MaiTheSan/PCB-Design/KiCad/our projects/uso!/Infomation.txt

Ốc: M2x8 16 cái
Trụ: M2X16 8 cái
Gasket: Poron 60*4*3mm 20 cái
