MaiTheSan/PCB-Design/KiCad/06-2021 comm/averange65 KBD67/gerbers-C3/note.txt

60% alps, Leopold, Jello: 1oz, HASL, 1.6mm
Krush: 1oz, Bạc, 1.6mm 
Daughterboard: 1oz, Bạc, 1.6mm ghép panelizing 4x4
Voice65: 1oz, Bạc, 1.6mm không mạ xuyên lỗ

tất cả dều là 5 panel, đen chữ trắng
