MaiTheSan/PCB-Design/KiCad/Source/KBD8X-MKII-PCB-master/KBD8X-MKII-PCB-master/KBD8XMK2-BOM.xlsx

Component | Description | Part | References | Value | Footprint | Quantity Per PCB
1 | Capacitor, Ceramic, 0603, ≥15V | C_Small | C6 C7 C8 CRGB1 CRGB2 CRGB3 CRGB4 CRGB5 CRGB6 CRGB7 CRGB8 CRGB9 CRGB10 CRGB11 CRGB12 CRGB13 CRGB14 CRGB15 CRGB16 CRGB17 CRGB18 | 0.1uF | C_0603 | 21
2 | Capacitor, Ceramic, 0603, ≥15V | C_Small | C5 | 10uF | C_0603 | 1
3 | Capacitor, Ceramic, 0603, ≥15V | C_Small | C2 | 1uF | C_0603 | 1
4 | Capacitor, Ceramic, 0603, ≥15V | C_Small | C3 C4 | 22pF | C_0603 | 2
5 | Diode, Generic, SOD-123 | D_Small | D1 D2 D3 D4 D5 D6 D7 D8 D9 D10 D11 D12 D13 D14 D17 D18 D19 D20 D21 D22 D23 D24 D25 D26 D27 D28 D29 D30 D31 D35 D36 D37 D38 D39 D40 D41 D42 D43 D44 D45 D46 D47 D48 D52 D53 D54 D55 D56 D57 D58 D59 D60 D61 D62 D63 D65 D66 D67 D68 D69 D70 D71 D72 D73 D74 D75 D76 D77 D78 D81 D82 D84 D85 D86 D87 D90 D91 D92 D93 D94 D95 D96 D97 D99 D100 D101 D108 D111 D112 D113 | SOD-323 | D_SOD-123 | 90
6 | Polyfuse, 1206, 500mA Hold, 1A Trip, ≥15V | Polyfuse_Small | F1 | 500mA | Fuse_SMD1206_Wave | 1
7 | NPN transistor, DSS60601MZ4-13, SOT-223 | Q_NPN_BCE | Q1 | DSS60601MZ4-13 | SOT-223-3_TabPin2 | 1
8 | Resistor, Generic, 0603 | R_Small | R1 R2 R3 R4 R5 R6 R7 R8 R9 R10 R11 R12 R13 R14 R16 R17 R18 R19 R20 R21 R22 R23 R24 R25 R26 R27 R28 R29 R30 R31 R32 R33 R35 R36 R37 R38 R39 R40 R41 R42 R43 R44 R45 R46 R47 R48 R52 R53 R54 R55 R56 R57 R58 R59 R60 R61 R62 R63 R65 R66 R67 R68 R69 R70 R71 R72 R73 R74 R75 R76 R77 R78 R81 R82 R84 R85 R86 R87 R90 R91 R95 R96 R97 R99 R100 R101 R108 R111 R112 R113 RC4 | 1k | R_0603 | 91
9 | Resistor, Generic, 0603 | R_Small | RC5 | 1.5k | R_0603 | 1
10 | Resistor, Generic, 0603 | R_Small | RC3 | 10k | R_0603 | 1
11 | Resistor, Generic, 0603 | R_Small | RC1 RC2 | 22 | R_0603 | 2
12 | Resistor, Generic, 0603 | R_Small | RC6 RC7 | 5k1 | R_0603 | 2
13 | RGB LED, WS2812B, 5050 | WS2812B | RGB1 RGB2 RGB3 RGB4 RGB5 RGB6 RGB7 RGB8 RGB9 RGB10 RGB11 RGB12 RGB13 RGB14 RGB15 RGB16 RGB17 RGB18 | WS2812B | LED_WS2812B-PLCC4 | 18
14 | Push button, 5.2 x 5.2mm | SW_Push | SW1 | SW_Push | SKQG-1155865 | 1
15 | Switch, SPDT, PCM12 | SW_SPDT | SW2 SW3 | SW_SPDT | SW_SPDT_PCM12 | 2
16 | ATmega32U4-MU | ATmega32U4-MU | U1 | ATmega32U4-MU | QFN-44-1EP_7x7mm_Pitch0.5mm | 1
17 | ESD Protection IC, PRTR5V0U2X,215 | PRTR5V0U2X | U2 | PRTR5V0U2X | SOT143B | 1
18 | USB Type-C Connector, HRO TYPE-C-31-M-12 | HRO-TYPE-C-31-M-12 | USB1 | HRO-TYPE-C-31-M-12 | HRO-TYPE-C-31-M-12-Assembly | 1
19 | Crystal, 3.2 x 2.5mm, 16MHz | Crystal_GND24 | Y1 | 16MHz | Crystal_SMD_3225-4pin_3.2x2.5mm | 1
Component Groups: | 19
Component Count: | 239
Fitted Components: | 239
Number of PCBs: | 1
Total components: | 239
Schematic Version:
Schematic Date:
BoM Date: | 2019-04-04 15:30
Schematic Source:
KiCad Version: | Eeschema (5.0.2)-1
