MaiTheSan/PCB-Design/KiCad/Early 2021/Unified-Daughterboard-master/Production/C1/BOM/Unified-Daughterboard-Partslist.xlsx

Component | Description |  | Part | References | Value | Footprint | Quantity Per PCB
1 | JST SR | https://lcsc.com/product-detail/Others_JST-Sales-America__JST-Sales-America-SM04B-SRSS-TB-LF-SN_C160404.html | Conn_01x04 | J2 | SM04B-SRSS-TB(LF)(SN) | JST-SR-4 | 1
2 | HRO USB-C Connector | https://lcsc.com/product-detail/USB-Type-C_Korean-Hroparts-Elec-TYPE-C-31-M-12_C165948.html | HRO-TYPE-C-31-M-12 | J1 | HRO-TYPE-C-31-M-12 | HRO-TYPE-C-31-M-12-Assembly | 1
3 | Resistor, 0603, Generic | https://lcsc.com/product-detail/Chip-Resistor-Surface-Mount_PANASONIC-ERA3AED512V_C191166.html | R_Small | R1 R2 | 5.1k | R_0603 | 2
