MaiTheSan/PCB-Design/KiCad/Source/KBD8X-MKII-PCB-master/KBD8X-MKII-PCB-master/Production/NewBOM/KBD8XMK2-BOM-2.xlsx

Comment | Description | Designator | Footprint | Pins | Quantity
0.1uF 20% ≥15V X5R/X7R | Capacitor, Ceramic, 0603 | C6 C7 C8 CRGB1 CRGB2 CRGB3 CRGB4 CRGB5 CRGB6 CRGB7 CRGB8 CRGB9 CRGB10 CRGB11 CRGB12 CRGB13 CRGB14 CRGB15 CRGB16 CRGB17 CRGB18 | C_0603 | 2 | 21
10uF 20% ≥15V X5R/X7R | Capacitor, Ceramic, 0603 | C5 | C_0603 | 2 | 1
1uF 20% ≥15V X5R/X7R | Capacitor, Ceramic, 0603 | C2 | C_0603 | 2 | 1
22pF 5% ≥15V C0G | Capacitor, Ceramic, 0603 | C3 C4 | C_0603 | 2 | 2
Generic | Diode, SOD-123 | D1 D2 D3 D4 D5 D6 D7 D8 D9 D10 D11 D12 D13 D14 D17 D18 D19 D20 D21 D22 D23 D24 D25 D26 D27 D28 D29 D30 D31 D35 D36 D37 D38 D39 D40 D41 D42 D43 D44 D45 D46 D47 D48 D52 D53 D54 D55 D56 D57 D58 D59 D60 D61 D62 D63 D65 D66 D67 D68 D69 D70 D71 D72 D73 D74 D75 D76 D77 D78 D81 D82 D84 D85 D86 D87 D90 D91 D92 D93 D94 D95 D96 D97 D99 D100 D101 D108 D111 D112 D113 | D_SOD-123 | 2 | 90
500mA ≥15V 500mA_Hold 1A_Trip | Polyfuse, 1206 | F1 | Fuse_SMD1206_Wave | 2 | 1
DSS60601MZ4-13 | NPN transistor, SOT-223 | Q1 | SOT-223-3_TabPin2 | 4 | 1
1k 1% | Resistor, Generic, 0603 | R1 R2 R3 R4 R5 R6 R7 R8 R9 R10 R11 R12 R13 R14 R16 R17 R18 R19 R20 R21 R22 R23 R24 R25 R26 R27 R28 R29 R30 R31 R32 R33 R35 R36 R37 R38 R39 R40 R41 R42 R43 R44 R45 R46 R47 R48 R52 R53 R54 R55 R56 R57 R58 R59 R60 R61 R62 R63 R65 R66 R67 R68 R69 R70 R71 R72 R73 R74 R75 R76 R77 R78 R81 R82 R84 R85 R86 R87 R90 R91 R95 R96 R97 R99 R100 R101 R108 R111 R112 R113 RC4 | R_0603 | 2 | 91
1.5k 1% | Resistor, Generic, 0603 | RC5 | R_0603 | 2 | 1
10k 1% | Resistor, Generic, 0603 | RC3 | R_0603 | 2 | 1
22 1% | Resistor, Generic, 0603 | RC1 RC2 | R_0603 | 2 | 2
5.1k 1% | Resistor, Generic, 0603 | RC6 RC7 | R_0603 | 2 | 2
WS2812B | RGB LED, 5050 | RGB1 RGB2 RGB3 RGB4 RGB5 RGB6 RGB7 RGB8 RGB9 RGB10 RGB11 RGB12 RGB13 RGB14 RGB15 RGB16 RGB17 RGB18 | LED_WS2812B-PLCC4 | 4 | 18
SMT 5.2 x 5.2 x 1.5mm | Push button | SW1 | SKQG-1155865 | 4 | 1
SPDT PCM12 | Switch, SPDT | SW2 SW3 | SW_SPDT_PCM12 | 7 | 2
ATmega32U4-MU | ATmega32U4-MU | U1 | QFN-44-1EP_7x7mm_Pitch0.5mm | 45 | 1
PRTR5V0U2X | ESD Protection IC | U2 | SOT143B | 4 | 1
HRO-TYPE-C-31-M-12 | USB Type-C Connector | USB1 | HRO-TYPE-C-31-M-12-Assembly | 16 | 1
16MHz | Crystal, 3.2 x 2.5mm (3225-4) | Y1 | Crystal_SMD_3225-4pin_3.2x2.5mm | 4 | 1
