MaiTheSan/PCB-Design/KiCad/Early 2021/Unified-Daughterboard-master/Production/C3/BOM/Unified-Daughterboard_bom_.csv

Designator | Package | Quantity | Designation | LCSC Code
D1 | SOD-123F-B | 1 | SMF9.0CA | C123799
J2 | SM04B-SRSS-TB(LF)(SN) | 1 | JST-SM04B | C160404
R1,R2 | R0603 | 2 | 5.1k | C101083
J1 | HRO-TYPE-C-31-M-12 | 1 | HRO-TYPE-C-31-M-12 | C165948
U1 | uSON-10 | 1 | TPD4E05U06DQAR | C138714
F1 | F1206 | 1 | ASMD1206-150 | C135342
