MaiTheSan/PCB-Design/KiCad/06-2021 comm/FR4 Plate/Voice65/full.dxf

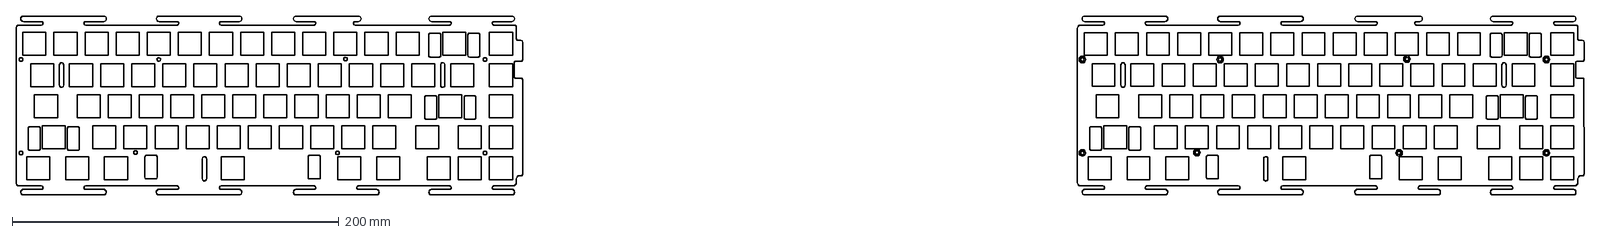
[picture p54: CAD file, 2022-11-19]
KiCad/06-2021 comm/FR4 Plate/Voice65/full.dxf
960.2 x 109.5 mm
