MaiTheSan/PCB-Design/KiCad/Early 2021/teensy.pretty-master/Teensy_4.0_Assembly.STEP

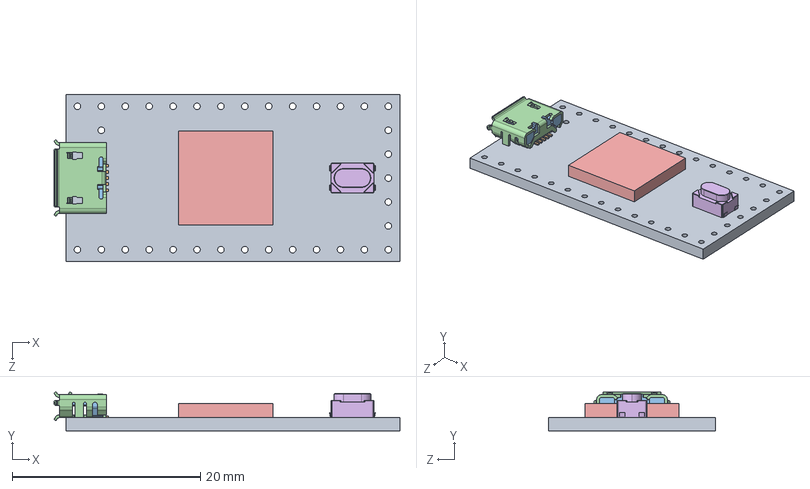
[picture p55: CAD file, 2022-11-19]
KiCad/Early 2021/teensy.pretty-master/Teensy_4.0_Assembly.STEP
36.8 x 4.12 x 17.7 mm
Teensy_4.0_PCB
Micro USB-B Female 5Pin SMD
NXP iMXRT1062
SKRPACE010 v4
