MaiTheSan/PCB-Design/KiCad/06-2021 comm/averange65 KBD67/RGB68v2.dxf

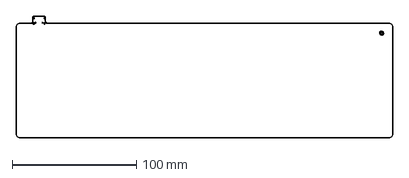
[picture p56: CAD file, 2022-11-19]
KiCad/06-2021 comm/averange65 KBD67/RGB68v2.dxf
303.2 x 97.6 mm
