MaiTheSan/PCB-Design/KiCad/06-2021 comm/averange65/SM04B-SRSS-TB(LF)(SN)--3DModel-STEP-56544.STEP

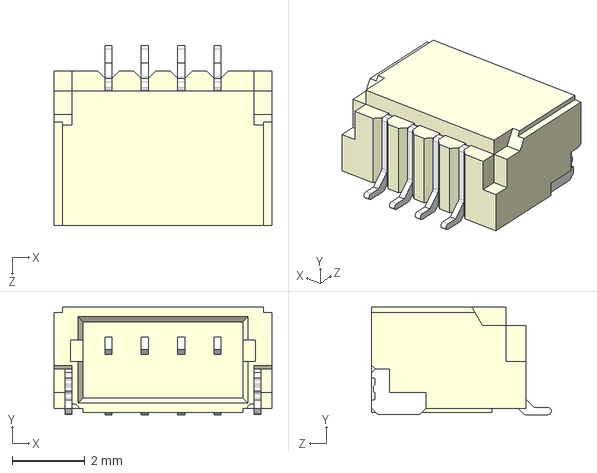
[picture p57: CAD file, 2022-11-19]
KiCad/06-2021 comm/averange65/SM04B-SRSS-TB(LF)(SN)--3DModel-STEP-56544.STEP
6.00 x 2.96 x 4.95 mm
