MaiTheSan/PCB-Design/KiCad/06-2021 comm/averange65/Unified-Daughterboard-master/Unified-Daughterboard-master/Design Resources/C3/Example Implementation Model.step

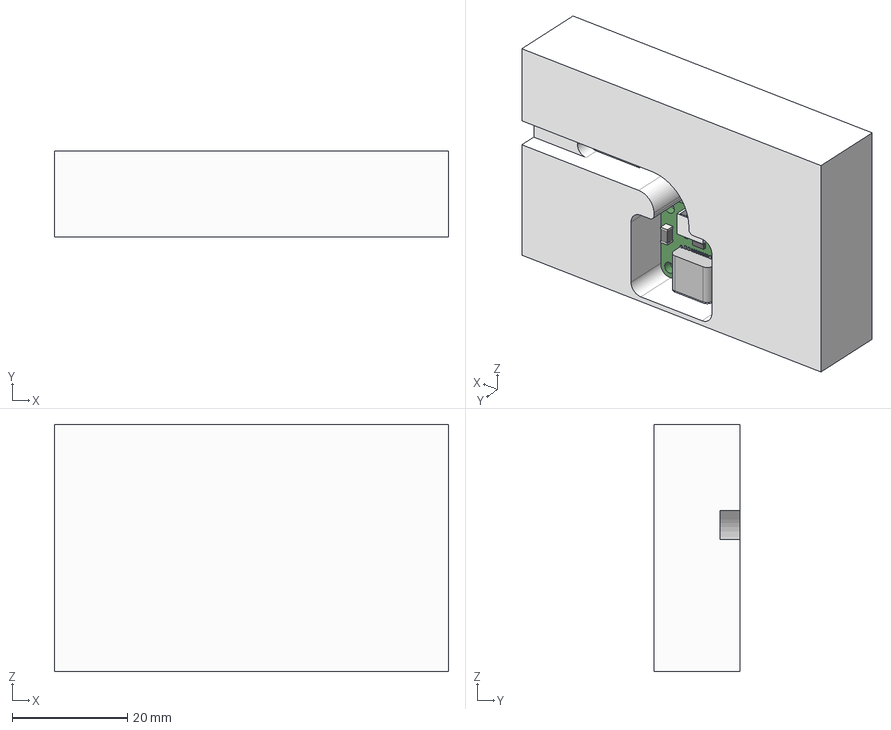
[picture p58: CAD file, 2022-11-19]
KiCad/06-2021 comm/averange65/Unified-Daughterboard-master/Unified-Daughterboard-master/Design Resources/C3/Example Implementation Model.step
68.5 x 15.0 x 43.0 mm
