MaiTheSan/PCB-Design/KiCad/06-2021 comm/FR4 Plate/KBD67 - Lite/kbd67lite-fr4.dxf

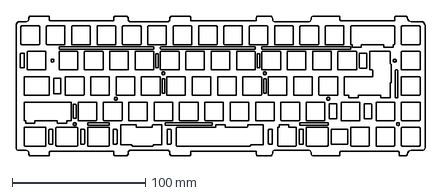
[picture p59: CAD file, 2022-11-19]
KiCad/06-2021 comm/FR4 Plate/KBD67 - Lite/kbd67lite-fr4.dxf
307.2 x 104.9 mm
