MaiTheSan/PCB-Design/KiCad/06-2021 comm/FR4 Plate/outline.dxf

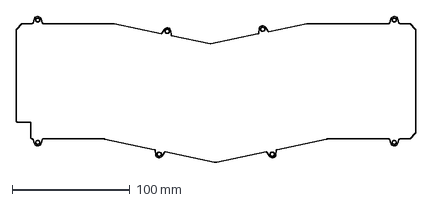
[picture p60: CAD file, 2022-11-19]
KiCad/06-2021 comm/FR4 Plate/outline.dxf
338.8 x 124.0 mm
