MaiTheSan/PCB-Design/KiCad/06-2021 comm/jello/uso!VNC.step

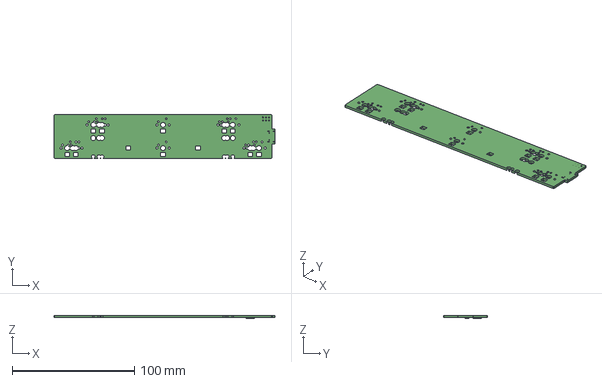
[picture p61: CAD file, 2022-11-19]
KiCad/06-2021 comm/jello/uso!VNC.step
181.0 x 35.7 x 2.42 mm
