MaiTheSan/PCB-Design/KiCad/06-2021 comm/Leopold Replacement/OG BLE/Leopold Replacement-drl_map.dxf

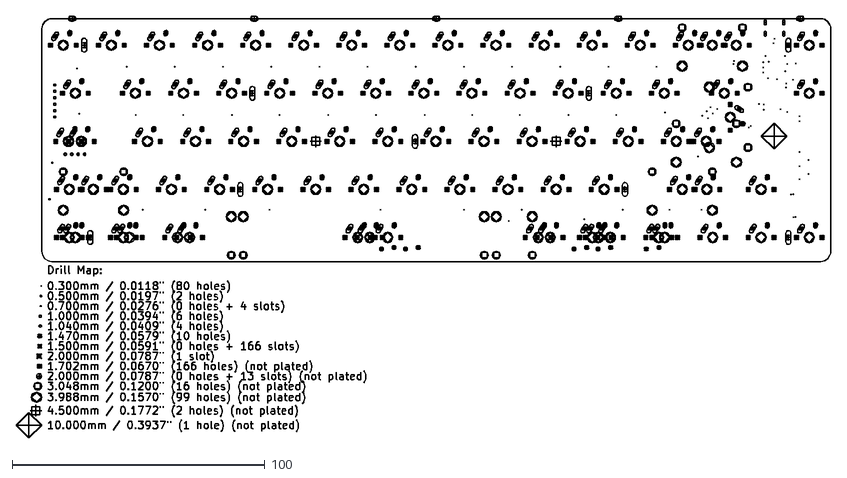
[picture p62: CAD file, 2022-11-19]
KiCad/06-2021 comm/Leopold Replacement/OG BLE/Leopold Replacement-drl_map.dxf
322.1 x 166.8
