MaiTheSan/PCB-Design/KiCad/06-2021 comm/Leopold Replacement/TypeC/resource/nt660-drl_map.dxf

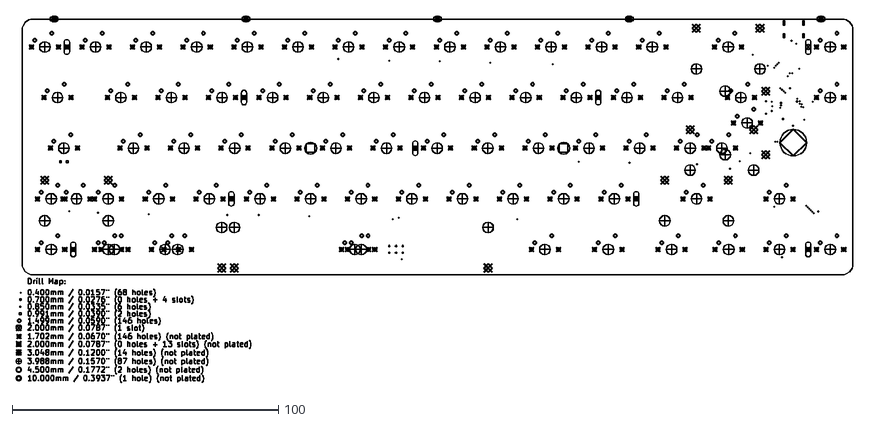
[picture p63: CAD file, 2022-11-19]
KiCad/06-2021 comm/Leopold Replacement/TypeC/resource/nt660-drl_map.dxf
314.3 x 137.6
