MaiTheSan/PCB-Design/KiCad/06-2021 comm/theo60 plate/Ansi/theo60ansi.dxf

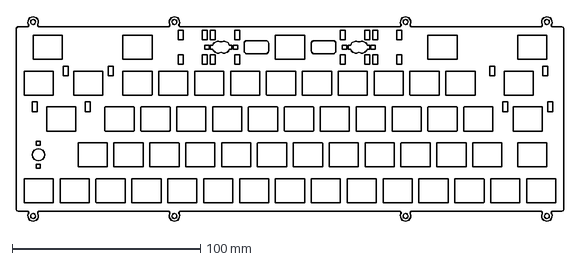
[picture p64: CAD file, 2022-11-19]
KiCad/06-2021 comm/theo60 plate/Ansi/theo60ansi.dxf
290.7 x 108.9 mm
