MaiTheSan/PCB-Design/KiCad/06-2021 comm/theo60 plate/ISO/outline.dxf

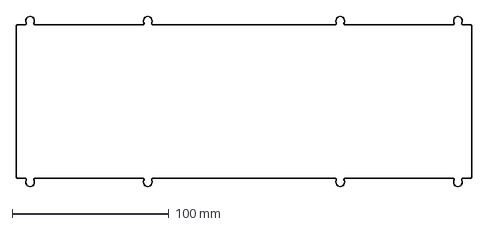
[picture p65: CAD file, 2022-11-19]
KiCad/06-2021 comm/theo60 plate/ISO/outline.dxf
290.7 x 108.9 mm
