MaiTheSan/PCB-Design/KiCad/06-2021 comm/theo60 plate/theo60-alps-5140.dxf

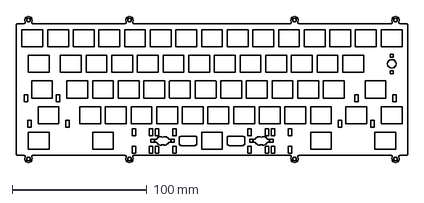
[picture p66: CAD file, 2022-11-19]
KiCad/06-2021 comm/theo60 plate/theo60-alps-5140.dxf
290.7 x 108.9 mm
