MaiTheSan/PCB-Design/KiCad/07-2021/Evergarden/Evergarden.dxf

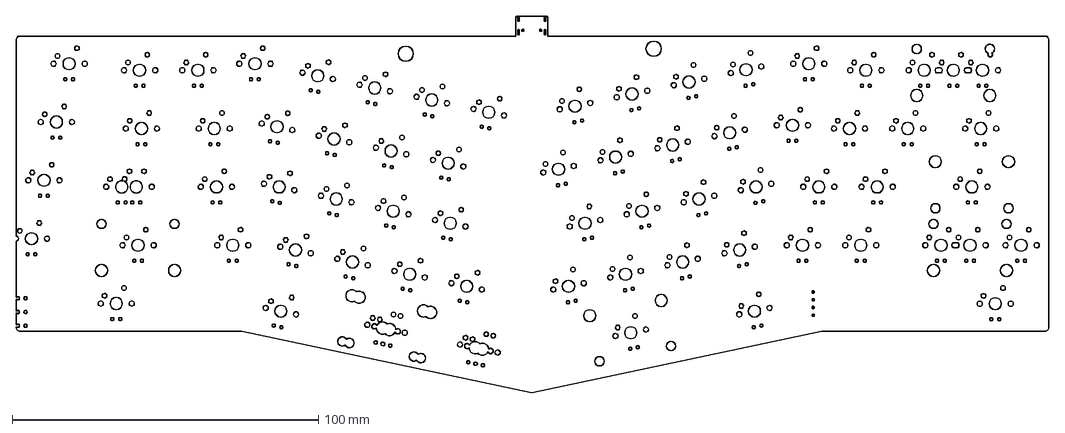
[picture p67: CAD file, 2022-11-19]
KiCad/07-2021/Evergarden/Evergarden.dxf
337.2 x 122.9 mm
