MaiTheSan/PCB-Design/KiCad/07-2021/Parallel/layout.dxf

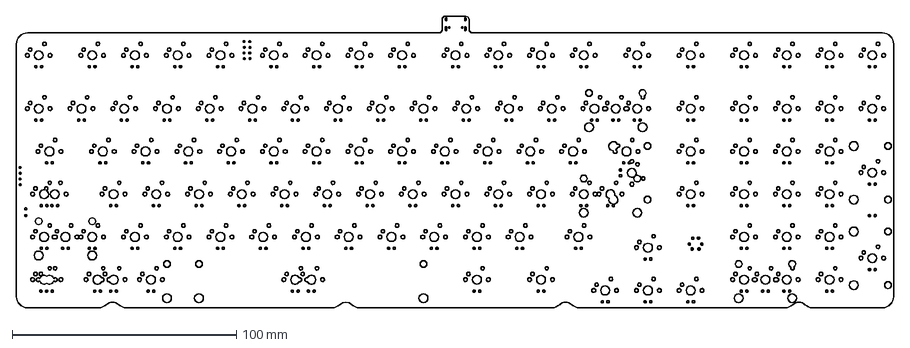
[picture p68: CAD file, 2022-11-19]
KiCad/07-2021/Parallel/layout.dxf
391.0 x 129.9 mm
