MaiTheSan/PCB-Design/KiCad/07-2021/Satri2.0/Plate/6kv2 (7k+).dxf

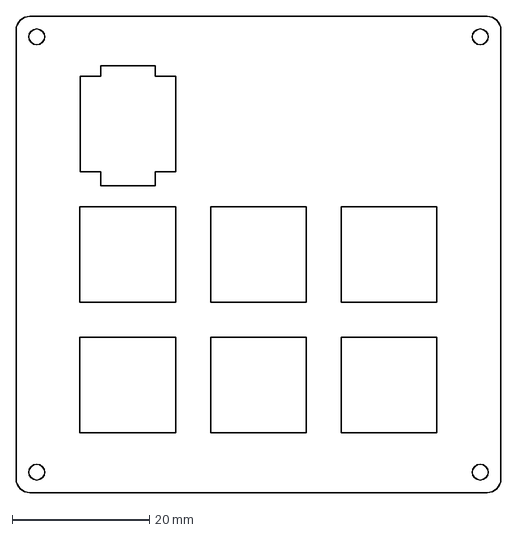
[picture p69: CAD file, 2022-11-19]
KiCad/07-2021/Satri2.0/Plate/6kv2 (7k+).dxf
70.7 x 69.5 mm
