MaiTheSan/PCB-Design/KiCad/07-2021/Satri2.0/Satxri6key.step

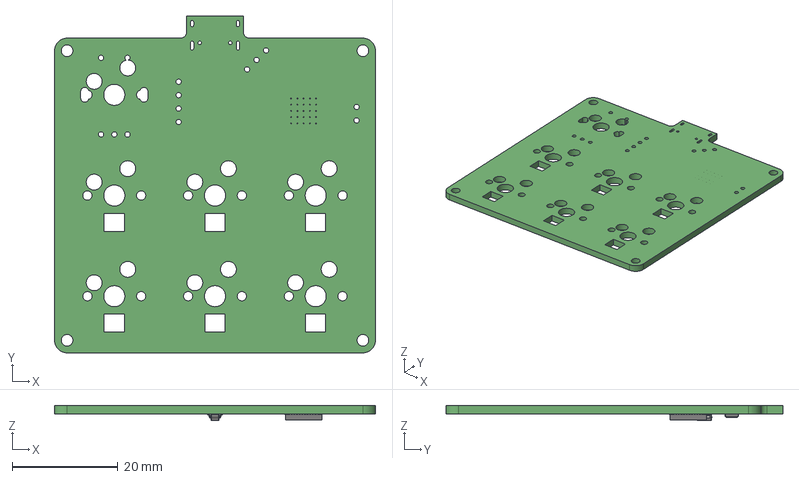
[picture p70: CAD file, 2022-11-19]
KiCad/07-2021/Satri2.0/Satxri6key.step
60.7 x 63.7 x 2.85 mm
