MaiTheSan/PCB-Design/KiCad/07-2021/Stabtester/Stabtester/New folder/Stabtester-Edge_Cuts.dxf

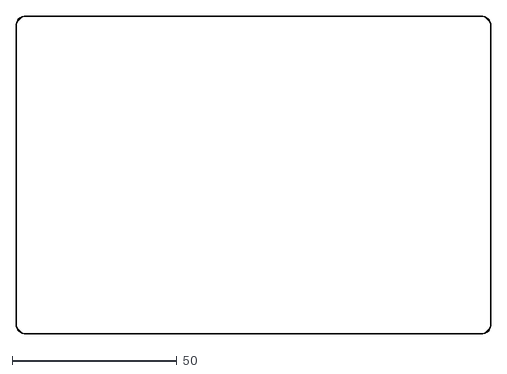
[picture p71: CAD file, 2022-11-19]
KiCad/07-2021/Stabtester/Stabtester/New folder/Stabtester-Edge_Cuts.dxf
144.2 x 96.5
