MaiTheSan/PCB-Design/KiCad/08-2021/averange60/pcb-outline.dxf

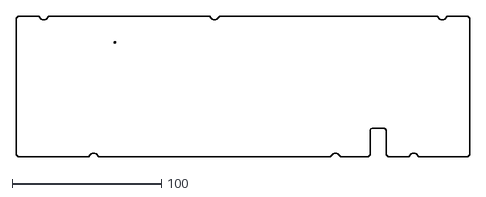
[picture p72: CAD file, 2022-11-19]
KiCad/08-2021/averange60/pcb-outline.dxf
303.8 x 94.2
