MaiTheSan/PCB-Design/KiCad/08-2021/hmmm/pcb/pcb-outline.dxf

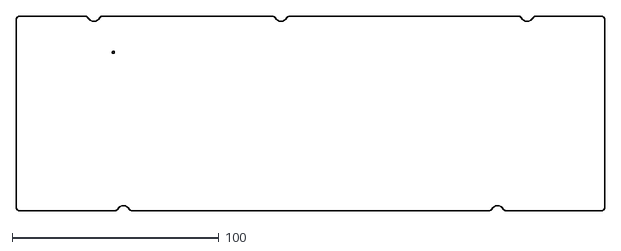
[picture p73: CAD file, 2022-11-19]
KiCad/08-2021/hmmm/pcb/pcb-outline.dxf
284.7 x 94.2
