MaiTheSan/PCB-Design/KiCad/08-2021/Krush hotswap/averange60/Polaris-PCB-Dimens.dxf

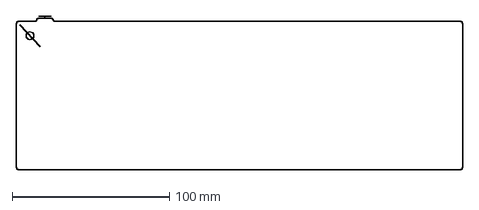
[picture p74: CAD file, 2022-11-19]
KiCad/08-2021/Krush hotswap/averange60/Polaris-PCB-Dimens.dxf
283.9 x 98.0 mm
