MaiTheSan/PCB-Design/KiCad/08-2021/Krush hotswap/averange60x/Unified-Daughterboard-master/Unified-Daughterboard-master/Design Resources/C3/Unified-Daughterboard.step

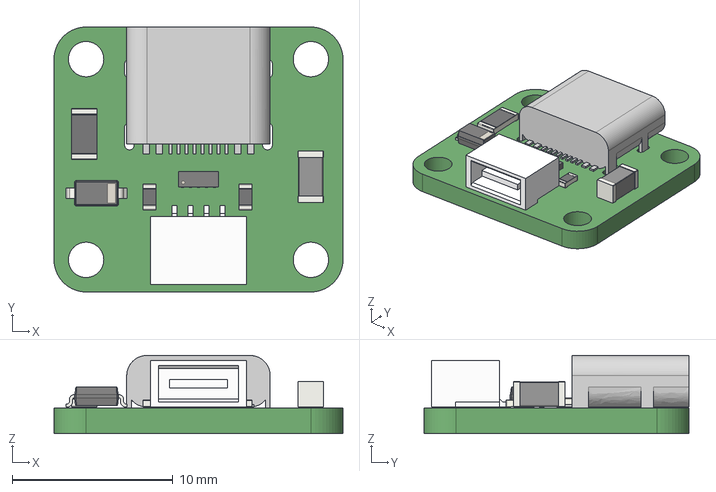
[picture p75: CAD file, 2022-11-19]
KiCad/08-2021/Krush hotswap/averange60x/Unified-Daughterboard-master/Unified-Daughterboard-master/Design Resources/C3/Unified-Daughterboard.step
18.0 x 16.5 x 4.86 mm
