MaiTheSan/PCB-Design/KiCad/08-2021/nonem/OutlineNoway.dxf

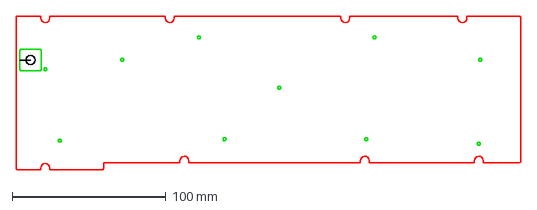
[picture p76: CAD file, 2022-11-19]
KiCad/08-2021/nonem/OutlineNoway.dxf
328.6 x 100.0 mm
