MaiTheSan/PCB-Design/KiCad/1-2022/DNMK/pcb outline.dxf

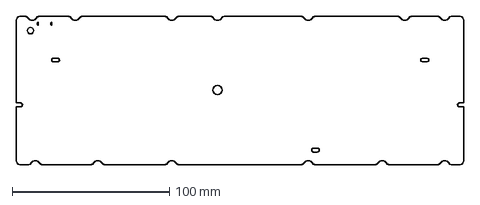
[picture p77: CAD file, 2022-11-19]
KiCad/1-2022/DNMK/pcb outline.dxf
284.7 x 94.2 mm
