MaiTheSan/PCB-Design/KiCad/12-2021/Amber80/solder/solder noncommission/dboard/RGB-Daughterboard.step

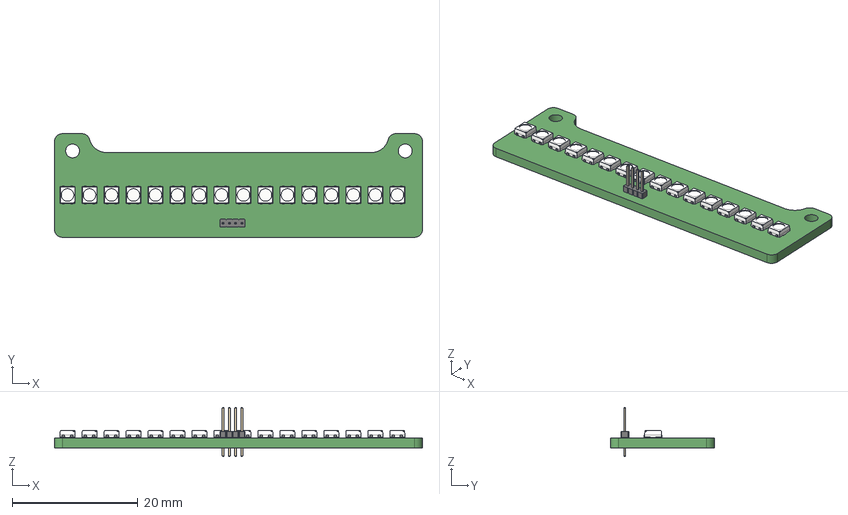
[picture p78: CAD file, 2022-11-19]
KiCad/12-2021/Amber80/solder/solder noncommission/dboard/RGB-Daughterboard.step
58.6 x 16.5 x 7.80 mm
