MaiTheSan/PCB-Design/KiCad/12-2021/Amber80/solder/solder noncommission/outline2.dxf

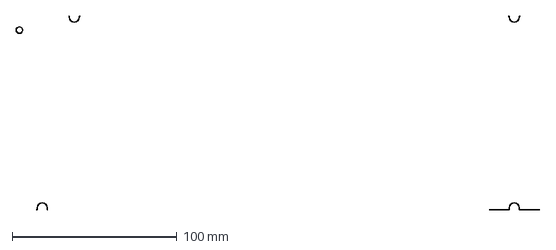
[picture p79: CAD file, 2022-11-19]
KiCad/12-2021/Amber80/solder/solder noncommission/outline2.dxf
317.6 x 117.5 mm
