MaiTheSan/PCB-Design/KiCad/3-2022/75F/75F/75F/a.dxf

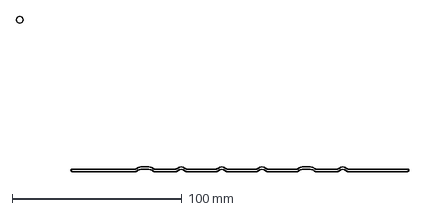
[picture p80: CAD file, 2022-11-19]
KiCad/3-2022/75F/75F/75F/a.dxf
231.3 x 91.5 mm
