MaiTheSan/PCB-Design/KiCad/4-2022/Alice/alice.dxf

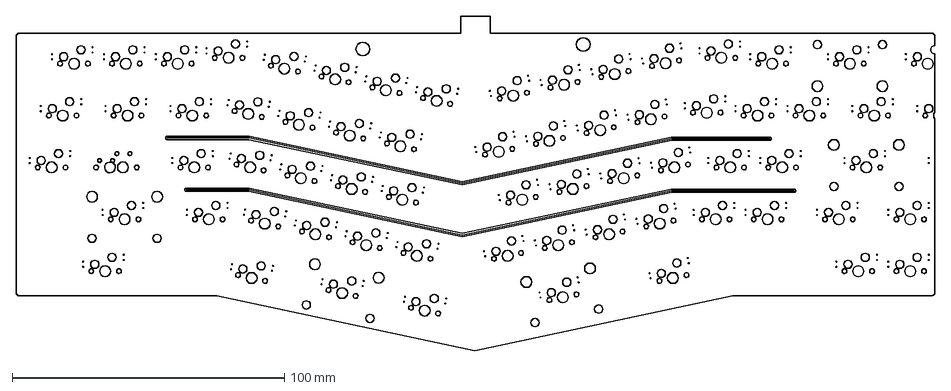
[picture p81: CAD file, 2022-11-19]
KiCad/4-2022/Alice/alice.dxf
337.2 x 122.6 mm
