MaiTheSan/PCB-Design/KiCad/4-2022/Nuxros Alice commission/SawnsProjectAlice.dxf

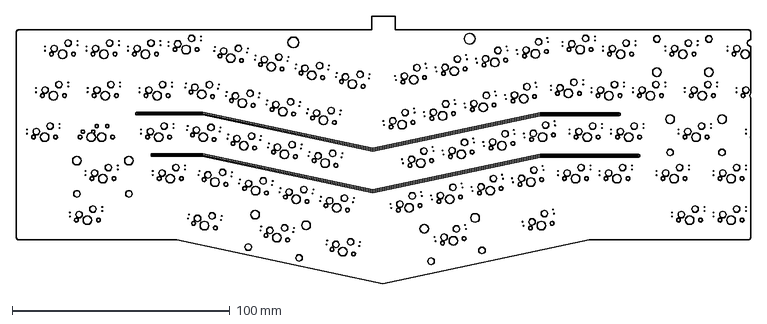
[picture p82: CAD file, 2022-11-19]
KiCad/4-2022/Nuxros Alice commission/SawnsProjectAlice.dxf
337.2 x 122.6 mm
