MaiTheSan/PCB-Design/KiCad/4-2022/Viendi 2 Prototype layout/Viendi 2/Viendi2/Viendi2/EDGE CUT.dxf

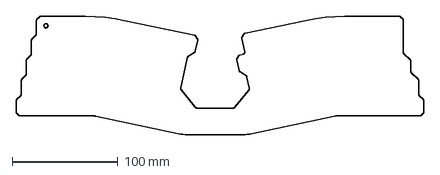
[picture p83: CAD file, 2022-11-19]
KiCad/4-2022/Viendi 2 Prototype layout/Viendi 2/Viendi2/Viendi2/EDGE CUT.dxf
385.8 x 111.9 mm
