MaiTheSan/PCB-Design/KiCad/4-2022/Viendi 2 Prototype layout/Viendi 2/Viendi2/Viendi2_daughterboard/EDGE CUT.dxf

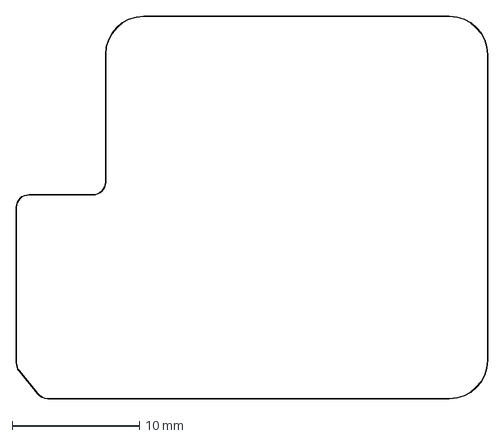
[picture p84: CAD file, 2022-11-19]
KiCad/4-2022/Viendi 2 Prototype layout/Viendi 2/Viendi2/Viendi2_daughterboard/EDGE CUT.dxf
37.0 x 30.0 mm
