MaiTheSan/PCB-Design/KiCad/Early 2021/Alice/Lubrigante-master/Lubrigante-master/case_layouts/man_of_layouts/man_of_layouts_half_plate_3mm.dxf

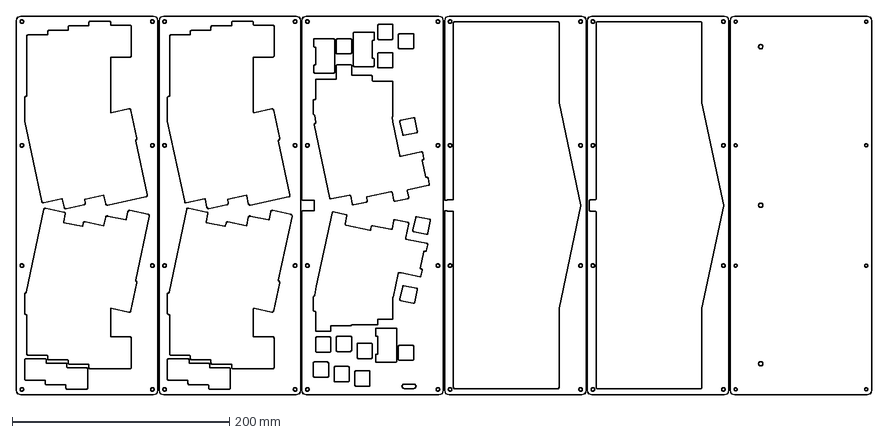
[picture p85: CAD file, 2022-11-19]
KiCad/Early 2021/Alice/Lubrigante-master/Lubrigante-master/case_layouts/man_of_layouts/man_of_layouts_half_plate_3mm.dxf
787.8 x 348.8 mm
