MaiTheSan/PCB-Design/KiCad/Early 2021/Alice/Opensource/bmek-master/bmek-master/cases/top_mount/Blocker/Blocker_EngravedLogo.step

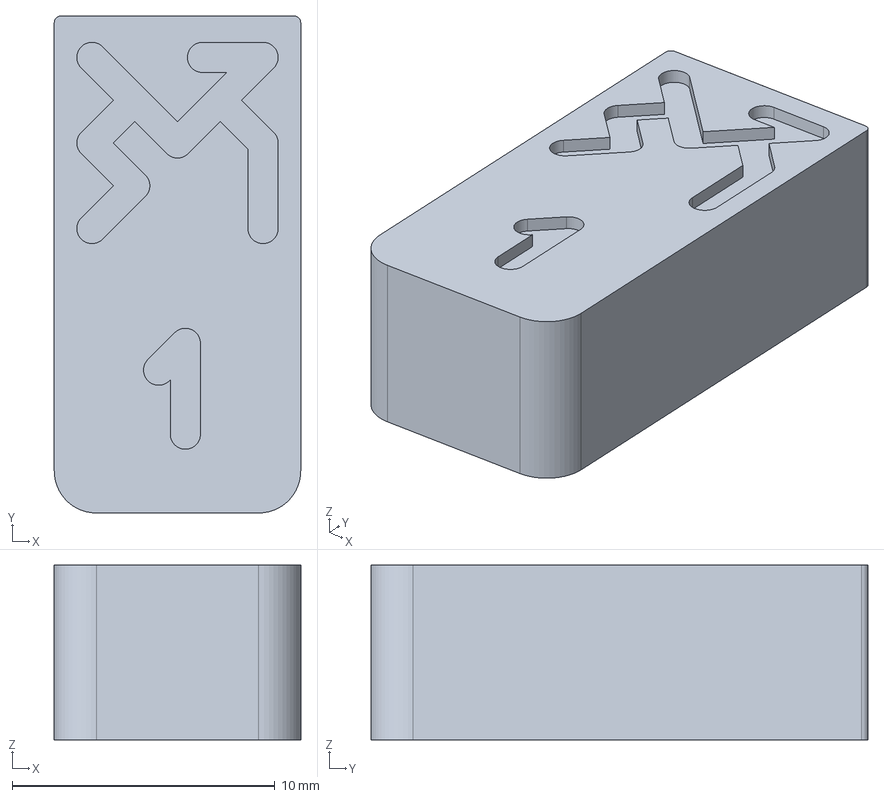
[picture p86: CAD file, 2022-11-19]
KiCad/Early 2021/Alice/Opensource/bmek-master/bmek-master/cases/top_mount/Blocker/Blocker_EngravedLogo.step
9.38 x 18.9 x 6.65 mm
