MaiTheSan/PCB-Design/KiCad/Early 2021/Alice/Opensource/bmek-master/bmek-master/cases/top_mount/BottomCase/BottomCase.step

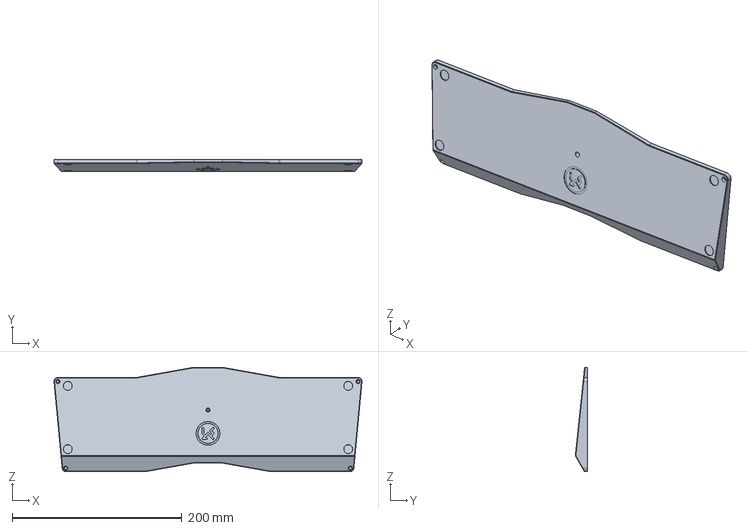
[picture p87: CAD file, 2022-11-19]
KiCad/Early 2021/Alice/Opensource/bmek-master/bmek-master/cases/top_mount/BottomCase/BottomCase.step
362.7 x 14.5 x 122.9 mm
