MaiTheSan/PCB-Design/KiCad/Early 2021/Alice/Opensource/bmek-master/bmek-master/cases/top_mount/BottomWeight/BottomWeight.step

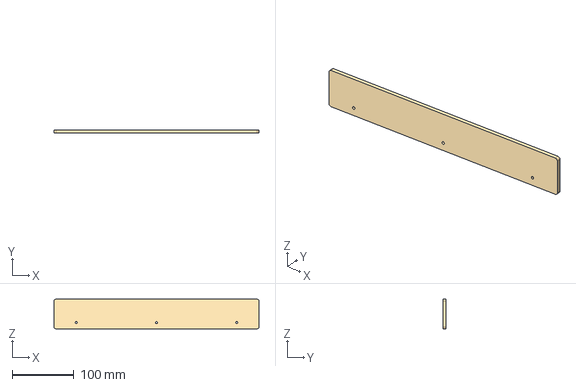
[picture p88: CAD file, 2022-11-19]
KiCad/Early 2021/Alice/Opensource/bmek-master/bmek-master/cases/top_mount/BottomWeight/BottomWeight.step
332.0 x 5.00 x 48.0 mm
