MaiTheSan/PCB-Design/KiCad/Early 2021/Alice/Opensource/bmek-master/bmek-master/cases/top_mount/SwitchPlate/SwitchPlate_ThreeQuarterFlex.step

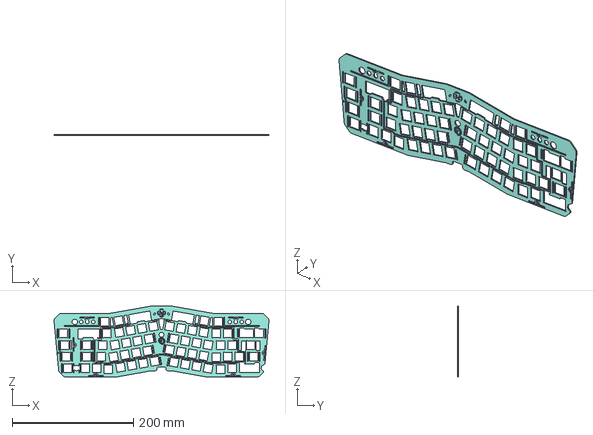
[picture p89: CAD file, 2022-11-19]
KiCad/Early 2021/Alice/Opensource/bmek-master/bmek-master/cases/top_mount/SwitchPlate/SwitchPlate_ThreeQuarterFlex.step
354.8 x 1.50 x 117.1 mm
