MaiTheSan/PCB-Design/KiCad/Early 2021/Alice/Opensource/bmek-master/bmek-master/cases/top_mount/TopCase/TopCase.step

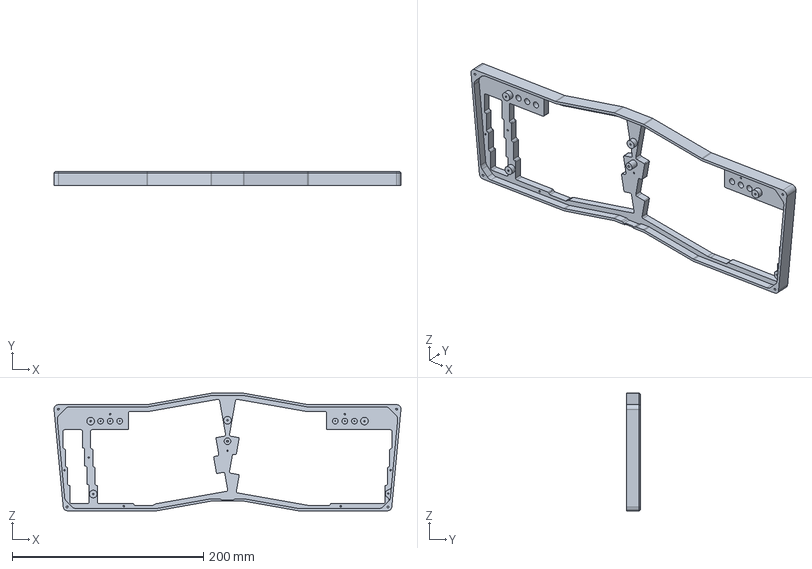
[picture p90: CAD file, 2022-11-19]
KiCad/Early 2021/Alice/Opensource/bmek-master/bmek-master/cases/top_mount/TopCase/TopCase.step
362.7 x 14.9 x 122.9 mm
