MaiTheSan/PCB-Design/KiCad/Early 2021/Alice/Opensource/bmek-master/bmek-master/cases/top_mount/WristRest/WristRest.step

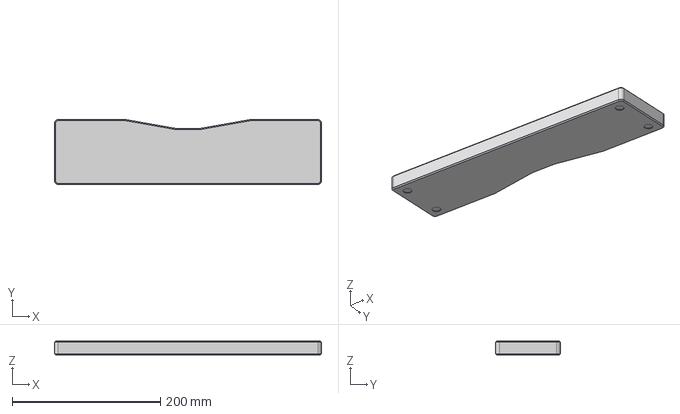
[picture p91: CAD file, 2022-11-19]
KiCad/Early 2021/Alice/Opensource/bmek-master/bmek-master/cases/top_mount/WristRest/WristRest.step
360.0 x 87.5 x 19.0 mm
