MaiTheSan/PCB-Design/KiCad/Early 2021/EV65 final/EV layout.dxf

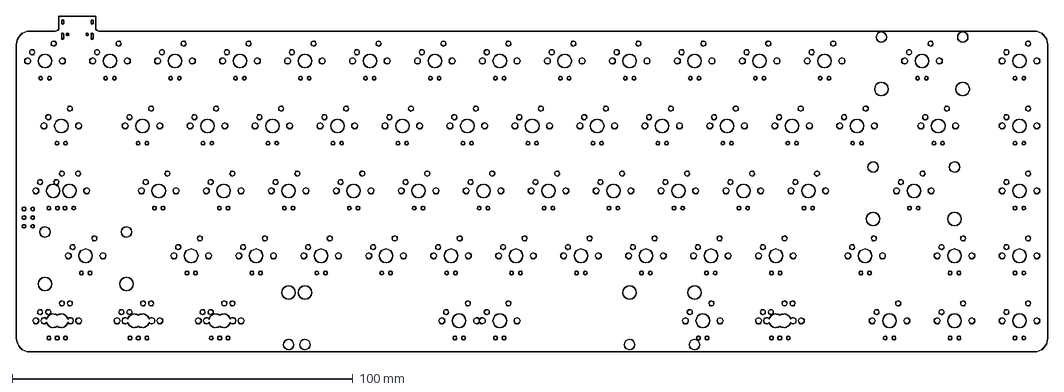
[picture p92: CAD file, 2022-11-19]
KiCad/Early 2021/EV65 final/EV layout.dxf
302.4 x 98.4 mm
