MaiTheSan/PCB-Design/KiCad/Early 2021/EV65 from Voyager/EV65 prototype/Voyager65-Keyplus-master/Voyager65-Keyplus-master/DXF/Voyager65-Edge.Cuts.dxf

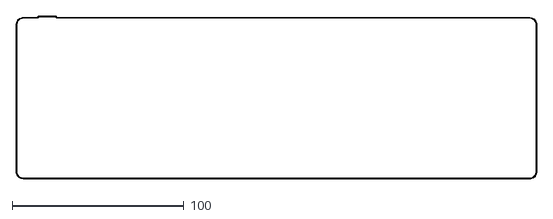
[picture p93: CAD file, 2022-11-19]
KiCad/Early 2021/EV65 from Voyager/EV65 prototype/Voyager65-Keyplus-master/Voyager65-Keyplus-master/DXF/Voyager65-Edge.Cuts.dxf
303.4 x 94.6
