MaiTheSan/PCB-Design/KiCad/Early 2021/EV65 from Voyager/EV65 prototype/Voyager65-Keyplus-master/Voyager65-Keyplus-master/Plate/Source/Tada68-Alps.dxf

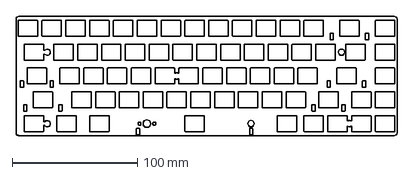
[picture p94: CAD file, 2022-11-19]
KiCad/Early 2021/EV65 from Voyager/EV65 prototype/Voyager65-Keyplus-master/Voyager65-Keyplus-master/Plate/Source/Tada68-Alps.dxf
304.8 x 95.3 mm
