MaiTheSan/PCB-Design/KiCad/Early 2021/EV65 from vyg60/ev65/Voyager60.step

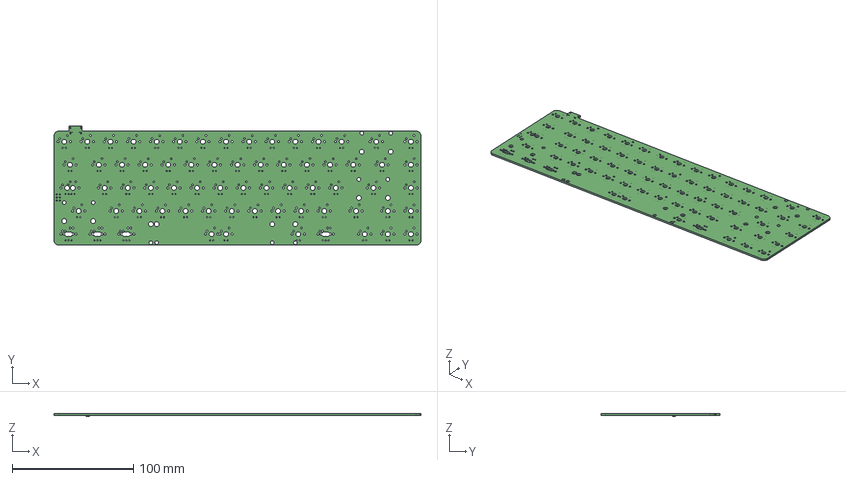
[picture p95: CAD file, 2022-11-19]
KiCad/Early 2021/EV65 from vyg60/ev65/Voyager60.step
302.4 x 98.4 x 2.29 mm
