MaiTheSan/PCB-Design/KiCad/Early 2021/EV65 from vyg60/Voyager60-master - Copy - Copy/EV65 PCB.step

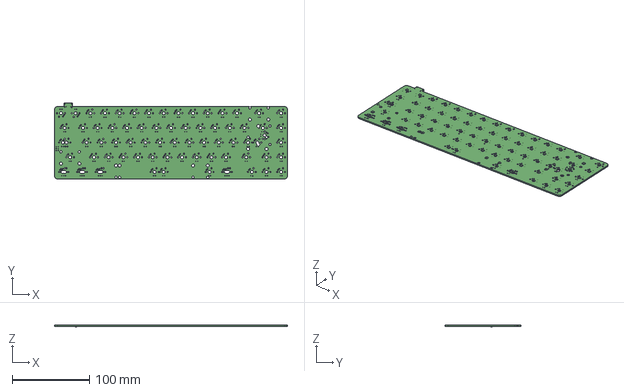
[picture p96: CAD file, 2022-11-19]
KiCad/Early 2021/EV65 from vyg60/Voyager60-master - Copy - Copy/EV65 PCB.step
302.4 x 98.5 x 2.29 mm
