MaiTheSan/PCB-Design/KiCad/Early 2021/LAYOUT/Q68.dxf

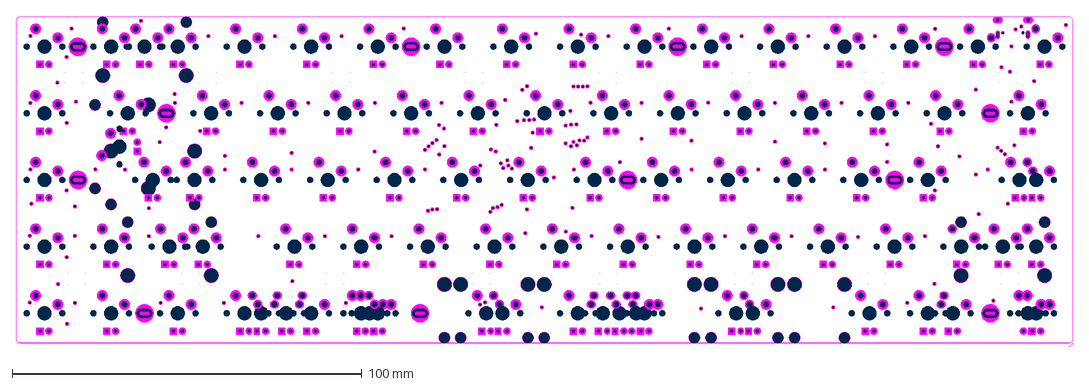
[picture p97: CAD file, 2022-11-19]
KiCad/Early 2021/LAYOUT/Q68.dxf
301.8 x 94.3 mm
