MaiTheSan/PCB-Design/KiCad/Early 2021/phôi design pcb/1800 layout/LogoOriginalSawnsProjects.dxf

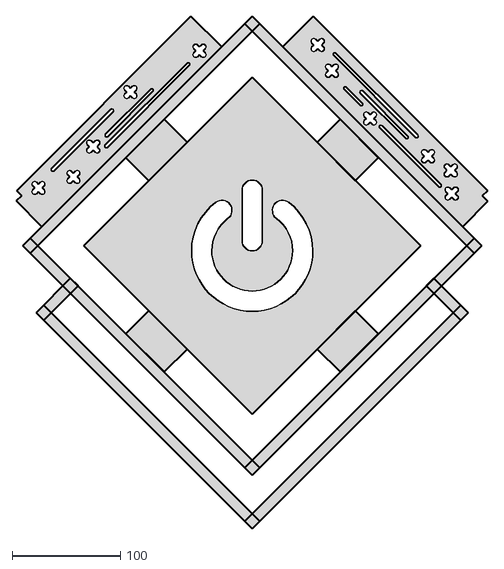
[picture p98: CAD file, 2022-11-19]
KiCad/Early 2021/phôi design pcb/1800 layout/LogoOriginalSawnsProjects.dxf
435.9 x 473.8
