MaiTheSan/PCB-Design/KiCad/Early 2021/phôi design pcb/1800 source - Copy/1800 source/dimension/1800 layoutv2.dxf

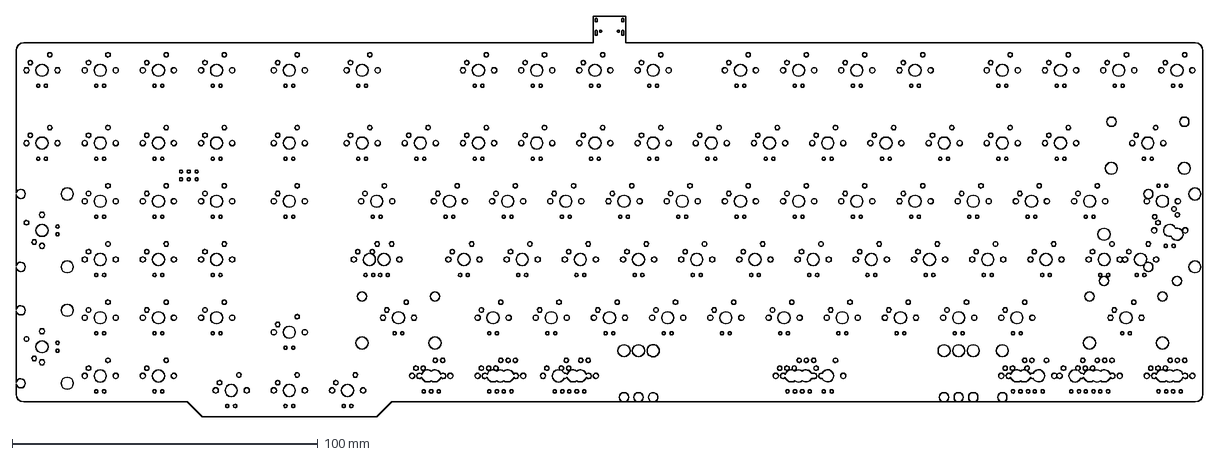
[picture p99: CAD file, 2022-11-19]
KiCad/Early 2021/phôi design pcb/1800 source - Copy/1800 source/dimension/1800 layoutv2.dxf
388.5 x 131.0 mm
