MaiTheSan/PCB-Design/KiCad/Early 2021/phôi design pcb/1800 source - Copy/1800 source/Unlined PCB.step

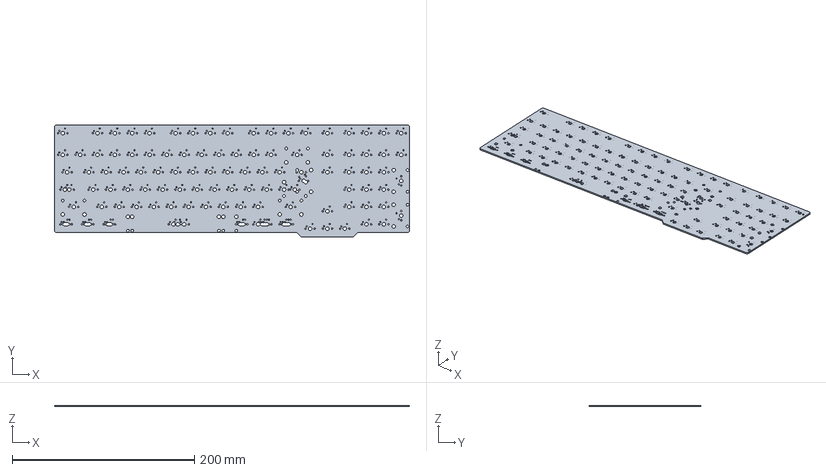
[picture p100: CAD file, 2022-11-19]
KiCad/Early 2021/phôi design pcb/1800 source - Copy/1800 source/Unlined PCB.step
389.7 x 123.0 x 1.60 mm
