MaiTheSan/PCB-Design/KiCad/Early 2021/phôi design pcb/AT-L 1800 AT90/AT - L 1800 AT90/layout.dxf

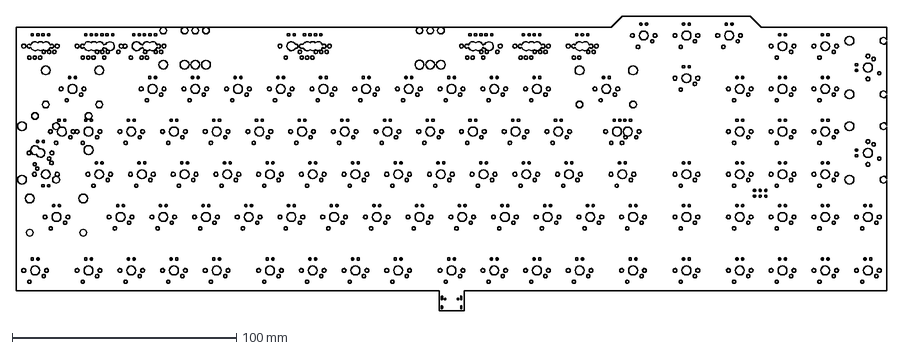
[picture p101: CAD file, 2022-11-19]
KiCad/Early 2021/phôi design pcb/AT-L 1800 AT90/AT - L 1800 AT90/layout.dxf
388.5 x 131.3 mm
