MaiTheSan/PCB-Design/KiCad/Early 2021/SawnsPad/SawnsPad.step

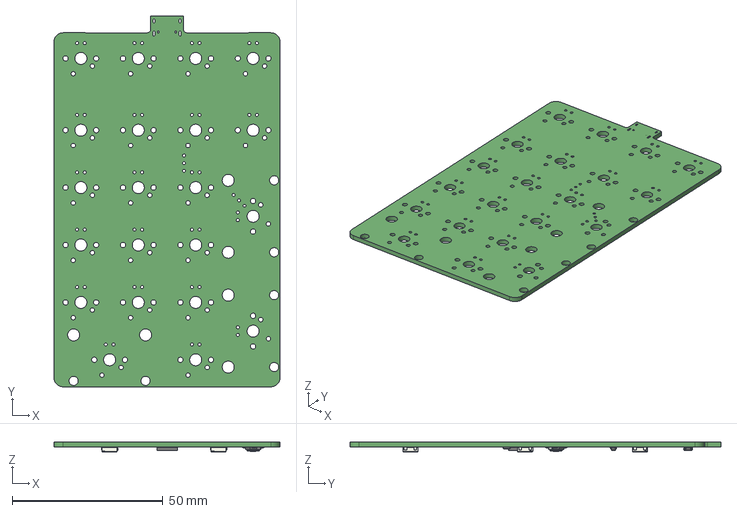
[picture p102: CAD file, 2022-11-19]
KiCad/Early 2021/SawnsPad/SawnsPad.step
75.0 x 123.0 x 3.25 mm
