MaiTheSan/PCB-Design/KiCad/Early 2021/USB - C.SLDPRT

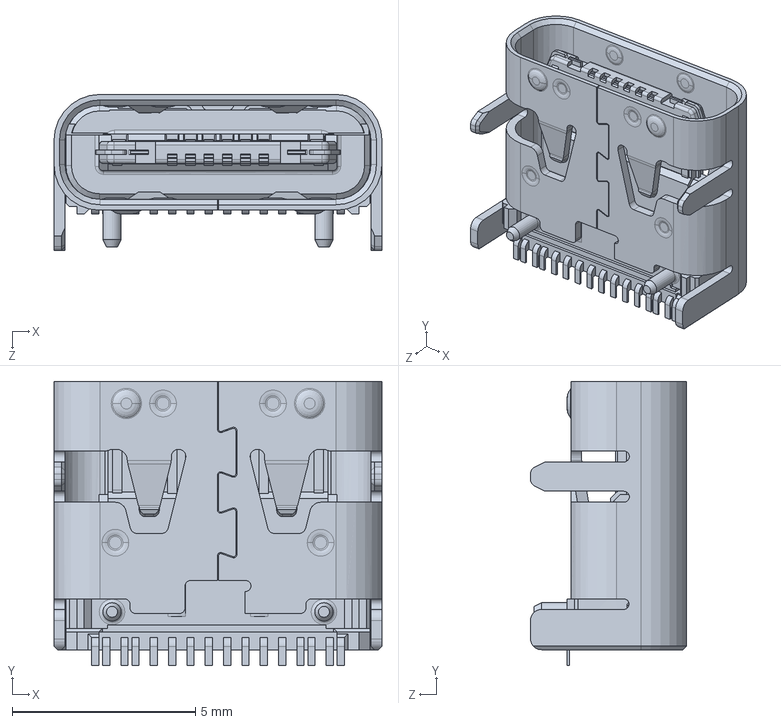
[picture p103: CAD file, 2022-11-19]
KiCad/Early 2021/USB - C.SLDPRT
8.95 x 7.75 x 4.26 mm
