MaiTheSan/PCB-Design/KiCad/Final/steamvan-master/steamvan-master/plates/standard_plate.dxf

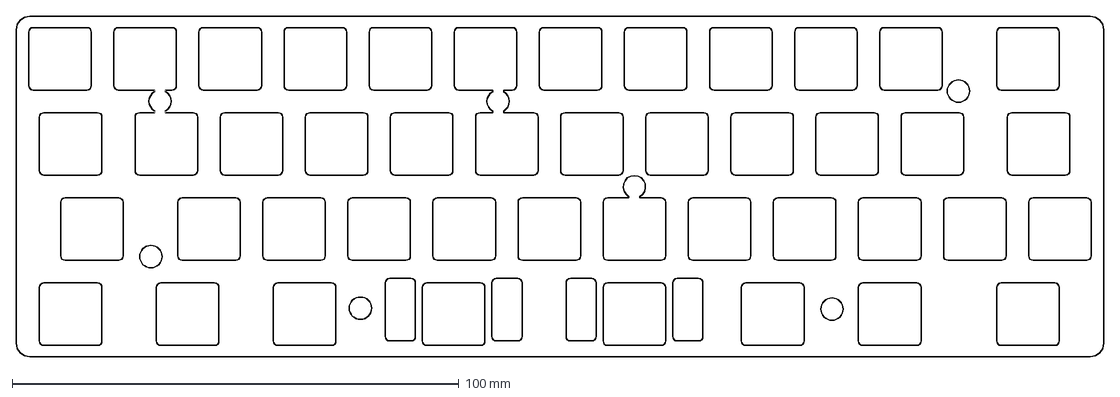
[picture p104: CAD file, 2022-11-19]
KiCad/Final/steamvan-master/steamvan-master/plates/standard_plate.dxf
243.4 x 76.2 mm
