MaiTheSan/PCB-Design/KiCad/Myprojects/Eclipse/Atmega32U4/60 - Copy/a.dxf

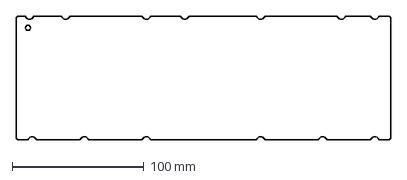
[picture p105: CAD file, 2022-11-19]
KiCad/Myprojects/Eclipse/Atmega32U4/60 - Copy/a.dxf
284.7 x 94.2 mm
