MaiTheSan/PCB-Design/KiCad/Myprojects/Eclipse/Atmega32U4/CatE/Eclipse Voyager/Eclipse Voyager.step

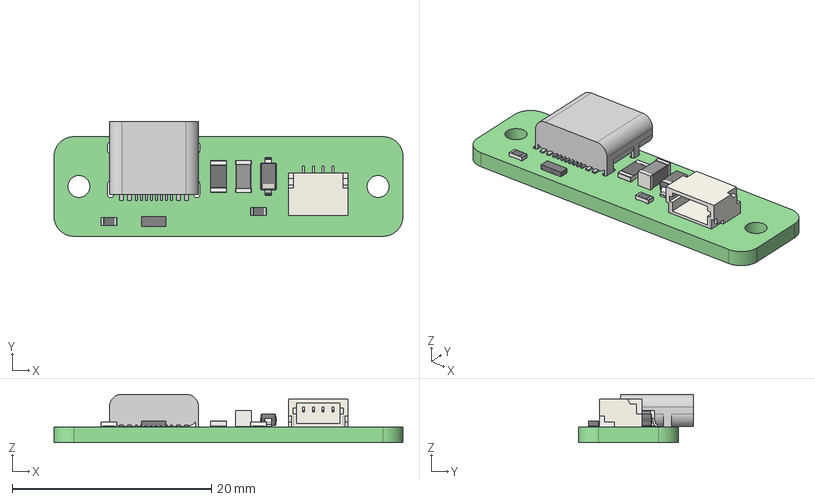
[picture p106: CAD file, 2022-11-19]
KiCad/Myprojects/Eclipse/Atmega32U4/CatE/Eclipse Voyager/Eclipse Voyager.step
35.0 x 11.5 x 4.86 mm
