MaiTheSan/PCB-Design/KiCad/Myprojects/Eclipse/Atmega32U4/CatE/Plate/Eclipse Plate.dxf

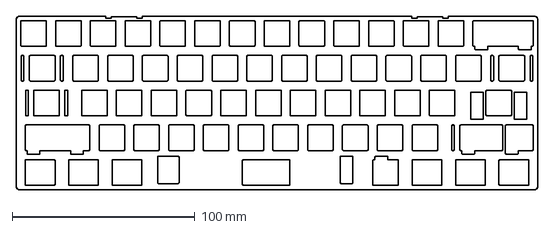
[picture p107: CAD file, 2022-11-19]
KiCad/Myprojects/Eclipse/Atmega32U4/CatE/Plate/Eclipse Plate.dxf
285.8 x 95.3 mm
