MaiTheSan/PCB-Design/KiCad/Myprojects/Eclipse/Atmega32U4/EV65/EV65 outline.dxf

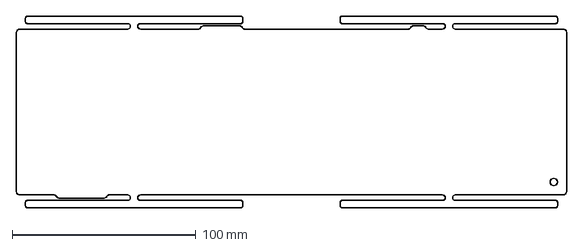
[picture p108: CAD file, 2022-11-19]
KiCad/Myprojects/Eclipse/Atmega32U4/EV65/EV65 outline.dxf
299.8 x 104.3 mm
