MaiTheSan/PCB-Design/KiCad/Myprojects/Eclipse/Atmega32U4/PCB/EdgeCUT.dxf

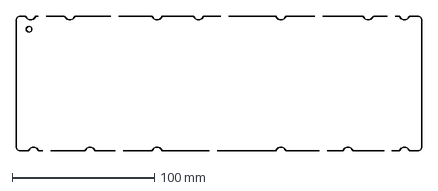
[picture p109: CAD file, 2022-11-19]
KiCad/Myprojects/Eclipse/Atmega32U4/PCB/EdgeCUT.dxf
284.7 x 94.2 mm
