MaiTheSan/PCB-Design/KiCad/Myprojects/lmao/outline.dxf

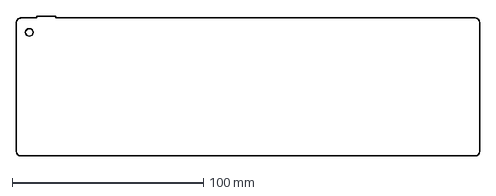
[picture p110: CAD file, 2022-11-19]
KiCad/Myprojects/lmao/outline.dxf
242.2 x 73.1 mm
