MaiTheSan/PCB-Design/KiCad/Myprojects/Onsen48/Case/Flexcase.dxf

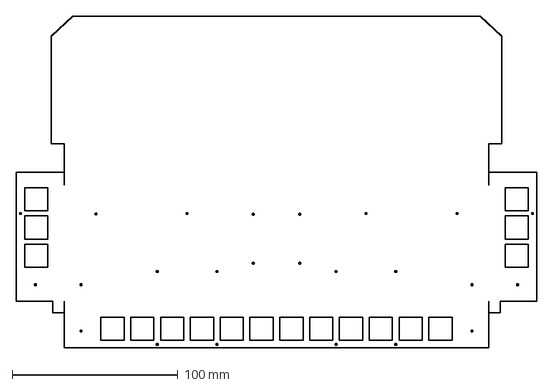
[picture p111: CAD file, 2022-11-19]
KiCad/Myprojects/Onsen48/Case/Flexcase.dxf
314.0 x 200.0 mm
