MaiTheSan/PCB-Design/KiCad/Myprojects/Onsen48/Onsen48.step

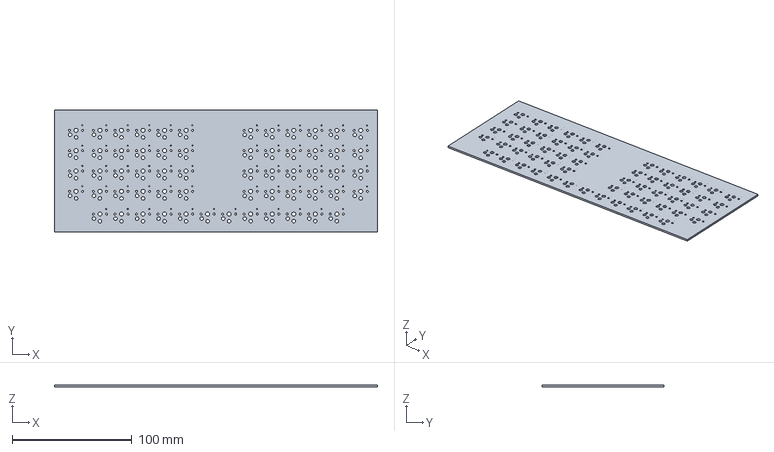
[picture p112: CAD file, 2022-11-19]
KiCad/Myprojects/Onsen48/Onsen48.step
270.0 x 102.0 x 1.60 mm
