MaiTheSan/PCB-Design/KiCad/Myprojects/StabilizerShims/a.dxf

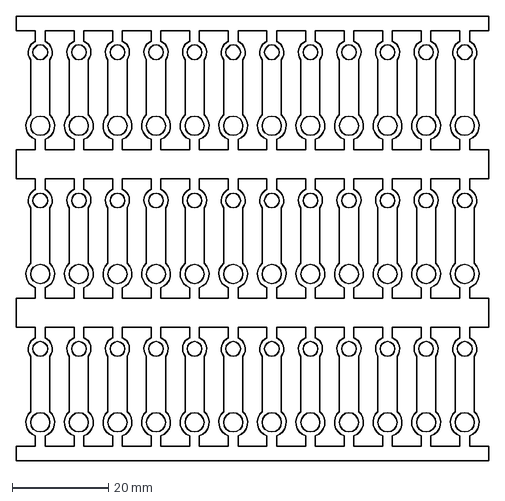
[picture p113: CAD file, 2022-11-19]
KiCad/Myprojects/StabilizerShims/a.dxf
98.0 x 92.2 mm
