MaiTheSan/PCB-Design/KiCad/Myprojects/Sudo/sudo pacman -S Yay/outline.dxf

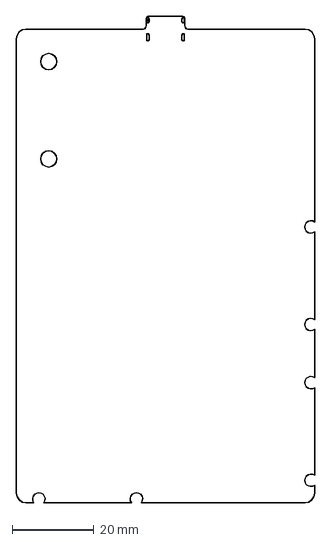
[picture p114: CAD file, 2022-11-19]
KiCad/Myprojects/Sudo/sudo pacman -S Yay/outline.dxf
73.0 x 119.1 mm
