MaiTheSan/PCB-Design/KiCad/our projects/60 - STM - 072 - 11 - DG - 000 - S (MyS)/outline/RGB daughter/RGB Board.step

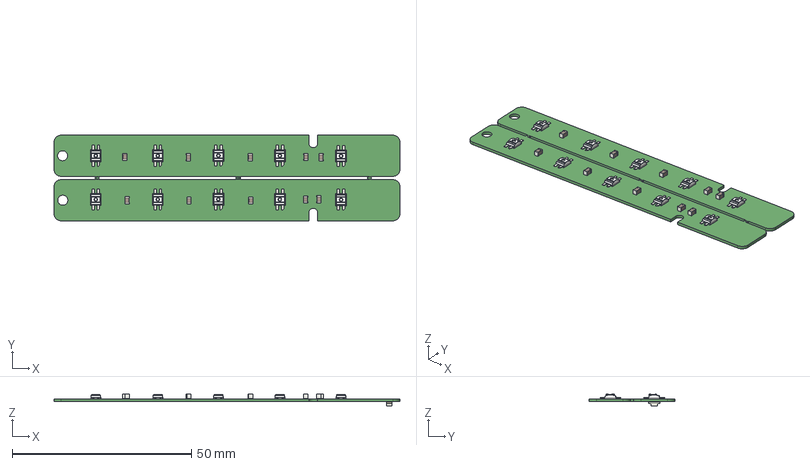
[picture p115: CAD file, 2022-11-19]
KiCad/our projects/60 - STM - 072 - 11 - DG - 000 - S (MyS)/outline/RGB daughter/RGB Board.step
96.5 x 23.9 x 3.25 mm
