MaiTheSan/PCB-Design/KiCad/our projects/uso!/Case/2mm/Plate.dxf

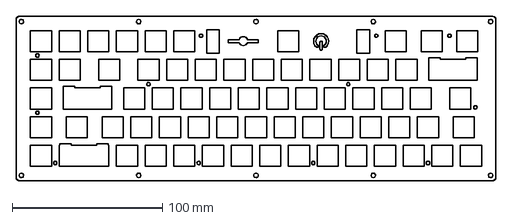
[picture p116: CAD file, 2022-11-19]
KiCad/our projects/uso!/Case/2mm/Plate.dxf
318.8 x 109.2 mm
