MaiTheSan/PCB-Design/KiCad/our projects/uso!/Case/3mm/Feet layer 3.dxf

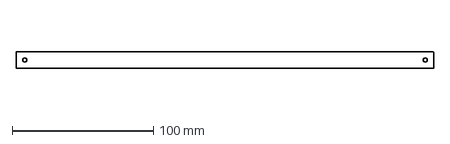
[picture p117: CAD file, 2022-11-19]
KiCad/our projects/uso!/Case/3mm/Feet layer 3.dxf
295.2 x 12.0 mm
