MaiTheSan/PCB-Design/KiCad/our projects/uso!/Case/5mm/Top.dxf

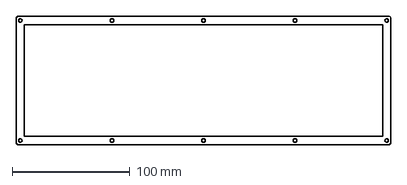
[picture p118: CAD file, 2022-11-19]
KiCad/our projects/uso!/Case/5mm/Top.dxf
318.8 x 109.2 mm
