MaiTheSan/PCB-Design/KiCad/our projects/uso!/FR4 Plate/plate.dxf

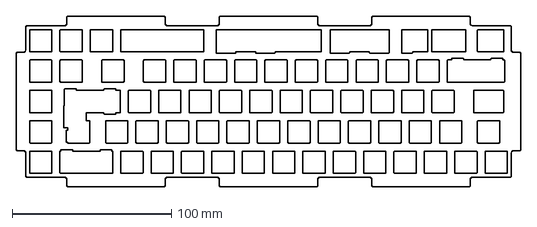
[picture p119: CAD file, 2022-11-19]
KiCad/our projects/uso!/FR4 Plate/plate.dxf
316.8 x 107.3 mm
