MaiTheSan/PCB-Design/KiCad/Plate/60FR4.dxf

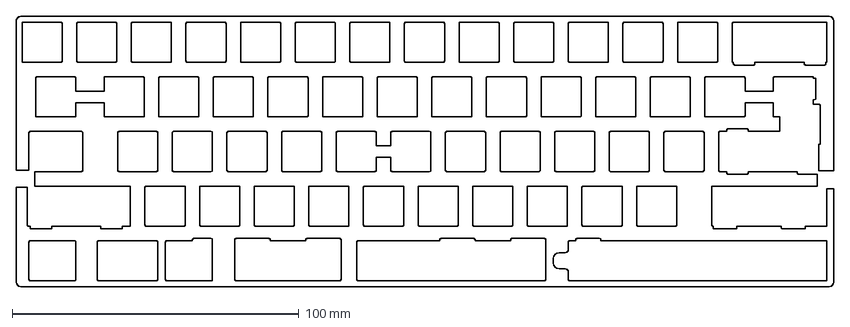
[picture p120: CAD file, 2022-11-19]
KiCad/Plate/60FR4.dxf
285.0 x 94.2 mm
