MaiTheSan/PCB-Design/KiCad/Plate/Alice plate/outline.dxf

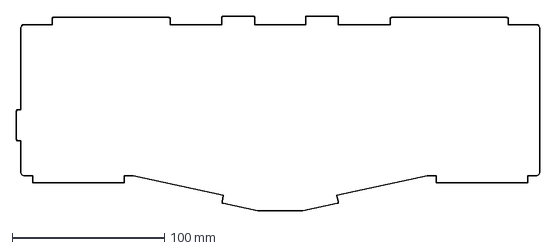
[picture p121: CAD file, 2022-11-19]
KiCad/Plate/Alice plate/outline.dxf
343.4 x 127.7 mm
