MaiTheSan/PCB-Design/KiCad/Plate/krush60/krush60-plate.dxf

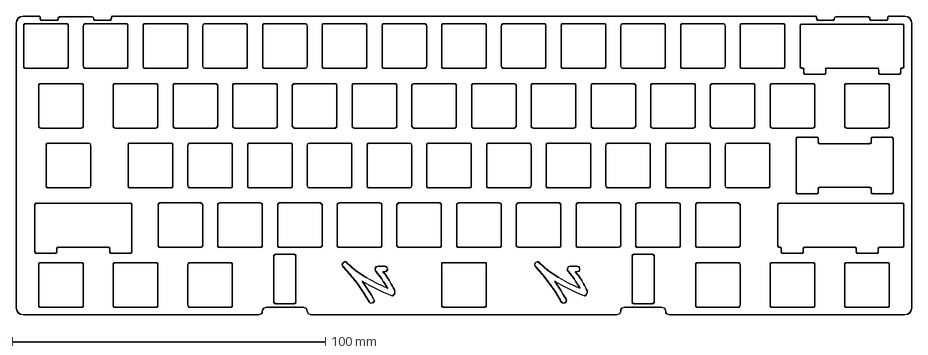
[picture p122: CAD file, 2022-11-19]
KiCad/Plate/krush60/krush60-plate.dxf
285.8 x 95.3 mm
