MaiTheSan/PCB-Design/KiCad/Plate/RE65/a.dxf

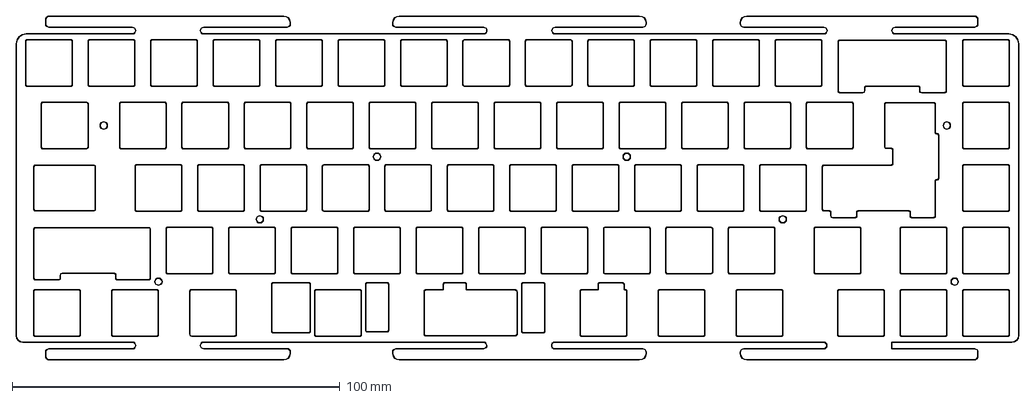
[picture p123: CAD file, 2022-11-19]
KiCad/Plate/RE65/a.dxf
305.7 x 104.9 mm
