MaiTheSan/PCB-Design/KiCad/Source/bakeneko-60-develop/bakeneko-60-develop/case-pla/bakeneko-60-pla-split-left.stl

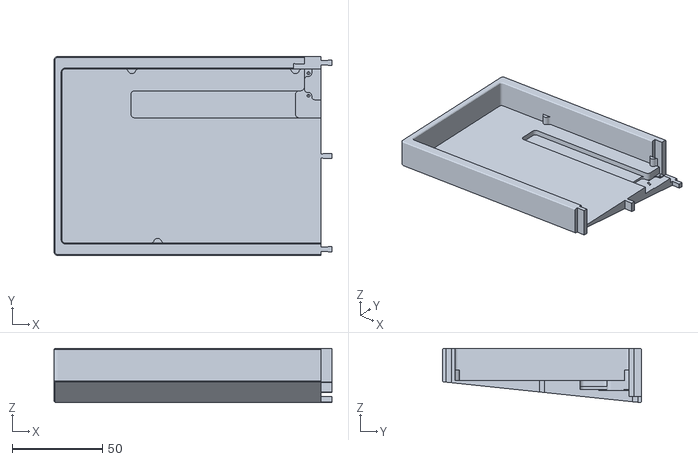
[picture p124: CAD file, 2022-11-19]
KiCad/Source/bakeneko-60-develop/bakeneko-60-develop/case-pla/bakeneko-60-pla-split-left.stl
153.9 x 110.2 x 30.0
