MaiTheSan/PCB-Design/KiCad/Source/bakeneko-60-develop/bakeneko-60-develop/case/bakeneko-60-case.step

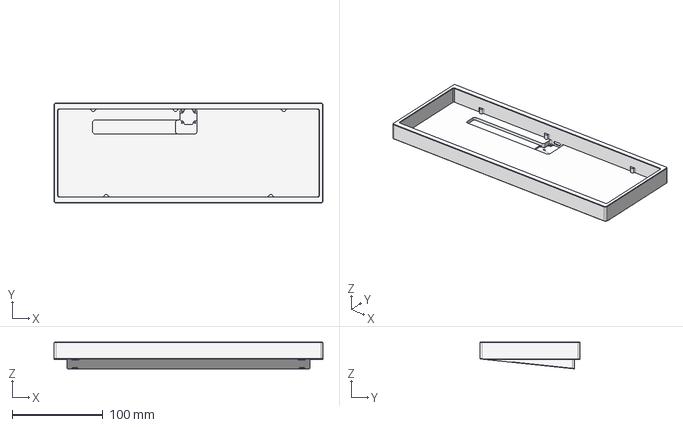
[picture p125: CAD file, 2022-11-19]
KiCad/Source/bakeneko-60-develop/bakeneko-60-develop/case/bakeneko-60-case.step
295.7 x 110.2 x 29.4 mm
