MaiTheSan/PCB-Design/KiCad/Source/bakeneko-60-develop/bakeneko-60-develop/plate/bakeneko-60-plate.dxf

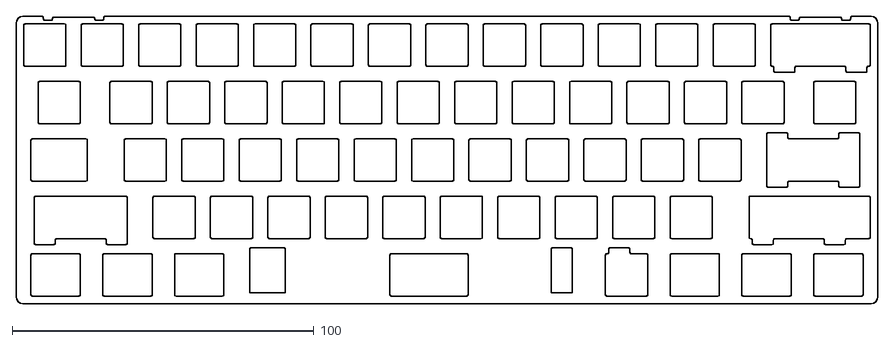
[picture p126: CAD file, 2022-11-19]
KiCad/Source/bakeneko-60-develop/bakeneko-60-develop/plate/bakeneko-60-plate.dxf
285.8 x 95.3
