MaiTheSan/PCB-Design/KiCad/Source/discipline-master/acrylic-case/discipline-foot-2.dxf

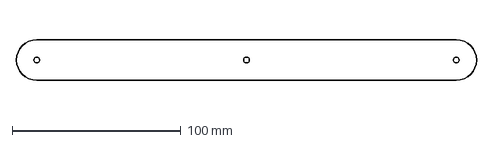
[picture p127: CAD file, 2022-11-19]
KiCad/Source/discipline-master/acrylic-case/discipline-foot-2.dxf
272.5 x 24.0 mm
