MaiTheSan/PCB-Design/KiCad/Source/discipline-master/kit-acrylic/acrylic-guard.dxf

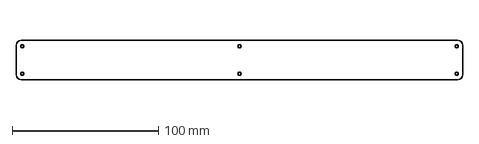
[picture p128: CAD file, 2022-11-19]
KiCad/Source/discipline-master/kit-acrylic/acrylic-guard.dxf
304.9 x 26.8 mm
