MaiTheSan/PCB-Design/KiCad/Source/discipline-master/plate/discipline-plate-test.dxf

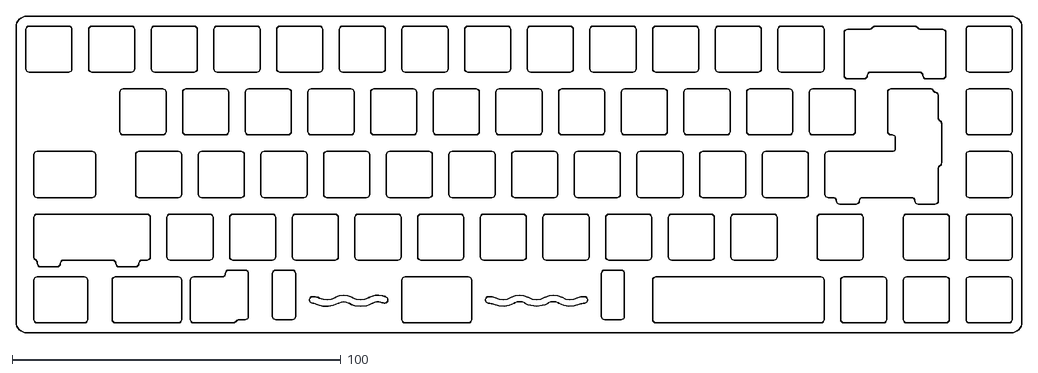
[picture p129: CAD file, 2022-11-19]
KiCad/Source/discipline-master/plate/discipline-plate-test.dxf
305.8 x 96.2
