MaiTheSan/PCB-Design/KiCad/Source/E80-1800-master/E80-1800-master/cardreader-inserts/oled-blocker.stl

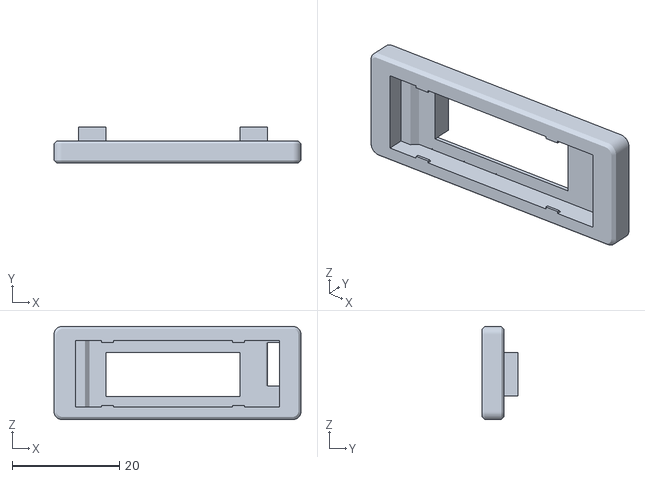
[picture p130: CAD file, 2022-11-19]
KiCad/Source/E80-1800-master/E80-1800-master/cardreader-inserts/oled-blocker.stl
46.0 x 6.72 x 17.3
