MaiTheSan/PCB-Design/Salane Reboot/[A]ddiction/[A]ddiction Alice/Hotswap/STM32/outline.dxf

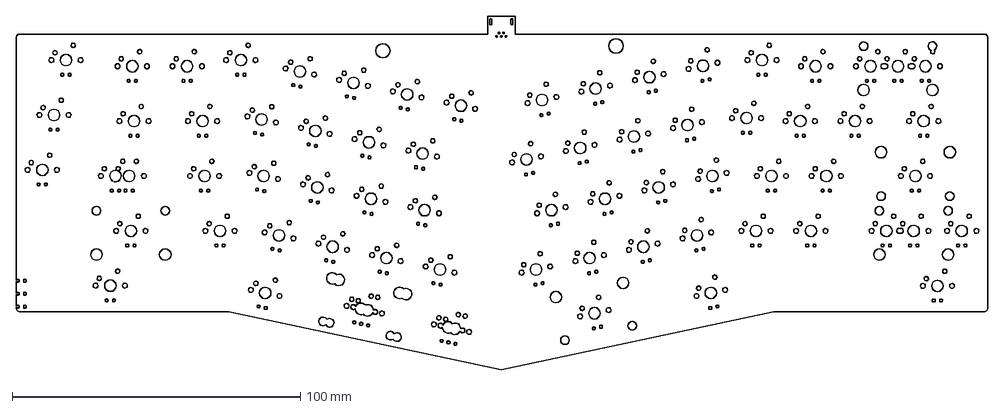
[picture p131: CAD file, 2022-11-19]
Salane Reboot/[A]ddiction/[A]ddiction Alice/Hotswap/STM32/outline.dxf
337.2 x 122.6 mm
