MaiTheSan/PCB-Design/Salane Reboot/Armageddon/a.dxf

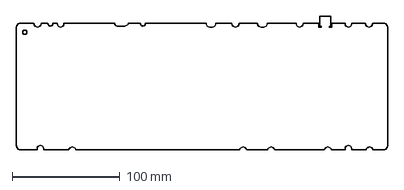
[picture p132: CAD file, 2022-11-25]
Salane Reboot/Armageddon/a.dxf
344.0 x 124.0 mm
