MaiTheSan/PCB-Design/Salane Reboot/Fly Daughterboard/Fly Daughterboard/JST outline.dxf

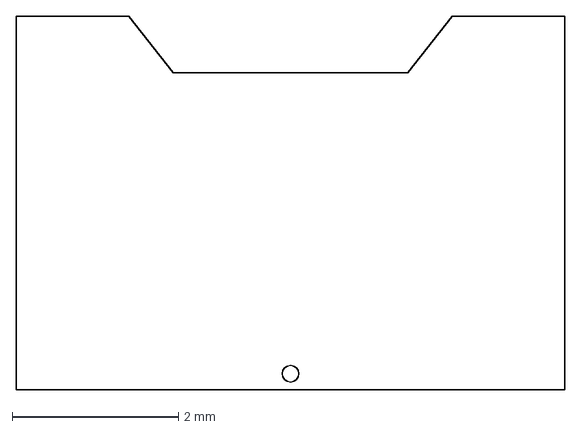
[picture p133: CAD file, 2022-11-19]
Salane Reboot/Fly Daughterboard/Fly Daughterboard/JST outline.dxf
6.60 x 4.50 mm
