MaiTheSan/PCB-Design/Salane Reboot/Fly Daughterboard/Outline2.dxf

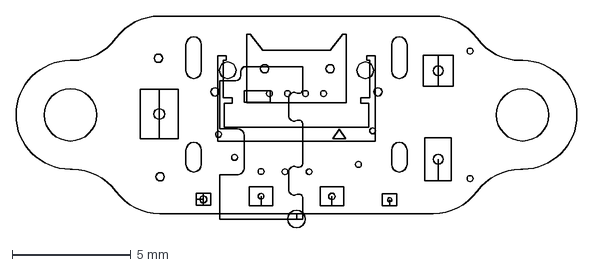
[picture p134: CAD file, 2022-11-19]
Salane Reboot/Fly Daughterboard/Outline2.dxf
23.6 x 8.90 mm
