MaiTheSan/PCB-Design/Salane Reboot/Odyssey/ATmega32U4/TypeC WS2812B/North Stab Spacebar/a.dxf

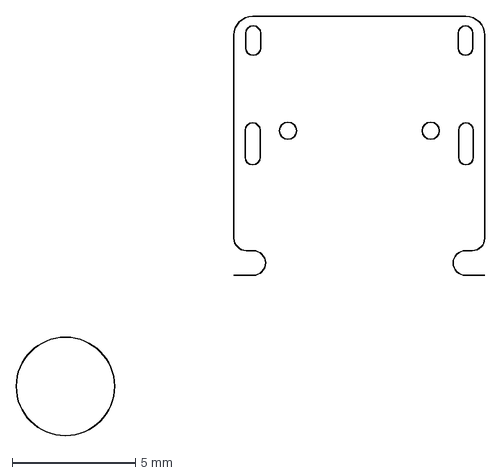
[picture p135: CAD file, 2022-11-19]
Salane Reboot/Odyssey/ATmega32U4/TypeC WS2812B/North Stab Spacebar/a.dxf
19.0 x 17.0 mm
