MaiTheSan/PCB-Design/Salane Reboot/Odyssey/PCB-master/PCB-master/1800-Compact/PCB.step

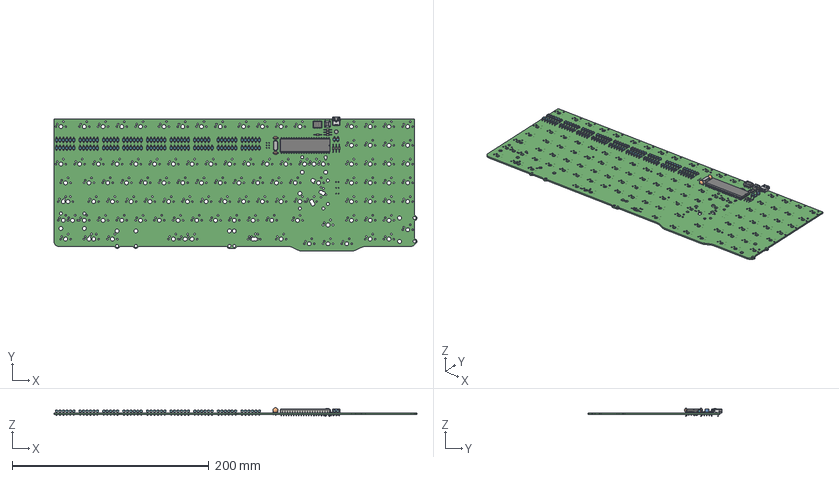
[picture p136: CAD file, 2022-11-19]
Salane Reboot/Odyssey/PCB-master/PCB-master/1800-Compact/PCB.step
368.9 x 136.5 x 8.69 mm
