MaiTheSan/PCB-Design/Salane Reboot/Odyssey/PCB-master/PCB-master/60-PCB/Common60/PCB-Common60.step

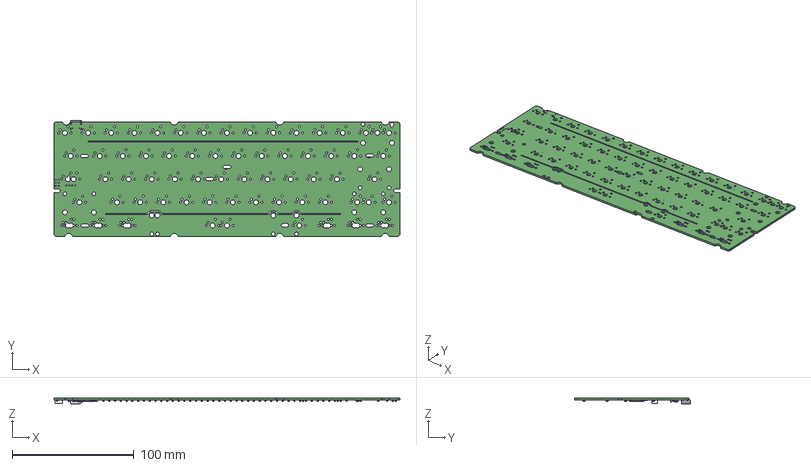
[picture p137: CAD file, 2022-11-19]
Salane Reboot/Odyssey/PCB-master/PCB-master/60-PCB/Common60/PCB-Common60.step
284.7 x 95.3 x 4.86 mm
