MaiTheSan/PCB-Design/Salane Reboot/Odyssey/PCB-master/PCB-master/Adelais/Adelais_rev3.step

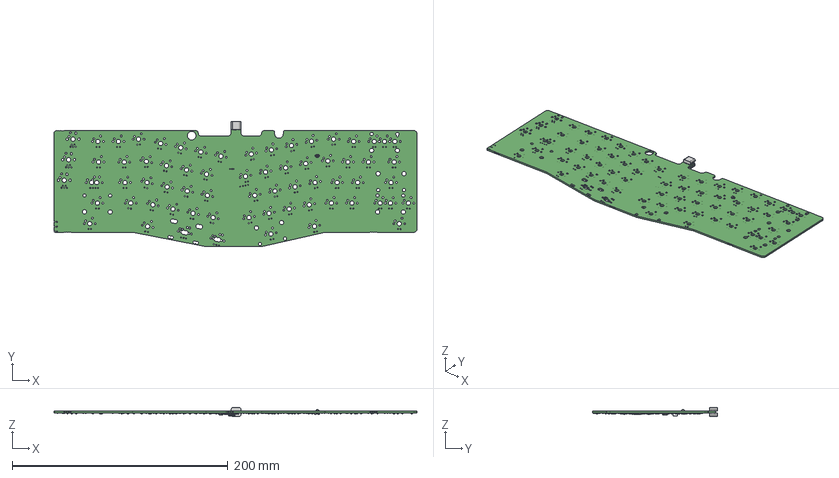
[picture p138: CAD file, 2022-11-19]
Salane Reboot/Odyssey/PCB-master/PCB-master/Adelais/Adelais_rev3.step
336.7 x 116.1 x 8.12 mm
