MaiTheSan/PCB-Design/Salane Reboot/Odyssey/PCB-master/PCB-master/Daughter_Board/DB-rev4- top-connector.step

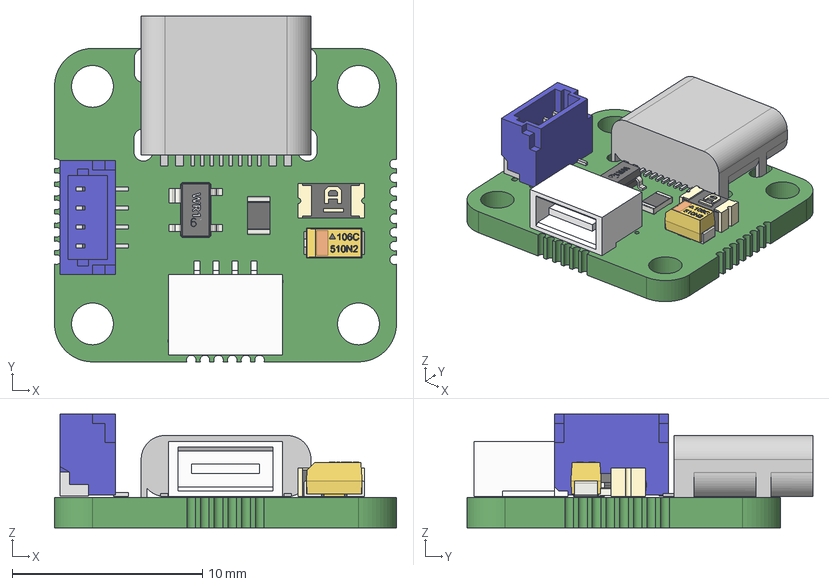
[picture p139: CAD file, 2022-11-19]
Salane Reboot/Odyssey/PCB-master/PCB-master/Daughter_Board/DB-rev4- top-connector.step
18.0 x 18.2 x 5.98 mm
