MaiTheSan/PCB-Design/Salane Reboot/Odyssey/PCB-master/PCB-master/Delphine/delphine-rev.1.step

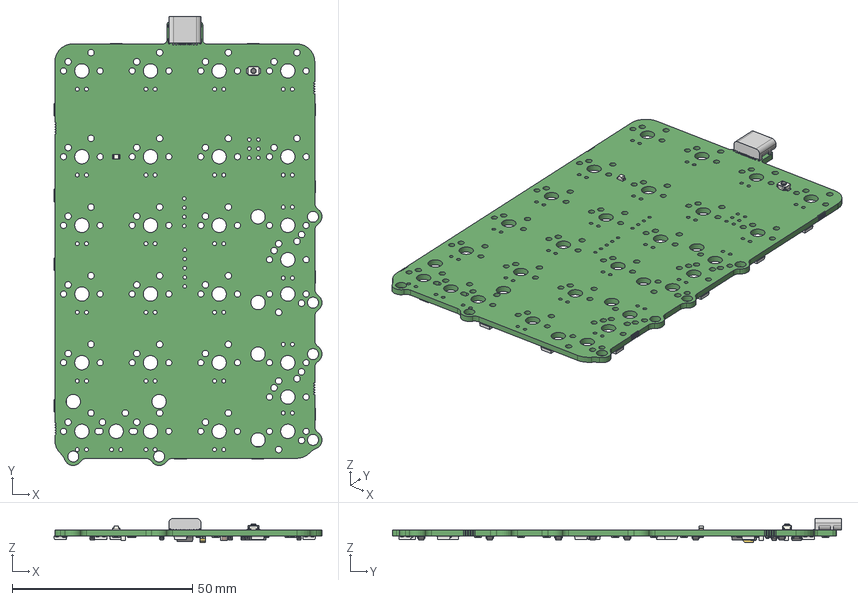
[picture p140: CAD file, 2022-11-19]
Salane Reboot/Odyssey/PCB-master/PCB-master/Delphine/delphine-rev.1.step
74.4 x 124.6 x 6.71 mm
