MaiTheSan/PCB-Design/Salane Reboot/Odyssey/PCB-master/PCB-master/Hannah910/Hannah910_rev3_typeC.step

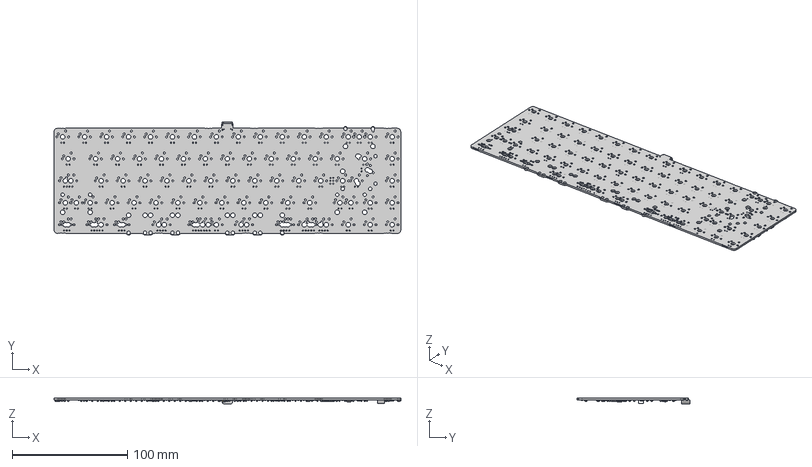
[picture p141: CAD file, 2022-11-19]
Salane Reboot/Odyssey/PCB-master/PCB-master/Hannah910/Hannah910_rev3_typeC.step
300.9 x 98.2 x 4.86 mm
