MaiTheSan/PCB-Design/Salane Reboot/Odyssey/PCB-master/PCB-master/Mechlovin9/Kyuu-Plate.step

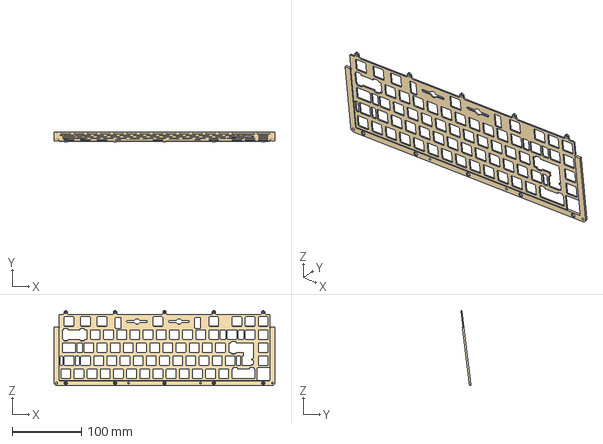
[picture p142: CAD file, 2022-11-19]
Salane Reboot/Odyssey/PCB-master/PCB-master/Mechlovin9/Kyuu-Plate.step
319.8 x 14.8 x 108.7 mm
