MaiTheSan/PCB-Design/Salane Reboot/Salane usO/outline 2.dxf

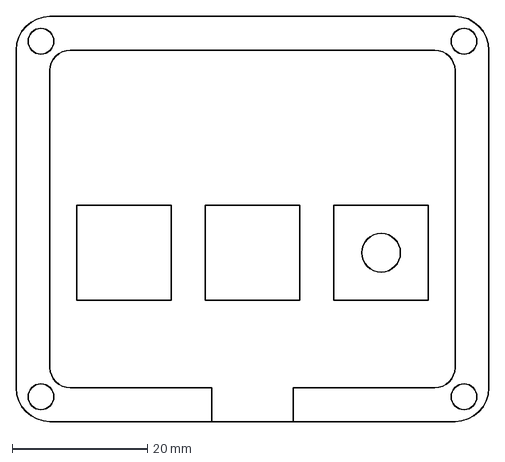
[picture p143: CAD file, 2022-12-31]
Salane Reboot/Salane usO/outline 2.dxf
70.0 x 60.0 mm
