MaiTheSan/PCB-Design/3D Components/SM04B-SRSS-TB.step

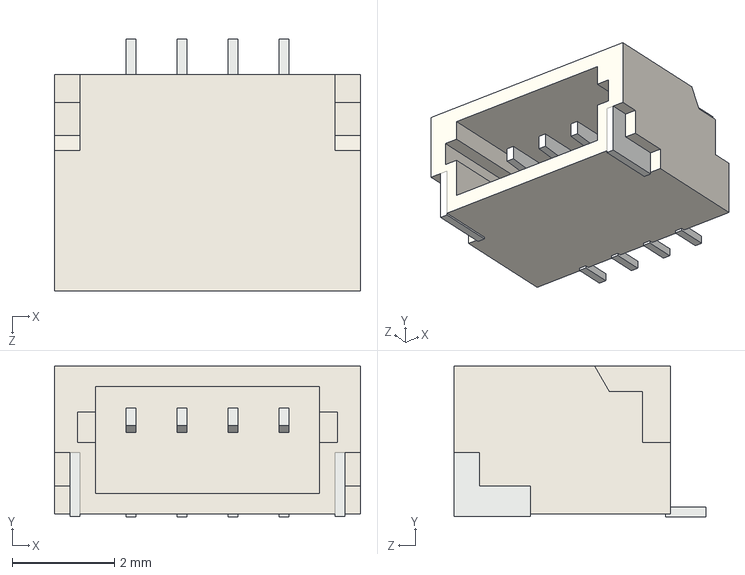
[picture p144: CAD file, 2022-11-19]
3D Components/SM04B-SRSS-TB.step
6.00 x 2.96 x 4.95 mm
