MaiTheSan/PCB-Design/KiCad/06-2021 comm/Leopold Replacement/TypeC/resource/nt660-Edge_Cuts.dxf

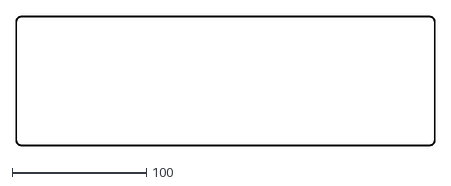
[picture p146: CAD file, 2022-11-19]
KiCad/06-2021 comm/Leopold Replacement/TypeC/resource/nt660-Edge_Cuts.dxf
312.2 x 96.3
