MaiTheSan/PCB-Design/KiCad/06-2021 comm/theo60 plate/Ansi/outline.dxf

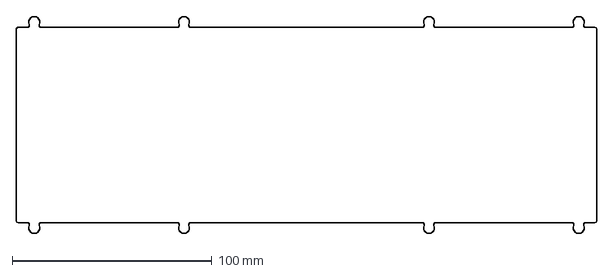
[picture p147: CAD file, 2022-11-19]
KiCad/06-2021 comm/theo60 plate/Ansi/outline.dxf
290.7 x 108.9 mm
