MaiTheSan/PCB-Design/KiCad/06-2021 comm/theo60 plate/ISO/theo60ISO.dxf

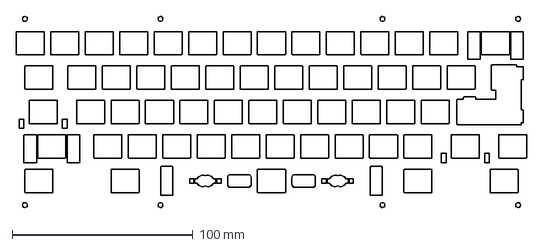
[picture p148: CAD file, 2022-11-19]
KiCad/06-2021 comm/theo60 plate/ISO/theo60ISO.dxf
282.2 x 105.7 mm
