MaiTheSan/PCB-Design/(list of files, cad)

Other CAD files:
KiCad/4-2022/Viendi 2 Prototype layout/Viendi 2/Viendi2/Viendi2_daughterboard2/border-mach-usb.dwg
KiCad/Early 2021/Alice/alice_case_acrylic.DWG
KiCad/Early 2021/Alice/Lubrigante-master/Lubrigante-master/misc/tgr/alice_case_acrylic.DWG
KiCad/Source/Voyager65-Keyplus/Voyager65-Keyplus-master/DXF/Voyager65-F.Fab.dxf
Salane Reboot/Odyssey/PCB-master/PCB-master/TKL PCB - Infinity Series/Rouge87/OTD-PC-Plate-23062021.dwg
3D Components/3313J-1-202E.stp
3D Components/4PinHeader.step
3D Components/5032_XTAL.step
3D Components/6028SMDRGB.iges
3D Components/9774010243.stp
3D Components/9774030243R.step
3D Components/ACM2012-2P.STEP
3D Components/ALPS_EC11E.stp
3D Components/BM04B-ASRS-TF.STEP
3D Components/BM04B-SRSS.step
3D Components/CD4148WP.step
3D Components/E6C1209RGB.iges
3D Components/FUSE_1812.STEP
3D Components/MDBT40.step
3D Components/OSC5032.STEP
3D Components/QFN28-P0.4mm.step
3D Components/RKJXT1F42001.STEP
3D Components/SK6805-2.4x2.7.step
3D Components/SM05B-SRSS-TB.STEP
3D Components/SM11B-SRSS-TB.STEP
3D Components/SM11B-SRSS_TB.step
3D Components/SM13B-SRSS-TB.STEP
3D Components/SM14B-SRSS-TB.STEP
3D Components/SM20B-SRSS-TB.STEP
3D Components/SMD3535 RGB.stp
3D Components/TE-1744426-4.stp
3D Components/TE-2132415-4.stp
3D Components/TYPE-C-31-M-12.step
3D Components/TYPE-C-31-M-14.step
3D Components/Tactile_SMD_PushBtn_5x5mm.STEP
3D Components/UX60SC-MB-5S8.stp
3D Components/WS2812-Mini.step
3D Components/WS2812.stp
3D Components/XM7D-0512.STEP
3D Components/angle4PinHeader.step
3D Components/angle6PinHeader.stp
3D Components/kailh_socket_mx.stp
3D Components/keystone-PN3030TR.STEP
3D Components/male6PinHeader.stp
3D Components/mx_switch.step
3D Components/wurth_632723300011.stp
KiCad/08-2021/hmmm/pcb/plain60-flex-edition-drl_map.dxf
KiCad/08-2021/nonem/finaloutlinepcbnoway (1).dxf
KiCad/08-2021/nonem/nonem.step
KiCad/1-2022/Krush60HS/outlinewink.dxf
KiCad/12-2021/Amber80/solder/solder noncommission/outline.dxf
KiCad/12-2021/Amber80/solder/solder noncommission/outline3.dxf
KiCad/4-2022/Nuxros Alice commission/flexcut.dxf
KiCad/4-2022/Viendi 2 Prototype layout/Viendi 2/Viendi2/Viendi2/outline and switch.dxf
KiCad/4-2022/Viendi 2 Prototype layout/Viendi 2/Viendi2/Viendi2/outline and switch2.dxf
KiCad/4-2022/Viendi 2 Prototype layout/Viendi 2/Viendi2/Viendi2_daughterboard/Viendi2_daughterboard.step
KiCad/4-2022/Viendi 2 Prototype layout/Viendi 2/Viendi2/Viendi2_daughterboard/a.dxf
KiCad/4-2022/Viendi 2 Prototype layout/Viendi 2/Viendi2/Viendi2_daughterboard2/Viendi2_daughterboard_USB.step
KiCad/4-2022/Viendi 2 Prototype layout/Viendi 2/Viendi2/Viendi2_daughterboard2/a.dxf
KiCad/Early 2021/Alice/Opensource/bmek-master/bmek-master/cases/old_integrated_plate_case/CaseBottom.stl
KiCad/Early 2021/Alice/Opensource/bmek-master/bmek-master/cases/top_mount/Blocker/Blocker.step
KiCad/Early 2021/Alice/Opensource/bmek-master/bmek-master/cases/top_mount/Blocker/Blocker.stl
KiCad/Early 2021/Alice/Opensource/bmek-master/bmek-master/cases/top_mount/BottomCase/BottomCase.stl
KiCad/Early 2021/Alice/Opensource/bmek-master/bmek-master/cases/top_mount/SwitchPlate/SwitchPlate.dxf
KiCad/Early 2021/Alice/Opensource/bmek-master/bmek-master/cases/top_mount/SwitchPlate/SwitchPlate.step
KiCad/Early 2021/Alice/Opensource/bmek-master/bmek-master/cases/top_mount/SwitchPlate/SwitchPlate_ThreeQuarterFlex.dxf
KiCad/Early 2021/Alice/Opensource/bmek-master/bmek-master/cases/top_mount/TopCase/TopCase.stl
KiCad/Early 2021/Alice/Opensource/bmek-master/bmek-master/cases/top_mount/WristRest/WristRest.stl
KiCad/Early 2021/Alice/alice_PCB_layout.DWG
KiCad/Early 2021/Alice/alice_case_acrylic with Brass plate.DWG
KiCad/Early 2021/Alice/alice_plate_rev_C.DWG
KiCad/Early 2021/Backup KBD67.f3d
KiCad/Early 2021/EV65 from Voyager/EV65 prototype/Voyager65-Keyplus-master/Voyager65-Keyplus-master/DXF/Voyager65-B.Mask.dxf
KiCad/Early 2021/EV65 from Voyager/EV65 prototype/Voyager65-Keyplus-master/Voyager65-Keyplus-master/DXF/Voyager65-B.Paste.dxf
KiCad/Early 2021/EV65 from Voyager/EV65 prototype/Voyager65-Keyplus-master/Voyager65-Keyplus-master/DXF/Voyager65-B.SilkS.dxf
KiCad/Early 2021/EV65 from Voyager/EV65 prototype/Voyager65-Keyplus-master/Voyager65-Keyplus-master/DXF/Voyager65-F.Fab.dxf
KiCad/Early 2021/EV65 from Voyager/EV65 prototype/Voyager65-Keyplus-master/Voyager65-Keyplus-master/DXF/Voyager65-F.Mask.dxf
KiCad/Early 2021/EV65 from Voyager/EV65 prototype/Voyager65-Keyplus-master/Voyager65-Keyplus-master/DXF/Voyager65-F.Paste.dxf
KiCad/Early 2021/EV65 from Voyager/EV65 prototype/Voyager65-Keyplus-master/Voyager65-Keyplus-master/DXF/Voyager65-F.SilkS.dxf
KiCad/Early 2021/EV65 from Voyager/EV65 prototype/Voyager65-Keyplus-master/Voyager65-Keyplus-master/Plate/Source/Tada68-MX.dxf
KiCad/Early 2021/EV65 from vyg60/Voyager60-master - Copy - Copy/EV65.step
KiCad/Early 2021/EV65 from vyg60/Voyager60-master to EV65/EV65.step
KiCad/Early 2021/EV65 from vyg60/Voyager60-master/EV65.step
KiCad/Early 2021/Fix 90 Degree.step
KiCad/Early 2021/KBD67 MKII 5 Degree.f3d
KiCad/Early 2021/KBD67 MKII Yoake 5 Degree.f3d
KiCad/Early 2021/KBD67 MKII Yoake 7 Degree.f3d
KiCad/Early 2021/LAYOUT/1800.dxf
KiCad/Early 2021/LAYOUT/EV65 Dimension.step
KiCad/Early 2021/LAYOUT/HHKB.dxf
KiCad/Early 2021/LAYOUT/PCB Layout.dxf
KiCad/Early 2021/LAYOUT/Q75V4.dxf
KiCad/Early 2021/LAYOUT/RGB60.dxf
KiCad/Early 2021/LAYOUT/RGB60ansi.dxf
KiCad/Early 2021/LAYOUT/RGB60hhkb.dxf
KiCad/Early 2021/LAYOUT/RGB68v2.dwg
KiCad/Early 2021/LAYOUT/dz60.dxf
KiCad/Early 2021/LAYOUT/keyboard (1).dxf
KiCad/Early 2021/LAYOUT/layout.dxf
KiCad/Early 2021/Prototype case.step
KiCad/Early 2021/Prototype.step
KiCad/Early 2021/Render.f3d
KiCad/Early 2021/Voyager-EV65.step
KiCad/Early 2021/Weight Tofu65% .step
KiCad/Myprojects/Eclipse/Atmega32U4/Eclipse60 MoonGate/MoongateWKL.dxf
KiCad/Myprojects/Eclipse/Atmega32U4/PCB/Hiney H60 outline edge cut.dxf
KiCad/Myprojects/Eclipse/Atmega32U4/PCB/Hiney H60 outline.dxf
KiCad/Myprojects/Onsen48/Naked48_Top_Plate.step
KiCad/Myprojects/Onsen48/PCB outline 2.dxf
KiCad/Myprojects/Onsen48/PCB outline.dxf
KiCad/Myprojects/StabilizerShims/b.dxf
KiCad/Myprojects/StabilizerShims/c.dxf
KiCad/Plate/60.dxf
KiCad/Plate/Alice plate/FR4.dxf
KiCad/Plate/Plate.step
KiCad/Plate/Plate60tray.step
KiCad/Plate/RE65/b.dxf
KiCad/Plate/kbd67plate.dxf
KiCad/Plate/krush60/a.dxf
KiCad/Plate/plate-kb3567.dxf
KiCad/Source/E80-1800-master/E80-1800-master/cardreader-inserts/closed-blocker.stl
KiCad/Source/Voyager65-Keyplus/Voyager65-Keyplus-master/DXF/Voyager65-B.Mask.dxf
KiCad/Source/Voyager65-Keyplus/Voyager65-Keyplus-master/DXF/Voyager65-B.Paste.dxf
KiCad/Source/Voyager65-Keyplus/Voyager65-Keyplus-master/DXF/Voyager65-B.SilkS.dxf
KiCad/Source/Voyager65-Keyplus/Voyager65-Keyplus-master/DXF/Voyager65-F.Mask.dxf
KiCad/Source/Voyager65-Keyplus/Voyager65-Keyplus-master/DXF/Voyager65-F.Paste.dxf
KiCad/Source/Voyager65-Keyplus/Voyager65-Keyplus-master/DXF/Voyager65-F.SilkS.dxf
KiCad/Source/Voyager65-Keyplus/Voyager65-Keyplus-master/Plate/Source/Tada68-MX.dxf
KiCad/Source/bakeneko-60-develop/bakeneko-60-develop/case-pla/bakeneko-60-pla-split-right.stl
KiCad/Source/bakeneko-60-develop/bakeneko-60-develop/case-pla/bakeneko-60-pla-split-usb.stl
KiCad/Source/bakeneko-60-develop/bakeneko-60-develop/case-pla/bakeneko-60-pla.step
KiCad/Source/discipline-master/acrylic-case/discipline-bottom.dxf
KiCad/Source/discipline-master/acrylic-case/discipline-closed-layer.dxf
KiCad/Source/discipline-master/acrylic-case/discipline-foot-1.dxf
KiCad/Source/discipline-master/acrylic-case/discipline-foot-3.dxf
KiCad/Source/discipline-master/acrylic-case/discipline-open-layer.dxf
KiCad/Source/discipline-master/acrylic-case/discipline-plate.dxf
KiCad/Source/discipline-master/acrylic-case/discipline-top1.dxf
KiCad/Source/discipline-master/acrylic-case/discipline-top2.dxf
KiCad/Source/discipline-master/kit-acrylic/discipline-kitfoot-1.dxf
KiCad/Source/discipline-master/kit-acrylic/discipline-kitfoot-2.dxf
KiCad/Source/discipline-master/kit-acrylic/discipline-kitfoot-3.dxf
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
