MaiTheSan/PCB-Design/KiCad/Early 2021/phôi design pcb/AT-L 1800 AT90/AT - L 1800 AT90/SCH/1800 layout.pdf

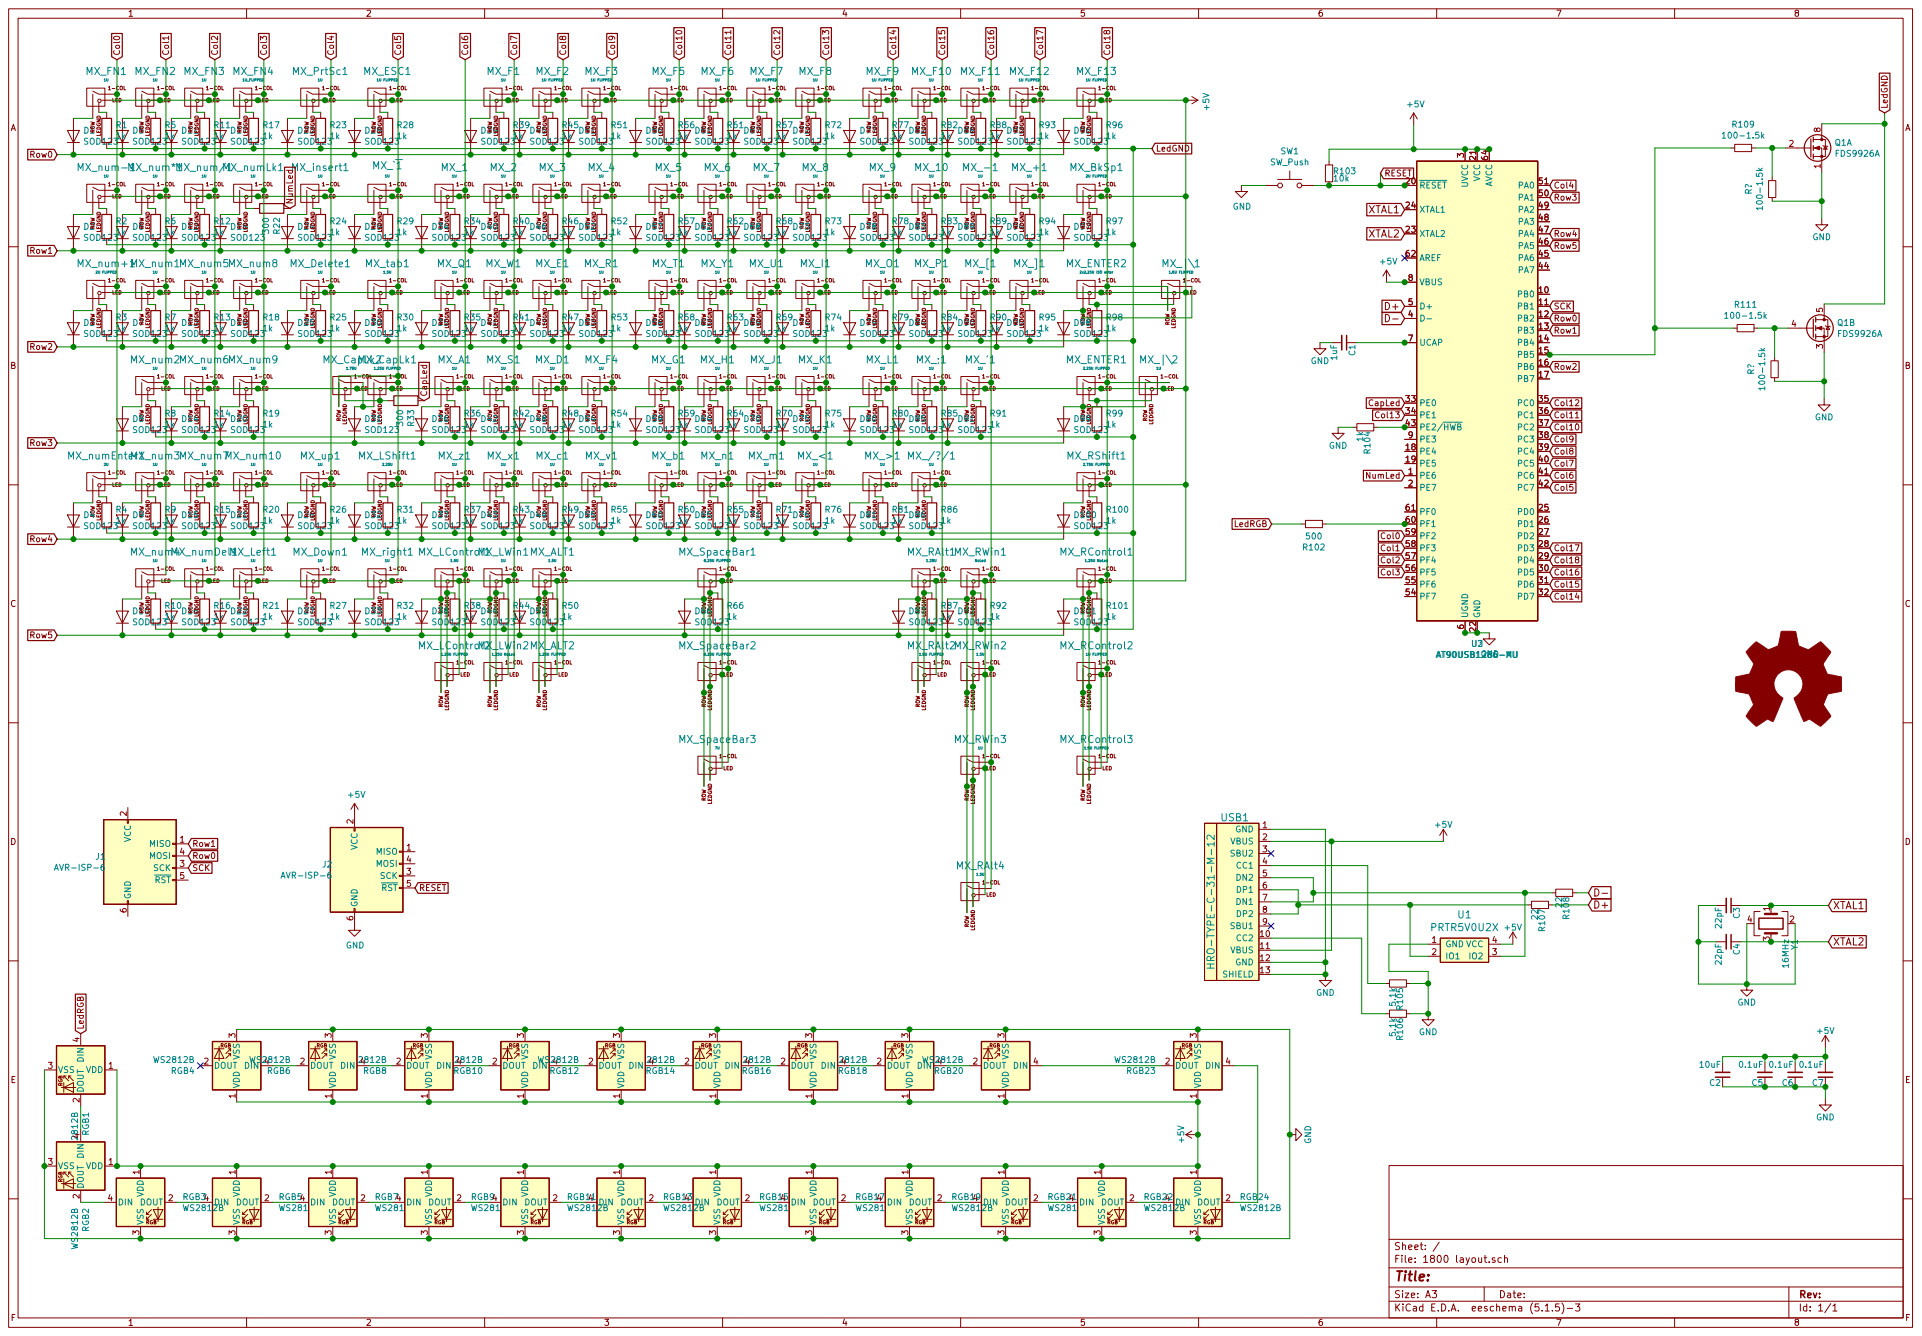
[picture p160: page 1]

6 PF1 60 PF0 61 AREF 62 AVCC 64 UCAP 7 VBUS 8 PE3 9 U3 AT90USB1286-MU GND 1

6 PF1 60 PF0 61 AREF 62 AVCC 64 UCAP 7 VBUS 8 PE3 9 U2 AT90USB1286-AU

2 SCK 3 MOSI 4 RST 5 GND

3 DIN 4 RGB11 WS2812B GND 1 CC2 10 VBUS 11 GND 12 SHIELD 13 VBUS 2 SBU2 3 CC1 4 DN2 5 DP1 6 DN1 7 DP2 8 SBU1 9 USB1 HRO-TYPE-C-31-M-12

3 DIN 4 RGB6 WS2812B GND RGB VDD 1 DOUT

3 DIN 4 RGB15 WS2812B GND RGB VDD 1 DOUT

File: 1800 layout.sch Sheet: /
