MaiTheSan/PCB-Design/KiCad/Early 2021/phôi design pcb/AT-L 1800 STM/AT - L 1800 STM32 RGB/SCH/1800 layout.pdf

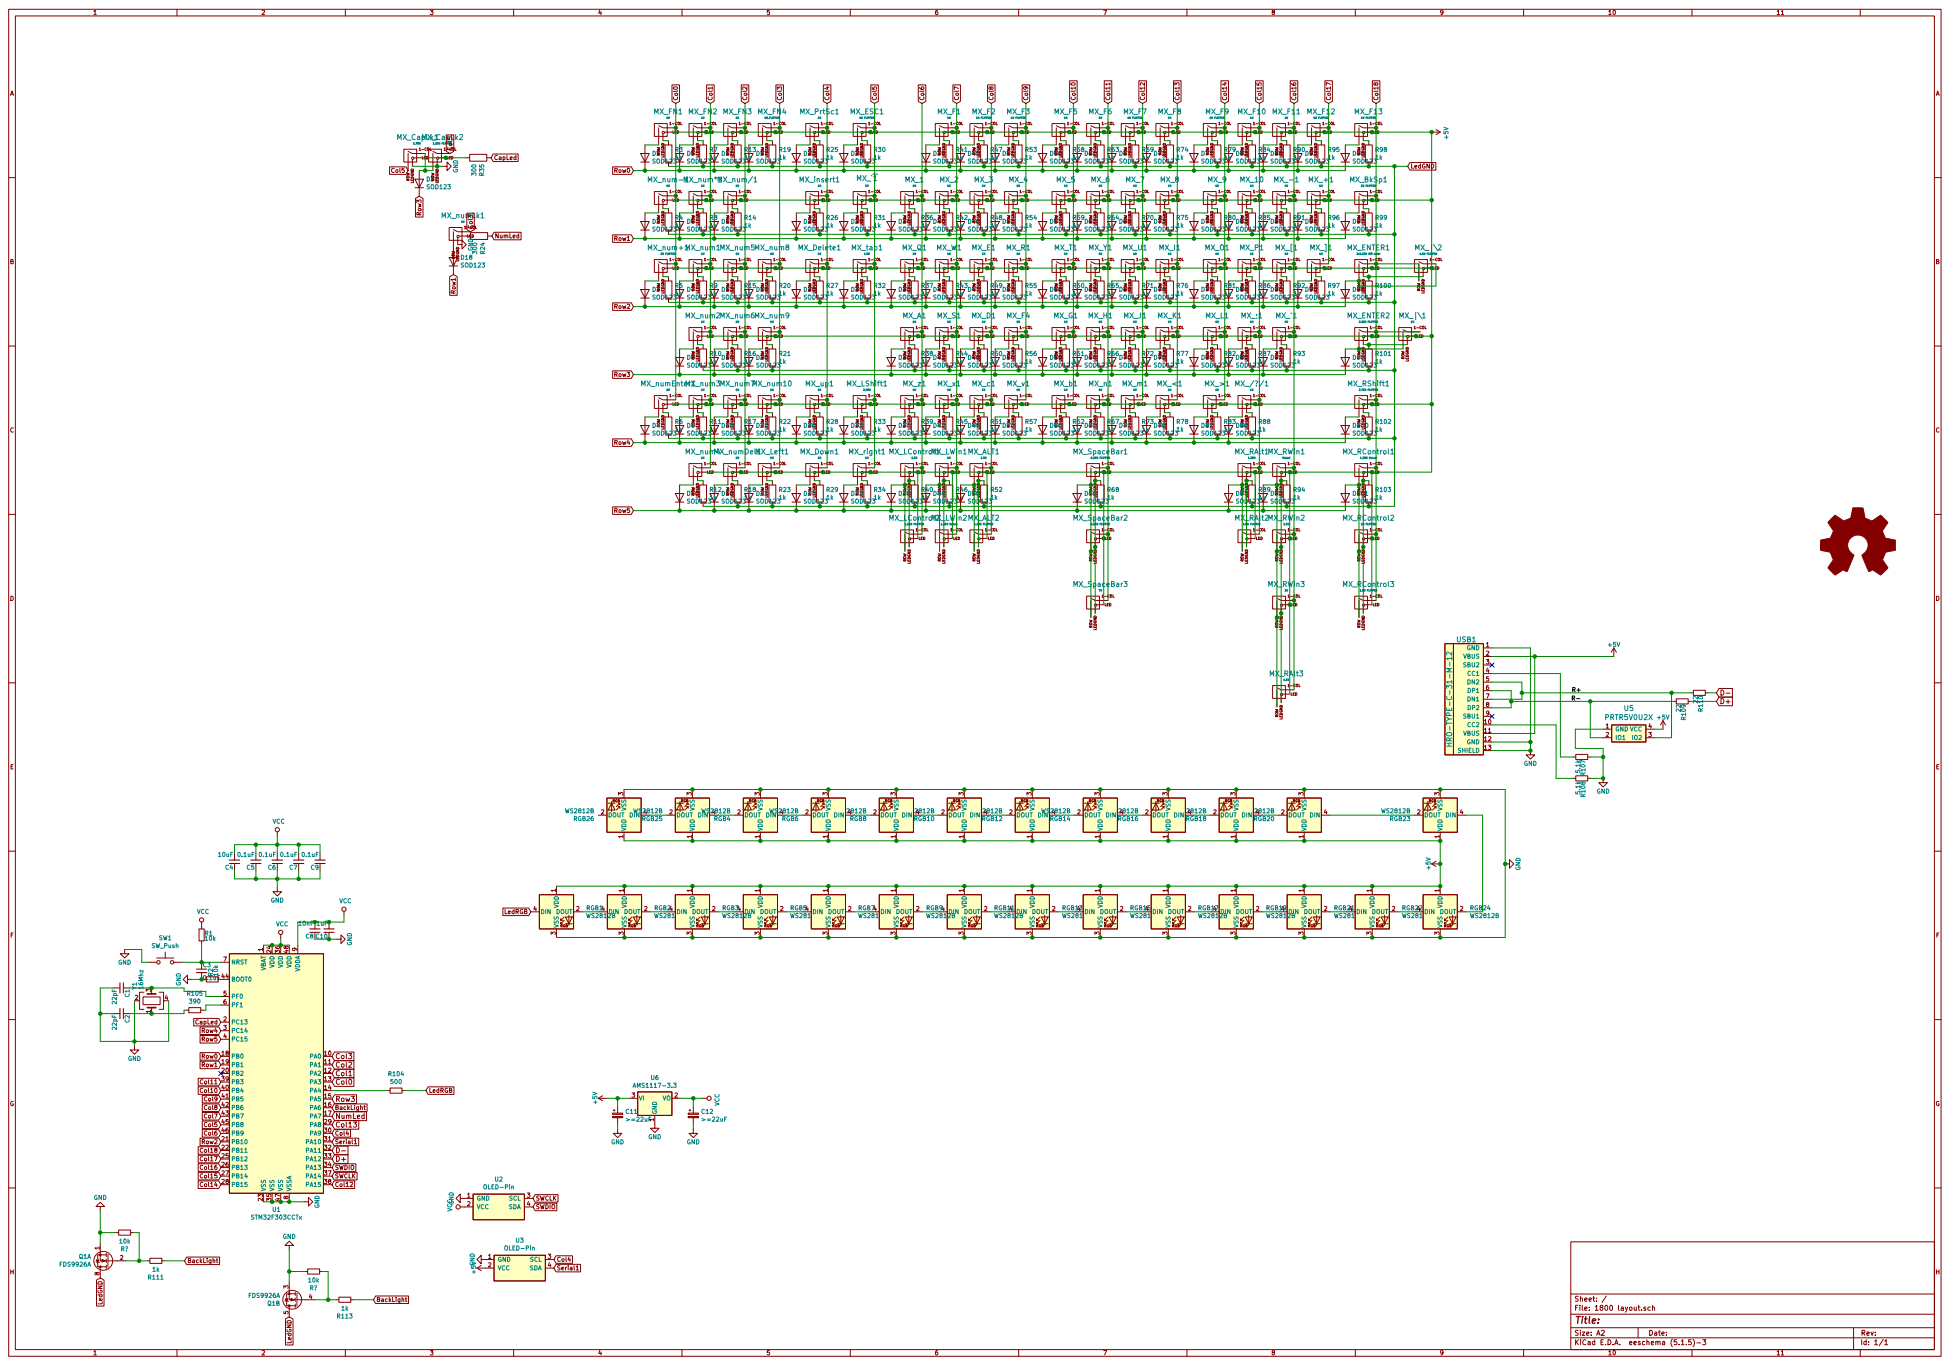
[picture p161: page 1]

3 DIN 4 RGB6 WS2812B GND GND 1 VCC 2 SCL 3 SDA 4 U3 OLED-Pin GND GND

1 VDD 24 VDD 36 VDD 48 VDDA

9 VSS 23 VSS 35 VSS 47 VSSA

1 VO 2 VI 3 U6 AMS1117-3.3 VCC GND GND

File: 1800 layout.sch Sheet: /
