MaiTheSan/PCB-Design/Salane Reboot/[A]ddiction/[A]ddiction Alice/Hotswap/STM32/[A]ddiction Alice-Dwgs_User.pdf

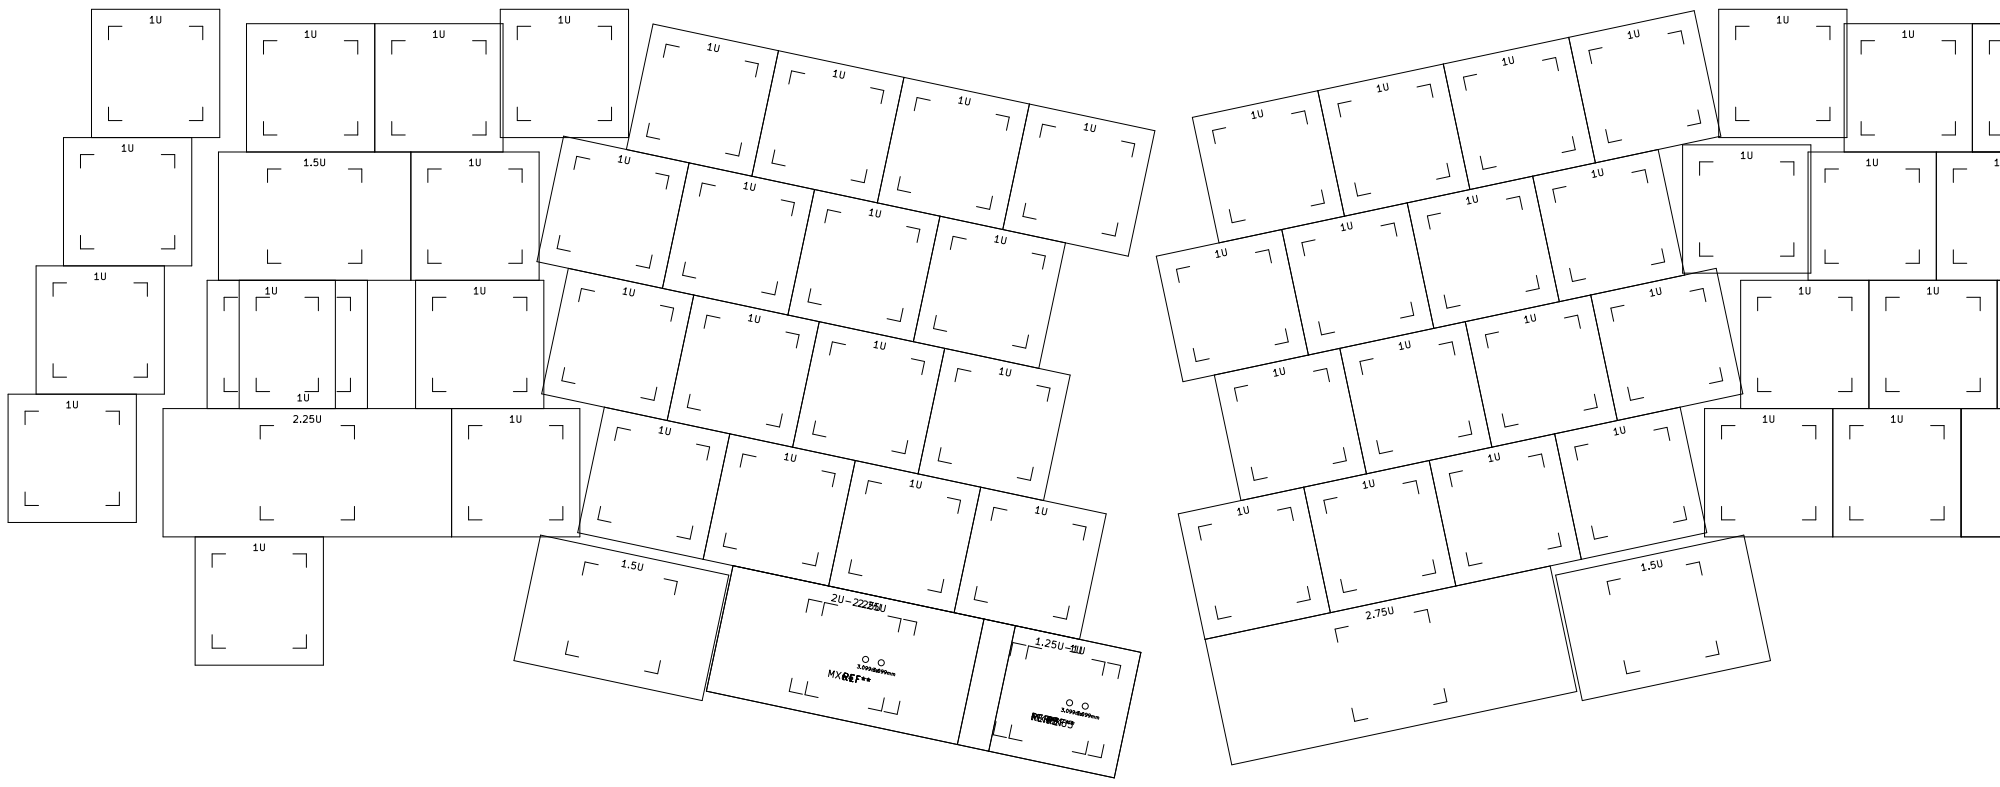
[picture p162: page 1]
