MaiTheSan/PCB-Design/Salane Reboot/[A]ddiction/[A]ddiction Alice/Hotswap/STM32/[A]ddiction Alice-Eco1_User.pdf

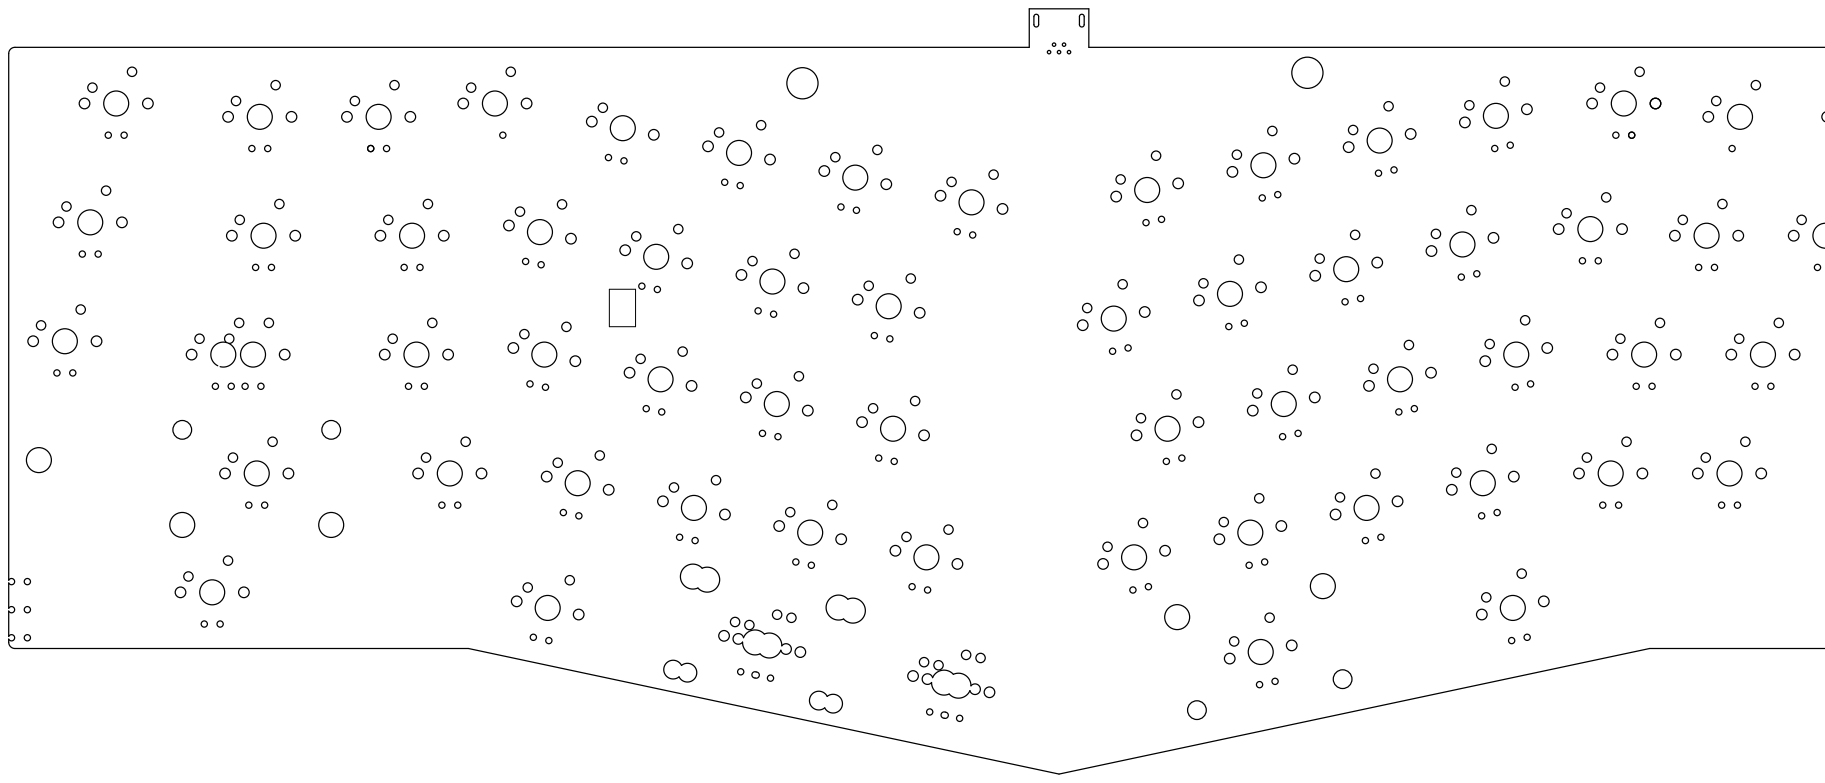
[picture p163: page 1]
