MaiTheSan/PCB-Design/(list of files, drawings)

Other design files:
Altium/Projects/PCB Keyboard/Adelais.PcbDoc
Altium/Projects/PCB Keyboard/Adelais.SchDoc
Altium/Projects/PCB Keyboard/Keyboard compoment.PcbLib
Altium/Projects/PCB Keyboard/Keyboard compoment.SchLib
Altium/Projects/PCB Keyboard/PCB Keyboard.PrjPcb
KiCad/Early 2021/Learning Altium/PCB1.PcbDoc
KiCad/Early 2021/Learning Altium/PCB_Project1.PrjPCB
KiCad/Early 2021/Learning Altium/Sheet1.SchDoc
KiCad/Early 2021/TKL - Fullsize/TKL - Fullsize Project/TKL - Fullsize Project.dsn
