MaiTheSan/PCB-Design/Salane Reboot/Paranoid/Odysssey/Odyssey/Solder/Odyssey.kicad_pcb

## KiCad design Salane Reboot/Paranoid/Odysssey/Odyssey/Solder/Odyssey.kicad_pcb (2022-11-19)

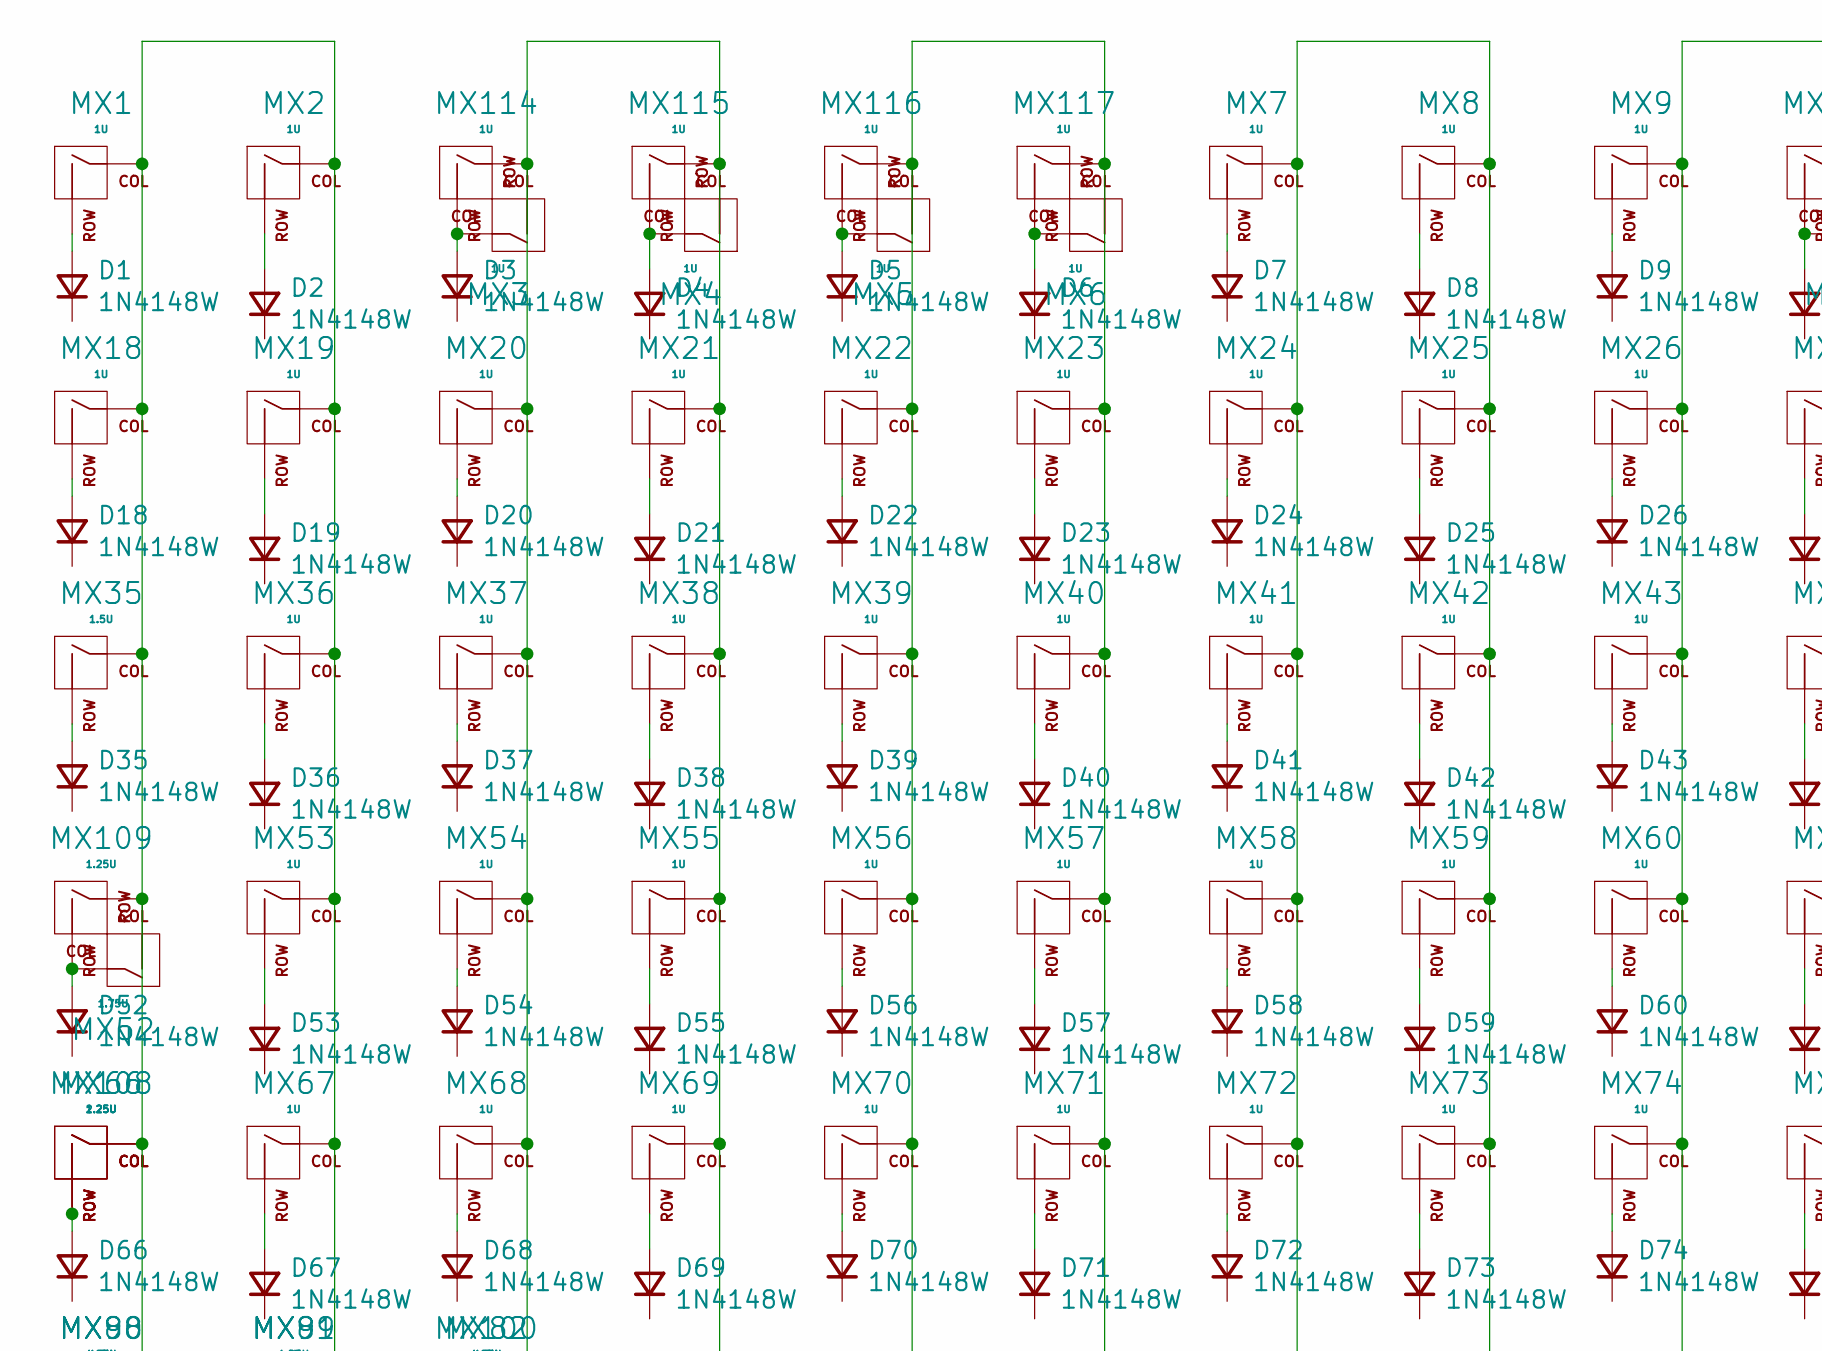
[picture p164: schematic Odyssey.sch, part in row 1, column 1]

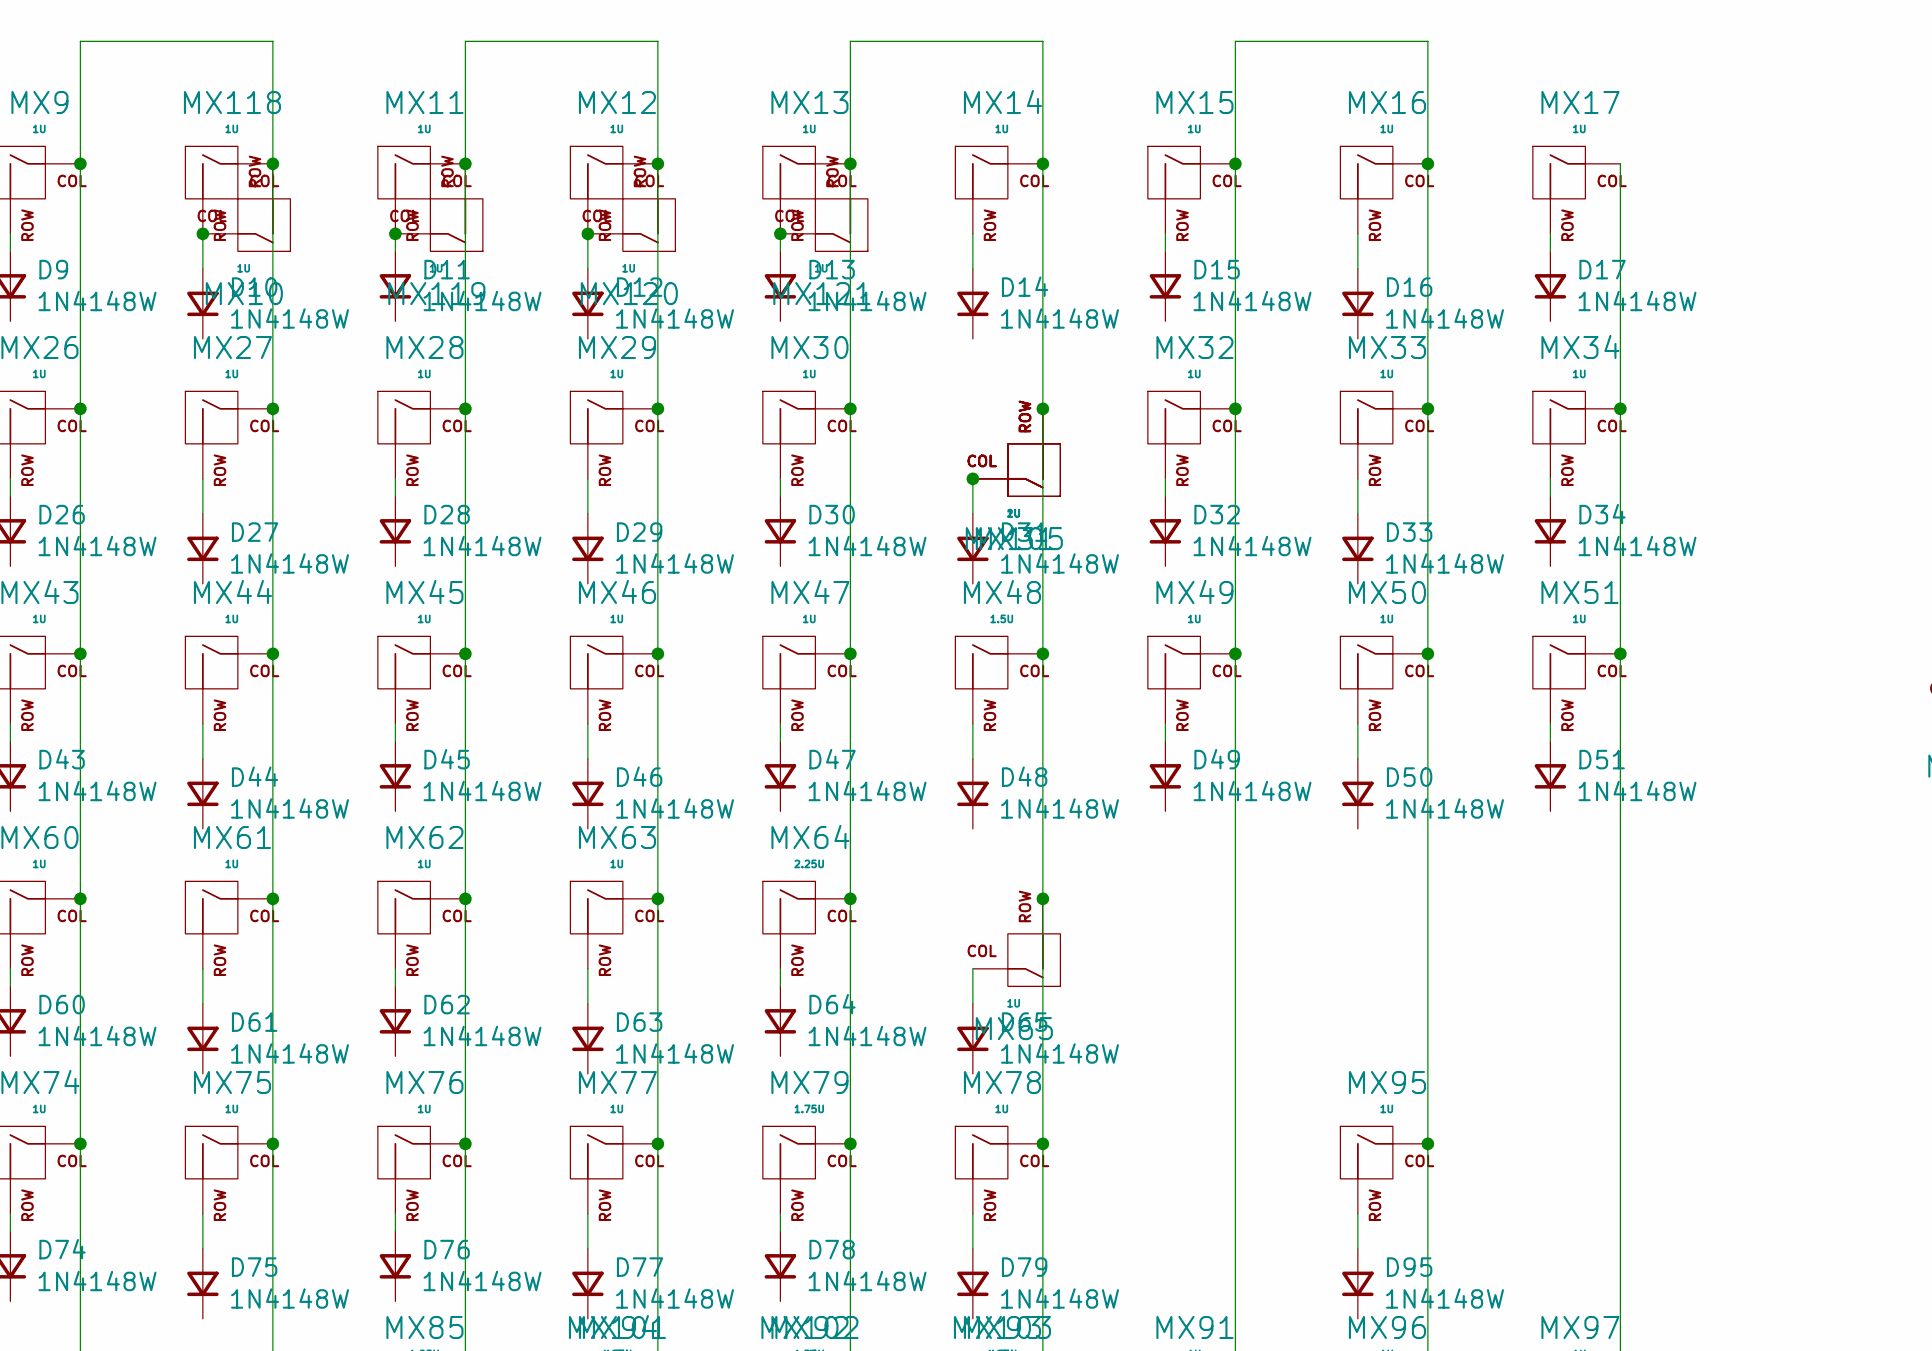
[picture p165: schematic Odyssey.sch, part in row 1, column 2]

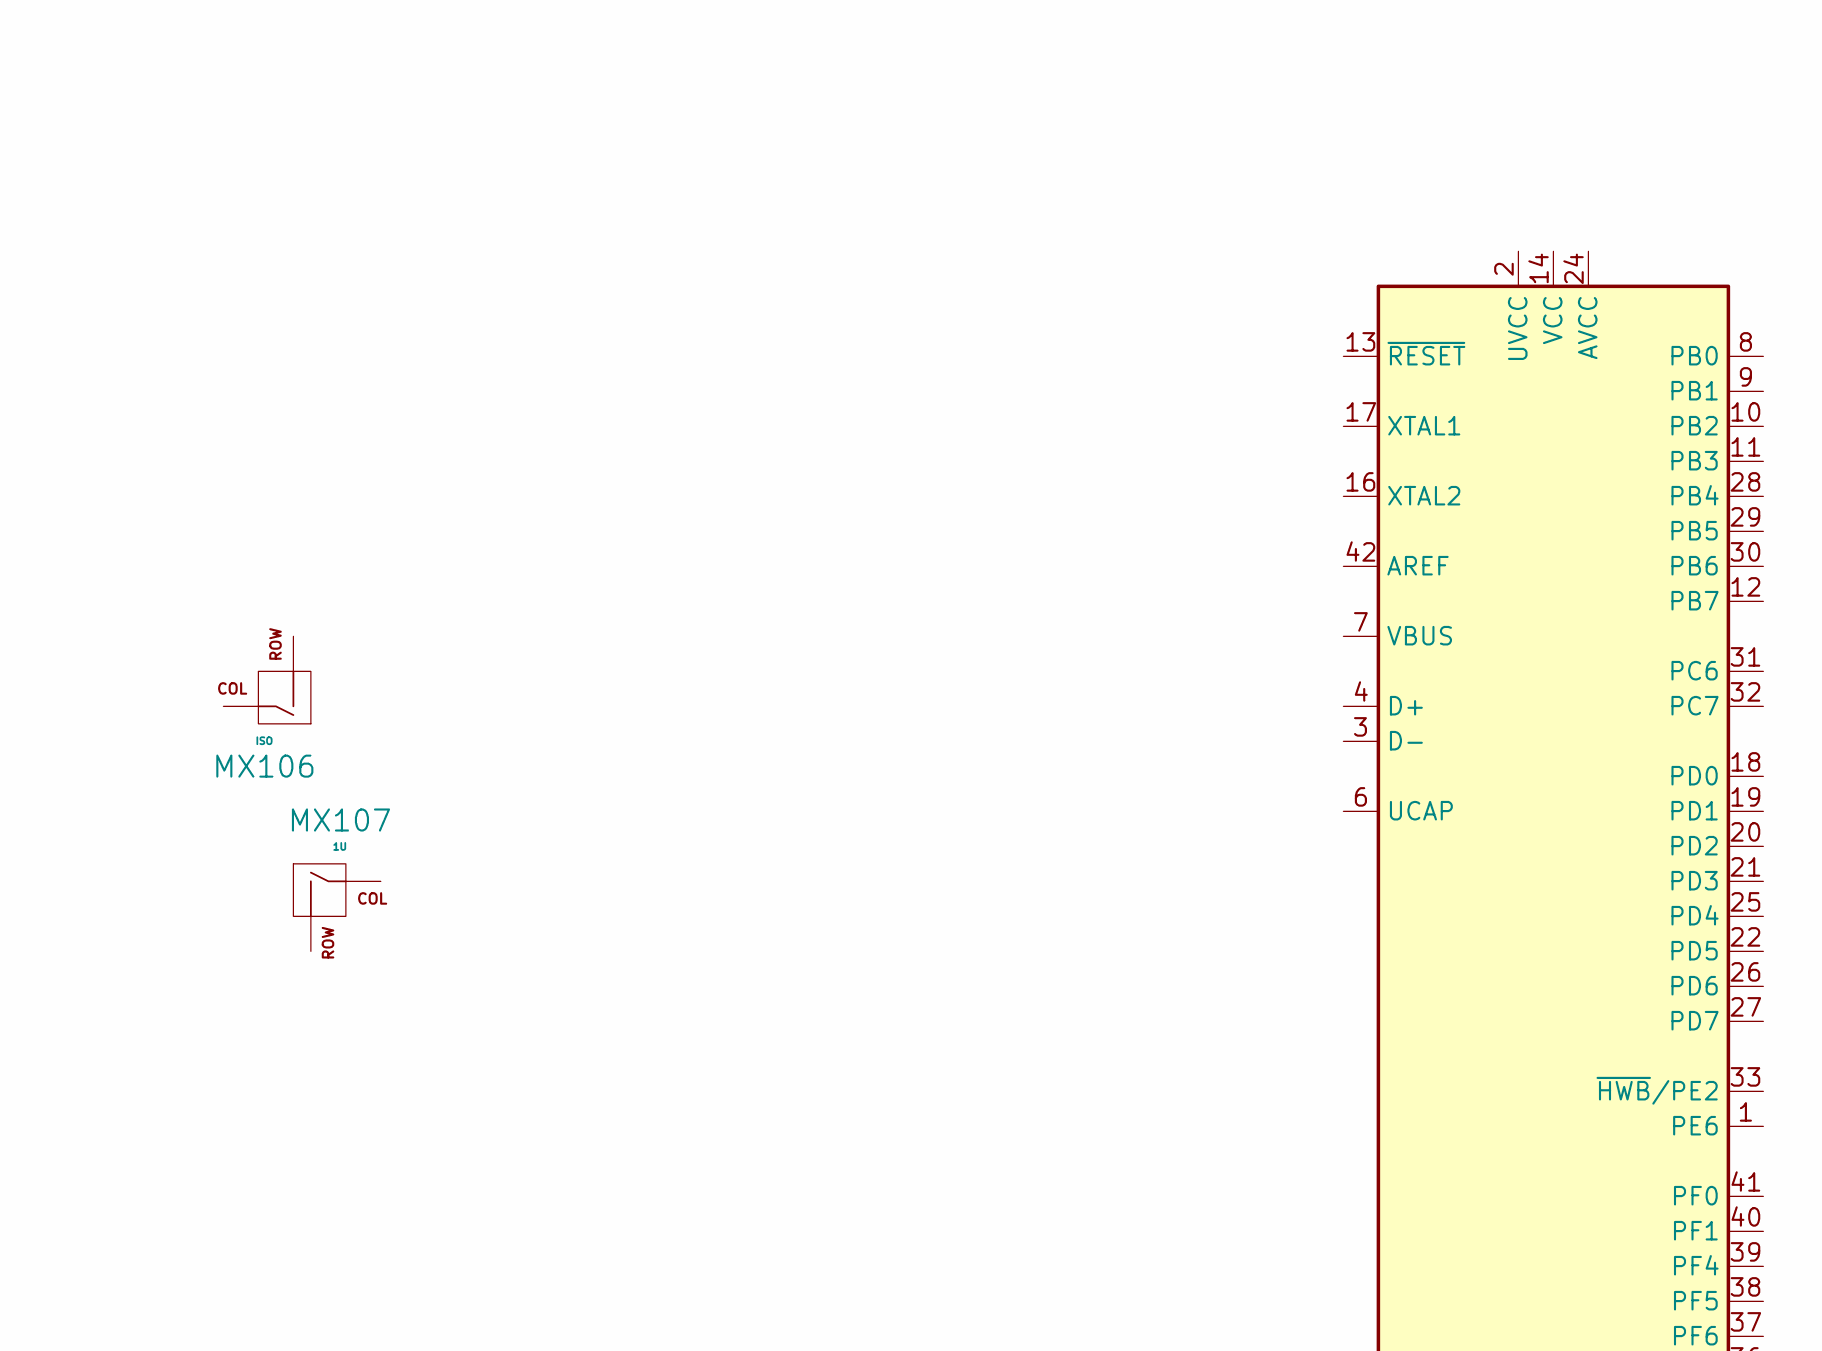
[picture p166: schematic Odyssey.sch, part in row 1, column 3]

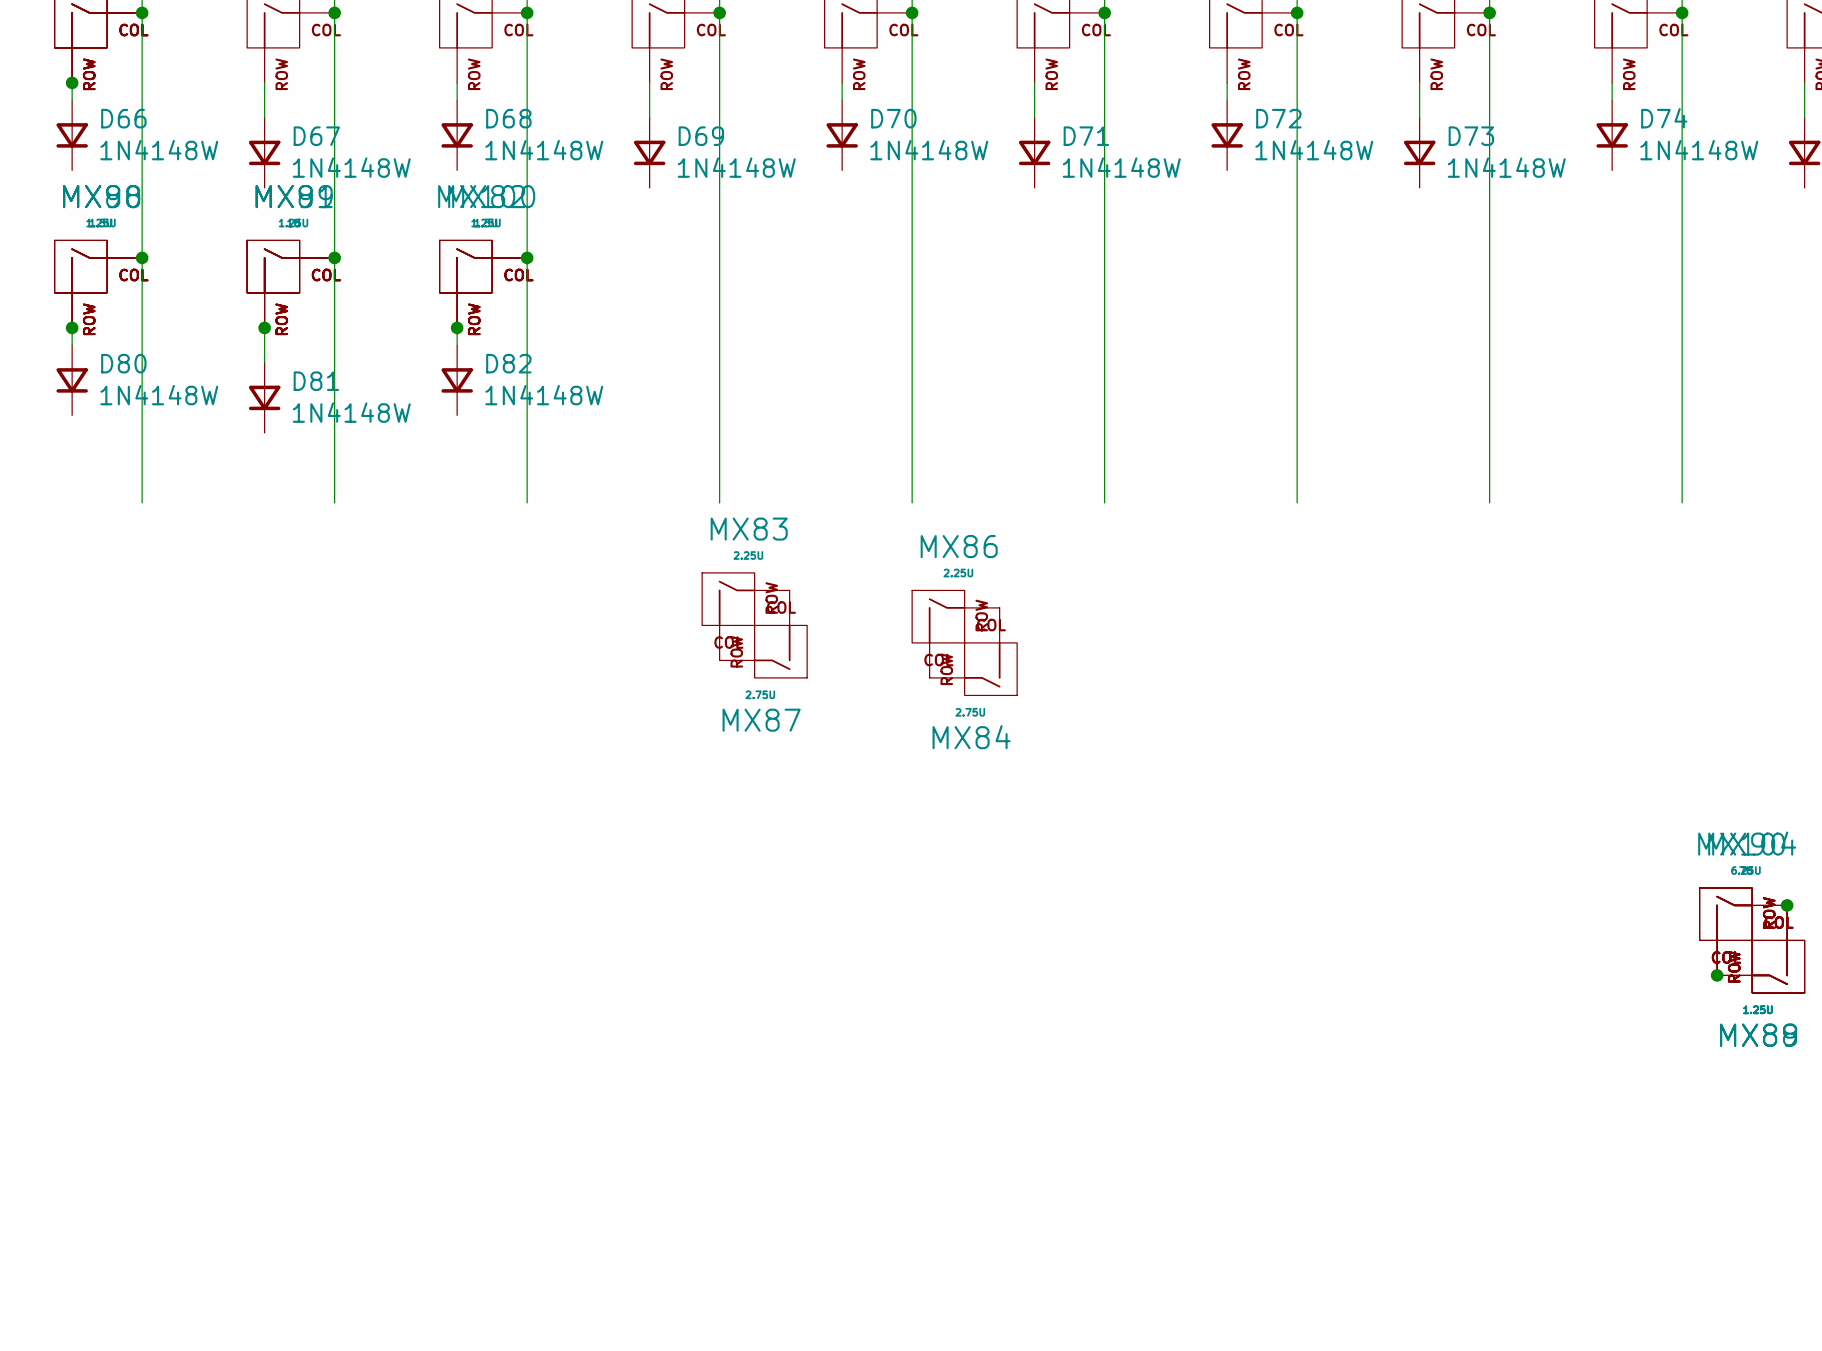
[picture p167: schematic Odyssey.sch, part in row 2, column 1]

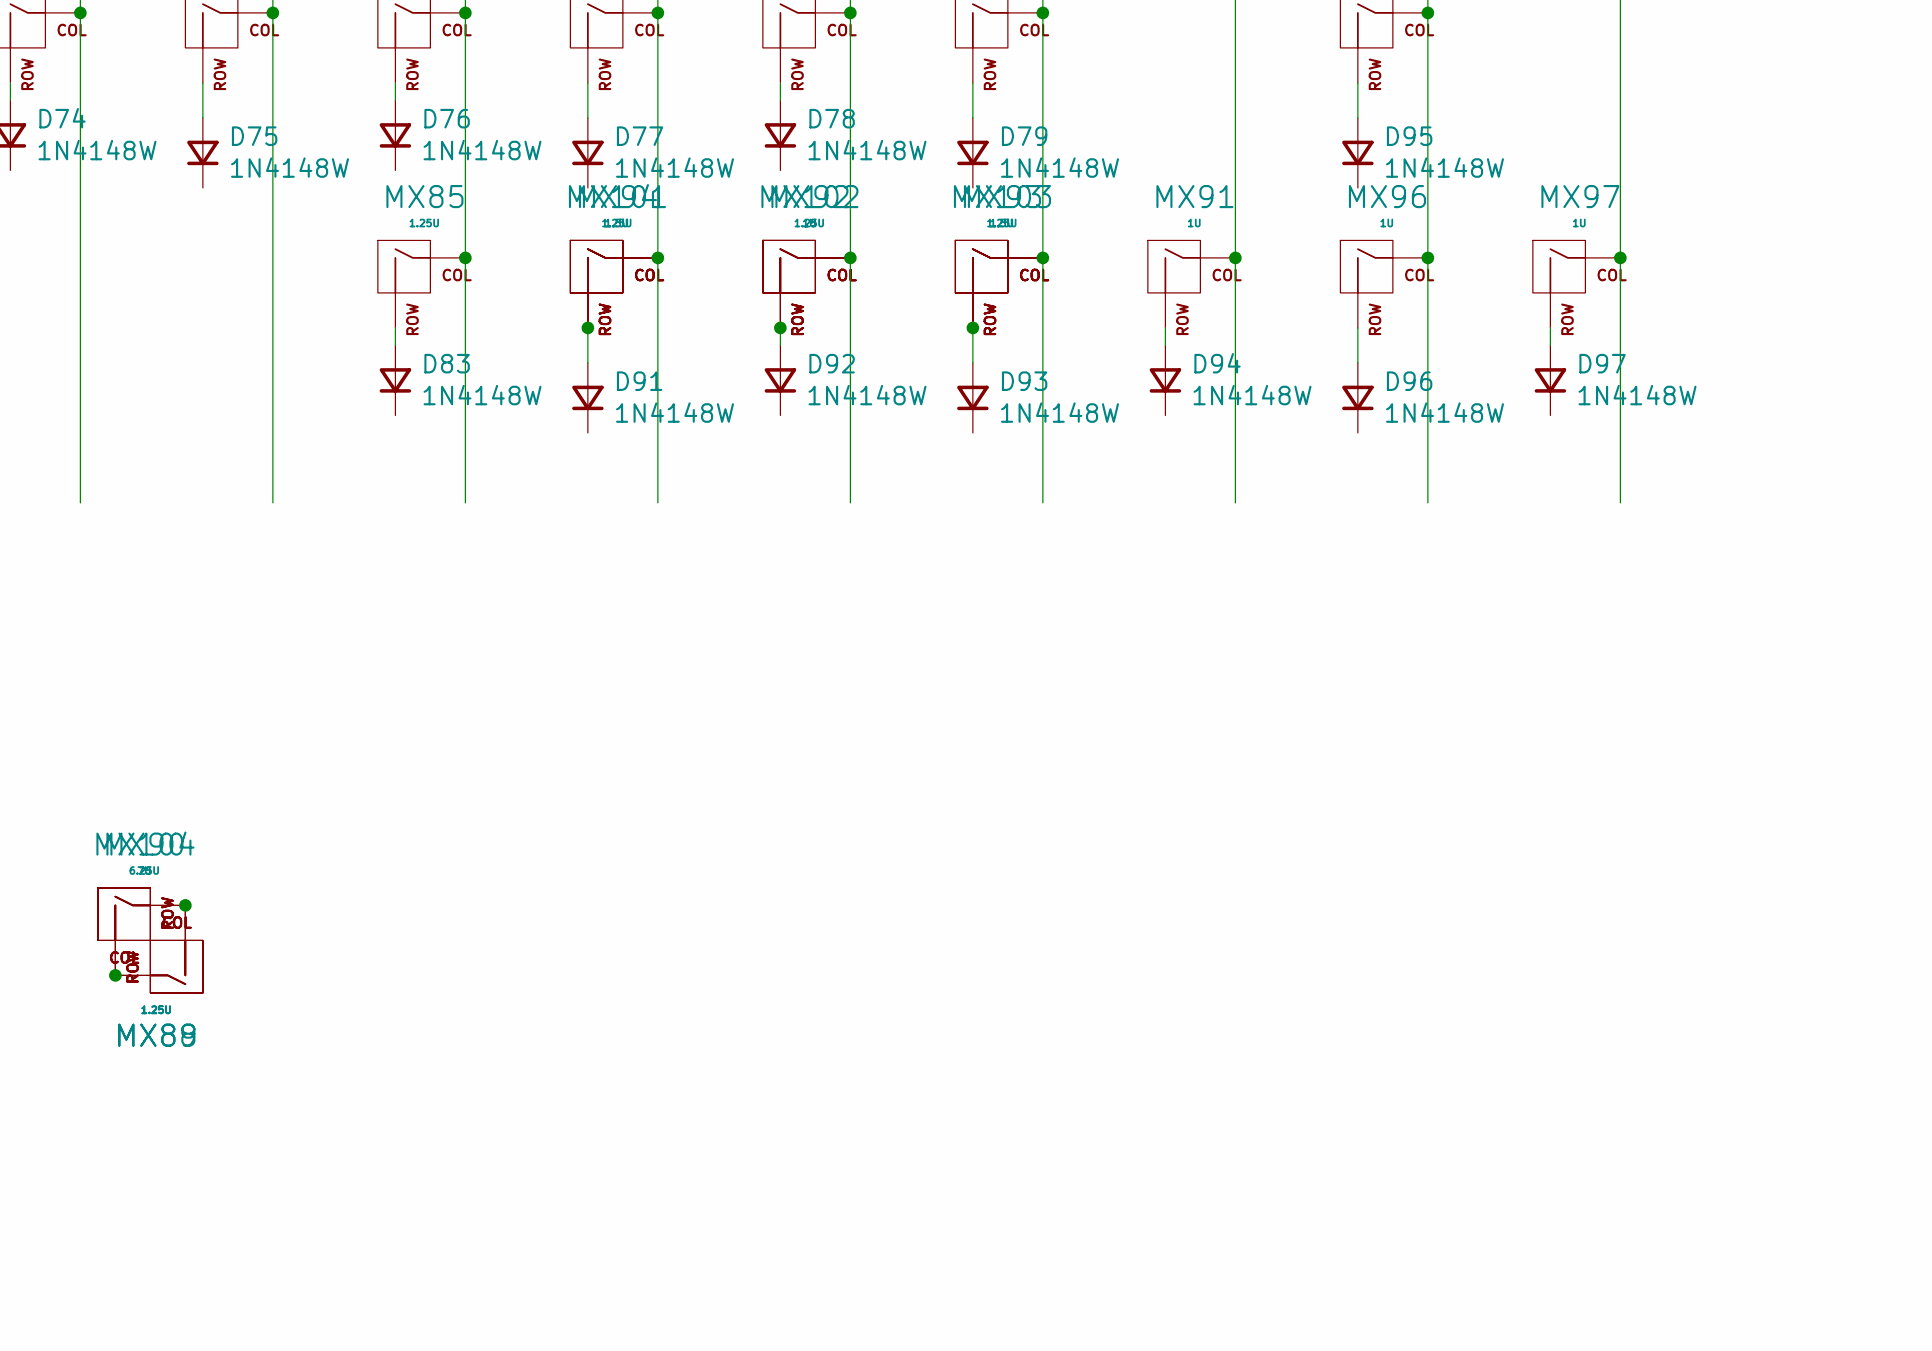
[picture p168: schematic Odyssey.sch, part in row 2, column 2]

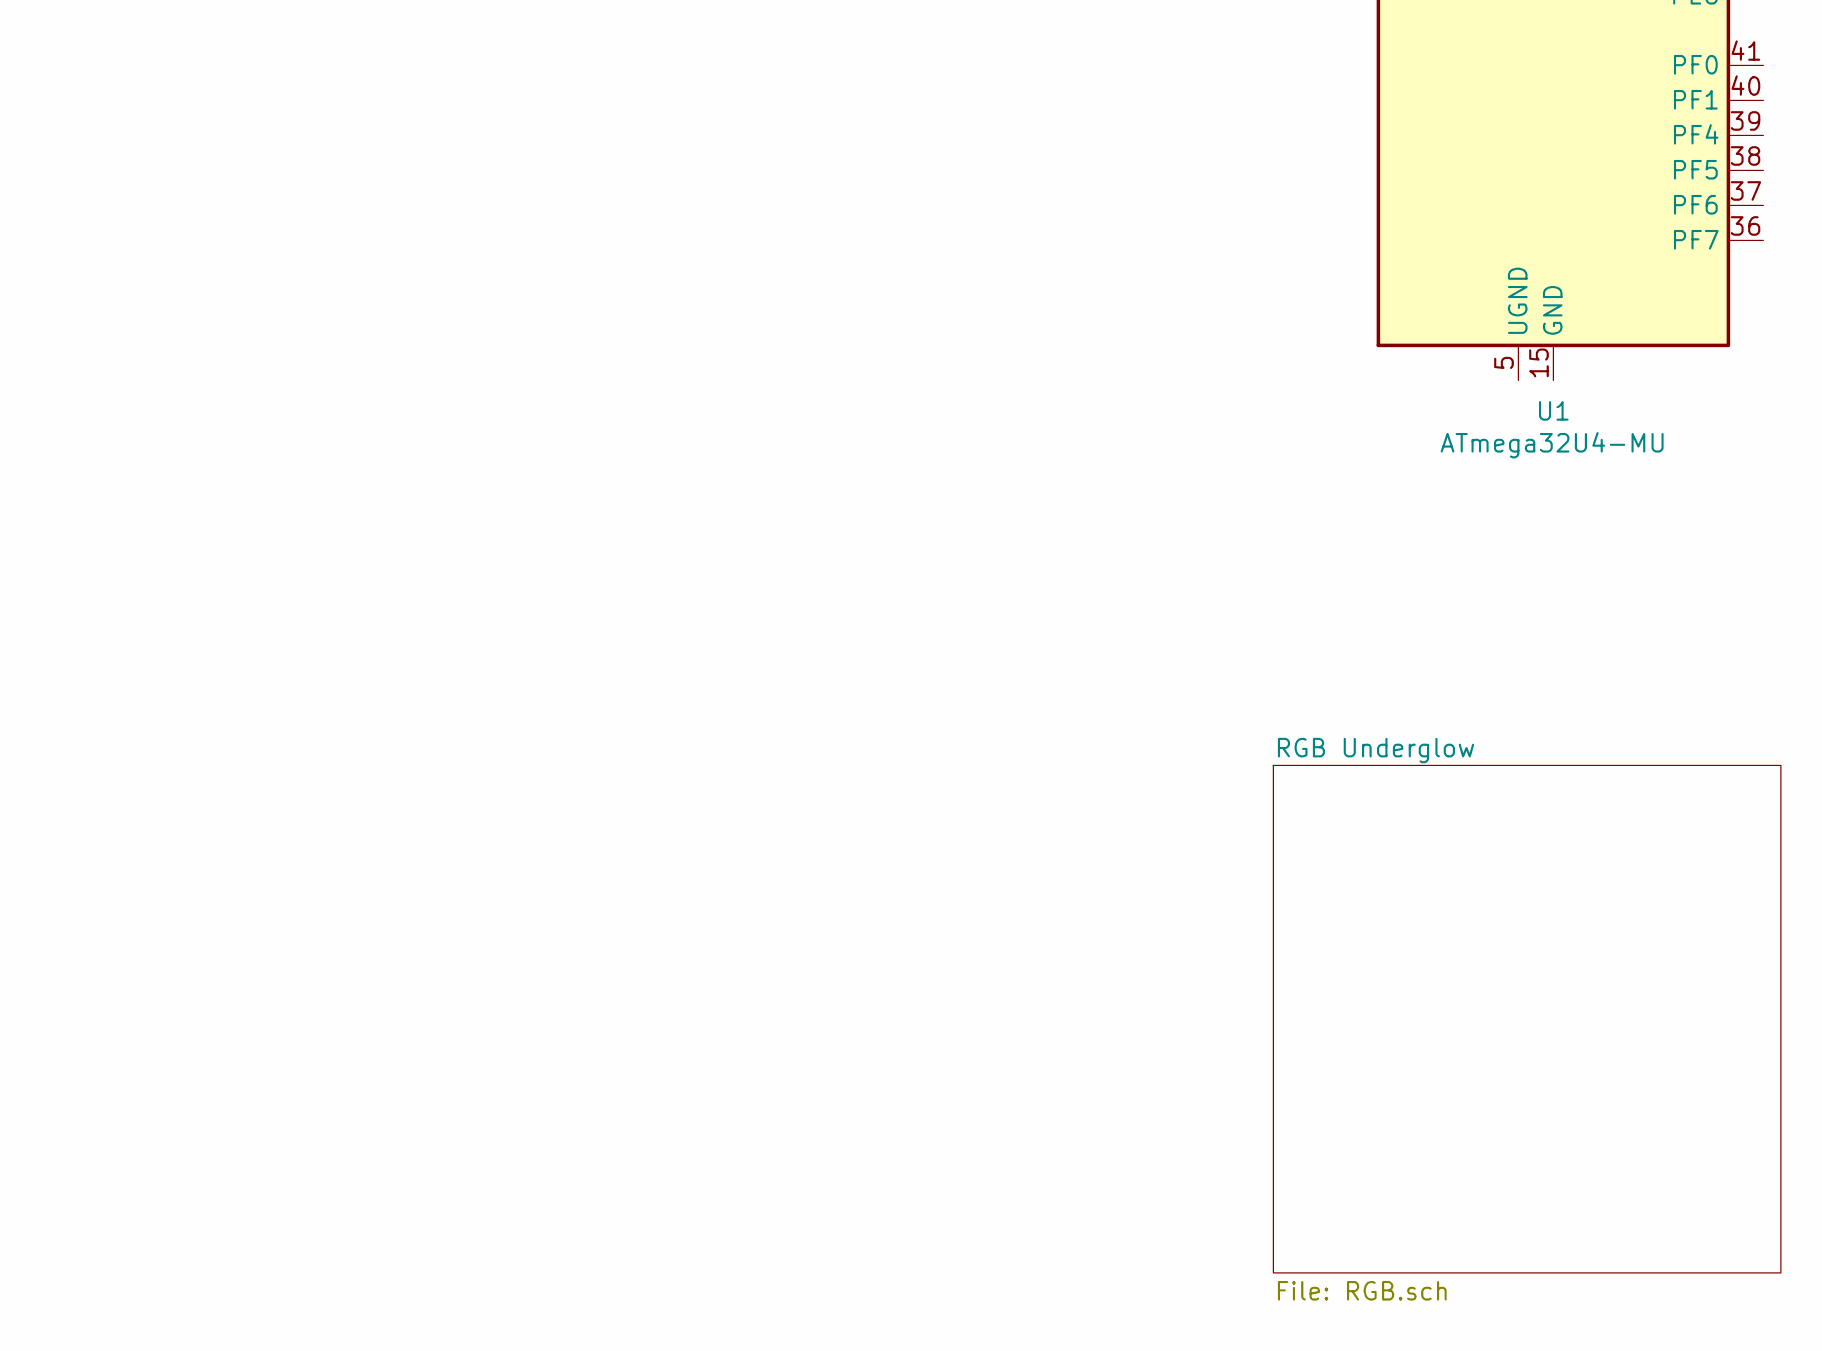
[picture p169: schematic Odyssey.sch, part in row 2, column 3]

Parts:
D1, D2, D3, D4, D5, D6, D7, D8, D9, D10, D11, D12, D13, D14, D15, D16, D17, D18, D19, D20, D21, D22, D23, D24, D25, D26, D27, D28, D29, D30, D31, D32, D33, D34, D35, D36, D37, D38, D39, D40, D41, D42, D43, D44, D45, D46, D47, D48, D49, D50, D51, D52, D53, D54, D55, D56, D57, D58, D59, D60, D61, D62, D63, D64, D65, D66, D67, D68, D69, D70, D71, D72, D73, D74, D75, D76, D77, D78, D79, D80, D81, D82, D83, D91, D92, D93, D94, D95, D96, D97: 1N4148W; DIODE_1206_SawnsProjects
MX1, MX2, MX3, MX4, MX5, MX6, MX7, MX8, MX9, MX10, MX11, MX12, MX13, MX14, MX15, MX16, MX17, MX18, MX19, MX20, MX21, MX22, MX23, MX24, MX25, MX26, MX27, MX28, MX29, MX30, MX31, MX32, MX33, MX34, MX36, MX37, MX38, MX39, MX40, MX41, MX42, MX43, MX44, MX45, MX46, MX47, MX49, MX50, MX51, MX53, MX54, MX55, MX56, MX57, MX58, MX59, MX60, MX61, MX62, MX63, MX65, MX67, MX68, MX69, MX70, MX71, MX72, MX73, MX74, MX75, MX76, MX77, MX78, MX91, MX95, MX96, MX97, MX99, MX102, MX107, MX114, MX115, MX116, MX117, MX118, MX119, MX120, MX121: 1U; MXOnly-1U-NoLED
MX35, MX48, MX98, MX100, MX101, MX103: 1.5U; MXOnly-1.5U-NoLED
MX52, MX79: 1.75U; MXOnly-1.75U-NoLED
MX64, MX83, MX86, MX108: 2.25U; MXOnly-2.25U-NoLED
MX66, MX80, MX81, MX82, MX85, MX88, MX89, MX92, MX93, MX94, MX109: 1.25U; MXOnly-1.25U-NoLED
MX84, MX87: 2.75U; MXOnly-2.75U-NoLED
MX90: 6.25U; MXOnly-6.25U-NoLED
MX104: 7U; MXOnly-7U-NoLED
MX105: 2U; MXOnly-2U-NoLED
MX106: ISO; MXOnly-ISO-ROTATED-ReversedStabilizers-NoLED
U1: ATmega32U4-MU; QFN-44-1EP_7x7mm_P0.5mm_EP5.2x5.2mm

Connections:
unnamed: D1.2 (A), MX1.2 (ROW)
unnamed: D2.2 (A), MX2.2 (ROW)
unnamed: D3.2 (A), MX3.1 (COL), MX114.2 (ROW)
unnamed: D4.2 (A), MX4.1 (COL), MX115.2 (ROW)
unnamed: D5.2 (A), MX5.1 (COL), MX116.2 (ROW)
unnamed: D6.2 (A), MX6.1 (COL), MX117.2 (ROW)
unnamed: D7.2 (A), MX7.2 (ROW)
unnamed: D8.2 (A), MX8.2 (ROW)
unnamed: D9.2 (A), MX9.2 (ROW)
unnamed: D10.2 (A), MX10.1 (COL), MX118.2 (ROW)
unnamed: D11.2 (A), MX11.2 (ROW), MX119.1 (COL)
unnamed: D12.2 (A), MX12.2 (ROW), MX120.1 (COL)
unnamed: D13.2 (A), MX13.2 (ROW), MX121.1 (COL)
unnamed: D14.2 (A), MX14.2 (ROW)
unnamed: D15.2 (A), MX15.2 (ROW)
unnamed: D16.2 (A), MX16.2 (ROW)
unnamed: D17.2 (A), MX17.2 (ROW)
unnamed: D18.2 (A), MX18.2 (ROW)
unnamed: D19.2 (A), MX19.2 (ROW)
unnamed: D20.2 (A), MX20.2 (ROW)
unnamed: D21.2 (A), MX21.2 (ROW)
unnamed: D22.2 (A), MX22.2 (ROW)
unnamed: D23.2 (A), MX23.2 (ROW)
unnamed: D24.2 (A), MX24.2 (ROW)
unnamed: D25.2 (A), MX25.2 (ROW)
unnamed: D26.2 (A), MX26.2 (ROW)
unnamed: D27.2 (A), MX27.2 (ROW)
unnamed: D28.2 (A), MX28.2 (ROW)
unnamed: D29.2 (A), MX29.2 (ROW)
unnamed: D30.2 (A), MX30.2 (ROW)
unnamed: D31.2 (A), MX31.1 (COL), MX105.1 (COL)
unnamed: D32.2 (A), MX32.2 (ROW)
unnamed: D33.2 (A), MX33.2 (ROW)
unnamed: D34.2 (A), MX34.2 (ROW)
unnamed: D35.2 (A), MX35.2 (ROW)
unnamed: D36.2 (A), MX36.2 (ROW)
unnamed: D37.2 (A), MX37.2 (ROW)
unnamed: D38.2 (A), MX38.2 (ROW)
unnamed: D39.2 (A), MX39.2 (ROW)
unnamed: D40.2 (A), MX40.2 (ROW)
unnamed: D41.2 (A), MX41.2 (ROW)
unnamed: D42.2 (A), MX42.2 (ROW)
unnamed: D43.2 (A), MX43.2 (ROW)
unnamed: D44.2 (A), MX44.2 (ROW)
unnamed: D45.2 (A), MX45.2 (ROW)
unnamed: D46.2 (A), MX46.2 (ROW)
unnamed: D47.2 (A), MX47.2 (ROW)
unnamed: D48.2 (A), MX48.2 (ROW)
unnamed: D49.2 (A), MX49.2 (ROW)
unnamed: D50.2 (A), MX50.2 (ROW)
unnamed: D51.2 (A), MX51.2 (ROW)
unnamed: D52.2 (A), MX52.1 (COL), MX109.2 (ROW)
unnamed: D53.2 (A), MX53.2 (ROW)
unnamed: D54.2 (A), MX54.2 (ROW)
unnamed: D55.2 (A), MX55.2 (ROW)
unnamed: D56.2 (A), MX56.2 (ROW)
unnamed: D57.2 (A), MX57.2 (ROW)
unnamed: D58.2 (A), MX58.2 (ROW)
unnamed: D59.2 (A), MX59.2 (ROW)
unnamed: D60.2 (A), MX60.2 (ROW)
unnamed: D61.2 (A), MX61.2 (ROW)
unnamed: D62.2 (A), MX62.2 (ROW)
unnamed: D63.2 (A), MX63.2 (ROW)
unnamed: D64.2 (A), MX64.2 (ROW)
unnamed: D65.2 (A), MX65.1 (COL)
unnamed: D66.2 (A), MX66.2 (ROW), MX108.2 (ROW)
unnamed: D67.2 (A), MX67.2 (ROW)
unnamed: D68.2 (A), MX68.2 (ROW)
unnamed: D69.2 (A), MX69.2 (ROW)
unnamed: D70.2 (A), MX70.2 (ROW)
unnamed: D71.2 (A), MX71.2 (ROW)
unnamed: D72.2 (A), MX72.2 (ROW)
unnamed: D73.2 (A), MX73.2 (ROW)
unnamed: D74.2 (A), MX74.2 (ROW)
unnamed: D75.2 (A), MX75.2 (ROW)
unnamed: D76.2 (A), MX76.2 (ROW)
unnamed: D77.2 (A), MX77.2 (ROW)
unnamed: D78.2 (A), MX79.2 (ROW)
unnamed: D79.2 (A), MX78.2 (ROW)
unnamed: D80.2 (A), MX80.2 (ROW), MX98.2 (ROW)
unnamed: D81.2 (A), MX81.2 (ROW), MX99.2 (ROW)
unnamed: D82.2 (A), MX82.2 (ROW), MX100.2 (ROW)
unnamed: D83.2 (A), MX85.2 (ROW)
unnamed: D91.2 (A), MX94.2 (ROW), MX101.2 (ROW)
unnamed: D92.2 (A), MX92.2 (ROW), MX102.2 (ROW)
unnamed: D93.2 (A), MX93.2 (ROW), MX103.2 (ROW)
unnamed: D94.2 (A), MX91.2 (ROW)
unnamed: D95.2 (A), MX95.2 (ROW)
unnamed: D96.2 (A), MX96.2 (ROW)
unnamed: D97.2 (A), MX97.2 (ROW)
unnamed: MX1.1 (COL), MX2.1 (COL), MX18.1 (COL), MX19.1 (COL), MX35.1 (COL), MX36.1 (COL), MX52.2 (ROW), MX53.1 (COL), MX66.1 (COL), MX67.1 (COL), MX80.1 (COL), MX81.1 (COL), MX98.1 (COL), MX99.1 (COL), MX108.1 (COL), MX109.1 (COL)
unnamed: MX9.1 (COL), MX10.2 (ROW), MX26.1 (COL), MX27.1 (COL), MX43.1 (COL), MX44.1 (COL), MX60.1 (COL), MX61.1 (COL), MX74.1 (COL), MX75.1 (COL), MX118.1 (COL)
unnamed: MX15.1 (COL), MX16.1 (COL), MX32.1 (COL), MX33.1 (COL), MX49.1 (COL), MX50.1 (COL), MX91.1 (COL), MX95.1 (COL), MX96.1 (COL)
unnamed: MX17.1 (COL), MX34.1 (COL), MX51.1 (COL), MX97.1 (COL)
unnamed: MX7.1 (COL), MX8.1 (COL), MX24.1 (COL), MX25.1 (COL), MX41.1 (COL), MX42.1 (COL), MX58.1 (COL), MX59.1 (COL), MX72.1 (COL), MX73.1 (COL)
unnamed: MX83.1 (COL), MX87.2 (ROW)
unnamed: MX83.2 (ROW), MX87.1 (COL)
unnamed: MX84.1 (COL), MX86.2 (ROW)
unnamed: MX84.2 (ROW), MX86.1 (COL)
unnamed: MX3.2 (ROW), MX4.2 (ROW), MX20.1 (COL), MX21.1 (COL), MX37.1 (COL), MX38.1 (COL), MX54.1 (COL), MX55.1 (COL), MX68.1 (COL), MX69.1 (COL), MX82.1 (COL), MX100.1 (COL), MX114.1 (COL), MX115.1 (COL)
unnamed: MX11.1 (COL), MX12.1 (COL), MX28.1 (COL), MX29.1 (COL), MX45.1 (COL), MX46.1 (COL), MX62.1 (COL), MX63.1 (COL), MX76.1 (COL), MX77.1 (COL), MX85.1 (COL), MX94.1 (COL), MX101.1 (COL), MX119.2 (ROW), MX120.2 (ROW)
unnamed: MX13.1 (COL), MX14.1 (COL), MX30.1 (COL), MX31.2 (ROW), MX47.1 (COL), MX48.1 (COL), MX64.1 (COL), MX65.2 (ROW), MX78.1 (COL), MX79.1 (COL), MX92.1 (COL), MX93.1 (COL), MX102.1 (COL), MX103.1 (COL), MX105.2 (ROW), MX121.2 (ROW)
unnamed: MX88.2 (ROW), MX89.2 (ROW), MX90.1 (COL), MX104.1 (COL)
unnamed: MX88.1 (COL), MX89.1 (COL), MX90.2 (ROW), MX104.2 (ROW)
unnamed: MX5.2 (ROW), MX6.2 (ROW), MX22.1 (COL), MX23.1 (COL), MX39.1 (COL), MX40.1 (COL), MX56.1 (COL), MX57.1 (COL), MX70.1 (COL), MX71.1 (COL), MX116.1 (COL), MX117.1 (COL)
unnamed: U1.14 (VCC), U1.34 (VCC)
unnamed: U1.15 (GND), U1.23 (GND), U1.35 (GND), U1.43 (GND), U1.45 (GND)
unnamed: U1.24 (AVCC), U1.44 (AVCC)

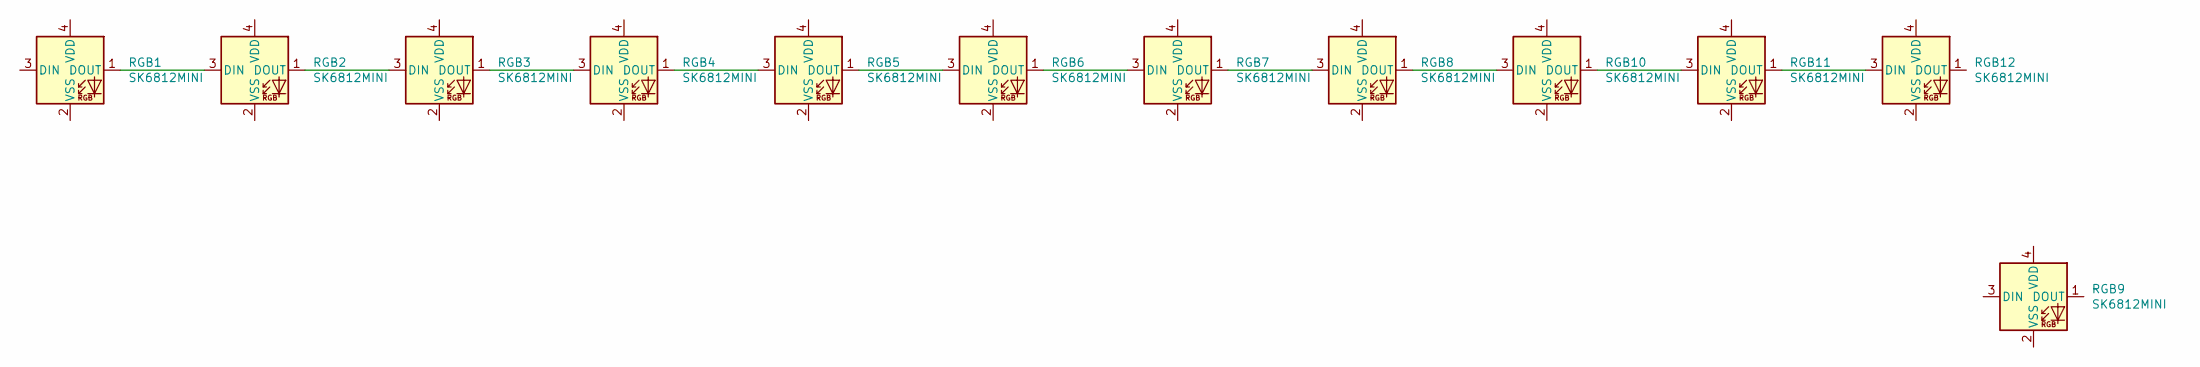
[picture p170: schematic RGB.sch]

Parts:
RGB1, RGB2, RGB3, RGB4, RGB5, RGB6, RGB7, RGB8, RGB9, RGB10, RGB11, RGB12: SK6812MINI; LED_SK6812MINI_PLCC4_3.5x3.5mm_P1.75mm

Connections:
unnamed: RGB1.1 (DOUT), RGB2.3 (DIN)
unnamed: RGB2.1 (DOUT), RGB3.3 (DIN)
unnamed: RGB3.1 (DOUT), RGB4.3 (DIN)
unnamed: RGB4.1 (DOUT), RGB5.3 (DIN)
unnamed: RGB5.1 (DOUT), RGB6.3 (DIN)
unnamed: RGB6.1 (DOUT), RGB7.3 (DIN)
unnamed: RGB7.1 (DOUT), RGB8.3 (DIN)
unnamed: RGB10.1 (DOUT), RGB11.3 (DIN)
unnamed: RGB8.1 (DOUT), RGB10.3 (DIN)
unnamed: RGB11.1 (DOUT), RGB12.3 (DIN)

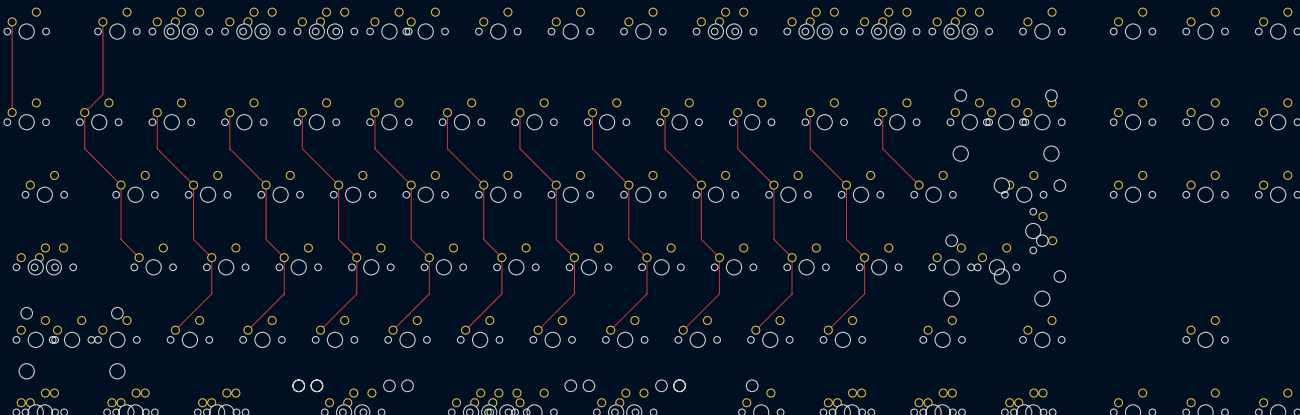
[picture p171: board Odyssey.kicad_pcb from above]

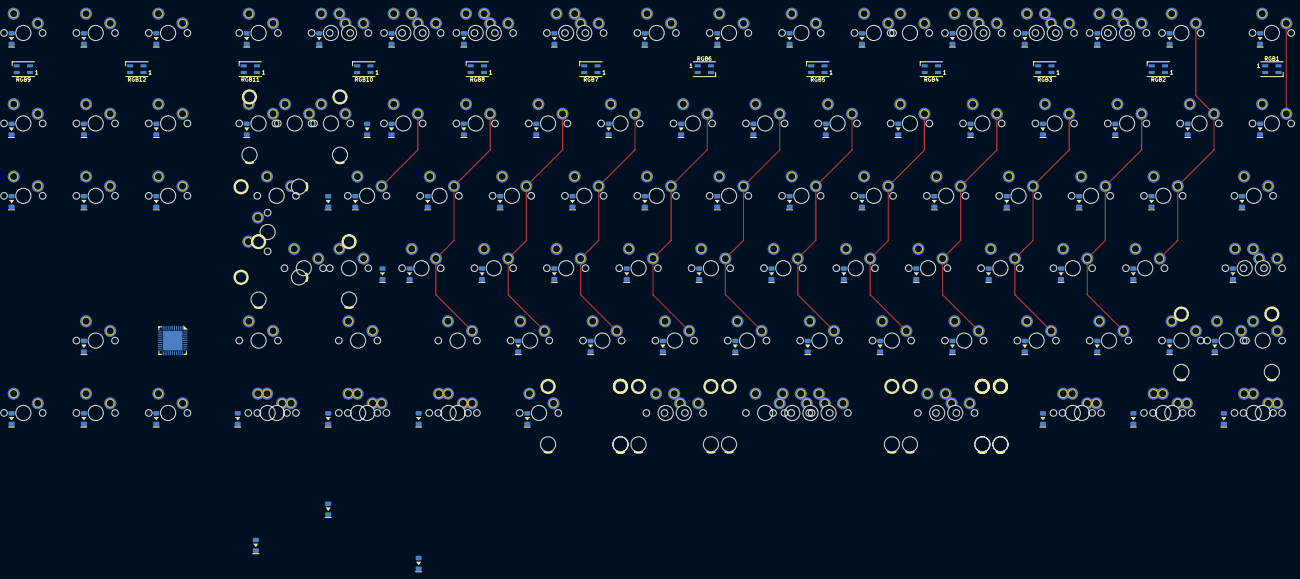
[picture p172: board Odyssey.kicad_pcb from below]

Board: 2 copper layers, 220 parts (103 on the bottom side), 118 nets.
