MaiTheSan/PCB-Design/Salane Reboot/Salane usO/Salane usO/Salane usO.kicad_pcb

## KiCad design Salane Reboot/Salane usO/Salane usO/Salane usO.kicad_pcb (2022-12-31)

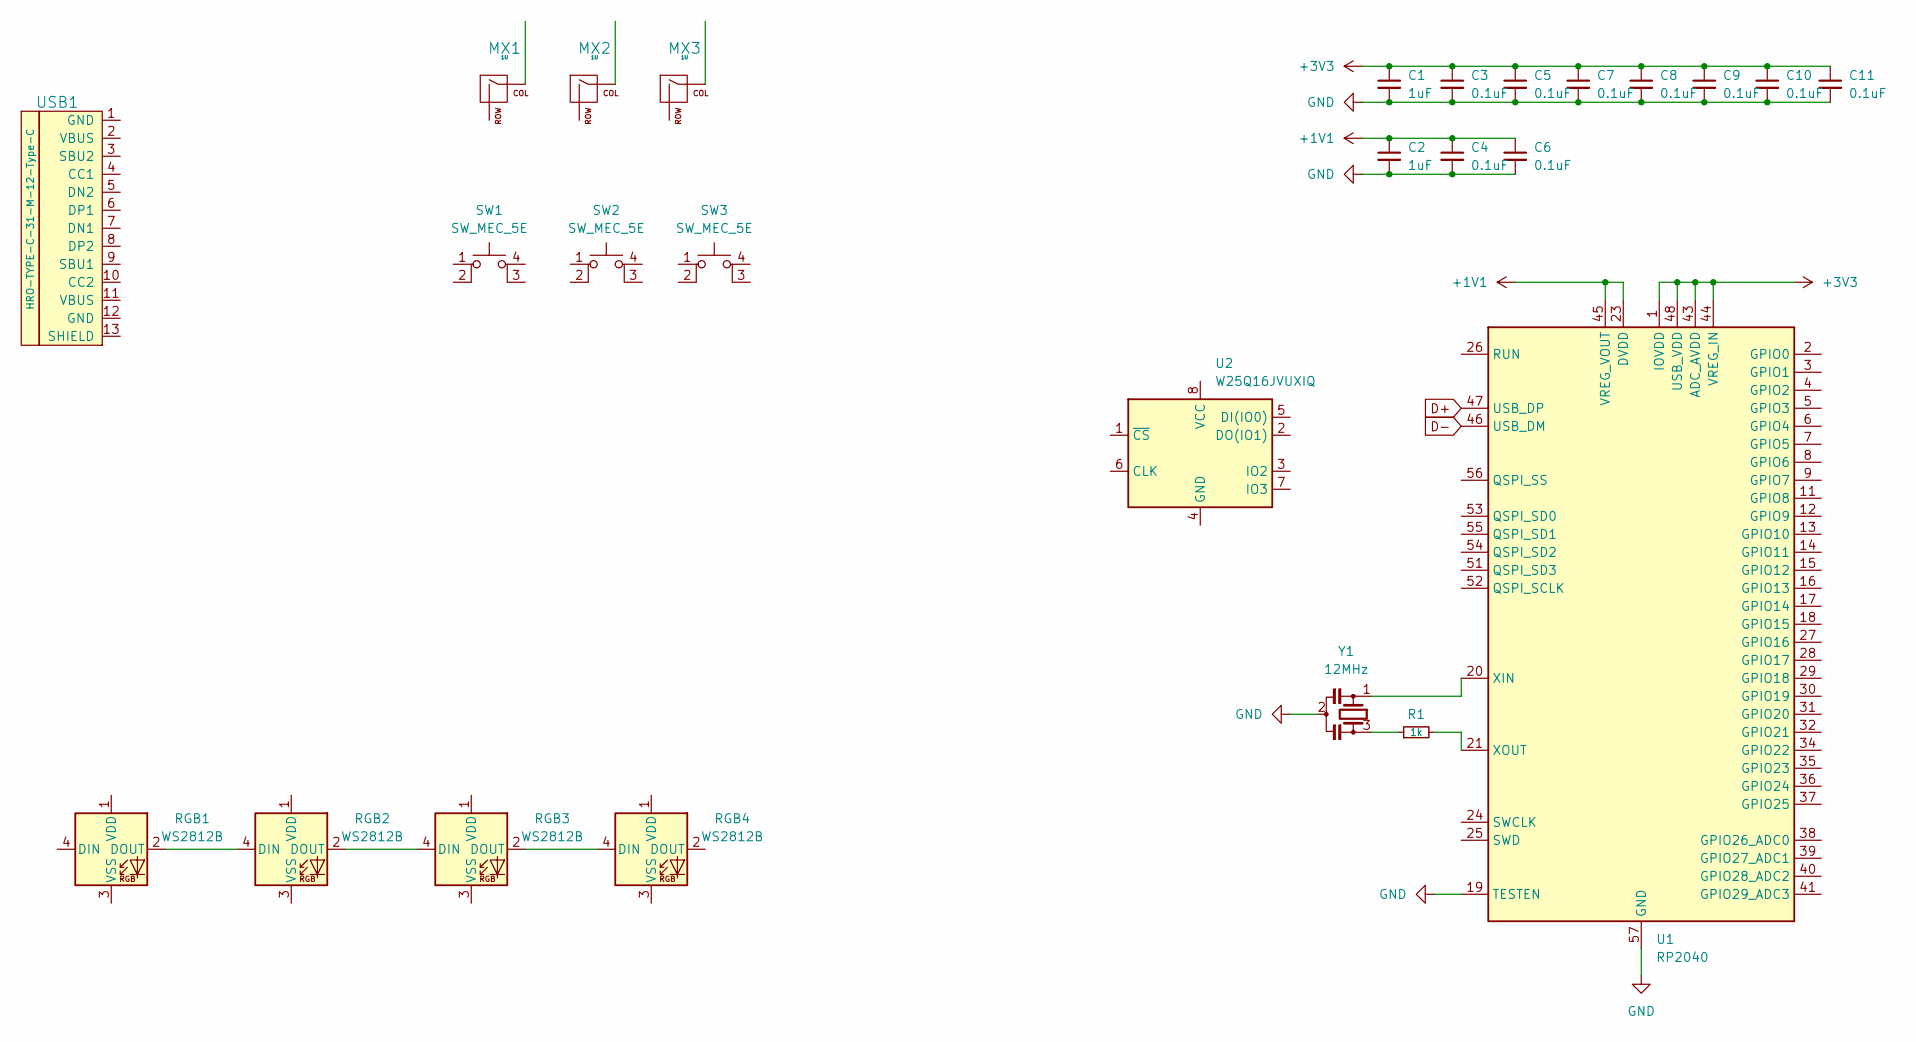
[picture p173: schematic Salane usO.kicad_sch]

Parts:
C1, C2: 1uF; C_0402
C3, C4, C5, C6, C7, C8, C9, C10, C11: 0.1uF; C_0402
MX1, MX2, MX3: 1U; MXOnly-1U-Hotswap-Sawns
R1: 1k; R_0402
RGB1, RGB2, RGB3, RGB4: WS2812B; LED_WS2812B_PLCC4_5.0x5.0mm_P3.2mm
SW1, SW2, SW3: SW_MEC_5E; PushButton_6x6mm_TH
U1: RP2040; QFN-56-1EP_7x7mm_P0.4mm_EP3.2x3.2mm
U2: W25Q16JVUXIQ; SON-8-1EP_3x2mm_P0.5mm_EP1.4x1.6mm
USB1: HRO-TYPE-C-31-M-12-Type-C; HRO-TYPE-C-31-M-12-Assembly
Y1: 12MHz; Resonator_SMD_Murata_CSTxExxV-3Pin_3.0x1.1mm

Connections:
+1V1: C2.1, C4.1, C6.1, U1.23 (DVDD), U1.45 (VREG_VOUT), U1.50 (DVDD)
+3V3: C1.1, C3.1, C5.1, C7.1, C8.1, C9.1, C10.1, C11.1, U1.1 (IOVDD), U1.10 (IOVDD), U1.22 (IOVDD), U1.33 (IOVDD), U1.42 (IOVDD), U1.43 (ADC_AVDD), U1.44 (VREG_IN), U1.48 (USB_VDD), U1.49 (IOVDD)
D+: U1.47 (USB_DP)
D-: U1.46 (USB_DM)
GND: C1.2, C2.2, C3.2, C4.2, C5.2, C6.2, C7.2, C8.2, C9.2, C10.2, C11.2, U1.19 (TESTEN), U1.57 (GND), Y1.2
unnamed: R1.1, Y1.3
unnamed: RGB1.2 (DOUT), RGB2.4 (DIN)
unnamed: RGB2.2 (DOUT), RGB3.4 (DIN)
unnamed: RGB3.2 (DOUT), RGB4.4 (DIN)
unnamed: U1.20 (XIN), Y1.1
unnamed: R1.2, U1.21 (XOUT)

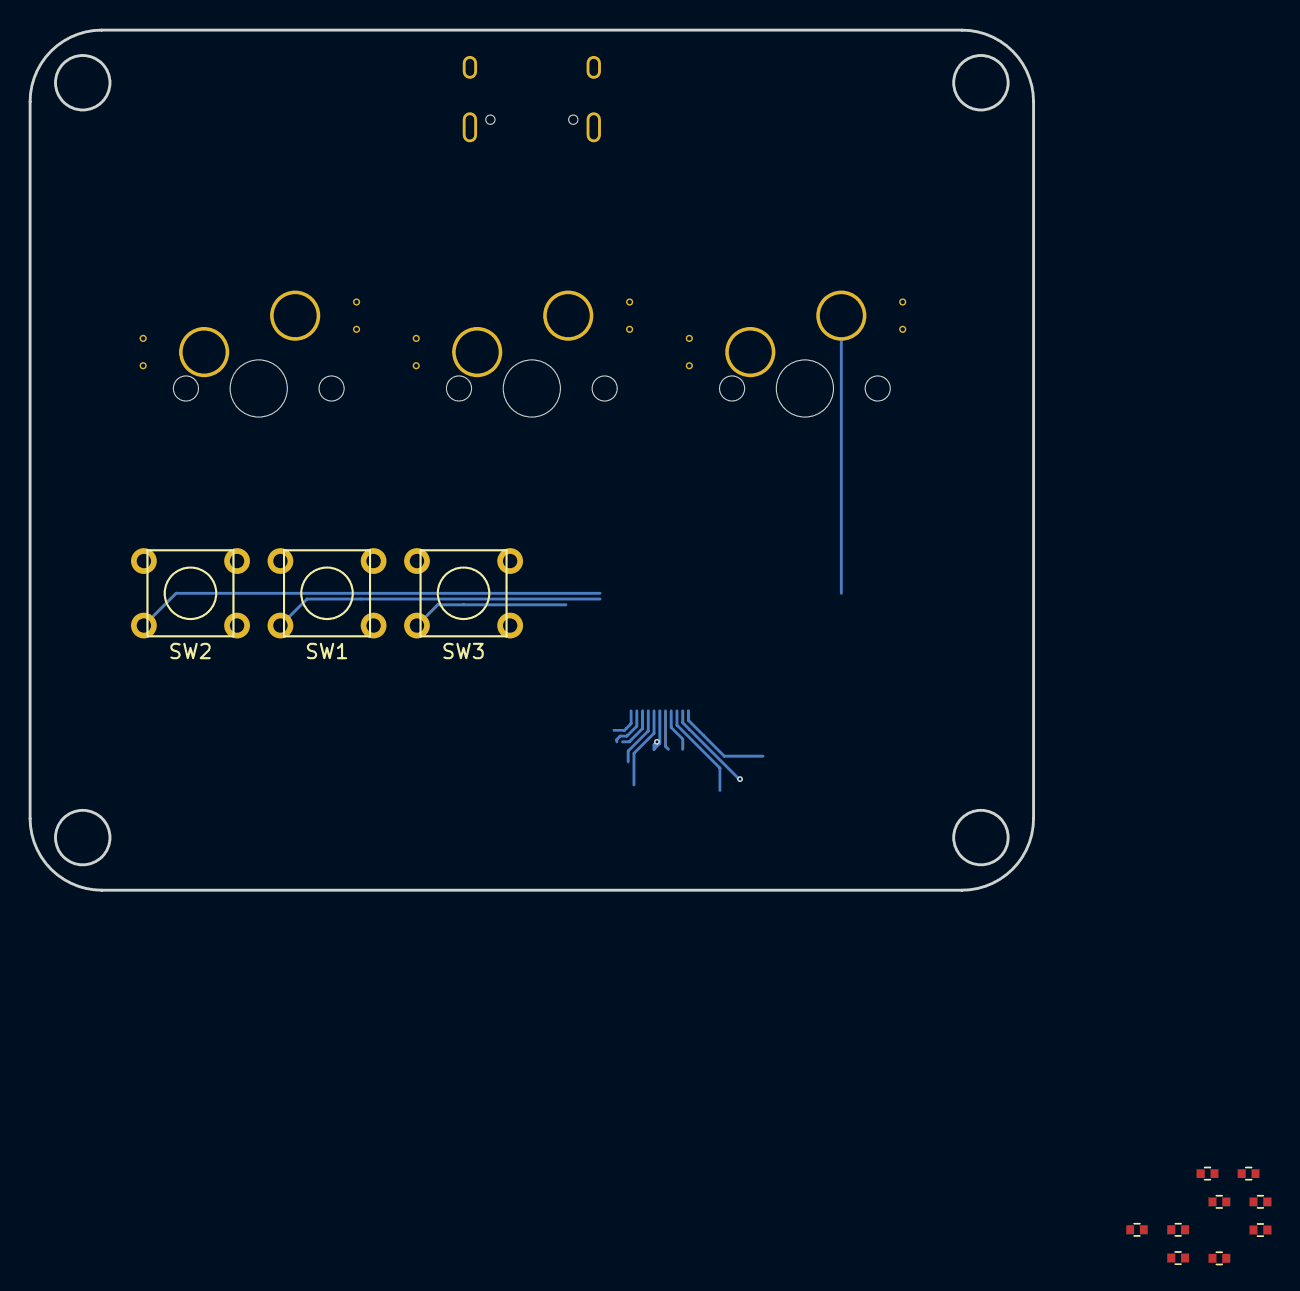
[picture p174: board Salane usO.kicad_pcb from above]

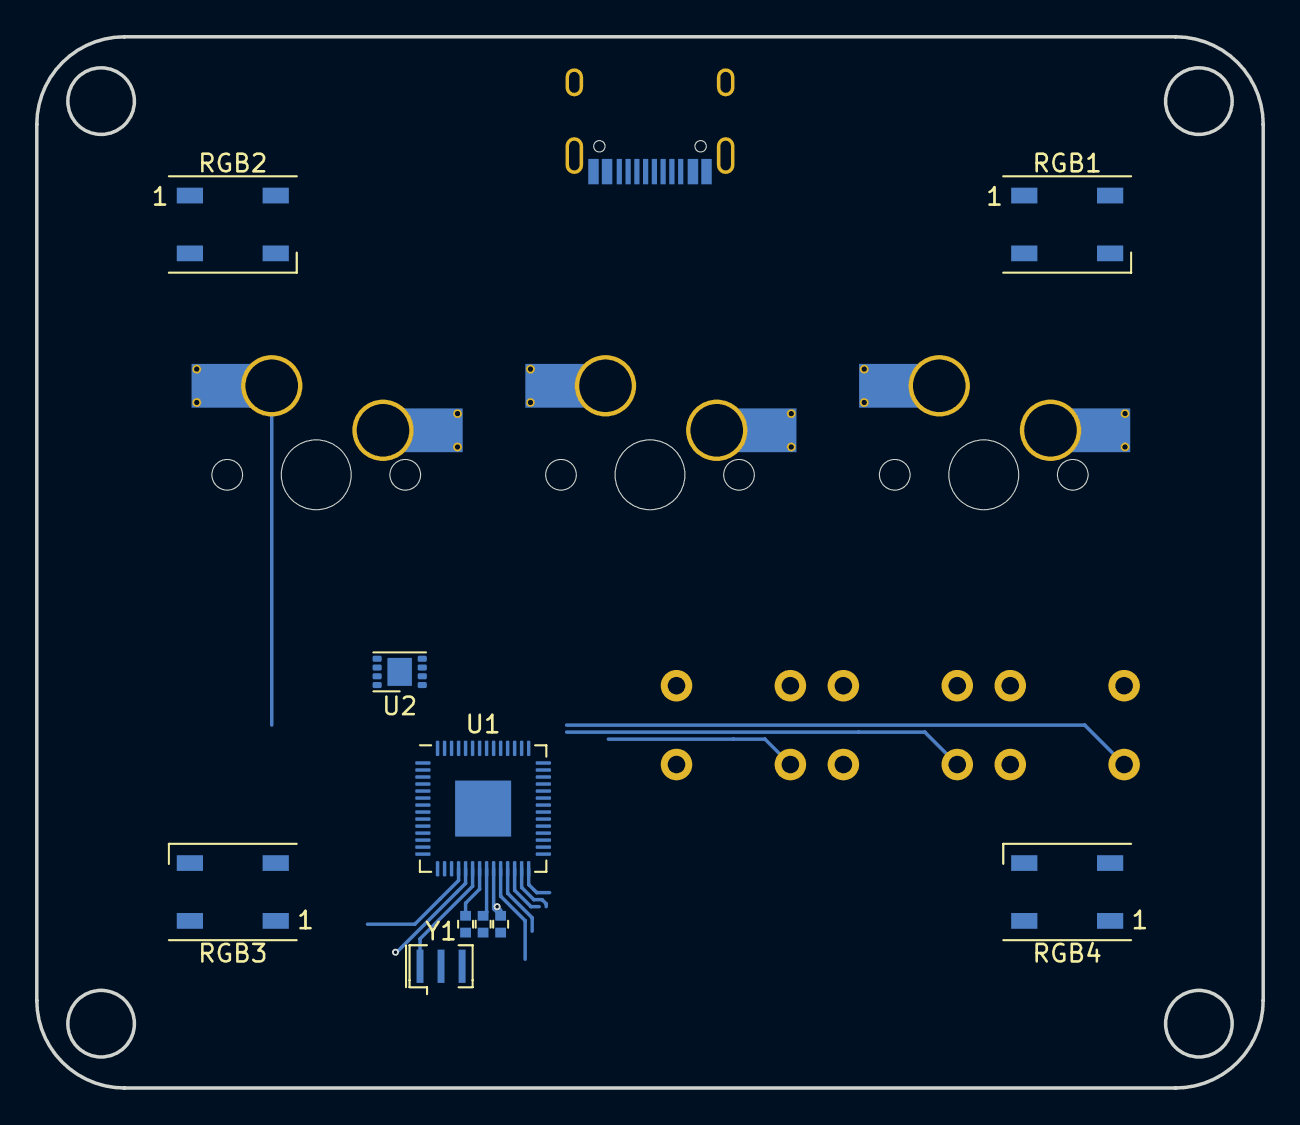
[picture p175: board Salane usO.kicad_pcb from below]

Board: 2 copper layers, 70.0 x 60.0 mm, 26 parts (11 on the bottom side), 9 nets.
