MaiTheSan/PCB-Design/Salane Reboot/ReChuniGay/ReChuniGay.kicad_pcb

## KiCad design Salane Reboot/ReChuniGay/ReChuniGay.kicad_pcb (2022-12-31)

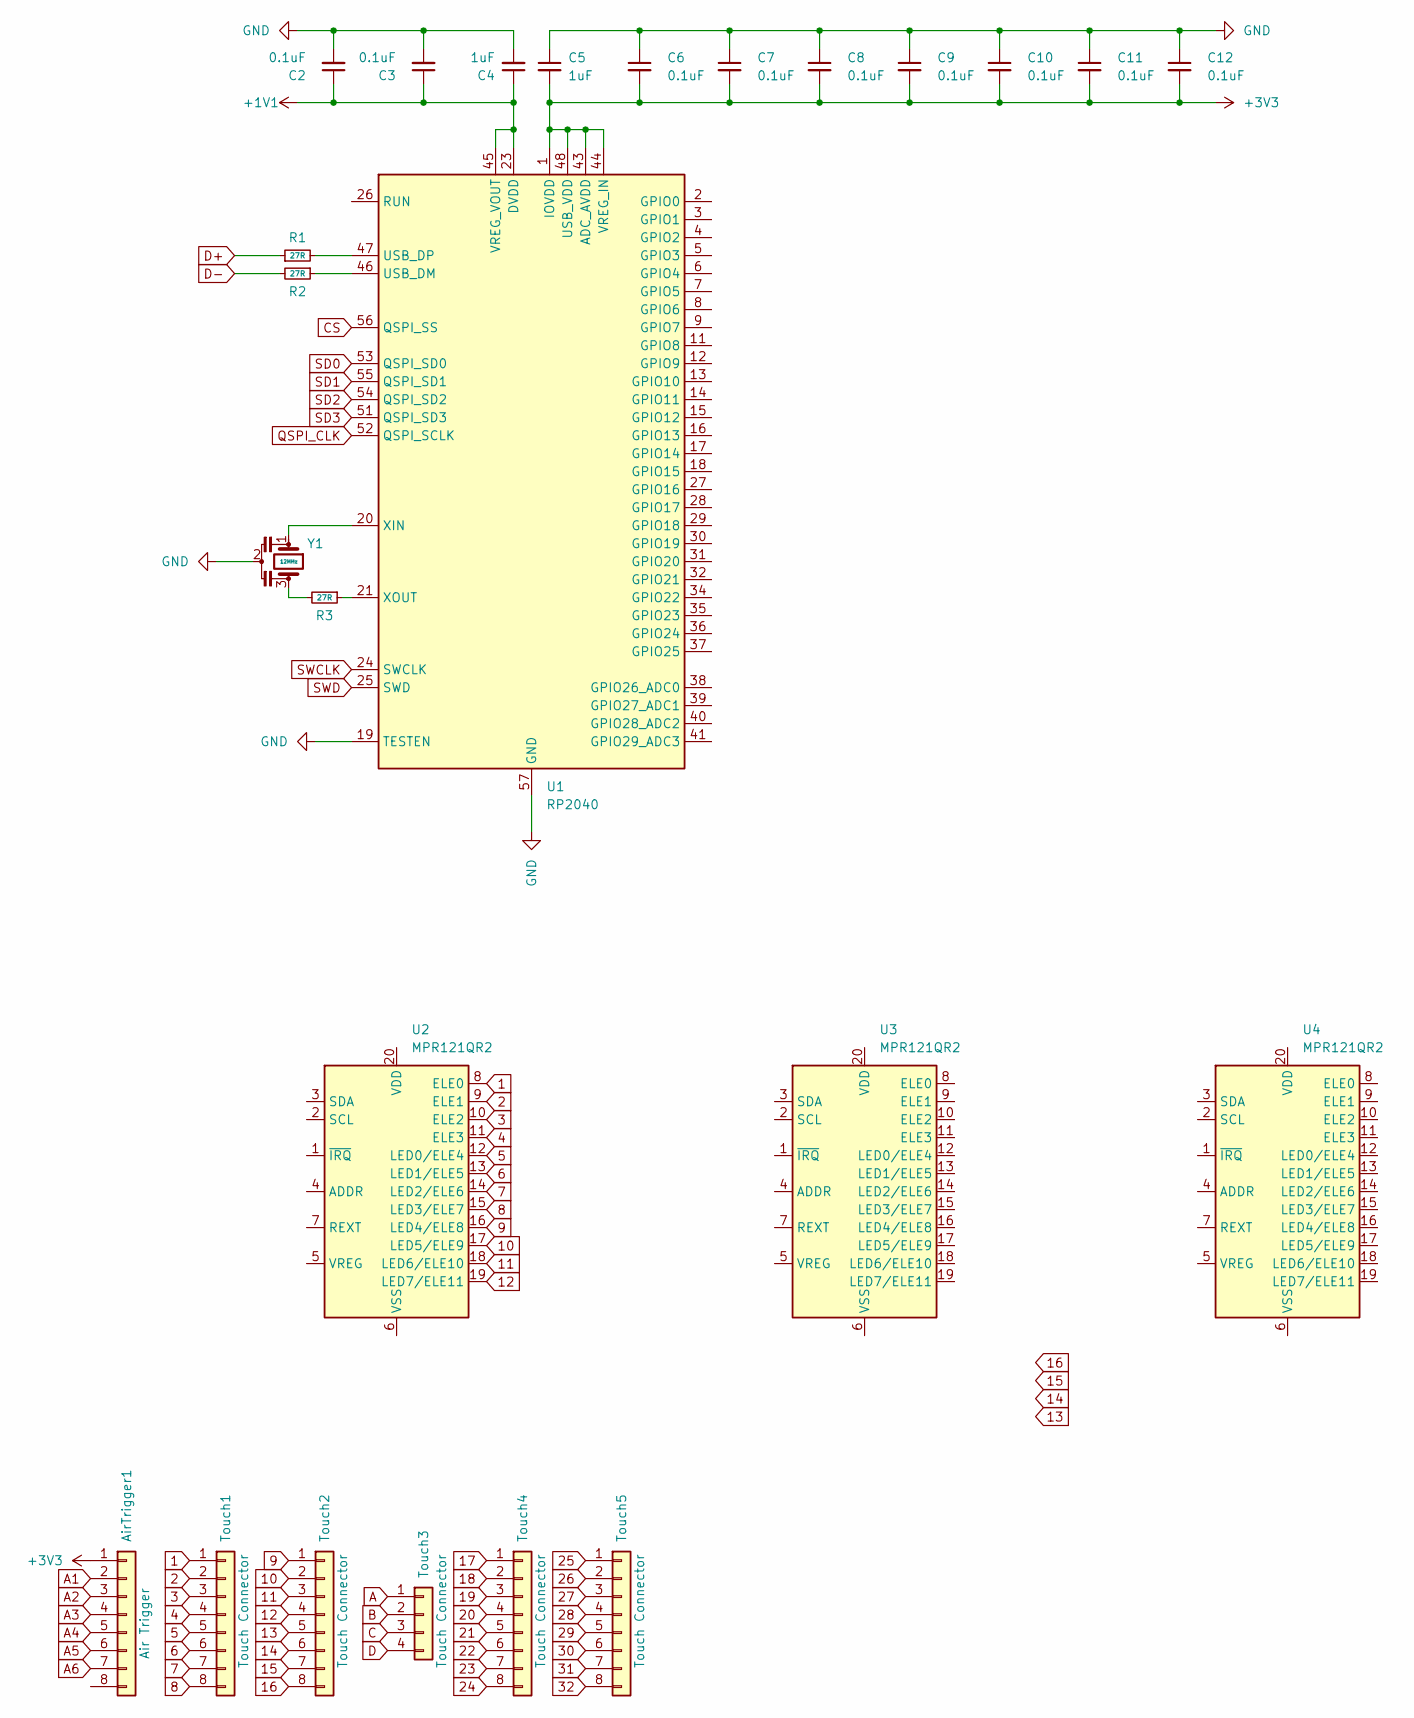
[picture p176: schematic ReChuniGay.kicad_sch]

Parts:
AirTrigger1: Air Trigger; JST_XH_S8B-XH-A-1_1x08_P2.50mm_Horizontal
C2, C3, C6, C7, C8, C9, C10, C11, C12: 0.1uF; C_0402
C4, C5: 1uF; C_0402
R1, R2, R3: 27R; R_0402
Touch1, Touch2, Touch4, Touch5: Touch Connector; JST_XH_S8B-XH-A-1_1x08_P2.50mm_Horizontal
Touch3: Touch Connector; JST_XH_S5B-XH-A-1_1x05_P2.50mm_Horizontal
U1: RP2040; RP2040-QFN-56
U2, U3, U4: MPR121QR2; UQFN-20_3x3mm_P0.4mm
Y1: 12MHz

Connections:
1: Touch1.1, U2.8 (ELE0)
2: Touch1.2, U2.9 (ELE1)
3: Touch1.3, U2.10 (ELE2)
4: Touch1.4, U2.11 (ELE3)
5: Touch1.5, U2.12 (LED0/ELE4)
6: Touch1.6, U2.13 (LED1/ELE5)
7: Touch1.7, U2.14 (LED2/ELE6)
8: Touch1.8, U2.15 (LED3/ELE7)
9: Touch2.1, U2.16 (LED4/ELE8)
10: Touch2.2, U2.17 (LED5/ELE9)
11: Touch2.3, U2.18 (LED6/ELE10)
12: Touch2.4, U2.19 (LED7/ELE11)
13: Touch2.5
14: Touch2.6
15: Touch2.7
16: Touch2.8
17: Touch4.1
18: Touch4.2
19: Touch4.3
20: Touch4.4
21: Touch4.5
22: Touch4.6
23: Touch4.7
24: Touch4.8
25: Touch5.1
26: Touch5.2
27: Touch5.3
28: Touch5.4
29: Touch5.5
30: Touch5.6
31: Touch5.7
32: Touch5.8
+1V1: C2.1, C3.1, C4.1, U1.23 (DVDD), U1.45 (VREG_VOUT), U1.50 (DVDD)
+3V3: AirTrigger1.1, C5.2, C6.2, C7.2, C8.2, C9.2, C10.2, C11.2, C12.2, U1.1 (IOVDD), U1.10 (IOVDD), U1.22 (IOVDD), U1.33 (IOVDD), U1.42 (IOVDD), U1.43 (ADC_AVDD), U1.44 (VREG_IN), U1.48 (USB_VDD), U1.49 (IOVDD); also elsewhere on the board
A: Touch3.1
A1: AirTrigger1.2; also elsewhere on the board
A2: AirTrigger1.3; also elsewhere on the board
A3: AirTrigger1.4; also elsewhere on the board
A4: AirTrigger1.5; also elsewhere on the board
A5: AirTrigger1.6; also elsewhere on the board
A6: AirTrigger1.7; also elsewhere on the board
B: Touch3.2
C: Touch3.3
CS: U1.56 (QSPI_SS)
D: Touch3.4
D+: R1.1
D-: R2.2
GND: C2.2, C3.2, C4.2, C5.1, C6.1, C7.1, C8.1, C9.1, C10.1, C11.1, C12.1, U1.19 (TESTEN), U1.57 (GND), Y1.2
unnamed: R1.2, U1.47 (USB_DP)
unnamed: R2.1, U1.46 (USB_DM)
unnamed: R3.1, U1.21 (XOUT)
unnamed: R3.2, Y1.3
unnamed: U1.20 (XIN), Y1.1
QSPI_CLK: U1.52 (QSPI_SCLK)
SD0: U1.53 (QSPI_SD0)
SD1: U1.55 (QSPI_SD1)
SD2: U1.54 (QSPI_SD2)
SD3: U1.51 (QSPI_SD3)
SWCLK: U1.24 (SWCLK)
SWD: U1.25 (SWD)

Board: 2 copper layers, 25 parts (0 on the bottom side), 24 nets, no tracks yet.

Other parts of the board:
AirTrigger1#2: Air Trigger; JST_XH_S8B-XH-A-1_1x08_P2.50mm_Horizontal

Their connections:
+3V3: AirTrigger1#2.1; also elsewhere on the board
A1: AirTrigger1#2.2; also elsewhere on the board
A2: AirTrigger1#2.3; also elsewhere on the board
A3: AirTrigger1#2.4; also elsewhere on the board
A4: AirTrigger1#2.5; also elsewhere on the board
A5: AirTrigger1#2.6; also elsewhere on the board
A6: AirTrigger1#2.7; also elsewhere on the board
