MaiTheSan/PCB-Design/Salane Reboot/Armageddon/Solder.kicad_pcb

## KiCad design Salane Reboot/Armageddon/Solder.kicad_pcb (2022-12-31)

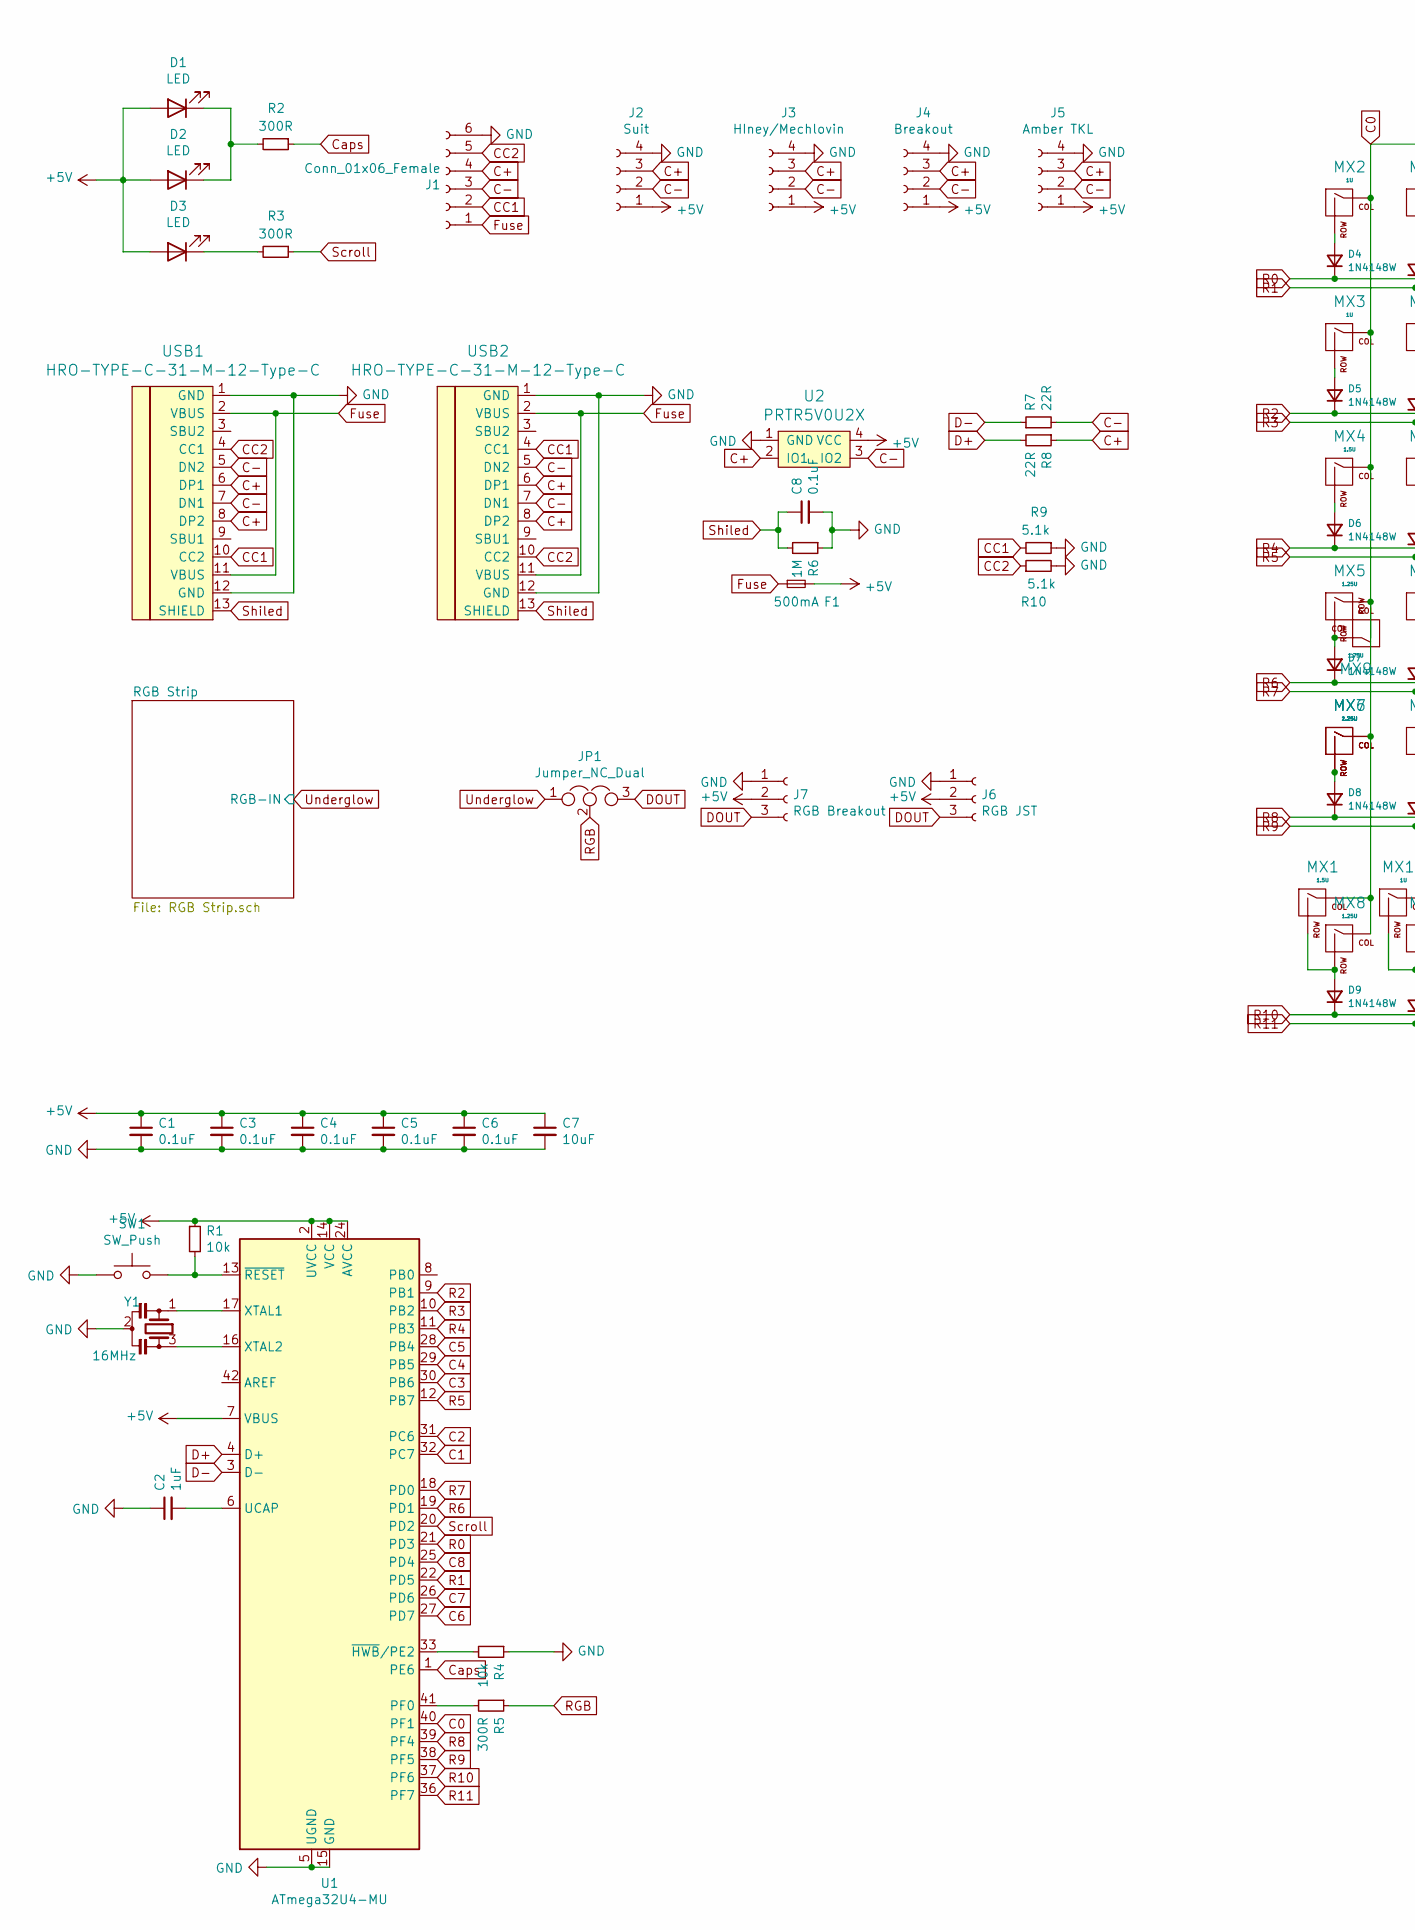
[picture p177: schematic Solder.sch, part in row 1, column 1]

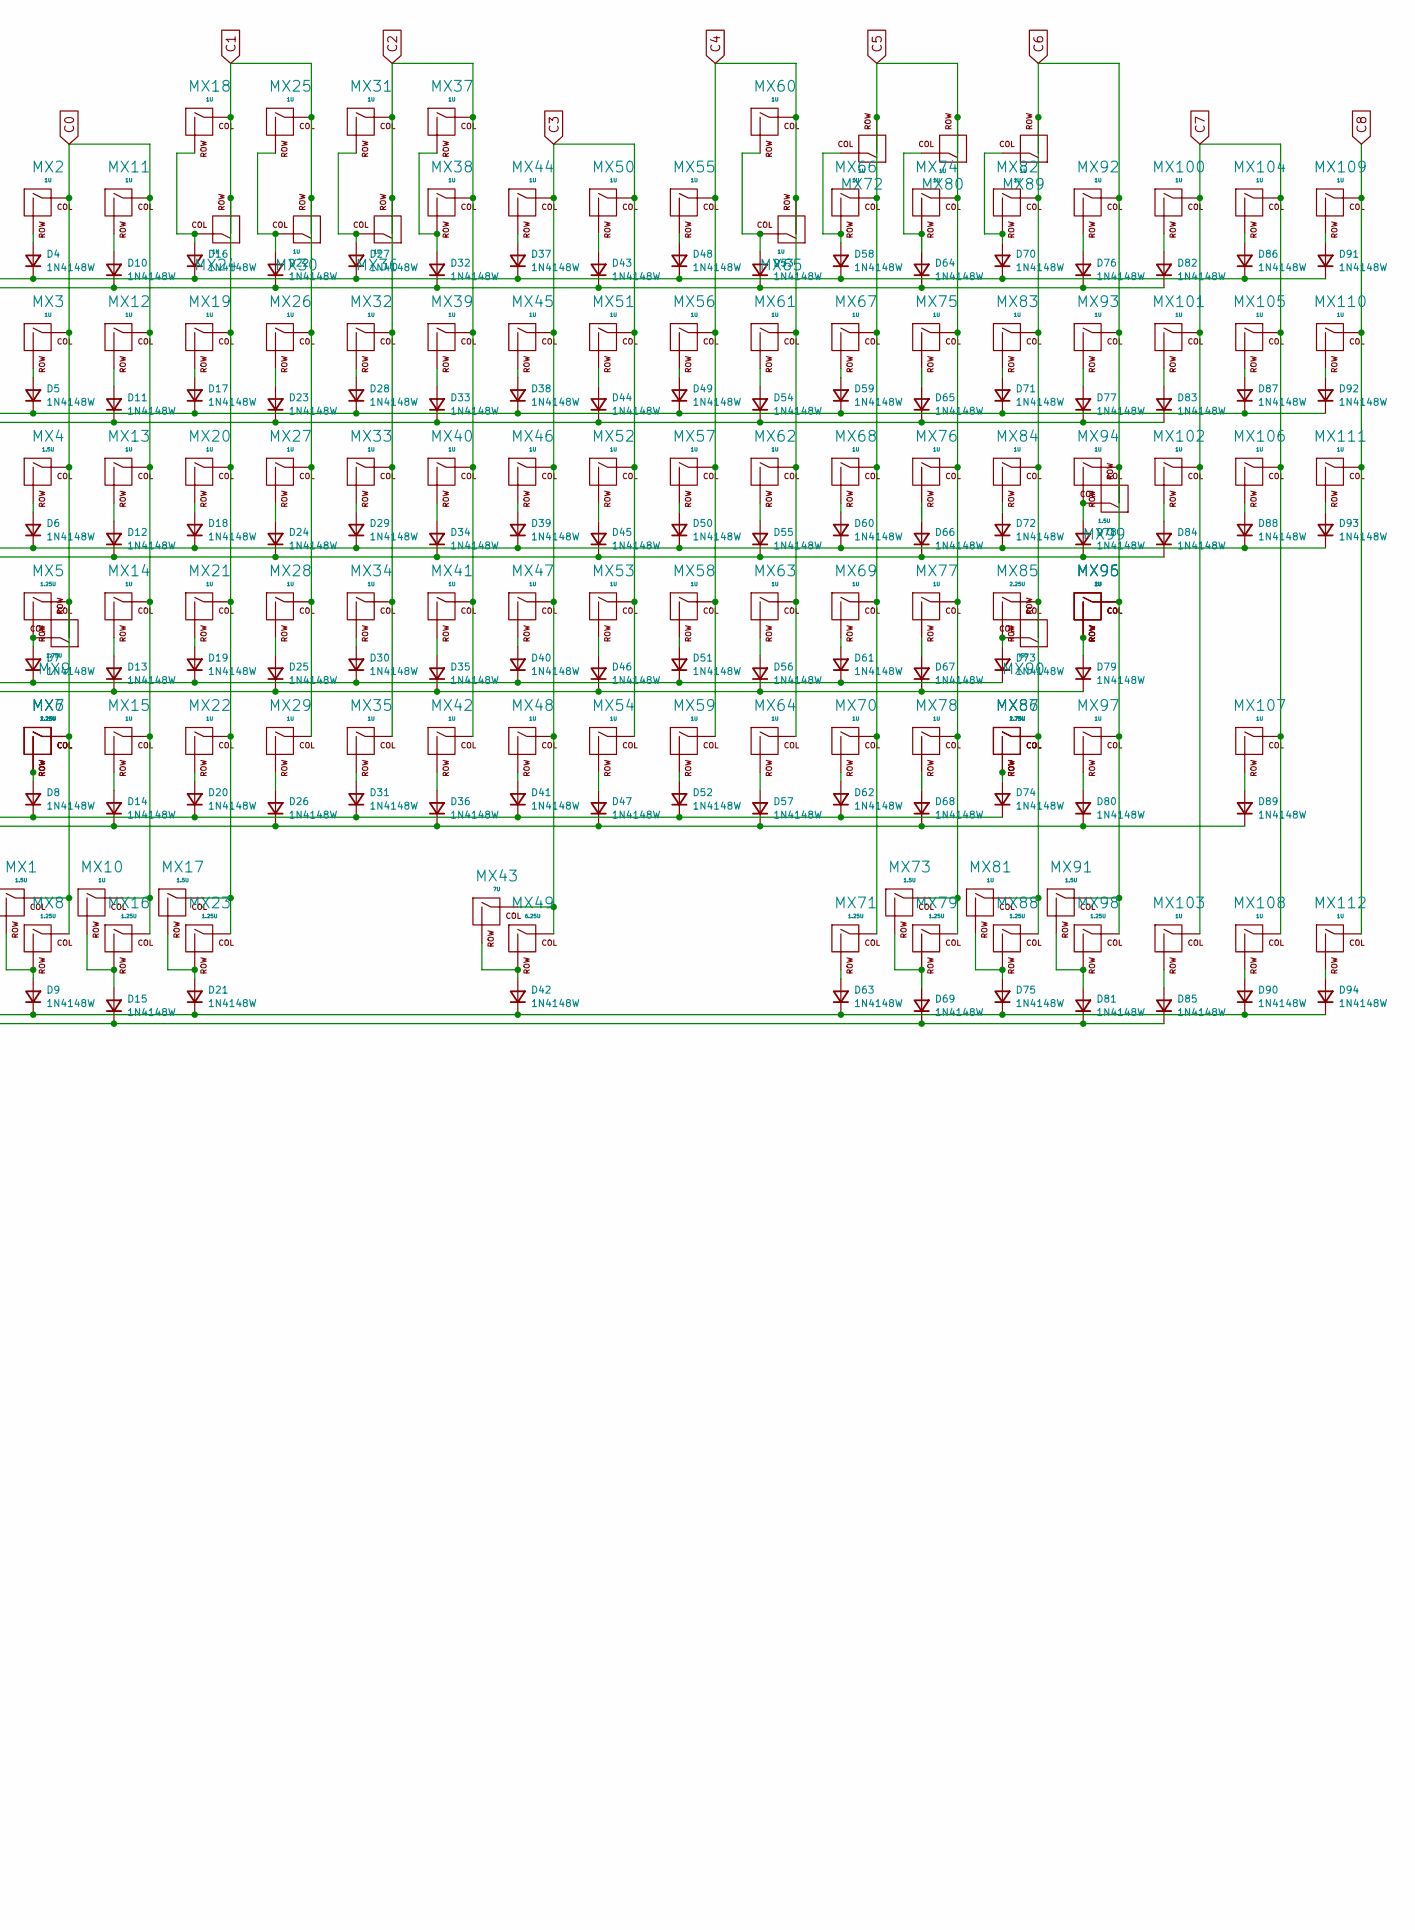
[picture p178: schematic Solder.sch, part in row 1, column 2]

Parts:
C1, C3, C4, C5, C6, C8: 0.1uF; C_0402
C2: 1uF; C_0402
C7: 10uF; C_0402
D1: LED; MXOnly-LEDONLY-FLIPPED
D2, D3: LED; MXOnly-LEDONLY
D4, D5, D6, D7, D8, D9, D10, D11, D12, D13, D14, D15, D16, D17, D18, D19, D20, D21, D22, D23, D24, D25, D26, D27, D28, D29, D30, D31, D32, D33, D34, D35, D36, D37, D38, D39, D40, D41, D42, D43, D44, D45, D46, D47, D48, D49, D50, D51, D52, D53, D54, D55, D56, D57, D58, D59, D60, D61, D62, D63, D64, D65, D66, D67, D68, D69, D70, D71, D72, D73, D74, D75, D76, D77, D78, D79, D80, D81, D82, D83, D84, D85, D86, D87, D88, D89, D90, D91, D92, D93, D94: 1N4148W; DIODE_1206_SawnsProjects
F1: 500mA; Fuse_SMD1206_Reflow
J1: Conn_01x06_Female; BreakoutUSB
J2: Suit; JST-SR-4
J3: HIney/Mechlovin; JST-SR-4
J4: Breakout; PinHeader_1x04_P1.27mm_Vertical
J5: Amber TKL; JST-SR-4
J6: RGB JST; JST-SR-3
J7: RGB Breakout; RGB-Header
JP1: Jumper_NC_Dual; SolderJumper-3_P1.3mm_Open_Pad1.0x1.5mm
MX1, MX4, MX17, MX73, MX91, MX99: 1.5U; MXOnly-1.5U-NoLED
MX2, MX3, MX10, MX11, MX12, MX13, MX14, MX15, MX18, MX19, MX20, MX21, MX22, MX24, MX25, MX26, MX27, MX28, MX29, MX30, MX31, MX32, MX33, MX34, MX35, MX36, MX37, MX38, MX39, MX40, MX41, MX42, MX44, MX45, MX46, MX47, MX48, MX50, MX51, MX52, MX53, MX54, MX55, MX56, MX57, MX58, MX59, MX60, MX61, MX62, MX63, MX64, MX65, MX66, MX67, MX68, MX69, MX70, MX72, MX74, MX75, MX76, MX77, MX78, MX80, MX81, MX82, MX83, MX84, MX89, MX92, MX93, MX94, MX95, MX97, MX100, MX101, MX102, MX103, MX104, MX105, MX106, MX107, MX108, MX109, MX110, MX111, MX112: 1U; MXOnly-1U-NoLED
MX5, MX6, MX8, MX16, MX23, MX71, MX79, MX88, MX98: 1.25U; MXOnly-1.25U-NoLED
MX7: 2.25U; MXOnly-2.25U-NoLED
MX9, MX86: 1.75U; MXOnly-1.75U-NoLED
MX43: 7U; MXOnly-7U-ReversedStabilizers-NoLED
MX49: 6.25U; MXOnly-6.25U-ReversedStabilizers-NoLED
MX85: 2.25U; MXOnly-2.25U-ReversedStabilizers-NoLED
MX87: 2.75U; MXOnly-2.75U-NoLED
MX90: ISO; MXOnly-ISO-ROTATED-ReversedStabilizers-NoLED
MX96: 2U; MXOnly-2U-NoLED
R1, R4: 10k; R_0402
R2, R3, R5: 300R; R_0402
R6: 1M; R_0402
R7, R8: 22R; R_0402
R9, R10: 5.1k; R_0402
SW1: SW_Push; SKQG-1155865-2pin
U1: ATmega32U4-MU; QFN-44-1EP_7x7mm_P0.5mm_EP5.2x5.2mm
U2: PRTR5V0U2X; SOT143B
USB1, USB2: HRO-TYPE-C-31-M-12-Type-C; HRO-TYPE-C-31-M-12-Assembly
Y1: 16MHz; Resonator_SMD_muRata_CSTxExxV-3Pin_3.0x1.1mm

Connections:
+5V: C1.1, C3.1, C4.1, C5.1, C6.1, C7.1, D1.2 (A), D2.2 (A), D3.2 (A), F1.2, J2.1, J3.1, J4.1, J5.1, J6.2, J7.2, R1.1, U1.2 (UVCC), U1.7 (VBUS), U1.14 (VCC), U1.24 (AVCC), U1.34 (VCC), U1.44 (AVCC), U2.4 (VCC); also elsewhere on the board
C0: MX1.1 (COL), MX2.1 (COL), MX3.1 (COL), MX4.1 (COL), MX5.1 (COL), MX6.1 (COL), MX7.1 (COL), MX8.1 (COL), MX9.2 (ROW), MX10.1 (COL), MX11.1 (COL), MX12.1 (COL), MX13.1 (COL), MX14.1 (COL), MX15.1 (COL), MX16.1 (COL), U1.40 (PF1)
C1: MX17.1 (COL), MX18.1 (COL), MX19.1 (COL), MX20.1 (COL), MX21.1 (COL), MX22.1 (COL), MX23.1 (COL), MX24.2 (ROW), MX25.1 (COL), MX26.1 (COL), MX27.1 (COL), MX28.1 (COL), MX29.1 (COL), MX30.2 (ROW), U1.32 (PC7)
C2: MX31.1 (COL), MX32.1 (COL), MX33.1 (COL), MX34.1 (COL), MX35.1 (COL), MX36.2 (ROW), MX37.1 (COL), MX38.1 (COL), MX39.1 (COL), MX40.1 (COL), MX41.1 (COL), MX42.1 (COL), U1.31 (PC6)
C3: MX43.1 (COL), MX44.1 (COL), MX45.1 (COL), MX46.1 (COL), MX47.1 (COL), MX48.1 (COL), MX49.1 (COL), MX50.1 (COL), MX51.1 (COL), MX52.1 (COL), MX53.1 (COL), MX54.1 (COL), U1.30 (PB6)
C4: MX55.1 (COL), MX56.1 (COL), MX57.1 (COL), MX58.1 (COL), MX59.1 (COL), MX60.1 (COL), MX61.1 (COL), MX62.1 (COL), MX63.1 (COL), MX64.1 (COL), MX65.2 (ROW), U1.29 (PB5)
C5: MX66.1 (COL), MX67.1 (COL), MX68.1 (COL), MX69.1 (COL), MX70.1 (COL), MX71.1 (COL), MX72.2 (ROW), MX73.1 (COL), MX74.1 (COL), MX75.1 (COL), MX76.1 (COL), MX77.1 (COL), MX78.1 (COL), MX79.1 (COL), MX80.2 (ROW), U1.28 (PB4)
C6: MX81.1 (COL), MX82.1 (COL), MX83.1 (COL), MX84.1 (COL), MX85.1 (COL), MX86.1 (COL), MX87.1 (COL), MX88.1 (COL), MX89.2 (ROW), MX90.2 (ROW), MX91.1 (COL), MX92.1 (COL), MX93.1 (COL), MX94.1 (COL), MX95.1 (COL), MX96.1 (COL), MX97.1 (COL), MX98.1 (COL), MX99.2 (ROW), U1.27 (PD7)
C7: MX100.1 (COL), MX101.1 (COL), MX102.1 (COL), MX103.1 (COL), MX104.1 (COL), MX105.1 (COL), MX106.1 (COL), MX107.1 (COL), MX108.1 (COL), U1.26 (PD6)
C8: MX109.1 (COL), MX110.1 (COL), MX111.1 (COL), MX112.1 (COL), U1.25 (PD4)
C+: J1.4, J2.3, J3.3, J4.3, J5.3, R8.1, U2.2 (IO1), USB1.6 (DP1), USB1.8 (DP2), USB2.6 (DP1), USB2.8 (DP2)
C-: J1.3, J2.2, J3.2, J4.2, J5.2, R7.2, U2.3 (IO2), USB1.5 (DN2), USB1.7 (DN1), USB2.5 (DN2), USB2.7 (DN1)
CC1: J1.2, R9.2, USB1.10 (CC2), USB2.4 (CC1)
CC2: J1.5, R10.1, USB1.4 (CC1), USB2.10 (CC2)
Caps: R2.1, U1.1 (PE6)
D+: R8.2, U1.4 (D+)
D-: R7.1, U1.3 (D-)
DOUT: J6.3, J7.3, JP1.3
Fuse: F1.1, J1.1, USB1.2 (VBUS), USB1.11 (VBUS), USB2.2 (VBUS), USB2.11 (VBUS)
GND: C1.2, C2.1, C3.2, C4.2, C5.2, C6.2, C7.2, C8.2, J1.6, J2.4, J3.4, J4.4, J5.4, J6.1, J7.1, R4.1, R6.1, R9.1, R10.2, SW1.1, U1.5 (UGND), U1.15 (GND), U1.23 (GND), U1.35 (GND), U1.43 (GND), U1.45 (GND), U2.1 (GND), USB1.1 (GND), USB1.12 (GND), USB2.1 (GND), USB2.12 (GND), Y1.2; also elsewhere on the board
unnamed: C2.2, U1.6 (UCAP)
unnamed: D1.1 (K), D2.1 (K), R2.2
unnamed: D3.1 (K), R3.2
unnamed: D4.2 (A), MX2.2 (ROW)
unnamed: D5.2 (A), MX3.2 (ROW)
unnamed: D6.2 (A), MX4.2 (ROW)
unnamed: D7.2 (A), MX5.2 (ROW), MX9.1 (COL)
unnamed: D8.2 (A), MX6.2 (ROW), MX7.2 (ROW)
unnamed: D9.2 (A), MX1.2 (ROW), MX8.2 (ROW)
unnamed: D10.2 (A), MX11.2 (ROW)
unnamed: D11.2 (A), MX12.2 (ROW)
unnamed: D12.2 (A), MX13.2 (ROW)
unnamed: D13.2 (A), MX14.2 (ROW)
unnamed: D14.2 (A), MX15.2 (ROW)
unnamed: D15.2 (A), MX10.2 (ROW), MX16.2 (ROW)
unnamed: D16.2 (A), MX18.2 (ROW), MX24.1 (COL)
unnamed: D17.2 (A), MX19.2 (ROW)
unnamed: D18.2 (A), MX20.2 (ROW)
unnamed: D19.2 (A), MX21.2 (ROW)
unnamed: D20.2 (A), MX22.2 (ROW)
unnamed: D21.2 (A), MX17.2 (ROW), MX23.2 (ROW)
unnamed: D22.2 (A), MX25.2 (ROW), MX30.1 (COL)
unnamed: D23.2 (A), MX26.2 (ROW)
unnamed: D24.2 (A), MX27.2 (ROW)
unnamed: D25.2 (A), MX28.2 (ROW)
unnamed: D26.2 (A), MX29.2 (ROW)
unnamed: D27.2 (A), MX31.2 (ROW), MX36.1 (COL)
unnamed: D28.2 (A), MX32.2 (ROW)
unnamed: D29.2 (A), MX33.2 (ROW)
unnamed: D30.2 (A), MX34.2 (ROW)
unnamed: D31.2 (A), MX35.2 (ROW)
unnamed: D32.2 (A), MX37.2 (ROW), MX38.2 (ROW)
unnamed: D33.2 (A), MX39.2 (ROW)
unnamed: D34.2 (A), MX40.2 (ROW)
unnamed: D35.2 (A), MX41.2 (ROW)
unnamed: D36.2 (A), MX42.2 (ROW)
unnamed: D37.2 (A), MX44.2 (ROW)
unnamed: D38.2 (A), MX45.2 (ROW)
unnamed: D39.2 (A), MX46.2 (ROW)
unnamed: D40.2 (A), MX47.2 (ROW)
unnamed: D41.2 (A), MX48.2 (ROW)
unnamed: D42.2 (A), MX43.2 (ROW), MX49.2 (ROW)
unnamed: D43.2 (A), MX50.2 (ROW)
unnamed: D44.2 (A), MX51.2 (ROW)
unnamed: D45.2 (A), MX52.2 (ROW)
unnamed: D46.2 (A), MX53.2 (ROW)
unnamed: D47.2 (A), MX54.2 (ROW)
unnamed: D48.2 (A), MX55.2 (ROW)
unnamed: D49.2 (A), MX56.2 (ROW)
unnamed: D50.2 (A), MX57.2 (ROW)
unnamed: D51.2 (A), MX58.2 (ROW)
unnamed: D52.2 (A), MX59.2 (ROW)
unnamed: D53.2 (A), MX60.2 (ROW), MX65.1 (COL)
unnamed: D54.2 (A), MX61.2 (ROW)
unnamed: D55.2 (A), MX62.2 (ROW)
unnamed: D56.2 (A), MX63.2 (ROW)
unnamed: D57.2 (A), MX64.2 (ROW)
unnamed: D58.2 (A), MX66.2 (ROW), MX72.1 (COL)
unnamed: D59.2 (A), MX67.2 (ROW)
unnamed: D60.2 (A), MX68.2 (ROW)
unnamed: D61.2 (A), MX69.2 (ROW)
unnamed: D62.2 (A), MX70.2 (ROW)
unnamed: D63.2 (A), MX71.2 (ROW)
unnamed: D64.2 (A), MX74.2 (ROW), MX80.1 (COL)
unnamed: D65.2 (A), MX75.2 (ROW)
unnamed: D66.2 (A), MX76.2 (ROW)
unnamed: D67.2 (A), MX77.2 (ROW)
unnamed: D68.2 (A), MX78.2 (ROW)
unnamed: D69.2 (A), MX73.2 (ROW), MX79.2 (ROW)
unnamed: D70.2 (A), MX82.2 (ROW), MX89.1 (COL)
unnamed: D71.2 (A), MX83.2 (ROW)
unnamed: D72.2 (A), MX84.2 (ROW)
unnamed: D73.2 (A), MX85.2 (ROW), MX90.1 (COL)
unnamed: D74.2 (A), MX86.2 (ROW), MX87.2 (ROW)
unnamed: D75.2 (A), MX81.2 (ROW), MX88.2 (ROW)
unnamed: D76.2 (A), MX92.2 (ROW)
unnamed: D77.2 (A), MX93.2 (ROW)
unnamed: D78.2 (A), MX94.2 (ROW), MX99.1 (COL)
unnamed: D79.2 (A), MX95.2 (ROW), MX96.2 (ROW)
unnamed: D80.2 (A), MX97.2 (ROW)
unnamed: D81.2 (A), MX91.2 (ROW), MX98.2 (ROW)
unnamed: D82.2 (A), MX100.2 (ROW)
unnamed: D83.2 (A), MX101.2 (ROW)
unnamed: D84.2 (A), MX102.2 (ROW)
unnamed: D85.2 (A), MX103.2 (ROW)
unnamed: D86.2 (A), MX104.2 (ROW)
unnamed: D87.2 (A), MX105.2 (ROW)
unnamed: D88.2 (A), MX106.2 (ROW)
unnamed: D89.2 (A), MX107.2 (ROW)
unnamed: D90.2 (A), MX108.2 (ROW)
unnamed: D91.2 (A), MX109.2 (ROW)
unnamed: D92.2 (A), MX110.2 (ROW)
unnamed: D93.2 (A), MX111.2 (ROW)
unnamed: D94.2 (A), MX112.2 (ROW)
unnamed: R1.2, SW1.2, U1.13 (~RESET)
unnamed: R4.2, U1.33 (~HWB~/PE2)
unnamed: R5.2, U1.41 (PF0)
unnamed: U1.16 (XTAL2), Y1.3
unnamed: U1.17 (XTAL1), Y1.1
R0: D4.1 (K), D16.1 (K), D27.1 (K), D37.1 (K), D48.1 (K), D58.1 (K), D70.1 (K), D86.1 (K), D91.1 (K), U1.21 (PD3)
R1: D10.1 (K), D22.1 (K), D32.1 (K), D43.1 (K), D53.1 (K), D64.1 (K), D76.1 (K), D82.1 (K), U1.22 (PD5)
R2: D5.1 (K), D17.1 (K), D28.1 (K), D38.1 (K), D49.1 (K), D59.1 (K), D71.1 (K), D87.1 (K), D92.1 (K), U1.9 (PB1)
R3: D11.1 (K), D23.1 (K), D33.1 (K), D44.1 (K), D54.1 (K), D65.1 (K), D77.1 (K), D83.1 (K), U1.10 (PB2)
R4: D6.1 (K), D18.1 (K), D29.1 (K), D39.1 (K), D50.1 (K), D60.1 (K), D72.1 (K), D88.1 (K), D93.1 (K), U1.11 (PB3)
R5: D12.1 (K), D24.1 (K), D34.1 (K), D45.1 (K), D55.1 (K), D66.1 (K), D78.1 (K), D84.1 (K), U1.12 (PB7)
R6: D7.1 (K), D19.1 (K), D30.1 (K), D40.1 (K), D51.1 (K), D61.1 (K), D73.1 (K), U1.19 (PD1)
R7: D13.1 (K), D25.1 (K), D35.1 (K), D46.1 (K), D56.1 (K), D67.1 (K), D79.1 (K), U1.18 (PD0)
R8: D8.1 (K), D20.1 (K), D31.1 (K), D41.1 (K), D52.1 (K), D62.1 (K), D74.1 (K), U1.39 (PF4)
R9: D14.1 (K), D26.1 (K), D36.1 (K), D47.1 (K), D57.1 (K), D68.1 (K), D80.1 (K), D89.1 (K), U1.38 (PF5)
R10: D9.1 (K), D21.1 (K), D42.1 (K), D63.1 (K), D75.1 (K), D90.1 (K), D94.1 (K), U1.37 (PF6)
R11: D15.1 (K), D69.1 (K), D81.1 (K), D85.1 (K), U1.36 (PF7)
RGB: JP1.2, R5.1
Scroll: R3.1, U1.20 (PD2)
Shiled: C8.1, R6.2, USB1.13 (SHIELD), USB2.13 (SHIELD)
Underglow: JP1.1; also elsewhere on the board
