MaiTheSan/PCB-Design/Salane Reboot/Armageddon/Solder.kicad_pcb

## KiCad design Salane Reboot/Armageddon/Solder.kicad_pcb (continued)

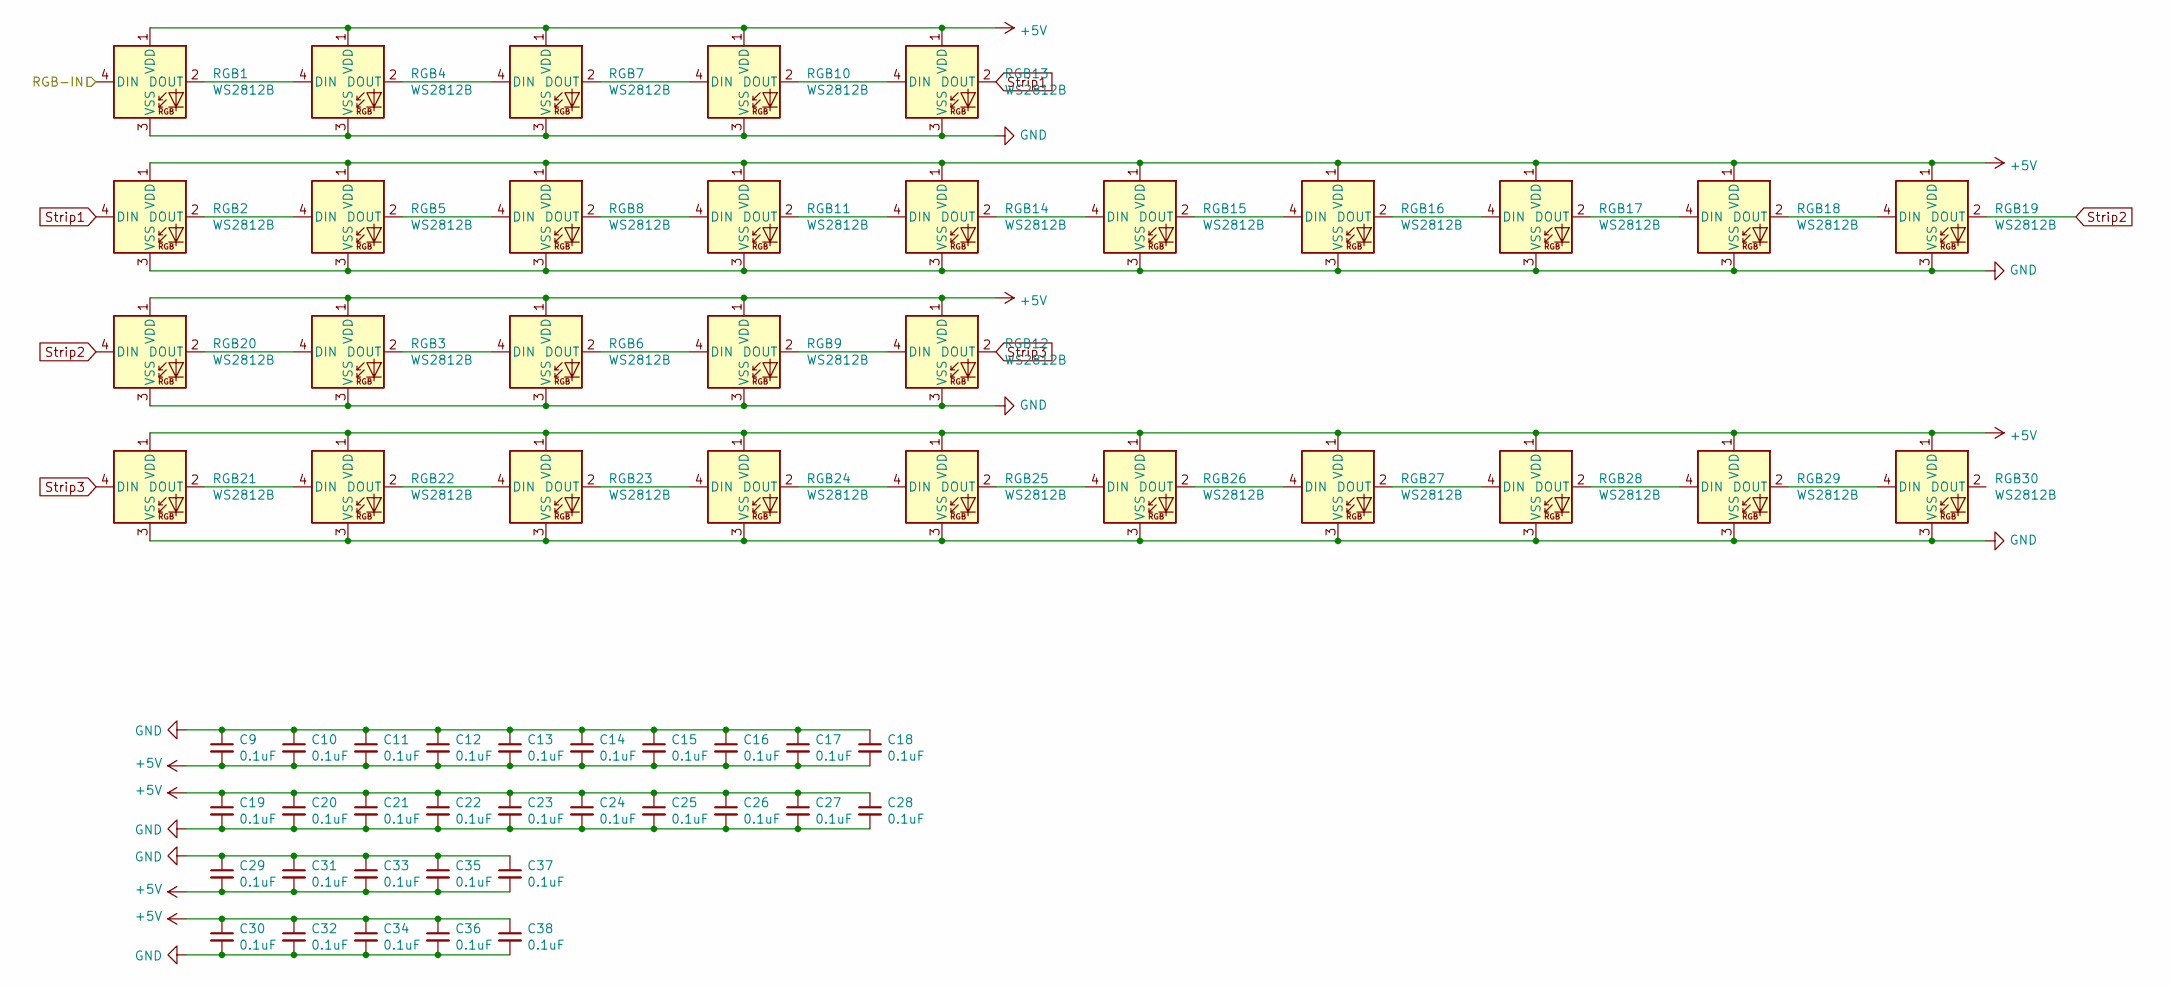
[picture p179: schematic RGB Strip.sch]

Parts:
C9, C10, C11, C12, C13, C14, C15, C16, C17, C18, C19, C20, C21, C22, C23, C24, C25, C26, C27, C28, C29, C30, C31, C32, C33, C34, C35, C36, C37, C38: 0.1uF; C_0603
RGB1, RGB2, RGB3, RGB4, RGB5, RGB6, RGB7, RGB8, RGB9, RGB10, RGB11, RGB12, RGB13, RGB14, RGB15, RGB16, RGB17, RGB18, RGB19, RGB20, RGB21, RGB22, RGB23, RGB24, RGB25, RGB26, RGB27, RGB28, RGB29, RGB30: WS2812B; LED_SK6812MINI_PLCC4_3.5x3.5mm_P1.75mm

Connections:
+5V: C9.2, C10.2, C11.2, C12.2, C13.2, C14.2, C15.2, C16.2, C17.2, C18.2, C19.1, C20.1, C21.1, C22.1, C23.1, C24.1, C25.1, C26.1, C27.1, C28.1, C29.2, C30.1, C31.2, C32.1, C33.2, C34.1, C35.2, C36.1, C37.2, C38.1, RGB1.1 (VDD), RGB2.1 (VDD), RGB3.1 (VDD), RGB4.1 (VDD), RGB5.1 (VDD), RGB6.1 (VDD), RGB7.1 (VDD), RGB8.1 (VDD), RGB9.1 (VDD), RGB10.1 (VDD), RGB11.1 (VDD), RGB12.1 (VDD), RGB13.1 (VDD), RGB14.1 (VDD), RGB15.1 (VDD), RGB16.1 (VDD), RGB17.1 (VDD), RGB18.1 (VDD), RGB19.1 (VDD), RGB20.1 (VDD), RGB21.1 (VDD), RGB22.1 (VDD), RGB23.1 (VDD), RGB24.1 (VDD), RGB25.1 (VDD), RGB26.1 (VDD), RGB27.1 (VDD), RGB28.1 (VDD), RGB29.1 (VDD), RGB30.1 (VDD); also elsewhere on the board
GND: C9.1, C10.1, C11.1, C12.1, C13.1, C14.1, C15.1, C16.1, C17.1, C18.1, C19.2, C20.2, C21.2, C22.2, C23.2, C24.2, C25.2, C26.2, C27.2, C28.2, C29.1, C30.2, C31.1, C32.2, C33.1, C34.2, C35.1, C36.2, C37.1, C38.2, RGB1.3 (VSS), RGB2.3 (VSS), RGB3.3 (VSS), RGB4.3 (VSS), RGB5.3 (VSS), RGB6.3 (VSS), RGB7.3 (VSS), RGB8.3 (VSS), RGB9.3 (VSS), RGB10.3 (VSS), RGB11.3 (VSS), RGB12.3 (VSS), RGB13.3 (VSS), RGB14.3 (VSS), RGB15.3 (VSS), RGB16.3 (VSS), RGB17.3 (VSS), RGB18.3 (VSS), RGB19.3 (VSS), RGB20.3 (VSS), RGB21.3 (VSS), RGB22.3 (VSS), RGB23.3 (VSS), RGB24.3 (VSS), RGB25.3 (VSS), RGB26.3 (VSS), RGB27.3 (VSS), RGB28.3 (VSS), RGB29.3 (VSS), RGB30.3 (VSS); also elsewhere on the board
unnamed: RGB1.2 (DOUT), RGB4.4 (DIN)
unnamed: RGB2.2 (DOUT), RGB5.4 (DIN)
unnamed: RGB3.2 (DOUT), RGB6.4 (DIN)
unnamed: RGB4.2 (DOUT), RGB7.4 (DIN)
unnamed: RGB5.2 (DOUT), RGB8.4 (DIN)
unnamed: RGB6.2 (DOUT), RGB9.4 (DIN)
unnamed: RGB10.2 (DOUT), RGB13.4 (DIN)
unnamed: RGB7.2 (DOUT), RGB10.4 (DIN)
unnamed: RGB11.2 (DOUT), RGB14.4 (DIN)
unnamed: RGB8.2 (DOUT), RGB11.4 (DIN)
unnamed: RGB9.2 (DOUT), RGB12.4 (DIN)
unnamed: RGB14.2 (DOUT), RGB15.4 (DIN)
unnamed: RGB15.2 (DOUT), RGB16.4 (DIN)
unnamed: RGB16.2 (DOUT), RGB17.4 (DIN)
unnamed: RGB17.2 (DOUT), RGB18.4 (DIN)
unnamed: RGB18.2 (DOUT), RGB19.4 (DIN)
unnamed: RGB3.4 (DIN), RGB20.2 (DOUT)
unnamed: RGB21.2 (DOUT), RGB22.4 (DIN)
unnamed: RGB22.2 (DOUT), RGB23.4 (DIN)
unnamed: RGB23.2 (DOUT), RGB24.4 (DIN)
unnamed: RGB24.2 (DOUT), RGB25.4 (DIN)
unnamed: RGB25.2 (DOUT), RGB26.4 (DIN)
unnamed: RGB26.2 (DOUT), RGB27.4 (DIN)
unnamed: RGB27.2 (DOUT), RGB28.4 (DIN)
unnamed: RGB28.2 (DOUT), RGB29.4 (DIN)
unnamed: RGB29.2 (DOUT), RGB30.4 (DIN)
Strip1: RGB2.4 (DIN), RGB13.2 (DOUT)
Strip2: RGB19.2 (DOUT), RGB20.4 (DIN)
Strip3: RGB12.2 (DOUT), RGB21.4 (DIN)
Underglow: RGB1.4 (DIN); also elsewhere on the board

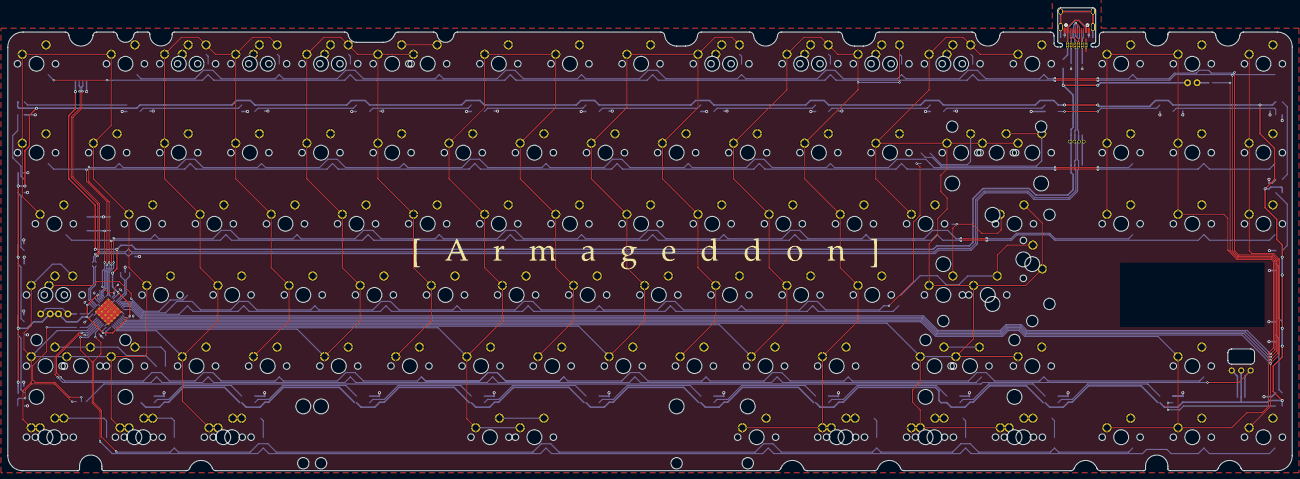
[picture p180: board Solder.kicad_pcb from above]

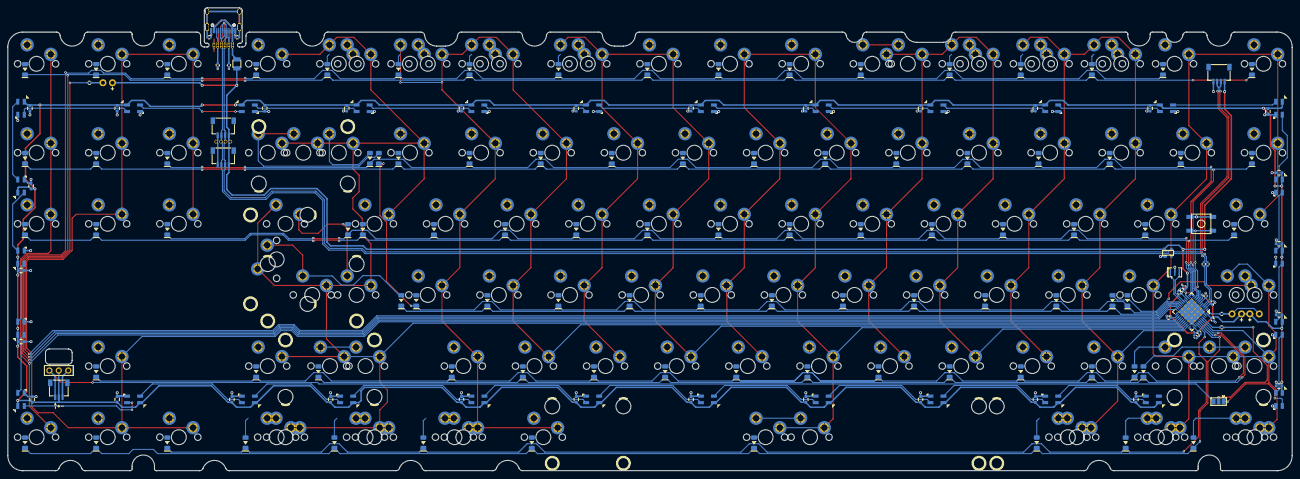
[picture p181: board Solder.kicad_pcb from below]

Board: 2 copper layers, 344.0 x 124.0 mm, 299 parts (181 on the bottom side), 164 nets.
