MaiTheSan/PCB-Design/KiCad/Myprojects/lmao/Konpeko40/Konpeko60.kicad_pcb

## KiCad design KiCad/Myprojects/lmao/Konpeko40/Konpeko60.kicad_pcb (2022-11-19)

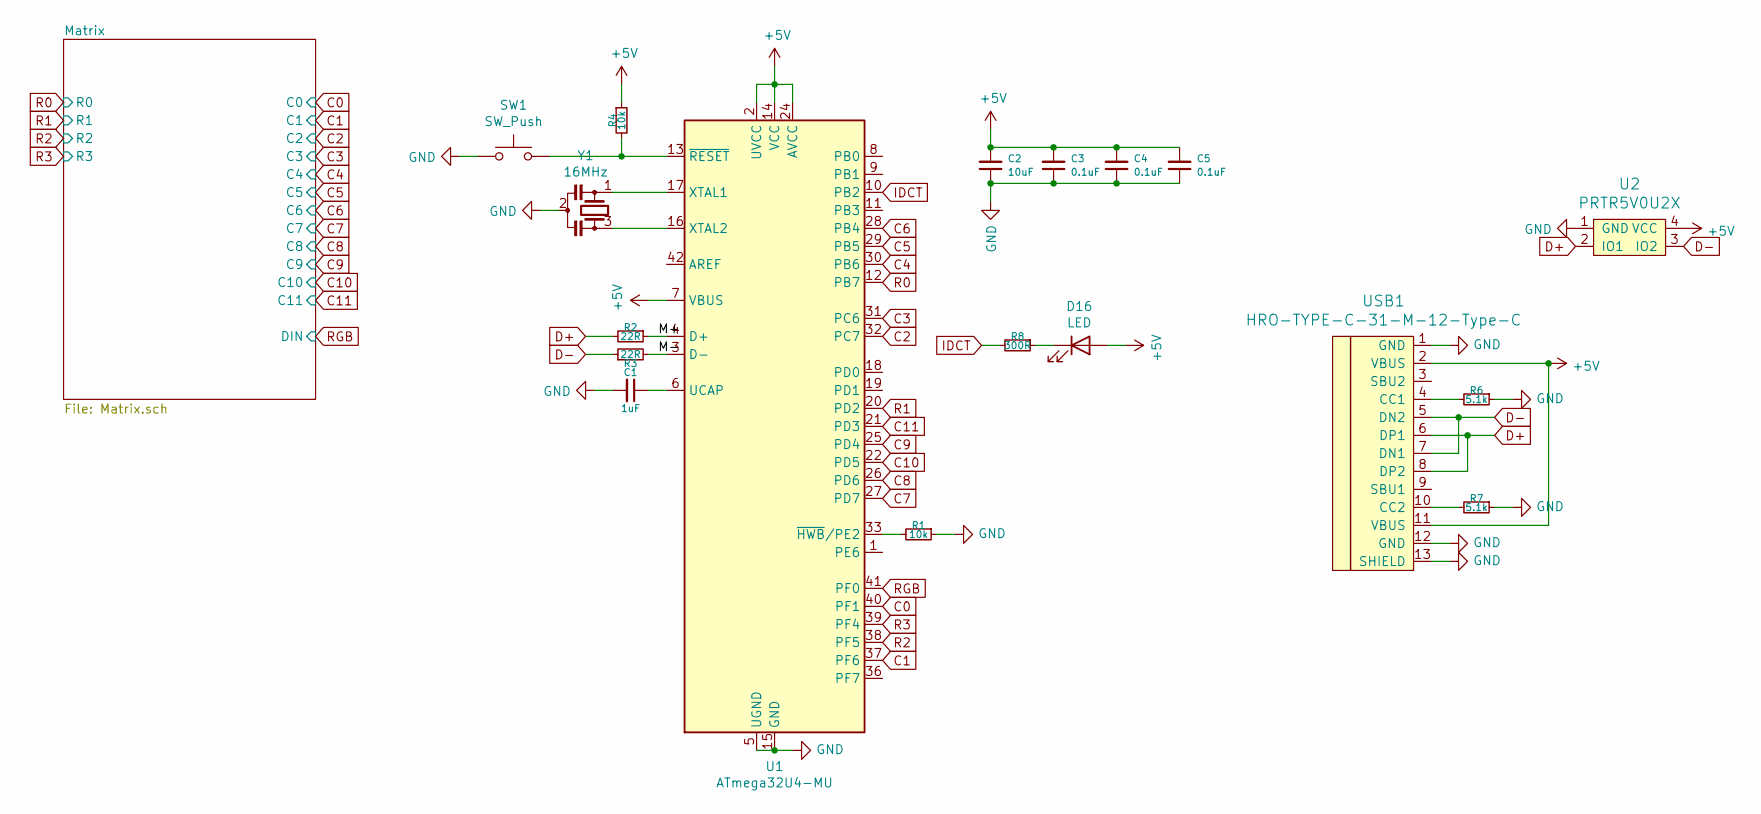
[picture p185: schematic Konpeko60.sch]

Parts:
C1: 1uF; C_0603
C2: 10uF; C_0603
C3, C4, C5: 0.1uF; C_0603
D16: LED; MXOnly-LEDONLY-FLIPPED
R1, R4: 10k; R_0603
R2, R3: 22R; R_0603
R6, R7: 5.1k; R_0603
R8: 300R; R_0603
SW1: SW_Push; SKQG-1155865-fix
U1: ATmega32U4-MU; QFN-44-1EP_7x7mm_P0.5mm_EP5.15x5.15mm_ThermalVias
U2: PRTR5V0U2X; SOT143B
USB1: HRO-TYPE-C-31-M-12-Type-C; HRO-TYPE-C-31-M-12-Assembly
Y1: 16MHz; Resonator_SMD_muRata_CSTxExxV-3Pin_3.0x1.1mm

Connections:
+5V: C2.2, C3.2, C4.2, C5.2, D16.2 (A), R4.1, U1.2 (UVCC), U1.7 (VBUS), U1.14 (VCC), U1.24 (AVCC), U1.34 (VCC), U1.44 (AVCC), U2.4 (VCC), USB1.2 (VBUS), USB1.11 (VBUS); also elsewhere on the board
/M+: R2.1, U1.4 (D+)
/M-: R3.2, U1.3 (D-)
C0: U1.40 (PF1); also elsewhere on the board
C1: U1.37 (PF6); also elsewhere on the board
C2: U1.32 (PC7); also elsewhere on the board
C3: U1.31 (PC6); also elsewhere on the board
C4: U1.30 (PB6); also elsewhere on the board
C5: U1.29 (PB5); also elsewhere on the board
C6: U1.28 (PB4); also elsewhere on the board
C7: U1.27 (PD7); also elsewhere on the board
C8: U1.26 (PD6); also elsewhere on the board
C9: U1.25 (PD4); also elsewhere on the board
C10: U1.22 (PD5); also elsewhere on the board
C11: U1.21 (PD3); also elsewhere on the board
D+: R2.2, U2.2 (IO1), USB1.6 (DP1), USB1.8 (DP2)
D-: R3.1, U2.3 (IO2), USB1.5 (DN2), USB1.7 (DN1)
GND: C1.2, C2.1, C3.1, C4.1, C5.1, R1.1, R6.1, R7.1, SW1.1, U1.5 (UGND), U1.15 (GND), U1.23 (GND), U1.35 (GND), U1.43 (GND), U1.45 (GND), U2.1 (GND), USB1.1 (GND), USB1.12 (GND), USB1.13 (SHIELD), Y1.2; also elsewhere on the board
IDCT: R8.2, U1.10 (PB2)
unnamed: C1.1, U1.6 (UCAP)
unnamed: D16.1 (K), R8.1
unnamed: R1.2, U1.33 (~HWB~/PE2)
unnamed: R4.2, SW1.2, U1.13 (~RESET)
unnamed: R6.2, USB1.4 (CC1)
unnamed: R7.2, USB1.10 (CC2)
unnamed: U1.16 (XTAL2), Y1.3
unnamed: U1.17 (XTAL1), Y1.1
R0: U1.12 (PB7); also elsewhere on the board
R1: U1.20 (PD2); also elsewhere on the board
R2: U1.38 (PF5); also elsewhere on the board
R3: U1.39 (PF4); also elsewhere on the board
RGB: U1.41 (PF0); also elsewhere on the board

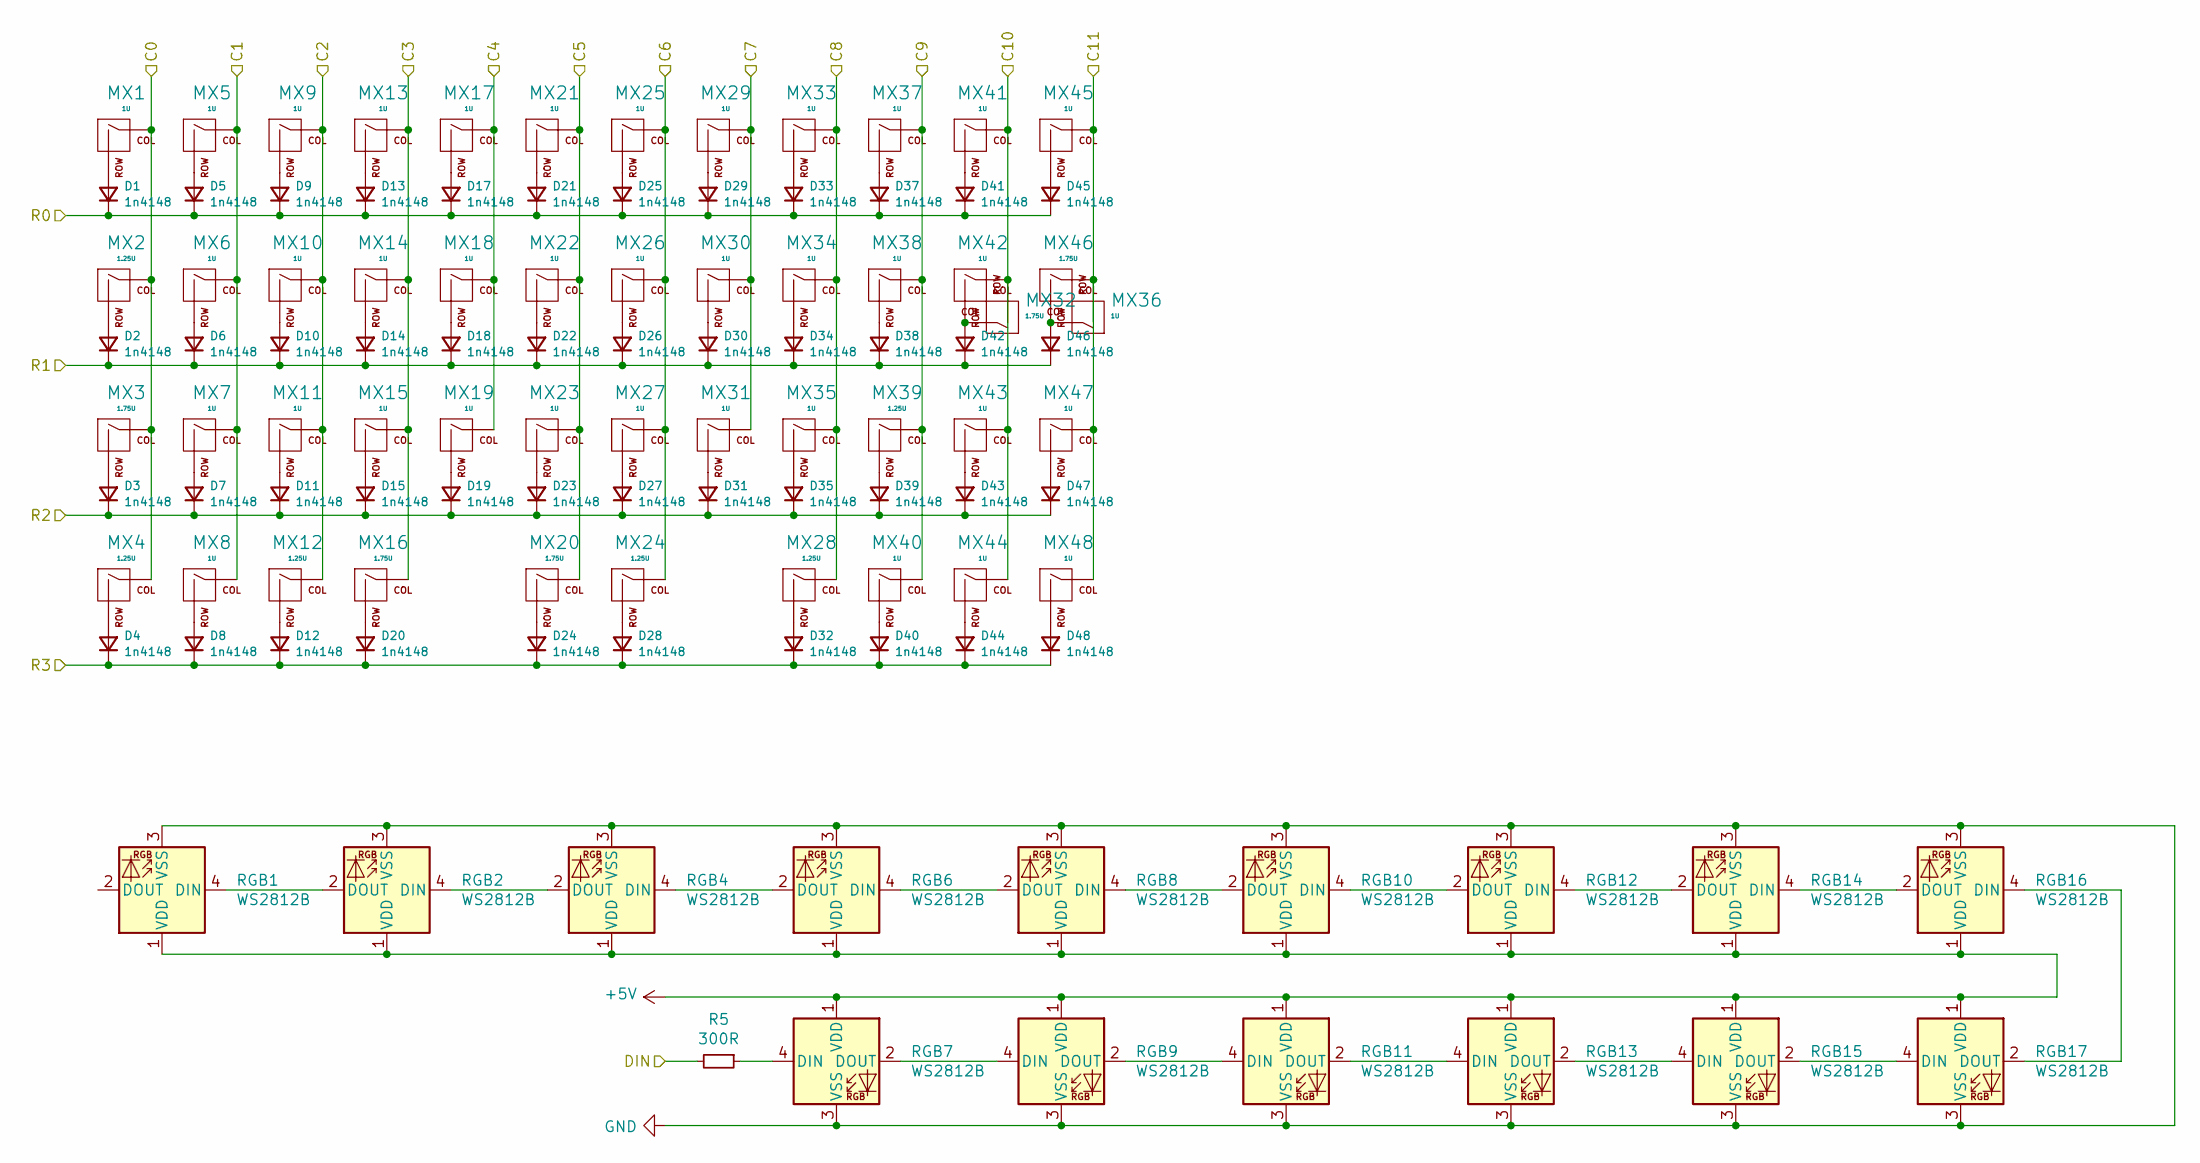
[picture p186: schematic Matrix.sch]

Parts:
D1, D2, D3, D4, D5, D6, D7, D8, D9, D10, D11, D12, D13, D14, D15, D17, D18, D19, D20, D21, D22, D23, D24, D25, D26, D27, D28, D29, D30, D31, D32, D33, D34, D35, D37, D38, D39, D40, D41, D42, D43, D44, D45, D46, D47, D48: 1n4148; DIODE_1206_SawnsProjects
MX1, MX5, MX6, MX7, MX8, MX9, MX10, MX11, MX13, MX14, MX15, MX17, MX18, MX19, MX21, MX22, MX23, MX25, MX26, MX27, MX29, MX30, MX31, MX33, MX34, MX35, MX36, MX37, MX38, MX40, MX41, MX42, MX43, MX44, MX45, MX47, MX48: 1U; MXOnly-1U-NoLED
MX2, MX4, MX12, MX24, MX28, MX39: 1.25U; MXOnly-1.25U-NoLED
MX3, MX16, MX20, MX32, MX46: 1.75U; MXOnly-1.75U-NoLED
R5: 300R; R_0805
RGB1, RGB2, RGB4, RGB6, RGB7, RGB8, RGB9, RGB10, RGB11, RGB12, RGB13, RGB14, RGB15, RGB16, RGB17: WS2812B; LED_WS2812B_PLCC4_5.0x5.0mm_P3.2mm

Connections:
+5V: RGB1.1 (VDD), RGB2.1 (VDD), RGB4.1 (VDD), RGB6.1 (VDD), RGB7.1 (VDD), RGB8.1 (VDD), RGB9.1 (VDD), RGB10.1 (VDD), RGB11.1 (VDD), RGB12.1 (VDD), RGB13.1 (VDD), RGB14.1 (VDD), RGB15.1 (VDD), RGB16.1 (VDD), RGB17.1 (VDD); also elsewhere on the board
C0: MX1.1 (COL), MX2.1 (COL), MX3.1 (COL), MX4.1 (COL); also elsewhere on the board
C1: MX5.1 (COL), MX6.1 (COL), MX7.1 (COL), MX8.1 (COL); also elsewhere on the board
C2: MX9.1 (COL), MX10.1 (COL), MX11.1 (COL), MX12.1 (COL); also elsewhere on the board
C3: MX13.1 (COL), MX14.1 (COL), MX15.1 (COL), MX16.1 (COL); also elsewhere on the board
C4: MX17.1 (COL), MX18.1 (COL), MX19.1 (COL); also elsewhere on the board
C5: MX20.1 (COL), MX21.1 (COL), MX22.1 (COL), MX23.1 (COL); also elsewhere on the board
C6: MX24.1 (COL), MX25.1 (COL), MX26.1 (COL), MX27.1 (COL); also elsewhere on the board
C7: MX29.1 (COL), MX30.1 (COL), MX31.1 (COL); also elsewhere on the board
C8: MX28.1 (COL), MX33.1 (COL), MX34.1 (COL), MX35.1 (COL); also elsewhere on the board
C9: MX37.1 (COL), MX38.1 (COL), MX39.1 (COL), MX40.1 (COL); also elsewhere on the board
C10: MX32.2 (ROW), MX41.1 (COL), MX42.1 (COL), MX43.1 (COL), MX44.1 (COL); also elsewhere on the board
C11: MX36.2 (ROW), MX45.1 (COL), MX46.1 (COL), MX47.1 (COL), MX48.1 (COL); also elsewhere on the board
GND: RGB1.3 (VSS), RGB2.3 (VSS), RGB4.3 (VSS), RGB6.3 (VSS), RGB7.3 (VSS), RGB8.3 (VSS), RGB9.3 (VSS), RGB10.3 (VSS), RGB11.3 (VSS), RGB12.3 (VSS), RGB13.3 (VSS), RGB14.3 (VSS), RGB15.3 (VSS), RGB16.3 (VSS), RGB17.3 (VSS); also elsewhere on the board
unnamed: D1.2 (A), MX1.2 (ROW)
unnamed: D2.2 (A), MX2.2 (ROW)
unnamed: D3.2 (A), MX3.2 (ROW)
unnamed: D4.2 (A), MX4.2 (ROW)
unnamed: D5.2 (A), MX5.2 (ROW)
unnamed: D6.2 (A), MX6.2 (ROW)
unnamed: D7.2 (A), MX7.2 (ROW)
unnamed: D8.2 (A), MX8.2 (ROW)
unnamed: D9.2 (A), MX9.2 (ROW)
unnamed: D10.2 (A), MX10.2 (ROW)
unnamed: D11.2 (A), MX11.2 (ROW)
unnamed: D12.2 (A), MX12.2 (ROW)
unnamed: D13.2 (A), MX13.2 (ROW)
unnamed: D14.2 (A), MX14.2 (ROW)
unnamed: D15.2 (A), MX15.2 (ROW)
unnamed: D17.2 (A), MX17.2 (ROW)
unnamed: D18.2 (A), MX18.2 (ROW)
unnamed: D19.2 (A), MX19.2 (ROW)
unnamed: D20.2 (A), MX16.2 (ROW)
unnamed: D21.2 (A), MX21.2 (ROW)
unnamed: D22.2 (A), MX22.2 (ROW)
unnamed: D23.2 (A), MX23.2 (ROW)
unnamed: D24.2 (A), MX20.2 (ROW)
unnamed: D25.2 (A), MX25.2 (ROW)
unnamed: D26.2 (A), MX26.2 (ROW)
unnamed: D27.2 (A), MX27.2 (ROW)
unnamed: D28.2 (A), MX24.2 (ROW)
unnamed: D29.2 (A), MX29.2 (ROW)
unnamed: D30.2 (A), MX30.2 (ROW)
unnamed: D31.2 (A), MX31.2 (ROW)
unnamed: D32.2 (A), MX28.2 (ROW)
unnamed: D33.2 (A), MX33.2 (ROW)
unnamed: D34.2 (A), MX34.2 (ROW)
unnamed: D35.2 (A), MX35.2 (ROW)
unnamed: D37.2 (A), MX37.2 (ROW)
unnamed: D38.2 (A), MX38.2 (ROW)
unnamed: D39.2 (A), MX39.2 (ROW)
unnamed: D40.2 (A), MX40.2 (ROW)
unnamed: D41.2 (A), MX41.2 (ROW)
unnamed: D42.2 (A), MX32.1 (COL), MX42.2 (ROW)
unnamed: D43.2 (A), MX43.2 (ROW)
unnamed: D44.2 (A), MX44.2 (ROW)
unnamed: D45.2 (A), MX45.2 (ROW)
unnamed: D46.2 (A), MX36.1 (COL), MX46.2 (ROW)
unnamed: D47.2 (A), MX47.2 (ROW)
unnamed: D48.2 (A), MX48.2 (ROW)
unnamed: R5.1, RGB7.4 (DIN)
unnamed: RGB1.4 (DIN), RGB2.2 (DOUT)
unnamed: RGB2.4 (DIN), RGB4.2 (DOUT)
unnamed: RGB4.4 (DIN), RGB6.2 (DOUT)
unnamed: RGB6.4 (DIN), RGB8.2 (DOUT)
unnamed: RGB7.2 (DOUT), RGB9.4 (DIN)
unnamed: RGB8.4 (DIN), RGB10.2 (DOUT)
unnamed: RGB10.4 (DIN), RGB12.2 (DOUT)
unnamed: RGB11.2 (DOUT), RGB13.4 (DIN)
unnamed: RGB9.2 (DOUT), RGB11.4 (DIN)
unnamed: RGB12.4 (DIN), RGB14.2 (DOUT)
unnamed: RGB13.2 (DOUT), RGB15.4 (DIN)
unnamed: RGB14.4 (DIN), RGB16.2 (DOUT)
unnamed: RGB15.2 (DOUT), RGB17.4 (DIN)
unnamed: RGB16.4 (DIN), RGB17.2 (DOUT)
R0: D1.1 (K), D5.1 (K), D9.1 (K), D13.1 (K), D17.1 (K), D21.1 (K), D25.1 (K), D29.1 (K), D33.1 (K), D37.1 (K), D41.1 (K), D45.1 (K); also elsewhere on the board
R1: D2.1 (K), D6.1 (K), D10.1 (K), D14.1 (K), D18.1 (K), D22.1 (K), D26.1 (K), D30.1 (K), D34.1 (K), D38.1 (K), D42.1 (K), D46.1 (K); also elsewhere on the board
R2: D3.1 (K), D7.1 (K), D11.1 (K), D15.1 (K), D19.1 (K), D23.1 (K), D27.1 (K), D31.1 (K), D35.1 (K), D39.1 (K), D43.1 (K), D47.1 (K); also elsewhere on the board
R3: D4.1 (K), D8.1 (K), D12.1 (K), D20.1 (K), D24.1 (K), D28.1 (K), D32.1 (K), D40.1 (K), D44.1 (K), D48.1 (K); also elsewhere on the board
RGB: R5.2; also elsewhere on the board

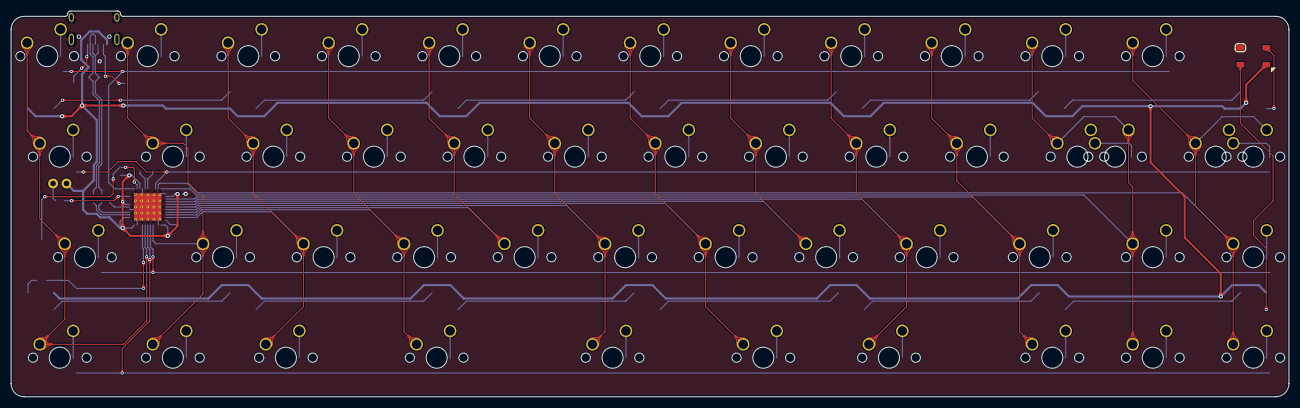
[picture p187: board Konpeko60.kicad_pcb from above]

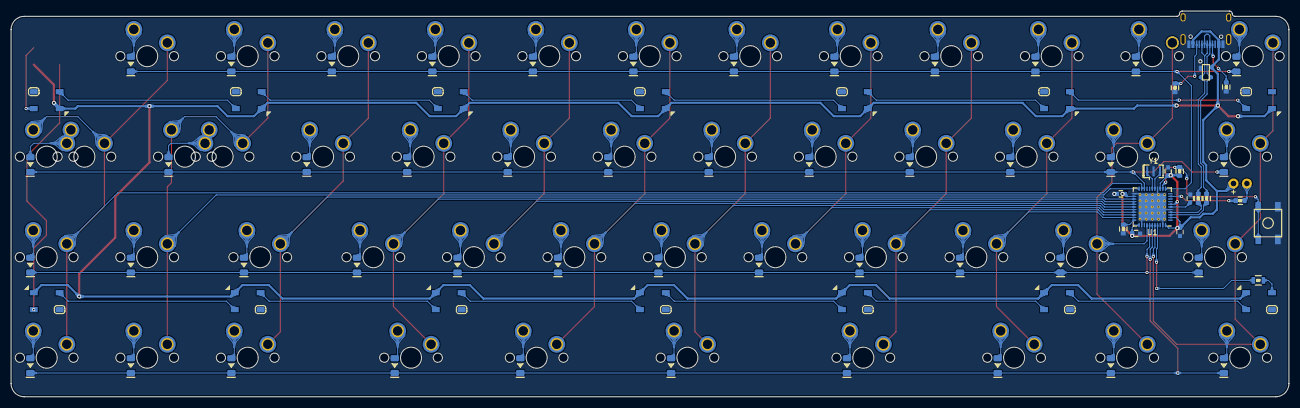
[picture p188: board Konpeko60.kicad_pcb from below]

Board: 2 copper layers, 242.2 x 73.1 mm, 128 parts (78 on the bottom side), 93 nets.
