MaiTheSan/PCB-Design/KiCad/1-2022/NK65/NK65.kicad_pcb

## KiCad design KiCad/1-2022/NK65/NK65.kicad_pcb (2022-11-19)

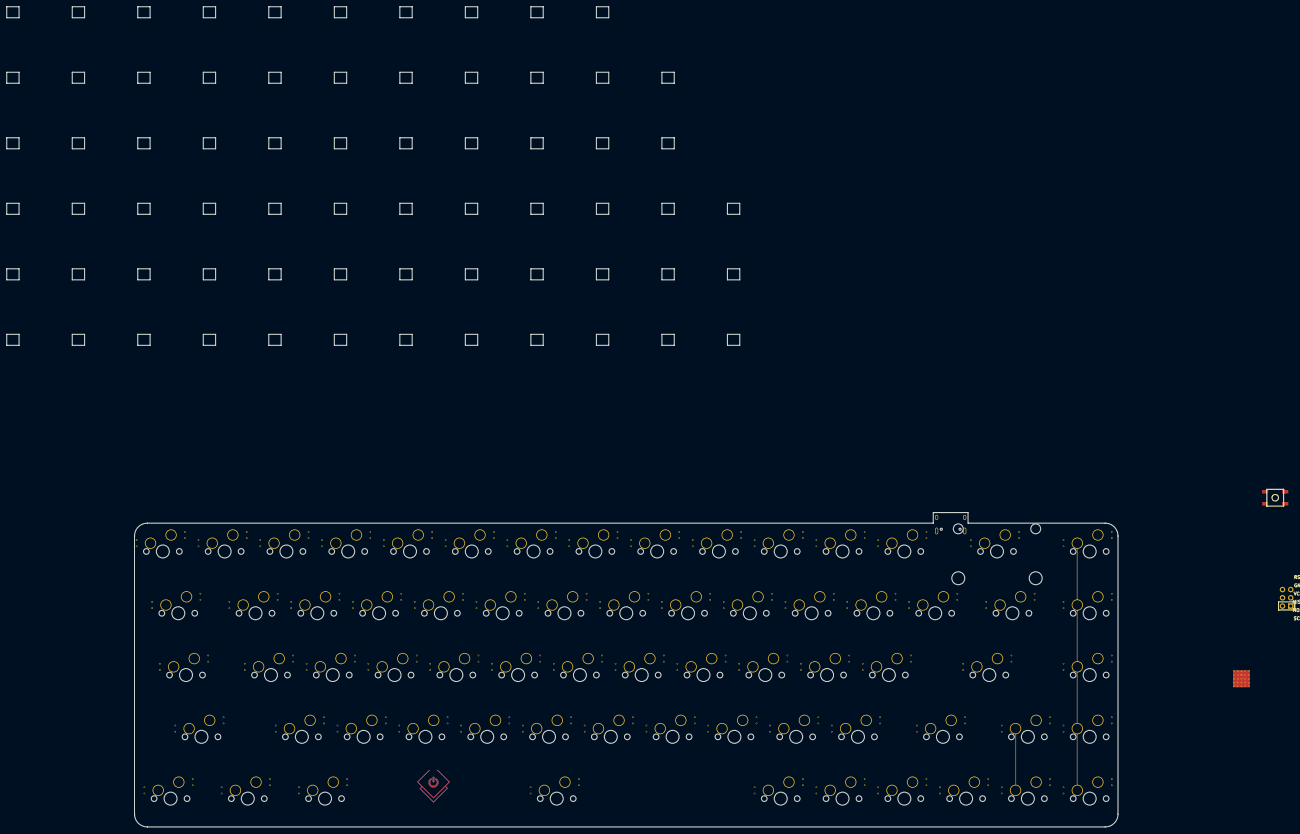
[picture p189: board NK65.kicad_pcb from above]

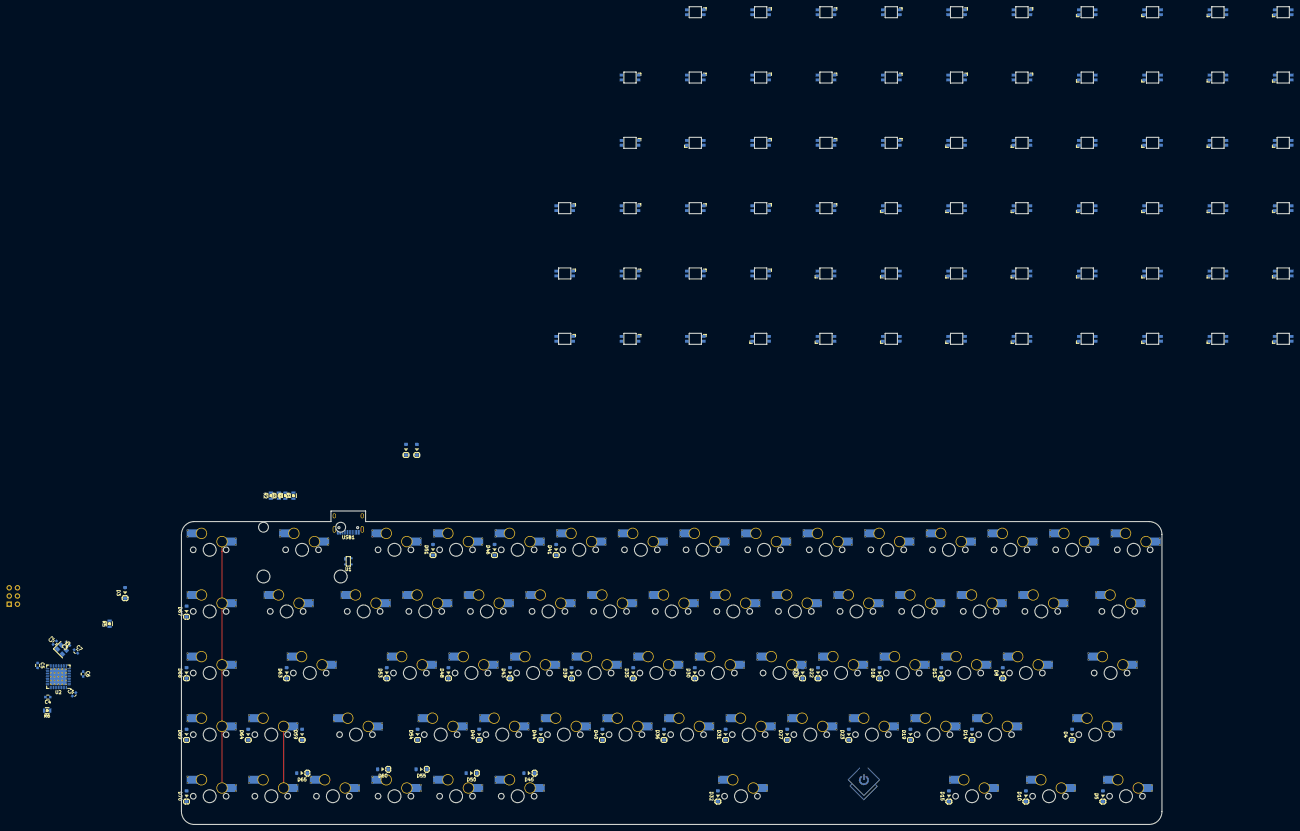
[picture p190: board NK65.kicad_pcb from below]

Board: 2 copper layers, 342.6 x 252.9 mm, 200 parts (129 on the bottom side), 146 nets.

Parts:
C1: 10uF; C_0603
C2, C3: 22pF; C_0603
C4, C5, C7: 0.1uF; C_0603
C6: 1uF; C_0603
D3, D4, D5, D8, D10, D13, D14, D15, D18, D19, D22, D23, D26, D27, D30, D31, D32, D33, D35, D36, D37, D39, D40, D41, D43, D44, D45, D46, D48, D49, D50, D51, D53, D54, D55, D59, D60, D63, D64, D65, D67, D68, D69, D70: D; D_SOD-123
LOGO1: Logo_Open_Hardware_Large; sanpjxlogo-PCB-type
MX3, MX4, MX8, MX9, MX10, MX13, MX14, MX15, MX16, MX18, MX19, MX20, MX21, MX22, MX23, MX24, MX25, MX26, MX27, MX28, MX29, MX30, MX31, MX32, MX33, MX35, MX36, MX37, MX38, MX39, MX40, MX41, MX42, MX43, MX44, MX45, MX46, MX47, MX50, MX51, MX52, MX53, MX54, MX56, MX57, MX58, MX59, MX60, MX62, MX63, MX65, MX67, MX70, MX71, MX72, MX73, MX75, MX76, MX77, MX78, MX79: MX-NoLED; MXOnly-1U-Hotswap-Sawns
MX5: MX-.75; MXOnly-1U-Hotswap-Sawns
MX6: MX-2.25; MXOnly-1U-Hotswap-Sawns
MX7, MX12, MX17: MX-1.25; MXOnly-1U-Hotswap-Sawns
MX34: MX-6.25; MXOnly-1U-Hotswap-Sawns
MX80: MX-NoLED; MXOnly-2U-Hotswap-Sawns
R1, R2: 5.1k; R_0805
R3, R4: 22; R_0805
R5: 10k; R_0805
R6: 1k; R_0805
SK6812MiniE1, SK6812MiniE2, SK6812MiniE3, SK6812MiniE4, SK6812MiniE5, SK6812MiniE6, SK6812MiniE7, SK6812MiniE8, SK6812MiniE9, SK6812MiniE10, SK6812MiniE11, SK6812MiniE12, SK6812MiniE13, SK6812MiniE15, SK6812MiniE17, SK6812MiniE18, SK6812MiniE19, SK6812MiniE20, SK6812MiniE21, SK6812MiniE22, SK6812MiniE23, SK6812MiniE24, SK6812MiniE25, SK6812MiniE26, SK6812MiniE27, SK6812MiniE28, SK6812MiniE29, SK6812MiniE30, SK6812MiniE31, SK6812MiniE32, SK6812MiniE33, SK6812MiniE34, SK6812MiniE35, SK6812MiniE36, SK6812MiniE37, SK6812MiniE39, SK6812MiniE41, SK6812MiniE42, SK6812MiniE43: WS2812B; RGB-6028_FLIPPED
SK6812MiniE_F1, SK6812MiniE_F2, SK6812MiniE_F3, SK6812MiniE_F4, SK6812MiniE_F5, SK6812MiniE_F6, SK6812MiniE_F7, SK6812MiniE_F8, SK6812MiniE_F9, SK6812MiniE_F10, SK6812MiniE_F11, SK6812MiniE_F12, SK6812MiniE_F13, SK6812MiniE_F14, SK6812MiniE_F15, SK6812MiniE_F16, SK6812MiniE_F19, SK6812MiniE_F20, SK6812MiniE_F21, SK6812MiniE_F22, SK6812MiniE_F23, SK6812MiniE_F24, SK6812MiniE_F25, SK6812MiniE_F26, SK6812MiniE_F27, SK6812MiniE_F28, SK6812MiniE_F29, SK6812MiniE_F31, SK6812MiniE_F32: WS2812B; RGB-6028
SW1: SW_Push; SKQG-1155865
U1: PRTR5V0U2X; SOT143B
U2: ATmega32U4-MU; QFN-44-1EP_7x7mm_P0.5mm_EP5.2x5.2mm_ThermalVias
U3: STF202-22T1G; Reset_Pretty
USB1: HRO-TYPE-C-31-M-12; HRO-TYPE-C-31-M-12-Assembly
Y1: 16Mhz; Crystal_SMD_3225-4Pin_3.2x2.5mm

Connections:
+5V: C1.2, C4.2, C5.2, C7.2, R5.1, SK6812MiniE1.1, SK6812MiniE2.1, SK6812MiniE3.1, SK6812MiniE4.1, SK6812MiniE5.1, SK6812MiniE6.1, SK6812MiniE7.1, SK6812MiniE8.1, SK6812MiniE9.1, SK6812MiniE10.1, SK6812MiniE11.1, SK6812MiniE12.1, SK6812MiniE13.1, SK6812MiniE15.1, SK6812MiniE17.1, SK6812MiniE18.1, SK6812MiniE19.1, SK6812MiniE20.1, SK6812MiniE21.1, SK6812MiniE22.1, SK6812MiniE23.1, SK6812MiniE24.1, SK6812MiniE25.1, SK6812MiniE26.1, SK6812MiniE27.1, SK6812MiniE28.1, SK6812MiniE29.1, SK6812MiniE30.1, SK6812MiniE31.1, SK6812MiniE32.1, SK6812MiniE33.1, SK6812MiniE34.1, SK6812MiniE35.1, SK6812MiniE36.1, SK6812MiniE37.1, SK6812MiniE39.1, SK6812MiniE41.1, SK6812MiniE42.1, SK6812MiniE43.1, SK6812MiniE_F1.1, SK6812MiniE_F2.1, SK6812MiniE_F3.1, SK6812MiniE_F4.1, SK6812MiniE_F5.1, SK6812MiniE_F6.1, SK6812MiniE_F7.1, SK6812MiniE_F8.1, SK6812MiniE_F9.1, SK6812MiniE_F10.1, SK6812MiniE_F11.1, SK6812MiniE_F12.1, SK6812MiniE_F13.1, SK6812MiniE_F14.1, SK6812MiniE_F15.1, SK6812MiniE_F16.1, SK6812MiniE_F19.1, SK6812MiniE_F20.1, SK6812MiniE_F21.1, SK6812MiniE_F22.1, SK6812MiniE_F23.1, SK6812MiniE_F24.1, SK6812MiniE_F25.1, SK6812MiniE_F26.1, SK6812MiniE_F27.1, SK6812MiniE_F28.1, SK6812MiniE_F29.1, SK6812MiniE_F31.1, SK6812MiniE_F32.1, U1.4, U2.2, U2.7, U2.14, U2.24, U2.34, U2.44, U3.2, USB1.2, USB1.11
COL0: MX3.1, MX4.1, MX5.1, MX6.1, MX7.1, U2.10, U3.4
COL1: MX8.1, MX9.1, MX10.1, MX12.1, U2.29
COL2: MX13.1, MX14.1, MX15.1, MX16.1, MX17.1, U2.39
COL3: MX18.1, MX19.1, MX20.1, MX21.1, U2.32
COL4: MX22.1, MX23.1, MX24.1, MX25.1, U2.28
COL5: MX26.1, MX27.1, MX28.1, MX29.1, U2.31
COL6: MX30.1, MX31.1, MX32.1, MX33.1, MX34.1, U2.27
COL7: MX35.1, MX36.1, MX37.1, MX38.1, U2.26
COL8: MX39.1, MX40.1, MX41.1, MX42.1, U2.25
COL9: MX43.1, MX44.1, MX45.1, MX46.1, MX47.1, U2.22
COL10: MX50.1, MX51.1, MX52.1, MX53.1, MX54.1, U2.21
COL11: MX56.1, MX57.1, MX58.1, MX59.1, MX60.1, U2.20
COL12: MX62.1, MX63.1, MX65.1, MX67.1, U2.30
COL13: MX70.1, MX71.1, MX72.1, MX73.1, MX80.1, U2.19
COL14: MX75.1, MX76.1, MX77.1, MX78.1, MX79.1, U2.18
D+: R3.1, U2.4
D-: R4.1, U2.3
GND: C1.1, C2.2, C3.2, C4.1, C5.1, C6.2, C7.1, R1.1, R2.1, R6.1, SK6812MiniE1.3, SK6812MiniE2.3, SK6812MiniE3.3, SK6812MiniE4.3, SK6812MiniE5.3, SK6812MiniE6.3, SK6812MiniE7.3, SK6812MiniE8.3, SK6812MiniE9.3, SK6812MiniE10.3, SK6812MiniE11.3, SK6812MiniE12.3, SK6812MiniE13.3, SK6812MiniE15.3, SK6812MiniE17.3, SK6812MiniE18.3, SK6812MiniE19.3, SK6812MiniE20.3, SK6812MiniE21.3, SK6812MiniE22.3, SK6812MiniE23.3, SK6812MiniE24.3, SK6812MiniE25.3, SK6812MiniE26.3, SK6812MiniE27.3, SK6812MiniE28.3, SK6812MiniE29.3, SK6812MiniE30.3, SK6812MiniE31.3, SK6812MiniE32.3, SK6812MiniE33.3, SK6812MiniE34.3, SK6812MiniE35.3, SK6812MiniE36.3, SK6812MiniE37.3, SK6812MiniE39.3, SK6812MiniE41.3, SK6812MiniE42.3, SK6812MiniE43.3, SK6812MiniE_F1.3, SK6812MiniE_F2.3, SK6812MiniE_F3.3, SK6812MiniE_F4.3, SK6812MiniE_F5.3, SK6812MiniE_F6.3, SK6812MiniE_F7.3, SK6812MiniE_F8.3, SK6812MiniE_F9.3, SK6812MiniE_F10.3, SK6812MiniE_F11.3, SK6812MiniE_F12.3, SK6812MiniE_F13.3, SK6812MiniE_F14.3, SK6812MiniE_F15.3, SK6812MiniE_F16.3, SK6812MiniE_F19.3, SK6812MiniE_F20.3, SK6812MiniE_F21.3, SK6812MiniE_F22.3, SK6812MiniE_F23.3, SK6812MiniE_F24.3, SK6812MiniE_F25.3, SK6812MiniE_F26.3, SK6812MiniE_F27.3, SK6812MiniE_F28.3, SK6812MiniE_F29.3, SK6812MiniE_F31.3, SK6812MiniE_F32.3, SW1.1, U1.1, U2.5, U2.15, U2.23, U2.35, U2.43, U2.45, U3.6, USB1.1, USB1.12, USB1.13, Y1.2, Y1.4
MISO: U2.11, U3.1
unnamed: C2.1, U2.17, Y1.1
unnamed: C3.1, U2.16, Y1.3
unnamed: C6.1, U2.6
unnamed: D3.2, MX5.2
unnamed: D4.2, MX6.2
unnamed: D5.2, MX7.2
unnamed: D8.2, MX10.2
unnamed: D10.2, MX12.2
unnamed: D13.2, MX15.2
unnamed: D14.2, MX16.2
unnamed: D15.2, MX17.2
unnamed: D18.2, MX20.2
unnamed: D19.2, MX21.2
unnamed: D22.2, MX24.2
unnamed: D23.2, MX25.2
unnamed: D26.2, MX28.2
unnamed: D27.2, MX29.2
unnamed: D30.2, MX32.2
unnamed: D31.2, MX33.2
unnamed: D32.2, MX34.2
unnamed: D33.2, MX35.2
unnamed: D35.2, MX37.2
unnamed: D36.2, MX38.2
unnamed: D37.2, MX39.2
unnamed: D39.2, MX41.2
unnamed: D40.2, MX42.2
unnamed: D41.2, MX43.2
unnamed: D43.2, MX45.2
unnamed: D44.2, MX46.2
unnamed: D45.2, MX47.2
unnamed: D46.2, MX50.2
unnamed: D48.2, MX52.2
unnamed: D49.2, MX53.2
unnamed: D50.2, MX54.2
unnamed: D51.2, MX56.2
unnamed: D53.2, MX58.2
unnamed: D54.2, MX59.2
unnamed: D55.2, MX60.2
unnamed: D59.2, MX65.2
unnamed: D60.2, MX67.2
unnamed: D63.2, MX71.2
unnamed: D64.2, MX72.2
unnamed: D65.2, MX73.2
unnamed: D67.2, MX76.2
unnamed: D68.2, MX77.2
unnamed: D69.2, MX78.2
unnamed: D70.2, MX79.2
unnamed: R1.2, USB1.4
unnamed: R2.2, USB1.10
unnamed: R3.2, U1.2, USB1.6, USB1.8
unnamed: R4.2, U1.3, USB1.5, USB1.7
unnamed: R6.2, U2.33
unnamed: SK6812MiniE1.2, SK6812MiniE2.4
unnamed: SK6812MiniE2.2, SK6812MiniE3.4
unnamed: SK6812MiniE3.2, SK6812MiniE4.4
unnamed: SK6812MiniE4.2, SK6812MiniE5.4
unnamed: SK6812MiniE5.2, SK6812MiniE6.4
unnamed: SK6812MiniE6.2, SK6812MiniE7.4
unnamed: SK6812MiniE7.2, SK6812MiniE8.4
unnamed: SK6812MiniE8.2, SK6812MiniE9.4
unnamed: SK6812MiniE10.2, SK6812MiniE11.4
unnamed: SK6812MiniE9.2, SK6812MiniE10.4
unnamed: SK6812MiniE11.2, SK6812MiniE12.4
unnamed: SK6812MiniE12.2, SK6812MiniE13.4
unnamed: SK6812MiniE13.2, SK6812MiniE15.4
unnamed: SK6812MiniE15.2, SK6812MiniE17.4
unnamed: SK6812MiniE17.2, SK6812MiniE_F15.4
unnamed: SK6812MiniE18.2, SK6812MiniE19.4
unnamed: SK6812MiniE18.4, SK6812MiniE_F1.2
unnamed: SK6812MiniE19.2, SK6812MiniE20.4
unnamed: SK6812MiniE20.2, SK6812MiniE21.4
unnamed: SK6812MiniE21.2, SK6812MiniE22.4
unnamed: SK6812MiniE22.2, SK6812MiniE23.4
unnamed: SK6812MiniE23.2, SK6812MiniE24.4
unnamed: SK6812MiniE24.2, SK6812MiniE25.4
unnamed: SK6812MiniE25.2, SK6812MiniE26.4
unnamed: SK6812MiniE26.2, SK6812MiniE27.4
unnamed: SK6812MiniE27.2, SK6812MiniE28.4
unnamed: SK6812MiniE28.2, SK6812MiniE29.4
unnamed: SK6812MiniE29.2, SK6812MiniE30.4
unnamed: SK6812MiniE30.2, SK6812MiniE31.4
unnamed: SK6812MiniE31.2, SK6812MiniE_F32.4
unnamed: SK6812MiniE32.2, SK6812MiniE33.4
unnamed: SK6812MiniE32.4, SK6812MiniE_F16.2
unnamed: SK6812MiniE33.2, SK6812MiniE34.4
unnamed: SK6812MiniE34.2, SK6812MiniE35.4
unnamed: SK6812MiniE35.2, SK6812MiniE36.4
unnamed: SK6812MiniE36.2, SK6812MiniE37.4
unnamed: SK6812MiniE37.2, SK6812MiniE39.4
unnamed: SK6812MiniE39.2, SK6812MiniE41.4
unnamed: SK6812MiniE41.2, SK6812MiniE42.4
unnamed: SK6812MiniE42.2, SK6812MiniE43.4
unnamed: SK6812MiniE_F1.4, SK6812MiniE_F2.2
unnamed: SK6812MiniE_F2.4, SK6812MiniE_F3.2
unnamed: SK6812MiniE_F3.4, SK6812MiniE_F4.2
unnamed: SK6812MiniE_F4.4, SK6812MiniE_F5.2
unnamed: SK6812MiniE_F5.4, SK6812MiniE_F6.2
unnamed: SK6812MiniE_F6.4, SK6812MiniE_F7.2
unnamed: SK6812MiniE_F7.4, SK6812MiniE_F8.2
unnamed: SK6812MiniE_F8.4, SK6812MiniE_F9.2
unnamed: SK6812MiniE_F9.4, SK6812MiniE_F10.2
unnamed: SK6812MiniE_F10.4, SK6812MiniE_F11.2
unnamed: SK6812MiniE_F11.4, SK6812MiniE_F12.2
unnamed: SK6812MiniE_F12.4, SK6812MiniE_F13.2
unnamed: SK6812MiniE_F13.4, SK6812MiniE_F14.2
unnamed: SK6812MiniE_F14.4, SK6812MiniE_F15.2
unnamed: SK6812MiniE_F16.4, SK6812MiniE_F19.2
unnamed: SK6812MiniE_F19.4, SK6812MiniE_F20.2
unnamed: SK6812MiniE_F20.4, SK6812MiniE_F21.2
unnamed: SK6812MiniE_F21.4, SK6812MiniE_F22.2
unnamed: SK6812MiniE_F22.4, SK6812MiniE_F23.2
unnamed: SK6812MiniE_F23.4, SK6812MiniE_F24.2
unnamed: SK6812MiniE_F24.4, SK6812MiniE_F25.2
unnamed: SK6812MiniE_F25.4, SK6812MiniE_F26.2
unnamed: SK6812MiniE_F26.4, SK6812MiniE_F27.2
unnamed: SK6812MiniE_F27.4, SK6812MiniE_F28.2
unnamed: SK6812MiniE_F28.4, SK6812MiniE_F29.2
unnamed: SK6812MiniE_F29.4, SK6812MiniE_F31.2
unnamed: SK6812MiniE_F31.4, SK6812MiniE_F32.2
RGBLED: SK6812MiniE1.4, U2.12
ROW0: D33.1, D37.1, D41.1, D46.1, D51.1, U2.38
ROW1: D67.1, U2.37
ROW2: D3.1, D8.1, D13.1, D18.1, D22.1, D26.1, D30.1, D35.1, D39.1, D43.1, D48.1, D53.1, D63.1, D68.1, U2.41
ROW3: D4.1, D14.1, D19.1, D23.1, D27.1, D31.1, D36.1, D40.1, D44.1, D49.1, D54.1, D59.1, D64.1, D69.1, U2.40
ROW4: D5.1, D10.1, D15.1, D32.1, D45.1, D50.1, D55.1, D60.1, D65.1, D70.1, U2.9, U3.3
RST: R5.2, SW1.2, U2.13, U3.5
