MaiTheSan/PCB-Design/KiCad/06-2021 comm/YoakePadv2/numbowl.kicad_pcb

## KiCad design KiCad/06-2021 comm/YoakePadv2/numbowl.kicad_pcb (2022-11-19)

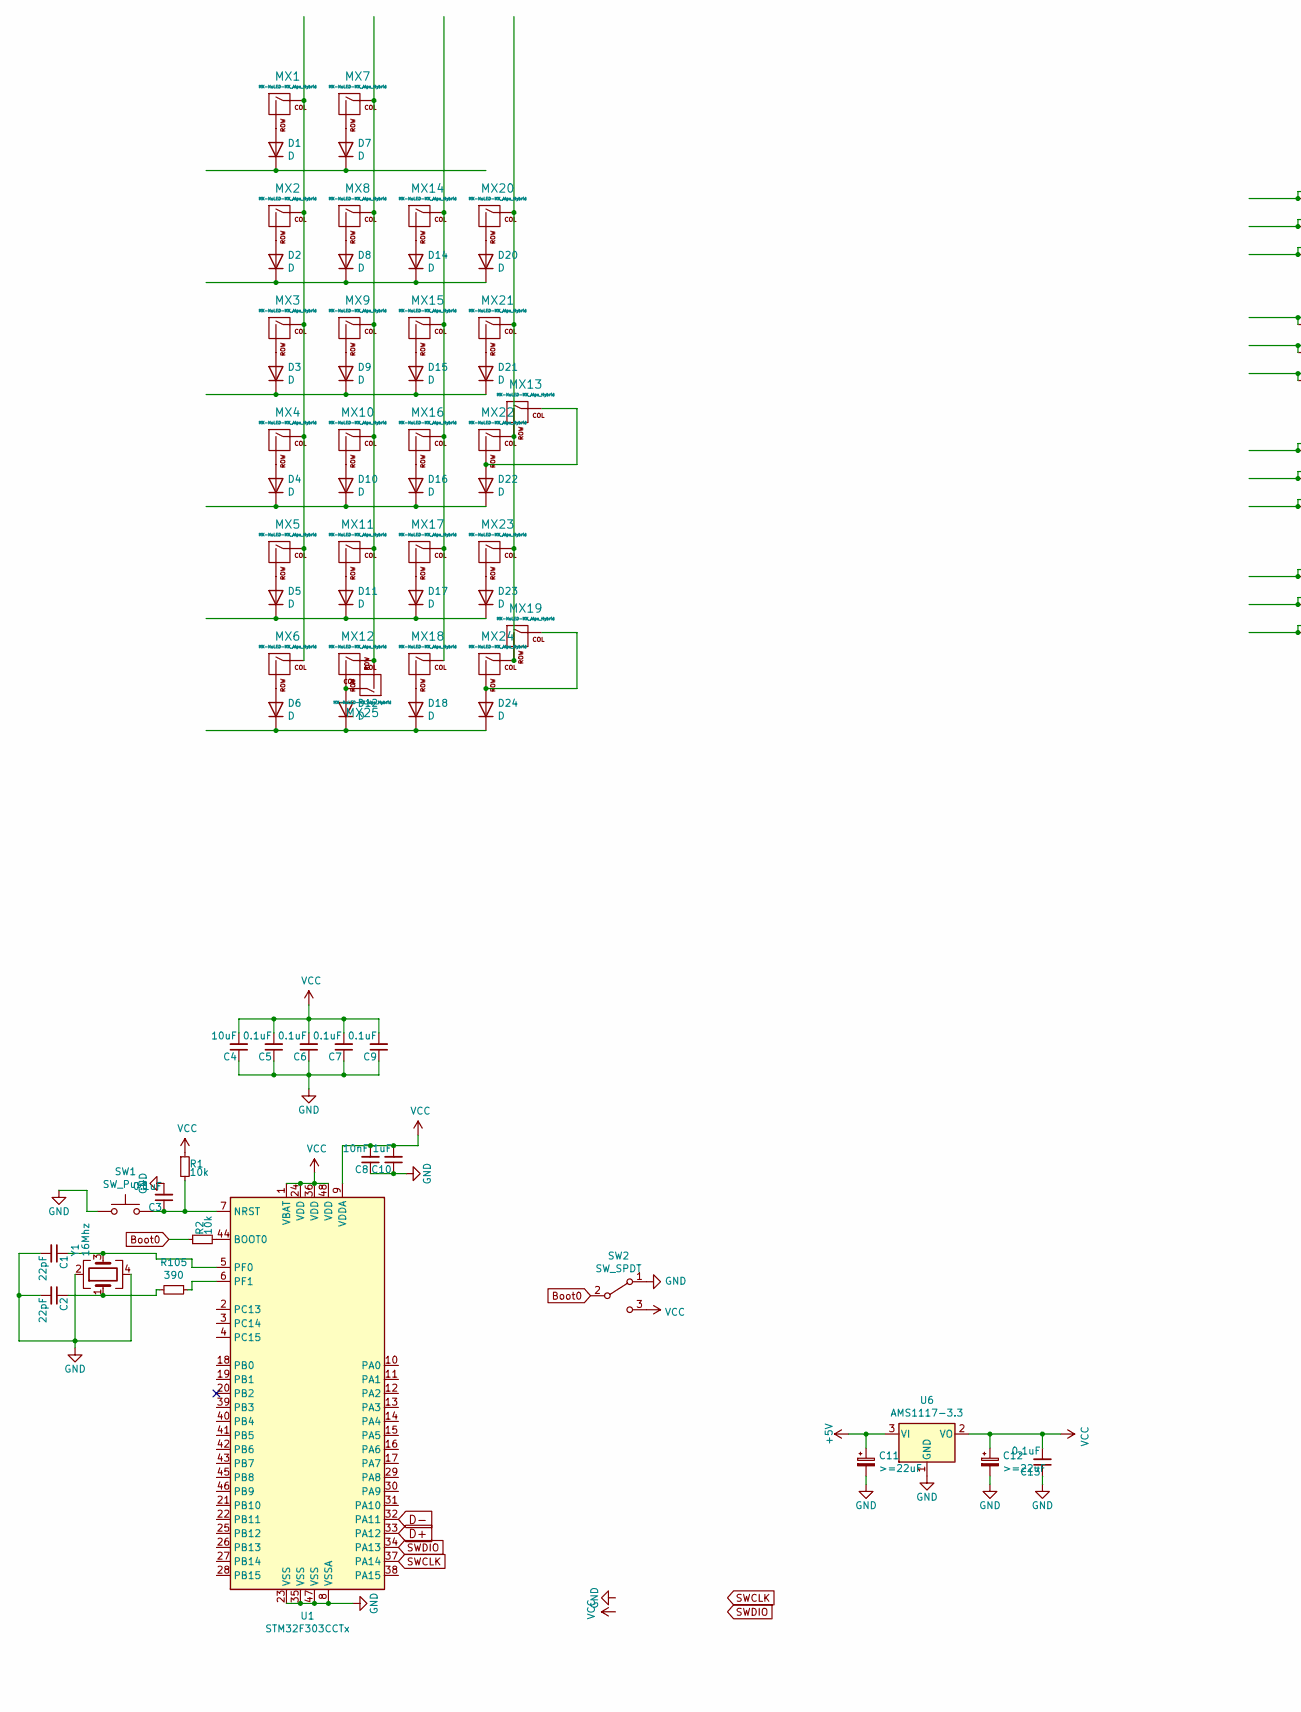
[picture p191: schematic numbowl.sch, part in row 1, column 1]

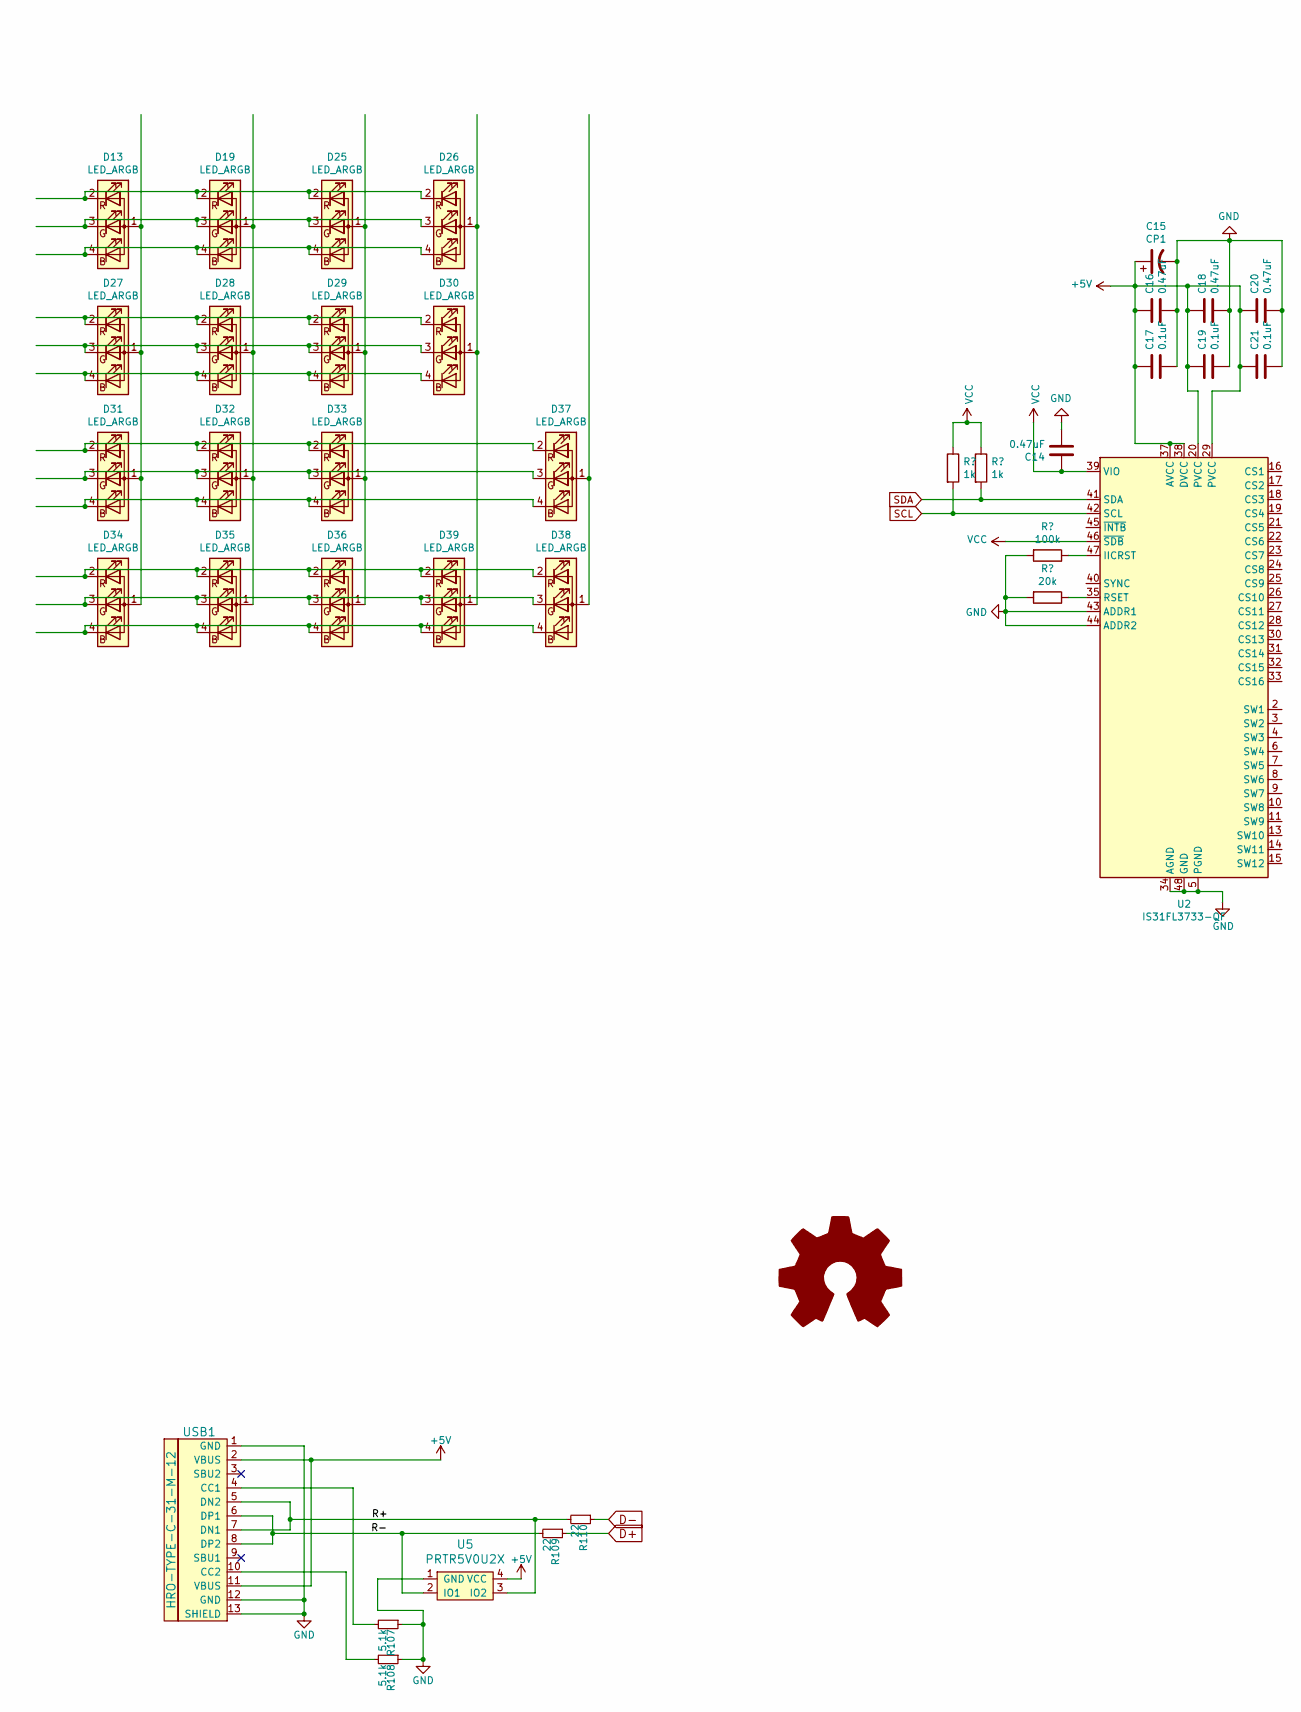
[picture p192: schematic numbowl.sch, part in row 1, column 2]

Parts:
C1, C2: 22pF; C_0603
C3, C5, C6, C7, C9, C13: 0.1uF; C_0603
C4: 10uF; C_0603
C8: 10nF; C_0603
C10: 1uF; C_0603
C11, C12: >=22uF; CP_EIA-3216-12_Kemet-S
C14, C16, C18, C20: 0.47uF
C15: CP1
C17, C19, C21: 0.1uF
D1, D2, D3, D4, D5, D6, D7, D8, D9, D10, D11, D12, D14, D15, D16, D17, D18, D20, D21, D22, D23, D24: D; D_SOD-123
D13, D19, D25, D26, D27, D28, D29, D30, D31, D32, D33, D34, D35, D36, D37, D38, D39: LED_ARGB; RGB-D-6028
LOGO1: Logo_Open_Hardware_Large; sanpjxlogo
MX1, MX2, MX3, MX4, MX5, MX6, MX7, MX8, MX9, MX10, MX11, MX12, MX14, MX15, MX16, MX17, MX18, MX20, MX21, MX22, MX23, MX24: MX-NoLED-MX_Alps_Hybrid; MXOnly-1U-NoLED
MX13, MX19: MX-NoLED-MX_Alps_Hybrid; MXOnly-2U-NoLED
MX25: MX-NoLED-MX_Alps_Hybrid; MXOnly-2U-ReversedStabilizers-NoLED
R1, R2: 10k; R_0805
R105: 390; R_0805
R107, R108: 5.1k; R_0805
R109, R110: 22; R_0805
SW1: SW_Push; SKQG-1155865
SW2: SW_SPDT; SW_SPDT_PCM12
U1: STM32F303CCTx; LQFP-48_7x7mm_P0.5mm
U2: IS31FL3733-QF; QFN-48-1EP_6x6mm_P0.4mm_EP4.2x4.2mm
U5: PRTR5V0U2X; SOT143B
U6: AMS1117-3.3; SOT-223-3_TabPin2
USB1: HRO-TYPE-C-31-M-12; HRO-TYPE-C-31-M-12-Assembly
Y1: 16Mhz; Crystal_SMD_3225-4Pin_3.2x2.5mm

Connections:
+5V: C11.1, C15.1, C16.1, C17.1, C18.1, C19.1, C20.1, C21.1, U2.20 (PVCC), U2.29 (PVCC), U2.37 (AVCC), U2.38 (DVCC), U5.4 (VCC), U6.3 (VI), USB1.2 (VBUS), USB1.11 (VBUS)
/R+: R110.2, U5.3 (IO2), USB1.5 (DN2), USB1.7 (DN1)
/R-: R109.2, U5.2 (IO1), USB1.6 (DP1), USB1.8 (DP2)
Boot0: R2.1, SW2.2 (B)
D+: R109.1, U1.33 (PA12)
D-: R110.1, U1.32 (PA11)
unnamed: C1.1, U1.5 (PF0), Y1.3
unnamed: C2.1, R105.2, Y1.1
unnamed: C3.1, R1.2, SW1.2, U1.7 (NRST)
unnamed: D1.1 (K), D7.1 (K)
unnamed: D1.2 (A), MX1.2 (ROW)
unnamed: D2.2 (A), MX2.2 (ROW)
unnamed: D3.2 (A), MX3.2 (ROW)
unnamed: D4.2 (A), MX4.2 (ROW)
unnamed: D5.2 (A), MX5.2 (ROW)
unnamed: D6.2 (A), MX6.2 (ROW)
unnamed: D7.2 (A), MX7.2 (ROW)
unnamed: D8.2 (A), MX8.2 (ROW)
unnamed: D9.2 (A), MX9.2 (ROW)
unnamed: D4.1 (K), D10.1 (K), D16.1 (K), D22.1 (K)
unnamed: D10.2 (A), MX10.2 (ROW)
unnamed: D5.1 (K), D11.1 (K), D17.1 (K), D23.1 (K)
unnamed: D11.2 (A), MX11.2 (ROW)
unnamed: D6.1 (K), D12.1 (K), D18.1 (K), D24.1 (K)
unnamed: D12.2 (A), MX12.2 (ROW), MX25.1 (COL)
unnamed: D13.1 (A), D27.1 (A), D31.1 (A), D34.1 (A)
unnamed: D13.2 (RK), D19.2 (RK), D25.2 (RK), D26.2 (RK)
unnamed: D13.3 (GK), D19.3 (GK), D25.3 (GK), D26.3 (GK)
unnamed: D13.4 (BK), D19.4 (BK), D25.4 (BK), D26.4 (BK)
unnamed: D2.1 (K), D8.1 (K), D14.1 (K), D20.1 (K)
unnamed: D14.2 (A), MX14.2 (ROW)
unnamed: D3.1 (K), D9.1 (K), D15.1 (K), D21.1 (K)
unnamed: D15.2 (A), MX15.2 (ROW)
unnamed: D16.2 (A), MX16.2 (ROW)
unnamed: D17.2 (A), MX17.2 (ROW)
unnamed: D18.2 (A), MX18.2 (ROW)
unnamed: D19.1 (A), D28.1 (A), D32.1 (A), D35.1 (A)
unnamed: D20.2 (A), MX20.2 (ROW)
unnamed: D21.2 (A), MX21.2 (ROW)
unnamed: D22.2 (A), MX13.1 (COL), MX22.2 (ROW)
unnamed: D23.2 (A), MX23.2 (ROW)
unnamed: D24.2 (A), MX19.1 (COL), MX24.2 (ROW)
unnamed: D25.1 (A), D29.1 (A), D33.1 (A), D36.1 (A)
unnamed: D26.1 (A), D30.1 (A), D39.1 (A)
unnamed: D27.2 (RK), D28.2 (RK), D29.2 (RK), D30.2 (RK)
unnamed: D27.3 (GK), D28.3 (GK), D29.3 (GK), D30.3 (GK)
unnamed: D27.4 (BK), D28.4 (BK), D29.4 (BK), D30.4 (BK)
unnamed: D31.2 (RK), D32.2 (RK), D33.2 (RK), D37.2 (RK)
unnamed: D31.3 (GK), D32.3 (GK), D33.3 (GK), D37.3 (GK)
unnamed: D31.4 (BK), D32.4 (BK), D33.4 (BK), D37.4 (BK)
unnamed: D34.2 (RK), D35.2 (RK), D36.2 (RK), D38.2 (RK), D39.2 (RK)
unnamed: D34.3 (GK), D35.3 (GK), D36.3 (GK), D38.3 (GK), D39.3 (GK)
unnamed: D34.4 (BK), D35.4 (BK), D36.4 (BK), D38.4 (BK), D39.4 (BK)
unnamed: D37.1 (A), D38.1 (A)
unnamed: MX1.1 (COL), MX2.1 (COL), MX3.1 (COL), MX4.1 (COL), MX5.1 (COL), MX6.1 (COL)
unnamed: MX7.1 (COL), MX8.1 (COL), MX9.1 (COL), MX10.1 (COL), MX11.1 (COL), MX12.1 (COL), MX25.2 (ROW)
unnamed: MX13.2 (ROW), MX19.2 (ROW), MX20.1 (COL), MX21.1 (COL), MX22.1 (COL), MX23.1 (COL), MX24.1 (COL)
unnamed: MX14.1 (COL), MX15.1 (COL), MX16.1 (COL), MX17.1 (COL), MX18.1 (COL)
unnamed: R2.2, U1.44 (BOOT0)
unnamed: R105.1, U1.6 (PF1)
unnamed: R107.2, USB1.4 (CC1)
unnamed: R108.2, USB1.10 (CC2)
SWCLK: U1.37 (PA14)
SWDIO: U1.34 (PA13)

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
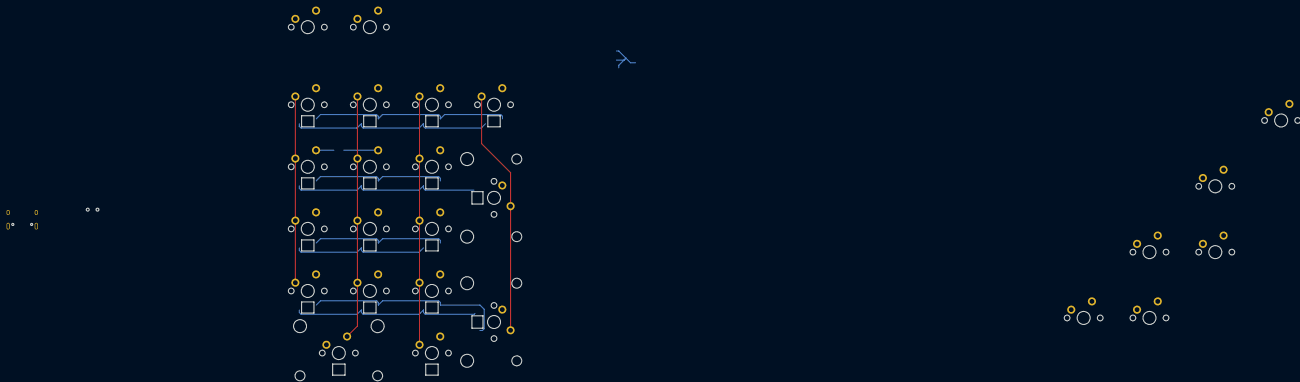
[picture p193: board numbowl.kicad_pcb from above]

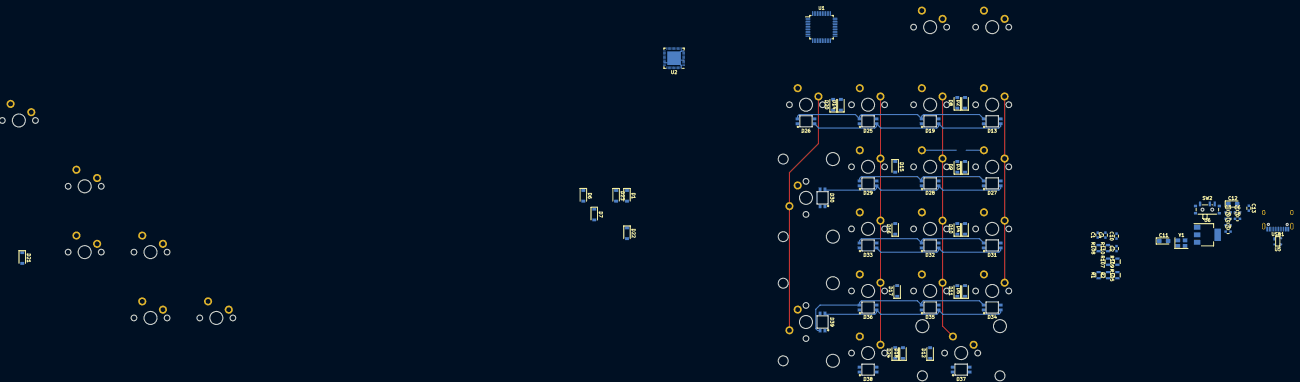
[picture p194: board numbowl.kicad_pcb from below]

Board: 2 copper layers, 91 parts (66 on the bottom side), 64 nets.
