MaiTheSan/PCB-Design/KiCad/1-2022/DNMK/averange65.kicad_pcb

## KiCad design KiCad/1-2022/DNMK/averange65.kicad_pcb (2022-11-19)

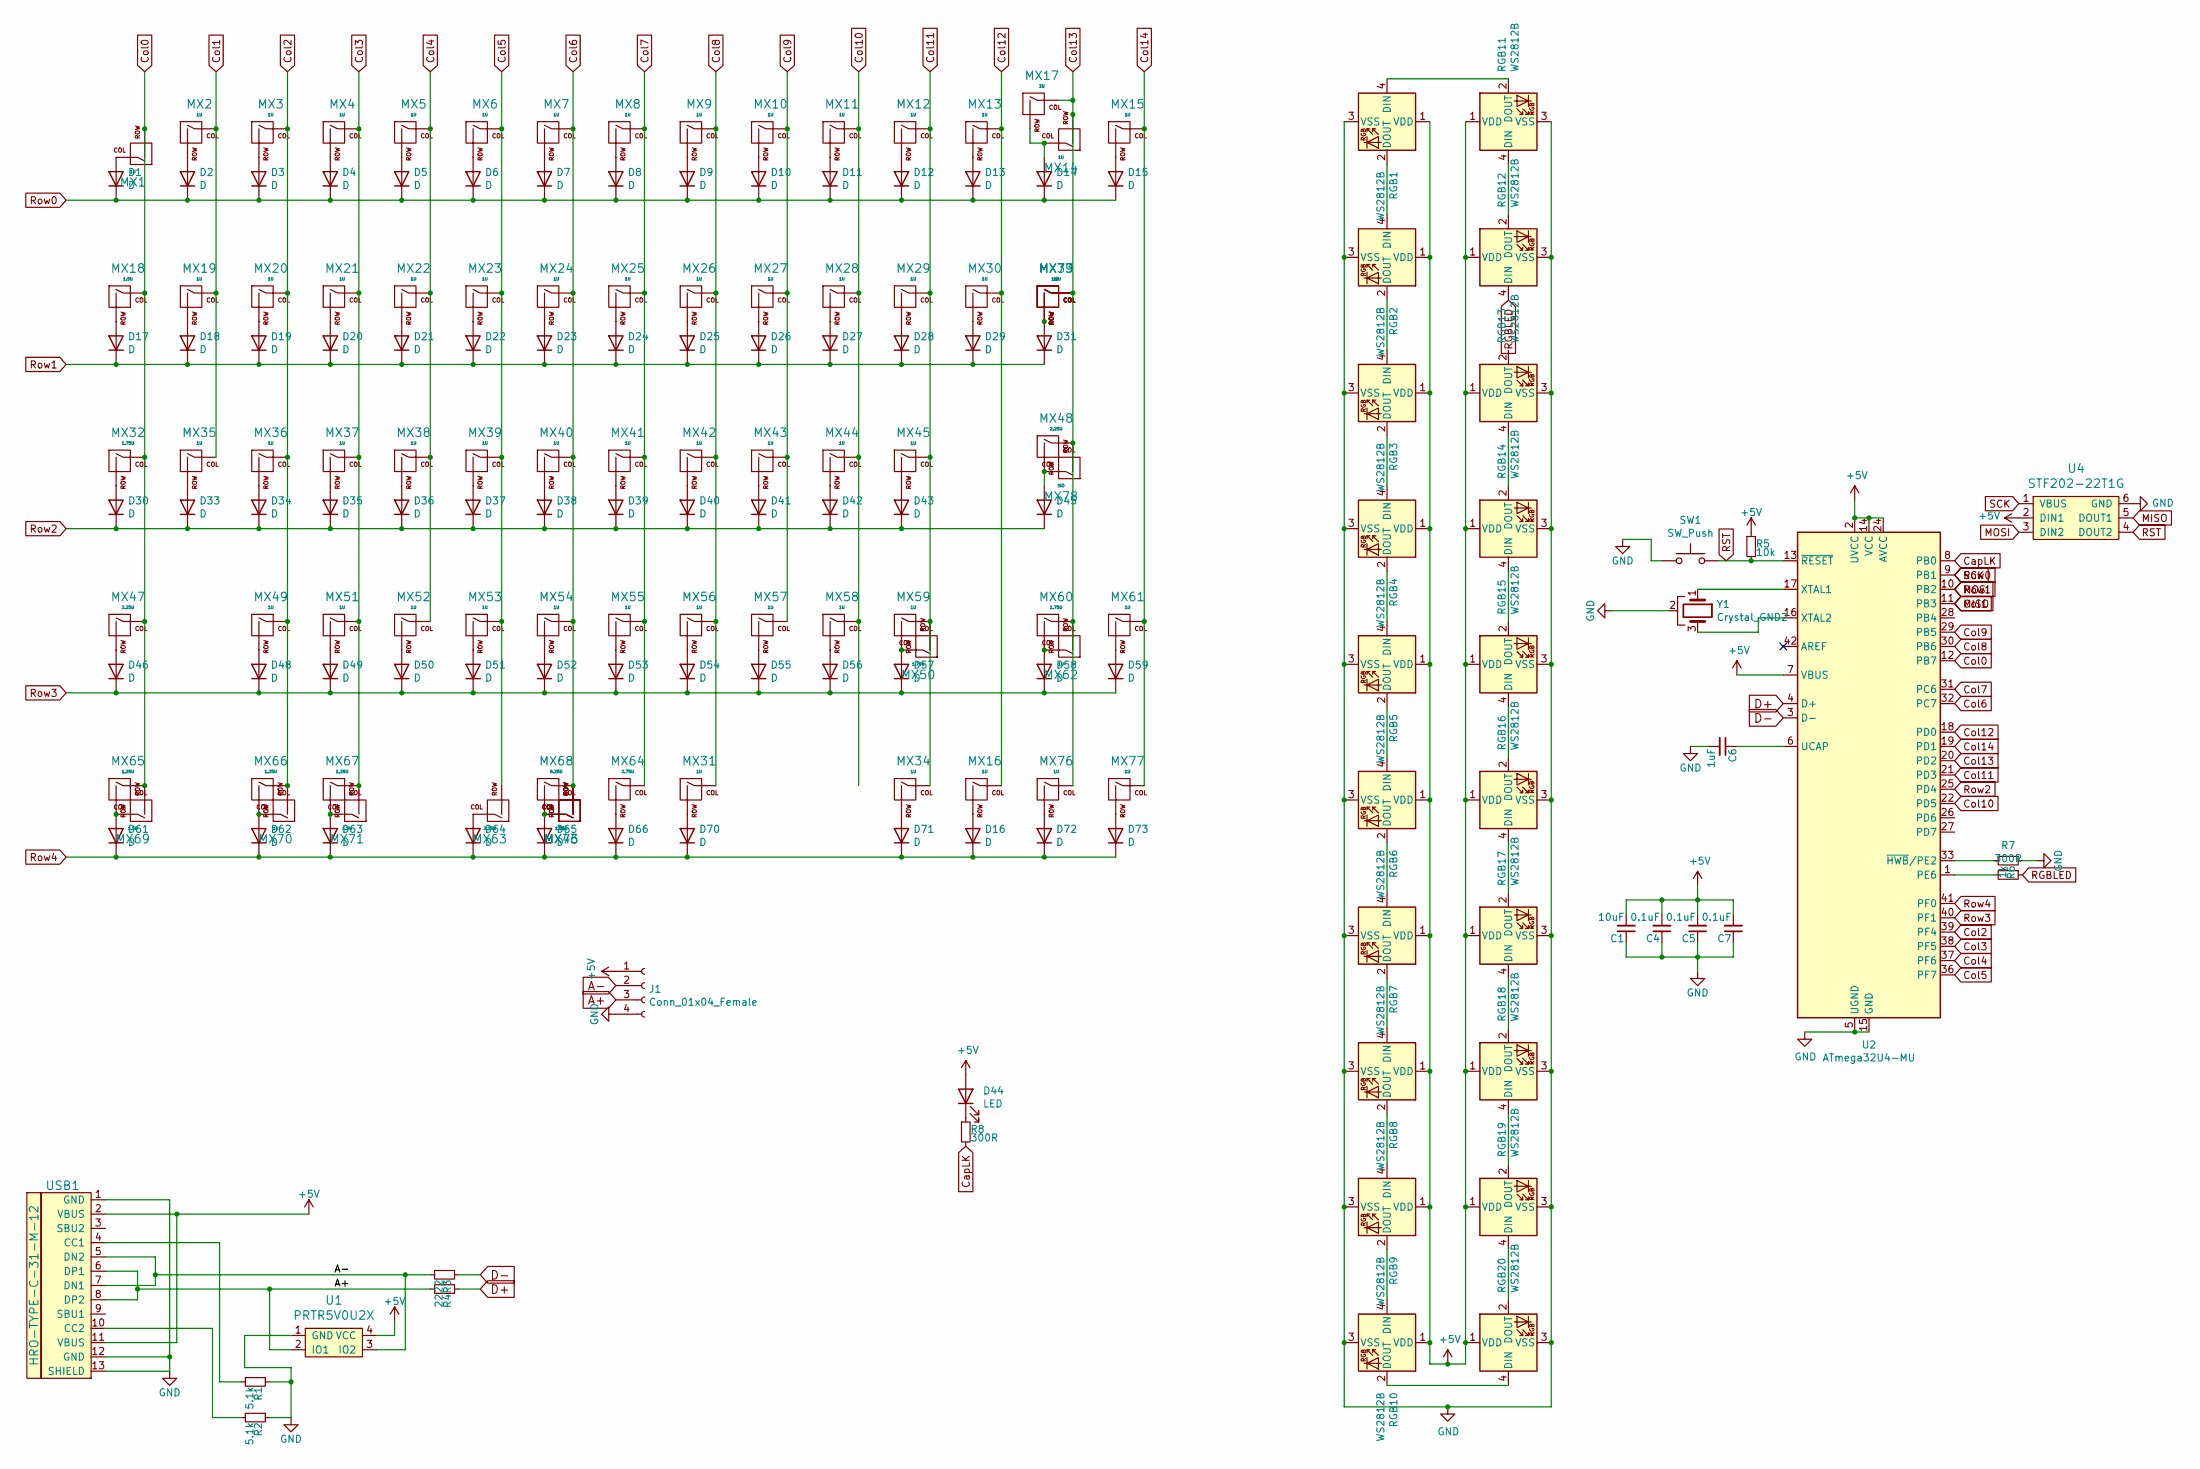
[picture p195: schematic averange65.sch]

Parts:
C1: 10uF; C_0603
C4, C5, C7: 0.1uF; C_0603
C6: 1uF; C_0603
D1, D2, D3, D4, D5, D6, D7, D8, D9, D10, D11, D12, D13, D14, D15, D16, D17, D18, D19, D20, D21, D22, D23, D24, D25, D26, D27, D28, D29, D30, D31, D33, D34, D35, D36, D37, D38, D39, D40, D41, D42, D43, D45, D46, D48, D49, D50, D51, D52, D53, D54, D55, D56, D57, D58, D59, D61, D62, D63, D64, D65, D66, D70, D71, D72, D73: D; DIODE_1206_SawnsProjects
D44: LED; LED-6028
J1: Conn_01x04_Female; JST-SR-4
MX1, MX2, MX3, MX4, MX5, MX6, MX7, MX8, MX9, MX10, MX11, MX12, MX13, MX14, MX15, MX16, MX19, MX20, MX21, MX22, MX23, MX24, MX25, MX26, MX27, MX28, MX29, MX30, MX31, MX34, MX35, MX36, MX37, MX38, MX39, MX40, MX41, MX42, MX43, MX44, MX45, MX49, MX51, MX52, MX53, MX54, MX55, MX56, MX57, MX58, MX59, MX61, MX62, MX70, MX76, MX77, MX79: 1U; MXOnly-1U-Hotswap
MX17: 2U; MXOnly-2U-Hotswap
MX18, MX33, MX69, MX71: 1.5U; MXOnly-1.5U-Hotswap
MX32, MX50, MX60: 1.75U; MXOnly-1.75U-Hotswap
MX46: 7U; MXOnly-7U-Hotswap-ReversedStabilizers
MX47: 2.25U; MXOnly-2.25U-Hotswap
MX48: 2.25U; MXOnly-2.25U-Hotswap-ReversedStabilizers-L
MX63: 2.25U; MXOnly-2.25U-Hotswap-ReversedStabilizers
MX64: 2.75U; MXOnly-2.75U-Hotswap-ReversedStabilizers
MX65, MX66, MX67, MX73: 1.25U; MXOnly-1.25U-Hotswap
MX68: 6.25U; MXOnly-6.25U-Hotswap
MX78: ISO; MXOnly-ISO-ROTATED-Hotswap-R
R1, R2: 5.1k; R_0805
R3, R4: 22; R_0603
R5: 10k; R_0805
R6: 1k; R_0805
R7, R8: 300R; R_0805
RGB1, RGB2, RGB3, RGB4, RGB5, RGB6, RGB7, RGB8, RGB9, RGB10, RGB11, RGB12, RGB13, RGB14, RGB15, RGB16, RGB17, RGB18, RGB19, RGB20: WS2812B; LED_WS2812B_PLCC4_5.0x5.0mm_P3.2mm
SW1: SW_Push; SKQG-1155865
U1: PRTR5V0U2X; SOT143B
U2: ATmega32U4-MU; QFN-44-1EP_7x7mm_P0.5mm_EP5.15x5.15mm
U4: STF202-22T1G; Tag-Connect_TC2030-IDC-NL_2x03_P1.27mm_Vertical
USB1: HRO-TYPE-C-31-M-12; HRO-TYPE-C-31-M-12-Assembly
Y1: Crystal_GND2; Resonator_SMD_muRata_CSTxExxV-3Pin_3.0x1.1mm

Connections:
+5V: C1.2, C4.2, C5.2, C7.2, D44.2 (A), J1.1, R5.1, RGB1.1 (VDD), RGB2.1 (VDD), RGB3.1 (VDD), RGB4.1 (VDD), RGB5.1 (VDD), RGB6.1 (VDD), RGB7.1 (VDD), RGB8.1 (VDD), RGB9.1 (VDD), RGB10.1 (VDD), RGB11.1 (VDD), RGB12.1 (VDD), RGB13.1 (VDD), RGB14.1 (VDD), RGB15.1 (VDD), RGB16.1 (VDD), RGB17.1 (VDD), RGB18.1 (VDD), RGB19.1 (VDD), RGB20.1 (VDD), U1.4 (VCC), U2.2 (UVCC), U2.7 (VBUS), U2.14 (VCC), U2.24 (AVCC), U2.34 (VCC), U2.44 (AVCC), U4.2 (DIN1), USB1.2 (VBUS), USB1.11 (VBUS)
A+: J1.3, R4.2, U1.2 (IO1), USB1.6 (DP1), USB1.8 (DP2)
A-: J1.2, R3.2, U1.3 (IO2), USB1.5 (DN2), USB1.7 (DN1)
CapLK: R8.2, U2.8 (PB0)
Col0: MX1.2 (ROW), MX18.1 (COL), MX32.1 (COL), MX47.1 (COL), MX65.1 (COL), MX69.2 (ROW), U2.12 (PB7)
Col1: MX2.1 (COL), MX19.1 (COL), MX35.1 (COL), U2.11 (PB3), U4.5 (DOUT1)
Col2: MX3.1 (COL), MX20.1 (COL), MX36.1 (COL), MX49.1 (COL), MX66.1 (COL), MX70.2 (ROW), U2.39 (PF4)
Col3: MX4.1 (COL), MX21.1 (COL), MX37.1 (COL), MX51.1 (COL), MX67.1 (COL), MX71.2 (ROW), U2.38 (PF5)
Col4: MX5.1 (COL), MX22.1 (COL), MX38.1 (COL), MX52.1 (COL), U2.37 (PF6)
Col5: MX6.1 (COL), MX23.1 (COL), MX39.1 (COL), MX53.1 (COL), MX63.2 (ROW), U2.36 (PF7)
Col6: MX7.1 (COL), MX24.1 (COL), MX40.1 (COL), MX46.2 (ROW), MX54.1 (COL), MX68.1 (COL), MX73.2 (ROW), U2.32 (PC7)
Col7: MX8.1 (COL), MX25.1 (COL), MX41.1 (COL), MX55.1 (COL), MX64.1 (COL), U2.31 (PC6)
Col8: MX9.1 (COL), MX26.1 (COL), MX31.1 (COL), MX42.1 (COL), MX56.1 (COL), U2.30 (PB6)
Col9: MX10.1 (COL), MX27.1 (COL), MX43.1 (COL), MX57.1 (COL), U2.29 (PB5)
Col10: MX11.1 (COL), MX28.1 (COL), MX44.1 (COL), MX58.1 (COL), U2.22 (PD5)
Col11: MX12.1 (COL), MX29.1 (COL), MX34.1 (COL), MX45.1 (COL), MX50.2 (ROW), MX59.1 (COL), U2.21 (PD3)
Col12: MX13.1 (COL), MX16.1 (COL), MX30.1 (COL), U2.18 (PD0)
Col13: MX14.2 (ROW), MX17.1 (COL), MX33.1 (COL), MX48.1 (COL), MX60.1 (COL), MX62.2 (ROW), MX76.1 (COL), MX78.2 (ROW), MX79.1 (COL), U2.20 (PD2)
Col14: MX15.1 (COL), MX61.1 (COL), MX77.1 (COL), U2.19 (PD1)
D+: R4.1, U2.4 (D+)
D-: R3.1, U2.3 (D-)
GND: C1.1, C4.1, C5.1, C6.2, C7.1, J1.4, R1.1, R2.1, R6.1, RGB1.3 (VSS), RGB2.3 (VSS), RGB3.3 (VSS), RGB4.3 (VSS), RGB5.3 (VSS), RGB6.3 (VSS), RGB7.3 (VSS), RGB8.3 (VSS), RGB9.3 (VSS), RGB10.3 (VSS), RGB11.3 (VSS), RGB12.3 (VSS), RGB13.3 (VSS), RGB14.3 (VSS), RGB15.3 (VSS), RGB16.3 (VSS), RGB17.3 (VSS), RGB18.3 (VSS), RGB19.3 (VSS), RGB20.3 (VSS), SW1.1, U1.1 (GND), U2.5 (UGND), U2.15 (GND), U2.23 (GND), U2.35 (GND), U2.43 (GND), U2.45 (GND), U4.6 (GND), USB1.1 (GND), USB1.12 (GND), USB1.13 (SHIELD), Y1.2
MOSI: D17.1 (K), D18.1 (K), D19.1 (K), D20.1 (K), D21.1 (K), D22.1 (K), D23.1 (K), D24.1 (K), D25.1 (K), D26.1 (K), D27.1 (K), D28.1 (K), D29.1 (K), D31.1 (K), U2.10 (PB2), U4.3 (DIN2)
unnamed: C6.1, U2.6 (UCAP)
unnamed: D1.2 (A), MX1.1 (COL)
unnamed: D2.2 (A), MX2.2 (ROW)
unnamed: D3.2 (A), MX3.2 (ROW)
unnamed: D4.2 (A), MX4.2 (ROW)
unnamed: D5.2 (A), MX5.2 (ROW)
unnamed: D6.2 (A), MX6.2 (ROW)
unnamed: D7.2 (A), MX7.2 (ROW)
unnamed: D8.2 (A), MX8.2 (ROW)
unnamed: D9.2 (A), MX9.2 (ROW)
unnamed: D10.2 (A), MX10.2 (ROW)
unnamed: D11.2 (A), MX11.2 (ROW)
unnamed: D12.2 (A), MX12.2 (ROW)
unnamed: D13.2 (A), MX13.2 (ROW)
unnamed: D14.2 (A), MX14.1 (COL), MX17.2 (ROW)
unnamed: D15.2 (A), MX15.2 (ROW)
unnamed: D16.2 (A), MX16.2 (ROW)
unnamed: D17.2 (A), MX18.2 (ROW)
unnamed: D18.2 (A), MX19.2 (ROW)
unnamed: D19.2 (A), MX20.2 (ROW)
unnamed: D20.2 (A), MX21.2 (ROW)
unnamed: D21.2 (A), MX22.2 (ROW)
unnamed: D22.2 (A), MX23.2 (ROW)
unnamed: D23.2 (A), MX24.2 (ROW)
unnamed: D24.2 (A), MX25.2 (ROW)
unnamed: D25.2 (A), MX26.2 (ROW)
unnamed: D26.2 (A), MX27.2 (ROW)
unnamed: D27.2 (A), MX28.2 (ROW)
unnamed: D28.2 (A), MX29.2 (ROW)
unnamed: D29.2 (A), MX30.2 (ROW)
unnamed: D30.2 (A), MX32.2 (ROW)
unnamed: D31.2 (A), MX33.2 (ROW), MX79.2 (ROW)
unnamed: D33.2 (A), MX35.2 (ROW)
unnamed: D34.2 (A), MX36.2 (ROW)
unnamed: D35.2 (A), MX37.2 (ROW)
unnamed: D36.2 (A), MX38.2 (ROW)
unnamed: D37.2 (A), MX39.2 (ROW)
unnamed: D38.2 (A), MX40.2 (ROW)
unnamed: D39.2 (A), MX41.2 (ROW)
unnamed: D40.2 (A), MX42.2 (ROW)
unnamed: D41.2 (A), MX43.2 (ROW)
unnamed: D42.2 (A), MX44.2 (ROW)
unnamed: D43.2 (A), MX45.2 (ROW)
unnamed: D44.1 (K), R8.1
unnamed: D45.2 (A), MX48.2 (ROW), MX78.1 (COL)
unnamed: D46.2 (A), MX47.2 (ROW)
unnamed: D48.2 (A), MX49.2 (ROW)
unnamed: D49.2 (A), MX51.2 (ROW)
unnamed: D50.2 (A), MX52.2 (ROW)
unnamed: D51.2 (A), MX53.2 (ROW)
unnamed: D52.2 (A), MX54.2 (ROW)
unnamed: D53.2 (A), MX55.2 (ROW)
unnamed: D54.2 (A), MX56.2 (ROW)
unnamed: D55.2 (A), MX57.2 (ROW)
unnamed: D56.2 (A), MX58.2 (ROW)
unnamed: D57.2 (A), MX50.1 (COL), MX59.2 (ROW)
unnamed: D58.2 (A), MX60.2 (ROW), MX62.1 (COL)
unnamed: D59.2 (A), MX61.2 (ROW)
unnamed: D61.2 (A), MX65.2 (ROW), MX69.1 (COL)
unnamed: D62.2 (A), MX66.2 (ROW), MX70.1 (COL)
unnamed: D63.2 (A), MX67.2 (ROW), MX71.1 (COL)
unnamed: D64.2 (A), MX63.1 (COL)
unnamed: D65.2 (A), MX46.1 (COL), MX68.2 (ROW), MX73.1 (COL)
unnamed: D66.2 (A), MX64.2 (ROW)
unnamed: D70.2 (A), MX31.2 (ROW)
unnamed: D71.2 (A), MX34.2 (ROW)
unnamed: D72.2 (A), MX76.2 (ROW)
unnamed: D73.2 (A), MX77.2 (ROW)
unnamed: R1.2, USB1.4 (CC1)
unnamed: R2.2, USB1.10 (CC2)
unnamed: R6.2, U2.33 (~HWB~/PE2)
unnamed: R7.2, U2.1 (PE6)
unnamed: RGB1.2 (DOUT), RGB2.4 (DIN)
unnamed: RGB1.4 (DIN), RGB11.2 (DOUT)
unnamed: RGB2.2 (DOUT), RGB3.4 (DIN)
unnamed: RGB3.2 (DOUT), RGB4.4 (DIN)
unnamed: RGB4.2 (DOUT), RGB5.4 (DIN)
unnamed: RGB5.2 (DOUT), RGB6.4 (DIN)
unnamed: RGB6.2 (DOUT), RGB7.4 (DIN)
unnamed: RGB7.2 (DOUT), RGB8.4 (DIN)
unnamed: RGB8.2 (DOUT), RGB9.4 (DIN)
unnamed: RGB10.2 (DOUT), RGB20.4 (DIN)
unnamed: RGB9.2 (DOUT), RGB10.4 (DIN)
unnamed: RGB11.4 (DIN), RGB12.2 (DOUT)
unnamed: RGB13.4 (DIN), RGB14.2 (DOUT)
unnamed: RGB14.4 (DIN), RGB15.2 (DOUT)
unnamed: RGB15.4 (DIN), RGB16.2 (DOUT)
unnamed: RGB16.4 (DIN), RGB17.2 (DOUT)
unnamed: RGB17.4 (DIN), RGB18.2 (DOUT)
unnamed: RGB18.4 (DIN), RGB19.2 (DOUT)
unnamed: RGB19.4 (DIN), RGB20.2 (DOUT)
unnamed: U2.16 (XTAL2), Y1.3
unnamed: U2.17 (XTAL1), Y1.1
RGBLED: R7.1, RGB12.4 (DIN)
RST: R5.2, SW1.2, U2.13 (~RESET), U4.4 (DOUT2)
Row0: D1.1 (K), D2.1 (K), D3.1 (K), D4.1 (K), D5.1 (K), D6.1 (K), D7.1 (K), D8.1 (K), D9.1 (K), D10.1 (K), D11.1 (K), D12.1 (K), D13.1 (K), D14.1 (K), D15.1 (K), U2.9 (PB1), U4.1 (VBUS)
Row2: D30.1 (K), D33.1 (K), D34.1 (K), D35.1 (K), D36.1 (K), D37.1 (K), D38.1 (K), D39.1 (K), D40.1 (K), D41.1 (K), D42.1 (K), D43.1 (K), D45.1 (K), U2.25 (PD4)
Row3: D46.1 (K), D48.1 (K), D49.1 (K), D50.1 (K), D51.1 (K), D52.1 (K), D53.1 (K), D54.1 (K), D55.1 (K), D56.1 (K), D57.1 (K), D58.1 (K), D59.1 (K), U2.40 (PF1)
Row4: D16.1 (K), D61.1 (K), D62.1 (K), D63.1 (K), D64.1 (K), D65.1 (K), D66.1 (K), D70.1 (K), D71.1 (K), D72.1 (K), D73.1 (K), U2.41 (PF0)

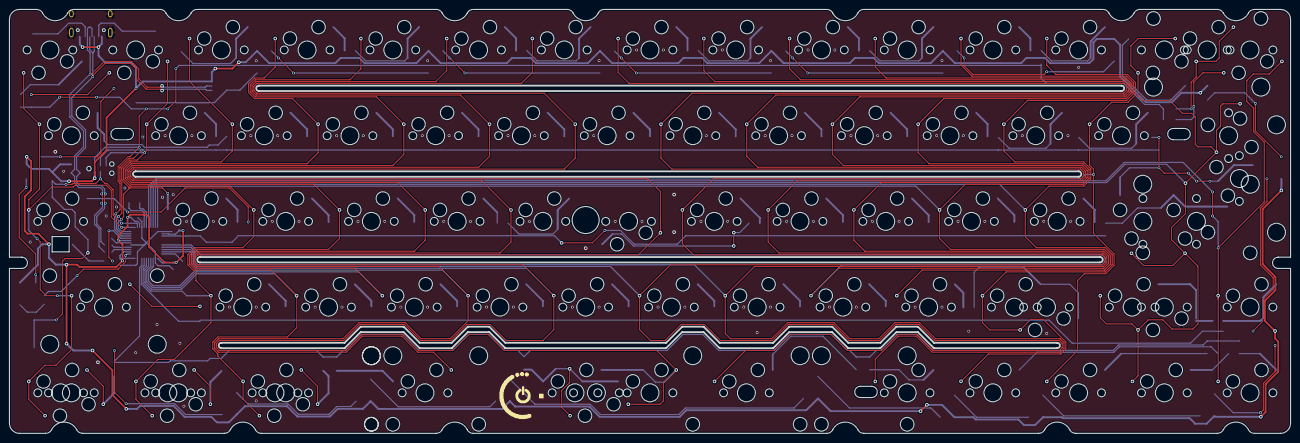
[picture p196: board averange65.kicad_pcb from above]

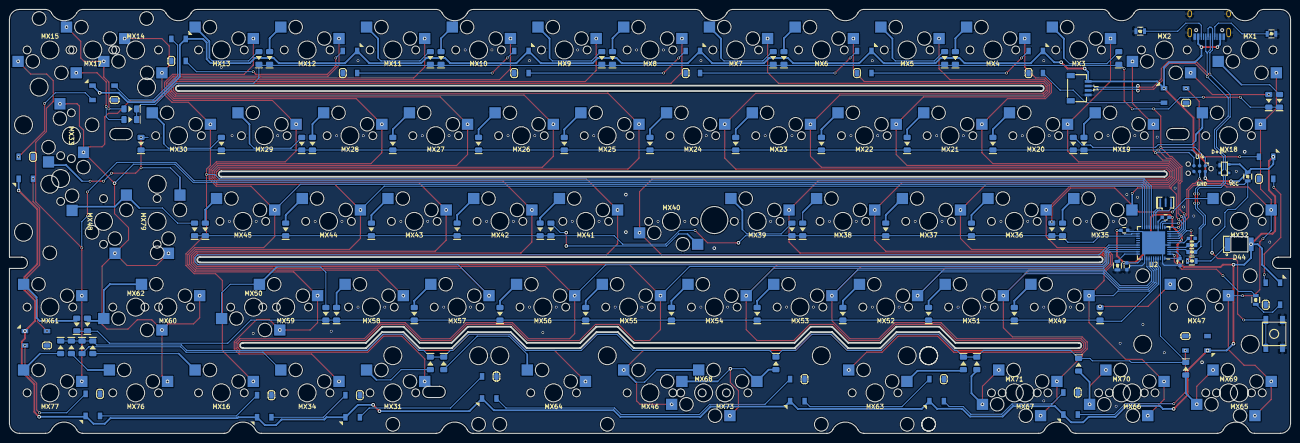
[picture p197: board averange65.kicad_pcb from below]

Board: 2 copper layers, 284.7 x 94.2 mm, 183 parts (107 on the bottom side), 122 nets.
