MaiTheSan/PCB-Design/KiCad/06-2021 comm/averange65/Unified-Daughterboard-master/Unified-Daughterboard-master/KiCad/C3/Unified-Daughterboard.kicad_pcb

## KiCad design KiCad/06-2021 comm/averange65/Unified-Daughterboard-master/Unified-Daughterboard-master/KiCad/C3/Unified-Daughterboard.kicad_pcb (2022-11-19)

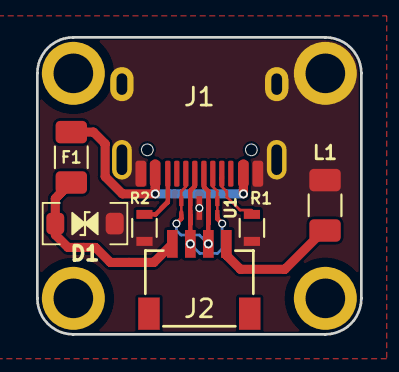
[picture p198: board Unified-Daughterboard.kicad_pcb from above]

Board: 2 copper layers, 18.0 x 16.5 mm, 12 parts (0 on the bottom side), 8 nets.

Parts:
D1: SMF9.0CA; D_SOD-123_Bidirectional
F1: ASMD1206-150; Fuse_1206_3216Metric
J1: TYPE-C-31-M12_13; TYPE-C-31-M-12
J2: SM04B-SRSS-TB(LF)(SN); JST-SR-4
L1: 60R@100MHz; L_1206_3216Metric
MH1, MH2, MH3, MH4: Mount-M2; Generic-Mounthole
R1, R2: 5.1k; R_0603
U1: TPD4E05U06DQAR; USON-10_2.5x1.0mm_P0.5mm

Connections:
DA+: J1.A6, J1.B6, J2.3, U1.1, U1.4, U1.7, U1.10
DA-: J1.A7, J1.B7, J2.2, U1.2, U1.5, U1.6, U1.9
GND: J2.4, L1.1
GNDPWR: D1.1, J1.A1, J1.B1, J1.S, L1.2, MH2.1, R1.2, R2.2, U1.3, U1.8
unnamed: J1.A5, R1.1
unnamed: J1.B5, R2.1
VBUS: F1.1, J1.A4, J1.B4
VCC: D1.2, F1.2, J2.1
