MaiTheSan/PCB-Design/KiCad/Early 2021/phôi design pcb/AT-L 1800 (MOSFET led) - Copy/1800 source/1800 layout.kicad_pcb

## KiCad design KiCad/Early 2021/phôi design pcb/AT-L 1800 (MOSFET led) - Copy/1800 source/1800 layout.kicad_pcb (2022-11-19)

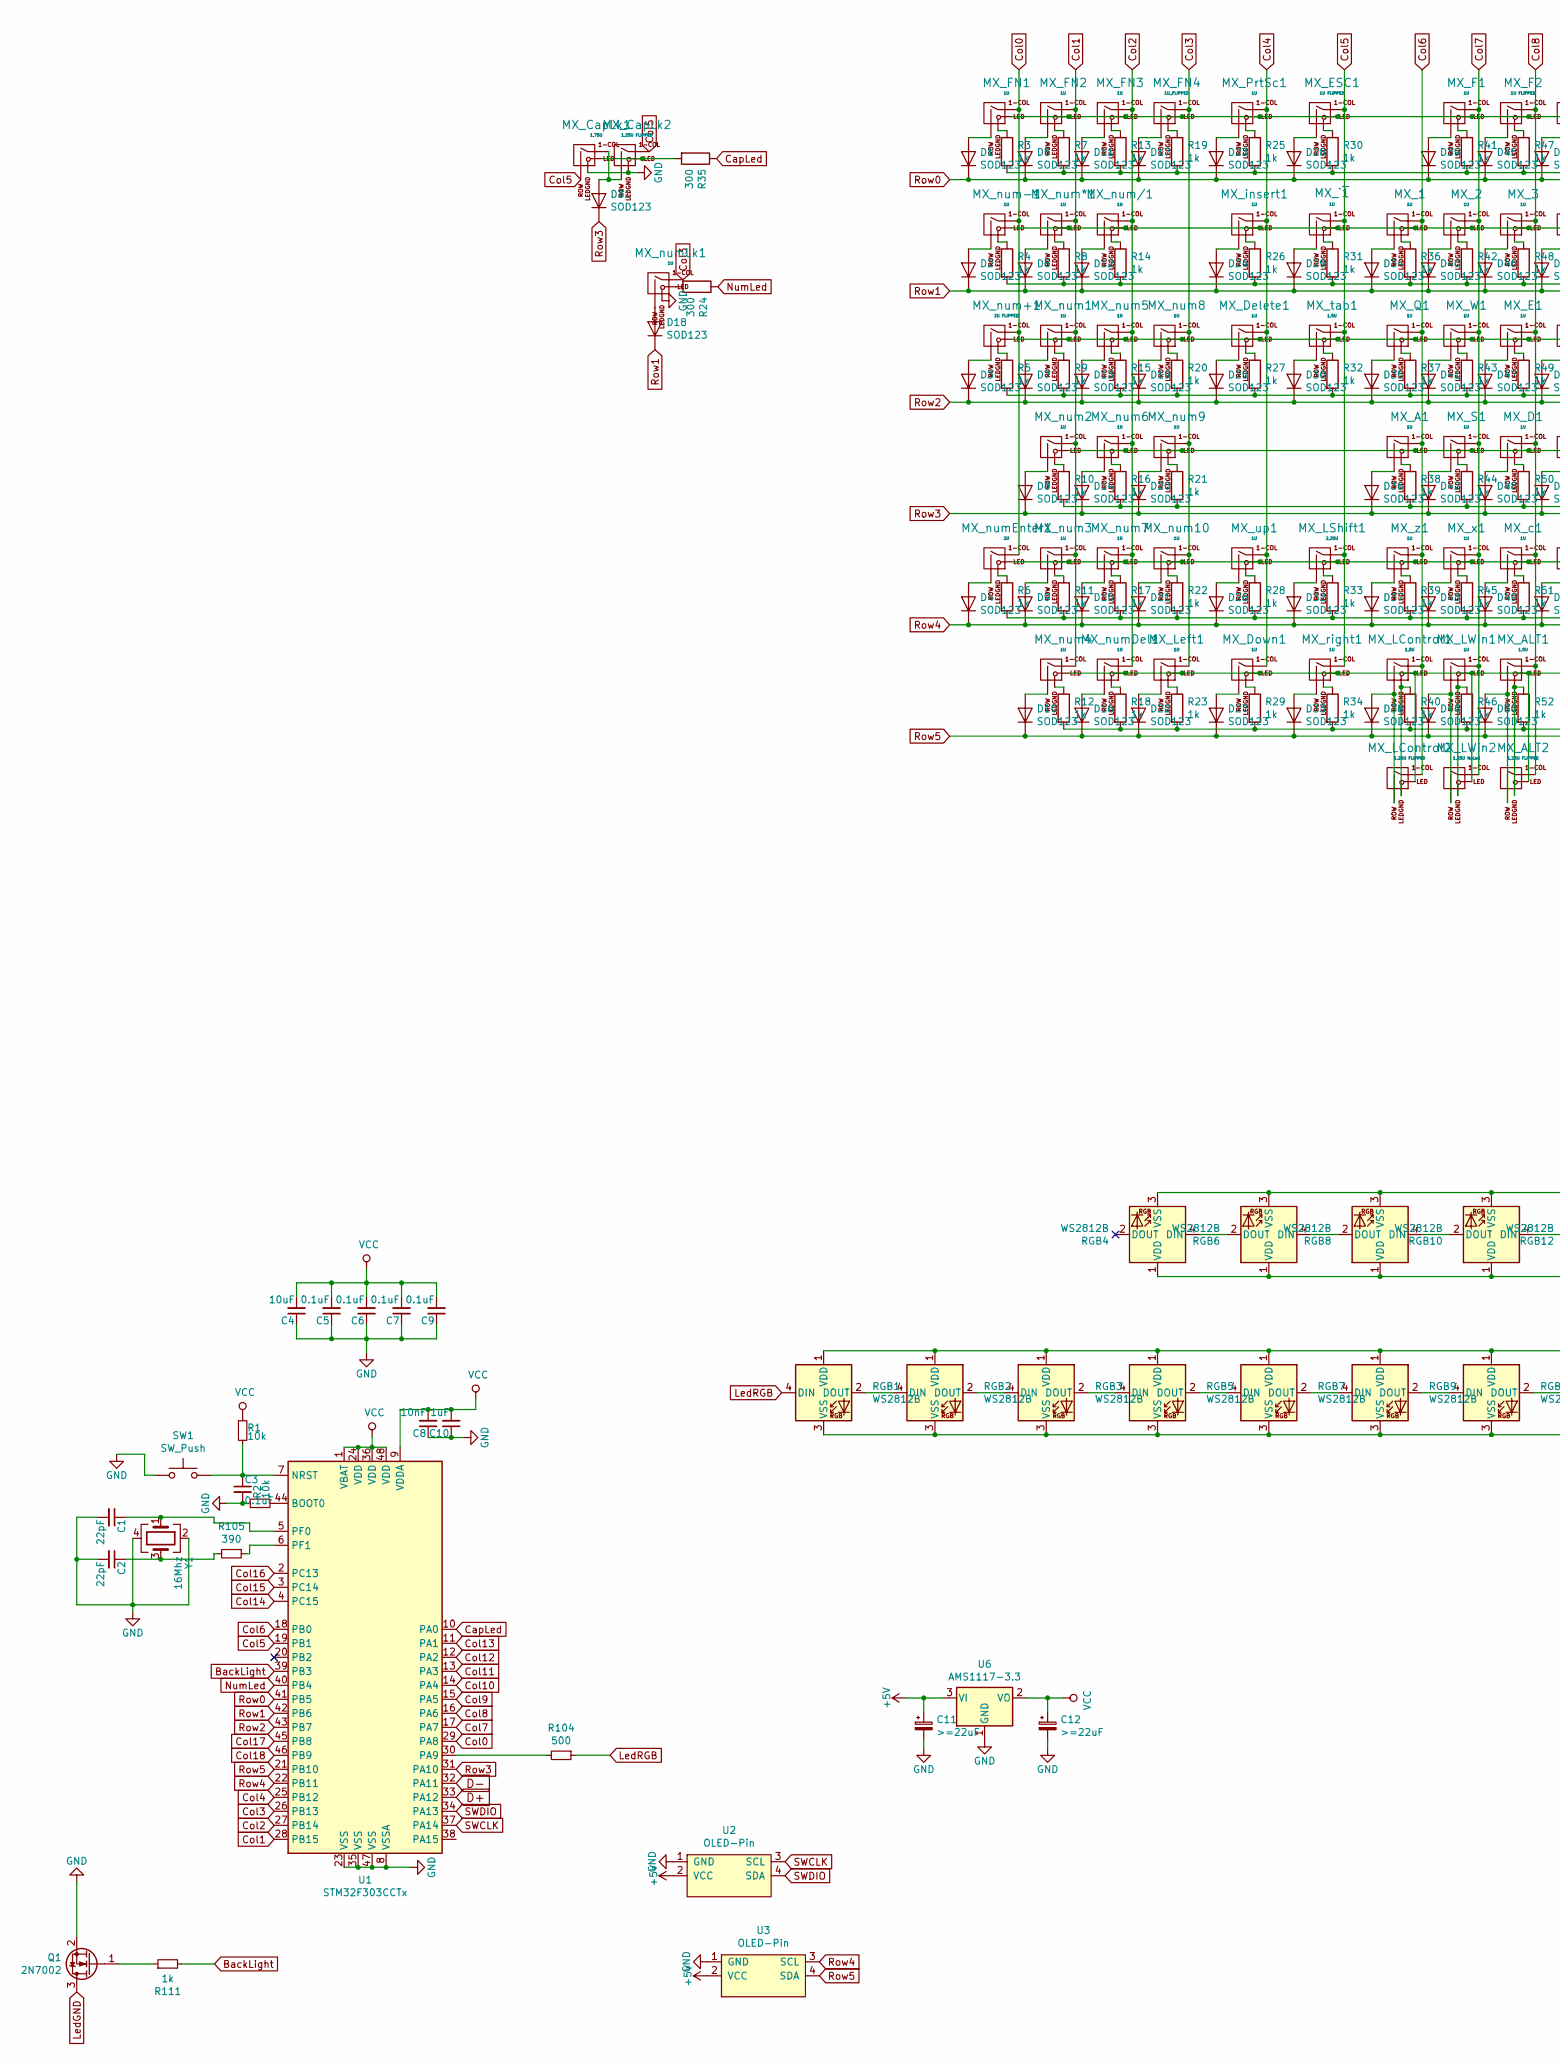
[picture p199: schematic 1800 layout.sch, part in row 1, column 1]

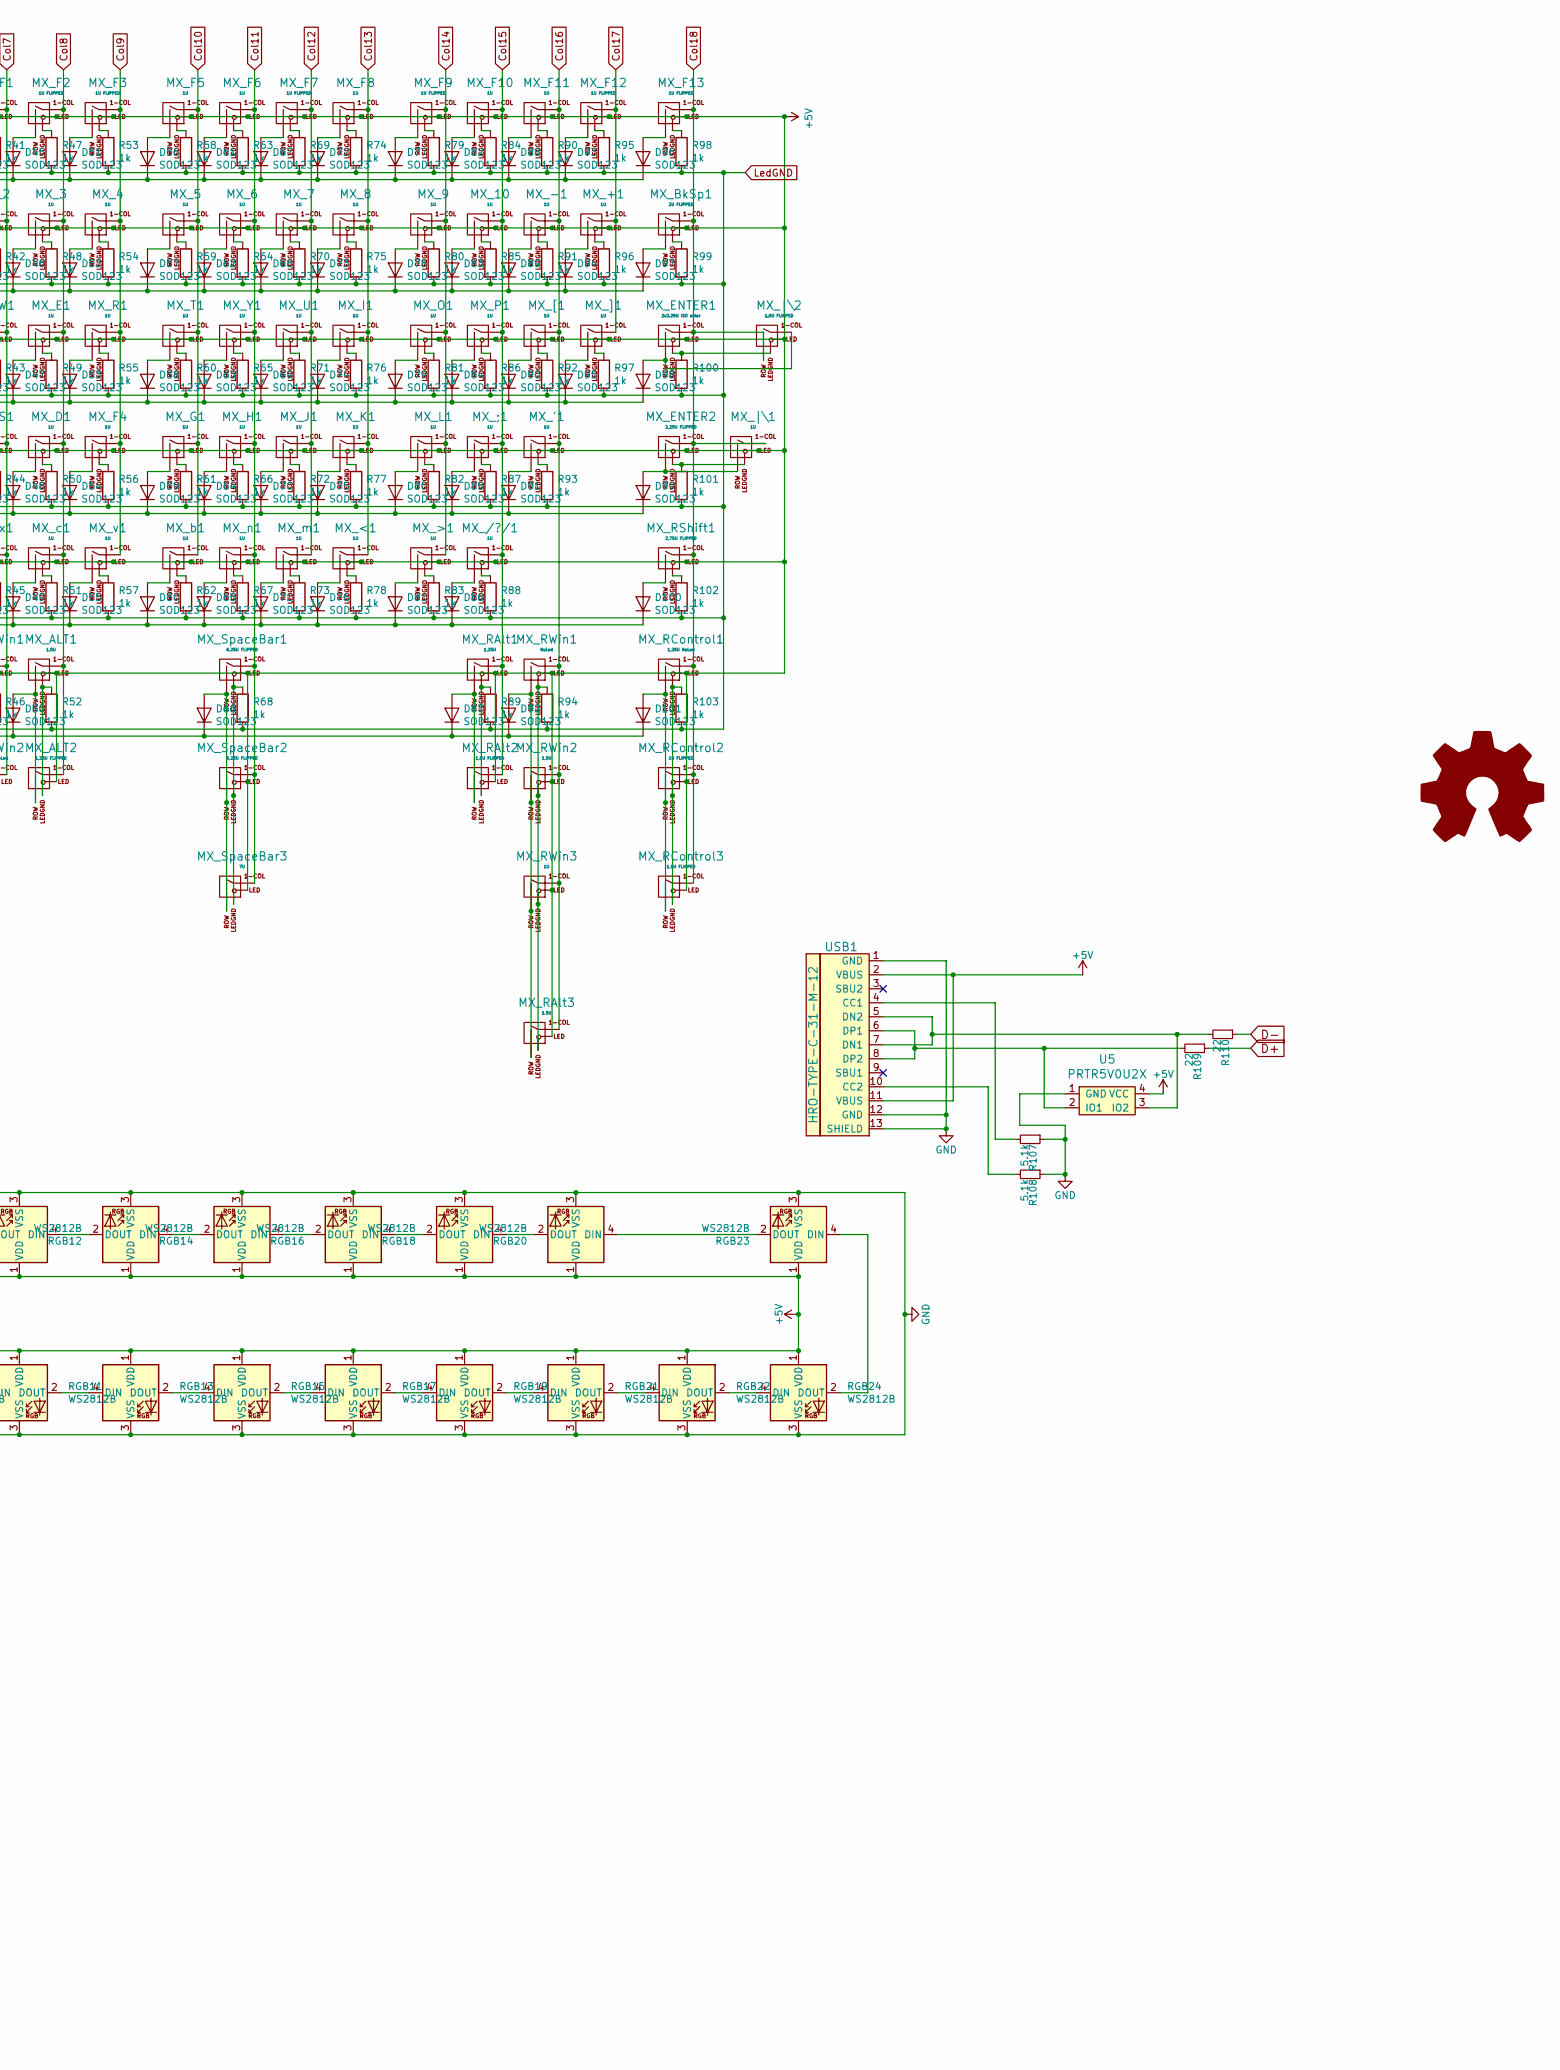
[picture p200: schematic 1800 layout.sch, part in row 1, column 2]

Parts:
C1, C2: 22pF; C_0603
C3, C5, C6, C7, C9: 0.1uF; C_0402_1005Metric
C4: 10uF; C_0603
C8: 10nF; C_0402_1005Metric
C10: 1uF; C_0603
C11, C12: >=22uF; CP_EIA-3216-12_Kemet-S
D1, D2, D3, D4, D5, D6, D7, D8, D9, D10, D11, D12, D13, D14, D15, D16, D17, D18, D19, D20, D21, D22, D23, D24, D25, D26, D27, D28, D29, D30, D31, D32, D33, D34, D35, D36, D37, D38, D39, D40, D41, D42, D43, D44, D45, D46, D47, D48, D49, D50, D51, D52, D53, D54, D55, D56, D57, D58, D59, D60, D61, D62, D63, D64, D65, D66, D67, D68, D69, D70, D71, D72, D73, D74, D75, D76, D77, D78, D79, D80, D81, D82, D83, D84, D85, D86, D87, D88, D89, D90, D91, D92, D93, D94, D95, D96, D97, D98, D99, D101: SOD123; D_SOD-123
D100: SOD123; D_SOD-123-Pretty
LOGO1: Logo_Open_Hardware_Large; sanpjxlogo
MX_1, MX_2, MX_3, MX_4, MX_5, MX_6, MX_7, MX_8, MX_9, MX_10: 1U; MXOnly-1U
MX_'1: 1U; MXOnly-1U
MX_+1: 1U; MXOnly-1U
MX_-1: 1U; MXOnly-1U
MX_/?/1: 1U; MXOnly-1U
MX_;1: 1U; MXOnly-1U
MX_<1: 1U; MXOnly-1U
MX_>1: 1U; MXOnly-1U
MX_A1: 1U; MXOnly-1U
MX_ALT1: 1,5U; MXOnly-1.5U
MX_ALT2: 1,25U FLIPPED; MXOnly-1.25U-FLIPPED
MX_BkSp1: 2U FLIPPED; MXOnly-2U-FLIPPED
MX_CapLk1: 1,75U; MXOnly-1.75U-FLIPPED
MX_CapLk2: 1,25U FLIPPED; MXOnly-1.25U
MX_D1: 1U; MXOnly-1U
MX_Delete1: 1U; MXOnly-1U
MX_Down1: 1U; MXOnly-1U-FLIPPED
MX_E1: 1U; MXOnly-1U
MX_ENTER1: 2x2.25U ISO enter; MXOnly-ISO
MX_ENTER2: 2,25U FLIPPED; MXOnly-2.25U-FLIPPED-ReversedStabilizers
MX_ESC1: 1U FLIPPED; MXOnly-1U-FLIPPED
MX_F1, MX_F4, MX_F6, MX_F8, MX_F10, MX_F11: 1U; MXOnly-1U
MX_F2, MX_F3, MX_F7, MX_F9, MX_F12, MX_F13: 1U FLIPPED; MXOnly-1U-FLIPPED
MX_F5: 1U; MXOnly-1U-FLIPPED
MX_FN1, MX_FN2, MX_FN3: 1U; MXOnly-1U
MX_FN4: 1U_FLIPPED; MXOnly-1U-FLIPPED
MX_G1: 1U; MXOnly-1U
MX_H1: 1U; MXOnly-1U
MX_I1: 1U; MXOnly-1U
MX_J1: 1U; MXOnly-1U
MX_K1: 1U; MXOnly-1U
MX_L1: 1U; MXOnly-1U
MX_LControl1: 1,5U; MXOnly-1.5U
MX_LControl2: 1,25U FLIPPED; MXOnly-1.25U-FLIPPED
MX_LShift1: 2,25U; MXOnly-2.25U
MX_LWin1: 1U; MXOnly-1U
MX_LWin2: 1,25U NoLed; MXOnly-1.25U-FLIPPED
MX_Left1: 1U; MXOnly-1U
MX_O1: 1U; MXOnly-1U
MX_P1: 1U; MXOnly-1U
MX_PrtSc1: 1U; MXOnly-1U
MX_Q1: 1U; MXOnly-1U
MX_R1: 1U; MXOnly-1U
MX_RAlt1: 1,25U; MXOnly-1.25U
MX_RAlt2: 1,5U FLIPPED; MXOnly-1.5U-FLIPPED
MX_RAlt3: 1,5U; MXOnly-1.5U
MX_RControl1: 1,25U NoLed; MXOnly-1.25U
MX_RControl2: 1U FLIPPED; MXOnly-1U-FLIPPED
MX_RControl3: 1,5U FLIPPED; MXOnly-1.5U-FLIPPED
MX_RShift1: 2,75U FLIPPED; MXOnly-2.75U-FLIPPED
MX_RWin1: NoLed; MXOnly-1.25U-FLIPPED
MX_RWin2: 1,5U; MXOnly-1.5U
MX_RWin3: 1U; MXOnly-1U
MX_S1: 1U; MXOnly-1U
MX_SpaceBar1, MX_SpaceBar2: 6,25U FLIPPED; MXOnly-6.25U-FLIPPED-ReversedStabilizers
MX_SpaceBar3: 7U; MXOnly-7U-ReversedStabilizers
MX_T1: 1U; MXOnly-1U
MX_U1: 1U; MXOnly-1U
MX_W1: 1U; MXOnly-1U
MX_Y1: 1U; MXOnly-1U
MX_[1: 1U; MXOnly-1U
MX_]1: 1U; MXOnly-1U
MX_`~1: 1U; MXOnly-1U
MX_b1: 1U; MXOnly-1U
MX_c1: 1U; MXOnly-1U
MX_insert1: 1U; MXOnly-1U
MX_m1: 1U; MXOnly-1U
MX_n1: 1U; MXOnly-1U
MX_num1, MX_num2, MX_num3, MX_num4, MX_num5, MX_num6, MX_num7, MX_num9, MX_num10: 1U; MXOnly-1U
MX_num8: 1U; MXOnly-1U-FLIPPED
MX_num*1: 1U; MXOnly-1U
MX_num+1: 2U FLIPPED; MXOnly-2U
MX_num-1: 1U; MXOnly-1U
MX_num/1: 1U; MXOnly-1U
MX_numDel1: 1U; MXOnly-1U
MX_numEnter1: 2U; MXOnly-2U
MX_numLk1: 1U; MXOnly-1U-FLIPPED
MX_right1: 1U; MXOnly-1U
MX_tab1: 1,5U; MXOnly-1.5U
MX_up1: 1U; MXOnly-1U
MX_v1: 1U; MXOnly-1U
MX_x1: 1U; MXOnly-1U
MX_z1: 1U; MXOnly-1U
MX_|\1: 1U; MXOnly-1U
MX_|\2: 1.5U FLIPPED; MXOnly-1.5U-FLIPPED
Q1: 2N7002; SOT-23
R1, R2: 10k; C_0603
R3, R4, R5, R6, R7, R8, R9, R10, R11, R12, R13, R14, R15, R16, R17, R18, R19, R20, R21, R22, R23, R25, R26, R27, R28, R29, R30, R31, R32, R33, R34, R36, R37, R38, R39, R40, R41, R42, R43, R44, R45, R46, R47, R48, R49, R50, R51, R52, R53, R54, R55, R56, R57, R58, R59, R60, R61, R62, R63, R64, R65, R66, R67, R68, R69, R70, R71, R72, R73, R74, R75, R76, R77, R78, R79, R80, R81, R82, R83, R84, R85, R86, R87, R88, R89, R90, R91, R92, R93, R94, R95, R96, R97, R98, R99, R100, R101, R102, R103, R111: 1k; R_0805
R24, R35: 300; R_0805
R104: 500; R_0805
R105: 390; C_0603
R107, R108: 5.1k; C_0603
R109, R110: 22; C_0603
RGB1, RGB2, RGB3, RGB4, RGB5, RGB6, RGB7, RGB8, RGB9, RGB10, RGB11, RGB12, RGB13, RGB14, RGB15, RGB16, RGB17, RGB18, RGB19, RGB20, RGB21, RGB22, RGB23, RGB24: WS2812B; LED_WS2812B_PLCC4_5.0x5.0mm_P3.2mm
SW1: SW_Push; SKQG-1155865
U1: STM32F303CCTx; LQFP-48_7x7mm_P0.5mm
U2, U3: OLED-Pin; 0.91_SSD1306_OLED
U5: PRTR5V0U2X; SOT143B
U6: AMS1117-3.3; SOT-223-3_TabPin2
USB1: HRO-TYPE-C-31-M-12; HRO-TYPE-C-31-M-12-Assembly
Y1: 16Mhz; Crystal_SMD_3225-4Pin_3.2x2.5mm

Connections:
+5V: C11.1, MX_1.3 (LED), MX_2.3 (LED), MX_3.3 (LED), MX_4.3 (LED), MX_5.3 (LED), MX_6.3 (LED), MX_7.3 (LED), MX_8.3 (LED), MX_9.3 (LED), MX_10.3 (LED), MX_'1.3 (LED), MX_+1.3 (LED), MX_-1.3 (LED), MX_/?/1.3 (LED), MX_;1.3 (LED), MX_<1.3 (LED), MX_>1.3 (LED), MX_A1.3 (LED), MX_ALT1.3 (LED), MX_ALT2.3 (LED), MX_BkSp1.3 (LED), MX_D1.3 (LED), MX_Delete1.3 (LED), MX_Down1.3 (LED), MX_E1.3 (LED), MX_ENTER1.3 (LED), MX_ENTER2.3 (LED), MX_ESC1.3 (LED), MX_F1.3 (LED), MX_F2.3 (LED), MX_F3.3 (LED), MX_F4.3 (LED), MX_F5.3 (LED), MX_F6.3 (LED), MX_F7.3 (LED), MX_F8.3 (LED), MX_F9.3 (LED), MX_F10.3 (LED), MX_F11.3 (LED), MX_F12.3 (LED), MX_F13.3 (LED), MX_FN1.3 (LED), MX_FN2.3 (LED), MX_FN3.3 (LED), MX_FN4.3 (LED), MX_G1.3 (LED), MX_H1.3 (LED), MX_I1.3 (LED), MX_J1.3 (LED), MX_K1.3 (LED), MX_L1.3 (LED), MX_LControl1.3 (LED), MX_LControl2.3 (LED), MX_LShift1.3 (LED), MX_LWin1.3 (LED), MX_LWin2.3 (LED), MX_Left1.3 (LED), MX_O1.3 (LED), MX_P1.3 (LED), MX_PrtSc1.3 (LED), MX_Q1.3 (LED), MX_R1.3 (LED), MX_RAlt1.3 (LED), MX_RAlt2.3 (LED), MX_RAlt3.3 (LED), MX_RControl1.3 (LED), MX_RControl2.3 (LED), MX_RControl3.3 (LED), MX_RShift1.3 (LED), MX_RWin1.3 (LED), MX_RWin2.3 (LED), MX_RWin3.3 (LED), MX_S1.3 (LED), MX_SpaceBar1.3 (LED), MX_SpaceBar2.3 (LED), MX_SpaceBar3.3 (LED), MX_T1.3 (LED), MX_U1.3 (LED), MX_W1.3 (LED), MX_Y1.3 (LED), MX_[1.3 (LED), MX_]1.3 (LED), MX_`~1.3 (LED), MX_b1.3 (LED), MX_c1.3 (LED), MX_insert1.3 (LED), MX_m1.3 (LED), MX_n1.3 (LED), MX_num1.3 (LED), MX_num2.3 (LED), MX_num3.3 (LED), MX_num4.3 (LED), MX_num5.3 (LED), MX_num6.3 (LED), MX_num7.3 (LED), MX_num8.3 (LED), MX_num9.3 (LED), MX_num10.3 (LED), MX_num*1.3 (LED), MX_num+1.3 (LED), MX_num-1.3 (LED), MX_num/1.3 (LED), MX_numDel1.3 (LED), MX_numEnter1.3 (LED), MX_right1.3 (LED), MX_tab1.3 (LED), MX_up1.3 (LED), MX_v1.3 (LED), MX_x1.3 (LED), MX_z1.3 (LED), MX_|\1.3 (LED), MX_|\2.3 (LED), RGB1.1 (VDD), RGB2.1 (VDD), RGB3.1 (VDD), RGB4.1 (VDD), RGB5.1 (VDD), RGB6.1 (VDD), RGB7.1 (VDD), RGB8.1 (VDD), RGB9.1 (VDD), RGB10.1 (VDD), RGB11.1 (VDD), RGB12.1 (VDD), RGB13.1 (VDD), RGB14.1 (VDD), RGB15.1 (VDD), RGB16.1 (VDD), RGB17.1 (VDD), RGB18.1 (VDD), RGB19.1 (VDD), RGB20.1 (VDD), RGB21.1 (VDD), RGB22.1 (VDD), RGB23.1 (VDD), RGB24.1 (VDD), U2.2 (VCC), U3.2 (VCC), U5.4 (VCC), U6.3 (VI), USB1.2 (VBUS), USB1.11 (VBUS)
BackLight: R111.2, U1.39 (PB3)
CapLed: R35.1, U1.10 (PA0)
Col0: MX_FN1.1 (COL), MX_num+1.1 (COL), MX_num-1.1 (COL), MX_numEnter1.1 (COL), U1.29 (PA8)
Col1: MX_FN2.1 (COL), MX_num1.1 (COL), MX_num2.1 (COL), MX_num3.1 (COL), MX_num4.1 (COL), MX_num*1.1 (COL), U1.28 (PB15)
Col2: MX_FN3.1 (COL), MX_num5.1 (COL), MX_num6.1 (COL), MX_num7.1 (COL), MX_num/1.1 (COL), MX_numDel1.1 (COL), U1.27 (PB14)
Col3: MX_FN4.1 (COL), MX_Left1.1 (COL), MX_num8.1 (COL), MX_num9.1 (COL), MX_num10.1 (COL), MX_numLk1.1 (COL), U1.26 (PB13)
Col4: MX_Delete1.1 (COL), MX_Down1.1 (COL), MX_PrtSc1.1 (COL), MX_insert1.1 (COL), MX_up1.1 (COL), U1.25 (PB12)
Col5: MX_CapLk1.2 (ROW), MX_CapLk2.1 (COL), MX_ESC1.1 (COL), MX_LShift1.1 (COL), MX_`~1.1 (COL), MX_right1.1 (COL), MX_tab1.1 (COL), U1.19 (PB1)
Col6: MX_1.1 (COL), MX_A1.1 (COL), MX_LControl1.1 (COL), MX_LControl2.1 (COL), MX_Q1.1 (COL), MX_z1.1 (COL), U1.18 (PB0)
Col7: MX_2.1 (COL), MX_F1.1 (COL), MX_LWin1.1 (COL), MX_LWin2.1 (COL), MX_S1.1 (COL), MX_W1.1 (COL), MX_x1.1 (COL), U1.17 (PA7)
Col8: MX_3.1 (COL), MX_ALT1.1 (COL), MX_ALT2.1 (COL), MX_D1.1 (COL), MX_E1.1 (COL), MX_F2.1 (COL), MX_c1.1 (COL), U1.16 (PA6)
Col9: MX_4.1 (COL), MX_F3.1 (COL), MX_F4.1 (COL), MX_R1.1 (COL), MX_v1.1 (COL), U1.15 (PA5)
Col10: MX_5.1 (COL), MX_F5.1 (COL), MX_G1.1 (COL), MX_T1.1 (COL), MX_b1.1 (COL), U1.14 (PA4)
Col11: MX_6.1 (COL), MX_F6.1 (COL), MX_H1.1 (COL), MX_SpaceBar1.1 (COL), MX_SpaceBar2.1 (COL), MX_SpaceBar3.1 (COL), MX_Y1.1 (COL), MX_n1.1 (COL), U1.13 (PA3)
Col12: MX_7.1 (COL), MX_F7.1 (COL), MX_J1.1 (COL), MX_U1.1 (COL), MX_m1.1 (COL), U1.12 (PA2)
Col13: MX_8.1 (COL), MX_<1.1 (COL), MX_F8.1 (COL), MX_I1.1 (COL), MX_K1.1 (COL), U1.11 (PA1)
Col14: MX_9.1 (COL), MX_>1.1 (COL), MX_F9.1 (COL), MX_L1.1 (COL), MX_O1.1 (COL), U1.4 (PC15)
Col15: MX_10.1 (COL), MX_/?/1.1 (COL), MX_;1.1 (COL), MX_F10.1 (COL), MX_P1.1 (COL), MX_RAlt1.1 (COL), MX_RAlt2.1 (COL), U1.3 (PC14)
Col16: MX_'1.1 (COL), MX_-1.1 (COL), MX_F11.1 (COL), MX_RAlt3.1 (COL), MX_RWin1.1 (COL), MX_RWin2.1 (COL), MX_RWin3.1 (COL), MX_[1.1 (COL), U1.2 (PC13)
Col17: MX_+1.1 (COL), MX_F12.1 (COL), MX_]1.1 (COL), U1.45 (PB8)
Col18: MX_BkSp1.1 (COL), MX_ENTER1.1 (COL), MX_ENTER2.1 (COL), MX_F13.1 (COL), MX_RControl1.1 (COL), MX_RControl2.1 (COL), MX_RControl3.1 (COL), MX_RShift1.1 (COL), MX_|\1.1 (COL), MX_|\2.2 (ROW), U1.46 (PB9)
D+: R109.1, U1.33 (PA12)
D-: R110.1, U1.32 (PA11)
GND: C1.2, C2.2, C3.2, C4.1, C5.1, C6.1, C7.1, C8.1, C9.1, C10.1, C11.2, C12.2, MX_CapLk1.4 (LEDGND), MX_CapLk2.4 (LEDGND), MX_numLk1.4 (LEDGND), Q1.2 (S), R2.1, R107.1, R108.1, RGB1.3 (VSS), RGB2.3 (VSS), RGB3.3 (VSS), RGB4.3 (VSS), RGB5.3 (VSS), RGB6.3 (VSS), RGB7.3 (VSS), RGB8.3 (VSS), RGB9.3 (VSS), RGB10.3 (VSS), RGB11.3 (VSS), RGB12.3 (VSS), RGB13.3 (VSS), RGB14.3 (VSS), RGB15.3 (VSS), RGB16.3 (VSS), RGB17.3 (VSS), RGB18.3 (VSS), RGB19.3 (VSS), RGB20.3 (VSS), RGB21.3 (VSS), RGB22.3 (VSS), RGB23.3 (VSS), RGB24.3 (VSS), SW1.1, U1.8 (VSSA), U1.23 (VSS), U1.35 (VSS), U1.47 (VSS), U2.1 (GND), U3.1 (GND), U5.1 (GND), U6.1 (GND), USB1.1 (GND), USB1.12 (GND), USB1.13 (SHIELD), Y1.2, Y1.4
LedGND: Q1.3 (D), R3.2, R4.2, R5.2, R6.2, R7.2, R8.2, R9.2, R10.2, R11.2, R12.2, R13.2, R14.2, R15.2, R16.2, R17.2, R18.2, R19.2, R20.2, R21.2, R22.2, R23.2, R25.2, R26.2, R27.2, R28.2, R29.2, R30.2, R31.2, R32.2, R33.2, R34.2, R36.2, R37.2, R38.2, R39.2, R40.2, R41.2, R42.2, R43.2, R44.2, R45.2, R46.2, R47.2, R48.2, R49.2, R50.2, R51.2, R52.2, R53.2, R54.2, R55.2, R56.2, R57.2, R58.2, R59.2, R60.2, R61.2, R62.2, R63.2, R64.2, R65.2, R66.2, R67.2, R68.2, R69.2, R70.2, R71.2, R72.2, R73.2, R74.2, R75.2, R76.2, R77.2, R78.2, R79.2, R80.2, R81.2, R82.2, R83.2, R84.2, R85.2, R86.2, R87.2, R88.2, R89.2, R90.2, R91.2, R92.2, R93.2, R94.2, R95.2, R96.2, R97.2, R98.2, R99.2, R100.2, R101.2, R102.2, R103.2
LedRGB: R104.1, RGB1.4 (DIN)
unnamed: C1.1, U1.5 (PF0), Y1.1
unnamed: C2.1, R105.2, Y1.3
unnamed: C3.1, R1.2, SW1.2, U1.7 (NRST)
unnamed: D1.2 (A), MX_FN1.2 (ROW)
unnamed: D2.2 (A), MX_num-1.2 (ROW)
unnamed: D3.2 (A), MX_num+1.2 (ROW)
unnamed: D4.2 (A), MX_numEnter1.2 (ROW)
unnamed: D5.2 (A), MX_FN2.2 (ROW)
unnamed: D6.2 (A), MX_num*1.2 (ROW)
unnamed: D7.2 (A), MX_num1.2 (ROW)
unnamed: D8.2 (A), MX_num2.2 (ROW)
unnamed: D9.2 (A), MX_num3.2 (ROW)
unnamed: D10.2 (A), MX_num4.2 (ROW)
unnamed: D11.2 (A), MX_FN3.2 (ROW)
unnamed: D12.2 (A), MX_num/1.2 (ROW)
unnamed: D13.2 (A), MX_num5.2 (ROW)
unnamed: D14.2 (A), MX_num6.2 (ROW)
unnamed: D15.2 (A), MX_num7.2 (ROW)
unnamed: D16.2 (A), MX_numDel1.2 (ROW)
unnamed: D17.2 (A), MX_FN4.2 (ROW)
unnamed: D18.2 (A), MX_numLk1.2 (ROW)
unnamed: D19.2 (A), MX_num8.2 (ROW)
unnamed: D20.2 (A), MX_num9.2 (ROW)
unnamed: D21.2 (A), MX_num10.2 (ROW)
unnamed: D22.2 (A), MX_Left1.2 (ROW)
unnamed: D23.2 (A), MX_PrtSc1.2 (ROW)
unnamed: D24.2 (A), MX_insert1.2 (ROW)
unnamed: D25.2 (A), MX_Delete1.2 (ROW)
unnamed: D26.2 (A), MX_up1.2 (ROW)
unnamed: D27.2 (A), MX_Down1.2 (ROW)
unnamed: D28.2 (A), MX_ESC1.2 (ROW)
unnamed: D29.2 (A), MX_`~1.2 (ROW)
unnamed: D30.2 (A), MX_tab1.2 (ROW)
unnamed: D31.2 (A), MX_CapLk1.1 (COL), MX_CapLk2.2 (ROW)
unnamed: D32.2 (A), MX_LShift1.2 (ROW)
unnamed: D33.2 (A), MX_right1.2 (ROW)
unnamed: D34.2 (A), MX_1.2 (ROW)
unnamed: D35.2 (A), MX_Q1.2 (ROW)
unnamed: D36.2 (A), MX_A1.2 (ROW)
unnamed: D37.2 (A), MX_z1.2 (ROW)
unnamed: D38.2 (A), MX_LControl1.2 (ROW), MX_LControl2.2 (ROW)
unnamed: D39.2 (A), MX_F1.2 (ROW)
unnamed: D40.2 (A), MX_2.2 (ROW)
unnamed: D41.2 (A), MX_W1.2 (ROW)
unnamed: D42.2 (A), MX_S1.2 (ROW)
unnamed: D43.2 (A), MX_x1.2 (ROW)
unnamed: D44.2 (A), MX_LWin1.2 (ROW), MX_LWin2.2 (ROW)
unnamed: D45.2 (A), MX_F2.2 (ROW)
unnamed: D46.2 (A), MX_3.2 (ROW)
unnamed: D47.2 (A), MX_E1.2 (ROW)
unnamed: D48.2 (A), MX_D1.2 (ROW)
unnamed: D49.2 (A), MX_c1.2 (ROW)
unnamed: D50.2 (A), MX_ALT1.2 (ROW), MX_ALT2.2 (ROW)
unnamed: D51.2 (A), MX_F3.2 (ROW)
unnamed: D52.2 (A), MX_4.2 (ROW)
unnamed: D53.2 (A), MX_R1.2 (ROW)
unnamed: D54.2 (A), MX_F4.2 (ROW)
unnamed: D55.2 (A), MX_v1.2 (ROW)
unnamed: D56.2 (A), MX_F5.2 (ROW)
unnamed: D57.2 (A), MX_5.2 (ROW)
unnamed: D58.2 (A), MX_T1.2 (ROW)
unnamed: D59.2 (A), MX_G1.2 (ROW)
unnamed: D60.2 (A), MX_b1.2 (ROW)
unnamed: D61.2 (A), MX_F6.2 (ROW)
unnamed: D62.2 (A), MX_6.2 (ROW)
unnamed: D63.2 (A), MX_Y1.2 (ROW)
unnamed: D64.2 (A), MX_H1.2 (ROW)
unnamed: D65.2 (A), MX_n1.2 (ROW)
unnamed: D66.2 (A), MX_SpaceBar1.2 (ROW), MX_SpaceBar2.2 (ROW), MX_SpaceBar3.2 (ROW)
unnamed: D67.2 (A), MX_F7.2 (ROW)
unnamed: D68.2 (A), MX_7.2 (ROW)
unnamed: D69.2 (A), MX_U1.2 (ROW)
unnamed: D70.2 (A), MX_J1.2 (ROW)
unnamed: D71.2 (A), MX_m1.2 (ROW)
unnamed: D72.2 (A), MX_F8.2 (ROW)
unnamed: D73.2 (A), MX_8.2 (ROW)
unnamed: D74.2 (A), MX_I1.2 (ROW)
unnamed: D75.2 (A), MX_K1.2 (ROW)
unnamed: D76.2 (A), MX_<1.2 (ROW)
unnamed: D77.2 (A), MX_F9.2 (ROW)
unnamed: D78.2 (A), MX_9.2 (ROW)
unnamed: D79.2 (A), MX_O1.2 (ROW)
unnamed: D80.2 (A), MX_L1.2 (ROW)
unnamed: D81.2 (A), MX_>1.2 (ROW)
unnamed: D82.2 (A), MX_F10.2 (ROW)
unnamed: D83.2 (A), MX_10.2 (ROW)
unnamed: D84.2 (A), MX_P1.2 (ROW)
unnamed: D85.2 (A), MX_;1.2 (ROW)
unnamed: D86.2 (A), MX_/?/1.2 (ROW)
unnamed: D87.2 (A), MX_RAlt1.2 (ROW), MX_RAlt2.2 (ROW)
unnamed: D88.2 (A), MX_F11.2 (ROW)
unnamed: D89.2 (A), MX_-1.2 (ROW)
unnamed: D90.2 (A), MX_[1.2 (ROW)
unnamed: D91.2 (A), MX_'1.2 (ROW)
unnamed: D92.2 (A), MX_RAlt3.2 (ROW), MX_RWin1.2 (ROW), MX_RWin2.2 (ROW), MX_RWin3.2 (ROW)
unnamed: D93.2 (A), MX_F12.2 (ROW)
unnamed: D94.2 (A), MX_+1.2 (ROW)
unnamed: D95.2 (A), MX_]1.2 (ROW)
unnamed: D96.2 (A), MX_F13.2 (ROW)
unnamed: D97.2 (A), MX_BkSp1.2 (ROW)
unnamed: D98.2 (A), MX_ENTER1.2 (ROW), MX_|\2.1 (COL)
unnamed: D99.2 (A), MX_ENTER2.2 (ROW), MX_|\1.2 (ROW)
unnamed: D100.2 (A), MX_RShift1.2 (ROW)
unnamed: D101.2 (A), MX_RControl1.2 (ROW), MX_RControl2.2 (ROW), MX_RControl3.2 (ROW)
unnamed: MX_1.4 (LEDGND), R36.1
unnamed: MX_2.4 (LEDGND), R42.1
unnamed: MX_3.4 (LEDGND), R48.1
unnamed: MX_4.4 (LEDGND), R54.1
unnamed: MX_5.4 (LEDGND), R59.1
unnamed: MX_6.4 (LEDGND), R64.1
unnamed: MX_7.4 (LEDGND), R70.1
unnamed: MX_8.4 (LEDGND), R75.1
unnamed: MX_9.4 (LEDGND), R80.1
unnamed: MX_10.4 (LEDGND), R85.1
unnamed: MX_'1.4 (LEDGND), R93.1
unnamed: MX_+1.4 (LEDGND), R96.1
unnamed: MX_-1.4 (LEDGND), R91.1
unnamed: MX_/?/1.4 (LEDGND), R88.1
unnamed: MX_;1.4 (LEDGND), R87.1
unnamed: MX_<1.4 (LEDGND), R78.1
unnamed: MX_>1.4 (LEDGND), R83.1
unnamed: MX_A1.4 (LEDGND), R38.1
unnamed: MX_ALT1.4 (LEDGND), MX_ALT2.4 (LEDGND), R52.1
unnamed: MX_BkSp1.4 (LEDGND), R99.1
unnamed: MX_CapLk1.3 (LED), MX_CapLk2.3 (LED), R35.2
unnamed: MX_D1.4 (LEDGND), R50.1
unnamed: MX_Delete1.4 (LEDGND), R27.1
unnamed: MX_Down1.4 (LEDGND), R29.1
unnamed: MX_E1.4 (LEDGND), R49.1
unnamed: MX_ENTER1.4 (LEDGND), MX_|\2.4 (LEDGND), R100.1
unnamed: MX_ENTER2.4 (LEDGND), MX_|\1.4 (LEDGND), R101.1
unnamed: MX_ESC1.4 (LEDGND), R30.1
unnamed: MX_F1.4 (LEDGND), R41.1
unnamed: MX_F2.4 (LEDGND), R47.1
unnamed: MX_F3.4 (LEDGND), R53.1
unnamed: MX_F4.4 (LEDGND), R56.1
unnamed: MX_F5.4 (LEDGND), R58.1
unnamed: MX_F6.4 (LEDGND), R63.1
unnamed: MX_F7.4 (LEDGND), R69.1
unnamed: MX_F8.4 (LEDGND), R74.1
unnamed: MX_F9.4 (LEDGND), R79.1
unnamed: MX_F10.4 (LEDGND), R84.1
unnamed: MX_F11.4 (LEDGND), R90.1
unnamed: MX_F12.4 (LEDGND), R95.1
unnamed: MX_F13.4 (LEDGND), R98.1
unnamed: MX_FN1.4 (LEDGND), R3.1
unnamed: MX_FN2.4 (LEDGND), R7.1
unnamed: MX_FN3.4 (LEDGND), R13.1
unnamed: MX_FN4.4 (LEDGND), R19.1
unnamed: MX_G1.4 (LEDGND), R61.1
unnamed: MX_H1.4 (LEDGND), R66.1
unnamed: MX_I1.4 (LEDGND), R76.1
unnamed: MX_J1.4 (LEDGND), R72.1
unnamed: MX_K1.4 (LEDGND), R77.1
unnamed: MX_L1.4 (LEDGND), R82.1
unnamed: MX_LControl1.4 (LEDGND), MX_LControl2.4 (LEDGND), R40.1
unnamed: MX_LShift1.4 (LEDGND), R33.1
unnamed: MX_LWin1.4 (LEDGND), MX_LWin2.4 (LEDGND), R46.1
unnamed: MX_Left1.4 (LEDGND), R23.1
unnamed: MX_O1.4 (LEDGND), R81.1
unnamed: MX_P1.4 (LEDGND), R86.1
unnamed: MX_PrtSc1.4 (LEDGND), R25.1
unnamed: MX_Q1.4 (LEDGND), R37.1
unnamed: MX_R1.4 (LEDGND), R55.1
unnamed: MX_RAlt1.4 (LEDGND), MX_RAlt2.4 (LEDGND), R89.1
unnamed: MX_RAlt3.4 (LEDGND), MX_RWin1.4 (LEDGND), MX_RWin2.4 (LEDGND), MX_RWin3.4 (LEDGND), R94.1
unnamed: MX_RControl1.4 (LEDGND), MX_RControl2.4 (LEDGND), MX_RControl3.4 (LEDGND), R103.1
unnamed: MX_RShift1.4 (LEDGND), R102.1
unnamed: MX_S1.4 (LEDGND), R44.1
unnamed: MX_SpaceBar1.4 (LEDGND), MX_SpaceBar2.4 (LEDGND), MX_SpaceBar3.4 (LEDGND), R68.1
unnamed: MX_T1.4 (LEDGND), R60.1
unnamed: MX_U1.4 (LEDGND), R71.1
unnamed: MX_W1.4 (LEDGND), R43.1
unnamed: MX_Y1.4 (LEDGND), R65.1
unnamed: MX_[1.4 (LEDGND), R92.1
unnamed: MX_]1.4 (LEDGND), R97.1
unnamed: MX_`~1.4 (LEDGND), R31.1
unnamed: MX_b1.4 (LEDGND), R62.1
unnamed: MX_c1.4 (LEDGND), R51.1
unnamed: MX_insert1.4 (LEDGND), R26.1
unnamed: MX_m1.4 (LEDGND), R73.1
unnamed: MX_n1.4 (LEDGND), R67.1
unnamed: MX_num1.4 (LEDGND), R9.1
unnamed: MX_num2.4 (LEDGND), R10.1
unnamed: MX_num3.4 (LEDGND), R11.1
unnamed: MX_num4.4 (LEDGND), R12.1
unnamed: MX_num5.4 (LEDGND), R15.1
unnamed: MX_num6.4 (LEDGND), R16.1
unnamed: MX_num7.4 (LEDGND), R17.1
unnamed: MX_num8.4 (LEDGND), R20.1
unnamed: MX_num9.4 (LEDGND), R21.1
unnamed: MX_num10.4 (LEDGND), R22.1
unnamed: MX_num*1.4 (LEDGND), R8.1
unnamed: MX_num+1.4 (LEDGND), R5.1
unnamed: MX_num-1.4 (LEDGND), R4.1
unnamed: MX_num/1.4 (LEDGND), R14.1
unnamed: MX_numDel1.4 (LEDGND), R18.1
unnamed: MX_numEnter1.4 (LEDGND), R6.1
unnamed: MX_numLk1.3 (LED), R24.2
unnamed: MX_right1.4 (LEDGND), R34.1
unnamed: MX_tab1.4 (LEDGND), R32.1
unnamed: MX_up1.4 (LEDGND), R28.1
unnamed: MX_v1.4 (LEDGND), R57.1
unnamed: MX_x1.4 (LEDGND), R45.1
unnamed: MX_z1.4 (LEDGND), R39.1
unnamed: Q1.1 (G), R111.1
unnamed: R2.2, U1.44 (BOOT0)
unnamed: R104.2, U1.30 (PA9)
unnamed: R105.1, U1.6 (PF1)
unnamed: R107.2, USB1.4 (CC1)
unnamed: R108.2, USB1.10 (CC2)
unnamed: R109.2, U5.2 (IO1), USB1.6 (DP1), USB1.8 (DP2)
unnamed: R110.2, U5.3 (IO2), USB1.5 (DN2), USB1.7 (DN1)
unnamed: RGB1.2 (DOUT), RGB2.4 (DIN)
unnamed: RGB2.2 (DOUT), RGB3.4 (DIN)
unnamed: RGB3.2 (DOUT), RGB5.4 (DIN)
unnamed: RGB4.4 (DIN), RGB6.2 (DOUT)
unnamed: RGB5.2 (DOUT), RGB7.4 (DIN)
unnamed: RGB6.4 (DIN), RGB8.2 (DOUT)
unnamed: RGB7.2 (DOUT), RGB9.4 (DIN)
unnamed: RGB8.4 (DIN), RGB10.2 (DOUT)
unnamed: RGB10.4 (DIN), RGB12.2 (DOUT)
unnamed: RGB11.2 (DOUT), RGB13.4 (DIN)
unnamed: RGB9.2 (DOUT), RGB11.4 (DIN)
unnamed: RGB12.4 (DIN), RGB14.2 (DOUT)
unnamed: RGB13.2 (DOUT), RGB15.4 (DIN)
unnamed: RGB14.4 (DIN), RGB16.2 (DOUT)
unnamed: RGB15.2 (DOUT), RGB17.4 (DIN)
unnamed: RGB16.4 (DIN), RGB18.2 (DOUT)
unnamed: RGB17.2 (DOUT), RGB19.4 (DIN)
unnamed: RGB18.4 (DIN), RGB20.2 (DOUT)
unnamed: RGB19.2 (DOUT), RGB21.4 (DIN)
unnamed: RGB20.4 (DIN), RGB23.2 (DOUT)
unnamed: RGB21.2 (DOUT), RGB22.4 (DIN)
unnamed: RGB22.2 (DOUT), RGB24.4 (DIN)
unnamed: RGB23.4 (DIN), RGB24.2 (DOUT)
NumLed: R24.1, U1.40 (PB4)
Row0: D1.1 (K), D5.1 (K), D11.1 (K), D17.1 (K), D23.1 (K), D28.1 (K), D39.1 (K), D45.1 (K), D51.1 (K), D56.1 (K), D61.1 (K), D67.1 (K), D72.1 (K), D77.1 (K), D82.1 (K), D88.1 (K), D93.1 (K), D96.1 (K), U1.41 (PB5)
Row1: D2.1 (K), D6.1 (K), D12.1 (K), D18.1 (K), D24.1 (K), D29.1 (K), D34.1 (K), D40.1 (K), D46.1 (K), D52.1 (K), D57.1 (K), D62.1 (K), D68.1 (K), D73.1 (K), D78.1 (K), D83.1 (K), D89.1 (K), D94.1 (K), D97.1 (K), U1.42 (PB6)
Row2: D3.1 (K), D7.1 (K), D13.1 (K), D19.1 (K), D25.1 (K), D30.1 (K), D35.1 (K), D41.1 (K), D47.1 (K), D53.1 (K), D58.1 (K), D63.1 (K), D69.1 (K), D74.1 (K), D79.1 (K), D84.1 (K), D90.1 (K), D95.1 (K), D98.1 (K), U1.43 (PB7)
Row3: D8.1 (K), D14.1 (K), D20.1 (K), D31.1 (K), D36.1 (K), D42.1 (K), D48.1 (K), D54.1 (K), D59.1 (K), D64.1 (K), D70.1 (K), D75.1 (K), D80.1 (K), D85.1 (K), D91.1 (K), D99.1 (K), U1.31 (PA10)
Row4: D4.1 (K), D9.1 (K), D15.1 (K), D21.1 (K), D26.1 (K), D32.1 (K), D37.1 (K), D43.1 (K), D49.1 (K), D55.1 (K), D60.1 (K), D65.1 (K), D71.1 (K), D76.1 (K), D81.1 (K), D86.1 (K), D100.1 (K), U1.22 (PB11), U3.3 (SCL)
Row5: D10.1 (K), D16.1 (K), D22.1 (K), D27.1 (K), D33.1 (K), D38.1 (K), D44.1 (K), D50.1 (K), D66.1 (K), D87.1 (K), D92.1 (K), D101.1 (K), U1.21 (PB10), U3.4 (SDA)
SWCLK: U1.37 (PA14), U2.3 (SCL)
SWDIO: U1.34 (PA13), U2.4 (SDA)
VCC: C4.2, C5.2, C6.2, C7.2, C8.2, C9.2, C10.2, C12.1, R1.1, U1.1 (VBAT), U1.9 (VDDA), U1.24 (VDD), U1.36 (VDD), U1.48 (VDD), U6.2 (VO)

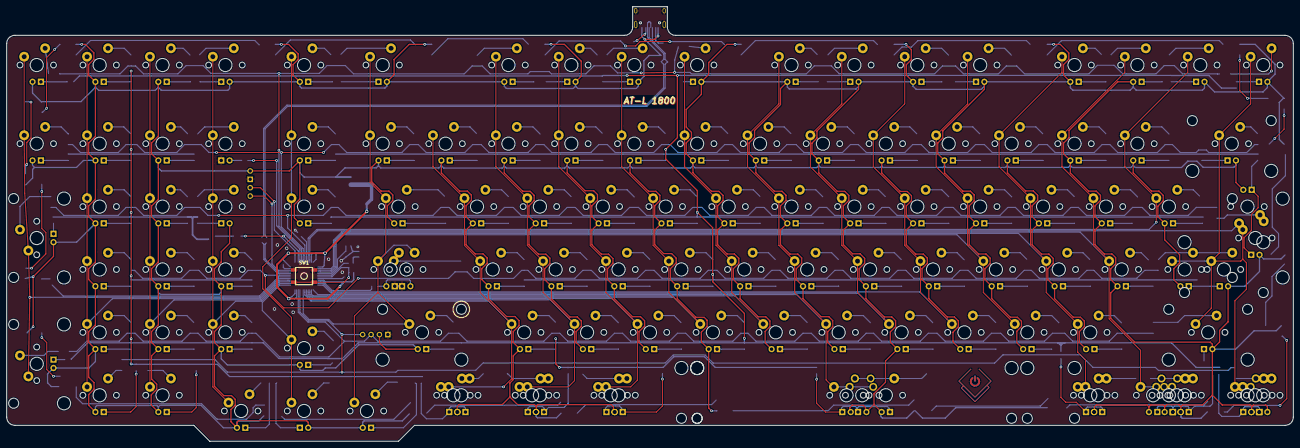
[picture p201: board 1800 layout.kicad_pcb from above]

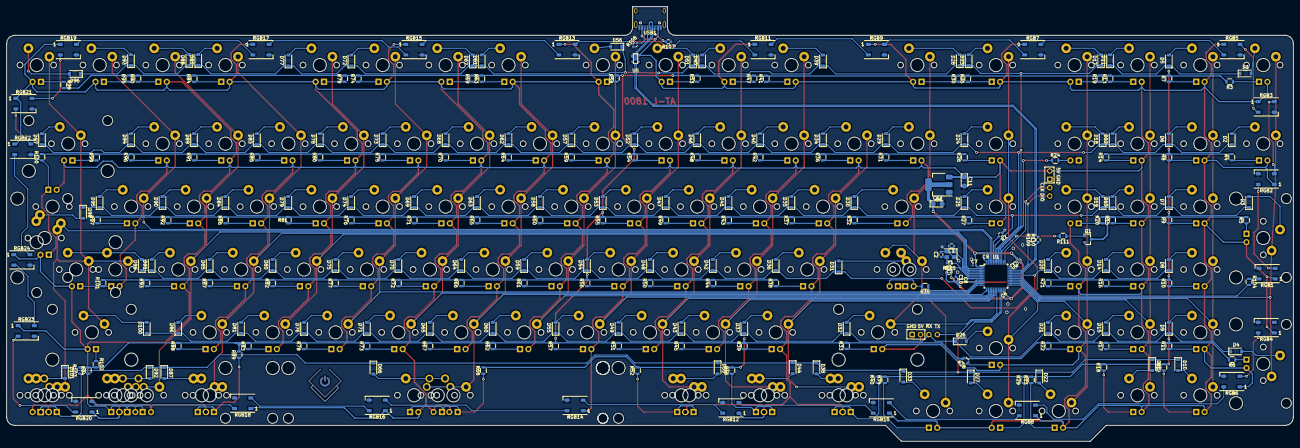
[picture p202: board 1800 layout.kicad_pcb from below]

Board: 2 copper layers, 389.7 x 131.6 mm, 372 parts (253 on the bottom side), 273 nets.
