MaiTheSan/PCB-Design/Commisuck/3xbar/3xbar.sch

## KiCad design Commisuck/3xbar/3xbar.sch (2022-11-19)

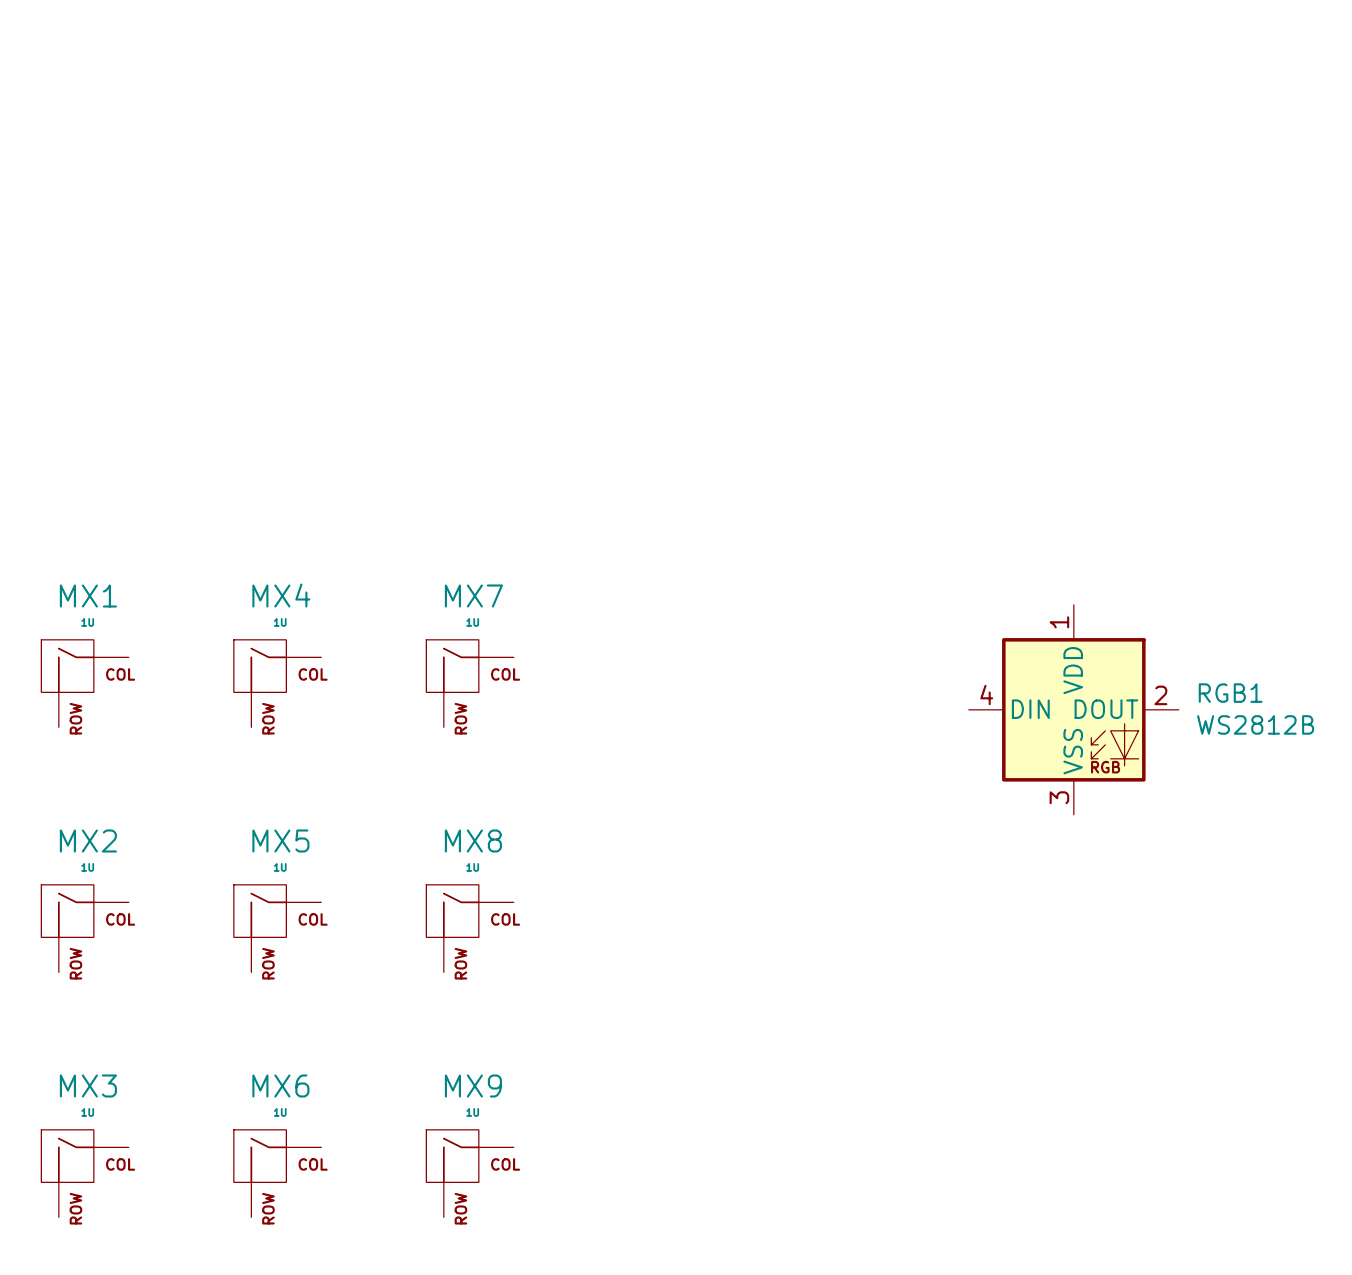
[picture p203: schematic 3xbar.sch, part in row 1, column 1]

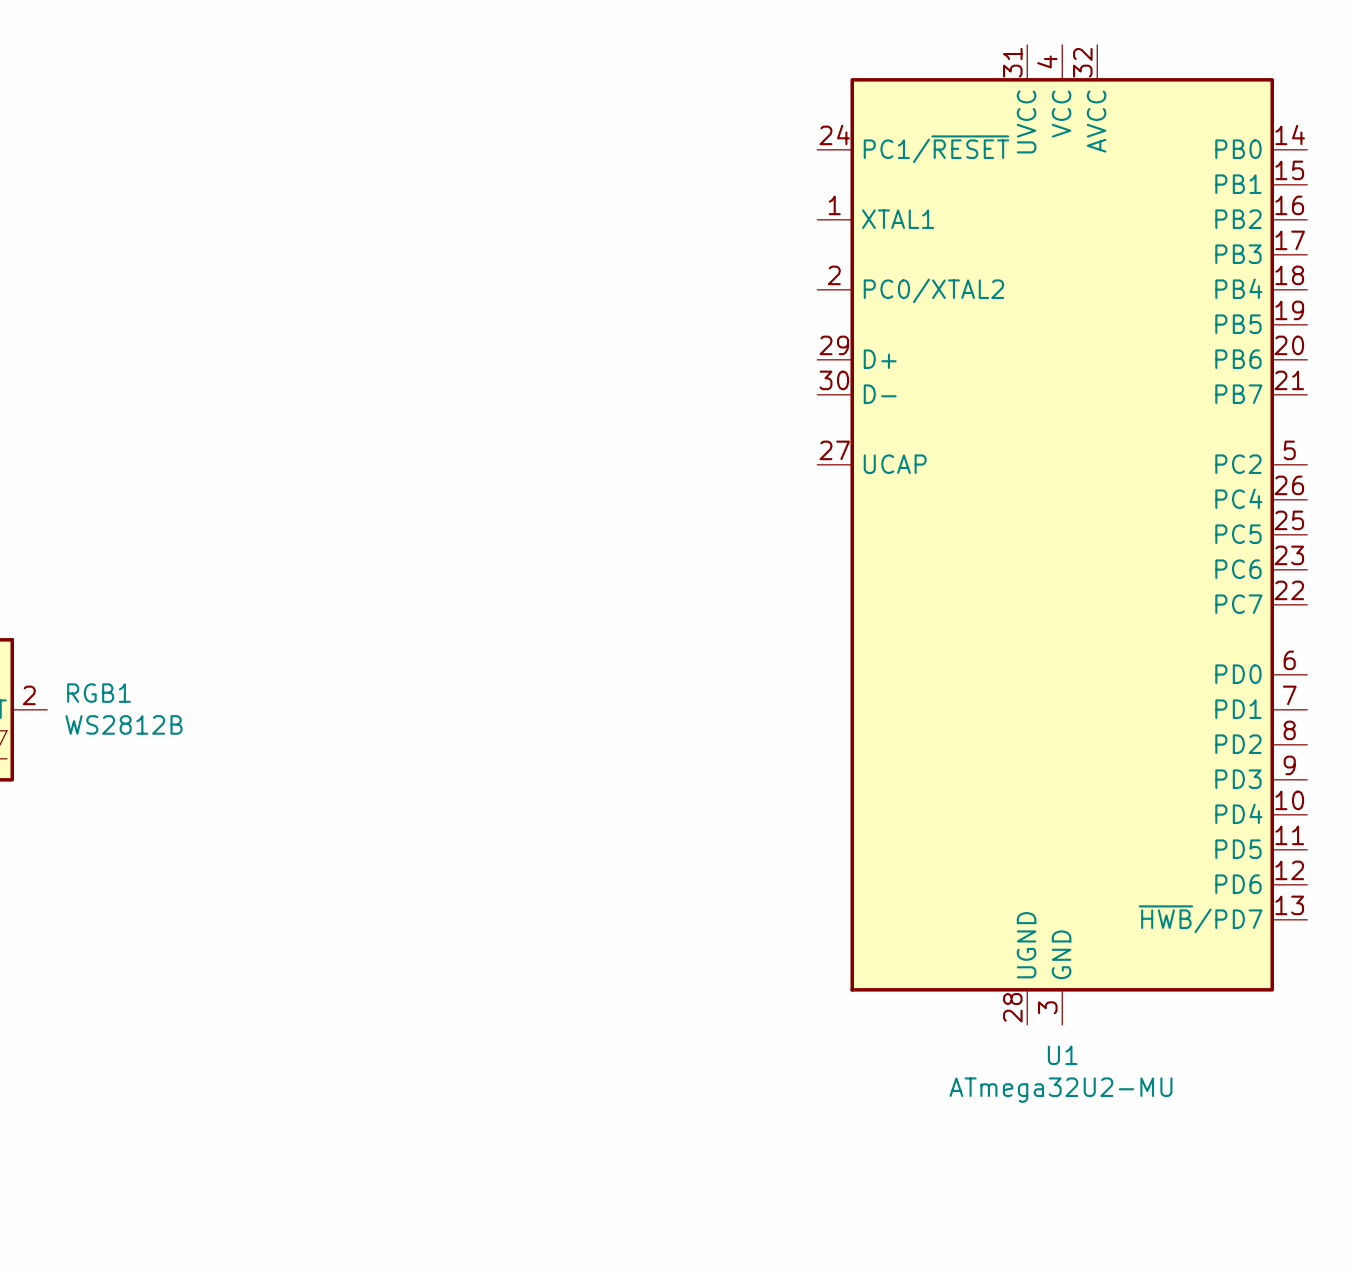
[picture p204: schematic 3xbar.sch, part in row 1, column 2]

Parts:
MX1, MX2, MX3, MX4, MX5, MX6, MX7, MX8, MX9: 1U; MXOnly-1U-Hotswap-Sawns
RGB1: WS2812B; LED_WS2812B_PLCC4_5.0x5.0mm_P3.2mm
U1: ATmega32U2-MU; QFN-32-1EP_5x5mm_P0.5mm_EP3.1x3.1mm

Connections:
unnamed: U1.3 (GND), U1.33 (GND)
