MaiTheSan/PCB-Design/KiCad/4-2022/Alice/RGB.kicad_sch

## KiCad design KiCad/4-2022/Alice/RGB.kicad_sch (2022-11-19)

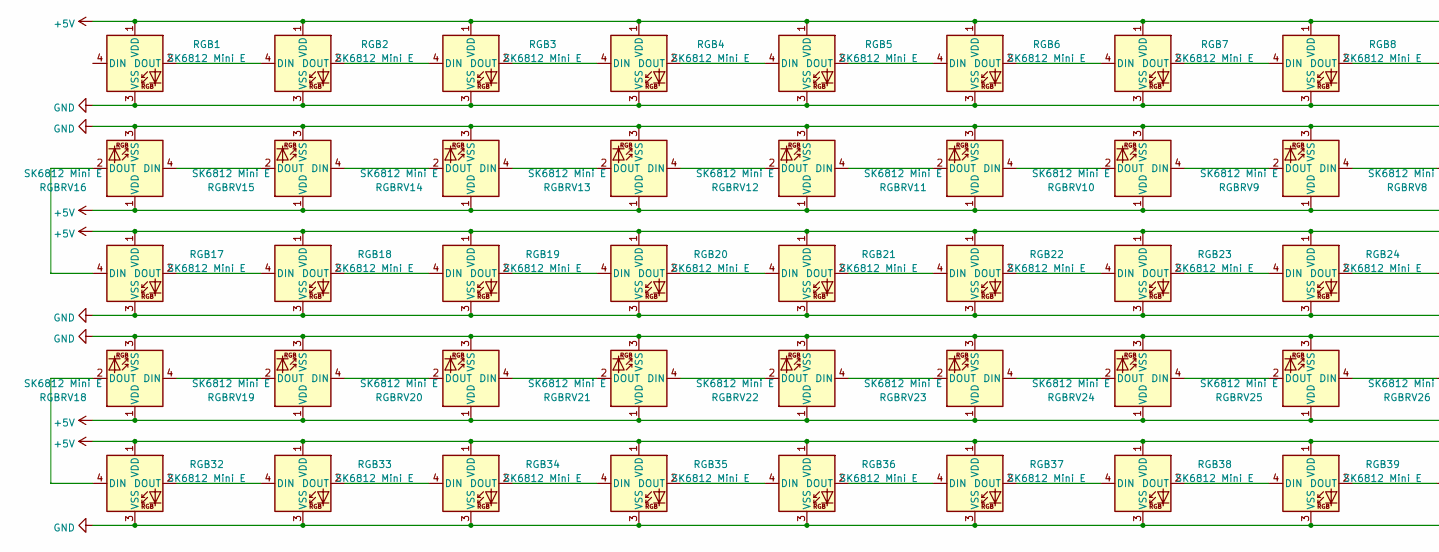
[picture p205: schematic RGB.kicad_sch, part in row 1, column 1]

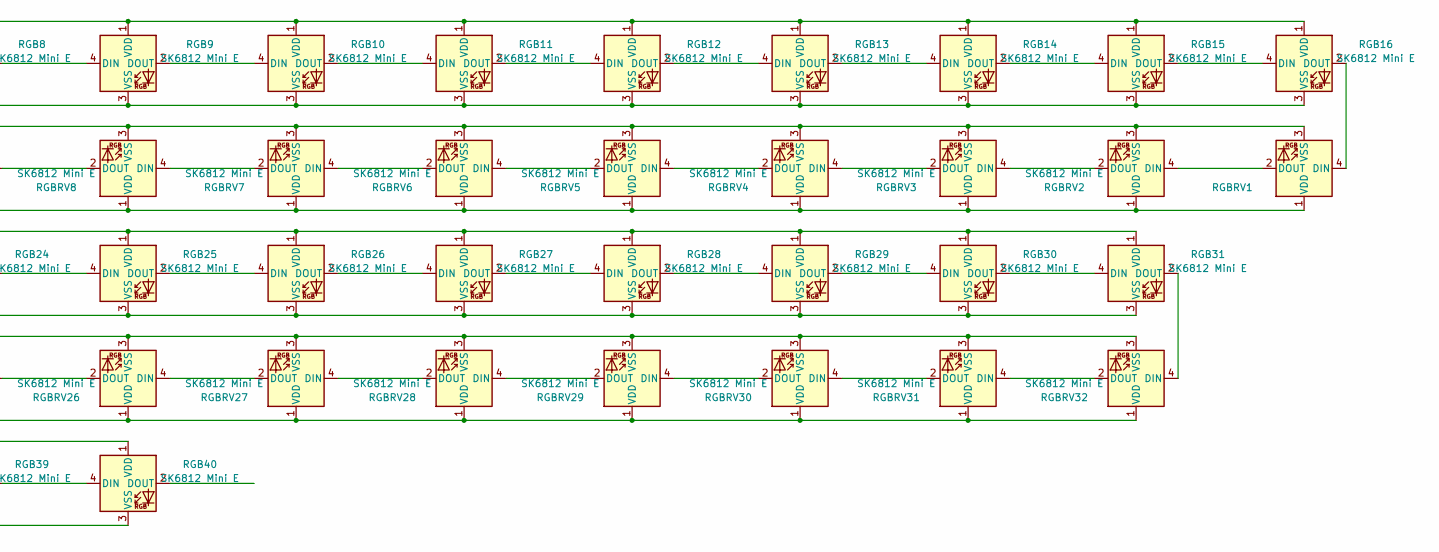
[picture p206: schematic RGB.kicad_sch, part in row 1, column 2]

Parts:
RGB1, RGB2, RGB3, RGB4, RGB5, RGB6, RGB7, RGB8, RGB9, RGB10, RGB11, RGB12, RGB13, RGB14, RGB15, RGB16, RGB17, RGB18, RGB19, RGB20, RGB21, RGB22, RGB23, RGB24, RGB25, RGB26, RGB27, RGB28, RGB29, RGB30, RGB31, RGB32, RGB33, RGB34, RGB35, RGB36, RGB37, RGB38, RGB39, RGB40: SK6812 Mini E; MX_SK6812MINI-E_REV
RGBRV1: (no value)
RGBRV2, RGBRV3, RGBRV4, RGBRV5, RGBRV6, RGBRV7, RGBRV8, RGBRV9, RGBRV10, RGBRV11, RGBRV12, RGBRV13, RGBRV14, RGBRV15, RGBRV16, RGBRV18, RGBRV19, RGBRV20, RGBRV21, RGBRV22, RGBRV23, RGBRV24, RGBRV25, RGBRV26, RGBRV27, RGBRV28, RGBRV29, RGBRV30, RGBRV31, RGBRV32: SK6812 Mini E; MX_SK6812MINI-E

Connections:
+5V: RGB1.1 (VDD), RGB2.1 (VDD), RGB3.1 (VDD), RGB4.1 (VDD), RGB5.1 (VDD), RGB6.1 (VDD), RGB7.1 (VDD), RGB8.1 (VDD), RGB9.1 (VDD), RGB10.1 (VDD), RGB11.1 (VDD), RGB12.1 (VDD), RGB13.1 (VDD), RGB14.1 (VDD), RGB15.1 (VDD), RGB16.1 (VDD), RGB17.1 (VDD), RGB18.1 (VDD), RGB19.1 (VDD), RGB20.1 (VDD), RGB21.1 (VDD), RGB22.1 (VDD), RGB23.1 (VDD), RGB24.1 (VDD), RGB25.1 (VDD), RGB26.1 (VDD), RGB27.1 (VDD), RGB28.1 (VDD), RGB29.1 (VDD), RGB30.1 (VDD), RGB31.1 (VDD), RGB32.1 (VDD), RGB33.1 (VDD), RGB34.1 (VDD), RGB35.1 (VDD), RGB36.1 (VDD), RGB37.1 (VDD), RGB38.1 (VDD), RGB39.1 (VDD), RGB40.1 (VDD)
GND: RGB1.3 (VSS), RGB2.3 (VSS), RGB3.3 (VSS), RGB4.3 (VSS), RGB5.3 (VSS), RGB6.3 (VSS), RGB7.3 (VSS), RGB8.3 (VSS), RGB9.3 (VSS), RGB10.3 (VSS), RGB11.3 (VSS), RGB12.3 (VSS), RGB13.3 (VSS), RGB14.3 (VSS), RGB15.3 (VSS), RGB16.3 (VSS), RGB17.3 (VSS), RGB18.3 (VSS), RGB19.3 (VSS), RGB20.3 (VSS), RGB21.3 (VSS), RGB22.3 (VSS), RGB23.3 (VSS), RGB24.3 (VSS), RGB25.3 (VSS), RGB26.3 (VSS), RGB27.3 (VSS), RGB28.3 (VSS), RGB29.3 (VSS), RGB30.3 (VSS), RGB31.3 (VSS), RGB32.3 (VSS), RGB33.3 (VSS), RGB34.3 (VSS), RGB35.3 (VSS), RGB36.3 (VSS), RGB37.3 (VSS), RGB38.3 (VSS), RGB39.3 (VSS), RGB40.3 (VSS)
unnamed: RGB1.2 (DOUT), RGB2.4 (DIN)
unnamed: RGB2.2 (DOUT), RGB3.4 (DIN)
unnamed: RGB3.2 (DOUT), RGB4.4 (DIN)
unnamed: RGB4.2 (DOUT), RGB5.4 (DIN)
unnamed: RGB5.2 (DOUT), RGB6.4 (DIN)
unnamed: RGB6.2 (DOUT), RGB7.4 (DIN)
unnamed: RGB7.2 (DOUT), RGB8.4 (DIN)
unnamed: RGB8.2 (DOUT), RGB9.4 (DIN)
unnamed: RGB10.2 (DOUT), RGB11.4 (DIN)
unnamed: RGB9.2 (DOUT), RGB10.4 (DIN)
unnamed: RGB11.2 (DOUT), RGB12.4 (DIN)
unnamed: RGB12.2 (DOUT), RGB13.4 (DIN)
unnamed: RGB13.2 (DOUT), RGB14.4 (DIN)
unnamed: RGB14.2 (DOUT), RGB15.4 (DIN)
unnamed: RGB15.2 (DOUT), RGB16.4 (DIN)
unnamed: RGB16.2 (DOUT), RGBRV1.4 (DIN)
unnamed: RGB17.2 (DOUT), RGB18.4 (DIN)
unnamed: RGB17.4 (DIN), RGBRV16.2 (DOUT)
unnamed: RGB18.2 (DOUT), RGB19.4 (DIN)
unnamed: RGB19.2 (DOUT), RGB20.4 (DIN)
unnamed: RGB20.2 (DOUT), RGB21.4 (DIN)
unnamed: RGB21.2 (DOUT), RGB22.4 (DIN)
unnamed: RGB22.2 (DOUT), RGB23.4 (DIN)
unnamed: RGB23.2 (DOUT), RGB24.4 (DIN)
unnamed: RGB24.2 (DOUT), RGB25.4 (DIN)
unnamed: RGB25.2 (DOUT), RGB26.4 (DIN)
unnamed: RGB26.2 (DOUT), RGB27.4 (DIN)
unnamed: RGB27.2 (DOUT), RGB28.4 (DIN)
unnamed: RGB28.2 (DOUT), RGB29.4 (DIN)
unnamed: RGB29.2 (DOUT), RGB30.4 (DIN)
unnamed: RGB30.2 (DOUT), RGB31.4 (DIN)
unnamed: RGB31.2 (DOUT), RGBRV32.4 (DIN)
unnamed: RGB32.2 (DOUT), RGB33.4 (DIN)
unnamed: RGB32.4 (DIN), RGBRV18.2 (DOUT)
unnamed: RGB33.2 (DOUT), RGB34.4 (DIN)
unnamed: RGB34.2 (DOUT), RGB35.4 (DIN)
unnamed: RGB35.2 (DOUT), RGB36.4 (DIN)
unnamed: RGB36.2 (DOUT), RGB37.4 (DIN)
unnamed: RGB37.2 (DOUT), RGB38.4 (DIN)
unnamed: RGB38.2 (DOUT), RGB39.4 (DIN)
unnamed: RGB39.2 (DOUT), RGB40.4 (DIN)
unnamed: RGBRV1.1 (VDD), RGBRV2.1 (VDD), RGBRV3.1 (VDD), RGBRV4.1 (VDD), RGBRV5.1 (VDD), RGBRV6.1 (VDD), RGBRV7.1 (VDD), RGBRV8.1 (VDD), RGBRV9.1 (VDD), RGBRV10.1 (VDD), RGBRV11.1 (VDD), RGBRV12.1 (VDD), RGBRV13.1 (VDD), RGBRV14.1 (VDD), RGBRV15.1 (VDD), RGBRV16.1 (VDD)
unnamed: RGBRV1.2 (DOUT), RGBRV2.4 (DIN)
unnamed: RGBRV1.3 (VSS), RGBRV2.3 (VSS), RGBRV3.3 (VSS), RGBRV4.3 (VSS), RGBRV5.3 (VSS), RGBRV6.3 (VSS), RGBRV7.3 (VSS), RGBRV8.3 (VSS), RGBRV9.3 (VSS), RGBRV10.3 (VSS), RGBRV11.3 (VSS), RGBRV12.3 (VSS), RGBRV13.3 (VSS), RGBRV14.3 (VSS), RGBRV15.3 (VSS), RGBRV16.3 (VSS)
unnamed: RGBRV2.2 (DOUT), RGBRV3.4 (DIN)
unnamed: RGBRV3.2 (DOUT), RGBRV4.4 (DIN)
unnamed: RGBRV4.2 (DOUT), RGBRV5.4 (DIN)
unnamed: RGBRV5.2 (DOUT), RGBRV6.4 (DIN)
unnamed: RGBRV6.2 (DOUT), RGBRV7.4 (DIN)
unnamed: RGBRV7.2 (DOUT), RGBRV8.4 (DIN)
unnamed: RGBRV8.2 (DOUT), RGBRV9.4 (DIN)
unnamed: RGBRV10.2 (DOUT), RGBRV11.4 (DIN)
unnamed: RGBRV9.2 (DOUT), RGBRV10.4 (DIN)
unnamed: RGBRV11.2 (DOUT), RGBRV12.4 (DIN)
unnamed: RGBRV12.2 (DOUT), RGBRV13.4 (DIN)
unnamed: RGBRV13.2 (DOUT), RGBRV14.4 (DIN)
unnamed: RGBRV14.2 (DOUT), RGBRV15.4 (DIN)
unnamed: RGBRV15.2 (DOUT), RGBRV16.4 (DIN)
unnamed: RGBRV18.1 (VDD), RGBRV19.1 (VDD), RGBRV20.1 (VDD), RGBRV21.1 (VDD), RGBRV22.1 (VDD), RGBRV23.1 (VDD), RGBRV24.1 (VDD), RGBRV25.1 (VDD), RGBRV26.1 (VDD), RGBRV27.1 (VDD), RGBRV28.1 (VDD), RGBRV29.1 (VDD), RGBRV30.1 (VDD), RGBRV31.1 (VDD), RGBRV32.1 (VDD)
unnamed: RGBRV18.3 (VSS), RGBRV19.3 (VSS), RGBRV20.3 (VSS), RGBRV21.3 (VSS), RGBRV22.3 (VSS), RGBRV23.3 (VSS), RGBRV24.3 (VSS), RGBRV25.3 (VSS), RGBRV26.3 (VSS), RGBRV27.3 (VSS), RGBRV28.3 (VSS), RGBRV29.3 (VSS), RGBRV30.3 (VSS), RGBRV31.3 (VSS), RGBRV32.3 (VSS)
unnamed: RGBRV18.4 (DIN), RGBRV19.2 (DOUT)
unnamed: RGBRV19.4 (DIN), RGBRV20.2 (DOUT)
unnamed: RGBRV20.4 (DIN), RGBRV21.2 (DOUT)
unnamed: RGBRV21.4 (DIN), RGBRV22.2 (DOUT)
unnamed: RGBRV22.4 (DIN), RGBRV23.2 (DOUT)
unnamed: RGBRV23.4 (DIN), RGBRV24.2 (DOUT)
unnamed: RGBRV24.4 (DIN), RGBRV25.2 (DOUT)
unnamed: RGBRV25.4 (DIN), RGBRV26.2 (DOUT)
unnamed: RGBRV26.4 (DIN), RGBRV27.2 (DOUT)
unnamed: RGBRV27.4 (DIN), RGBRV28.2 (DOUT)
unnamed: RGBRV28.4 (DIN), RGBRV29.2 (DOUT)
unnamed: RGBRV29.4 (DIN), RGBRV30.2 (DOUT)
unnamed: RGBRV30.4 (DIN), RGBRV31.2 (DOUT)
unnamed: RGBRV31.4 (DIN), RGBRV32.2 (DOUT)
