MaiTheSan/PCB-Design/KiCad/4-2022/Alice/SawnsProjectAlice.kicad_sch

## KiCad design KiCad/4-2022/Alice/SawnsProjectAlice.kicad_sch (2022-11-19)

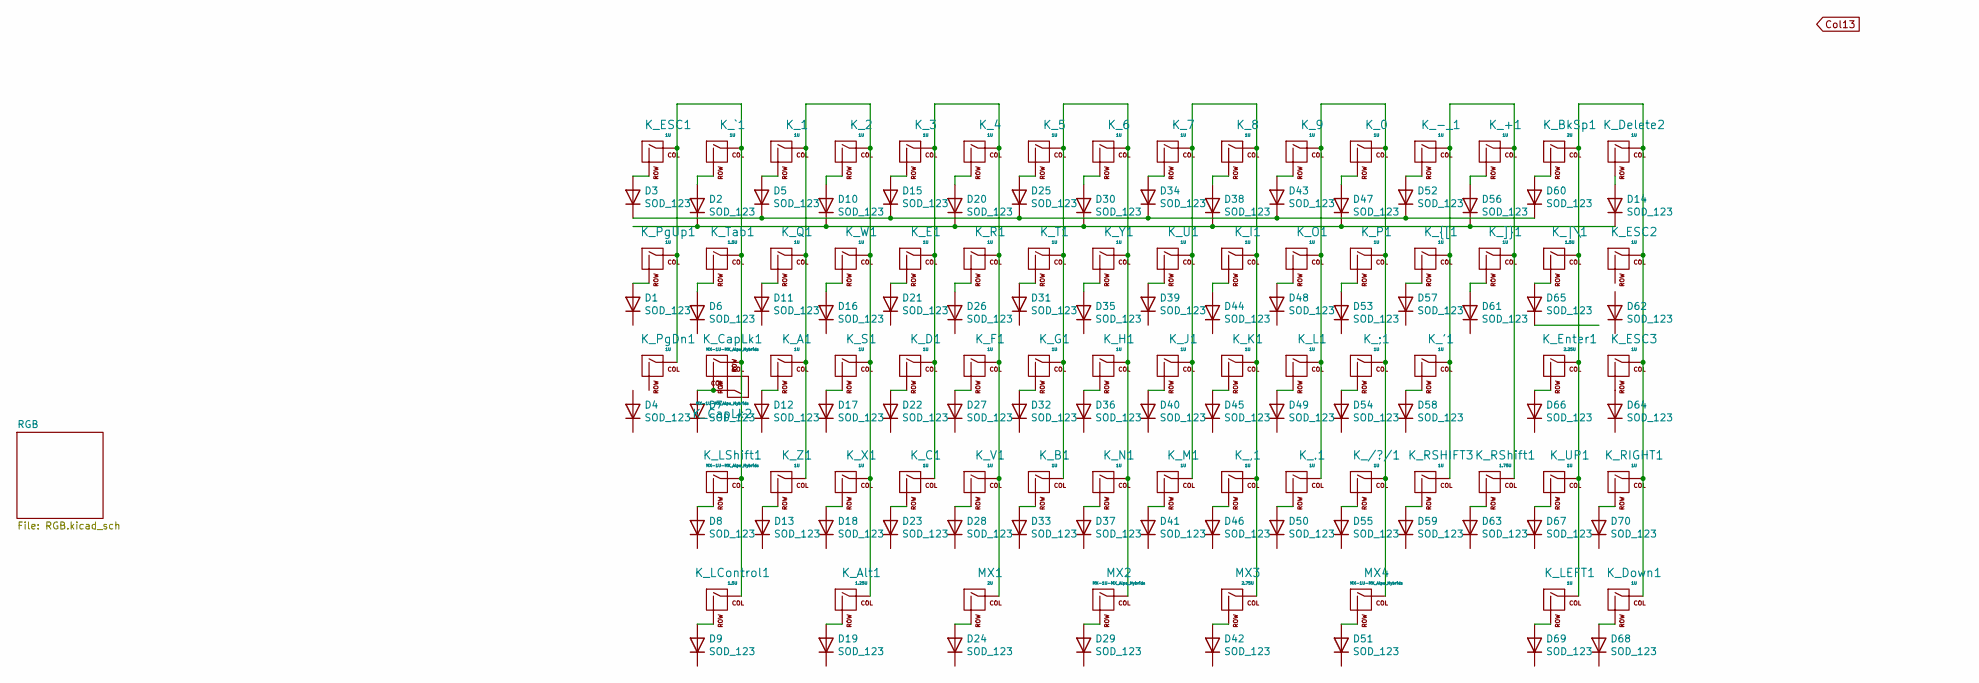
[picture p207: schematic SawnsProjectAlice.kicad_sch, part in row 1, column 1]

Parts:
D1, D2, D3, D4, D5, D6, D7, D8, D9, D10, D11, D12, D13, D14, D15, D16, D17, D18, D19, D20, D21, D22, D23, D24, D25, D26, D27, D28, D29, D30, D31, D32, D33, D34, D35, D36, D37, D38, D39, D40, D41, D42, D43, D44, D45, D46, D47, D48, D49, D50, D51, D52, D53, D54, D55, D56, D57, D58, D59, D60, D61, D62, D63, D64, D65, D66, D67, D68, D69, D70: SOD_123
K_0, K_1, K_2, K_3, K_4, K_5, K_6, K_7, K_8, K_9, K_.1: 1U; MXOnly-1U-Hotswap-Sawns
K_'1: 1U; MXOnly-1U-Hotswap-Sawns
K_+1: 1U; MXOnly-1U-Hotswap-Sawns
K_,1: 1U; MXOnly-1U-Hotswap-Sawns
K_-_1: 1U; MXOnly-1U-Hotswap-Sawns
K_/?/1: 1U; MXOnly-1U-Hotswap-Sawns
K_;1: 1U; MXOnly-1U-Hotswap-Sawns
K_A1: 1U; MXOnly-1U-Hotswap-Sawns
K_Alt1: 1.25U; MXOnly-1.25U-Hotswap-Sawns
K_B1: 1U; MXOnly-1U-Hotswap-Sawns
K_BkSp1: 2U; MXOnly-2U-Hotswap-Sawns
K_C1: 1U; MXOnly-1U-Hotswap-Sawns
K_CapLk1: MX-1U-MX_Alps_Hybrids; MXOnly-1.75U-Hotswap-Sawns
K_CapLk2: MX-1U-MX_Alps_Hybrids
K_D1: 1U; MXOnly-1U-Hotswap-Sawns
K_Delete2: 1U; MXOnly-1U-Hotswap-Sawns
K_Down1: 1U; MXOnly-1U-Hotswap-Sawns
K_E1: 1U; MXOnly-1U-Hotswap-Sawns
K_ESC1, K_ESC2, K_ESC3: 1U; MXOnly-1U-Hotswap-Sawns
K_Enter1: 2.25U; MXOnly-2.25U-Hotswap-ReversedStabilizers-Sawns
K_F1: 1U; MXOnly-1U-Hotswap-Sawns
K_G1: 1U; MXOnly-1U-Hotswap-Sawns
K_H1: 1U; MXOnly-1U-Hotswap-Sawns
K_I1: 1U; MXOnly-1U-Hotswap-Sawns
K_J1: 1U; MXOnly-1U-Hotswap-Sawns
K_K1: 1U; MXOnly-1U-Hotswap-Sawns
K_L1: 1U; MXOnly-1U-Hotswap-Sawns
K_LControl1: 1.5U; MXOnly-1.5U-Hotswap-Sawns
K_LEFT1: 1U; MXOnly-1U-Hotswap-Sawns
K_LShift1: MX-1U-MX_Alps_Hybrids; MXOnly-2.25U-Hotswap-ReversedStabilizers-Sawns
K_M1: 1U; MXOnly-1U-Hotswap-Sawns
K_N1: 1U; MXOnly-1U-Hotswap-Sawns
K_O1: 1U; MXOnly-1U-Hotswap-Sawns
K_P1: 1U; MXOnly-1U-Hotswap-Sawns
K_PgDn1: 1U; MXOnly-1U-Hotswap-Sawns
K_PgUp1: 1U; MXOnly-1U-Hotswap-Sawns
K_Q1: 1U; MXOnly-1U-Hotswap-Sawns
K_R1: 1U; MXOnly-1U-Hotswap-Sawns
K_RIGHT1: 1U; MXOnly-1U-Hotswap-Sawns
K_RSHIFT3: 1U; MXOnly-1U-Hotswap-Sawns
K_RShift1: 1.75U; MXOnly-1.75U-Hotswap-Sawns
K_S1: 1U; MXOnly-1U-Hotswap-Sawns
K_T1: 1U; MXOnly-1U-Hotswap-Sawns
K_Tab1: 1.5U; MXOnly-1.5U-Hotswap-Sawns
K_U1: 1U; MXOnly-1U-Hotswap-Sawns
K_UP1: 1U; MXOnly-1U-Hotswap-Sawns
K_V1: 1U; MXOnly-1U-Hotswap-Sawns
K_W1: 1U; MXOnly-1U-Hotswap-Sawns
K_X1: 1U; MXOnly-1U-Hotswap-Sawns
K_Y1: 1U; MXOnly-1U-Hotswap-Sawns
K_Z1: 1U; MXOnly-1U-Hotswap-Sawns
K_]}1: 1U; MXOnly-1U-Hotswap-Sawns
K_`1: 1U; MXOnly-1U-Hotswap-Sawns
K_{[1: 1U; MXOnly-1U-Hotswap-Sawns
K_|\1: 1.5U; MXOnly-1.5U-Hotswap-Sawns
MX1: 2U; MXOnly-2U-Hotswap-ReversedStabilizers-Sawns
MX2, MX4: MX-1U-MX_Alps_Hybrids; MXOnly-1U-Hotswap-Sawns
MX3: 2.75U; MXOnly-2.75U-Hotswap-ReversedStabilizers-Sawns

Connections:
unnamed: D1.2 (A), K_PgUp1.2 (ROW)
unnamed: D2.2 (A), K_`1.2 (ROW)
unnamed: D3.2 (A), K_ESC1.2 (ROW)
unnamed: D5.2 (A), K_1.2 (ROW)
unnamed: D6.2 (A), K_Tab1.2 (ROW)
unnamed: D7.2 (A), K_CapLk1.2 (ROW), K_CapLk2.1 (COL)
unnamed: D8.2 (A), K_LShift1.2 (ROW)
unnamed: D9.2 (A), K_LControl1.2 (ROW)
unnamed: D2.1 (K), D10.1 (K), D14.1 (K), D20.1 (K), D30.1 (K), D38.1 (K), D47.1 (K), D56.1 (K)
unnamed: D10.2 (A), K_2.2 (ROW)
unnamed: D11.2 (A), K_Q1.2 (ROW)
unnamed: D12.2 (A), K_A1.2 (ROW)
unnamed: D13.2 (A), K_Z1.2 (ROW)
unnamed: D14.2 (A), K_Delete2.2 (ROW)
unnamed: D3.1 (K), D5.1 (K), D15.1 (K), D25.1 (K), D34.1 (K), D43.1 (K), D52.1 (K), D60.1 (K)
unnamed: D15.2 (A), K_3.2 (ROW)
unnamed: D16.2 (A), K_W1.2 (ROW)
unnamed: D17.2 (A), K_S1.2 (ROW)
unnamed: D18.2 (A), K_X1.2 (ROW)
unnamed: D19.2 (A), K_Alt1.2 (ROW)
unnamed: D20.2 (A), K_4.2 (ROW)
unnamed: D21.2 (A), K_E1.2 (ROW)
unnamed: D22.2 (A), K_D1.2 (ROW)
unnamed: D23.2 (A), K_C1.2 (ROW)
unnamed: D24.2 (A), MX1.2 (ROW)
unnamed: D25.2 (A), K_5.2 (ROW)
unnamed: D26.2 (A), K_R1.2 (ROW)
unnamed: D27.2 (A), K_F1.2 (ROW)
unnamed: D28.2 (A), K_V1.2 (ROW)
unnamed: D29.2 (A), MX2.2 (ROW)
unnamed: D30.2 (A), K_6.2 (ROW)
unnamed: D31.2 (A), K_T1.2 (ROW)
unnamed: D32.2 (A), K_G1.2 (ROW)
unnamed: D33.2 (A), K_B1.2 (ROW)
unnamed: D34.2 (A), K_7.2 (ROW)
unnamed: D35.2 (A), K_Y1.2 (ROW)
unnamed: D36.2 (A), K_H1.2 (ROW)
unnamed: D37.2 (A), K_N1.2 (ROW)
unnamed: D38.2 (A), K_8.2 (ROW)
unnamed: D39.2 (A), K_U1.2 (ROW)
unnamed: D40.2 (A), K_J1.2 (ROW)
unnamed: D41.2 (A), K_M1.2 (ROW)
unnamed: D42.2 (A), MX3.2 (ROW)
unnamed: D43.2 (A), K_9.2 (ROW)
unnamed: D44.2 (A), K_I1.2 (ROW)
unnamed: D45.2 (A), K_K1.2 (ROW)
unnamed: D46.2 (A), K_,1.2 (ROW)
unnamed: D47.2 (A), K_0.2 (ROW)
unnamed: D48.2 (A), K_O1.2 (ROW)
unnamed: D49.2 (A), K_L1.2 (ROW)
unnamed: D50.2 (A), K_.1.2 (ROW)
unnamed: D51.2 (A), MX4.2 (ROW)
unnamed: D52.2 (A), K_-_1.2 (ROW)
unnamed: D53.2 (A), K_P1.2 (ROW)
unnamed: D54.2 (A), K_;1.2 (ROW)
unnamed: D55.2 (A), K_/?/1.2 (ROW)
unnamed: D56.2 (A), K_+1.2 (ROW)
unnamed: D57.2 (A), K_{[1.2 (ROW)
unnamed: D58.2 (A), K_'1.2 (ROW)
unnamed: D59.2 (A), K_RSHIFT3.2 (ROW)
unnamed: D60.2 (A), K_BkSp1.2 (ROW)
unnamed: D61.2 (A), K_]}1.2 (ROW)
unnamed: D63.2 (A), K_RShift1.2 (ROW)
unnamed: D64.2 (A), K_ESC3.2 (ROW)
unnamed: D65.2 (A), K_|\1.2 (ROW)
unnamed: D66.2 (A), K_Enter1.2 (ROW)
unnamed: D67.2 (A), K_UP1.2 (ROW)
unnamed: D68.2 (A), K_Down1.2 (ROW)
unnamed: D69.2 (A), K_LEFT1.2 (ROW)
unnamed: D70.2 (A), K_RIGHT1.2 (ROW)
unnamed: K_1.1 (COL), K_2.1 (COL), K_A1.1 (COL), K_Alt1.1 (COL), K_Q1.1 (COL), K_S1.1 (COL), K_W1.1 (COL), K_X1.1 (COL), K_Z1.1 (COL)
unnamed: K_3.1 (COL), K_4.1 (COL), K_C1.1 (COL), K_D1.1 (COL), K_E1.1 (COL), K_F1.1 (COL), K_R1.1 (COL), K_V1.1 (COL), MX1.1 (COL)
unnamed: K_5.1 (COL), K_6.1 (COL), K_B1.1 (COL), K_G1.1 (COL), K_H1.1 (COL), K_N1.1 (COL), K_T1.1 (COL), K_Y1.1 (COL), MX2.1 (COL)
unnamed: K_'1.1 (COL), K_+1.1 (COL), K_-_1.1 (COL), K_RSHIFT3.1 (COL), K_RShift1.1 (COL), K_]}1.1 (COL), K_{[1.1 (COL)
unnamed: K_7.1 (COL), K_8.1 (COL), K_,1.1 (COL), K_I1.1 (COL), K_J1.1 (COL), K_K1.1 (COL), K_M1.1 (COL), K_U1.1 (COL), MX3.1 (COL)
unnamed: K_0.1 (COL), K_9.1 (COL), K_.1.1 (COL), K_/?/1.1 (COL), K_;1.1 (COL), K_L1.1 (COL), K_O1.1 (COL), K_P1.1 (COL), MX4.1 (COL)
unnamed: K_BkSp1.1 (COL), K_Delete2.1 (COL), K_Down1.1 (COL), K_ESC2.1 (COL), K_ESC3.1 (COL), K_Enter1.1 (COL), K_LEFT1.1 (COL), K_RIGHT1.1 (COL), K_UP1.1 (COL), K_|\1.1 (COL)
unnamed: K_CapLk1.1 (COL), K_CapLk2.2 (ROW), K_ESC1.1 (COL), K_LControl1.1 (COL), K_LShift1.1 (COL), K_PgDn1.1 (COL), K_PgUp1.1 (COL), K_Tab1.1 (COL), K_`1.1 (COL)
