MaiTheSan/PCB-Design/KiCad/06-2022/Sisdr/sisdr.sch

## KiCad design KiCad/06-2022/Sisdr/sisdr.sch (2022-11-19)

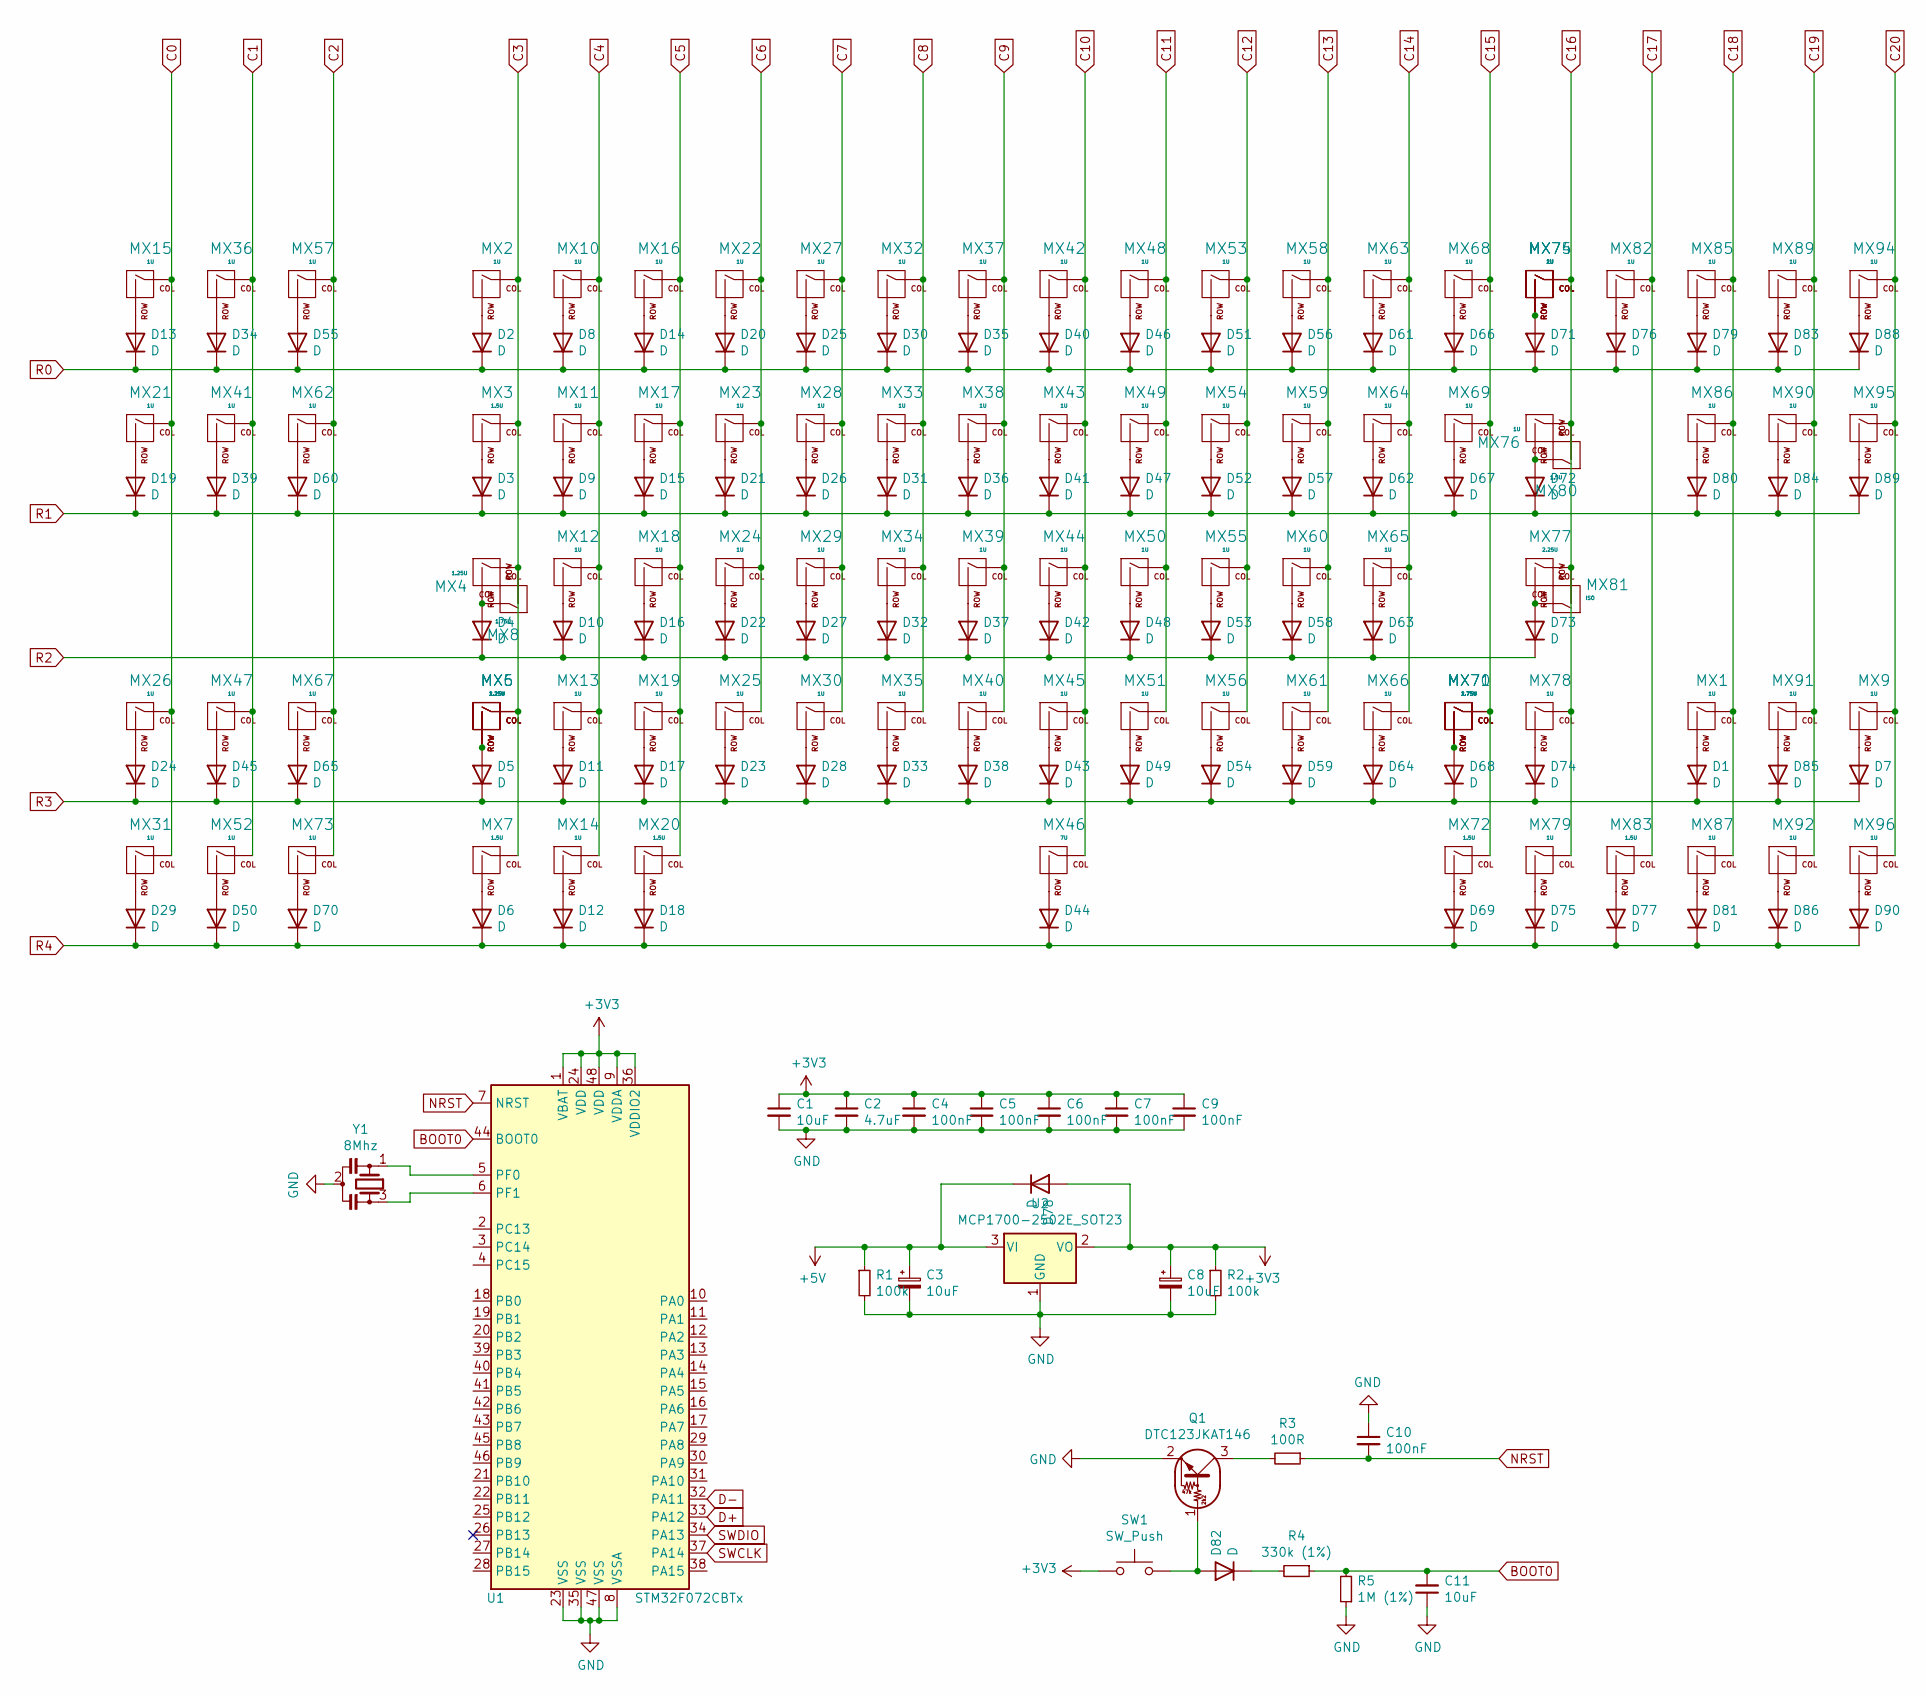
[picture p208: schematic sisdr.sch]

Parts:
C1, C3, C8, C11: 10uF; C_0603
C2: 4.7uF; C_0603
C4, C5, C6, C7, C9, C10: 100nF; C_0603
D1, D2, D3, D4, D5, D6, D7, D8, D9, D10, D11, D12, D13, D14, D15, D16, D17, D18, D19, D20, D21, D22, D23, D24, D25, D26, D27, D28, D29, D30, D31, D32, D33, D34, D35, D36, D37, D38, D39, D40, D41, D42, D43, D44, D45, D46, D47, D48, D49, D50, D51, D52, D53, D54, D55, D56, D57, D58, D59, D60, D61, D62, D63, D64, D65, D66, D67, D68, D69, D70, D71, D72, D73, D74, D75, D76, D77, D78, D79, D80, D81, D82, D83, D84, D85, D86, D88, D89, D90: D; DIODE_1206_SawnsProjects
MX1, MX2, MX9, MX10, MX11, MX12, MX13, MX14, MX15, MX16, MX17, MX18, MX19, MX21, MX22, MX23, MX24, MX25, MX26, MX27, MX28, MX29, MX30, MX31, MX32, MX33, MX34, MX35, MX36, MX37, MX38, MX39, MX40, MX41, MX42, MX43, MX44, MX45, MX47, MX48, MX49, MX50, MX51, MX52, MX53, MX54, MX55, MX56, MX57, MX58, MX59, MX60, MX61, MX62, MX63, MX64, MX65, MX66, MX67, MX68, MX69, MX73, MX74, MX76, MX78, MX79, MX82, MX85, MX86, MX87, MX89, MX90, MX91, MX92, MX94, MX95, MX96: 1U; MXOnly-1U-NoLED
MX3, MX7, MX20, MX72, MX80, MX83: 1.5U; MXOnly-1.5U-NoLED
MX4, MX5: 1.25U; MXOnly-1.25U-NoLED
MX6: 2.25U; MXOnly-2.25U-NoLED
MX8, MX70: 1.75U; MXOnly-1.75U-NoLED
MX46: 7U; MXOnly-7U-ReversedStabilizers-NoLED
MX71: 2.75U; MXOnly-2.75U-NoLED
MX75: 2U; MXOnly-2U-NoLED
MX77: 2.25U; MXOnly-2.25U-ReversedStabilizers-NoLED
MX81: ISO; MXOnly-ISO-ROTATED-ReversedStabilizers-NoLED
Q1: DTC123JKAT146
R1, R2: 100k; R_0805
R3: 100R; R_0805
R4: 330k (1%); R_0805
R5: 1M (1%); R_0805
SW1: SW_Push; SKQG-1155865-fix
U1: STM32F072CBTx; LQFP-48_7x7mm_P0.5mm
U2: MCP1700-2502E_SOT23; SOT-23
Y1: 8Mhz; Resonator_SMD_muRata_CSTxExxV-3Pin_3.0x1.1mm

Connections:
+3V3: C1.1, C2.1, C4.1, C5.1, C6.1, C7.1, C8.1, C9.1, D78.2 (A), R2.1, SW1.1, U1.1 (VBAT), U1.9 (VDDA), U1.24 (VDD), U1.36 (VDDIO2), U1.48 (VDD), U2.2 (VO)
+5V: C3.1, D78.1 (K), R1.1, U2.3 (VI)
BOOT0: C11.2, R4.1, R5.2, U1.44 (BOOT0)
C0: MX15.1 (COL), MX21.1 (COL), MX26.1 (COL), MX31.1 (COL)
C1: MX36.1 (COL), MX41.1 (COL), MX47.1 (COL), MX52.1 (COL)
C2: MX57.1 (COL), MX62.1 (COL), MX67.1 (COL), MX73.1 (COL)
C3: MX2.1 (COL), MX3.1 (COL), MX4.1 (COL), MX5.1 (COL), MX6.1 (COL), MX7.1 (COL), MX8.2 (ROW)
C4: MX10.1 (COL), MX11.1 (COL), MX12.1 (COL), MX13.1 (COL), MX14.1 (COL)
C5: MX16.1 (COL), MX17.1 (COL), MX18.1 (COL), MX19.1 (COL), MX20.1 (COL)
C6: MX22.1 (COL), MX23.1 (COL), MX24.1 (COL), MX25.1 (COL)
C7: MX27.1 (COL), MX28.1 (COL), MX29.1 (COL), MX30.1 (COL)
C8: MX32.1 (COL), MX33.1 (COL), MX34.1 (COL), MX35.1 (COL)
C9: MX37.1 (COL), MX38.1 (COL), MX39.1 (COL), MX40.1 (COL)
C10: MX42.1 (COL), MX43.1 (COL), MX44.1 (COL), MX45.1 (COL), MX46.1 (COL)
C11: MX48.1 (COL), MX49.1 (COL), MX50.1 (COL), MX51.1 (COL)
C12: MX53.1 (COL), MX54.1 (COL), MX55.1 (COL), MX56.1 (COL)
C13: MX58.1 (COL), MX59.1 (COL), MX60.1 (COL), MX61.1 (COL)
C14: MX63.1 (COL), MX64.1 (COL), MX65.1 (COL), MX66.1 (COL)
C15: MX68.1 (COL), MX69.1 (COL), MX70.1 (COL), MX71.1 (COL), MX72.1 (COL)
C16: MX74.1 (COL), MX75.1 (COL), MX76.1 (COL), MX77.1 (COL), MX78.1 (COL), MX79.1 (COL), MX80.2 (ROW), MX81.2 (ROW)
C17: MX82.1 (COL), MX83.1 (COL)
C18: MX1.1 (COL), MX85.1 (COL), MX86.1 (COL), MX87.1 (COL)
C19: MX89.1 (COL), MX90.1 (COL), MX91.1 (COL), MX92.1 (COL)
C20: MX9.1 (COL), MX94.1 (COL), MX95.1 (COL), MX96.1 (COL)
D+: U1.33 (PA12)
D-: U1.32 (PA11)
GND: C1.2, C2.2, C3.2, C4.2, C5.2, C6.2, C7.2, C8.2, C9.2, C10.1, C11.1, Q1.2 (E), R1.2, R2.2, R5.1, U1.8 (VSSA), U1.23 (VSS), U1.35 (VSS), U1.47 (VSS), U2.1 (GND), Y1.2
NRST: C10.2, R3.1, U1.7 (NRST)
unnamed: D1.2 (A), MX1.2 (ROW)
unnamed: D2.2 (A), MX2.2 (ROW)
unnamed: D3.2 (A), MX3.2 (ROW)
unnamed: D4.2 (A), MX4.2 (ROW), MX8.1 (COL)
unnamed: D5.2 (A), MX5.2 (ROW), MX6.2 (ROW)
unnamed: D6.2 (A), MX7.2 (ROW)
unnamed: D7.2 (A), MX9.2 (ROW)
unnamed: D8.2 (A), MX10.2 (ROW)
unnamed: D9.2 (A), MX11.2 (ROW)
unnamed: D10.2 (A), MX12.2 (ROW)
unnamed: D11.2 (A), MX13.2 (ROW)
unnamed: D12.2 (A), MX14.2 (ROW)
unnamed: D13.2 (A), MX15.2 (ROW)
unnamed: D14.2 (A), MX16.2 (ROW)
unnamed: D15.2 (A), MX17.2 (ROW)
unnamed: D16.2 (A), MX18.2 (ROW)
unnamed: D17.2 (A), MX19.2 (ROW)
unnamed: D18.2 (A), MX20.2 (ROW)
unnamed: D19.2 (A), MX21.2 (ROW)
unnamed: D20.2 (A), MX22.2 (ROW)
unnamed: D21.2 (A), MX23.2 (ROW)
unnamed: D22.2 (A), MX24.2 (ROW)
unnamed: D23.2 (A), MX25.2 (ROW)
unnamed: D24.2 (A), MX26.2 (ROW)
unnamed: D25.2 (A), MX27.2 (ROW)
unnamed: D26.2 (A), MX28.2 (ROW)
unnamed: D27.2 (A), MX29.2 (ROW)
unnamed: D28.2 (A), MX30.2 (ROW)
unnamed: D29.2 (A), MX31.2 (ROW)
unnamed: D30.2 (A), MX32.2 (ROW)
unnamed: D31.2 (A), MX33.2 (ROW)
unnamed: D32.2 (A), MX34.2 (ROW)
unnamed: D33.2 (A), MX35.2 (ROW)
unnamed: D34.2 (A), MX36.2 (ROW)
unnamed: D35.2 (A), MX37.2 (ROW)
unnamed: D36.2 (A), MX38.2 (ROW)
unnamed: D37.2 (A), MX39.2 (ROW)
unnamed: D38.2 (A), MX40.2 (ROW)
unnamed: D39.2 (A), MX41.2 (ROW)
unnamed: D40.2 (A), MX42.2 (ROW)
unnamed: D41.2 (A), MX43.2 (ROW)
unnamed: D42.2 (A), MX44.2 (ROW)
unnamed: D43.2 (A), MX45.2 (ROW)
unnamed: D44.2 (A), MX46.2 (ROW)
unnamed: D45.2 (A), MX47.2 (ROW)
unnamed: D46.2 (A), MX48.2 (ROW)
unnamed: D47.2 (A), MX49.2 (ROW)
unnamed: D48.2 (A), MX50.2 (ROW)
unnamed: D49.2 (A), MX51.2 (ROW)
unnamed: D50.2 (A), MX52.2 (ROW)
unnamed: D51.2 (A), MX53.2 (ROW)
unnamed: D52.2 (A), MX54.2 (ROW)
unnamed: D53.2 (A), MX55.2 (ROW)
unnamed: D54.2 (A), MX56.2 (ROW)
unnamed: D55.2 (A), MX57.2 (ROW)
unnamed: D56.2 (A), MX58.2 (ROW)
unnamed: D57.2 (A), MX59.2 (ROW)
unnamed: D58.2 (A), MX60.2 (ROW)
unnamed: D59.2 (A), MX61.2 (ROW)
unnamed: D60.2 (A), MX62.2 (ROW)
unnamed: D61.2 (A), MX63.2 (ROW)
unnamed: D62.2 (A), MX64.2 (ROW)
unnamed: D63.2 (A), MX65.2 (ROW)
unnamed: D64.2 (A), MX66.2 (ROW)
unnamed: D65.2 (A), MX67.2 (ROW)
unnamed: D66.2 (A), MX68.2 (ROW)
unnamed: D67.2 (A), MX69.2 (ROW)
unnamed: D68.2 (A), MX70.2 (ROW), MX71.2 (ROW)
unnamed: D69.2 (A), MX72.2 (ROW)
unnamed: D70.2 (A), MX73.2 (ROW)
unnamed: D71.2 (A), MX74.2 (ROW), MX75.2 (ROW)
unnamed: D72.2 (A), MX76.2 (ROW), MX80.1 (COL)
unnamed: D73.2 (A), MX77.2 (ROW), MX81.1 (COL)
unnamed: D74.2 (A), MX78.2 (ROW)
unnamed: D75.2 (A), MX79.2 (ROW)
unnamed: D76.2 (A), MX82.2 (ROW)
unnamed: D77.2 (A), MX83.2 (ROW)
unnamed: D79.2 (A), MX85.2 (ROW)
unnamed: D80.2 (A), MX86.2 (ROW)
unnamed: D81.2 (A), MX87.2 (ROW)
unnamed: D82.1 (K), R4.2
unnamed: D82.2 (A), Q1.1 (B), SW1.2
unnamed: D83.2 (A), MX89.2 (ROW)
unnamed: D84.2 (A), MX90.2 (ROW)
unnamed: D85.2 (A), MX91.2 (ROW)
unnamed: D86.2 (A), MX92.2 (ROW)
unnamed: D88.2 (A), MX94.2 (ROW)
unnamed: D89.2 (A), MX95.2 (ROW)
unnamed: D90.2 (A), MX96.2 (ROW)
unnamed: Q1.3 (C), R3.2
unnamed: U1.5 (PF0), Y1.1
unnamed: U1.6 (PF1), Y1.3
R0: D2.1 (K), D8.1 (K), D13.1 (K), D14.1 (K), D20.1 (K), D25.1 (K), D30.1 (K), D34.1 (K), D35.1 (K), D40.1 (K), D46.1 (K), D51.1 (K), D55.1 (K), D56.1 (K), D61.1 (K), D66.1 (K), D71.1 (K), D76.1 (K), D79.1 (K), D83.1 (K), D88.1 (K)
R1: D3.1 (K), D9.1 (K), D15.1 (K), D19.1 (K), D21.1 (K), D26.1 (K), D31.1 (K), D36.1 (K), D39.1 (K), D41.1 (K), D47.1 (K), D52.1 (K), D57.1 (K), D60.1 (K), D62.1 (K), D67.1 (K), D72.1 (K), D80.1 (K), D84.1 (K), D89.1 (K)
R2: D4.1 (K), D10.1 (K), D16.1 (K), D22.1 (K), D27.1 (K), D32.1 (K), D37.1 (K), D42.1 (K), D48.1 (K), D53.1 (K), D58.1 (K), D63.1 (K), D73.1 (K)
R3: D1.1 (K), D5.1 (K), D7.1 (K), D11.1 (K), D17.1 (K), D23.1 (K), D24.1 (K), D28.1 (K), D33.1 (K), D38.1 (K), D43.1 (K), D45.1 (K), D49.1 (K), D54.1 (K), D59.1 (K), D64.1 (K), D65.1 (K), D68.1 (K), D74.1 (K), D85.1 (K)
R4: D6.1 (K), D12.1 (K), D18.1 (K), D29.1 (K), D44.1 (K), D50.1 (K), D69.1 (K), D70.1 (K), D75.1 (K), D77.1 (K), D81.1 (K), D86.1 (K), D90.1 (K)
SWCLK: U1.37 (PA14)
SWDIO: U1.34 (PA13)
