MaiTheSan/PCB-Design/KiCad/07-2021/Evergarden/1800 layout.sch

## KiCad design KiCad/07-2021/Evergarden/1800 layout.sch (2022-11-19)

Schematic: 1800 layout.sch

Parts:
C1, C2: 22pF; C_0603
C3, C5, C6, C7, C9: 0.1uF; C_0402_1005Metric
C4: 10uF; C_0603
C8: 10nF; C_0402_1005Metric
C10: 1uF; C_0603
C11, C12: >=22uF; CP_EIA-3216-12_Kemet-S
D1, D2, D3, D4, D5, D6, D7, D8, D9, D10, D11, D12, D13, D14, D15, D16, D17, D18, D19, D20, D21, D22, D23, D24, D25, D26, D27, D28, D29, D30, D31, D32, D33, D34, D35, D36, D37, D38, D39, D40, D41, D42, D43, D44, D45, D46, D47, D48, D49, D50, D51, D52, D53, D54, D55, D56, D57, D58, D59, D60, D61, D62, D63, D64, D65, D66, D67, D68, D69, D70, D71, D72, D73, D74, D75, D76, D77, D78, D79, D80, D81, D82, D83, D84, D85, D86, D87, D88, D89, D90, D91, D92, D93, D94, D95, D96, D97, D98, D99, D100, D101: SOD123; D_SOD-323_HandSoldering
D102, D104, D105: LED; MXOnly-LEDONLY
D103: LED; MXOnly-LEDONLY-FLIPPED
D106, D107, D108: LED; MXOnly-LEDONLY-MID
LOGO1: Logo_Open_Hardware_Large; sanpjxlogo
MX_1, MX_2, MX_3, MX_4, MX_5, MX_6, MX_7, MX_8, MX_9, MX_10: 1U; MXOnly-1U
MX_'1: 1U; MXOnly-1U
MX_+1: 1U; MXOnly-1U
MX_-1: 1U; MXOnly-1U
MX_/?/1: 1U; MXOnly-1U
MX_;1: 1U; MXOnly-1U
MX_<1: 1U; MXOnly-1U
MX_>1: 1U; MXOnly-1U
MX_A1: 1U; MXOnly-1U
MX_ALT1: 1,5U; MXOnly-1.5U
MX_ALT2: 1,25U FLIPPED; MXOnly-1.25U-FLIPPED
MX_BkSp1: 2U FLIPPED; MXOnly-2U
MX_CapLk1: 1,75U; MXOnly-1.75U
MX_CapLk2: 1,25U FLIPPED; MXOnly-1.25U-FLIPPED
MX_D1: 1U; MXOnly-1U
MX_Delete1: 1U; MXOnly-1U
MX_Down1: 1U; MXOnly-1U
MX_E1: 1U; MXOnly-1U
MX_ENTER1: 2x2.25U ISO enter; MXOnly-ISO-ROTATED-ReversedStabilizers-NoLED
MX_ENTER2: 2,25U FLIPPED; MXOnly-2.25U-ReversedStabilizers-NoLED
MX_ESC1: 1U FLIPPED; MXOnly-1U
MX_F1, MX_F4, MX_F5, MX_F6, MX_F8, MX_F10, MX_F11: 1U; MXOnly-1U
MX_F2, MX_F7, MX_F9, MX_F12, MX_F13: 1U FLIPPED; MXOnly-1U
MX_F3: 1U FLIPPED; MXOnly-1U-FLIPPED
MX_FN1, MX_FN2, MX_FN3: 1U; MXOnly-1U
MX_FN4: 1U_FLIPPED; MXOnly-1U
MX_G1: 1U; MXOnly-1U
MX_H1: 1U; MXOnly-1U
MX_I1: 1U; MXOnly-1U
MX_J1: 1U; MXOnly-1U
MX_K1: 1U; MXOnly-1U
MX_L1: 1U; MXOnly-1U
MX_LControl1: 1,5U; MXOnly-1.5U
MX_LControl2: 1,25U FLIPPED; MXOnly-1.25U-FLIPPED
MX_LShift1: 2,25U; MXOnly-2.25U
MX_LWin1: 1U; MXOnly-1U
MX_LWin2: 1,25U NoLed; MXOnly-1.25U-FLIPPED
MX_Left1: 1U; MXOnly-1U
MX_O1: 1U; MXOnly-1U
MX_P1: 1U; MXOnly-1U
MX_PrtSc1: 1U; MXOnly-1U
MX_Q1: 1U; MXOnly-1U
MX_R1: 1U; MXOnly-1U
MX_RAlt1: 1,25U; MXOnly-1.25U
MX_RAlt2: 1,5U FLIPPED; MXOnly-1.5U-FLIPPED
MX_RAlt3: 1,5U; MXOnly-1.5U
MX_RControl1: 1,25U NoLed; MXOnly-1.25U
MX_RControl2: 1U FLIPPED; MXOnly-1U-FLIPPED
MX_RControl3: 1,5U FLIPPED; MXOnly-1.5U-FLIPPED
MX_RShift1: 2,75U FLIPPED; MXOnly-2.75U
MX_RWin1: NoLed; MXOnly-1.25U-FLIPPED
MX_RWin2: 1,5U; MXOnly-1.5U
MX_RWin3: 1U; MXOnly-1U
MX_S1: 1U; MXOnly-1U
MX_SpaceBar1, MX_SpaceBar2: 6,25U FLIPPED; MXOnly-6.25U-FLIPPED-ReversedStabilizers
MX_SpaceBar3: 7U; MXOnly-7U-ReversedStabilizers
MX_T1: 1U; MXOnly-1U
MX_U1: 1U; MXOnly-1U
MX_W1: 1U; MXOnly-1U
MX_Y1: 1U; MXOnly-1U
MX_[1: 1U; MXOnly-1U
MX_]1: 1U; MXOnly-1U
MX_`~1: 1U; MXOnly-1U
MX_b1: 1U; MXOnly-1U
MX_c1: 1U; MXOnly-1U
MX_insert1: 1U; MXOnly-1U
MX_m1: 1U; MXOnly-1U
MX_n1: 1U; MXOnly-1U
MX_num1, MX_num2, MX_num3, MX_num4, MX_num5, MX_num6, MX_num7, MX_num8, MX_num9, MX_num10: 1U; MXOnly-1U
MX_num*1: 1U; MXOnly-1U
MX_num+1: 2U FLIPPED; MXOnly-2U
MX_num-1: 1U; MXOnly-1U
MX_num/1: 1U; MXOnly-1U
MX_numDel1: 1U; MXOnly-1U
MX_numEnter1: 2U; MXOnly-2U-FLIPPED
MX_numLk1: 1U; MXOnly-1U
MX_right1: 1U; MXOnly-1U
MX_tab1: 1,5U; MXOnly-1.5U
MX_up1: 1U; MXOnly-1U
MX_v1: 1U; MXOnly-1U
MX_x1: 1U; MXOnly-1U
MX_z1: 1U; MXOnly-1U
MX_|\1: 1U; MXOnly-1U-NoLED
MX_|\2: 1.5U FLIPPED; MXOnly-1.5U-NoLED
Q1: FDS9926A; SOIC-8_3.9x4.9mm_P1.27mm
R1, R2: 10k; C_0603
R3, R4, R5, R6, R7, R8, R9, R10, R11, R12, R13, R14, R15, R16, R17, R18, R19, R20, R21, R22, R23, R25, R26, R27, R28, R29, R30, R31, R32, R33, R34, R36, R37, R38, R39, R40, R41, R42, R43, R44, R45, R46, R47, R48, R49, R50, R51, R52, R53, R54, R55, R56, R57, R58, R59, R60, R61, R62, R63, R64, R65, R66, R67, R68, R69, R70, R71, R72, R73, R74, R75, R76, R77, R78, R79, R80, R81, R82, R83, R84, R85, R86, R87, R88, R89, R90, R91, R92, R93, R94, R95, R96, R97, R98, R99, R100, R101, R102, R103, R111, R112, R113, R114: 1k; R_0805
R24, R35, R106: 300; R_0805
R104: 500; R_0805
R105: 390; C_0603
R107, R108: 5.1k; C_0603
R109, R110: 22; C_0603
RGB1, RGB2, RGB3, RGB4, RGB5, RGB6, RGB7, RGB8, RGB9, RGB10, RGB11, RGB12, RGB13, RGB14, RGB15, RGB16, RGB17, RGB18, RGB19, RGB20, RGB21, RGB22, RGB23, RGB24, RGB25, RGB26: WS2812B; LED_WS2812B_PLCC4_5.0x5.0mm_P3.2mm
SW1: SW_Push; SKQG-1155865
U1: STM32F303CCTx; LQFP-48_7x7mm_P0.5mm
U2, U3: OLED-Pin; 0.91_SSD1306_OLED
U5: PRTR5V0U2X; SOT143B
U6: AMS1117-3.3; SOT-223-3_TabPin2
USB1: HRO-TYPE-C-31-M-12; HRO-TYPE-C-31-M-12-Assembly
Y1: 16Mhz; Crystal_SMD_3225-4Pin_3.2x2.5mm
