MaiTheSan/PCB-Design/KiCad/07-2021/Evergarden/Evergarden.sch

## KiCad design KiCad/07-2021/Evergarden/Evergarden.sch (2022-11-19)

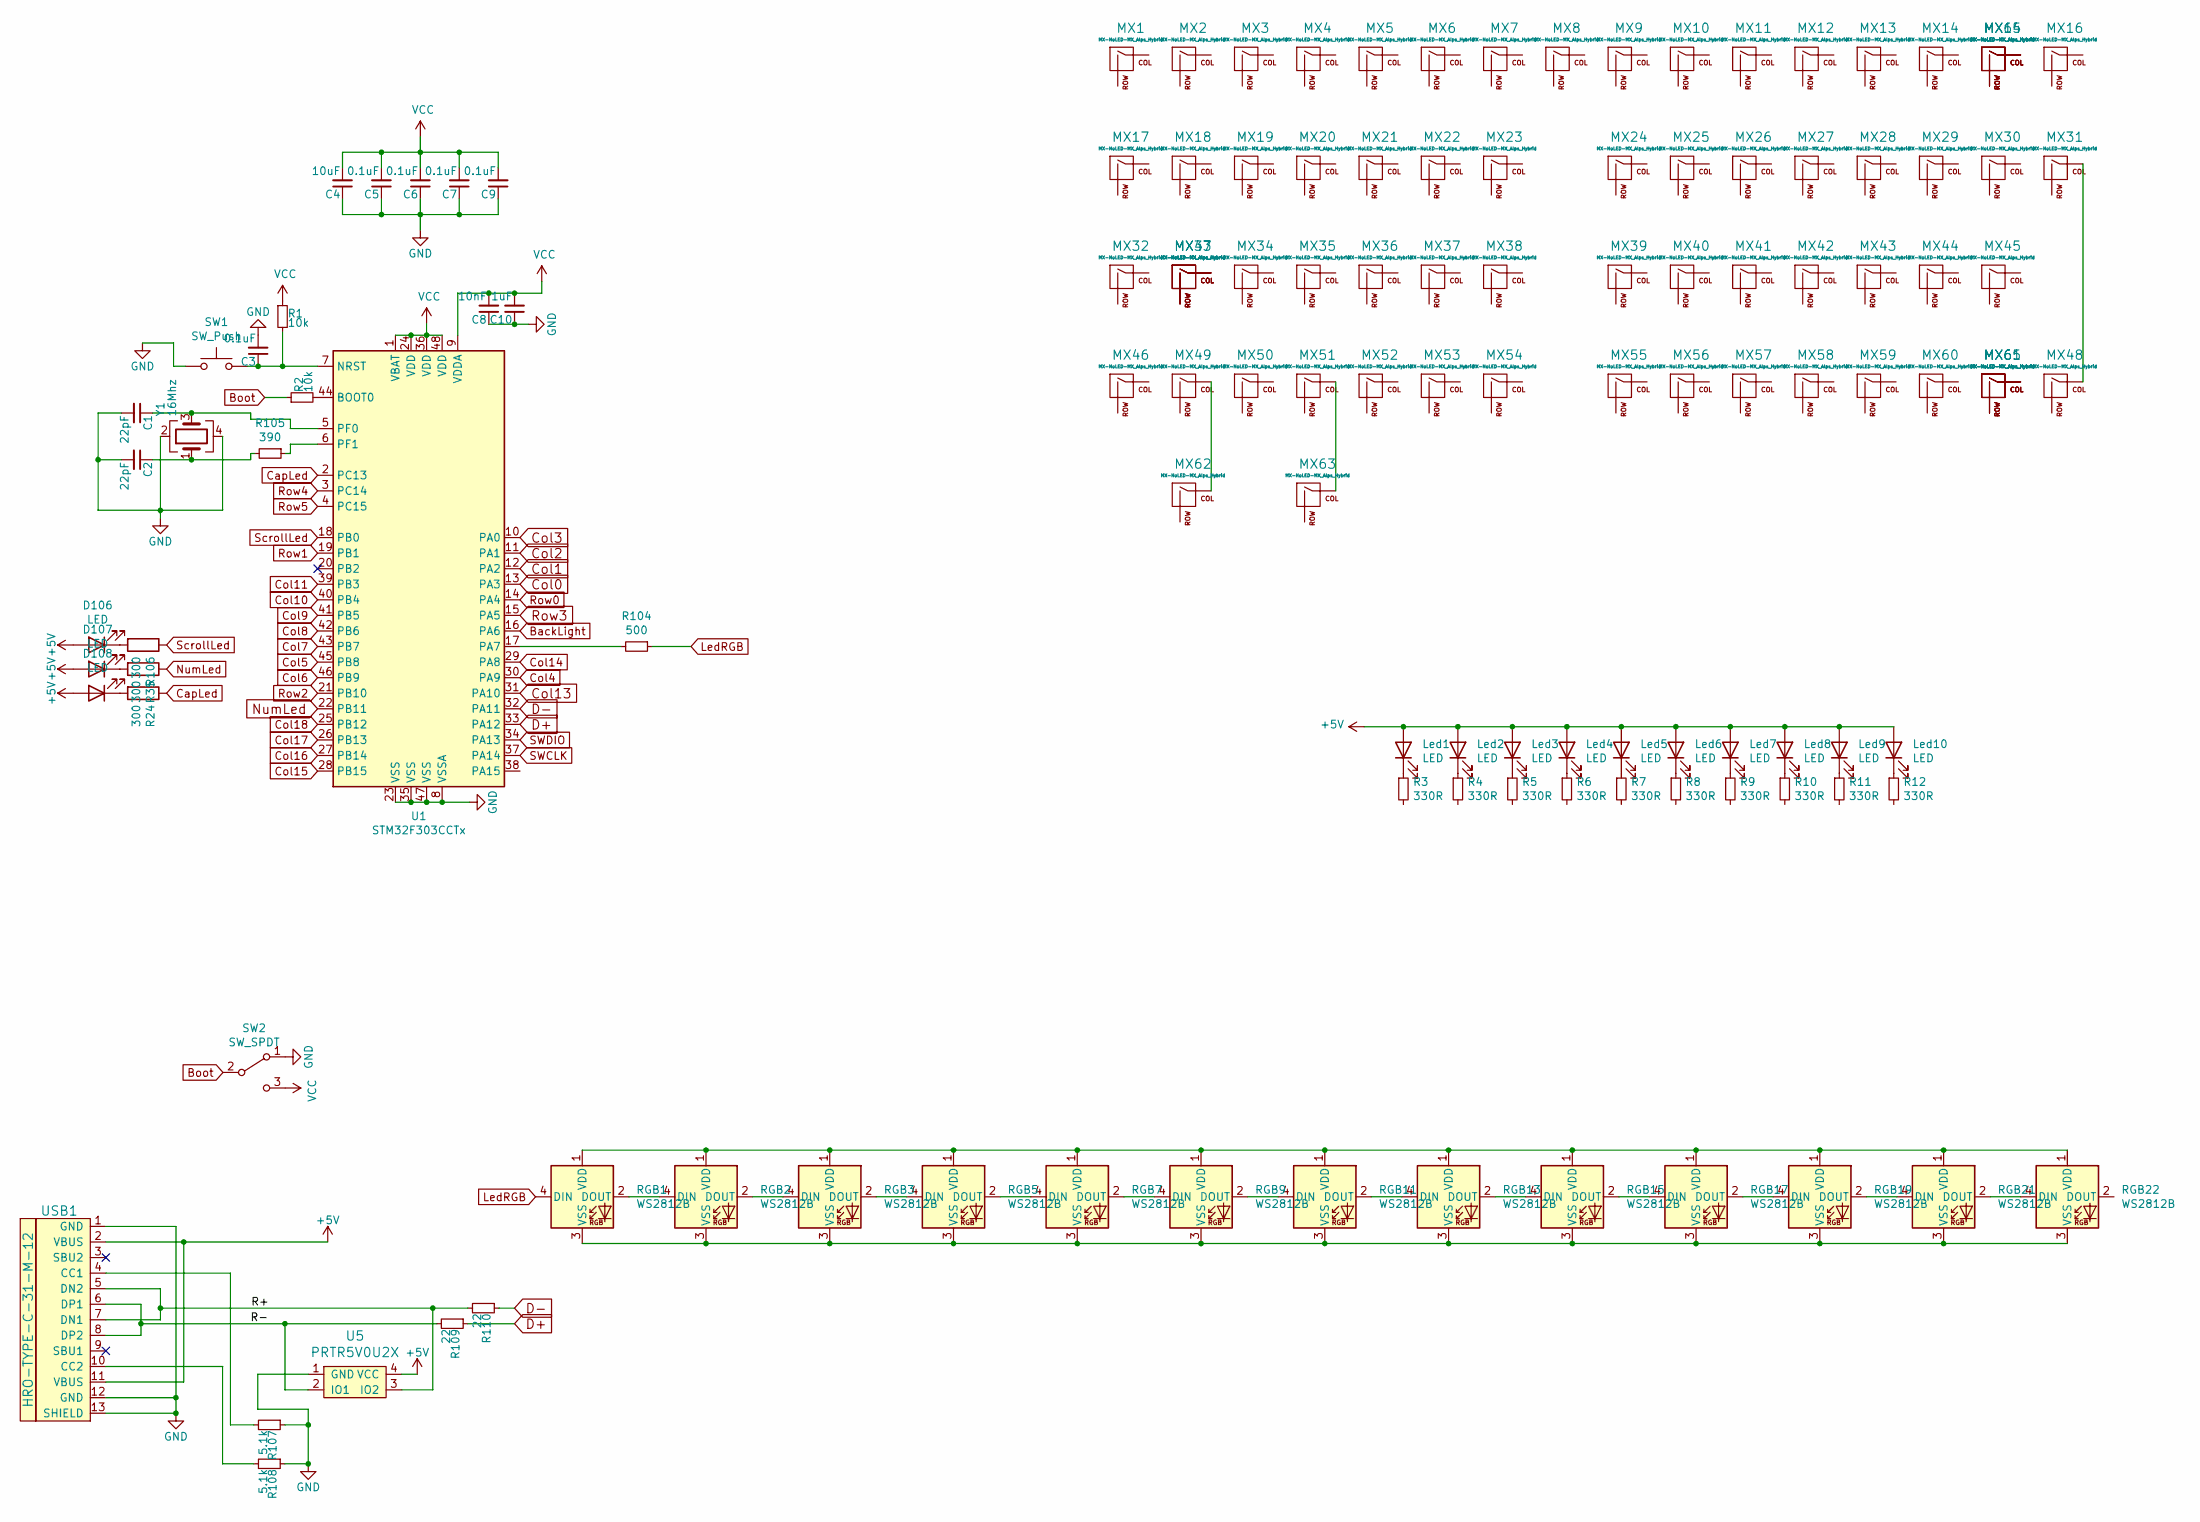
[picture p209: schematic Evergarden.sch]

Parts:
C1, C2: 22pF; C_0603
C3, C5, C6, C7, C9: 0.1uF; C_0603
C4: 10uF; C_0603
C8: 10nF; C_0603
C10: 1uF; C_0603
D106, D107, D108: LED; MXOnly-LEDONLY-MID
Led1, Led2, Led3, Led4, Led5, Led6, Led7, Led8, Led9, Led10: LED; MXOnly-LEDONLY
MX1, MX2, MX3, MX4, MX5, MX6, MX7, MX8, MX9, MX10, MX11, MX12, MX13, MX14, MX15, MX16, MX17, MX19, MX20, MX21, MX22, MX23, MX24, MX25, MX26, MX27, MX28, MX29, MX30, MX32, MX34, MX35, MX36, MX37, MX38, MX39, MX40, MX41, MX42, MX43, MX44, MX46, MX48, MX50, MX51, MX52, MX53, MX54, MX55, MX56, MX57, MX58, MX59, MX60, MX62, MX63: MX-NoLED-MX_Alps_Hybrid; MXOnly-1U-NoLED
MX18, MX31: MX-NoLED-MX_Alps_Hybrid; MXOnly-1.5U-NoLED
MX33, MX65: MX-NoLED-MX_Alps_Hybrid; MXOnly-1.75U-NoLED
MX45: MX-NoLED-MX_Alps_Hybrid; MXOnly-2.25U-ReversedStabilizers-NoLED
MX47: MX-NoLED-MX_Alps_Hybrid; MXOnly-1.25U-NoLED
MX49, MX61: MX-NoLED-MX_Alps_Hybrid; MXOnly-2.25U-NoLED
MX64: MX-NoLED-MX_Alps_Hybrid; MXOnly-2U-NoLED
R1, R2: 10k; R_0805
R3, R4, R5, R6, R7, R8, R9, R10, R11, R12: 330R; C_0603
R24, R35, R106: 300; R_0805
R104: 500; R_0805
R105: 390; R_0805
R107, R108: 5.1k; R_0805
R109, R110: 22; R_0805
RGB1, RGB2, RGB3, RGB5, RGB7, RGB9, RGB11, RGB13, RGB15, RGB17, RGB19, RGB21, RGB22: WS2812B; LED_WS2812B_PLCC4_5.0x5.0mm_P3.2mm
SW1: SW_Push; SKQG-1155865
SW2: SW_SPDT; SW_SPDT_PCM12
U1: STM32F303CCTx; LQFP-48_7x7mm_P0.5mm
U5: PRTR5V0U2X; SOT143B
USB1: HRO-TYPE-C-31-M-12; HRO-TYPE-C-31-M-12-Assembly
Y1: 16Mhz; Crystal_SMD_3225-4Pin_3.2x2.5mm

Connections:
+5V: D106.2 (A), D107.2 (A), D108.2 (A), Led1.2 (A), Led2.2 (A), Led3.2 (A), Led4.2 (A), Led5.2 (A), Led6.2 (A), Led7.2 (A), Led8.2 (A), Led9.2 (A), Led10.2 (A), U5.4 (VCC), USB1.2 (VBUS), USB1.11 (VBUS)
BackLight: U1.16 (PA6)
Boot: R2.1, SW2.2 (B)
CapLed: R24.1, U1.2 (PC13)
Col0: U1.13 (PA3)
Col1: U1.12 (PA2)
Col2: U1.11 (PA1)
Col3: U1.10 (PA0)
Col4: U1.30 (PA9)
Col5: U1.45 (PB8)
Col6: U1.46 (PB9)
Col7: U1.43 (PB7)
Col8: U1.42 (PB6)
Col9: U1.41 (PB5)
Col10: U1.40 (PB4)
Col11: U1.39 (PB3)
Col13: U1.31 (PA10)
Col14: U1.29 (PA8)
Col15: U1.28 (PB15)
Col16: U1.27 (PB14)
Col17: U1.26 (PB13)
Col18: U1.25 (PB12)
D+: R109.1, U1.33 (PA12)
D-: R110.1, U1.32 (PA11)
GND: C1.2, C2.2, C3.2, C4.1, C5.1, C6.1, C7.1, C8.1, C9.1, C10.1, R107.1, R108.1, SW1.1, SW2.1 (A), U1.8 (VSSA), U1.23 (VSS), U1.35 (VSS), U1.47 (VSS), U5.1 (GND), USB1.1 (GND), USB1.12 (GND), USB1.13 (SHIELD), Y1.2, Y1.4
LedRGB: R104.1, RGB1.4 (DIN)
unnamed: C1.1, U1.5 (PF0), Y1.3
unnamed: C2.1, R105.2, Y1.1
unnamed: C3.1, R1.2, SW1.2, U1.7 (NRST)
unnamed: D106.1 (K), R106.2
unnamed: D107.1 (K), R35.2
unnamed: D108.1 (K), R24.2
unnamed: Led1.1 (K), R3.1
unnamed: Led2.1 (K), R4.1
unnamed: Led3.1 (K), R5.1
unnamed: Led4.1 (K), R6.1
unnamed: Led5.1 (K), R7.1
unnamed: Led6.1 (K), R8.1
unnamed: Led7.1 (K), R9.1
unnamed: Led8.1 (K), R10.1
unnamed: Led9.1 (K), R11.1
unnamed: Led10.1 (K), R12.1
unnamed: MX15.1 (COL), MX64.1 (COL)
unnamed: MX15.2 (ROW), MX64.2 (ROW)
unnamed: MX31.1 (COL), MX48.1 (COL)
unnamed: MX33.1 (COL), MX47.1 (COL)
unnamed: MX33.2 (ROW), MX47.2 (ROW)
unnamed: MX49.1 (COL), MX62.1 (COL)
unnamed: MX51.1 (COL), MX63.1 (COL)
unnamed: MX61.1 (COL), MX65.1 (COL)
unnamed: MX61.2 (ROW), MX65.2 (ROW)
unnamed: R2.2, U1.44 (BOOT0)
unnamed: R104.2, U1.17 (PA7)
unnamed: R105.1, U1.6 (PF1)
unnamed: R107.2, USB1.4 (CC1)
unnamed: R108.2, USB1.10 (CC2)
unnamed: RGB1.1 (VDD), RGB2.1 (VDD), RGB3.1 (VDD), RGB5.1 (VDD), RGB7.1 (VDD), RGB9.1 (VDD), RGB11.1 (VDD), RGB13.1 (VDD), RGB15.1 (VDD), RGB17.1 (VDD), RGB19.1 (VDD), RGB21.1 (VDD), RGB22.1 (VDD)
unnamed: RGB1.2 (DOUT), RGB2.4 (DIN)
unnamed: RGB1.3 (VSS), RGB2.3 (VSS), RGB3.3 (VSS), RGB5.3 (VSS), RGB7.3 (VSS), RGB9.3 (VSS), RGB11.3 (VSS), RGB13.3 (VSS), RGB15.3 (VSS), RGB17.3 (VSS), RGB19.3 (VSS), RGB21.3 (VSS), RGB22.3 (VSS)
unnamed: RGB2.2 (DOUT), RGB3.4 (DIN)
unnamed: RGB3.2 (DOUT), RGB5.4 (DIN)
unnamed: RGB5.2 (DOUT), RGB7.4 (DIN)
unnamed: RGB7.2 (DOUT), RGB9.4 (DIN)
unnamed: RGB11.2 (DOUT), RGB13.4 (DIN)
unnamed: RGB9.2 (DOUT), RGB11.4 (DIN)
unnamed: RGB13.2 (DOUT), RGB15.4 (DIN)
unnamed: RGB15.2 (DOUT), RGB17.4 (DIN)
unnamed: RGB17.2 (DOUT), RGB19.4 (DIN)
unnamed: RGB19.2 (DOUT), RGB21.4 (DIN)
unnamed: RGB21.2 (DOUT), RGB22.4 (DIN)
NumLed: R35.1, U1.22 (PB11)
R+: R110.2, U5.3 (IO2), USB1.5 (DN2), USB1.7 (DN1)
R-: R109.2, U5.2 (IO1), USB1.6 (DP1), USB1.8 (DP2)
Row0: U1.14 (PA4)
Row1: U1.19 (PB1)
Row2: U1.21 (PB10)
Row3: U1.15 (PA5)
Row4: U1.3 (PC14)
Row5: U1.4 (PC15)
SWCLK: U1.37 (PA14)
SWDIO: U1.34 (PA13)
ScrollLed: R106.1, U1.18 (PB0)
VCC: C4.2, C5.2, C6.2, C7.2, C8.2, C9.2, C10.2, R1.1, SW2.3 (C), U1.1 (VBAT), U1.9 (VDDA), U1.24 (VDD), U1.36 (VDD), U1.48 (VDD)
