MaiTheSan/PCB-Design/KiCad/07-2021/Parallel/MCU.sch

## KiCad design KiCad/07-2021/Parallel/MCU.sch (2022-11-19)

Schematic: MCU.sch

Parts:
C1, C2: 22pF; C_0603
C3, C5, C6, C7, C9: 0.1uF; C_0402_1005Metric
C4: 10uF; C_0603
C8: 10nF; C_0402_1005Metric
C10: 1uF; C_0603
R1, R2: 10k; C_0603
R105: 390; C_0603
SW1: SW_Push; SKQG-1155865
SW2: SW_SPDT; SW_SPDT_PCM12
U1: STM32F303CCTx; LQFP-48_7x7mm_P0.5mm
Y1: 16Mhz; Crystal_SMD_3225-4Pin_3.2x2.5mm
