MaiTheSan/PCB-Design/KiCad/07-2021/Parallel/Parallel.sch

## KiCad design KiCad/07-2021/Parallel/Parallel.sch (2022-11-19)

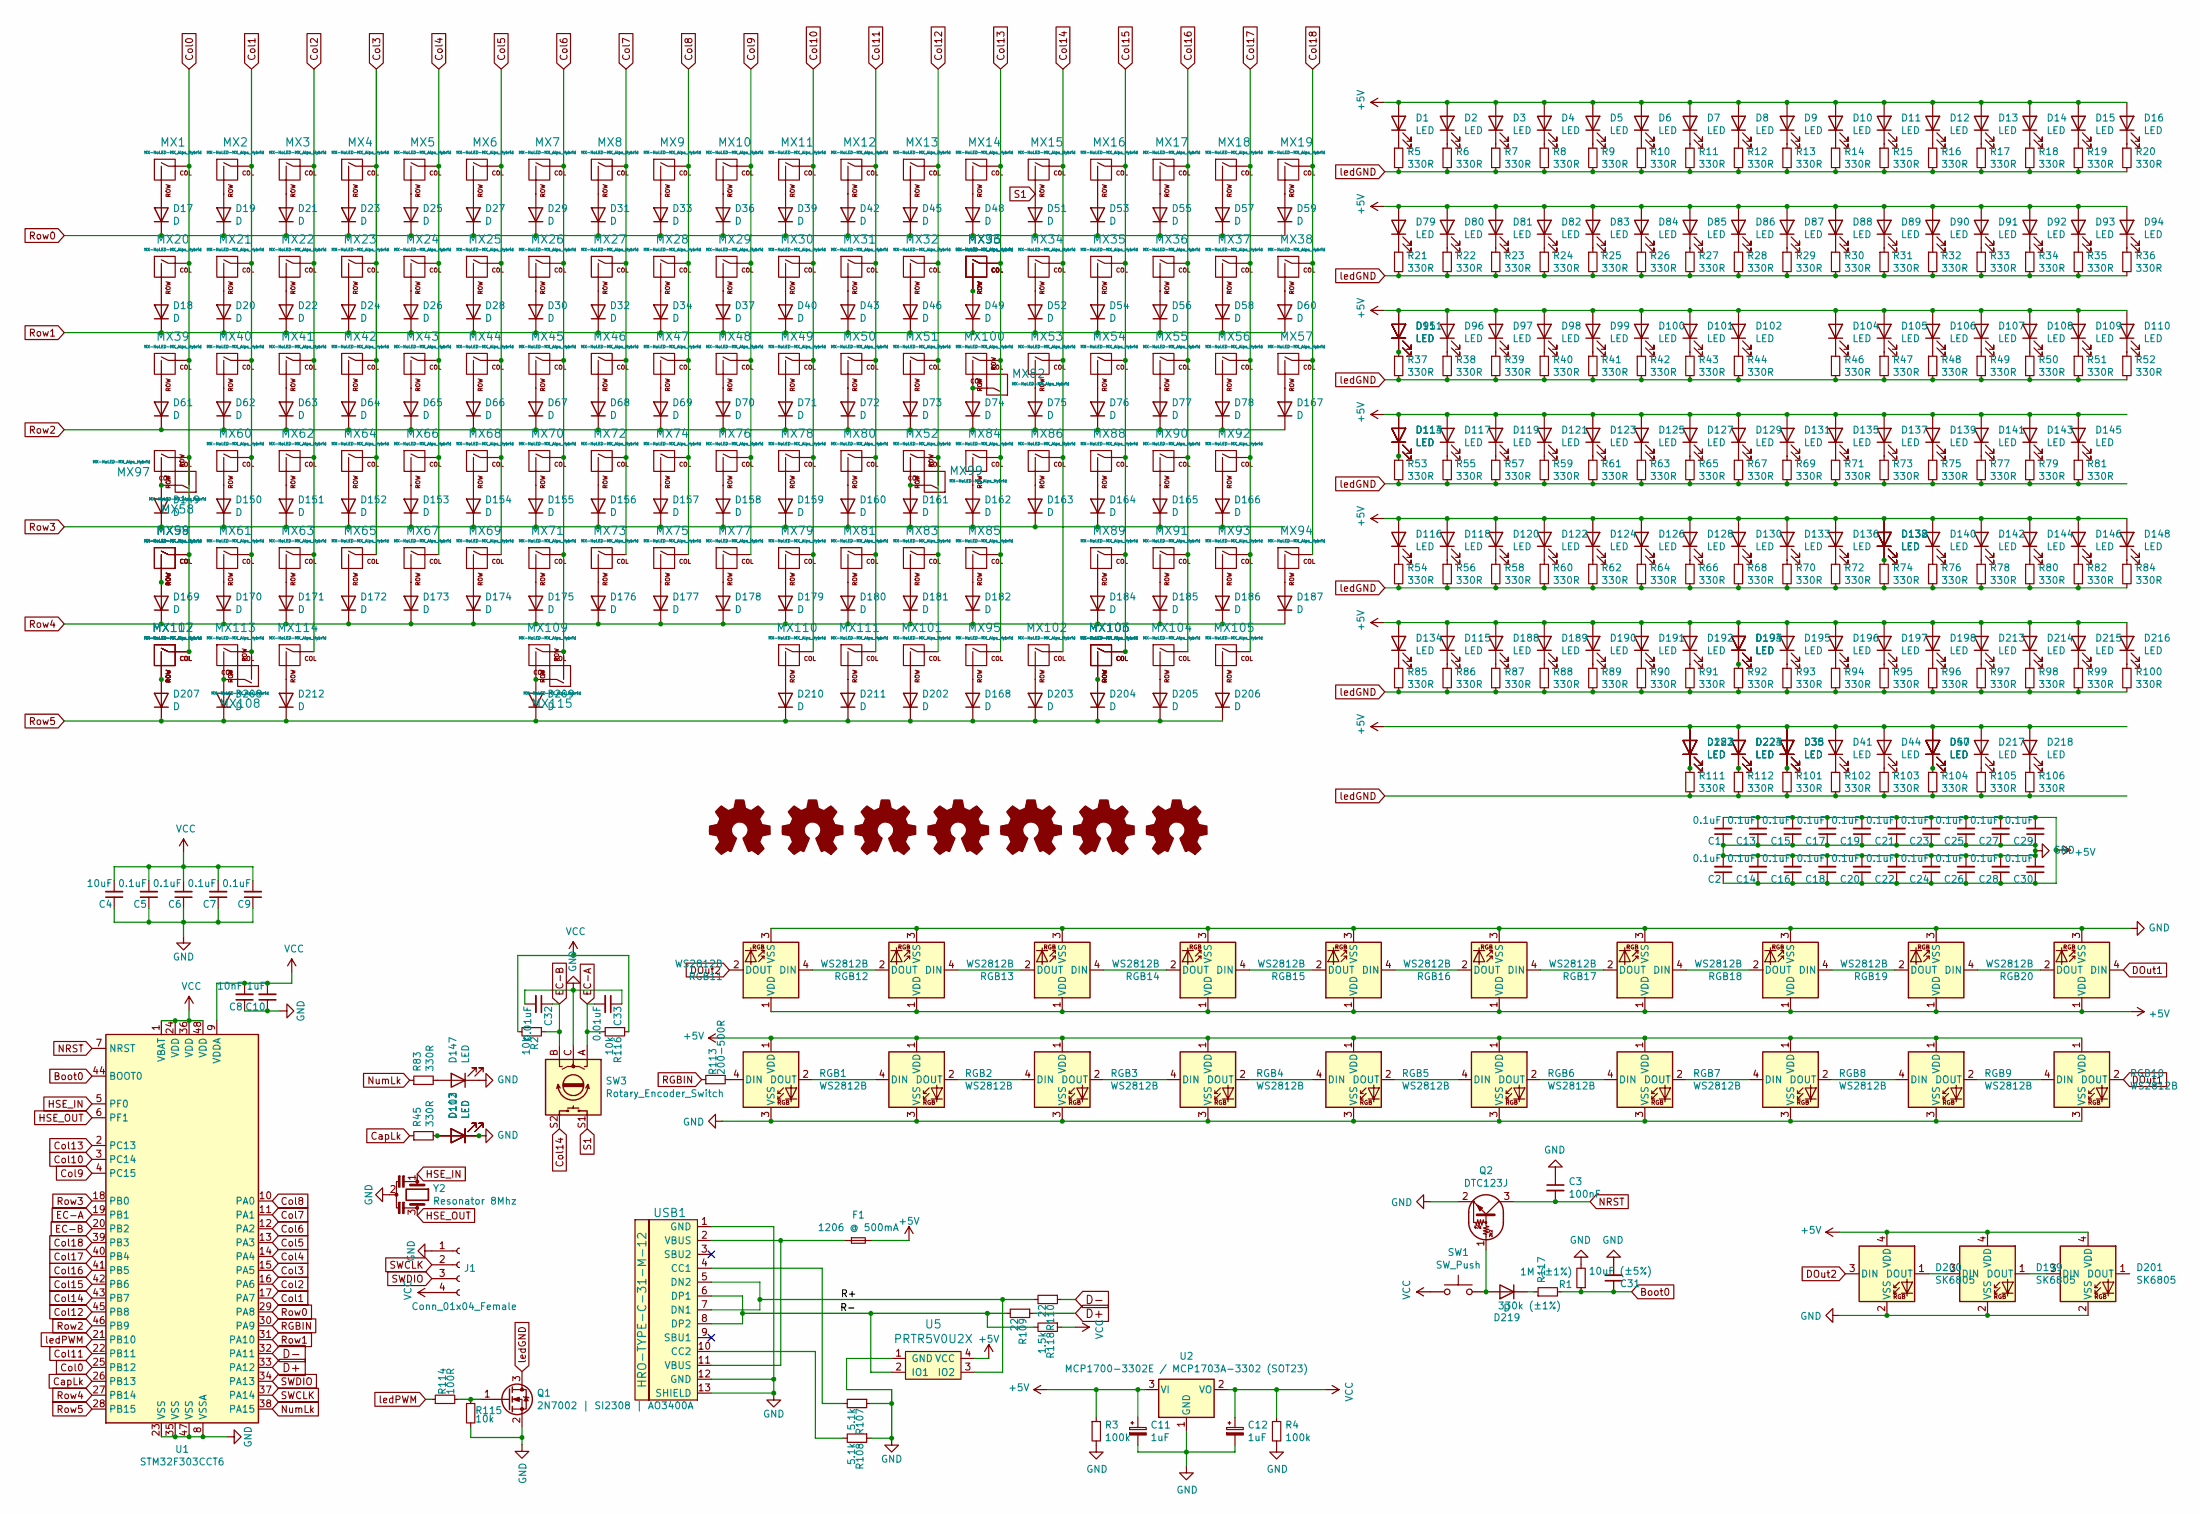
[picture p210: schematic Parallel.sch]

Parts:
C1, C2, C13, C14, C15, C16, C17, C18, C19, C20, C21, C22, C23, C24, C25, C26, C27, C28, C29, C30: 0.1uF; C_0603_1608Metric
C3: 100nF; C_0402_1005Metric
C4: 10uF; C_0402_1005Metric
C5, C6, C7, C9: 0.1uF; C_0402_1005Metric
C8: 10nF; C_0402_1005Metric
C10: 1uF; C_0402_1005Metric
C11, C12: 1uF; CP_EIA-3216-10_Kemet-I
C31: 10uF (±5%); C_0402_1005Metric
C32, C33: 0.01uF; C_0402_1005Metric
D1, D2, D3, D4, D5, D6, D7, D8, D9, D10, D11, D12, D13, D14, D15, D16, D35, D41, D44, D47, D79, D80, D81, D82, D83, D84, D85, D86, D87, D89, D90, D91, D92, D93, D94, D95, D96, D97, D98, D99, D100, D101, D102, D103, D104, D105, D106, D107, D108, D109, D110, D113, D114, D115, D119, D120, D121, D122, D123, D124, D125, D126, D127, D128, D129, D131, D133, D135, D136, D137, D138, D139, D140, D141, D142, D143, D144, D146, D147, D148, D188, D189, D190, D191, D192, D193, D195, D196, D197, D213, D215, D216, D217, D222, D223: LED; MXOnly-LEDONLY
D17, D18, D19, D20, D21, D22, D23, D24, D25, D26, D27, D28, D29, D30, D31, D32, D33, D34, D36, D37, D39, D40, D42, D43, D45, D46, D48, D49, D51, D52, D53, D54, D55, D56, D57, D58, D59, D60, D61, D62, D63, D64, D65, D66, D67, D68, D69, D70, D71, D72, D73, D74, D75, D76, D77, D78, D149, D150, D151, D152, D153, D154, D155, D156, D157, D158, D159, D160, D161, D162, D163, D164, D165, D166, D167, D168, D169, D170, D171, D172, D173, D174, D175, D176, D177, D178, D179, D180, D181, D182, D184, D185, D186, D187, D202, D203, D204, D205, D206, D207, D208, D209, D210, D211, D212, D219: D; D_SOD-123
D38, D50, D88, D111, D112, D116, D117, D118, D130, D132, D134, D145, D183, D194, D198, D214, D218, D224: LED; MXOnly-LEDONLY-FLIPPED
D199, D200, D201: SK6805; LED_SK6805_PLCC4_2.4x2.7mm_P1.3mm
F1: 1206 @ 500mA; Fuse_SMD1206_Reflow
J1: Conn_01x04_Female; PinHeader_1x04_P2.54mm_Vertical
MX1, MX2, MX3, MX4, MX5, MX6, MX7, MX8, MX9, MX10, MX11, MX12, MX13, MX14, MX15, MX16, MX17, MX18, MX19, MX20, MX21, MX22, MX23, MX24, MX25, MX26, MX27, MX28, MX29, MX30, MX31, MX32, MX33, MX34, MX35, MX36, MX37, MX38, MX40, MX41, MX42, MX43, MX44, MX45, MX46, MX47, MX48, MX49, MX50, MX51, MX52, MX53, MX54, MX55, MX56, MX60, MX61, MX62, MX63, MX64, MX65, MX66, MX67, MX68, MX69, MX70, MX71, MX72, MX73, MX74, MX75, MX76, MX77, MX78, MX79, MX80, MX81, MX84, MX85, MX86, MX88, MX89, MX90, MX91, MX92, MX93, MX95, MX101, MX102, MX103, MX104, MX105: MX-NoLED-MX_Alps_Hybrid; MXOnly-1U-NoLED
MX39, MX99, MX107, MX108, MX110, MX111: MX-NoLED-MX_Alps_Hybrid; MXOnly-1.5U-NoLED
MX57, MX94, MX96: MX-NoLED-MX_Alps_Hybrid; MXOnly-2U-NoLED
MX58, MX83: MX-NoLED-MX_Alps_Hybrid; MXOnly-1.75U-NoLED
MX59, MX100: MX-NoLED-MX_Alps_Hybrid; MXOnly-2.25U-NoLED
MX82: MX-NoLED-MX_Alps_Hybrid; MXOnly-ISO-ROTATED-ReversedStabilizers-NoLED
MX97, MX98, MX112, MX113, MX114: MX-NoLED-MX_Alps_Hybrid; MXOnly-1.25U-NoLED
MX106: MX-NoLED-MX_Alps_Hybrid; MXOnly-2U-ReversedStabilizers-NoLED
MX109: MX-NoLED-MX_Alps_Hybrid; MXOnly-7U-ReversedStabilizers-NoLED
MX115: MX-NoLED-MX_Alps_Hybrid; MXOnly-6.25U-ReversedStabilizers-NoLED
Q1: 2N7002 | SI2308 | AO3400A; SOT-23
Q2: DTC123J; SOT-23
R1: 1M (±1%); R_0805
R2, R115, R116: 10k; R_0805
R3, R4: 100k; R_0805
R5, R6, R7, R8, R9, R10, R11, R12, R13, R14, R15, R16, R17, R18, R19, R20, R21, R22, R23, R24, R25, R26, R27, R28, R29, R30, R31, R32, R33, R34, R35, R36, R37, R38, R39, R40, R41, R42, R43, R44, R45, R46, R47, R48, R49, R50, R51, R52, R53, R54, R55, R56, R57, R58, R59, R60, R61, R62, R63, R64, R65, R66, R67, R68, R69, R70, R71, R72, R73, R74, R75, R76, R77, R78, R79, R80, R81, R82, R83, R84, R85, R86, R87, R88, R89, R90, R91, R92, R93, R94, R95, R96, R97, R98, R99, R100, R101, R102, R103, R104, R105, R106, R111, R112: 330R; C_0603
R107, R108: 5.1k; R_0805
R109, R110: 22; R_0805
R113: 200-500R; R_0805
R114: 100R; R_0805
R117: 330k (±1%); R_0805
R118: 1.5k; R_0805
RGB1, RGB2, RGB3, RGB4, RGB5, RGB6, RGB7, RGB8, RGB9, RGB10, RGB11, RGB12, RGB13, RGB14, RGB15, RGB16, RGB17, RGB18, RGB19, RGB20: WS2812B; LED_WS2812B_PLCC4_5.0x5.0mm_P3.2mm
SW1: SW_Push; SKQG-1155865
SW3: Rotary_Encoder_Switch; RotaryEncoder_Alps_EC11E-Switch_Vertical_H20mm_Center
U1: STM32F303CCT6; LQFP-48_7x7mm_P0.5mm
U2: MCP1700-3302E / MCP1703A-3302 (SOT23); SOT-23
U5: PRTR5V0U2X; SOT143B
USB1: HRO-TYPE-C-31-M-12; HRO-TYPE-C-31-M-12-Assembly
Y2: Resonator 8Mhz; Resonator_SMD_muRata_CSTxExxV-3Pin_3.0x1.1mm; Mouser part 81-CSTCE8M00G52-R0

Connections:
+5V: C1.2, C2.1, C11.1, C13.2, C14.1, C15.2, C16.1, C17.2, C18.1, C19.2, C20.1, C21.2, C22.1, C23.2, C24.1, C25.2, C26.1, C27.2, C28.1, C29.2, C30.1, D1.2 (A), D2.2 (A), D3.2 (A), D4.2 (A), D5.2 (A), D6.2 (A), D7.2 (A), D8.2 (A), D9.2 (A), D10.2 (A), D11.2 (A), D12.2 (A), D13.2 (A), D14.2 (A), D15.2 (A), D16.2 (A), D35.2 (A), D38.2 (A), D41.2 (A), D44.2 (A), D47.2 (A), D50.2 (A), D79.2 (A), D80.2 (A), D81.2 (A), D82.2 (A), D83.2 (A), D84.2 (A), D85.2 (A), D86.2 (A), D87.2 (A), D88.2 (A), D89.2 (A), D90.2 (A), D91.2 (A), D92.2 (A), D93.2 (A), D94.2 (A), D95.2 (A), D96.2 (A), D97.2 (A), D98.2 (A), D99.2 (A), D100.2 (A), D101.2 (A), D102.2 (A), D104.2 (A), D105.2 (A), D106.2 (A), D107.2 (A), D108.2 (A), D109.2 (A), D110.2 (A), D111.2 (A), D113.2 (A), D114.2 (A), D115.2 (A), D116.2 (A), D117.2 (A), D118.2 (A), D119.2 (A), D120.2 (A), D121.2 (A), D122.2 (A), D123.2 (A), D124.2 (A), D125.2 (A), D126.2 (A), D127.2 (A), D128.2 (A), D129.2 (A), D130.2 (A), D131.2 (A), D132.2 (A), D133.2 (A), D134.2 (A), D135.2 (A), D136.2 (A), D137.2 (A), D138.2 (A), D139.2 (A), D140.2 (A), D141.2 (A), D142.2 (A), D143.2 (A), D144.2 (A), D145.2 (A), D146.2 (A), D148.2 (A), D183.2 (A), D188.2 (A), D189.2 (A), D190.2 (A), D191.2 (A), D192.2 (A), D193.2 (A), D194.2 (A), D195.2 (A), D196.2 (A), D197.2 (A), D198.2 (A), D199.4 (VDD), D200.4 (VDD), D201.4 (VDD), D213.2 (A), D214.2 (A), D215.2 (A), D216.2 (A), D217.2 (A), D218.2 (A), D222.2 (A), D223.2 (A), D224.2 (A), F1.2, R3.1, RGB1.1 (VDD), RGB2.1 (VDD), RGB3.1 (VDD), RGB4.1 (VDD), RGB5.1 (VDD), RGB6.1 (VDD), RGB7.1 (VDD), RGB8.1 (VDD), RGB9.1 (VDD), RGB10.1 (VDD), RGB11.1 (VDD), RGB12.1 (VDD), RGB13.1 (VDD), RGB14.1 (VDD), RGB15.1 (VDD), RGB16.1 (VDD), RGB17.1 (VDD), RGB18.1 (VDD), RGB19.1 (VDD), RGB20.1 (VDD), U2.3 (VI), U5.4 (VCC)
Boot0: C31.1, R1.1, R117.2, U1.44 (BOOT0)
CapLk: R45.1, U1.26 (PB13)
Col0: MX1.1 (COL), MX20.1 (COL), MX39.1 (COL), MX58.2 (ROW), MX59.1 (COL), MX97.1 (COL), MX98.1 (COL), MX107.1 (COL), MX112.1 (COL), U1.25 (PB12)
Col1: MX2.1 (COL), MX21.1 (COL), MX40.1 (COL), MX60.1 (COL), MX61.1 (COL), MX108.2 (ROW), MX113.1 (COL), U1.17 (PA7)
Col2: MX3.1 (COL), MX22.1 (COL), MX41.1 (COL), MX62.1 (COL), MX63.1 (COL), MX114.1 (COL), U1.16 (PA6)
Col3: MX4.1 (COL), MX23.1 (COL), MX42.1 (COL), MX64.1 (COL), MX65.1 (COL), U1.15 (PA5)
Col4: MX5.1 (COL), MX24.1 (COL), MX43.1 (COL), MX66.1 (COL), MX67.1 (COL), U1.14 (PA4)
Col5: MX6.1 (COL), MX25.1 (COL), MX44.1 (COL), MX68.1 (COL), MX69.1 (COL), U1.13 (PA3)
Col6: MX7.1 (COL), MX26.1 (COL), MX45.1 (COL), MX70.1 (COL), MX71.1 (COL), MX109.1 (COL), MX115.2 (ROW), U1.12 (PA2)
Col7: MX8.1 (COL), MX27.1 (COL), MX46.1 (COL), MX72.1 (COL), MX73.1 (COL), U1.11 (PA1)
Col8: MX9.1 (COL), MX28.1 (COL), MX47.1 (COL), MX74.1 (COL), MX75.1 (COL), U1.10 (PA0)
Col9: MX10.1 (COL), MX29.1 (COL), MX48.1 (COL), MX76.1 (COL), MX77.1 (COL), U1.4 (PC15)
Col10: MX11.1 (COL), MX30.1 (COL), MX49.1 (COL), MX78.1 (COL), MX79.1 (COL), MX110.1 (COL), U1.3 (PC14)
Col11: MX12.1 (COL), MX31.1 (COL), MX50.1 (COL), MX80.1 (COL), MX81.1 (COL), MX111.1 (COL), U1.22 (PB11)
Col12: MX13.1 (COL), MX32.1 (COL), MX51.1 (COL), MX52.1 (COL), MX83.1 (COL), MX99.2 (ROW), MX101.1 (COL), U1.45 (PB8)
Col13: MX14.1 (COL), MX33.1 (COL), MX82.2 (ROW), MX84.1 (COL), MX85.1 (COL), MX95.1 (COL), MX96.1 (COL), MX100.1 (COL), U1.2 (PC13)
Col14: MX15.1 (COL), MX34.1 (COL), MX53.1 (COL), MX86.1 (COL), MX102.1 (COL), SW3.S2, U1.43 (PB7)
Col15: MX16.1 (COL), MX35.1 (COL), MX54.1 (COL), MX88.1 (COL), MX89.1 (COL), MX103.1 (COL), MX106.1 (COL), U1.42 (PB6)
Col16: MX17.1 (COL), MX36.1 (COL), MX55.1 (COL), MX90.1 (COL), MX91.1 (COL), MX104.1 (COL), U1.41 (PB5)
Col17: MX18.1 (COL), MX37.1 (COL), MX56.1 (COL), MX92.1 (COL), MX93.1 (COL), MX105.1 (COL), U1.40 (PB4)
Col18: MX19.1 (COL), MX38.1 (COL), MX57.1 (COL), MX94.1 (COL), U1.39 (PB3)
D+: R109.1, U1.33 (PA12)
D-: R110.1, U1.32 (PA11)
DOut1: RGB10.2 (DOUT), RGB20.4 (DIN)
DOut2: D200.3 (DIN), RGB11.2 (DOUT)
EC-A: C33.2, R116.2, SW3.A, U1.19 (PB1)
EC-B: C32.1, R2.1, SW3.B, U1.20 (PB2)
GND: C1.1, C2.2, C3.1, C4.1, C5.1, C6.1, C7.1, C8.1, C9.1, C10.1, C11.2, C12.2, C13.1, C14.2, C15.1, C16.2, C17.1, C18.2, C19.1, C20.2, C21.1, C22.2, C23.1, C24.2, C25.1, C26.2, C27.1, C28.2, C29.1, C30.2, C31.2, C32.2, C33.1, D103.1 (K), D112.1 (K), D147.1 (K), D199.2 (VSS), D200.2 (VSS), D201.2 (VSS), J1.1, Q1.2 (S), Q2.2 (E), R1.2, R3.2, R4.2, R107.1, R108.1, R115.2, RGB1.3 (VSS), RGB2.3 (VSS), RGB3.3 (VSS), RGB4.3 (VSS), RGB5.3 (VSS), RGB6.3 (VSS), RGB7.3 (VSS), RGB8.3 (VSS), RGB9.3 (VSS), RGB10.3 (VSS), RGB11.3 (VSS), RGB12.3 (VSS), RGB13.3 (VSS), RGB14.3 (VSS), RGB15.3 (VSS), RGB16.3 (VSS), RGB17.3 (VSS), RGB18.3 (VSS), RGB19.3 (VSS), RGB20.3 (VSS), SW3.C, U1.8 (VSSA), U1.23 (VSS), U1.35 (VSS), U1.47 (VSS), U2.1 (GND), U5.1 (GND), USB1.1 (GND), USB1.12 (GND), USB1.13 (SHIELD), Y2.2
HSE_IN: U1.5 (PF0), Y2.1
HSE_OUT: U1.6 (PF1), Y2.3
NRST: C3.2, Q2.3 (C), U1.7 (NRST)
unnamed: D1.1 (K), R5.1
unnamed: D2.1 (K), R6.1
unnamed: D3.1 (K), R7.1
unnamed: D4.1 (K), R8.1
unnamed: D5.1 (K), R9.1
unnamed: D6.1 (K), R10.1
unnamed: D7.1 (K), R11.1
unnamed: D8.1 (K), R12.1
unnamed: D9.1 (K), R13.1
unnamed: D10.1 (K), R14.1
unnamed: D11.1 (K), R15.1
unnamed: D12.1 (K), R16.1
unnamed: D13.1 (K), R17.1
unnamed: D14.1 (K), R18.1
unnamed: D15.1 (K), R19.1
unnamed: D16.1 (K), R20.1
unnamed: D17.2 (A), MX1.2 (ROW)
unnamed: D18.2 (A), MX20.2 (ROW)
unnamed: D19.2 (A), MX2.2 (ROW)
unnamed: D20.2 (A), MX21.2 (ROW)
unnamed: D21.2 (A), MX3.2 (ROW)
unnamed: D22.2 (A), MX22.2 (ROW)
unnamed: D23.2 (A), MX4.2 (ROW)
unnamed: D24.2 (A), MX23.2 (ROW)
unnamed: D25.2 (A), MX5.2 (ROW)
unnamed: D26.2 (A), MX24.2 (ROW)
unnamed: D27.2 (A), MX6.2 (ROW)
unnamed: D28.2 (A), MX25.2 (ROW)
unnamed: D29.2 (A), MX7.2 (ROW)
unnamed: D30.2 (A), MX26.2 (ROW)
unnamed: D31.2 (A), MX8.2 (ROW)
unnamed: D32.2 (A), MX27.2 (ROW)
unnamed: D33.2 (A), MX9.2 (ROW)
unnamed: D34.2 (A), MX28.2 (ROW)
unnamed: D35.1 (K), D38.1 (K), R101.1
unnamed: D36.2 (A), MX10.2 (ROW)
unnamed: D37.2 (A), MX29.2 (ROW)
unnamed: D39.2 (A), MX11.2 (ROW)
unnamed: D40.2 (A), MX30.2 (ROW)
unnamed: D41.1 (K), R102.1
unnamed: D42.2 (A), MX12.2 (ROW)
unnamed: D43.2 (A), MX31.2 (ROW)
unnamed: D44.1 (K), R103.1
unnamed: D45.2 (A), MX13.2 (ROW)
unnamed: D46.2 (A), MX32.2 (ROW)
unnamed: D47.1 (K), D50.1 (K), R104.1
unnamed: D48.2 (A), MX14.2 (ROW)
unnamed: D49.2 (A), MX33.2 (ROW), MX96.2 (ROW)
unnamed: D52.2 (A), MX34.2 (ROW)
unnamed: D53.2 (A), MX16.2 (ROW)
unnamed: D54.2 (A), MX35.2 (ROW)
unnamed: D55.2 (A), MX17.2 (ROW)
unnamed: D56.2 (A), MX36.2 (ROW)
unnamed: D57.2 (A), MX18.2 (ROW)
unnamed: D58.2 (A), MX37.2 (ROW)
unnamed: D59.2 (A), MX19.2 (ROW)
unnamed: D60.2 (A), MX38.2 (ROW)
unnamed: D61.2 (A), MX39.2 (ROW)
unnamed: D62.2 (A), MX40.2 (ROW)
unnamed: D63.2 (A), MX41.2 (ROW)
unnamed: D64.2 (A), MX42.2 (ROW)
unnamed: D65.2 (A), MX43.2 (ROW)
unnamed: D66.2 (A), MX44.2 (ROW)
unnamed: D67.2 (A), MX45.2 (ROW)
unnamed: D68.2 (A), MX46.2 (ROW)
unnamed: D69.2 (A), MX47.2 (ROW)
unnamed: D70.2 (A), MX48.2 (ROW)
unnamed: D71.2 (A), MX49.2 (ROW)
unnamed: D72.2 (A), MX50.2 (ROW)
unnamed: D73.2 (A), MX51.2 (ROW)
unnamed: D74.2 (A), MX82.1 (COL), MX100.2 (ROW)
unnamed: D75.2 (A), MX53.2 (ROW)
unnamed: D76.2 (A), MX54.2 (ROW)
unnamed: D77.2 (A), MX55.2 (ROW)
unnamed: D78.2 (A), MX56.2 (ROW)
unnamed: D79.1 (K), R21.1
unnamed: D80.1 (K), R22.1
unnamed: D81.1 (K), R23.1
unnamed: D82.1 (K), R24.1
unnamed: D83.1 (K), R25.1
unnamed: D84.1 (K), R26.1
unnamed: D85.1 (K), R27.1
unnamed: D86.1 (K), R28.1
unnamed: D87.1 (K), R29.1
unnamed: D88.1 (K), R30.1
unnamed: D89.1 (K), R31.1
unnamed: D90.1 (K), R32.1
unnamed: D91.1 (K), R33.1
unnamed: D92.1 (K), R34.1
unnamed: D93.1 (K), R35.1
unnamed: D94.1 (K), R36.1
unnamed: D96.1 (K), R38.1
unnamed: D97.1 (K), R39.1
unnamed: D98.1 (K), R40.1
unnamed: D99.1 (K), R41.1
unnamed: D100.1 (K), R42.1
unnamed: D101.1 (K), R43.1
unnamed: D102.1 (K), R44.1
unnamed: D103.2 (A), D112.2 (A), R45.2
unnamed: D104.1 (K), R46.1
unnamed: D105.1 (K), R47.1
unnamed: D106.1 (K), R48.1
unnamed: D107.1 (K), R49.1
unnamed: D108.1 (K), R50.1
unnamed: D109.1 (K), R51.1
unnamed: D110.1 (K), R52.1
unnamed: D95.1 (K), D111.1 (K), R37.1
unnamed: D113.1 (K), D114.1 (K), R53.1
unnamed: D115.1 (K), R86.1
unnamed: D116.1 (K), R54.1
unnamed: D117.1 (K), R55.1
unnamed: D118.1 (K), R56.1
unnamed: D119.1 (K), R57.1
unnamed: D120.1 (K), R58.1
unnamed: D121.1 (K), R59.1
unnamed: D122.1 (K), R60.1
unnamed: D123.1 (K), R61.1
unnamed: D124.1 (K), R62.1
unnamed: D125.1 (K), R63.1
unnamed: D126.1 (K), R64.1
unnamed: D127.1 (K), R65.1
unnamed: D128.1 (K), R66.1
unnamed: D129.1 (K), R67.1
unnamed: D130.1 (K), R68.1
unnamed: D131.1 (K), R69.1
unnamed: D132.1 (K), D138.1 (K), R74.1
unnamed: D133.1 (K), R70.1
unnamed: D134.1 (K), R85.1
unnamed: D135.1 (K), R71.1
unnamed: D136.1 (K), R72.1
unnamed: D137.1 (K), R73.1
unnamed: D139.1 (K), R75.1
unnamed: D140.1 (K), R76.1
unnamed: D141.1 (K), R77.1
unnamed: D142.1 (K), R78.1
unnamed: D143.1 (K), R79.1
unnamed: D144.1 (K), R80.1
unnamed: D145.1 (K), R81.1
unnamed: D146.1 (K), R82.1
unnamed: D147.2 (A), R83.2
unnamed: D148.1 (K), R84.1
unnamed: D149.2 (A), MX58.1 (COL), MX97.2 (ROW)
unnamed: D150.2 (A), MX60.2 (ROW)
unnamed: D151.2 (A), MX62.2 (ROW)
unnamed: D152.2 (A), MX64.2 (ROW)
unnamed: D153.2 (A), MX66.2 (ROW)
unnamed: D154.2 (A), MX68.2 (ROW)
unnamed: D155.2 (A), MX70.2 (ROW)
unnamed: D156.2 (A), MX72.2 (ROW)
unnamed: D157.2 (A), MX74.2 (ROW)
unnamed: D158.2 (A), MX76.2 (ROW)
unnamed: D159.2 (A), MX78.2 (ROW)
unnamed: D160.2 (A), MX80.2 (ROW)
unnamed: D161.2 (A), MX52.2 (ROW), MX99.1 (COL)
unnamed: D162.2 (A), MX84.2 (ROW)
unnamed: D163.2 (A), MX86.2 (ROW)
unnamed: D164.2 (A), MX88.2 (ROW)
unnamed: D165.2 (A), MX90.2 (ROW)
unnamed: D166.2 (A), MX92.2 (ROW)
unnamed: D167.2 (A), MX57.2 (ROW)
unnamed: D168.2 (A), MX95.2 (ROW)
unnamed: D169.2 (A), MX59.2 (ROW), MX98.2 (ROW)
unnamed: D170.2 (A), MX61.2 (ROW)
unnamed: D171.2 (A), MX63.2 (ROW)
unnamed: D172.2 (A), MX65.2 (ROW)
unnamed: D173.2 (A), MX67.2 (ROW)
unnamed: D174.2 (A), MX69.2 (ROW)
unnamed: D175.2 (A), MX71.2 (ROW)
unnamed: D176.2 (A), MX73.2 (ROW)
unnamed: D177.2 (A), MX75.2 (ROW)
unnamed: D178.2 (A), MX77.2 (ROW)
unnamed: D179.2 (A), MX79.2 (ROW)
unnamed: D180.2 (A), MX81.2 (ROW)
unnamed: D181.2 (A), MX83.2 (ROW)
unnamed: D182.2 (A), MX85.2 (ROW)
unnamed: D183.1 (K), D222.1 (K), R111.1
unnamed: D184.2 (A), MX89.2 (ROW)
unnamed: D185.2 (A), MX91.2 (ROW)
unnamed: D186.2 (A), MX93.2 (ROW)
unnamed: D187.2 (A), MX94.2 (ROW)
unnamed: D188.1 (K), R87.1
unnamed: D189.1 (K), R88.1
unnamed: D190.1 (K), R89.1
unnamed: D191.1 (K), R90.1
unnamed: D192.1 (K), R91.1
unnamed: D193.1 (K), D194.1 (K), R92.1
unnamed: D195.1 (K), R93.1
unnamed: D196.1 (K), R94.1
unnamed: D197.1 (K), R95.1
unnamed: D198.1 (K), R96.1
unnamed: D199.1 (DOUT), D201.3 (DIN)
unnamed: D199.3 (DIN), D200.1 (DOUT)
unnamed: D202.2 (A), MX101.2 (ROW)
unnamed: D203.2 (A), MX102.2 (ROW)
unnamed: D204.2 (A), MX103.2 (ROW), MX106.2 (ROW)
unnamed: D205.2 (A), MX104.2 (ROW)
unnamed: D206.2 (A), MX105.2 (ROW)
unnamed: D207.2 (A), MX107.2 (ROW), MX112.2 (ROW)
unnamed: D208.2 (A), MX108.1 (COL), MX113.2 (ROW)
unnamed: D209.2 (A), MX109.2 (ROW), MX115.1 (COL)
unnamed: D210.2 (A), MX110.2 (ROW)
unnamed: D211.2 (A), MX111.2 (ROW)
unnamed: D212.2 (A), MX114.2 (ROW)
unnamed: D213.1 (K), R97.1
unnamed: D214.1 (K), R98.1
unnamed: D215.1 (K), R99.1
unnamed: D216.1 (K), R100.1
unnamed: D217.1 (K), R105.1
unnamed: D218.1 (K), R106.1
unnamed: D219.1 (K), R117.1
unnamed: D219.2 (A), Q2.1 (B), SW1.2
unnamed: D223.1 (K), D224.1 (K), R112.1
unnamed: F1.1, USB1.2 (VBUS), USB1.11 (VBUS)
unnamed: Q1.1 (G), R114.2, R115.1
unnamed: R107.2, USB1.4 (CC1)
unnamed: R108.2, USB1.10 (CC2)
unnamed: R113.2, RGB1.4 (DIN)
unnamed: RGB1.2 (DOUT), RGB2.4 (DIN)
unnamed: RGB2.2 (DOUT), RGB3.4 (DIN)
unnamed: RGB3.2 (DOUT), RGB4.4 (DIN)
unnamed: RGB4.2 (DOUT), RGB5.4 (DIN)
unnamed: RGB5.2 (DOUT), RGB6.4 (DIN)
unnamed: RGB6.2 (DOUT), RGB7.4 (DIN)
unnamed: RGB7.2 (DOUT), RGB8.4 (DIN)
unnamed: RGB8.2 (DOUT), RGB9.4 (DIN)
unnamed: RGB9.2 (DOUT), RGB10.4 (DIN)
unnamed: RGB11.4 (DIN), RGB12.2 (DOUT)
unnamed: RGB12.4 (DIN), RGB13.2 (DOUT)
unnamed: RGB13.4 (DIN), RGB14.2 (DOUT)
unnamed: RGB14.4 (DIN), RGB15.2 (DOUT)
unnamed: RGB15.4 (DIN), RGB16.2 (DOUT)
unnamed: RGB16.4 (DIN), RGB17.2 (DOUT)
unnamed: RGB17.4 (DIN), RGB18.2 (DOUT)
unnamed: RGB18.4 (DIN), RGB19.2 (DOUT)
unnamed: RGB19.4 (DIN), RGB20.2 (DOUT)
NumLk: R83.1, U1.38 (PA15)
R+: R110.2, U5.3 (IO2), USB1.5 (DN2), USB1.7 (DN1)
R-: R109.2, R118.2, U5.2 (IO1), USB1.6 (DP1), USB1.8 (DP2)
RGBIN: R113.1, U1.30 (PA9)
Row0: D17.1 (K), D19.1 (K), D21.1 (K), D23.1 (K), D25.1 (K), D27.1 (K), D29.1 (K), D31.1 (K), D33.1 (K), D36.1 (K), D39.1 (K), D42.1 (K), D45.1 (K), D48.1 (K), D51.1 (K), D53.1 (K), D55.1 (K), D57.1 (K), D59.1 (K), U1.29 (PA8)
Row1: D18.1 (K), D20.1 (K), D22.1 (K), D24.1 (K), D26.1 (K), D28.1 (K), D30.1 (K), D32.1 (K), D34.1 (K), D37.1 (K), D40.1 (K), D43.1 (K), D46.1 (K), D49.1 (K), D52.1 (K), D54.1 (K), D56.1 (K), D58.1 (K), D60.1 (K), U1.31 (PA10)
Row2: D61.1 (K), D62.1 (K), D63.1 (K), D64.1 (K), D65.1 (K), D66.1 (K), D67.1 (K), D68.1 (K), D69.1 (K), D70.1 (K), D71.1 (K), D72.1 (K), D73.1 (K), D74.1 (K), D75.1 (K), D76.1 (K), D77.1 (K), D78.1 (K), D167.1 (K), U1.46 (PB9)
Row3: D149.1 (K), D150.1 (K), D151.1 (K), D152.1 (K), D153.1 (K), D154.1 (K), D155.1 (K), D156.1 (K), D157.1 (K), D158.1 (K), D159.1 (K), D160.1 (K), D161.1 (K), D162.1 (K), D163.1 (K), D164.1 (K), D165.1 (K), D166.1 (K), U1.18 (PB0)
Row4: D169.1 (K), D170.1 (K), D171.1 (K), D172.1 (K), D173.1 (K), D174.1 (K), D175.1 (K), D176.1 (K), D177.1 (K), D178.1 (K), D179.1 (K), D180.1 (K), D181.1 (K), D182.1 (K), D184.1 (K), D185.1 (K), D186.1 (K), D187.1 (K), U1.27 (PB14)
Row5: D168.1 (K), D202.1 (K), D203.1 (K), D204.1 (K), D205.1 (K), D206.1 (K), D207.1 (K), D208.1 (K), D209.1 (K), D210.1 (K), D211.1 (K), D212.1 (K), U1.28 (PB15)
S1: D51.2 (A), MX15.2 (ROW), SW3.S1
SWCLK: J1.2, U1.37 (PA14)
SWDIO: J1.3, U1.34 (PA13)
VCC: C4.2, C5.2, C6.2, C7.2, C8.2, C9.2, C10.2, C12.1, J1.4, R2.2, R4.1, R116.1, R118.1, SW1.1, U1.1 (VBAT), U1.9 (VDDA), U1.24 (VDD), U1.36 (VDD), U1.48 (VDD), U2.2 (VO)
ledGND: Q1.3 (D), R5.2, R6.2, R7.2, R8.2, R9.2, R10.2, R11.2, R12.2, R13.2, R14.2, R15.2, R16.2, R17.2, R18.2, R19.2, R20.2, R21.2, R22.2, R23.2, R24.2, R25.2, R26.2, R27.2, R28.2, R29.2, R30.2, R31.2, R32.2, R33.2, R34.2, R35.2, R36.2, R37.2, R38.2, R39.2, R40.2, R41.2, R42.2, R43.2, R44.2, R46.2, R47.2, R48.2, R49.2, R50.2, R51.2, R52.2, R53.2, R54.2, R55.2, R56.2, R57.2, R58.2, R59.2, R60.2, R61.2, R62.2, R63.2, R64.2, R65.2, R66.2, R67.2, R68.2, R69.2, R70.2, R71.2, R72.2, R73.2, R74.2, R75.2, R76.2, R77.2, R78.2, R79.2, R80.2, R81.2, R82.2, R84.2, R85.2, R86.2, R87.2, R88.2, R89.2, R90.2, R91.2, R92.2, R93.2, R94.2, R95.2, R96.2, R97.2, R98.2, R99.2, R100.2, R101.2, R102.2, R103.2, R104.2, R105.2, R106.2, R111.2, R112.2
ledPWM: R114.1, U1.21 (PB10)
