MaiTheSan/PCB-Design/KiCad/07-2021/Parallel/USB.sch

## KiCad design KiCad/07-2021/Parallel/USB.sch (2022-11-19)

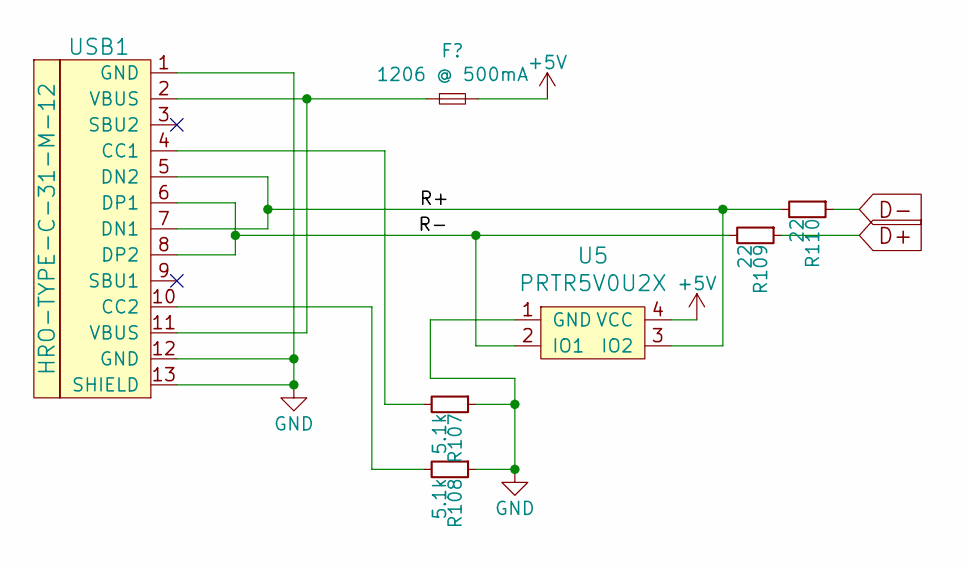
[picture p211: schematic USB.sch]

Parts:
R107, R108: 5.1k; C_0603
R109, R110: 22; C_0603
U5: PRTR5V0U2X; SOT143B
USB1: HRO-TYPE-C-31-M-12; HRO-TYPE-C-31-M-12-Assembly

Connections:
+5V: U5.4 (VCC)
D+: R109.1
D-: R110.1
GND: R107.1, R108.1, U5.1 (GND), USB1.1 (GND), USB1.12 (GND), USB1.13 (SHIELD)
unnamed: R107.2, USB1.4 (CC1)
unnamed: R108.2, USB1.10 (CC2)
unnamed: USB1.2 (VBUS), USB1.11 (VBUS)
R+: R110.2, U5.3 (IO2), USB1.5 (DN2), USB1.7 (DN1)
R-: R109.2, U5.2 (IO1), USB1.6 (DP1), USB1.8 (DP2)
