MaiTheSan/PCB-Design/KiCad/07-2021/Satri2.0/RGB.sch

## KiCad design KiCad/07-2021/Satri2.0/RGB.sch (2022-11-19)

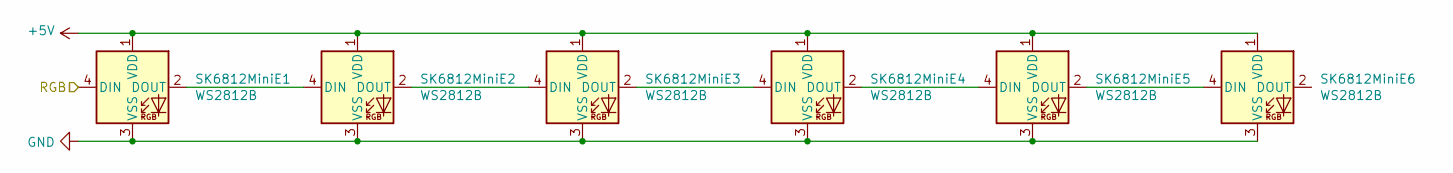
[picture p212: schematic RGB.sch]

Parts:
SK6812MiniE1, SK6812MiniE2, SK6812MiniE3: WS2812B; RGB-6028_FLIPPED
SK6812MiniE4, SK6812MiniE5, SK6812MiniE6: WS2812B; RGB-6028

Connections:
+5V: SK6812MiniE1.1 (VDD), SK6812MiniE2.1 (VDD), SK6812MiniE3.1 (VDD), SK6812MiniE4.1 (VDD), SK6812MiniE5.1 (VDD), SK6812MiniE6.1 (VDD)
GND: SK6812MiniE1.3 (VSS), SK6812MiniE2.3 (VSS), SK6812MiniE3.3 (VSS), SK6812MiniE4.3 (VSS), SK6812MiniE5.3 (VSS), SK6812MiniE6.3 (VSS)
unnamed: SK6812MiniE1.2 (DOUT), SK6812MiniE2.4 (DIN)
unnamed: SK6812MiniE2.2 (DOUT), SK6812MiniE3.4 (DIN)
unnamed: SK6812MiniE3.2 (DOUT), SK6812MiniE4.4 (DIN)
unnamed: SK6812MiniE4.2 (DOUT), SK6812MiniE5.4 (DIN)
unnamed: SK6812MiniE5.2 (DOUT), SK6812MiniE6.4 (DIN)
RGB: SK6812MiniE1.4 (DIN)
