MaiTheSan/PCB-Design/KiCad/07-2021/Satri2.0/Satxri6key.sch

## KiCad design KiCad/07-2021/Satri2.0/Satxri6key.sch (2022-11-19)

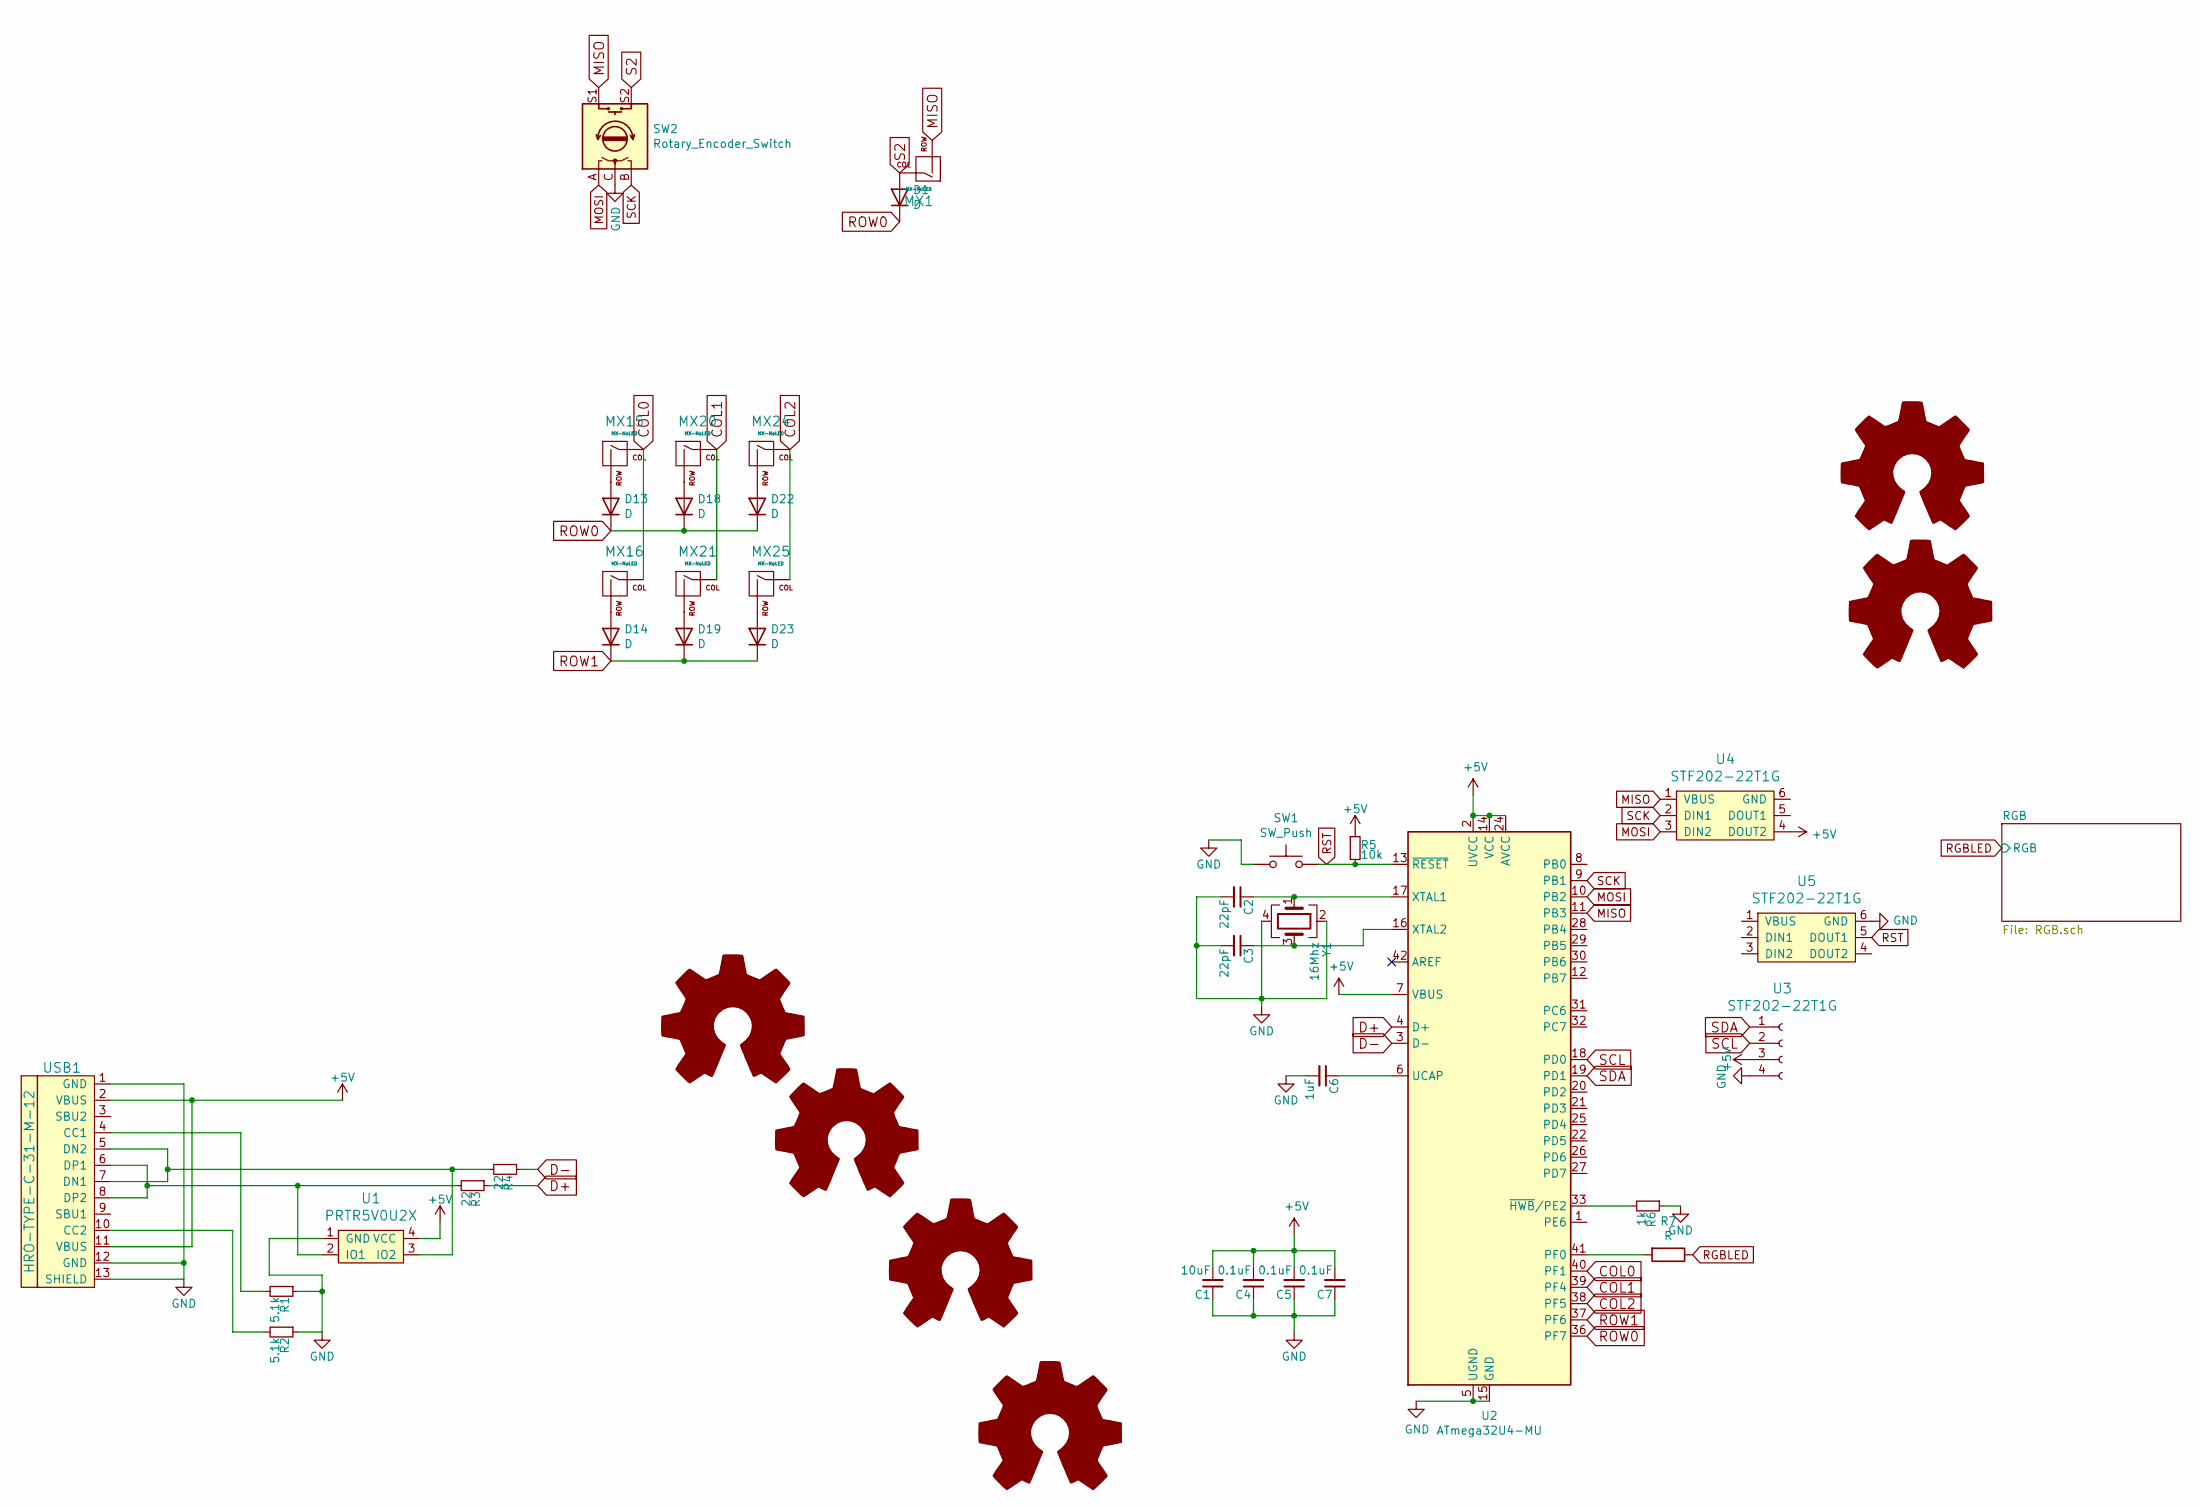
[picture p213: schematic Satxri6key.sch]

Parts:
C1: 10uF; C_0603
C2, C3: 22pF; C_0603
C4, C5, C7: 0.1uF; C_0603
C6: 1uF; C_0603
D1, D13, D14, D18, D19, D22, D23: D; D_SOD-123
LOGO1: Logo_Open_Hardware_Large; sanpjxlogo-PCB-type
LOGO2, LOGO3, LOGO4, LOGO5: Logo_Open_Hardware_Large; MountingHole_2.2mm_M2_DIN965_Pad
LOGO6: Logo_Open_Hardware_Large; satxrilogo
MX1, MX15, MX16, MX20, MX21, MX24, MX25: MX-NoLED; MXOnly-1U-Hotswap
R1, R2: 5.1k; R_0805
R3, R4: 22; R_0805
R5: 10k; R_0805
R6: 1k; R_0805
R7: R; R_0805
SW1: SW_Push; SKQG-1155865
SW2: Rotary_Encoder_Switch; RotaryEncoder_Alps_EC11E-Switch_Vertical_H20mm_Center
U1: PRTR5V0U2X; SOT143B
U2: ATmega32U4-MU; QFN-44-1EP_7x7mm_P0.5mm_EP5.2x5.2mm_ThermalVias
U3: STF202-22T1G; SSD091
U4, U5: STF202-22T1G; Reset_Pretty
USB1: HRO-TYPE-C-31-M-12; HRO-TYPE-C-31-M-12-Assembly
Y1: 16Mhz; Crystal_SMD_3225-4Pin_3.2x2.5mm

Connections:
+5V: C1.2, C4.2, C5.2, C7.2, R5.1, U1.4 (VCC), U2.2 (UVCC), U2.7 (VBUS), U2.14 (VCC), U2.24 (AVCC), U2.34 (VCC), U2.44 (AVCC), U3.3, U4.4 (DOUT2), USB1.2 (VBUS), USB1.11 (VBUS)
COL0: MX15.1 (COL), MX16.1 (COL), U2.40 (PF1)
COL1: MX20.1 (COL), MX21.1 (COL), U2.39 (PF4)
COL2: MX24.1 (COL), MX25.1 (COL), U2.38 (PF5)
D+: R3.1, U2.4 (D+)
D-: R4.1, U2.3 (D-)
GND: C1.1, C2.2, C3.2, C4.1, C5.1, C6.2, C7.1, R1.1, R2.1, R6.1, SW1.1, SW2.C, U1.1 (GND), U2.5 (UGND), U2.15 (GND), U2.23 (GND), U2.35 (GND), U2.43 (GND), U2.45 (GND), U3.4, U5.6 (GND), USB1.1 (GND), USB1.12 (GND), USB1.13 (SHIELD), Y1.2, Y1.4
MISO: MX1.2 (ROW), SW2.S1, U2.11 (PB3), U4.1 (VBUS)
MOSI: SW2.A, U2.10 (PB2), U4.3 (DIN2)
unnamed: C2.1, U2.17 (XTAL1), Y1.1
unnamed: C3.1, U2.16 (XTAL2), Y1.3
unnamed: C6.1, U2.6 (UCAP)
unnamed: D13.2 (A), MX15.2 (ROW)
unnamed: D14.2 (A), MX16.2 (ROW)
unnamed: D18.2 (A), MX20.2 (ROW)
unnamed: D19.2 (A), MX21.2 (ROW)
unnamed: D22.2 (A), MX24.2 (ROW)
unnamed: D23.2 (A), MX25.2 (ROW)
unnamed: R1.2, USB1.4 (CC1)
unnamed: R2.2, USB1.10 (CC2)
unnamed: R3.2, U1.2 (IO1), USB1.6 (DP1), USB1.8 (DP2)
unnamed: R4.2, U1.3 (IO2), USB1.5 (DN2), USB1.7 (DN1)
unnamed: R6.2, U2.33 (~HWB~/PE2)
unnamed: R7.2, U2.41 (PF0)
RGBLED: R7.1
ROW0: D1.1 (K), D13.1 (K), D18.1 (K), D22.1 (K), U2.36 (PF7)
ROW1: D14.1 (K), D19.1 (K), D23.1 (K), U2.37 (PF6)
RST: R5.2, SW1.2, U2.13 (~RESET), U5.5 (DOUT1)
S2: D1.2 (A), MX1.1 (COL), SW2.S2
SCK: SW2.B, U2.9 (PB1), U4.2 (DIN1)
SCL: U2.18 (PD0), U3.2
SDA: U2.19 (PD1), U3.1
