MaiTheSan/PCB-Design/KiCad/07-2021/TX75v2 PCB replacement/TX75v2 PCB replacement.sch

## KiCad design KiCad/07-2021/TX75v2 PCB replacement/TX75v2 PCB replacement.sch (2022-11-19)

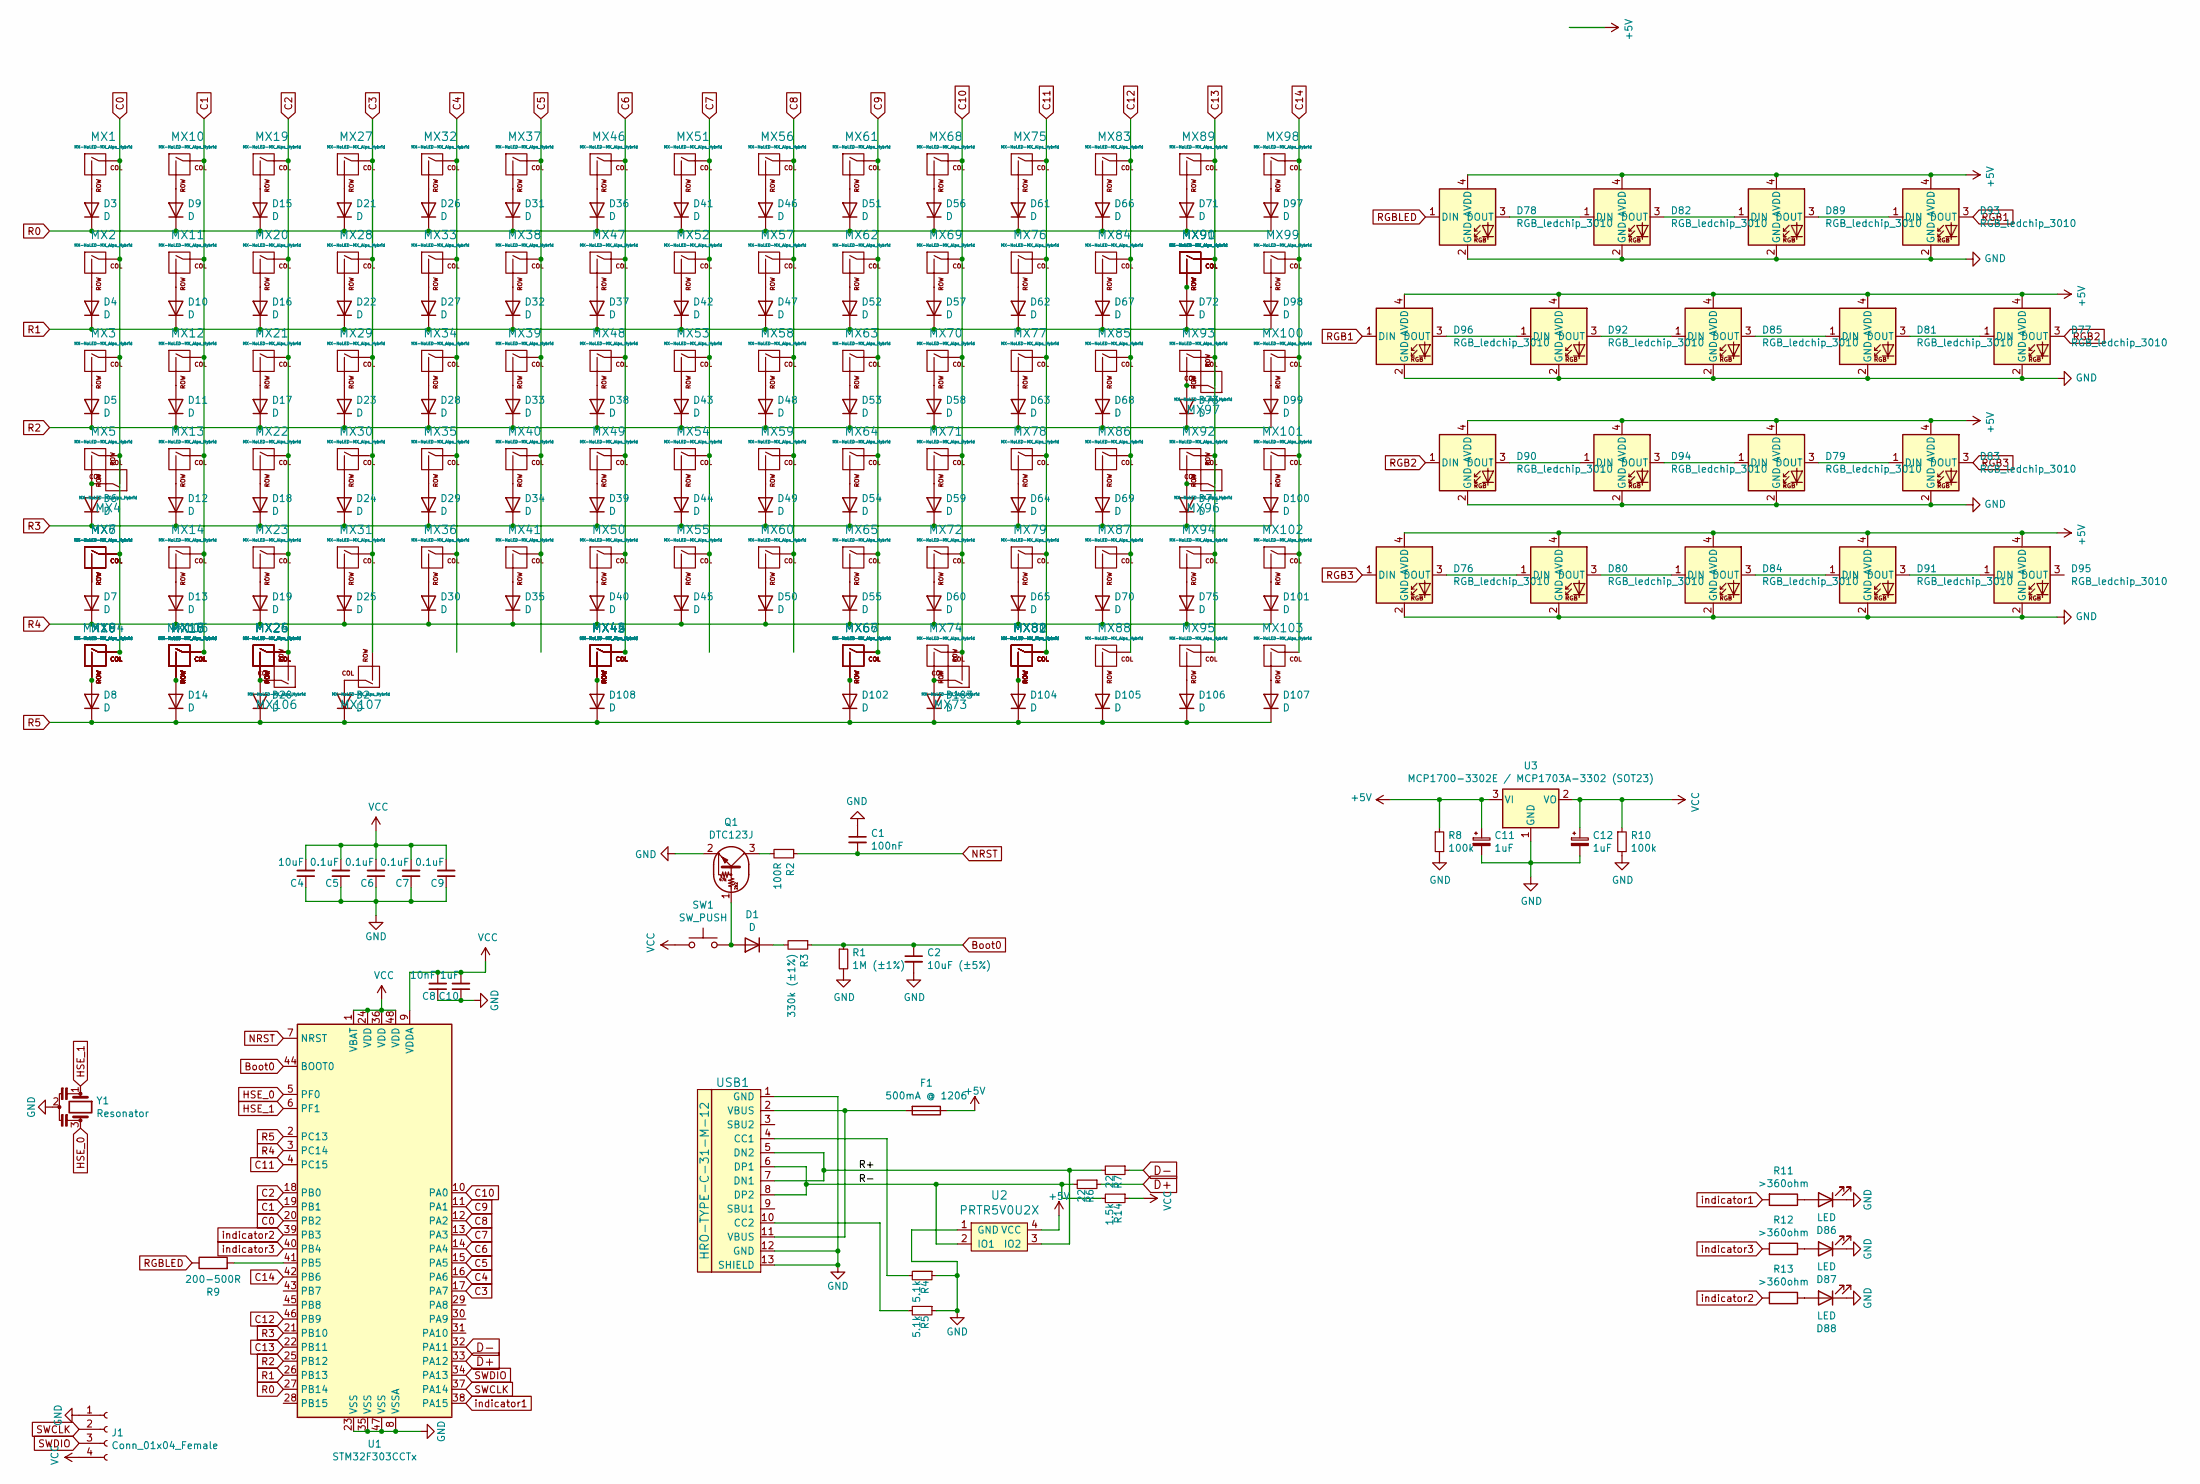
[picture p214: schematic TX75v2 PCB replacement.sch]

Parts:
C1: 100nF; C_0402_1005Metric
C2: 10uF (±5%); C_0402_1005Metric
C4: 10uF; C_0402_1005Metric
C5, C6, C7, C9: 0.1uF; C_0402_1005Metric
C8: 10nF; C_0402_1005Metric
C10: 1uF; C_0402_1005Metric
C11, C12: 1uF; CP_EIA-3216-10_Kemet-I
D1, D3, D4, D5, D6, D7, D8, D9, D10, D11, D12, D13, D14, D15, D16, D17, D18, D19, D20, D21, D22, D23, D24, D25, D26, D27, D28, D29, D30, D31, D32, D33, D34, D35, D36, D37, D38, D39, D40, D41, D42, D43, D44, D45, D46, D47, D48, D49, D50, D51, D52, D53, D54, D55, D56, D57, D58, D59, D60, D61, D62, D63, D64, D65, D66, D67, D68, D69, D70, D71, D72, D73, D74, D75, D97, D98, D99, D100, D101, D102, D103, D104, D105, D106, D107, D108: D; D_SOD-123
D2: D; D_SOD-123-Pretty
D76, D77, D78, D79, D80, D81, D82, D83, D84, D85, D89, D90, D91, D92, D93, D94, D95, D96: RGB_ledchip_3010; SK6805 SIDE-G 4020 LED-using6812footprint
D86, D87, D88: LED; LED_D3.0mm-Pretty-sanpjx
F1: 500mA @ 1206; Fuse_1206_3216Metric
J1: Conn_01x04_Female; PinHeader_1x04_P2.54mm_Vertical
MX1, MX2, MX10, MX11, MX12, MX13, MX14, MX16, MX17, MX19, MX20, MX21, MX22, MX23, MX27, MX28, MX29, MX30, MX31, MX32, MX33, MX34, MX35, MX36, MX37, MX38, MX39, MX40, MX41, MX46, MX47, MX48, MX49, MX50, MX51, MX52, MX53, MX54, MX55, MX56, MX57, MX58, MX59, MX60, MX61, MX62, MX63, MX64, MX65, MX66, MX68, MX69, MX70, MX71, MX72, MX74, MX75, MX76, MX77, MX78, MX79, MX82, MX83, MX84, MX85, MX86, MX88, MX89, MX91, MX92, MX94, MX95, MX98, MX99, MX100, MX101, MX102, MX103, MX104, MX105, MX106, MX107: MX-NoLED-MX_Alps_Hybrid; MXOnly-1U-NoLED
MX3, MX9, MX18, MX26, MX67, MX81, MX96: MX-NoLED-MX_Alps_Hybrid; MXOnly-1.5U-NoLED
MX4, MX87: MX-NoLED-MX_Alps_Hybrid; MXOnly-1.75U-NoLED
MX5, MX7, MX8, MX15, MX24, MX25, MX73, MX80: MX-NoLED-MX_Alps_Hybrid; MXOnly-1.25U-NoLED
MX6: MX-NoLED-MX_Alps_Hybrid; MXOnly-2.25U-NoLED
MX42: MX-NoLED-MX_Alps_Hybrid; MXOnly-6.25U-ReversedStabilizers-NoLED
MX43, MX44, MX45: MX-NoLED-MX_Alps_Hybrid; MXOnly-7U-ReversedStabilizers-NoLED
MX90: MX-NoLED-MX_Alps_Hybrid; MXOnly-2U-NoLED
MX93: MX-NoLED-MX_Alps_Hybrid; MXOnly-2.25U-ReversedStabilizers-NoLED
MX97: MX-NoLED-MX_Alps_Hybrid; MXOnly-ISO-ROTATED-ReversedStabilizers-NoLED
Q1: DTC123J; SOT-23
R1: 1M (±1%); R_0805
R2: 100R; R_0805
R3: 330k (±1%); R_0805
R4, R5: 5.1k; R_0805
R6, R7: 22; R_0805
R8, R10: 100k; R_0805
R9: 200-500R; R_0805
R11, R12, R13: >360ohm; R_0805
R14: 1.5k; R_0805
SW1: SW_PUSH; SKQG-1155865
U1: STM32F303CCTx; LQFP-48_7x7mm_P0.5mm
U2: PRTR5V0U2X; SOT143B
U3: MCP1700-3302E / MCP1703A-3302 (SOT23); SOT-23
USB1: HRO-TYPE-C-31-M-12; HRO-TYPE-C-31-M-12-Assembly
Y1: Resonator; Resonator_SMD_muRata_CSTxExxV-3Pin_3.0x1.1mm

Connections:
+5V: C11.1, D76.4 (AVDD), D77.4 (AVDD), D78.4 (AVDD), D79.4 (AVDD), D80.4 (AVDD), D81.4 (AVDD), D82.4 (AVDD), D83.4 (AVDD), D84.4 (AVDD), D85.4 (AVDD), D89.4 (AVDD), D90.4 (AVDD), D91.4 (AVDD), D92.4 (AVDD), D93.4 (AVDD), D94.4 (AVDD), D95.4 (AVDD), D96.4 (AVDD), F1.1, R8.1, U2.4 (VCC), U3.3 (VI)
Boot0: C2.1, R1.1, R3.1, U1.44 (BOOT0)
C0: MX1.1 (COL), MX2.1 (COL), MX3.1 (COL), MX4.2 (ROW), MX5.1 (COL), MX6.1 (COL), MX7.1 (COL), MX8.1 (COL), MX9.1 (COL), MX104.1 (COL), U1.20 (PB2)
C1: MX10.1 (COL), MX11.1 (COL), MX12.1 (COL), MX13.1 (COL), MX14.1 (COL), MX15.1 (COL), MX16.1 (COL), MX17.1 (COL), MX18.1 (COL), MX105.1 (COL), U1.19 (PB1)
C2: MX19.1 (COL), MX20.1 (COL), MX21.1 (COL), MX22.1 (COL), MX23.1 (COL), MX24.1 (COL), MX25.1 (COL), MX26.1 (COL), MX106.2 (ROW), U1.18 (PB0)
C3: MX27.1 (COL), MX28.1 (COL), MX29.1 (COL), MX30.1 (COL), MX31.1 (COL), MX107.2 (ROW), U1.17 (PA7)
C4: MX32.1 (COL), MX33.1 (COL), MX34.1 (COL), MX35.1 (COL), MX36.1 (COL), U1.16 (PA6)
C5: MX37.1 (COL), MX38.1 (COL), MX39.1 (COL), MX40.1 (COL), MX41.1 (COL), U1.15 (PA5)
C6: MX42.1 (COL), MX43.1 (COL), MX44.1 (COL), MX45.1 (COL), MX46.1 (COL), MX47.1 (COL), MX48.1 (COL), MX49.1 (COL), MX50.1 (COL), U1.14 (PA4)
C7: MX51.1 (COL), MX52.1 (COL), MX53.1 (COL), MX54.1 (COL), MX55.1 (COL), U1.13 (PA3)
C8: MX56.1 (COL), MX57.1 (COL), MX58.1 (COL), MX59.1 (COL), MX60.1 (COL), U1.12 (PA2)
C9: MX61.1 (COL), MX62.1 (COL), MX63.1 (COL), MX64.1 (COL), MX65.1 (COL), MX66.1 (COL), MX67.1 (COL), U1.11 (PA1)
C10: MX68.1 (COL), MX69.1 (COL), MX70.1 (COL), MX71.1 (COL), MX72.1 (COL), MX73.2 (ROW), MX74.1 (COL), U1.10 (PA0)
C11: MX75.1 (COL), MX76.1 (COL), MX77.1 (COL), MX78.1 (COL), MX79.1 (COL), MX80.1 (COL), MX81.1 (COL), MX82.1 (COL), U1.4 (PC15)
C12: MX83.1 (COL), MX84.1 (COL), MX85.1 (COL), MX86.1 (COL), MX87.1 (COL), MX88.1 (COL), U1.46 (PB9)
C13: MX89.1 (COL), MX90.1 (COL), MX91.1 (COL), MX92.1 (COL), MX93.1 (COL), MX94.1 (COL), MX95.1 (COL), MX96.2 (ROW), MX97.2 (ROW), U1.22 (PB11)
C14: MX98.1 (COL), MX99.1 (COL), MX100.1 (COL), MX101.1 (COL), MX102.1 (COL), MX103.1 (COL), U1.42 (PB6)
D+: R6.1, U1.33 (PA12)
D-: R7.1, U1.32 (PA11)
GND: C1.1, C2.2, C4.1, C5.1, C6.1, C7.1, C8.1, C9.1, C10.1, C11.2, C12.2, D76.2 (GND), D77.2 (GND), D78.2 (GND), D79.2 (GND), D80.2 (GND), D81.2 (GND), D82.2 (GND), D83.2 (GND), D84.2 (GND), D85.2 (GND), D86.1 (K), D87.1 (K), D88.1 (K), D89.2 (GND), D90.2 (GND), D91.2 (GND), D92.2 (GND), D93.2 (GND), D94.2 (GND), D95.2 (GND), D96.2 (GND), J1.1, Q1.2 (E), R1.2, R4.1, R5.1, R8.2, R10.2, U1.8 (VSSA), U1.23 (VSS), U1.35 (VSS), U1.47 (VSS), U2.1 (GND), U3.1 (GND), USB1.1 (GND), USB1.12 (GND), USB1.13 (SHIELD), Y1.2
HSE_0: U1.5 (PF0), Y1.3
HSE_1: U1.6 (PF1), Y1.1
NRST: C1.2, R2.1, U1.7 (NRST)
unnamed: D1.1 (K), R3.2
unnamed: D1.2 (A), Q1.1 (B), SW1.2
unnamed: D2.2 (A), MX107.1 (COL)
unnamed: D3.2 (A), MX1.2 (ROW)
unnamed: D4.2 (A), MX2.2 (ROW)
unnamed: D5.2 (A), MX3.2 (ROW)
unnamed: D6.2 (A), MX4.1 (COL), MX5.2 (ROW)
unnamed: D7.2 (A), MX6.2 (ROW), MX7.2 (ROW)
unnamed: D8.2 (A), MX8.2 (ROW), MX9.2 (ROW), MX104.2 (ROW)
unnamed: D9.2 (A), MX10.2 (ROW)
unnamed: D10.2 (A), MX11.2 (ROW)
unnamed: D11.2 (A), MX12.2 (ROW)
unnamed: D12.2 (A), MX13.2 (ROW)
unnamed: D13.2 (A), MX14.2 (ROW)
unnamed: D14.2 (A), MX15.2 (ROW), MX16.2 (ROW), MX17.2 (ROW), MX18.2 (ROW), MX105.2 (ROW)
unnamed: D15.2 (A), MX19.2 (ROW)
unnamed: D16.2 (A), MX20.2 (ROW)
unnamed: D17.2 (A), MX21.2 (ROW)
unnamed: D18.2 (A), MX22.2 (ROW)
unnamed: D19.2 (A), MX23.2 (ROW)
unnamed: D20.2 (A), MX24.2 (ROW), MX25.2 (ROW), MX26.2 (ROW), MX106.1 (COL)
unnamed: D21.2 (A), MX27.2 (ROW)
unnamed: D22.2 (A), MX28.2 (ROW)
unnamed: D23.2 (A), MX29.2 (ROW)
unnamed: D24.2 (A), MX30.2 (ROW)
unnamed: D25.2 (A), MX31.2 (ROW)
unnamed: D26.2 (A), MX32.2 (ROW)
unnamed: D27.2 (A), MX33.2 (ROW)
unnamed: D28.2 (A), MX34.2 (ROW)
unnamed: D29.2 (A), MX35.2 (ROW)
unnamed: D30.2 (A), MX36.2 (ROW)
unnamed: D31.2 (A), MX37.2 (ROW)
unnamed: D32.2 (A), MX38.2 (ROW)
unnamed: D33.2 (A), MX39.2 (ROW)
unnamed: D34.2 (A), MX40.2 (ROW)
unnamed: D35.2 (A), MX41.2 (ROW)
unnamed: D36.2 (A), MX46.2 (ROW)
unnamed: D37.2 (A), MX47.2 (ROW)
unnamed: D38.2 (A), MX48.2 (ROW)
unnamed: D39.2 (A), MX49.2 (ROW)
unnamed: D40.2 (A), MX50.2 (ROW)
unnamed: D41.2 (A), MX51.2 (ROW)
unnamed: D42.2 (A), MX52.2 (ROW)
unnamed: D43.2 (A), MX53.2 (ROW)
unnamed: D44.2 (A), MX54.2 (ROW)
unnamed: D45.2 (A), MX55.2 (ROW)
unnamed: D46.2 (A), MX56.2 (ROW)
unnamed: D47.2 (A), MX57.2 (ROW)
unnamed: D48.2 (A), MX58.2 (ROW)
unnamed: D49.2 (A), MX59.2 (ROW)
unnamed: D50.2 (A), MX60.2 (ROW)
unnamed: D51.2 (A), MX61.2 (ROW)
unnamed: D52.2 (A), MX62.2 (ROW)
unnamed: D53.2 (A), MX63.2 (ROW)
unnamed: D54.2 (A), MX64.2 (ROW)
unnamed: D55.2 (A), MX65.2 (ROW)
unnamed: D56.2 (A), MX68.2 (ROW)
unnamed: D57.2 (A), MX69.2 (ROW)
unnamed: D58.2 (A), MX70.2 (ROW)
unnamed: D59.2 (A), MX71.2 (ROW)
unnamed: D60.2 (A), MX72.2 (ROW)
unnamed: D61.2 (A), MX75.2 (ROW)
unnamed: D62.2 (A), MX76.2 (ROW)
unnamed: D63.2 (A), MX77.2 (ROW)
unnamed: D64.2 (A), MX78.2 (ROW)
unnamed: D65.2 (A), MX79.2 (ROW)
unnamed: D66.2 (A), MX83.2 (ROW)
unnamed: D67.2 (A), MX84.2 (ROW)
unnamed: D68.2 (A), MX85.2 (ROW)
unnamed: D69.2 (A), MX86.2 (ROW)
unnamed: D70.2 (A), MX87.2 (ROW)
unnamed: D71.2 (A), MX89.2 (ROW)
unnamed: D72.2 (A), MX90.2 (ROW), MX91.2 (ROW)
unnamed: D73.2 (A), MX93.2 (ROW), MX97.1 (COL)
unnamed: D74.2 (A), MX92.2 (ROW), MX96.1 (COL)
unnamed: D75.2 (A), MX94.2 (ROW)
unnamed: D76.3 (DOUT), D80.1 (DIN)
unnamed: D77.1 (DIN), D81.3 (DOUT)
unnamed: D78.3 (DOUT), D82.1 (DIN)
unnamed: D79.1 (DIN), D94.3 (DOUT)
unnamed: D79.3 (DOUT), D83.1 (DIN)
unnamed: D80.3 (DOUT), D84.1 (DIN)
unnamed: D81.1 (DIN), D85.3 (DOUT)
unnamed: D82.3 (DOUT), D89.1 (DIN)
unnamed: D84.3 (DOUT), D91.1 (DIN)
unnamed: D85.1 (DIN), D92.3 (DOUT)
unnamed: D86.2 (A), R11.1
unnamed: D87.2 (A), R12.1
unnamed: D88.2 (A), R13.1
unnamed: D89.3 (DOUT), D93.1 (DIN)
unnamed: D90.3 (DOUT), D94.1 (DIN)
unnamed: D91.3 (DOUT), D95.1 (DIN)
unnamed: D92.1 (DIN), D96.3 (DOUT)
unnamed: D97.2 (A), MX98.2 (ROW)
unnamed: D98.2 (A), MX99.2 (ROW)
unnamed: D99.2 (A), MX100.2 (ROW)
unnamed: D100.2 (A), MX101.2 (ROW)
unnamed: D101.2 (A), MX102.2 (ROW)
unnamed: D102.2 (A), MX66.2 (ROW), MX67.2 (ROW)
unnamed: D103.2 (A), MX73.1 (COL), MX74.2 (ROW)
unnamed: D104.2 (A), MX80.2 (ROW), MX81.2 (ROW), MX82.2 (ROW)
unnamed: D105.2 (A), MX88.2 (ROW)
unnamed: D106.2 (A), MX95.2 (ROW)
unnamed: D107.2 (A), MX103.2 (ROW)
unnamed: D108.2 (A), MX42.2 (ROW), MX43.2 (ROW), MX44.2 (ROW), MX45.2 (ROW)
unnamed: F1.2, USB1.2 (VBUS), USB1.11 (VBUS)
unnamed: Q1.3 (C), R2.2
unnamed: R4.2, USB1.4 (CC1)
unnamed: R5.2, USB1.10 (CC2)
unnamed: R9.2, U1.41 (PB5)
R0: D3.1 (K), D9.1 (K), D15.1 (K), D21.1 (K), D26.1 (K), D31.1 (K), D36.1 (K), D41.1 (K), D46.1 (K), D51.1 (K), D56.1 (K), D61.1 (K), D66.1 (K), D71.1 (K), D97.1 (K), U1.27 (PB14)
R1: D4.1 (K), D10.1 (K), D16.1 (K), D22.1 (K), D27.1 (K), D32.1 (K), D37.1 (K), D42.1 (K), D47.1 (K), D52.1 (K), D57.1 (K), D62.1 (K), D67.1 (K), D72.1 (K), D98.1 (K), U1.26 (PB13)
R2: D5.1 (K), D11.1 (K), D17.1 (K), D23.1 (K), D28.1 (K), D33.1 (K), D38.1 (K), D43.1 (K), D48.1 (K), D53.1 (K), D58.1 (K), D63.1 (K), D68.1 (K), D73.1 (K), D99.1 (K), U1.25 (PB12)
R3: D6.1 (K), D12.1 (K), D18.1 (K), D24.1 (K), D29.1 (K), D34.1 (K), D39.1 (K), D44.1 (K), D49.1 (K), D54.1 (K), D59.1 (K), D64.1 (K), D69.1 (K), D74.1 (K), D100.1 (K), U1.21 (PB10)
R4: D7.1 (K), D13.1 (K), D19.1 (K), D25.1 (K), D30.1 (K), D35.1 (K), D40.1 (K), D45.1 (K), D50.1 (K), D55.1 (K), D60.1 (K), D65.1 (K), D70.1 (K), D75.1 (K), D101.1 (K), U1.3 (PC14)
R5: D2.1 (K), D8.1 (K), D14.1 (K), D20.1 (K), D102.1 (K), D103.1 (K), D104.1 (K), D105.1 (K), D106.1 (K), D107.1 (K), D108.1 (K), U1.2 (PC13)
R+: R7.2, U2.3 (IO2), USB1.5 (DN2), USB1.7 (DN1)
R-: R6.2, R14.2, U2.2 (IO1), USB1.6 (DP1), USB1.8 (DP2)
RGB1: D93.3 (DOUT), D96.1 (DIN)
RGB2: D77.3 (DOUT), D90.1 (DIN)
RGB3: D76.1 (DIN), D83.3 (DOUT)
RGBLED: D78.1 (DIN), R9.1
SWCLK: J1.2, U1.37 (PA14)
SWDIO: J1.3, U1.34 (PA13)
VCC: C4.2, C5.2, C6.2, C7.2, C8.2, C9.2, C10.2, C12.1, J1.4, R10.1, R14.1, SW1.1, U1.1 (VBAT), U1.9 (VDDA), U1.24 (VDD), U1.36 (VDD), U1.48 (VDD), U3.2 (VO)
indicator1: R11.2, U1.38 (PA15)
indicator2: R13.2, U1.39 (PB3)
indicator3: R12.2, U1.40 (PB4)
