MaiTheSan/PCB-Design/KiCad/07-2021/TX75v2 PCB replacement/uso!VNC.sch

## KiCad design KiCad/07-2021/TX75v2 PCB replacement/uso!VNC.sch (2022-11-19)

Schematic: uso!VNC.sch

Parts:
C1: 10uF; C_0603
C2, C3: 22pF; C_0603
C4, C5, C7: 0.1uF; C_0603
C6: 1uF; C_0603
R1, R2: 5.1k; R_0805
R3, R4: 22; R_0805
R5: 10k; R_0805
R6: 1k; R_0805
R7: R; R_0805
SW1: SW_Push; SKQG-1155865
U1: PRTR5V0U2X; SOT143B
U2: ATmega32U4-MU; QFN-44-1EP_7x7mm_P0.5mm_EP5.2x5.2mm_ThermalVias
U4: STF202-22T1G; Reset_Pretty
USB1: HRO-TYPE-C-31-M-12; HRO-TYPE-C-31-M-12-Assembly
Y1: 16Mhz; Crystal_SMD_3225-4Pin_3.2x2.5mm
