MaiTheSan/PCB-Design/KiCad/08-2021/nonem/nonem.sch

## KiCad design KiCad/08-2021/nonem/nonem.sch (2022-11-19)

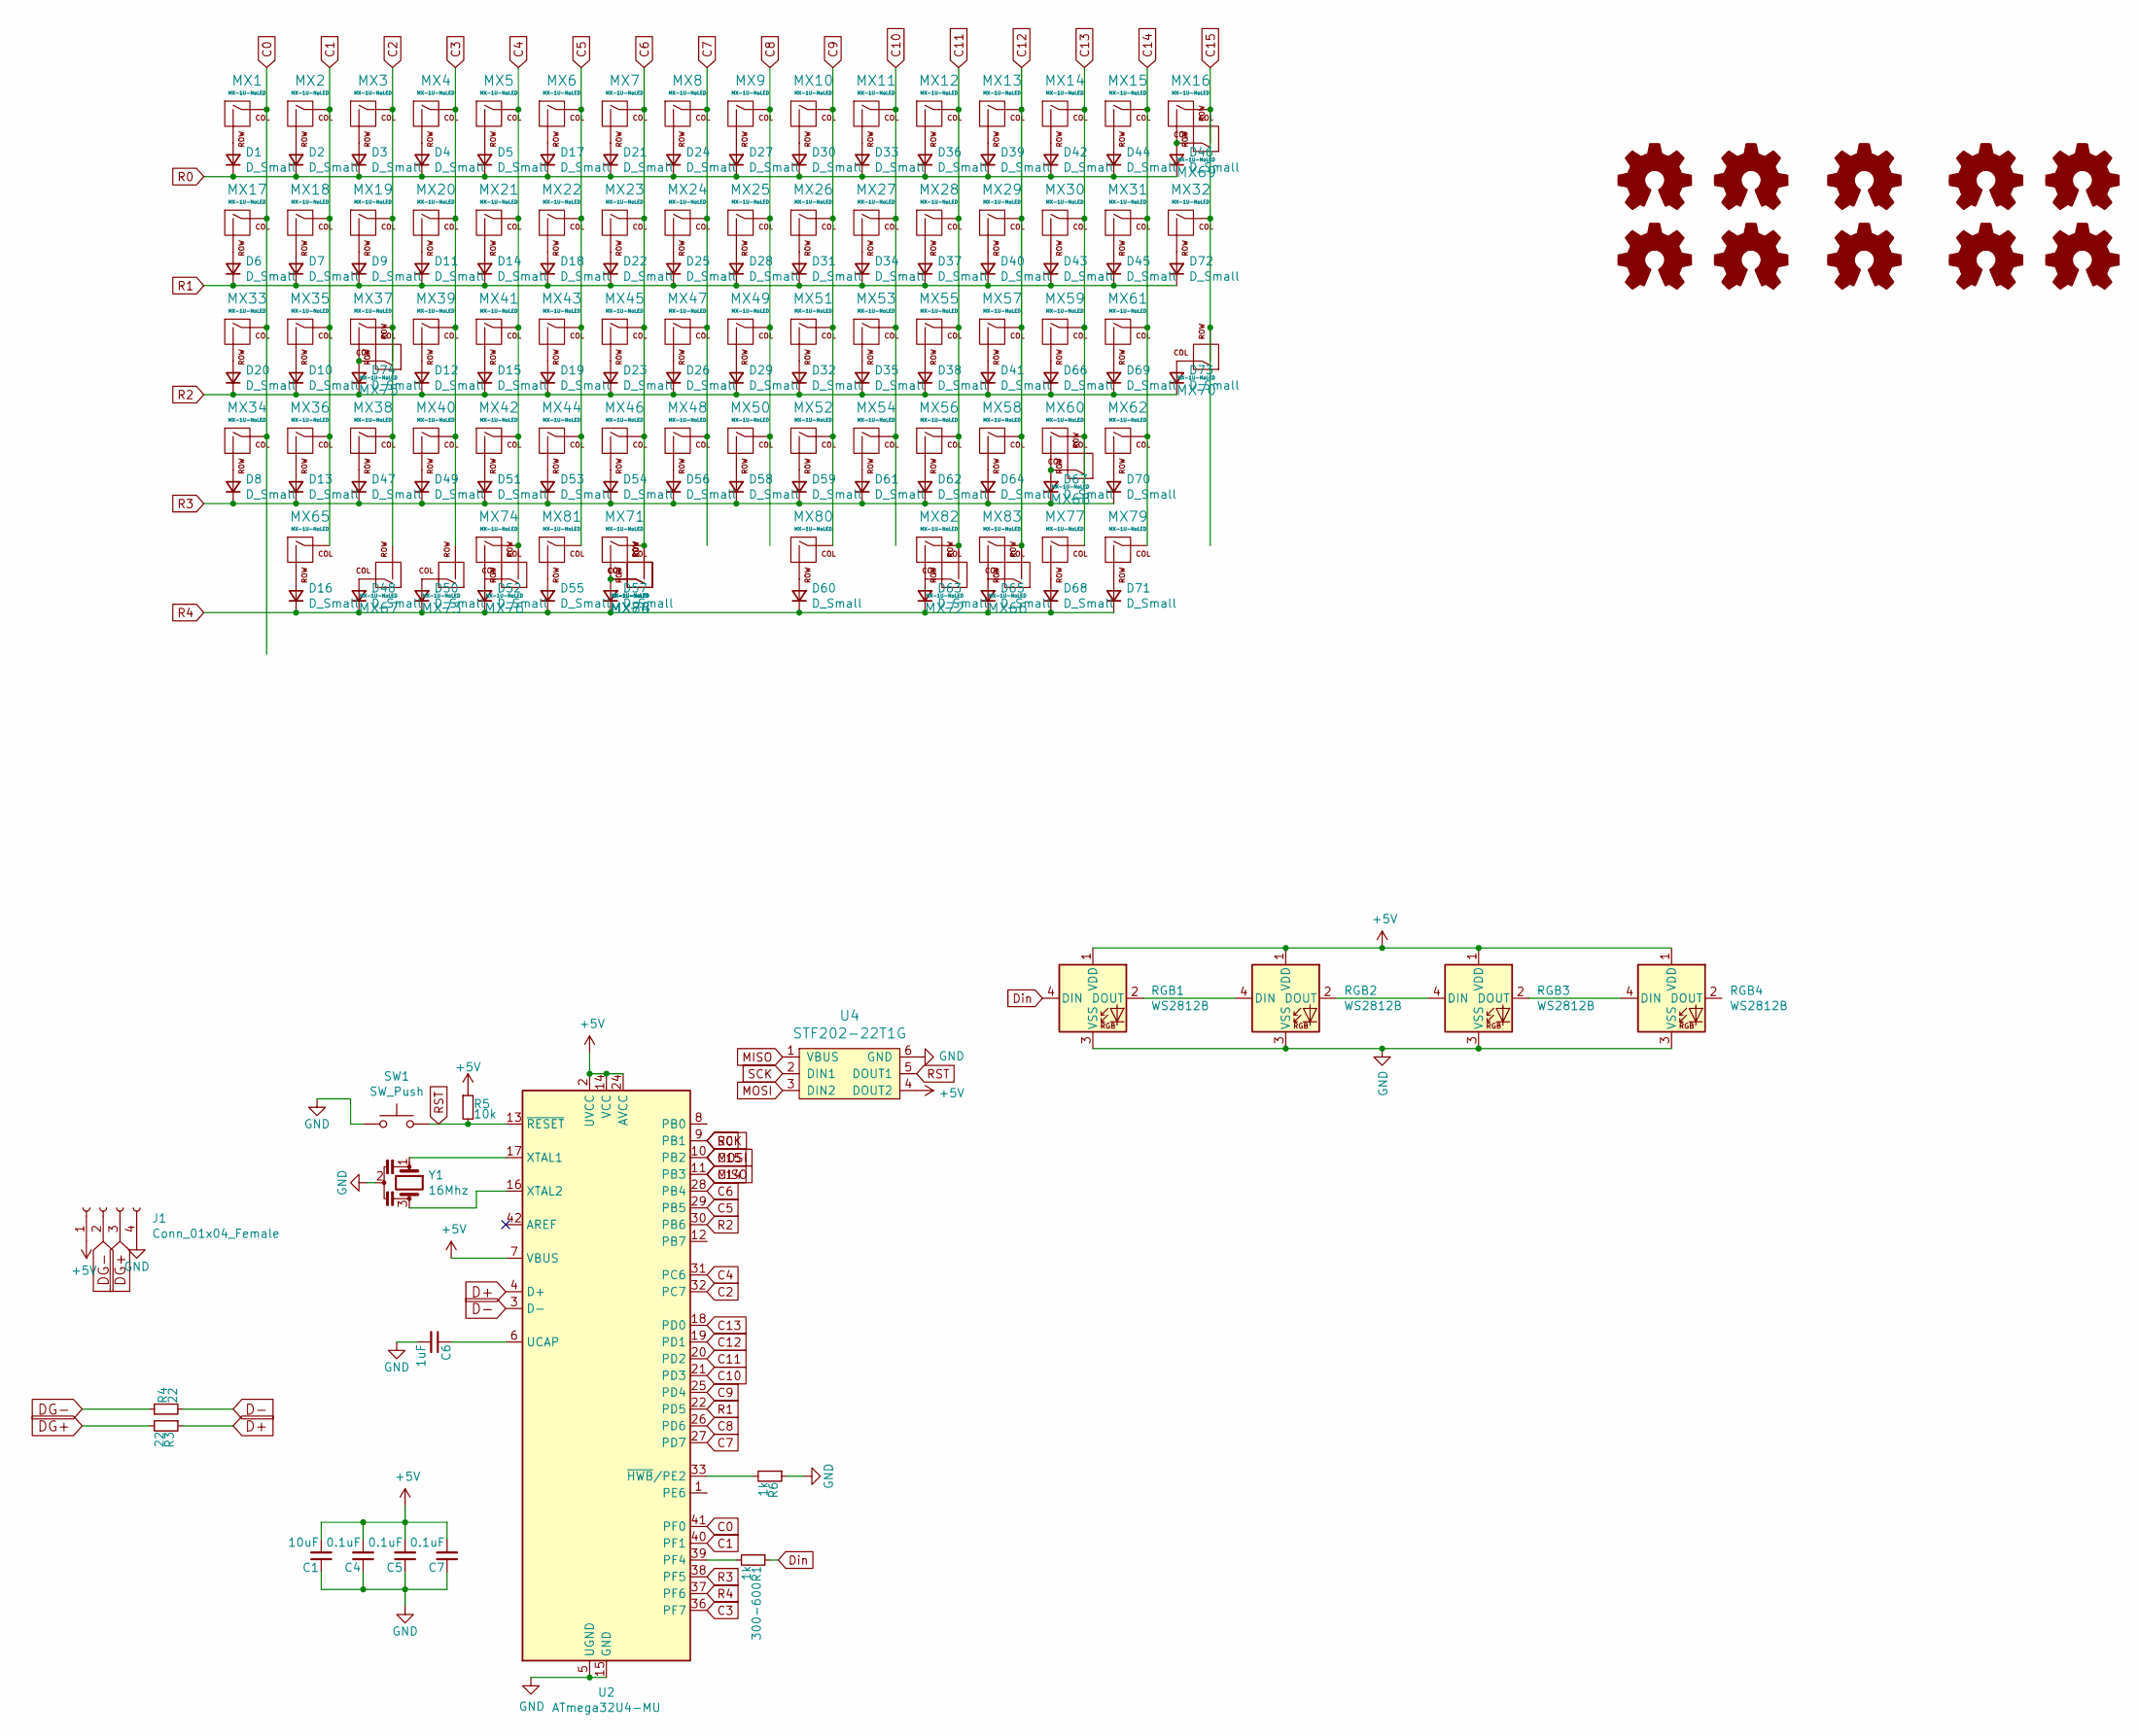
[picture p215: schematic nonem.sch]

Parts:
300-600R1: 1k; R_0805
C1: 10uF; C_0603
C4, C5, C7: 0.1uF; C_0603
C6: 1uF; C_0603
D1, D2, D3, D4, D5, D6, D7, D8, D9, D10, D11, D12, D13, D14, D15, D16, D17, D18, D19, D20, D21, D22, D23, D24, D25, D26, D27, D28, D29, D30, D31, D32, D33, D34, D35, D36, D37, D38, D39, D40, D41, D42, D43, D44, D45, D46, D47, D48, D49, D50, D51, D52, D53, D54, D55, D56, D57, D58, D59, D60, D61, D62, D63, D64, D65, D66, D67, D68, D69, D70, D71, D72, D73, D74: D_Small; D_SOD-123
J1: Conn_01x04_Female; JST-SR-4
LOGO1, LOGO2, LOGO3, LOGO4, LOGO5, LOGO6, LOGO7, LOGO8, LOGO9, LOGO10: Logo_Open_Hardware_Small; MountingHole_2.2mm_M2_ISO14580_Pad
MX1, MX2, MX3, MX4, MX5, MX6, MX7, MX8, MX9, MX10, MX11, MX12, MX13, MX14, MX15, MX17, MX18, MX20, MX21, MX22, MX23, MX24, MX25, MX26, MX27, MX28, MX29, MX30, MX31, MX33, MX34, MX35, MX36, MX39, MX40, MX41, MX42, MX43, MX44, MX45, MX46, MX47, MX48, MX49, MX50, MX51, MX52, MX53, MX54, MX55, MX56, MX57, MX58, MX59, MX62, MX65, MX67, MX69, MX70, MX81, MX82: MX-1U-NoLED; MXOnly-1U-Hotswap
MX16: MX-1U-NoLED; MXOnly-2U-Hotswap
MX19, MX32, MX76, MX79, MX83: MX-1U-NoLED; MXOnly-1.5U-Hotswap
MX37, MX60: MX-1U-NoLED; MXOnly-1.75U-Hotswap
MX38, MX61: MX-1U-NoLED; MXOnly-2.25U-Hotswap
MX66, MX72, MX73, MX74, MX75, MX77: MX-1U-NoLED; MXOnly-1.25U-Hotswap
MX68, MX78: MX-1U-NoLED; MXOnly-2.75U-Hotswap
MX71: MX-1U-NoLED; MXOnly-6.25U-Hotswap-ReversedStabilizers
MX80: MX-1U-NoLED; MXOnly-2.25U-Hotswap-ReversedStabilizers
MX84: MX-1U-NoLED; MXOnly-7U-Hotswap
R3, R4: 22; R_0805
R5: 10k; R_0805
R6: 1k; R_0805
RGB1, RGB2, RGB3, RGB4: WS2812B; RGB-6028-mid
SW1: SW_Push; SKQG-1155865
U2: ATmega32U4-MU; QFN-44-1EP_7x7mm_P0.5mm_EP5.15x5.15mm
U4: STF202-22T1G; Reset_Pretty
Y1: 16Mhz; Resonator_SMD_muRata_CSTxExxV-3Pin_3.0x1.1mm

Connections:
+5V: C1.2, C4.2, C5.2, C7.2, J1.1, R5.1, RGB1.1 (VDD), RGB2.1 (VDD), RGB3.1 (VDD), RGB4.1 (VDD), U2.2 (UVCC), U2.7 (VBUS), U2.14 (VCC), U2.24 (AVCC), U2.34 (VCC), U2.44 (AVCC), U4.4 (DOUT2)
C0: MX1.1 (COL), MX17.1 (COL), MX33.1 (COL), MX34.1 (COL), U2.41 (PF0)
C1: MX2.1 (COL), MX18.1 (COL), MX35.1 (COL), MX36.1 (COL), MX65.1 (COL), U2.40 (PF1)
C2: MX3.1 (COL), MX19.1 (COL), MX37.1 (COL), MX38.1 (COL), MX67.2 (ROW), MX75.2 (ROW), U2.32 (PC7)
C3: MX4.1 (COL), MX20.1 (COL), MX39.1 (COL), MX40.1 (COL), MX73.2 (ROW), U2.36 (PF7)
C4: MX5.1 (COL), MX21.1 (COL), MX41.1 (COL), MX42.1 (COL), MX74.1 (COL), MX76.2 (ROW), U2.31 (PC6)
C5: MX6.1 (COL), MX22.1 (COL), MX43.1 (COL), MX44.1 (COL), MX81.1 (COL), U2.29 (PB5)
C6: MX7.1 (COL), MX23.1 (COL), MX45.1 (COL), MX46.1 (COL), MX71.1 (COL), MX78.2 (ROW), MX84.2 (ROW), U2.28 (PB4)
C7: MX8.1 (COL), MX24.1 (COL), MX47.1 (COL), MX48.1 (COL), U2.27 (PD7)
C8: MX9.1 (COL), MX25.1 (COL), MX49.1 (COL), MX50.1 (COL), U2.26 (PD6)
C9: MX10.1 (COL), MX26.1 (COL), MX51.1 (COL), MX52.1 (COL), MX80.1 (COL), U2.25 (PD4)
C10: MX11.1 (COL), MX27.1 (COL), MX53.1 (COL), MX54.1 (COL), U2.21 (PD3)
C11: MX12.1 (COL), MX28.1 (COL), MX55.1 (COL), MX56.1 (COL), MX72.2 (ROW), MX82.1 (COL), U2.20 (PD2)
C12: MX13.1 (COL), MX29.1 (COL), MX57.1 (COL), MX58.1 (COL), MX66.2 (ROW), MX83.1 (COL), U2.19 (PD1)
C13: MX14.1 (COL), MX30.1 (COL), MX59.1 (COL), MX60.1 (COL), MX68.2 (ROW), MX77.1 (COL), U2.18 (PD0)
C14: MX15.1 (COL), MX31.1 (COL), MX61.1 (COL), MX62.1 (COL), MX79.1 (COL), U2.11 (PB3), U4.1 (VBUS)
C15: MX16.1 (COL), MX32.1 (COL), MX69.2 (ROW), MX70.2 (ROW), U2.10 (PB2), U4.3 (DIN2)
D+: R3.1, U2.4 (D+)
D-: R4.2, U2.3 (D-)
DG+: J1.3, R3.2
DG-: J1.2, R4.1
Din: 300-600R1.1, RGB1.4 (DIN)
GND: C1.1, C4.1, C5.1, C6.2, C7.1, J1.4, R6.1, RGB1.3 (VSS), RGB2.3 (VSS), RGB3.3 (VSS), RGB4.3 (VSS), SW1.1, U2.5 (UGND), U2.15 (GND), U2.23 (GND), U2.35 (GND), U2.43 (GND), U2.45 (GND), U4.6 (GND), Y1.2
unnamed: 300-600R1.2, U2.39 (PF4)
unnamed: C6.1, U2.6 (UCAP)
unnamed: D1.2 (A), MX1.2 (ROW)
unnamed: D2.2 (A), MX2.2 (ROW)
unnamed: D3.2 (A), MX3.2 (ROW)
unnamed: D4.2 (A), MX4.2 (ROW)
unnamed: D5.2 (A), MX5.2 (ROW)
unnamed: D6.2 (A), MX17.2 (ROW)
unnamed: D7.2 (A), MX18.2 (ROW)
unnamed: D8.2 (A), MX34.2 (ROW)
unnamed: D9.2 (A), MX19.2 (ROW)
unnamed: D10.2 (A), MX35.2 (ROW)
unnamed: D11.2 (A), MX20.2 (ROW)
unnamed: D12.2 (A), MX39.2 (ROW)
unnamed: D13.2 (A), MX36.2 (ROW)
unnamed: D14.2 (A), MX21.2 (ROW)
unnamed: D15.2 (A), MX41.2 (ROW)
unnamed: D16.2 (A), MX65.2 (ROW)
unnamed: D17.2 (A), MX6.2 (ROW)
unnamed: D18.2 (A), MX22.2 (ROW)
unnamed: D19.2 (A), MX43.2 (ROW)
unnamed: D20.2 (A), MX33.2 (ROW)
unnamed: D21.2 (A), MX7.2 (ROW)
unnamed: D22.2 (A), MX23.2 (ROW)
unnamed: D23.2 (A), MX45.2 (ROW)
unnamed: D24.2 (A), MX8.2 (ROW)
unnamed: D25.2 (A), MX24.2 (ROW)
unnamed: D26.2 (A), MX47.2 (ROW)
unnamed: D27.2 (A), MX9.2 (ROW)
unnamed: D28.2 (A), MX25.2 (ROW)
unnamed: D29.2 (A), MX49.2 (ROW)
unnamed: D30.2 (A), MX10.2 (ROW)
unnamed: D31.2 (A), MX26.2 (ROW)
unnamed: D32.2 (A), MX51.2 (ROW)
unnamed: D33.2 (A), MX11.2 (ROW)
unnamed: D34.2 (A), MX27.2 (ROW)
unnamed: D35.2 (A), MX53.2 (ROW)
unnamed: D36.2 (A), MX12.2 (ROW)
unnamed: D37.2 (A), MX28.2 (ROW)
unnamed: D38.2 (A), MX55.2 (ROW)
unnamed: D39.2 (A), MX13.2 (ROW)
unnamed: D40.2 (A), MX29.2 (ROW)
unnamed: D41.2 (A), MX57.2 (ROW)
unnamed: D42.2 (A), MX14.2 (ROW)
unnamed: D43.2 (A), MX30.2 (ROW)
unnamed: D44.2 (A), MX15.2 (ROW)
unnamed: D45.2 (A), MX31.2 (ROW)
unnamed: D46.2 (A), MX16.2 (ROW), MX69.1 (COL)
unnamed: D47.2 (A), MX38.2 (ROW)
unnamed: D48.2 (A), MX67.1 (COL)
unnamed: D49.2 (A), MX40.2 (ROW)
unnamed: D50.2 (A), MX73.1 (COL)
unnamed: D51.2 (A), MX42.2 (ROW)
unnamed: D52.2 (A), MX74.2 (ROW), MX76.1 (COL)
unnamed: D53.2 (A), MX44.2 (ROW)
unnamed: D54.2 (A), MX46.2 (ROW)
unnamed: D55.2 (A), MX81.2 (ROW)
unnamed: D56.2 (A), MX48.2 (ROW)
unnamed: D57.2 (A), MX71.2 (ROW), MX78.1 (COL), MX84.1 (COL)
unnamed: D58.2 (A), MX50.2 (ROW)
unnamed: D59.2 (A), MX52.2 (ROW)
unnamed: D60.2 (A), MX80.2 (ROW)
unnamed: D61.2 (A), MX54.2 (ROW)
unnamed: D62.2 (A), MX56.2 (ROW)
unnamed: D63.2 (A), MX72.1 (COL), MX82.2 (ROW)
unnamed: D64.2 (A), MX58.2 (ROW)
unnamed: D65.2 (A), MX66.1 (COL), MX83.2 (ROW)
unnamed: D66.2 (A), MX59.2 (ROW)
unnamed: D67.2 (A), MX60.2 (ROW), MX68.1 (COL)
unnamed: D68.2 (A), MX77.2 (ROW)
unnamed: D69.2 (A), MX61.2 (ROW)
unnamed: D70.2 (A), MX62.2 (ROW)
unnamed: D71.2 (A), MX79.2 (ROW)
unnamed: D72.2 (A), MX32.2 (ROW)
unnamed: D73.2 (A), MX70.1 (COL)
unnamed: D74.2 (A), MX37.2 (ROW), MX75.1 (COL)
unnamed: R6.2, U2.33 (~HWB~/PE2)
unnamed: RGB1.2 (DOUT), RGB2.4 (DIN)
unnamed: RGB2.2 (DOUT), RGB3.4 (DIN)
unnamed: RGB3.2 (DOUT), RGB4.4 (DIN)
unnamed: U2.16 (XTAL2), Y1.3
unnamed: U2.17 (XTAL1), Y1.1
R0: D1.1 (K), D2.1 (K), D3.1 (K), D4.1 (K), D5.1 (K), D17.1 (K), D21.1 (K), D24.1 (K), D27.1 (K), D30.1 (K), D33.1 (K), D36.1 (K), D39.1 (K), D42.1 (K), D44.1 (K), D46.1 (K), U2.9 (PB1), U4.2 (DIN1)
R1: D6.1 (K), D7.1 (K), D9.1 (K), D11.1 (K), D14.1 (K), D18.1 (K), D22.1 (K), D25.1 (K), D28.1 (K), D31.1 (K), D34.1 (K), D37.1 (K), D40.1 (K), D43.1 (K), D45.1 (K), D72.1 (K), U2.22 (PD5)
R2: D10.1 (K), D12.1 (K), D15.1 (K), D19.1 (K), D20.1 (K), D23.1 (K), D26.1 (K), D29.1 (K), D32.1 (K), D35.1 (K), D38.1 (K), D41.1 (K), D66.1 (K), D69.1 (K), D73.1 (K), D74.1 (K), U2.30 (PB6)
R3: D8.1 (K), D13.1 (K), D47.1 (K), D49.1 (K), D51.1 (K), D53.1 (K), D54.1 (K), D56.1 (K), D58.1 (K), D59.1 (K), D61.1 (K), D62.1 (K), D64.1 (K), D67.1 (K), D70.1 (K), U2.38 (PF5)
R4: D16.1 (K), D48.1 (K), D50.1 (K), D52.1 (K), D55.1 (K), D57.1 (K), D60.1 (K), D63.1 (K), D65.1 (K), D68.1 (K), D71.1 (K), U2.37 (PF6)
RST: R5.2, SW1.2, U2.13 (~RESET), U4.5 (DOUT1)
