MaiTheSan/PCB-Design/KiCad/09-2021/Hardware/Marvelou65-ergo.sch

## KiCad design KiCad/09-2021/Hardware/Marvelou65-ergo.sch (2022-11-19)

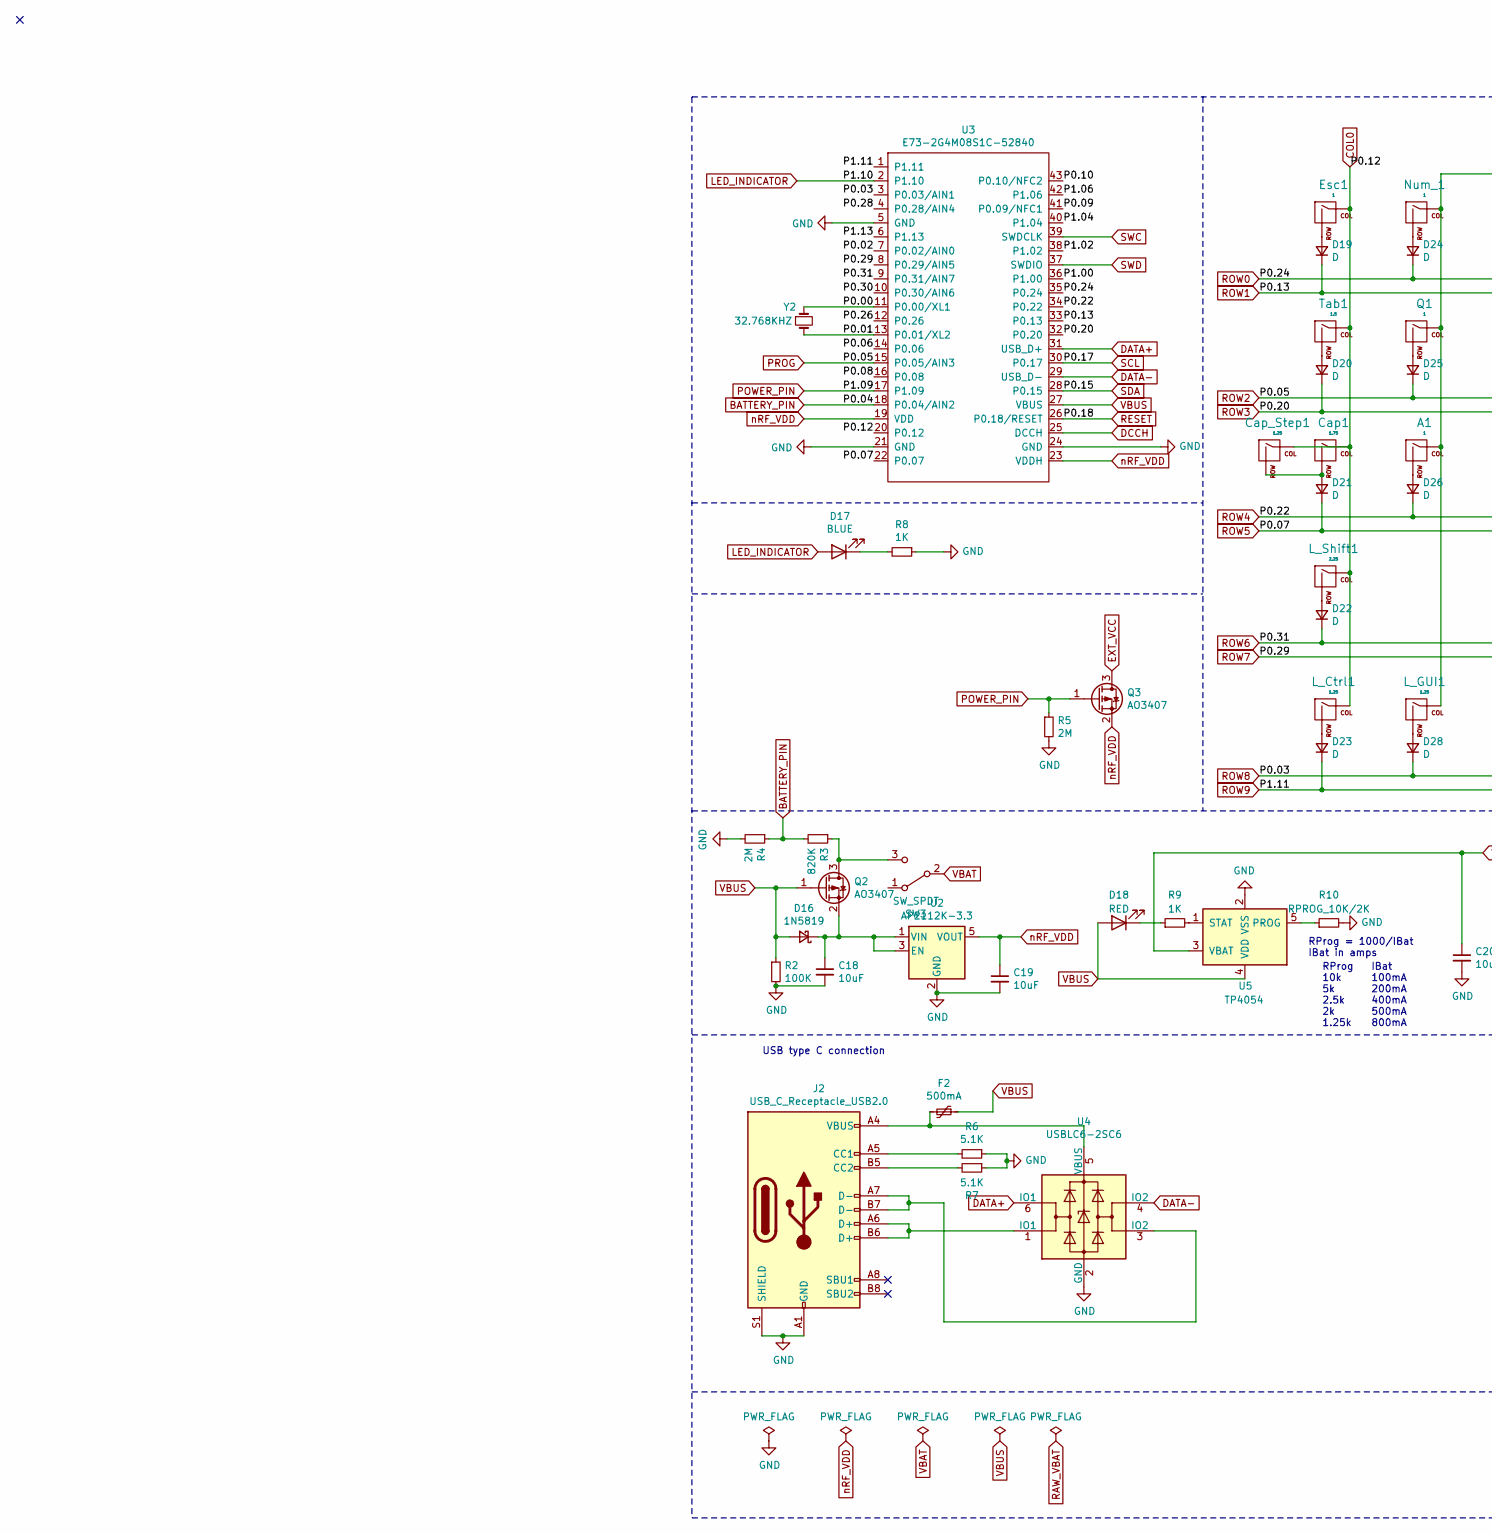
[picture p216: schematic Marvelou65-ergo.sch, part in row 1, column 1]

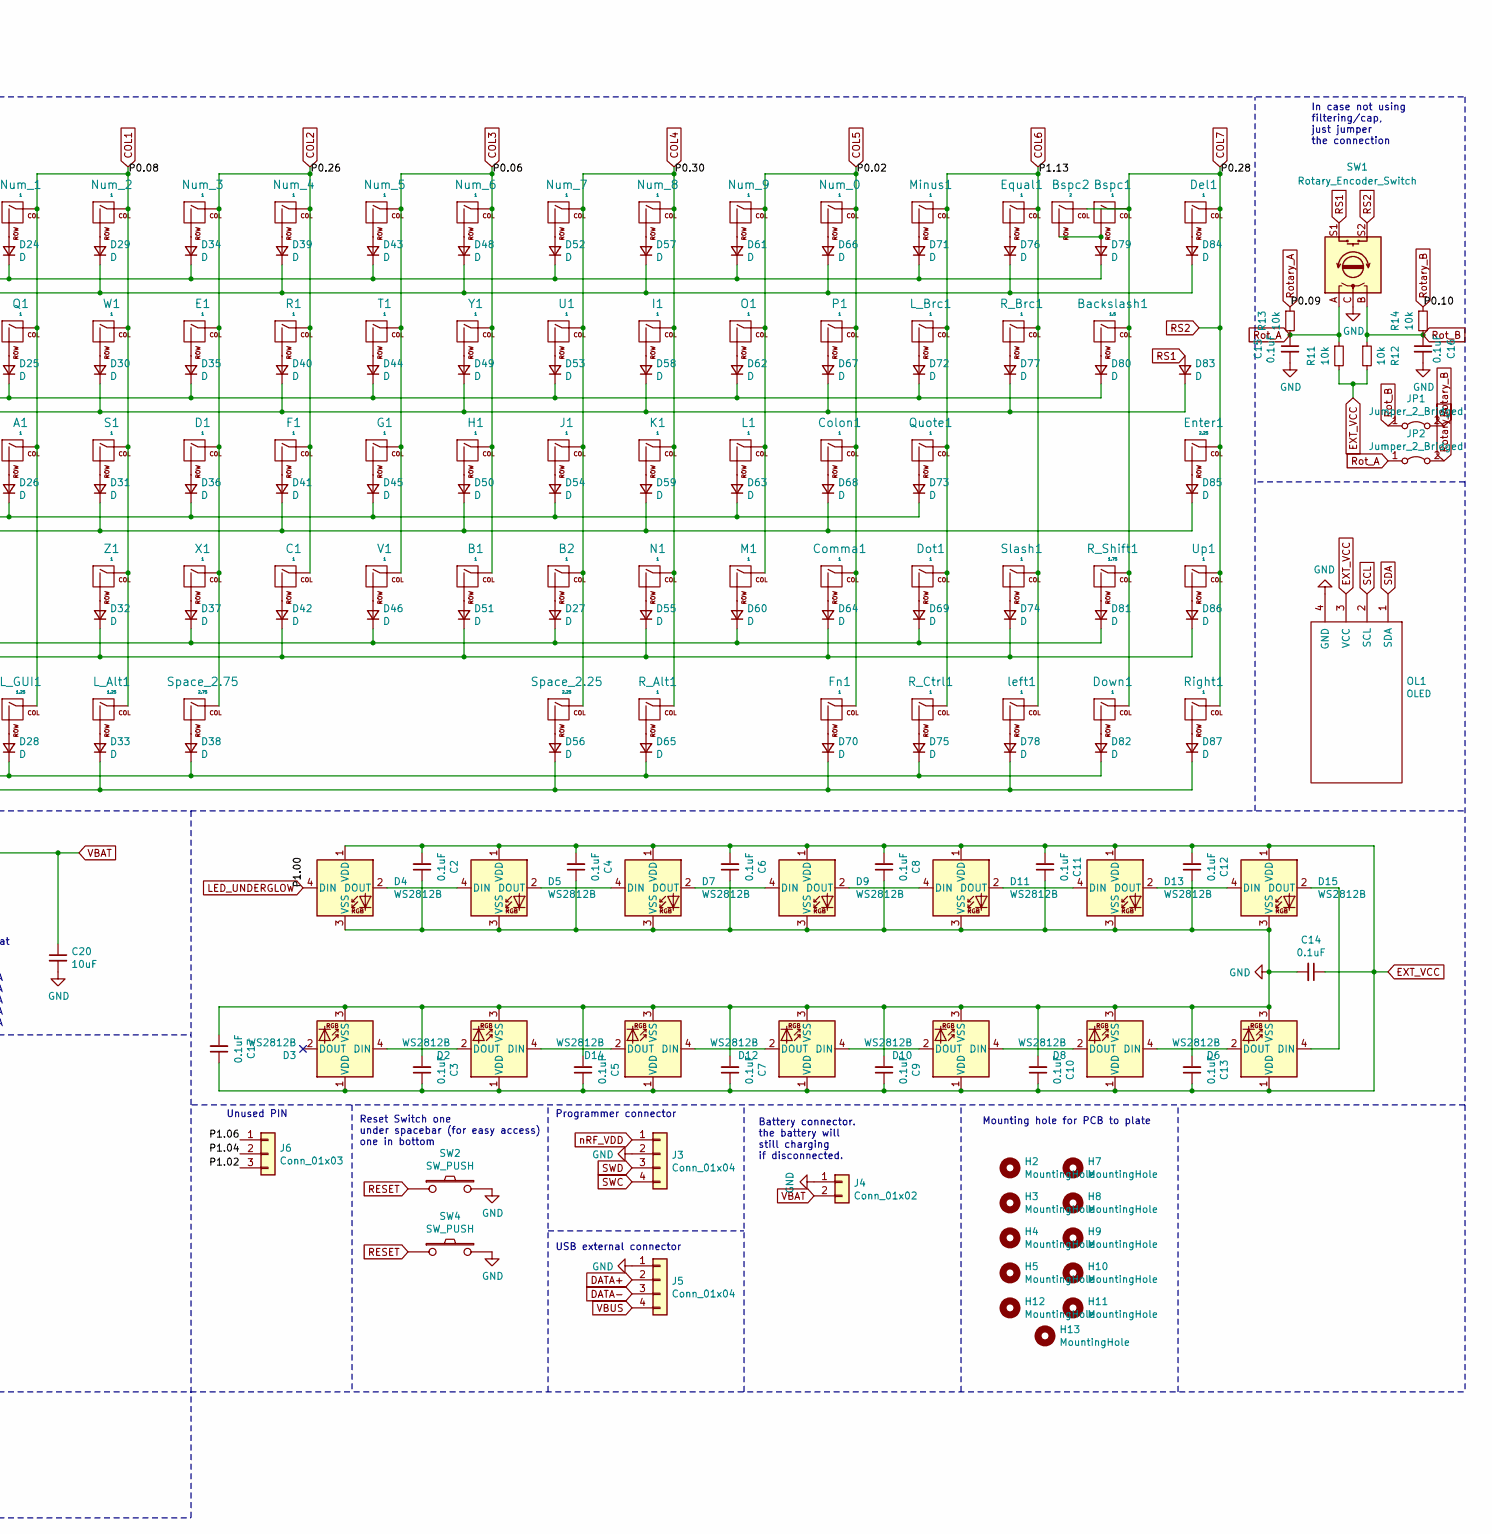
[picture p217: schematic Marvelou65-ergo.sch, part in row 1, column 2]

Parts:
A1: 1; MXOnly-1U-Hotswap
B1, B2: 1; MXOnly-1U-Hotswap
Backslash1: 1.5; MXOnly-1.5U-Hotswap
Bspc1: 1; MXOnly-1U-Hotswap
Bspc2: 2; MXOnly-2U-Hotswap
C1: 1; MXOnly-1U-Hotswap
C2, C3, C4, C5, C6, C7, C8, C9, C10, C11, C12, C13, C14, C15, C16, C17: 0.1uF; C_0805_2012Metric_Pad1.15x1.40mm_HandSolder; LCSC C49678
C18, C19, C20: 10uF; C_0805_2012Metric_Pad1.15x1.40mm_HandSolder; LCSC C15850
Cap1: 1.75; MXOnly-1.75U-Hotswap
Cap_Step1: 1.25; MXOnly-1.25U-Hotswap
Colon1: 1; MXOnly-1U-Hotswap
Comma1: 1; MXOnly-1U-Hotswap
D1: 1; MXOnly-1U-Hotswap
D2, D3, D4, D5, D6, D7, D8, D9, D10, D11, D12, D13, D14, D15: WS2812B; LED_WS2812B_PLCC4_5.0x5.0mm_P3.2mm; LCSC C114586
D16: 1N5819; D_SOD-123; LCSC C169540
D17: BLUE; LED_0603_1608Metric_Pad1.05x0.95mm_HandSolder; LCSC C375446
D18: RED; LED_0603_1608Metric_Pad1.05x0.95mm_HandSolder; LCSC C375450
D19, D20, D21, D22, D23, D24, D25, D26, D27, D28, D29, D30, D31, D32, D33, D34, D35, D36, D37, D38, D39, D40, D41, D42, D43, D44, D45, D46, D48, D49, D50, D51, D52, D53, D54, D55, D56, D57, D58, D59, D60, D61, D62, D63, D64, D65, D66, D67, D68, D69, D70, D71, D72, D73, D74, D75, D76, D77, D78, D79, D80, D81, D82, D83, D84, D85, D86, D87: D; D_SOD-123; LCSC C81598
Del1: 1; MXOnly-1U-Hotswap
Dot1: 1; MXOnly-1U-Hotswap
Down1: 1; MXOnly-1U-Hotswap
E1: 1; MXOnly-1U-Hotswap
Enter1: 2.25; MXOnly-2.25U-Hotswap
Equal1: 1; MXOnly-1U-Hotswap
Esc1: 1; MXOnly-1U-Hotswap
F1: 1; MXOnly-1U-Hotswap
F2: 500mA; Fuse_0805_2012Metric_Pad1.15x1.40mm_HandSolder; LCSC C261942
Fn1: 1; MXOnly-1.25U-Hotswap
G1: 1; MXOnly-1U-Hotswap
H1: 1; MXOnly-1U-Hotswap
H2, H3, H4, H5, H7, H8, H9, H10, H11, H12, H13: MountingHole; MountingHole_2.2mm_M2_Pad
I1: 1; MXOnly-1U-Hotswap
J1: 1; MXOnly-1U-Hotswap
J2: USB_C_Receptacle_USB2.0; USB_C_Receptacle_HRO_TYPE-C-31-M-12; LCSC C165948
J3: Conn_01x04; connector_swd
J4: Conn_01x02; JST_XH_S2B-XH-A-1_1x02_P2.50mm_Horizontal; LCSC C157931
J5: Conn_01x04; connector_usb
J6: Conn_01x03; PinSocket_1x03_P2.54mm_Vertical
JP1, JP2: Jumper_2_Bridged; Jumper
K1: 1; MXOnly-1U-Hotswap
L1: 1; MXOnly-1U-Hotswap
L_Alt1: 1.25; MXOnly-1.25U-Hotswap
L_Brc1: 1; MXOnly-1U-Hotswap
L_Ctrl1: 1.25; MXOnly-1.25U-Hotswap
L_GUI1: 1.25; MXOnly-1.25U-Hotswap
L_Shift1: 2.25; MXOnly-2.25U-Hotswap
M1: 1; MXOnly-1U-Hotswap
Minus1: 1; MXOnly-1U-Hotswap
N1: 1; MXOnly-1U-Hotswap
Num_0, Num_1, Num_2, Num_3, Num_4, Num_5, Num_6, Num_7, Num_8, Num_9: 1; MXOnly-1U-Hotswap
O1: 1; MXOnly-1U-Hotswap
OL1: OLED
P1: 1; MXOnly-1U-Hotswap
Q1: 1; MXOnly-1U-Hotswap
Q2, Q3: AO3407; TSOT-23; LCSC C693136
Quote1: 1; MXOnly-1U-Hotswap
R1: 1; MXOnly-1U-Hotswap
R2: 100K; R_0603_1608Metric_Pad1.05x0.95mm_HandSolder; LCSC C25803
R3: 820K; R_0603_1608Metric_Pad1.05x0.95mm_HandSolder; LCSC C23252
R4, R5: 2M; R_0603_1608Metric_Pad1.05x0.95mm_HandSolder; LCSC C22976
R6, R7: 5.1K; R_0603_1608Metric_Pad1.05x0.95mm_HandSolder; LCSC C23186
R8, R9: 1K; R_0603_1608Metric_Pad1.05x0.95mm_HandSolder; LCSC C21190
R10: RPROG_10K/2K; R_0603_1608Metric_Pad1.05x0.95mm_HandSolder; LCSC C22975
R11, R12, R13, R14: 10k; R_0603_1608Metric_Pad1.05x0.95mm_HandSolder; LCSC C25804
R_Alt1: 1; MXOnly-1.25U-Hotswap
R_Brc1: 1; MXOnly-1U-Hotswap
R_Ctrl1: 1; MXOnly-1.25U-Hotswap
R_Shift1: 1.75; MXOnly-1.75U-Hotswap
Right1: 1; MXOnly-1U-Hotswap
S1: 1; MXOnly-1U-Hotswap
SW1: Rotary_Encoder_Switch; RotaryEncoder_Alps_EC11E-Switch_Vertical_H20mm; LCSC C470748
SW2, SW4: SW_PUSH; SW_SPST_TL3342; LCSC C318884
SW3: SW_SPDT; SW_SPDT_PCM12; LCSC C221841
Slash1: 1; MXOnly-1U-Hotswap
Space_2.25: 2.25; MXOnly-2.25U-Hotswap-ReversedStabilizers
Space_2.75: 2.75; MXOnly-2.75U-Hotswap-ReversedStabilizers
T1: 1; MXOnly-1U-Hotswap
Tab1: 1.5; MXOnly-1.5U-Hotswap
U1: 1; MXOnly-1U-Hotswap
U2: AP2112K-3.3; SOT-23-5; LCSC C51118
U3: E73-2G4M08S1C-52840; LCSC C356849
U4: USBLC6-2SC6; SOT-23-6; LCSC C558442
U5: TP4054; SOT-23-5; LCSC C32574
Up1: 1; MXOnly-1U-Hotswap
V1: 1; MXOnly-1U-Hotswap
W1: 1; MXOnly-1U-Hotswap
X1: 1; MXOnly-1U-Hotswap
Y1: 1; MXOnly-1U-Hotswap
Y2: 32.768KHZ; Crystal_SMD_3215-2Pin_3.2x1.5mm; LCSC C479190
Z1: 1; MXOnly-1U-Hotswap
left1: 1; MXOnly-1U-Hotswap

Connections:
BATTERY_PIN: R3.2, R4.1, U3.18 (P0.04/AIN2)
COL0: Cap1.1 (COL), Cap_Step1.1 (COL), Esc1.1 (COL), L_Ctrl1.1 (COL), L_Shift1.1 (COL), Tab1.1 (COL), U3.20 (P0.12)
COL1: A1.1 (COL), L_Alt1.1 (COL), L_GUI1.1 (COL), Num_1.1 (COL), Num_2.1 (COL), Q1.1 (COL), S1.1 (COL), U3.16 (P0.08), W1.1 (COL), Z1.1 (COL)
COL2: C1.1 (COL), D1.1 (COL), E1.1 (COL), F1.1 (COL), Num_3.1 (COL), Num_4.1 (COL), R1.1 (COL), Space_2.75.1 (COL), U3.12 (P0.26), X1.1 (COL)
COL3: B1.1 (COL), G1.1 (COL), H1.1 (COL), Num_5.1 (COL), Num_6.1 (COL), T1.1 (COL), U3.14 (P0.06), V1.1 (COL), Y1.1 (COL)
COL4: B2.1 (COL), I1.1 (COL), J1.1 (COL), K1.1 (COL), N1.1 (COL), Num_7.1 (COL), Num_8.1 (COL), R_Alt1.1 (COL), Space_2.25.1 (COL), U1.1 (COL), U3.10 (P0.30/AIN6)
COL5: Colon1.1 (COL), Comma1.1 (COL), Fn1.1 (COL), L1.1 (COL), M1.1 (COL), Num_0.1 (COL), Num_9.1 (COL), O1.1 (COL), P1.1 (COL), U3.7 (P0.02/AIN0)
COL6: Dot1.1 (COL), Equal1.1 (COL), L_Brc1.1 (COL), Minus1.1 (COL), Quote1.1 (COL), R_Brc1.1 (COL), R_Ctrl1.1 (COL), Slash1.1 (COL), U3.6 (P1.13), left1.1 (COL)
COL7: Backslash1.1 (COL), Bspc1.1 (COL), Bspc2.1 (COL), Del1.1 (COL), Down1.1 (COL), Enter1.1 (COL), R_Shift1.1 (COL), Right1.1 (COL), SW1.S2, U3.4 (P0.28/AIN4), Up1.1 (COL)
DATA+: J5.2, U3.31 (USB_D+), U4.6 (IO1)
DATA-: J5.3, U3.29 (USB_D-), U4.4 (IO2)
DCCH: U3.25 (DCCH)
EXT_VCC: C2.2, C3.1, C4.2, C5.1, C6.2, C7.1, C8.2, C9.1, C10.1, C11.2, C12.2, C13.1, C14.1, C17.1, D2.1 (VDD), D3.1 (VDD), D4.1 (VDD), D5.1 (VDD), D6.1 (VDD), D7.1 (VDD), D8.1 (VDD), D9.1 (VDD), D10.1 (VDD), D11.1 (VDD), D12.1 (VDD), D13.1 (VDD), D14.1 (VDD), D15.1 (VDD), OL1.3 (VCC), Q3.3 (D), R11.2, R12.2
GND: C2.1, C3.2, C4.1, C5.2, C6.1, C7.2, C8.1, C9.2, C10.2, C11.1, C12.1, C13.2, C14.2, C15.2, C16.2, C17.2, C18.2, C19.2, C20.2, D2.3 (VSS), D3.3 (VSS), D4.3 (VSS), D5.3 (VSS), D6.3 (VSS), D7.3 (VSS), D8.3 (VSS), D9.3 (VSS), D10.3 (VSS), D11.3 (VSS), D12.3 (VSS), D13.3 (VSS), D14.3 (VSS), D15.3 (VSS), J2.A1 (GND), J2.A12 (GND), J2.B1 (GND), J2.B12 (GND), J2.S1 (SHIELD), J3.2, J4.1, J5.1, OL1.4 (GND), R2.2, R4.2, R5.2, R6.1, R7.1, R8.1, R10.2, SW1.C, SW2.2, SW4.2, U2.2 (GND), U3.5 (GND), U3.21 (GND), U3.24 (GND), U4.2 (GND), U5.2 (VSS)
LED_INDICATOR: D17.2 (A), U3.2 (P1.10)
LED_UNDERGLOW: D4.4 (DIN), U3.36 (P1.00)
unnamed: A1.2 (ROW), D26.2 (A)
unnamed: B1.2 (ROW), D51.2 (A)
unnamed: B2.2 (ROW), D27.2 (A)
unnamed: Backslash1.2 (ROW), D80.2 (A)
unnamed: Bspc1.2 (ROW), Bspc2.2 (ROW), D79.2 (A)
unnamed: C1.2 (ROW), D42.2 (A)
unnamed: C18.1, D16.1 (K), Q2.2 (S), U2.1 (VIN), U2.3 (EN)
unnamed: Cap1.2 (ROW), Cap_Step1.2 (ROW), D21.2 (A)
unnamed: Colon1.2 (ROW), D68.2 (A)
unnamed: Comma1.2 (ROW), D64.2 (A)
unnamed: D1.2 (ROW), D36.2 (A)
unnamed: D2.2 (DOUT), D3.4 (DIN)
unnamed: D4.2 (DOUT), D5.4 (DIN)
unnamed: D5.2 (DOUT), D7.4 (DIN)
unnamed: D6.2 (DOUT), D8.4 (DIN)
unnamed: D7.2 (DOUT), D9.4 (DIN)
unnamed: D10.2 (DOUT), D12.4 (DIN)
unnamed: D8.2 (DOUT), D10.4 (DIN)
unnamed: D11.2 (DOUT), D13.4 (DIN)
unnamed: D9.2 (DOUT), D11.4 (DIN)
unnamed: D12.2 (DOUT), D14.4 (DIN)
unnamed: D13.2 (DOUT), D15.4 (DIN)
unnamed: D2.4 (DIN), D14.2 (DOUT)
unnamed: D6.4 (DIN), D15.2 (DOUT)
unnamed: D17.1 (K), R8.2
unnamed: D18.1 (K), R9.1
unnamed: D19.2 (A), Esc1.2 (ROW)
unnamed: D20.2 (A), Tab1.2 (ROW)
unnamed: D22.2 (A), L_Shift1.2 (ROW)
unnamed: D23.2 (A), L_Ctrl1.2 (ROW)
unnamed: D24.2 (A), Num_1.2 (ROW)
unnamed: D25.2 (A), Q1.2 (ROW)
unnamed: D28.2 (A), L_GUI1.2 (ROW)
unnamed: D29.2 (A), Num_2.2 (ROW)
unnamed: D30.2 (A), W1.2 (ROW)
unnamed: D31.2 (A), S1.2 (ROW)
unnamed: D32.2 (A), Z1.2 (ROW)
unnamed: D33.2 (A), L_Alt1.2 (ROW)
unnamed: D34.2 (A), Num_3.2 (ROW)
unnamed: D35.2 (A), E1.2 (ROW)
unnamed: D37.2 (A), X1.2 (ROW)
unnamed: D38.2 (A), Space_2.75.2 (ROW)
unnamed: D39.2 (A), Num_4.2 (ROW)
unnamed: D40.2 (A), R1.2 (ROW)
unnamed: D41.2 (A), F1.2 (ROW)
unnamed: D43.2 (A), Num_5.2 (ROW)
unnamed: D44.2 (A), T1.2 (ROW)
unnamed: D45.2 (A), G1.2 (ROW)
unnamed: D46.2 (A), V1.2 (ROW)
unnamed: D48.2 (A), Num_6.2 (ROW)
unnamed: D49.2 (A), Y1.2 (ROW)
unnamed: D50.2 (A), H1.2 (ROW)
unnamed: D52.2 (A), Num_7.2 (ROW)
unnamed: D53.2 (A), U1.2 (ROW)
unnamed: D54.2 (A), J1.2 (ROW)
unnamed: D55.2 (A), N1.2 (ROW)
unnamed: D56.2 (A), Space_2.25.2 (ROW)
unnamed: D57.2 (A), Num_8.2 (ROW)
unnamed: D58.2 (A), I1.2 (ROW)
unnamed: D59.2 (A), K1.2 (ROW)
unnamed: D60.2 (A), M1.2 (ROW)
unnamed: D61.2 (A), Num_9.2 (ROW)
unnamed: D62.2 (A), O1.2 (ROW)
unnamed: D63.2 (A), L1.2 (ROW)
unnamed: D65.2 (A), R_Alt1.2 (ROW)
unnamed: D66.2 (A), Num_0.2 (ROW)
unnamed: D67.2 (A), P1.2 (ROW)
unnamed: D69.2 (A), Dot1.2 (ROW)
unnamed: D70.2 (A), Fn1.2 (ROW)
unnamed: D71.2 (A), Minus1.2 (ROW)
unnamed: D72.2 (A), L_Brc1.2 (ROW)
unnamed: D73.2 (A), Quote1.2 (ROW)
unnamed: D74.2 (A), Slash1.2 (ROW)
unnamed: D75.2 (A), R_Ctrl1.2 (ROW)
unnamed: D76.2 (A), Equal1.2 (ROW)
unnamed: D77.2 (A), R_Brc1.2 (ROW)
unnamed: D78.2 (A), left1.2 (ROW)
unnamed: D81.2 (A), R_Shift1.2 (ROW)
unnamed: D82.2 (A), Down1.2 (ROW)
unnamed: D84.2 (A), Del1.2 (ROW)
unnamed: D85.2 (A), Enter1.2 (ROW)
unnamed: D86.2 (A), Up1.2 (ROW)
unnamed: D87.2 (A), Right1.2 (ROW)
unnamed: F2.2, J2.A4 (VBUS), J2.A9 (VBUS), J2.B4 (VBUS), J2.B9 (VBUS), U4.5 (VBUS)
unnamed: J2.A5 (CC1), R6.2
unnamed: J2.A6 (D+), J2.B6 (D+), U4.1 (IO1)
unnamed: J2.A7 (D-), J2.B7 (D-), U4.3 (IO2)
unnamed: J2.B5 (CC2), R7.2
unnamed: Q2.3 (D), R3.1, SW3.3 (C)
unnamed: R9.2, U5.1 (STAT)
unnamed: R10.1, U5.5 (PROG)
P0.00: U3.11 (P0.00/XL1), Y2.1
P0.01: U3.13 (P0.01/XL2), Y2.2
P1.02: J6.3, U3.38 (P1.02)
P1.04: J6.2, U3.40 (P1.04)
P1.06: J6.1, U3.42 (P1.06)
POWER_PIN: Q3.1 (G), R5.1, U3.17 (P1.09)
PROG: D25.1 (K), D35.1 (K), D44.1 (K), D53.1 (K), D62.1 (K), D72.1 (K), D80.1 (K), U3.15 (P0.05/AIN3)
RESET: SW2.1, SW4.1, U3.26 (P0.18/RESET)
ROW0: D24.1 (K), D34.1 (K), D43.1 (K), D52.1 (K), D61.1 (K), D71.1 (K), D79.1 (K), U3.35 (P0.24)
ROW1: D19.1 (K), D29.1 (K), D39.1 (K), D48.1 (K), D57.1 (K), D66.1 (K), D76.1 (K), D84.1 (K), U3.33 (P0.13)
ROW3: D20.1 (K), D30.1 (K), D40.1 (K), D49.1 (K), D58.1 (K), D67.1 (K), D77.1 (K), D83.1 (K), U3.32 (P0.20)
ROW4: D26.1 (K), D36.1 (K), D45.1 (K), D54.1 (K), D63.1 (K), D73.1 (K), U3.34 (P0.22)
ROW5: D21.1 (K), D31.1 (K), D41.1 (K), D50.1 (K), D59.1 (K), D68.1 (K), D85.1 (K), U3.22 (P0.07)
ROW6: D22.1 (K), D27.1 (K), D37.1 (K), D46.1 (K), D60.1 (K), D69.1 (K), D81.1 (K), U3.9 (P0.31/AIN7)
ROW7: D32.1 (K), D42.1 (K), D51.1 (K), D55.1 (K), D64.1 (K), D74.1 (K), D86.1 (K), U3.8 (P0.29/AIN5)
ROW8: D28.1 (K), D38.1 (K), D65.1 (K), D75.1 (K), D82.1 (K), U3.3 (P0.03/AIN1)
ROW9: D23.1 (K), D33.1 (K), D56.1 (K), D70.1 (K), D78.1 (K), D87.1 (K), U3.1 (P1.11)
RS1: D83.2 (A), SW1.S1
Rot_A: C15.1, JP2.1 (A), R11.1, R13.2, SW1.A
Rot_B: C16.1, JP1.1 (A), R12.1, R14.2, SW1.B
Rotary_A: JP2.2 (B), R13.1, U3.41 (P0.09/NFC1)
Rotary_B: JP1.2 (B), R14.1, U3.43 (P0.10/NFC2)
SCL: OL1.2 (SCL), U3.30 (P0.17)
SDA: OL1.1 (SDA), U3.28 (P0.15)
SWC: J3.4, U3.39 (SWDCLK)
SWD: J3.3, U3.37 (SWDIO)
VBAT: C20.1, J4.2, SW3.2 (B), U5.3 (VBAT)
VBUS: D16.2 (A), D18.2 (A), F2.1, J5.4, Q2.1 (G), R2.1, U3.27 (VBUS), U5.4 (VDD)
nRF_VDD: C19.1, J3.1, Q3.2 (S), U2.5 (VOUT), U3.19 (VDD), U3.23 (VDDH)

Notes on the sheet:
RProg = 1000/IBat IBat in amps
RProg 10k 5k 2.5k 2k 1.25k
IBat 100mA 200mA 400mA 500mA 800mA
Mounting hole for PCB to plate
Battery connector. the battery will still charging if disconnected.
Programmer connector
USB external connector
Reset Switch one under spacebar (for easy access) one in bottom
Unused PIN
USB type C connection
In case not using filtering/cap, just jumper the connection
