MaiTheSan/PCB-Design/KiCad/Early 2021/EV65 final/EV65.sch

## KiCad design KiCad/Early 2021/EV65 final/EV65.sch (2022-11-19)

Schematic: EV65.sch

Parts:
C1: 10uF; C_0603
C2, C3: 22pF; C_0603
C4, C5, C7: 0.1uF; C_0603
C6: 1uF; C_0603
D1, D2, D3, D4, D5, D6, D7, D8, D9, D10, D11, D12, D13, D14, D15, D16, D17, D18, D19, D20, D21, D22, D23, D24, D25, D26, D27, D28, D29, D30, D31, D32, D33, D34, D35, D36, D37, D38, D39, D40, D41, D42, D43, D44, D45, D46, D47, D48, D49, D50, D51, D52, D53, D54, D55, D56, D57, D58, D59, D60, D61, D62, D63, D64, D65, D66, D67, D68: D; D_SOD-123
D69, D70: LED; LED_D3.0mm
F1: 500mA; Fuse_SMD1206_Reflow
LOGO1: LOGO; sanpjxlogo-PCB-type
MX_1, MX_6, MX_19, MX_55, MX_69: MX-1.5U-NoLED; MXOnly-1.5U-NoLED
MX_2, MX_66: MX-1.75U-NoLED; MXOnly-1.75U-NoLED
MX_3, MX_5, MX_7, MX_12, MX_18, MX_56, MX_61, MX_62: MX-1.25U-NoLED; MXOnly-1.25U-NoLED
MX_4, MX_70: MX-2.25U-NoLED; MXOnly-2.25U-NoLED
MX_8, MX_9, MX_10, MX_11, MX_13, MX_14, MX_15, MX_16, MX_17, MX_20, MX_21, MX_22, MX_23, MX_24, MX_25, MX_26, MX_27, MX_28, MX_29, MX_30, MX_31, MX_32, MX_33, MX_34, MX_35, MX_39, MX_40, MX_41, MX_42, MX_43, MX_44, MX_45, MX_46, MX_47, MX_48, MX_49, MX_50, MX_51, MX_52, MX_53, MX_54, MX_57, MX_58, MX_59, MX_60, MX_63, MX_64, MX_65, MX_67, MX_71, MX_72, MX_73, MX_74, MX_75, MX_76, MX_77: MX-NoLED; MXOnly-1U-NoLED
MX_36, MX_37: MX-6.25U-NoLED-rStab; MXOnly-6.25U-ReversedStabilizers-NoLED
MX_38: MX-7U-NoLED-rStab; MXOnly-7U-ReversedStabilizers-NoLED
MX_68: MX-2U-NoLED; MXOnly-2U-NoLED
MX_ESC1: MX-NoLED; MXOnly-1U-NoLED
R1, R2: 5.1k; R_0805
R3, R4: 22; R_0805
R5: 10k; R_0805
R6: 500; R_0805
R7: 1k; R_0805
R8: 300; R_0805
RGB1, RGB2, RGB3, RGB4, RGB5, RGB6, RGB7, RGB8, RGB9, RGB10, RGB11, RGB12, RGB13, RGB14, RGB15, RGB31, RGB32, RGB33, RGB34, RGB35, RGB36, RGB37, RGB38, RGB39, RGB40, RGB41, RGB42, RGB43, RGB44, RGB60, RGB61, RGB62, RGB63, RGB64, RGB65, RGB66, RGB67, RGB68, RGB69: WS2812B; RGB-6028_FLIPPED
RGB16, RGB17, RGB18, RGB19, RGB20, RGB21, RGB22, RGB23, RGB24, RGB25, RGB26, RGB27, RGB28, RGB29, RGB30, RGB45, RGB46, RGB47, RGB48, RGB49, RGB50, RGB51, RGB52, RGB53, RGB54, RGB55, RGB56, RGB57, RGB58, RGB59: WS2812B; RGB-6028
SW1: 5.2x5.2mm; SKQG-1155865
U1: PRTR5V0U2X; SOT143B
U2, U4: STF202-22T1G; Reset_Pretty
U3: ATmega32U4-MU; QFN-44-1EP_7x7mm_P0.5mm_EP5.2x5.2mm
USB1: HRO-TYPE-C-31-M-12; HRO-TYPE-C-31-M-12-Assembly
Y1: 16Mhz; Crystal_SMD_3225-4Pin_3.2x2.5mm
