MaiTheSan/PCB-Design/KiCad/Early 2021/Osu!Key/Osu!Key.sch

## KiCad design KiCad/Early 2021/Osu!Key/Osu!Key.sch (2022-11-19)

Schematic: Osu!Key.sch

Parts:
C1: 10uF 0603; C_0603
C2, C5, C6: 0.1uF 0603; C_0603
C3, C4: 22pF; C_0603
C7: 1uF 0603; C_0603
D1, D2: D; D_SOD-123-Pretty
D3, D4, D5, D6: WS2812B; LED_WS2812B_PLCC4_5.0x5.0mm_P3.2mm
LED1, LED2: RGBLED; RGB-6028
MX1, MX2: MX-1U-MX_Alps_Hybrids; MXOnly-1U-Hotswap
R1: 500; R_0805
R2, R3, R4: 220; R_0805
R5: 10k 0805; R_0805
R6: 1k 0805; R_0805
SW1: SW_Push; SKQGADE010
U2: STF202-22T1G; Reset_Pretty
U3: ATmega32U4-MU; QFN-44-1EP_7x7mm_P0.5mm_EP5.2x5.2mm
Y1: Crystal_GND24; Crystal_SMD_3225-4Pin_3.2x2.5mm
