MaiTheSan/PCB-Design/KiCad/Early 2021/Osu!Key/Promicro.sch

## KiCad design KiCad/Early 2021/Osu!Key/Promicro.sch (2022-11-19)

Schematic: Promicro.sch

Parts:
C2: 10uF; C_0603
C3, C4, C5: 0.1uF; C_0603
C6: 1uF; C_0603
C7, C8: 22pF; C_0603
F1: 500mA; Fuse_SMD1206_Reflow
Q1: 2N7002; SOT-23
R67, R68: 22; R_0805
R69, R71: 1k; R_0805
R70: 10k; R_0805
R73, R74: 5.1k; R_0805
SW1: 5.2x5.2mm; SKQG-1155865
U1: ATmega32U4-MU; QFN-44-1EP_7x7mm_Pitch0.5mm
U2: PRTR5V0U2X; SOT143B
U3: STF202-22T1G; Reset_Pretty
USB1: HRO-TYPE-C-31-M-12; HRO-TYPE-C-31-M-12-Assembly
Y1: 16Mhz; Crystal_SMD_3225-4Pin_3.2x2.5mm
