MaiTheSan/PCB-Design/KiCad/Early 2021/SawnsPad/MachOnDinhIFS.sch

## KiCad design KiCad/Early 2021/SawnsPad/MachOnDinhIFS.sch (2022-11-19)

Schematic: MachOnDinhIFS.sch

Parts:
C7: 22u; C_0805; Voltage 10V
C8, C9, C10: 0.1u; C_0603
C11, C12, C13: 0.47u; C_0603
