MaiTheSan/PCB-Design/KiCad/Early 2021/SawnsPad/SawnsPad.sch

## KiCad design KiCad/Early 2021/SawnsPad/SawnsPad.sch (2022-11-19)

Schematic: SawnsPad.sch

Parts:
C9: 10uF; SMD-0402
C10, C11: 22pF; SMD-0402
C12, C13, C15: 0.1uF; SMD-0402
C14: 1uF; SMD-0402
D1, D2, D3, D4, D5, D6, D7, D8, D9, D10, D11, D12, D13, D14, D15, D16, D17, D18, D19, D20, D21: D; D_SOD-123
D22, D23, D24, D25, D26, D27: WS2812B; LED_WS2812B_PLCC4_5.0x5.0mm_P3.2mm
MX1, MX3, MX5, MX7, MX9, MX11, MX13, MX15, MX16, MX18: MX-NoLED; MXOnly-1U-FLIPPED
MX2, MX4, MX6, MX8, MX10, MX14, MX17, MX20: MX-NoLED; MXOnly-1U
MX12: MX-NoLED; MXOnly-2U
MX19, MX21: MX-NoLED; MXOnly-2U-FLIPPED
Q1: 2N7002; SOT-23
R1, R4, R5, R6, R10, R11, R12, R13, R14, R15, R16, R17, R18, R19, R20, R21, R22, R23, R24, R25, R26, R27, R28: 1k; R_0805
R2, R3: 5.1k; R_0805
R7, R8: 22; R_0805
R9: 10k; R_0805
S1: SW; SKQG-1155865
U1, U3: STF202-22T1G; Reset_Pretty
U2: PRTR5V0U2X; SOT143B
U4: ATmega32U4-MU; QFN-44-1EP_7x7mm_P0.5mm_EP5.2x5.2mm
USB1: HRO-TYPE-C-31-M-12; HRO-TYPE-C-31-M-12-Assembly
Y1: 16Mhz; Crystal_SMD_3225-4Pin_3.2x2.5mm
