MaiTheSan/PCB-Design/KiCad/Myprojects/64thisthat/64thisthat.sch

## KiCad design KiCad/Myprojects/64thisthat/64thisthat.sch (2022-11-19)

Schematic: 64thisthat.sch

Parts:
C1: 1uF; C_0603
C2: 10uF; C_0603
C3, C4, C5: 0.1uF; C_0603
J1: Daughterboard; JST-SR-4
R1, R4: 10k; R_0603
R2, R3: 22R; R_0603
SW1: SW_Push; SKQG-1155865-fix
U1: ATmega32U4-MU; QFN-44-1EP_7x7mm_P0.5mm_EP5.15x5.15mm_ThermalVias
Y1: 16MHz; Resonator_SMD_muRata_CSTxExxV-3Pin_3.0x1.1mm
