MaiTheSan/PCB-Design/KiCad/Myprojects/64thisthat/Matrix.sch

## KiCad design KiCad/Myprojects/64thisthat/Matrix.sch (2022-11-19)

Schematic: Matrix.sch

Parts:
D1, D2, D3, D4, D5, D6, D7, D8, D9, D10, D11, D12, D13, D14, D15, D16, D17, D18, D19, D20, D21, D22, D23, D24, D25, D26, D27, D28, D29, D30, D31, D32, D33, D34, D35, D36, D37, D38, D39, D40, D42, D43, D44, D45, D46, D47, D48, D49, D50, D51, D52, D53, D54, D55, D56, D60, D61, D62, D63, D64, D65, D66, D67, D68: 1N4148W; DIODE_1206_SawnsProjects
MX1, MX2, MX3, MX4, MX5, MX6, MX7, MX8, MX9, MX10, MX11, MX12, MX13, MX14, MX16, MX17, MX18, MX19, MX20, MX21, MX22, MX23, MX24, MX25, MX26, MX27, MX28, MX30, MX31, MX32, MX33, MX34, MX35, MX36, MX37, MX38, MX39, MX40, MX44, MX45, MX46, MX47, MX48, MX49, MX50, MX51, MX52, MX53, MX54, MX55, MX60, MX61, MX66, MX67, MX68: 1U; MXOnly-1U-Hotswap-Sawns
MX15: 1.5U; MXOnly-1.5U-Hotswap-Sawns
MX29, MX42: 1.75U; MXOnly-1.75U-Hotswap-Sawns
MX41, MX43, MX56, MX57, MX64: 1.25U; MXOnly-1.25U-Hotswap-Sawns
MX63: 2.25U; MXOnly-2.25U-Hotswap-Sawns
MX65: 2.75U; MXOnly-2.75U-Hotswap-Sawns
