MaiTheSan/PCB-Design/KiCad/Myprojects/Naked48 Curved/Naked48.sch

## KiCad design KiCad/Myprojects/Naked48 Curved/Naked48.sch (2022-11-19)

Schematic: Naked48.sch

Parts:
J1: SPI connection; PJ-3200B-4A-Assembly
SW1: SW_Push; PushButton_6x6mm_TH_Pretty
U1: ProMicro; ProMicro-NoSilk
