MaiTheSan/PCB-Design/KiCad/Myprojects/Naked48 Curved/rgb.sch

## KiCad design KiCad/Myprojects/Naked48 Curved/rgb.sch (2022-11-19)

Schematic: rgb.sch

Parts:
RGB1, RGB2, RGB3, RGB4, RGB5, RGB6, RGB7, RGB8, RGB9, RGB10, RGB11, RGB12, RGB13, RGB14, RGB15, RGB16, RGB17, RGB18, RGB19, RGB20, RGB21, RGB22, RGB23, RGB24, RGB25, RGB26, RGB27, RGB28, RGB29, RGB30, RGB31, RGB32, RGB33, RGB34, RGB35, RGB36, RGB37, RGB38, RGB39, RGB40, RGB41, RGB42, RGB43, RGB44, RGB45, RGB46, RGB47, RGB48: SK6812miniE; RGB-6028
