MaiTheSan/PCB-Design/KiCad/Myprojects/Onsen48/Onsen48.sch

## KiCad design KiCad/Myprojects/Onsen48/Onsen48.sch (2022-11-19)

Schematic: Onsen48.sch

Parts:
C1: 10uF; C_0603
C4, C5, C7: 0.1uF; C_0603
C6: 1uF; C_0603
D2, D3, D4, D5, D7, D8, D9, D10, D12, D13, D14, D15, D17, D18, D19, D20, D22, D23, D24, D25, D27, D28, D29, D30, D32, D33, D34, D35, D37, D38, D39, D40, D42, D43, D44, D45, D47, D48, D49, D50, D52, D53, D54, D55, D57, D58, D59, D60: SOD-123; D_SOD-123
F1: Fuse; Fuse_SMD1206_Reflow
J1: AudioJack3; PJ-3200B-4A-Assembly
MX2, MX3, MX4, MX5, MX7, MX8, MX9, MX10, MX12, MX13, MX14, MX15, MX17, MX18, MX19, MX20, MX22, MX23, MX24, MX25, MX27, MX28, MX29, MX30, MX32, MX33, MX34, MX35, MX37, MX38, MX39, MX40, MX42, MX43, MX44, MX45, MX47, MX48, MX49, MX50, MX52, MX53, MX54, MX55, MX57, MX58, MX59, MX60: 1U low; Kailh_socket_PG1350
R1, R2: 5.1k; R_0805
R3, R4: 22; R_0805
R5: 10k; R_0805
R6: 1k; R_0805
R7: 330R; R_0805
RGB1, RGB2, RGB3, RGB4, RGB5, RGB6, RGB14, RGB16, RGB18, RGB20, RGB22, RGB24, RGB25, RGB26, RGB27, RGB28, RGB29, RGB30, RGB37, RGB38, RGB39, RGB40, RGB41, RGB42: WS2812B; RGB-6028
RGB7, RGB8, RGB9, RGB10, RGB11, RGB12, RGB13, RGB15, RGB17, RGB19, RGB21, RGB23, RGB31, RGB32, RGB33, RGB34, RGB35, RGB36, RGB43, RGB44, RGB45, RGB46, RGB47, RGB48: WS2812B; RGB-6028_FLIPPED
SW1: SW_Push; SKQG-1155865
U1: PRTR5V0U2X; SOT143B
U2: ATmega32U4-MU; QFN-44-1EP_7x7mm_P0.5mm_EP5.15x5.15mm
USB1: HRO-TYPE-C-31-M-12; HRO-TYPE-C-31-M-12-Assembly
Y1: 16mhz; Resonator_SMD_muRata_CSTxExxV-3Pin_3.0x1.1mm
