MaiTheSan/PCB-Design/KiCad/Source/Resource temp/STM32F072.sch

## KiCad design KiCad/Source/Resource temp/STM32F072.sch (2022-11-19)

Schematic: STM32F072.sch

Parts:
C21, C23, C25, C27: 0.1uF; C_0603
C22, C24, C26: 1uF; C_0603
C28: 4.7uF; C_0603
C29: 10nF; C_0603
J1: Conn_01x04_Female; PinHeader_1x04_P2.54mm_Vertical
U2: STM32F072C8Tx; LQFP-48_7x7mm_P0.5mm
