MaiTheSan/PCB-Design/KiCad/Source/Resource temp/STM32F303.sch

## KiCad design KiCad/Source/Resource temp/STM32F303.sch (2022-11-19)

Schematic: STM32F303.sch

Parts:
C1, C2: 22pF; C_0603
C4: 10uF; C_0603
C5, C6, C7, C9: 0.1uF; C_0402_1005Metric
C8: 10nF; C_0402_1005Metric
C10: 1uF; C_0603
R105: 390; C_0603
U1: STM32F303CCTx; LQFP-48_7x7mm_P0.5mm
Y1: 16Mhz; Crystal_SMD_3225-4Pin_3.2x2.5mm
