MaiTheSan/PCB-Design/KiCad/Source/discipline-master/discipline-pcb.sch

## KiCad design KiCad/Source/discipline-master/discipline-pcb.sch (2022-11-19)

Schematic: discipline-pcb.sch

Parts:
BOOT1: BOOT; SW_PUSH_6mm
C1, C2: 22p; C_Disc_D3.0mm_W1.6mm_P2.50mm
C3: 4.7u; CP_Radial_D4.0mm_P1.50mm
C4, C5: 0.1u; C_Disc_D4.3mm_W1.9mm_P5.00mm
D1, D2, D3, D4, D5, D6, D7, D8, D9, D10, D11, D12, D13, D14, D15, D16, D17, D18, D19, D20, D21, D22, D23, D24, D25, D26, D27, D28, D29, D30, D31, D32, D33, D34, D35, D36, D37, D38, D39, D40, D41, D42, D43, D44, D45, D46, D47, D48, D49, D50, D51, D52, D53, D54, D55, D56, D57, D58, D59, D60, D61, D62, D63, D64, D65, D66, D67, D68, D71: D_DO-35_SOD27_P5.08mm_Horizontal
D69, D70: 3.6V; D_DO-35_SOD27_P5.08mm_Horizontal
F1: 500mA; polyfuse_5.1mm
J1: AVR-ISP-6; AVR_ICSP_3x2
LED1: POWER; LED_D3.0mm
R1, R2: 5.1k; R_Axial_DIN0204_L3.6mm_D1.6mm_P5.08mm_Horizontal
R3, R4: 75R; R_Axial_DIN0204_L3.6mm_D1.6mm_P5.08mm_Horizontal
R5: 1.5k; R_Axial_DIN0204_L3.6mm_D1.6mm_P5.08mm_Horizontal
R6: 1.5K; R_Axial_DIN0204_L3.6mm_D1.6mm_P5.08mm_Horizontal
R7: 10k; R_Axial_DIN0204_L3.6mm_D1.6mm_P5.08mm_Horizontal
RESET1: RESET; SW_PUSH_6mm
SW1, SW2, SW3, SW4, SW5, SW6, SW7, SW8, SW9, SW10, SW11, SW12, SW13, SW15, SW17, SW18, SW19, SW20, SW21, SW22, SW23, SW24, SW25, SW26, SW27, SW28, SW30, SW32, SW33, SW34, SW35, SW36, SW37, SW38, SW39, SW40, SW41, SW42, SW44, SW46, SW47, SW48, SW49, SW50, SW51, SW52, SW53, SW54, SW55, SW57, SW58, SW62, SW65, SW66, SW67, SW68, SW72, SW75, SW77: KEYSW; SW_Cherry_MX1A_1.00u_PCB-NOSCREEN
SW14: KEYSW; SW_Cherry_MX1A_2.00u_PCBNOSCREEN
SW16, SW29, SW70, SW71, SW73, SW74: KEYSW; SW_Cherry_MX1A_1.50u_PCBNOSCREEN
SW31, SW56: KEYSW; SW_Cherry_MX1A_1.75u_PCBNOSCREEN
SW43, SW45: KEYSW; SW_Cherry_MX1A_2.25u_PCBNOSCREEN
SW59, SW60, SW61, SW63, SW64, SW69, SW78: KEYSW; SW_Cherry_MX1A_1.25u_PCBNOSCREEN
SW76: KEYSW; SW_Cherry_MX1A_ISOEnter_PCB_ReversedStabilizer
U1: ATmega32A-PU; DIP-40_W15.24mm
USB1: USB_C_GCT_USB4085
Y1: Crystal; Crystal_HC49-4H_Vertical

Notes on the sheet:
DISCIPLINE // 65% keyboard with only through hole components
1/1/2020
DISCIPLINE
1.1
MCU
USB
ISP
POWER
RESET
POWER LED
