MaiTheSan/PCB-Design/KiCad/our projects/Quai Thai 12 Lo Dyt (60%)/65%_BLE.sch

## KiCad design KiCad/our projects/Quai Thai 12 Lo Dyt (60%)/65%_BLE.sch (2022-11-19)

Schematic: 65%_BLE.sch

Parts:
C_1: 10uF; C_0805_2012Metric
C_2, C_3, C_4, C_5, C_6, C_3233: 0.1uF; C_0805_2012Metric
C_3233_1, C_3233_2, C_3233_3: 0.47uF; C_0805_2012Metric
C_ASM1, C_ASM1117: 10uF / 10V; CP_EIA-3528-12_Kemet-T_Pad1.50x2.35mm_HandSolder
C_CAPACITORPOLARISED1: 22uF / 10V; CP_EIA-3528-12_Kemet-T_Pad1.50x2.35mm_HandSolder
C_RGB10, C_RGB11, C_RGB12, C_RGB13, C_RGB14, C_RGB15, C_RGB16, C_RGB17, C_RGB18, C_RGB19, C_RGB20, C_RGB21, C_RGB22, C_RGB23, C_RGB24: 0.1uF; C_0805_2012Metric
C_UCAP1: 1uF; C_0805_2012Metric
C_VIO2: 0.47uF; C_0805_2012Metric
D1, D2, D3, D4, D5, D6, D7, D8, D9, D10, D11, D12, D13, D14, D15, D17, D18, D19, D20, D21, D22, D23, D24, D25, D26, D27, D28, D29, D30, D31, D32, D33, D34, D35, D36, D37, D38, D39, D40, D41, D42, D43, D44, D45, D46, D47, D48, D49, D50, D51, D52, D53, D54, D55, D56, D57, D58, D59, D60, D63, D64: 1N4148; D_SOD-323
D16, D61: LED; LED_PLCC_2835
D62: LED_Dual_2pin; LED_D3.0mm
FL3733: IS31FL3733-QF; QFN-48-1EP_6x6mm_P0.4mm_EP4.2x4.2mm
Fuse1: Polyfuse_Small; Fuse_1812_4532Metric_Castellated
RGB1, RGB10, RGB11, RGB12, RGB13, RGB14, RGB15, RGB16, RGB17, RGB18, RGB19, RGB20, RGB21, RGB22, RGB23, RGB24: WS2812B; LED_WS2812B_PLCC4_5.0x5.0mm_P3.2mm
R_CAPLOCKS1: 150; R_0805_2012Metric
R_CC1, R_CC2: 5.6k; R_0805_2012Metric
R_D+1: 22; R_0805_2012Metric
R_D-1: 22; R_0805_2012Metric
R_HWB1: 10k; R_0805_2012Metric
R_IICRST1: 100K; R_0805_2012Metric
R_RSET1: 20K; R_0805_2012Metric
R_RST1: 10k; R_0805_2012Metric
R_SCL2: 1K; R_0805_2012Metric
R_SDA1: 1K; R_0805_2012Metric
R_rgb1: 150; R_0805_2012Metric
SW1, SW6, SW7, SW8, SW9, SW11, SW12, SW13, SW14, SW17, SW18, SW19, SW20, SW21, SW22, SW23, SW24, SW25, SW26, SW27, SW28, SW29, SW30, SW31, SW32, SW34, SW35, SW36, SW37, SW38, SW39, SW40, SW41, SW43, SW44, SW45, SW46, SW48, SW49, SW50, SW51, SW53, SW54, SW55, SW58, SW59: SW_Push; CherryMX_1.00u_PCB_KailhSocket_LTST-A683CEGBW-HS
SW2, SW64: SW_Push; CherryMX_1.50u_PCB_KailhSocket_LTST-A683CEGBW-HS
SW3: SW_Push; CherryMX_1.75u_PCB_KailhSocket_LTST-A683CEGBW-HS
SW4, SW60: SW_Push; CherryMX_2.25u_PCB_KailhSocket_StabWireTop_LTST-A683CEGBW-HS
SW5, SW10, SW15, SW42, SW47, SW52, SW57: SW_Push; CherryMX_1.25u_PCB_KailhSocket_LTST-A683CEGBW-HS
SW33: SW_Push; CherryMX_6.25u_PCB_KailhSocket_StabWireBottom_LTST-A683CEGB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
SW56: SW_Push; CherryMX_2.75u_PCB_KailhSocket_StabWireTop_LTST-A683CEGBW-HS
SW63: SW_Push; CherryMX_2.00u_PCB_KailhSocket_StabWireTop_LTST-A683CEGBW-HS
TYPE_C1: USB_C; USB_C_Receptacle_Palconn_UTC16-G
U1: ATmega32U4-AU; TQFP-44_10x10mm_P0.8mm
U2: AMS1117; SOT-223-3_TabPin2
Xtal_1, Xtal_2: 22pf; C_0805_2012Metric
crystal1: 16mhz; Crystal_SMD_3225-4Pin_3.2x2.5mm
