MaiTheSan/PCB-Design/Salane Reboot/Fly Daughterboard/Fly Daughterboard/Fly Daughterboard.kicad_sch

## KiCad design Salane Reboot/Fly Daughterboard/Fly Daughterboard/Fly Daughterboard.kicad_sch (2022-11-19)

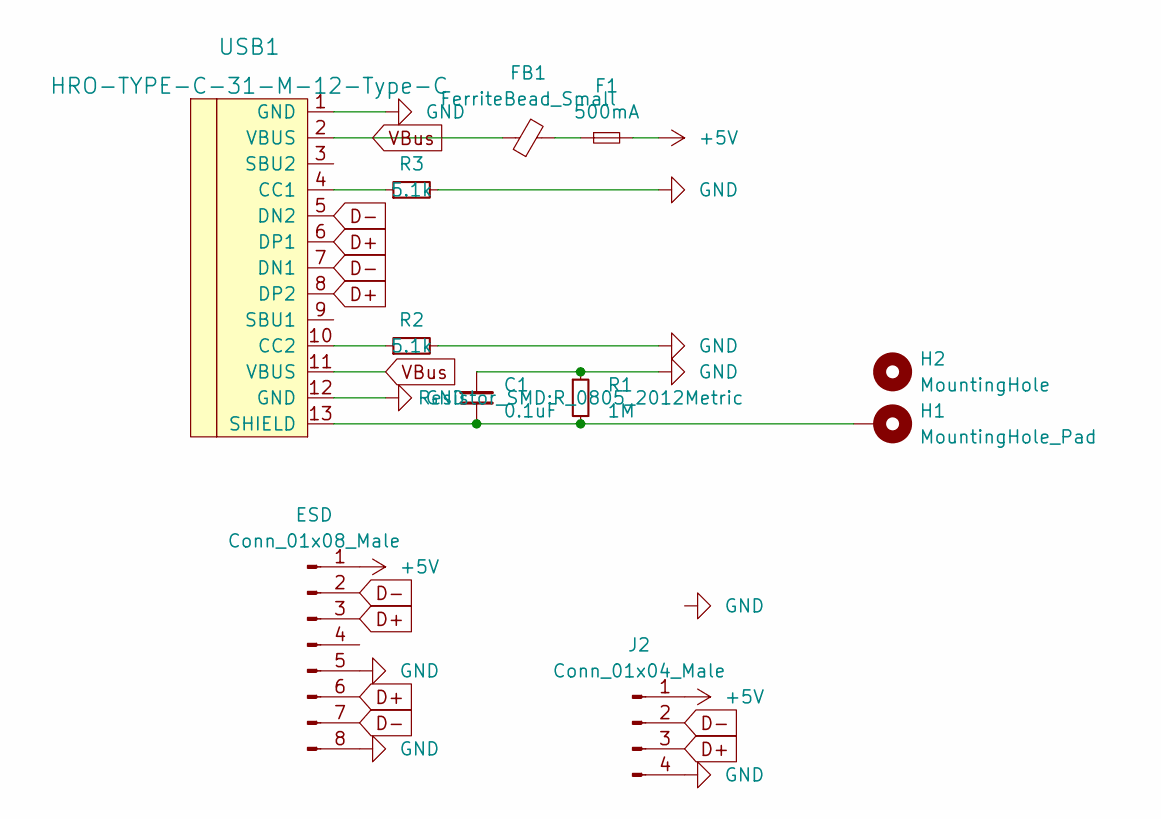
[picture p218: schematic Fly Daughterboard.kicad_sch]

Parts:
C1: 0.1uF; C_0805_2012Metric
ESD: Conn_01x08_Male; uQFN8
F1: 500mA; Fuse_0603_1608Metric
FB1: FerriteBead_Small; Fuse_0603_1608Metric
H1: MountingHole_Pad; MountingHole_2.2mm_M2_ISO7380_Pad
H2: MountingHole; MountingHole_2.2mm_M2_ISO7380_Pad
J2: Conn_01x04_Male; JST-SR-4-mini
R1: 1M; R_0805_2012Metric
R2, R3: 5.1k; R_0402_1005Metric
USB1: HRO-TYPE-C-31-M-12-Type-C; HRO-TYPE-C-31-M-12-Assembly

Connections:
+5V: ESD.1, F1.2, J2.1
D+: ESD.3, ESD.6, J2.3, USB1.6 (DP1), USB1.8 (DP2)
D-: ESD.2, ESD.7, J2.2, USB1.5 (DN2), USB1.7 (DN1)
GND: C1.2, ESD.5, ESD.8, J2.4, R1.1, R2.2, R3.2, USB1.1 (GND), USB1.12 (GND)
unnamed: C1.1, H1.1, R1.2, USB1.13 (SHIELD)
unnamed: F1.1, FB1.2
unnamed: R2.1, USB1.10 (CC2)
unnamed: R3.1, USB1.4 (CC1)
VBus: FB1.1, USB1.2 (VBUS), USB1.11 (VBUS)
