MaiTheSan/PCB-Design/KiCad/06-2021 comm/Leopold Replacement/OG BLE/Leopold Replacement.sch

## KiCad design KiCad/06-2021 comm/Leopold Replacement/OG BLE/Leopold Replacement.sch (2022-11-19)

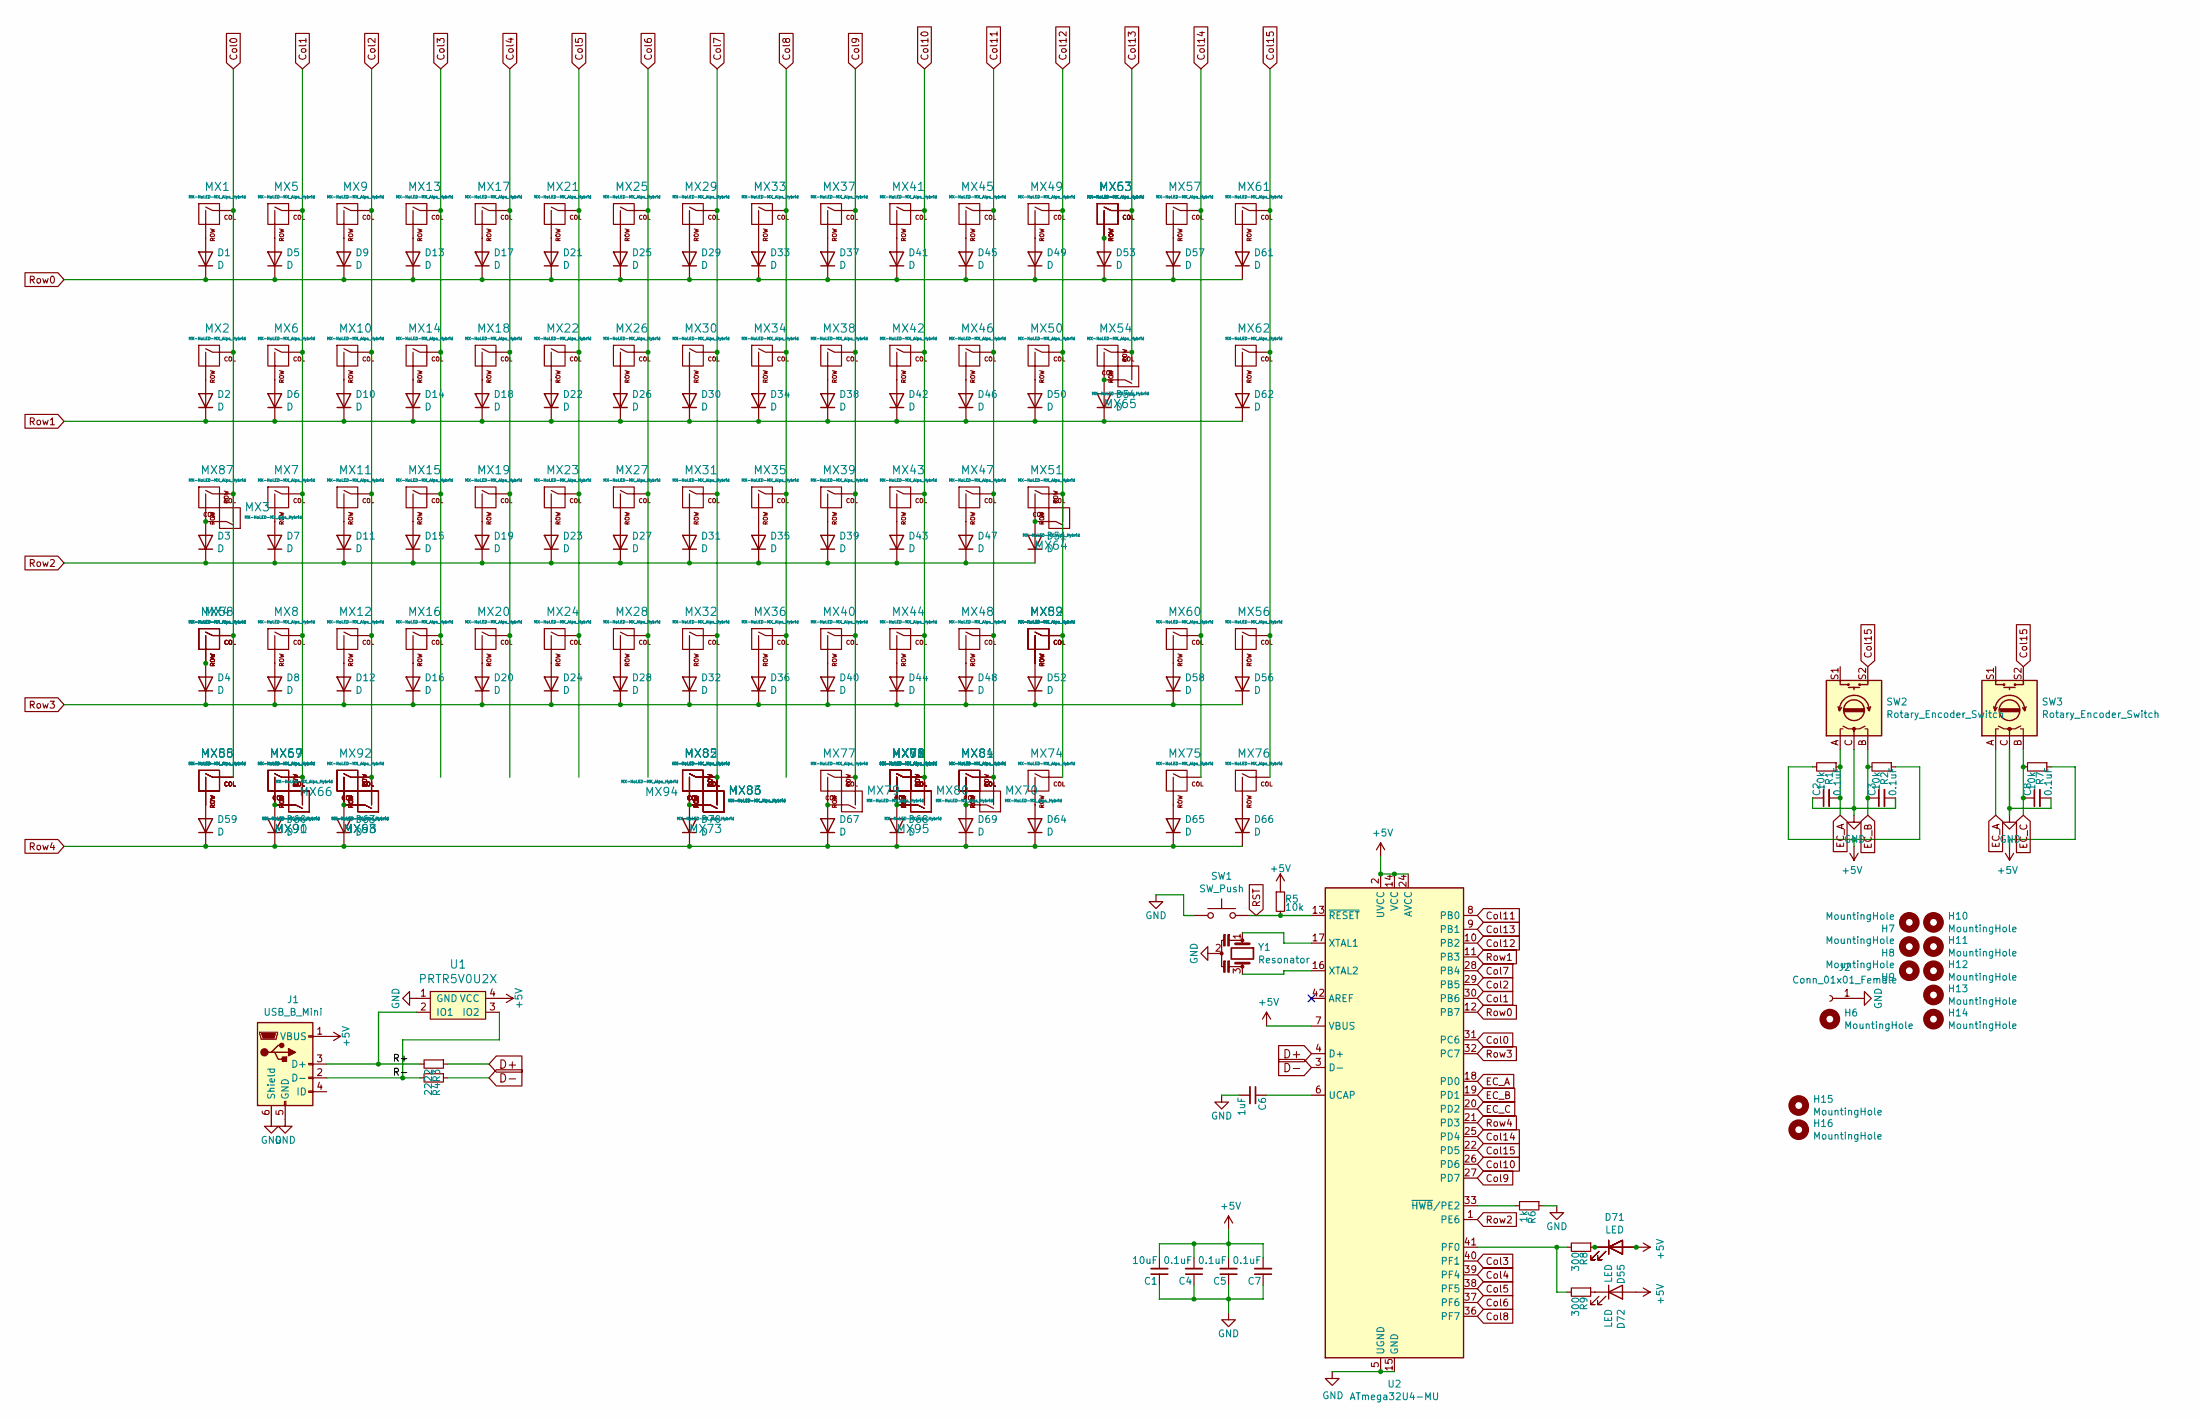
[picture p219: schematic Leopold Replacement.sch]

Parts:
C1: 10uF; C_0603
C2, C3, C4, C5, C7, C8: 0.1uF; C_0603
C6: 1uF; C_0603
D1, D2, D3, D4, D5, D6, D7, D8, D9, D10, D11, D12, D13, D14, D15, D16, D17, D18, D19, D20, D21, D22, D23, D24, D25, D26, D27, D28, D29, D30, D31, D32, D33, D34, D35, D36, D37, D38, D39, D40, D41, D42, D43, D44, D45, D46, D47, D48, D49, D50, D51, D52, D53, D54, D56, D57, D58, D59, D60, D61, D62, D63, D64, D65, D66, D67, D68, D69, D70: D; D_SOD-123
D55: LED; MXOnly-LEDONLY
D71: LED; MXOnly-LEDONLY-FLIPPED
D72: LED; MXOnly-LEDONLY-MID
H6: MountingHole; 10mm-Leopold-Mounting-Hole
H7, H8, H9, H10, H11, H12, H13, H14: MountingHole; Leopold-Mounting-Hole-Main
H15, H16: MountingHole; Leopold-mounting-hole-circle
J1: USB_B_Mini; Molex-0548190589
J2: Conn_01x01_Female; Leopold-Mounting-Hole
MX1, MX2, MX3, MX5, MX6, MX7, MX8, MX9, MX10, MX11, MX12, MX13, MX14, MX15, MX16, MX17, MX18, MX19, MX20, MX21, MX22, MX23, MX24, MX25, MX26, MX27, MX28, MX29, MX30, MX31, MX32, MX33, MX34, MX35, MX36, MX37, MX38, MX39, MX40, MX41, MX42, MX43, MX44, MX45, MX46, MX47, MX48, MX49, MX50, MX53, MX54, MX56, MX57, MX58, MX60, MX61, MX62, MX65, MX67, MX74, MX75, MX76, MX81, MX89, MX91: MX-NoLED-MX_Alps_Hybrid; Mx_Alps_100
MX4, MX51, MX52, MX64: MX-NoLED-MX_Alps_Hybrid; Mx_Alps_225
MX55, MX59, MX66, MX68, MX77, MX78, MX79, MX80, MX84, MX87: MX-NoLED-MX_Alps_Hybrid; Mx_Alps_125
MX63: MX-NoLED-MX_Alps_Hybrid; Mx_Alps_200
MX69, MX70, MX71, MX92, MX95: MX-NoLED-MX_Alps_Hybrid; ALPS-1.5U
MX72, MX88, MX93, MX96: MX-NoLED-MX_Alps_Hybrid; Mx_Alps_150
MX73, MX85: MX-NoLED-MX_Alps_Hybrid; ALPS-6.5U
MX82, MX83: MX-NoLED-MX_Alps_Hybrid; Mx_Alps_625_FL
MX86, MX94: MX-NoLED-MX_Alps_Hybrid; Mx_Alps_700_FL
MX90: MX-NoLED-MX_Alps_Hybrid; ALPS-1.25U
R1, R2, R5, R7: 10k; R_0805
R3, R4: 22; R_0603
R6: 1k; R_0805
R8, R9: 300; R_0805
SW1: SW_Push; SKQG-1155865
SW2, SW3: Rotary_Encoder_Switch; RotaryEncoder_Alps_EC11E-Switch_Vertical_H20mm_Center
U1: PRTR5V0U2X; SOT143B
U2: ATmega32U4-MU; QFN-44-1EP_7x7mm_P0.5mm_EP5.15x5.15mm
Y1: Resonator; Resonator_SMD_muRata_CSTxExxV-3Pin_3.0x1.1mm

Connections:
+5V: C1.2, C4.2, C5.2, C7.2, D55.2 (A), D71.2 (A), D72.2 (A), J1.1 (VBUS), R1.2, R2.1, R5.1, R7.1, U1.4 (VCC), U2.2 (UVCC), U2.7 (VBUS), U2.14 (VCC), U2.24 (AVCC), U2.34 (VCC), U2.44 (AVCC)
Col0: MX1.1 (COL), MX2.1 (COL), MX3.2 (ROW), MX4.1 (COL), MX55.1 (COL), MX58.1 (COL), MX87.1 (COL), MX88.1 (COL), U2.31 (PC6)
Col1: MX5.1 (COL), MX6.1 (COL), MX7.1 (COL), MX8.1 (COL), MX59.1 (COL), MX67.1 (COL), MX90.2 (ROW), MX91.2 (ROW), U2.30 (PB6)
Col2: MX9.1 (COL), MX10.1 (COL), MX11.1 (COL), MX12.1 (COL), MX66.1 (COL), MX68.2 (ROW), MX92.1 (COL), MX93.2 (ROW), U2.29 (PB5)
Col3: MX13.1 (COL), MX14.1 (COL), MX15.1 (COL), MX16.1 (COL), U2.40 (PF1)
Col4: MX17.1 (COL), MX18.1 (COL), MX19.1 (COL), MX20.1 (COL), U2.39 (PF4)
Col5: MX21.1 (COL), MX22.1 (COL), MX23.1 (COL), MX24.1 (COL), U2.38 (PF5)
Col6: MX25.1 (COL), MX26.1 (COL), MX27.1 (COL), MX28.1 (COL), U2.37 (PF6)
Col7: MX29.1 (COL), MX30.1 (COL), MX31.1 (COL), MX32.1 (COL), MX73.2 (ROW), MX82.1 (COL), MX83.2 (ROW), MX85.1 (COL), MX86.2 (ROW), MX94.1 (COL), U2.28 (PB4)
Col8: MX33.1 (COL), MX34.1 (COL), MX35.1 (COL), MX36.1 (COL), U2.36 (PF7)
Col9: MX37.1 (COL), MX38.1 (COL), MX39.1 (COL), MX40.1 (COL), MX77.1 (COL), MX79.2 (ROW), U2.27 (PD7)
Col10: MX41.1 (COL), MX42.1 (COL), MX43.1 (COL), MX44.1 (COL), MX69.1 (COL), MX71.1 (COL), MX72.1 (COL), MX78.1 (COL), MX80.2 (ROW), MX95.2 (ROW), MX96.1 (COL), U2.26 (PD6)
Col11: MX45.1 (COL), MX46.1 (COL), MX47.1 (COL), MX48.1 (COL), MX70.2 (ROW), MX81.1 (COL), MX84.1 (COL), U2.8 (PB0)
Col12: MX49.1 (COL), MX50.1 (COL), MX51.1 (COL), MX52.1 (COL), MX64.2 (ROW), MX74.1 (COL), MX89.1 (COL), U2.10 (PB2)
Col13: MX53.1 (COL), MX54.1 (COL), MX63.1 (COL), MX65.2 (ROW), U2.9 (PB1)
Col14: MX57.1 (COL), MX60.1 (COL), MX75.1 (COL), U2.25 (PD4)
Col15: MX56.1 (COL), MX61.1 (COL), MX62.1 (COL), MX76.1 (COL), SW2.S2, SW3.S2, U2.22 (PD5)
D+: R3.1, U2.4 (D+)
D-: R4.1, U2.3 (D-)
EC_A: C2.2, R1.1, SW2.A, SW3.A, U2.18 (PD0)
EC_B: C3.1, R2.2, SW2.B, U2.19 (PD1)
EC_C: C8.1, R7.2, SW3.B, U2.20 (PD2)
GND: C1.1, C2.1, C3.2, C4.1, C5.1, C6.2, C7.1, C8.2, J1.5 (GND), J1.6 (Shield), J2.1, R6.1, SW1.1, SW2.C, SW3.C, U1.1 (GND), U2.5 (UGND), U2.15 (GND), U2.23 (GND), U2.35 (GND), U2.43 (GND), U2.45 (GND), Y1.2
unnamed: C6.1, U2.6 (UCAP)
unnamed: D1.2 (A), MX1.2 (ROW)
unnamed: D2.2 (A), MX2.2 (ROW)
unnamed: D3.2 (A), MX3.1 (COL), MX87.2 (ROW)
unnamed: D4.2 (A), MX4.2 (ROW), MX58.2 (ROW)
unnamed: D5.2 (A), MX5.2 (ROW)
unnamed: D6.2 (A), MX6.2 (ROW)
unnamed: D7.2 (A), MX7.2 (ROW)
unnamed: D8.2 (A), MX8.2 (ROW)
unnamed: D9.2 (A), MX9.2 (ROW)
unnamed: D10.2 (A), MX10.2 (ROW)
unnamed: D11.2 (A), MX11.2 (ROW)
unnamed: D12.2 (A), MX12.2 (ROW)
unnamed: D13.2 (A), MX13.2 (ROW)
unnamed: D14.2 (A), MX14.2 (ROW)
unnamed: D15.2 (A), MX15.2 (ROW)
unnamed: D16.2 (A), MX16.2 (ROW)
unnamed: D17.2 (A), MX17.2 (ROW)
unnamed: D18.2 (A), MX18.2 (ROW)
unnamed: D19.2 (A), MX19.2 (ROW)
unnamed: D20.2 (A), MX20.2 (ROW)
unnamed: D21.2 (A), MX21.2 (ROW)
unnamed: D22.2 (A), MX22.2 (ROW)
unnamed: D23.2 (A), MX23.2 (ROW)
unnamed: D24.2 (A), MX24.2 (ROW)
unnamed: D25.2 (A), MX25.2 (ROW)
unnamed: D26.2 (A), MX26.2 (ROW)
unnamed: D27.2 (A), MX27.2 (ROW)
unnamed: D28.2 (A), MX28.2 (ROW)
unnamed: D29.2 (A), MX29.2 (ROW)
unnamed: D30.2 (A), MX30.2 (ROW)
unnamed: D31.2 (A), MX31.2 (ROW)
unnamed: D32.2 (A), MX32.2 (ROW)
unnamed: D33.2 (A), MX33.2 (ROW)
unnamed: D34.2 (A), MX34.2 (ROW)
unnamed: D35.2 (A), MX35.2 (ROW)
unnamed: D36.2 (A), MX36.2 (ROW)
unnamed: D37.2 (A), MX37.2 (ROW)
unnamed: D38.2 (A), MX38.2 (ROW)
unnamed: D39.2 (A), MX39.2 (ROW)
unnamed: D40.2 (A), MX40.2 (ROW)
unnamed: D41.2 (A), MX41.2 (ROW)
unnamed: D42.2 (A), MX42.2 (ROW)
unnamed: D43.2 (A), MX43.2 (ROW)
unnamed: D44.2 (A), MX44.2 (ROW)
unnamed: D45.2 (A), MX45.2 (ROW)
unnamed: D46.2 (A), MX46.2 (ROW)
unnamed: D47.2 (A), MX47.2 (ROW)
unnamed: D48.2 (A), MX48.2 (ROW)
unnamed: D49.2 (A), MX49.2 (ROW)
unnamed: D50.2 (A), MX50.2 (ROW)
unnamed: D51.2 (A), MX51.2 (ROW), MX64.1 (COL)
unnamed: D52.2 (A), MX52.2 (ROW), MX89.2 (ROW)
unnamed: D53.2 (A), MX53.2 (ROW), MX63.2 (ROW)
unnamed: D54.2 (A), MX54.2 (ROW), MX65.1 (COL)
unnamed: D55.1 (K), D71.1 (K), R8.1
unnamed: D56.2 (A), MX56.2 (ROW)
unnamed: D57.2 (A), MX57.2 (ROW)
unnamed: D58.2 (A), MX60.2 (ROW)
unnamed: D59.2 (A), MX55.2 (ROW), MX88.2 (ROW)
unnamed: D60.2 (A), MX59.2 (ROW), MX67.2 (ROW), MX90.1 (COL), MX91.1 (COL)
unnamed: D61.2 (A), MX61.2 (ROW)
unnamed: D62.2 (A), MX62.2 (ROW)
unnamed: D63.2 (A), MX66.2 (ROW), MX68.1 (COL), MX92.2 (ROW), MX93.1 (COL)
unnamed: D64.2 (A), MX74.2 (ROW)
unnamed: D65.2 (A), MX75.2 (ROW)
unnamed: D66.2 (A), MX76.2 (ROW)
unnamed: D67.2 (A), MX77.2 (ROW), MX79.1 (COL)
unnamed: D68.2 (A), MX69.2 (ROW), MX71.2 (ROW), MX72.2 (ROW), MX78.2 (ROW), MX80.1 (COL), MX95.1 (COL), MX96.2 (ROW)
unnamed: D69.2 (A), MX70.1 (COL), MX81.2 (ROW), MX84.2 (ROW)
unnamed: D70.2 (A), MX73.1 (COL), MX82.2 (ROW), MX83.1 (COL), MX85.2 (ROW), MX86.1 (COL), MX94.2 (ROW)
unnamed: D72.1 (K), R9.1
unnamed: R6.2, U2.33 (~HWB~/PE2)
unnamed: R8.2, R9.2, U2.41 (PF0)
unnamed: U2.16 (XTAL2), Y1.3
unnamed: U2.17 (XTAL1), Y1.1
R+: J1.3 (D+), R3.2, U1.2 (IO1)
R-: J1.2 (D-), R4.2, U1.3 (IO2)
RST: R5.2, SW1.2, U2.13 (~RESET)
Row0: D1.1 (K), D5.1 (K), D9.1 (K), D13.1 (K), D17.1 (K), D21.1 (K), D25.1 (K), D29.1 (K), D33.1 (K), D37.1 (K), D41.1 (K), D45.1 (K), D49.1 (K), D53.1 (K), D57.1 (K), D61.1 (K), U2.12 (PB7)
Row1: D2.1 (K), D6.1 (K), D10.1 (K), D14.1 (K), D18.1 (K), D22.1 (K), D26.1 (K), D30.1 (K), D34.1 (K), D38.1 (K), D42.1 (K), D46.1 (K), D50.1 (K), D54.1 (K), D62.1 (K), U2.11 (PB3)
Row2: D3.1 (K), D7.1 (K), D11.1 (K), D15.1 (K), D19.1 (K), D23.1 (K), D27.1 (K), D31.1 (K), D35.1 (K), D39.1 (K), D43.1 (K), D47.1 (K), D51.1 (K), U2.1 (PE6)
Row3: D4.1 (K), D8.1 (K), D12.1 (K), D16.1 (K), D20.1 (K), D24.1 (K), D28.1 (K), D32.1 (K), D36.1 (K), D40.1 (K), D44.1 (K), D48.1 (K), D52.1 (K), D56.1 (K), D58.1 (K), U2.32 (PC7)
Row4: D59.1 (K), D60.1 (K), D63.1 (K), D64.1 (K), D65.1 (K), D66.1 (K), D67.1 (K), D68.1 (K), D69.1 (K), D70.1 (K), U2.21 (PD3)
