MaiTheSan/PCB-Design/KiCad/06-2021 comm/Leopold Replacement/OG BLE/nt660.kicad_sch

## KiCad design KiCad/06-2021 comm/Leopold Replacement/OG BLE/nt660.kicad_sch (2022-11-19)

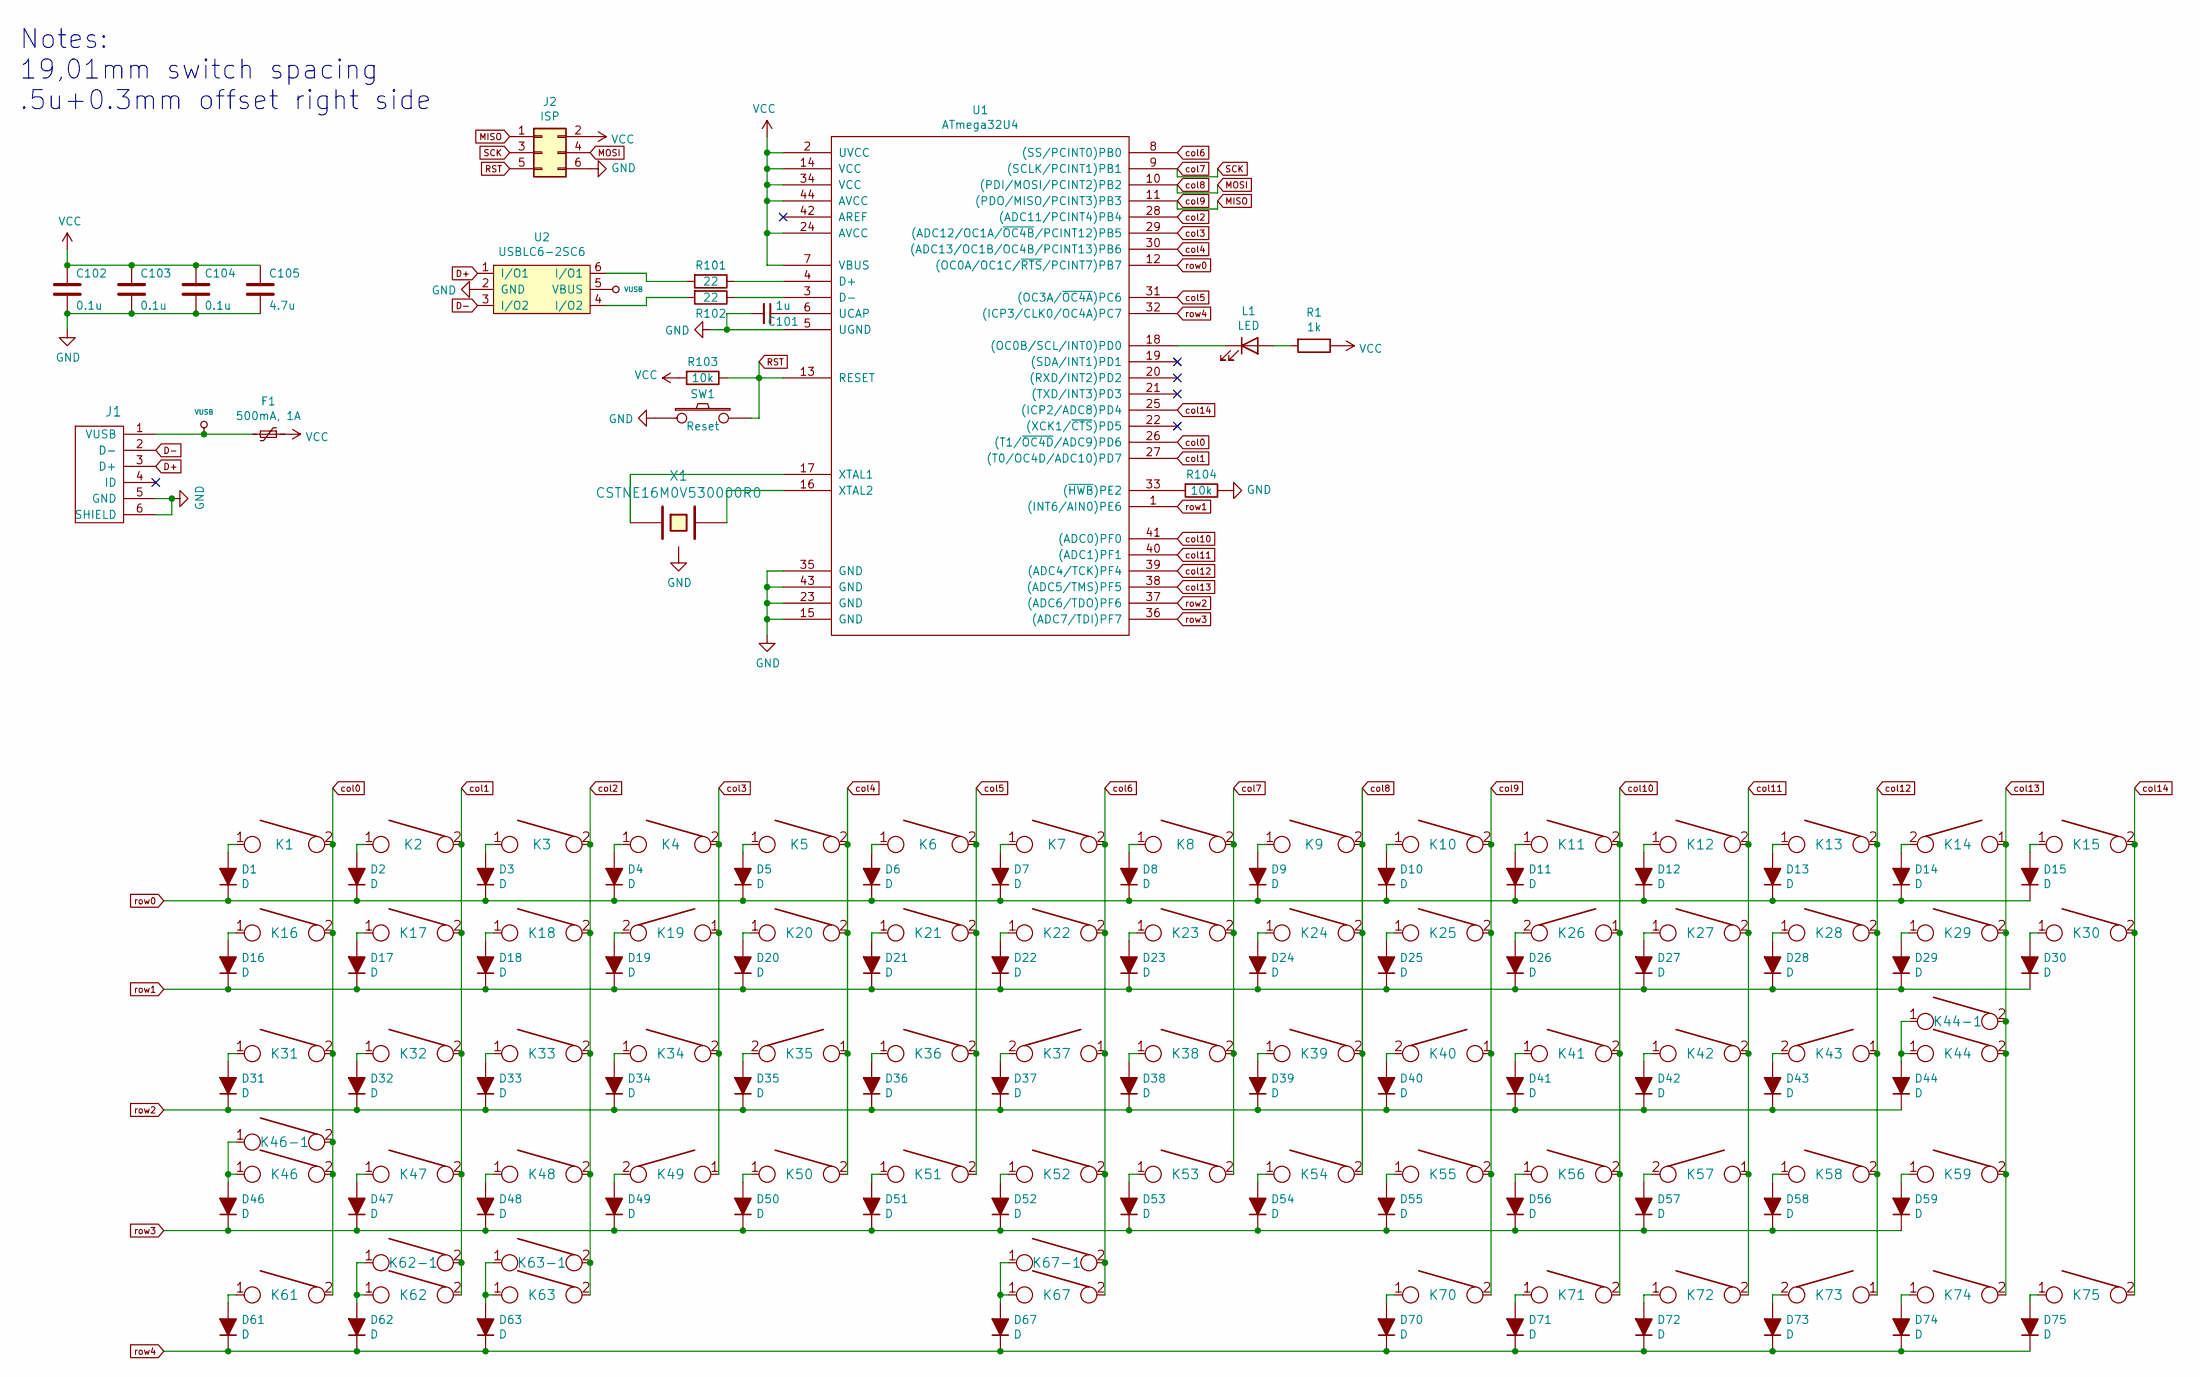
[picture p220: schematic nt660.kicad_sch]

Parts:
C101: 1u; C_0805
C102, C103, C104: 0.1u; C_0805
C105: 4.7u; C_0805
D1, D2, D3, D4, D5, D6, D7, D8, D9, D10, D11, D12, D13, D14, D15, D16, D17, D18, D19, D20, D21, D22, D23, D24, D25, D26, D27, D28, D29, D30, D31, D32, D33, D34, D35, D36, D37, D38, D39, D40, D41, D42, D43, D44, D46, D47, D48, D49, D50, D51, D52, D53, D54, D55, D56, D57, D58, D59, D61, D62, D63, D67, D70, D71, D72, D73, D74, D75: D; D_0805
F1: 500mA, 1A; R_0805
J1: USB_mini_micro_B; U-M-M5DD-W-1
J2: ISP; isp_standard
K1, K2, K3, K4, K5, K6, K7, K8, K9, K10, K11, K12, K13, K15, K17, K18, K19, K20, K21, K22, K23, K24, K25, K26, K27, K28, K30, K32, K33, K34, K35, K36, K37, K38, K39, K40, K41, K42, K43, K47, K48, K49, K50, K51, K52, K53, K54, K55, K56, K57, K59, K62, K73, K74, K75: KEYSW; CHERRY_PLATE_100H
K14: KEYSW; CHERRY_PCB_200H
K16, K29: KEYSW; CHERRY_PLATE_150H
K31: KEYSW; CHERRY_PLATE_175H
K44, K46, K58: KEYSW; CHERRY_PCB_225H
K44-1: KEYSW; CHERRY_PCB_200H_V
K46-1, K61, K62-1, K63, K63-1, K70, K71, K72: KEYSW; CHERRY_PLATE_125H
K67: KEYSW; CHERRY_PCB_625H_F
K67-1: KEYSW; CHERRY_PCB_600C_H_F
L1: LED; CHERRY_MX_LED
R1: 1k; R_0805
R101, R102: 22; R_0805
R103, R104: 10k; R_0805
SW1: Reset; SW_SPST_TL3342
U1: ATmega32U4; ATMEGA32U4
U2: USBLC6-2SC6
X1: CSTNE16M0V530000R0; Resonator_SMD_muRata_CSTNExxV-3Pin-p1.2

Connections:
D+: J1.3 (D+), U2.1 (I/O1)
D-: J1.2 (D-), U2.3 (I/O2)
GND: C101.2, C102.2, C103.2, C104.2, C105.2, J1.5 (GND), J1.6 (SHIELD), J2.6, R104.1, SW1.1, U1.5 (UGND), U1.15 (GND), U1.23 (GND), U1.35 (GND), U1.43 (GND), U2.2 (GND), X1.3
unnamed: C101.1, U1.6 (UCAP)
unnamed: D1.2 (A), K1.1
unnamed: D2.2 (A), K2.1
unnamed: D3.2 (A), K3.1
unnamed: D4.2 (A), K4.1
unnamed: D5.2 (A), K5.1
unnamed: D6.2 (A), K6.1
unnamed: D7.2 (A), K7.1
unnamed: D8.2 (A), K8.1
unnamed: D9.2 (A), K9.1
unnamed: D10.2 (A), K10.1
unnamed: D11.2 (A), K11.1
unnamed: D12.2 (A), K12.1
unnamed: D13.2 (A), K13.1
unnamed: D14.2 (A), K14.2
unnamed: D15.2 (A), K15.1
unnamed: D16.2 (A), K16.1
unnamed: D17.2 (A), K17.1
unnamed: D18.2 (A), K18.1
unnamed: D19.2 (A), K19.2
unnamed: D20.2 (A), K20.1
unnamed: D21.2 (A), K21.1
unnamed: D22.2 (A), K22.1
unnamed: D23.2 (A), K23.1
unnamed: D24.2 (A), K24.1
unnamed: D25.2 (A), K25.1
unnamed: D26.2 (A), K26.2
unnamed: D27.2 (A), K27.1
unnamed: D28.2 (A), K28.1
unnamed: D29.2 (A), K29.1
unnamed: D30.2 (A), K30.1
unnamed: D31.2 (A), K31.1
unnamed: D32.2 (A), K32.1
unnamed: D33.2 (A), K33.1
unnamed: D34.2 (A), K34.1
unnamed: D35.2 (A), K35.2
unnamed: D36.2 (A), K36.1
unnamed: D37.2 (A), K37.2
unnamed: D38.2 (A), K38.1
unnamed: D39.2 (A), K39.1
unnamed: D40.2 (A), K40.2
unnamed: D41.2 (A), K41.1
unnamed: D42.2 (A), K42.1
unnamed: D43.2 (A), K43.2
unnamed: D44.2 (A), K44.1, K44-1.1
unnamed: D46.2 (A), K46.1, K46-1.1
unnamed: D47.2 (A), K47.1
unnamed: D48.2 (A), K48.1
unnamed: D49.2 (A), K49.2
unnamed: D50.2 (A), K50.1
unnamed: D51.2 (A), K51.1
unnamed: D52.2 (A), K52.1
unnamed: D53.2 (A), K53.1
unnamed: D54.2 (A), K54.1
unnamed: D55.2 (A), K55.1
unnamed: D56.2 (A), K56.1
unnamed: D57.2 (A), K57.2
unnamed: D58.2 (A), K58.1
unnamed: D59.2 (A), K59.1
unnamed: D61.2 (A), K61.1
unnamed: D62.2 (A), K62.1, K62-1.1
unnamed: D63.2 (A), K63.1, K63-1.1
unnamed: D67.2 (A), K67.1, K67-1.1
unnamed: D70.2 (A), K70.1
unnamed: D71.2 (A), K71.1
unnamed: D72.2 (A), K72.1
unnamed: D73.2 (A), K73.2
unnamed: D74.2 (A), K74.1
unnamed: D75.2 (A), K75.1
unnamed: L1.1 (K), U1.18 ((OC0B/SCL/INT0)PD0)
unnamed: L1.2 (A), R1.2
unnamed: R101.1, U1.4 (D+)
unnamed: R101.2, U2.6 (I/O1)
unnamed: R102.1, U1.3 (D-)
unnamed: R102.2, U2.4 (I/O2)
unnamed: R104.2, U1.33 ((~HWB~)PE2)
unnamed: U1.16 (XTAL2), X1.2
unnamed: U1.17 (XTAL1), X1.1
RST: J2.5, R103.1, SW1.2, U1.13 (RESET)
VCC: C102.1, C103.1, C104.1, C105.1, F1.1, J2.2, R1.1, R103.2, U1.2 (UVCC), U1.7 (VBUS), U1.14 (VCC), U1.24 (AVCC), U1.34 (VCC), U1.44 (AVCC)
VUSB: F1.2, J1.1 (VUSB), U2.5 (VBUS)
col0: K1.2, K16.2, K31.2, K46.2, K46-1.2, K61.2, U1.26 ((T1/~OC4D~/ADC9)PD6)
col1: K2.2, K17.2, K32.2, K47.2, K62.2, K62-1.2, U1.27 ((T0/OC4D/ADC10)PD7)
col2: K3.2, K18.2, K33.2, K48.2, K63.2, K63-1.2, U1.28 ((ADC11/PCINT4)PB4)
col3: K4.2, K19.1, K34.2, K49.1, U1.29 ((ADC12/OC1A/~OC4B~/PCINT12)PB5)
col4: K5.2, K20.2, K35.1, K50.2, U1.30 ((ADC13/OC1B/OC4B/PCINT13)PB6)
col5: K6.2, K21.2, K36.2, K51.2, U1.31 ((OC3A/~OC4A~)PC6)
col6: K7.2, K22.2, K37.1, K52.2, K67.2, K67-1.2, U1.8 ((SS/PCINT0)PB0)
col7: J2.3, K8.2, K23.2, K38.2, K53.2, U1.9 ((SCLK/PCINT1)PB1)
col8: J2.4, K9.2, K24.2, K39.2, K54.2, U1.10 ((PDI/MOSI/PCINT2)PB2)
col9: J2.1, K10.2, K25.2, K40.1, K55.2, K70.2, U1.11 ((PDO/MISO/PCINT3)PB3)
col10: K11.2, K26.1, K41.2, K56.2, K71.2, U1.41 ((ADC0)PF0)
col11: K12.2, K27.2, K42.2, K57.1, K72.2, U1.40 ((ADC1)PF1)
col12: K13.2, K28.2, K43.1, K58.2, K73.1, U1.39 ((ADC4/TCK)PF4)
col13: K14.1, K29.2, K44.2, K44-1.2, K59.2, K74.2, U1.38 ((ADC5/TMS)PF5)
col14: K15.2, K30.2, K75.2, U1.25 ((ICP2/ADC8)PD4)
row0: D1.1 (K), D2.1 (K), D3.1 (K), D4.1 (K), D5.1 (K), D6.1 (K), D7.1 (K), D8.1 (K), D9.1 (K), D10.1 (K), D11.1 (K), D12.1 (K), D13.1 (K), D14.1 (K), D15.1 (K), U1.12 ((OC0A/OC1C/~RTS~/PCINT7)PB7)
row1: D16.1 (K), D17.1 (K), D18.1 (K), D19.1 (K), D20.1 (K), D21.1 (K), D22.1 (K), D23.1 (K), D24.1 (K), D25.1 (K), D26.1 (K), D27.1 (K), D28.1 (K), D29.1 (K), D30.1 (K), U1.1 ((INT6/AIN0)PE6)
row2: D31.1 (K), D32.1 (K), D33.1 (K), D34.1 (K), D35.1 (K), D36.1 (K), D37.1 (K), D38.1 (K), D39.1 (K), D40.1 (K), D41.1 (K), D42.1 (K), D43.1 (K), D44.1 (K), U1.37 ((ADC6/TDO)PF6)
row3: D46.1 (K), D47.1 (K), D48.1 (K), D49.1 (K), D50.1 (K), D51.1 (K), D52.1 (K), D53.1 (K), D54.1 (K), D55.1 (K), D56.1 (K), D57.1 (K), D58.1 (K), D59.1 (K), U1.36 ((ADC7/TDI)PF7)
row4: D61.1 (K), D62.1 (K), D63.1 (K), D67.1 (K), D70.1 (K), D71.1 (K), D72.1 (K), D73.1 (K), D74.1 (K), D75.1 (K), U1.32 ((ICP3/CLK0/OC4A)PC7)

Notes on the sheet:
Notes: 19,01mm switch spacing .5u+0.3mm offset right side
