MaiTheSan/PCB-Design/KiCad/06-2021 comm/burh/PCB/SAMPad.sch

## KiCad design KiCad/06-2021 comm/burh/PCB/SAMPad.sch (2022-11-19)

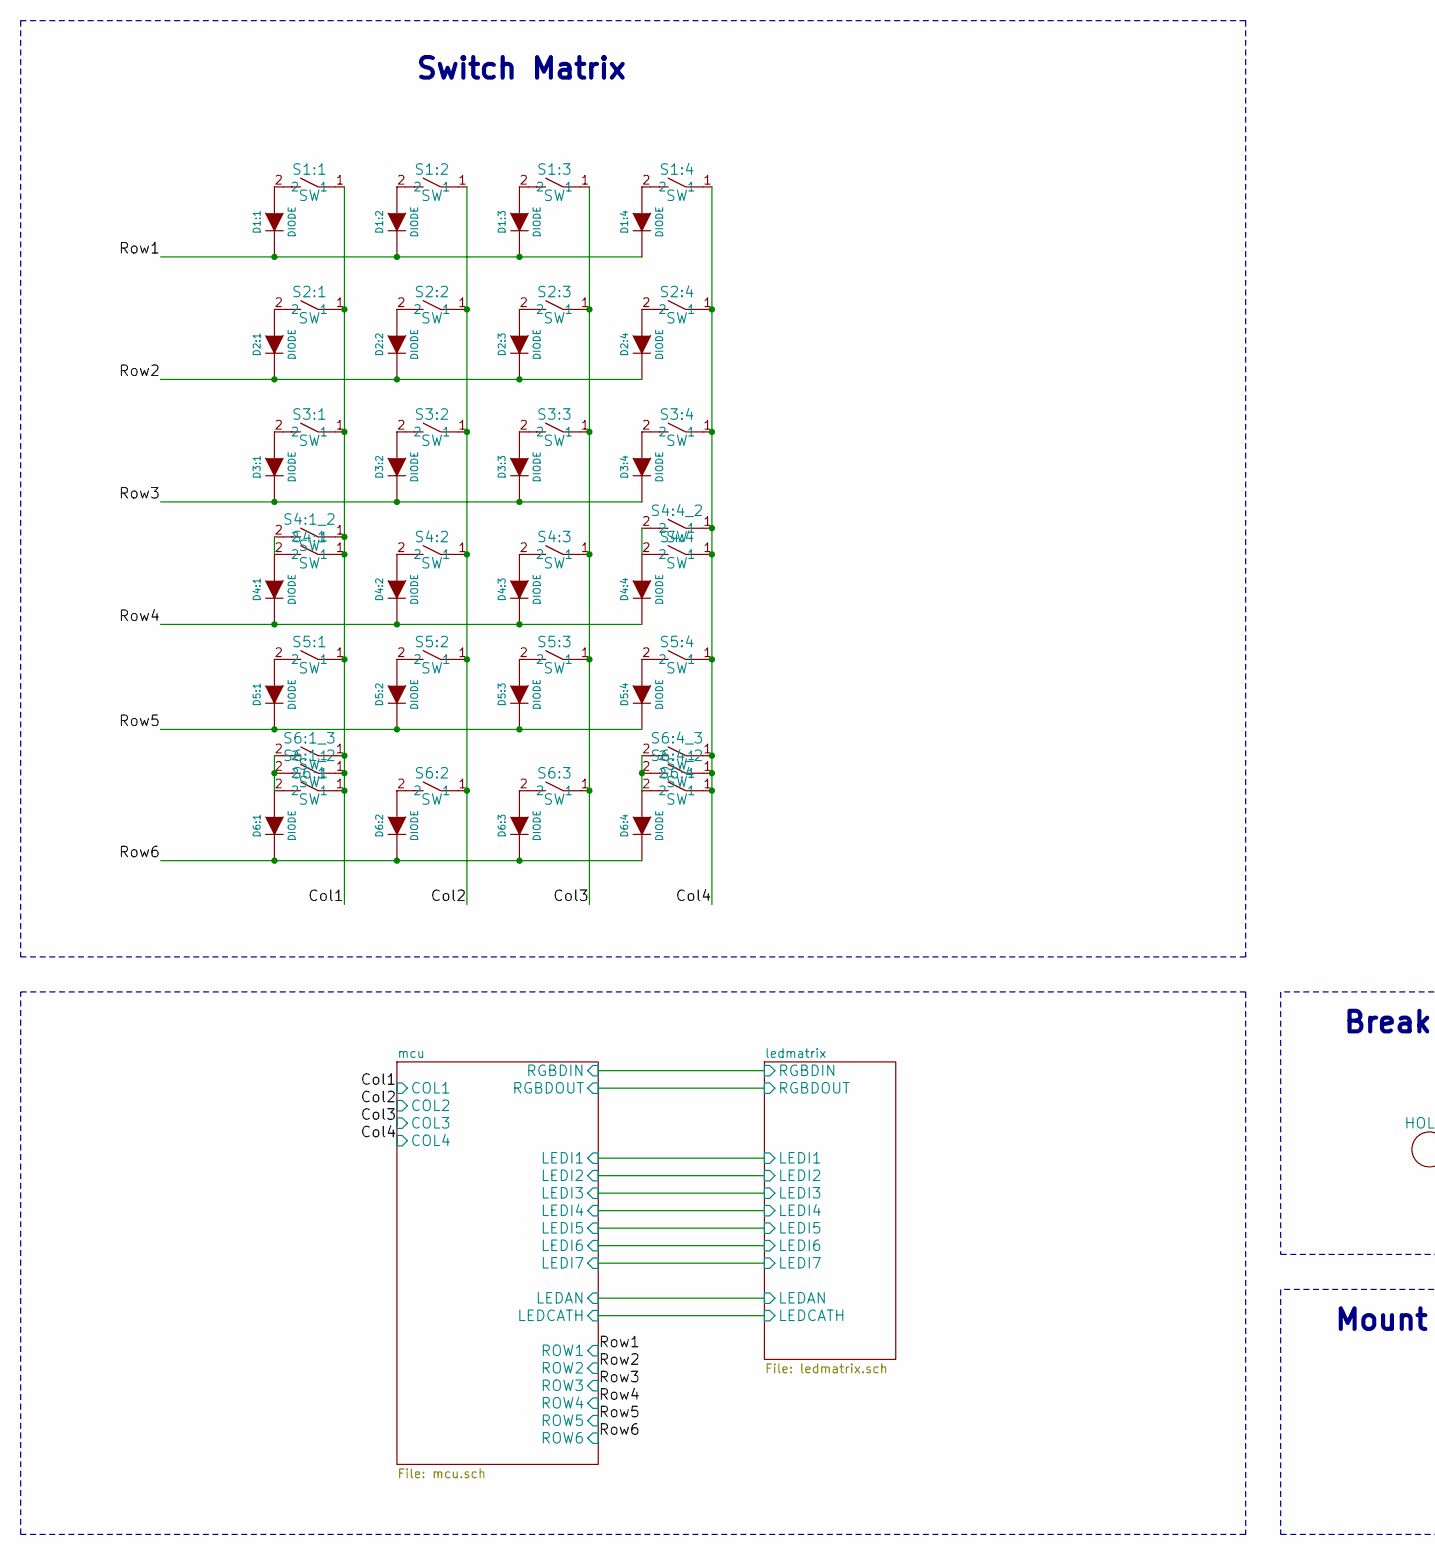
[picture p221: schematic SAMPad.sch, part in row 1, column 1]

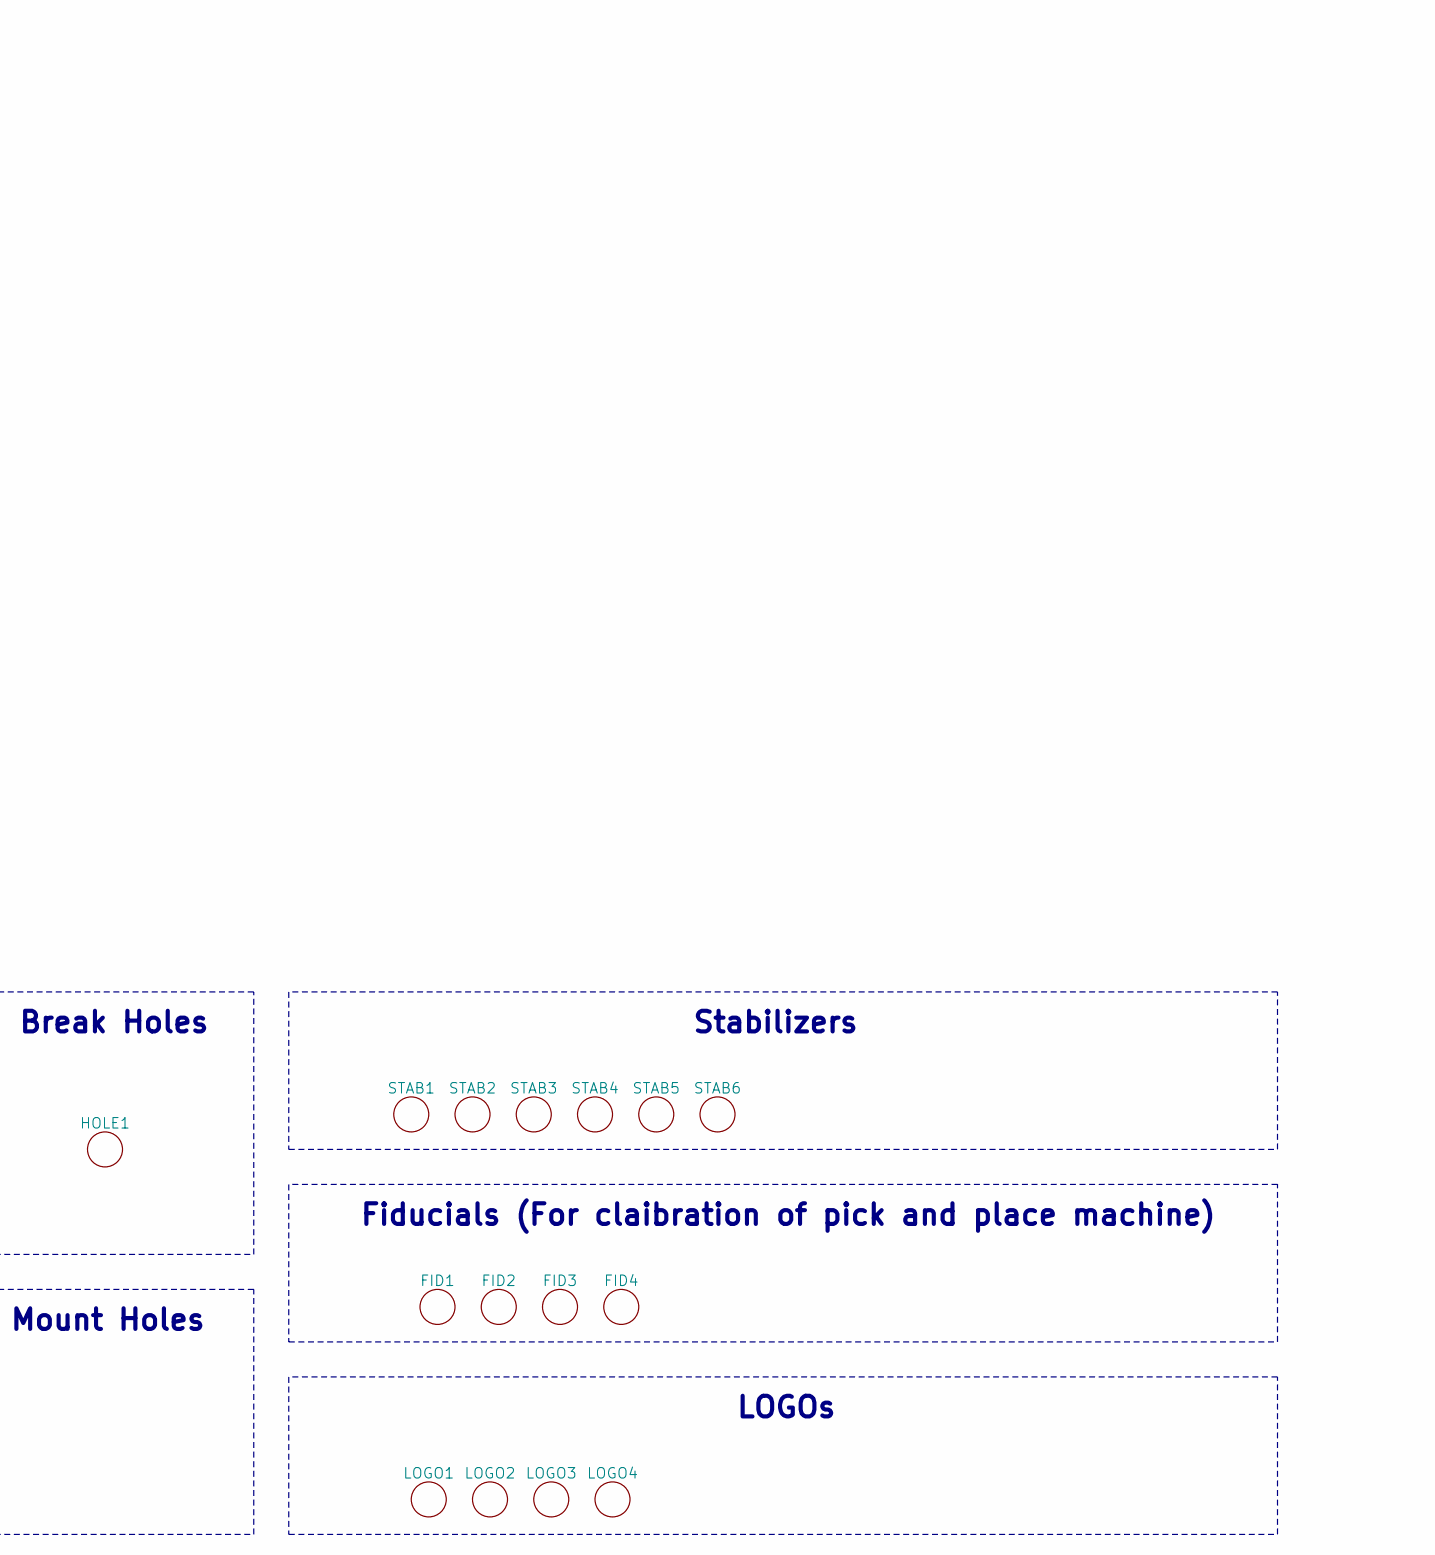
[picture p222: schematic SAMPad.sch, part in row 1, column 2]

Parts:
D1:1, D1:2, D1:3, D1:4, D2:1, D2:2, D2:3, D2:4, D3:1, D3:2, D3:3, D3:4, D4:1, D4:2, D4:3, D4:4, D5:1, D5:2, D5:3, D5:4, D6:1, D6:2, D6:3, D6:4: DIODE; SOD123-DIODE
FID1, FID2, FID3, FID4: MISC; FID
HOLE1: MISC; FID
LOGO1, LOGO2: MISC; SAMPad-Logo
LOGO3, LOGO4: MISC; OSHW
S1:1, S1:2, S1:3, S1:4, S2:1, S2:2, S2:3, S2:4, S3:1, S3:2, S3:3, S3:4, S4:1, S4:1_2, S4:2, S4:3, S4:4, S4:4_2, S5:1, S5:2, S5:3, S5:4, S6:1, S6:1_2, S6:1_3, S6:2, S6:3, S6:4, S6:4_2, S6:4_3: SW; MXALPS2
STAB1, STAB2, STAB3, STAB4, STAB5, STAB6: MISC; MX_200

Connections:
Col1: S1:1.1, S2:1.1, S3:1.1, S4:1.1, S4:1_2.1, S5:1.1, S6:1.1, S6:1_2.1, S6:1_3.1
Col2: S1:2.1, S2:2.1, S3:2.1, S4:2.1, S5:2.1, S6:2.1
Col3: S1:3.1, S2:3.1, S3:3.1, S4:3.1, S5:3.1, S6:3.1
Col4: S1:4.1, S2:4.1, S3:4.1, S4:4.1, S4:4_2.1, S5:4.1, S6:4.1, S6:4_2.1, S6:4_3.1
unnamed: D1:1.1 (A), S1:1.2
unnamed: D1:2.1 (A), S1:2.2
unnamed: D1:3.1 (A), S1:3.2
unnamed: D1:4.1 (A), S1:4.2
unnamed: D2:1.1 (A), S2:1.2
unnamed: D2:2.1 (A), S2:2.2
unnamed: D2:3.1 (A), S2:3.2
unnamed: D2:4.1 (A), S2:4.2
unnamed: D3:1.1 (A), S3:1.2
unnamed: D3:2.1 (A), S3:2.2
unnamed: D3:3.1 (A), S3:3.2
unnamed: D3:4.1 (A), S3:4.2
unnamed: D4:1.1 (A), S4:1.2, S4:1_2.2
unnamed: D4:2.1 (A), S4:2.2
unnamed: D4:3.1 (A), S4:3.2
unnamed: D4:4.1 (A), S4:4.2, S4:4_2.2
unnamed: D5:1.1 (A), S5:1.2
unnamed: D5:2.1 (A), S5:2.2
unnamed: D5:3.1 (A), S5:3.2
unnamed: D5:4.1 (A), S5:4.2
unnamed: D6:1.1 (A), S6:1.2, S6:1_2.2, S6:1_3.2
unnamed: D6:2.1 (A), S6:2.2
unnamed: D6:3.1 (A), S6:3.2
unnamed: D6:4.1 (A), S6:4.2, S6:4_2.2, S6:4_3.2
Row1: D1:1.2 (K), D1:2.2 (K), D1:3.2 (K), D1:4.2 (K)
Row2: D2:1.2 (K), D2:2.2 (K), D2:3.2 (K), D2:4.2 (K)
Row3: D3:1.2 (K), D3:2.2 (K), D3:3.2 (K), D3:4.2 (K)
Row4: D4:1.2 (K), D4:2.2 (K), D4:3.2 (K), D4:4.2 (K)
Row5: D5:1.2 (K), D5:2.2 (K), D5:3.2 (K), D5:4.2 (K)
Row6: D6:1.2 (K), D6:2.2 (K), D6:3.2 (K), D6:4.2 (K)

Notes on the sheet:
Switch Matrix
Stabilizers
Fiducials (For claibration of pick and place machine)
LOGOs
Break Holes
Mount Holes
