MaiTheSan/PCB-Design/KiCad/06-2021 comm/burh/PCB/ledmatrix.sch

## KiCad design KiCad/06-2021 comm/burh/PCB/ledmatrix.sch (2022-11-19)

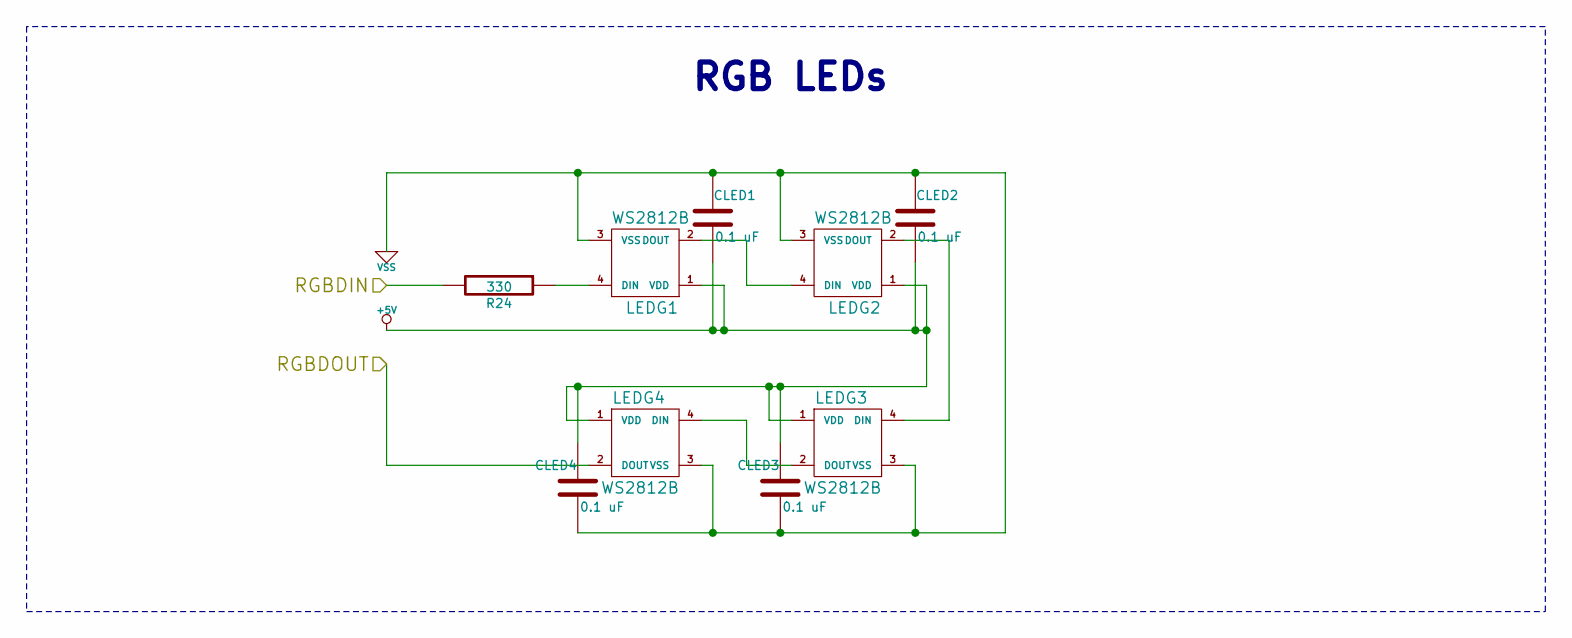
[picture p223: schematic ledmatrix.sch]

Parts:
CLED1, CLED2, CLED3, CLED4: 0.1 uF; SMD_0805
LEDG1, LEDG2, LEDG3, LEDG4: WS2812B
R24: 330; SMD_0805

Connections:
+5V: CLED1.2, CLED2.2, CLED3.1, CLED4.1, LEDG1.1 (VDD), LEDG2.1 (VDD), LEDG3.1 (VDD), LEDG4.1 (VDD)
unnamed: LEDG1.2 (DOUT), LEDG2.4 (DIN)
unnamed: LEDG1.4 (DIN), R24.1
unnamed: LEDG2.2 (DOUT), LEDG3.4 (DIN)
unnamed: LEDG3.2 (DOUT), LEDG4.4 (DIN)
RGBDIN: R24.2
RGBDOUT: LEDG4.2 (DOUT)
VSS: CLED1.1, CLED2.1, CLED3.2, CLED4.2, LEDG1.3 (VSS), LEDG2.3 (VSS), LEDG3.3 (VSS), LEDG4.3 (VSS)

Notes on the sheet:
RGB LEDs
