MaiTheSan/PCB-Design/KiCad/06-2021 comm/burh/PCB/mcu.sch

## KiCad design KiCad/06-2021 comm/burh/PCB/mcu.sch (2022-11-19)

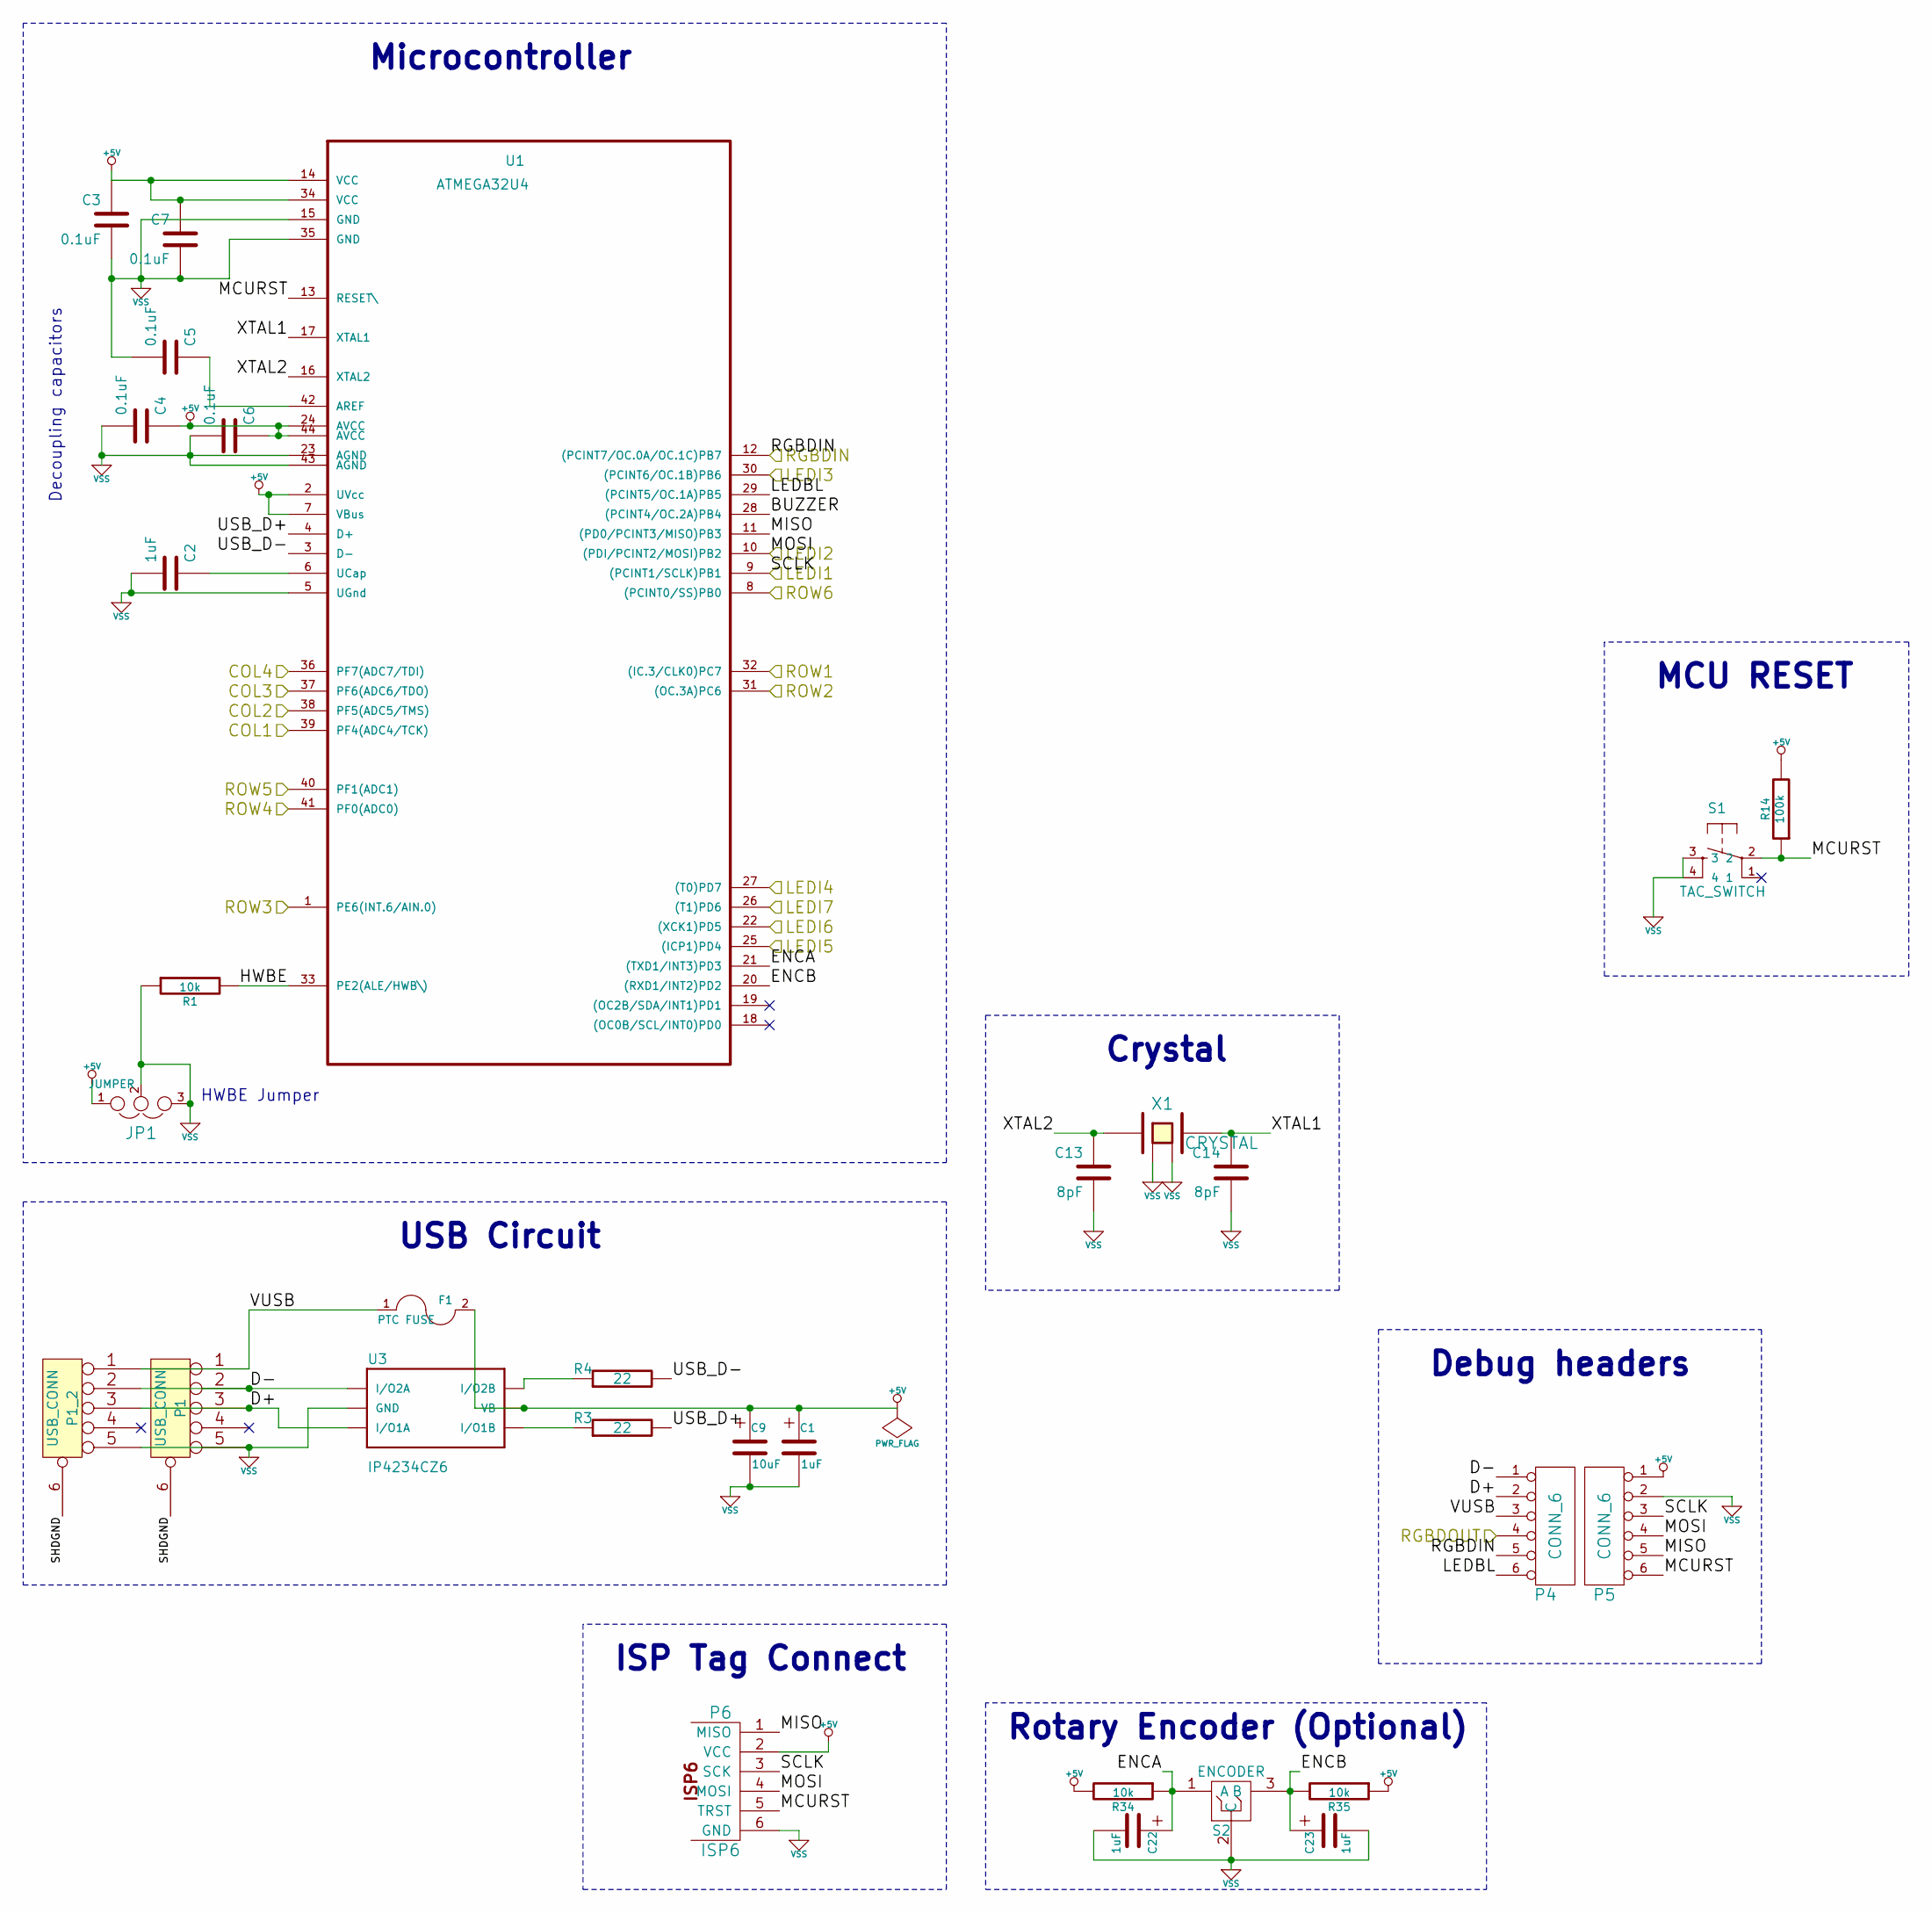
[picture p224: schematic mcu.sch]

Parts:
C1, C2, C22, C23: 1uF; SMD_0805
C3, C4, C5, C6, C7: 0.1uF; SMD_0805
C9: 10uF; SMD_0805
C13, C14: 8pF; SMD_0805
F1: PTC FUSE; Fuse_SMD1206
JP1: JUMPER; JUMPER_SMD_3
P1, P1_2: USB_CONN; USB_Micro-B
P4, P5: CONN_6; Pin_Header_1x06
P6: ISP6; TC2030_BIG
R1, R34, R35: 10k; SMD_0805
R3, R4: 22; SMD_0805
R14: 100k; SMD_0805
S1: TAC_SWITCH; TACT_5.2x5.2
S2: ENCODER; ENCODER_12MM
U1: ATMEGA32U4; TQFP44
U3: IP4234CZ6; SOT457
X1: CRYSTAL; NX3225SA

Connections:
+5V: C1.1, C3.1, C4.1, C6.1, C7.1, C9.1, F1.2, JP1.1, P5.1, P6.2 (VCC), R14.2, R34.2, R35.1, U1.2 (UVcc), U1.7 (VBus), U1.14 (VCC), U1.24 (AVCC), U1.34 (VCC), U1.44 (AVCC), U3.5 (VB)
BUZZER: U1.28 ((PCINT4/OC.2A)PB4)
COL1: U1.39 (PF4(ADC4/TCK))
COL2: U1.38 (PF5(ADC5/TMS))
COL3: U1.37 (PF6(ADC6/TDO))
COL4: U1.36 (PF7(ADC7/TDI))
D+: P1.3, P1_2.3, P4.2, U3.4 (I/O1A)
D-: P1.2, P1_2.2, P4.1, U3.3 (I/O2A)
ENCA: C22.1, R34.1, S2.1 (A), U1.21 ((TXD1/INT3)PD3)
ENCB: C23.1, R35.2, S2.3 (B), U1.20 ((RXD1/INT2)PD2)
HWBE: R1.2, U1.33 (PE2(ALE/HWB\))
LEDBL: P4.6, U1.29 ((PCINT5/OC.1A)PB5)
LEDI1: P5.3, P6.3 (SCK), U1.9 ((PCINT1/SCLK)PB1)
LEDI2: P5.4, P6.4 (MOSI), U1.10 ((PDI/PCINT2/MOSI)PB2)
LEDI3: U1.30 ((PCINT6/OC.1B)PB6)
LEDI4: U1.27 ((T0)PD7)
LEDI5: U1.25 ((ICP1)PD4)
LEDI6: U1.22 ((XCK1)PD5)
LEDI7: U1.26 ((T1)PD6)
MCURST: P5.6, P6.5 (TRST), R14.1, S1.2, U1.13 (RESET\)
MISO: P5.5, P6.1 (MISO), U1.11 ((PD0/PCINT3/MISO)PB3)
unnamed: C2.1, U1.6 (UCap)
unnamed: C5.1, U1.42 (AREF)
unnamed: R3.1, U3.6 (I/O1B)
unnamed: R4.1, U3.1 (I/O2B)
RGBDIN: P4.5, U1.12 ((PCINT7/OC.0A/OC.1C)PB7)
RGBDOUT: P4.4
ROW1: U1.32 ((IC.3/CLK0)PC7)
ROW2: U1.31 ((OC.3A)PC6)
ROW3: U1.1 (PE6(INT.6/AIN.0))
ROW4: U1.41 (PF0(ADC0))
ROW5: U1.40 (PF1(ADC1))
ROW6: U1.8 ((PCINT0/SS)PB0)
SHDGND: P1.6, P1_2.6
USB_D+: R3.2, U1.4 (D+)
USB_D-: R4.2, U1.3 (D-)
VSS: C1.2, C2.2, C3.2, C4.2, C5.2, C6.2, C7.2, C9.2, C13.2, C14.2, C22.2, C23.2, JP1.2, JP1.3, P1.5, P1_2.5, P5.2, P6.6 (GND), R1.1, S1.3, S1.4, S2.2 (C), U1.5 (UGnd), U1.15 (GND), U1.23 (AGND), U1.35 (GND), U1.43 (AGND), U3.2 (GND), X1.2, X1.4
VUSB: F1.1, P1.1, P1_2.1, P4.3
XTAL1: C14.1, U1.17 (XTAL1), X1.3
XTAL2: C13.1, U1.16 (XTAL2), X1.1

Notes on the sheet:
USB Circuit
ISP Tag Connect
Crystal
MCU RESET
Debug headers
Microcontroller
HWBE Jumper
Decoupling capacitors
Rotary Encoder (Optional)
