MaiTheSan/PCB-Design/KiCad/07-2021/Stabtester/Stabtester/Stabtester.sch

## KiCad design KiCad/07-2021/Stabtester/Stabtester/Stabtester.sch (2022-11-19)

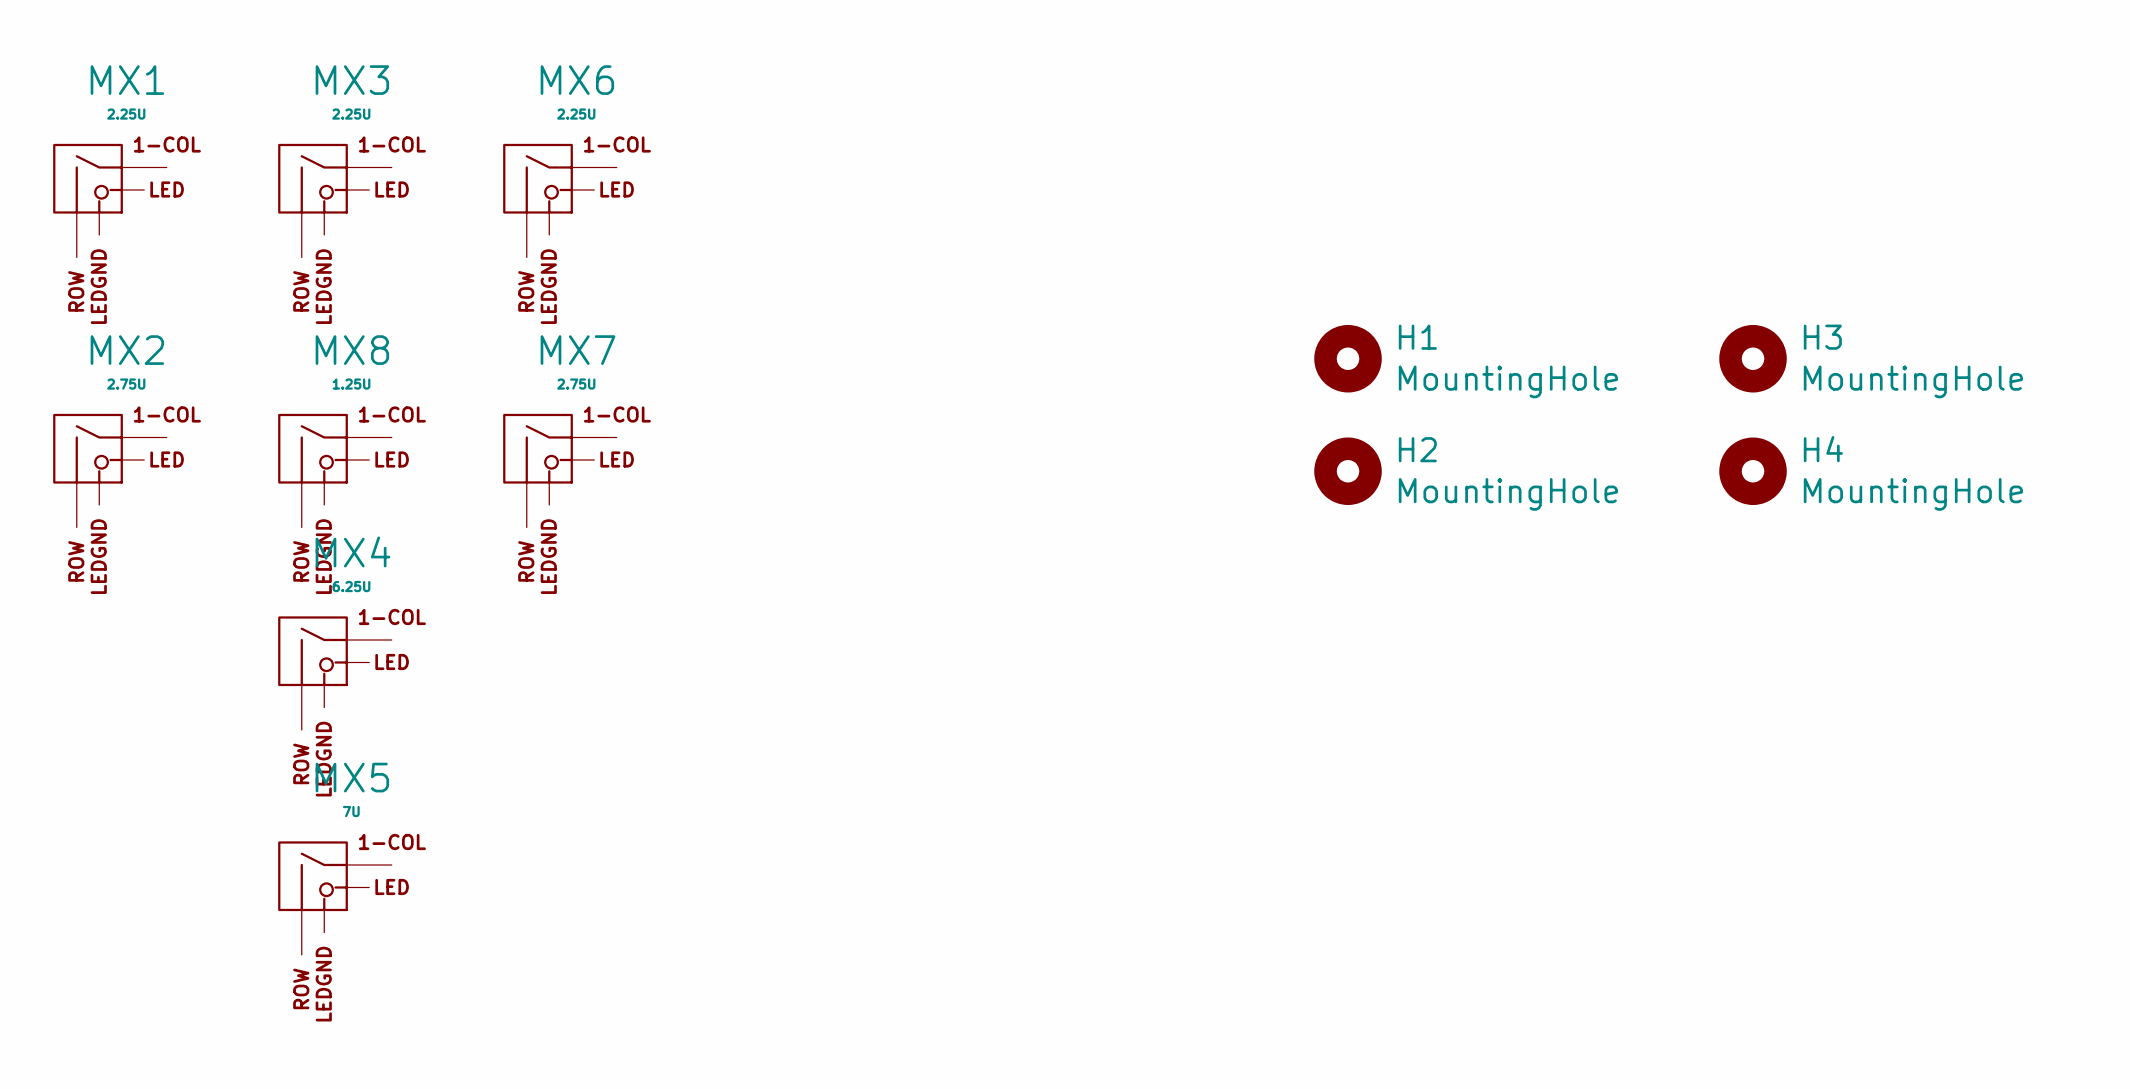
[picture p225: schematic Stabtester.sch]

Parts:
H1, H2, H3, H4: MountingHole; MountingHole_2.2mm_M2_Pad_Via
MX1, MX3, MX6: 2.25U; MXOnly-2.25U-Hotswap-ReversedStabilizers
MX2, MX7: 2.75U; MXOnly-2.75U-Hotswap-ReversedStabilizers
MX4: 6.25U; MXOnly-6.25U-Hotswap-ReversedStabilizers
MX5: 7U; MXOnly-7U-Hotswap-ReversedStabilizers
MX8: 1.25U; MXOnly-1.25U-Hotswap
