MaiTheSan/PCB-Design/KiCad/08-2021/hmmm/pcb/bakeneko-60-pcb.sch

## KiCad design KiCad/08-2021/hmmm/pcb/bakeneko-60-pcb.sch (2022-11-19)

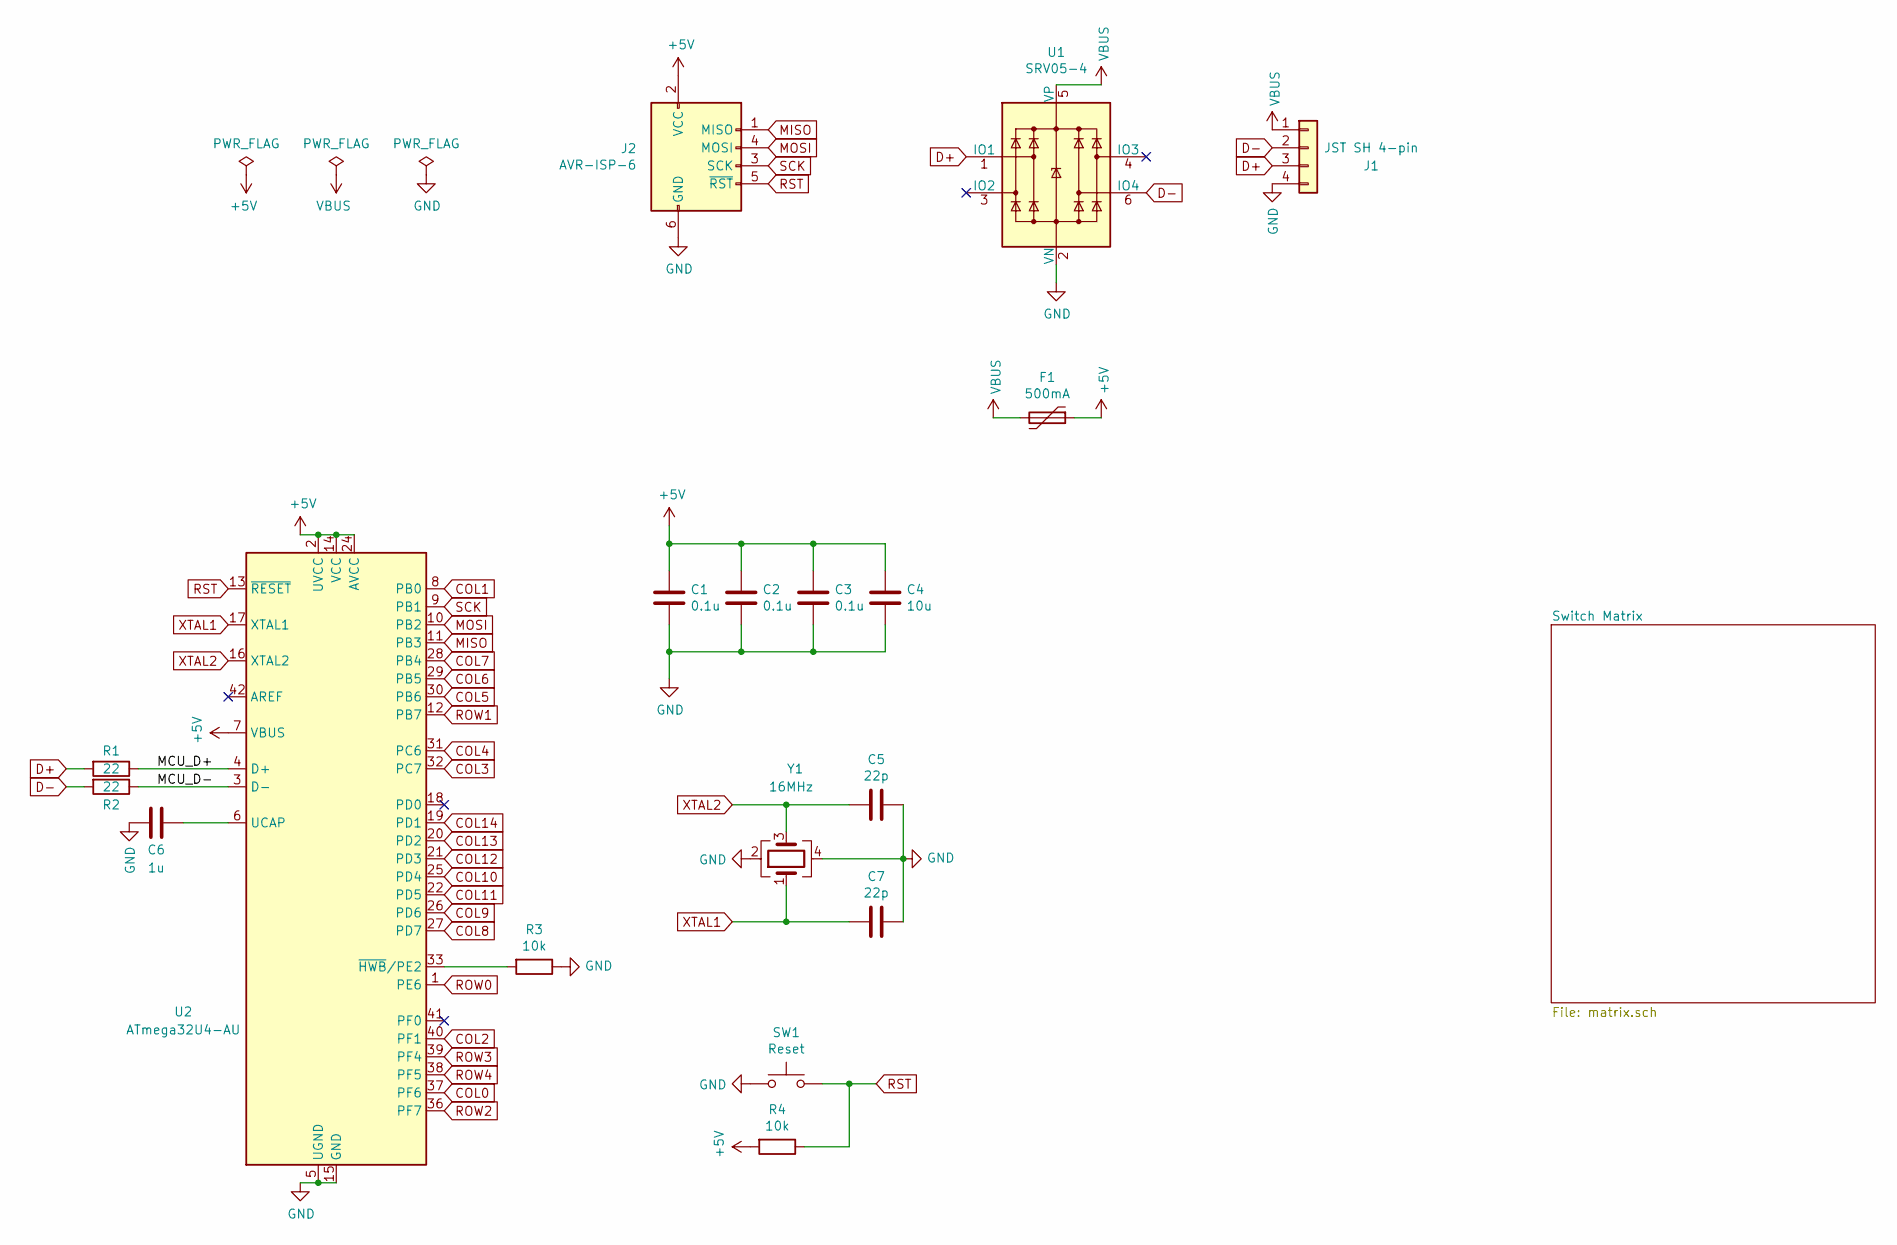
[picture p226: schematic bakeneko-60-pcb.sch]

Parts:
C1, C2, C3: 0.1u; C_0805_2012Metric; LCSC Part # C49678
C4: 10u; C_0805_2012Metric; LCSC Part # C15850
C5, C7: 22p; C_0805_2012Metric; LCSC Part # C1804
C6: 1u; C_0805_2012Metric; LCSC Part # C28323
F1: 500mA; Fuse_1206_3216Metric; LCSC Part # C70076
J1: JST SH 4-pin; JST_SH_SM04B-SRSS-TB_1x04-1MP_P1.00mm_Horizontal; LCSC Part # C160404
J2: AVR-ISP-6; Reset_Pretty
R1, R2: 22; R_0805_2012Metric; LCSC Part # C17561
R3, R4: 10k; R_0805_2012Metric; LCSC Part # C17414
SW1: Reset; SW_SPST_TL3342; LCSC Part # C318884
U1: SRV05-4; SOT-23-6; LCSC Part # C85364
U2: ATmega32U4-AU; TQFP-44_10x10mm_P0.8mm; LCSC Part # C44854
Y1: 16MHz; Crystal_SMD_3225-4Pin_3.2x2.5mm; LCSC Part # C13738

Connections:
+5V: C1.1, C2.1, C3.1, C4.1, F1.1, J2.2 (VCC), R4.2, U2.2 (UVCC), U2.7 (VBUS), U2.14 (VCC), U2.24 (AVCC), U2.34 (VCC), U2.44 (AVCC)
COL0: U2.37 (PF6)
COL1: U2.8 (PB0)
COL2: U2.40 (PF1)
COL3: U2.32 (PC7)
COL4: U2.31 (PC6)
COL5: U2.30 (PB6)
COL6: U2.29 (PB5)
COL7: U2.28 (PB4)
COL8: U2.27 (PD7)
COL9: U2.26 (PD6)
COL10: U2.25 (PD4)
COL11: U2.22 (PD5)
COL12: U2.21 (PD3)
COL13: U2.20 (PD2)
COL14: U2.19 (PD1)
D+: J1.3, R1.2, U1.1 (IO1)
D-: J1.2, R2.2, U1.6 (IO4)
GND: C1.2, C2.2, C3.2, C4.2, C5.1, C6.2, C7.1, J1.4, J2.6 (GND), R3.1, SW1.1, U1.2 (VN), U2.5 (UGND), U2.15 (GND), U2.23 (GND), U2.35 (GND), U2.43 (GND), Y1.2, Y1.4
MCU_D+: R1.1, U2.4 (D+)
MCU_D-: R2.1, U2.3 (D-)
MISO: J2.1 (MISO), U2.11 (PB3)
MOSI: J2.4 (MOSI), U2.10 (PB2)
unnamed: C6.1, U2.6 (UCAP)
unnamed: R3.2, U2.33 (~HWB~/PE2)
ROW0: U2.1 (PE6)
ROW1: U2.12 (PB7)
ROW2: U2.36 (PF7)
ROW3: U2.39 (PF4)
ROW4: U2.38 (PF5)
RST: J2.5 (~RST), R4.1, SW1.2, U2.13 (~RESET)
SCK: J2.3 (SCK), U2.9 (PB1)
VBUS: F1.2, J1.1, U1.5 (VP)
XTAL1: C7.2, U2.17 (XTAL1), Y1.1
XTAL2: C5.2, U2.16 (XTAL2), Y1.3
