MaiTheSan/PCB-Design/KiCad/08-2021/hmmm/pcb/matrix.sch

## KiCad design KiCad/08-2021/hmmm/pcb/matrix.sch (2022-11-19)

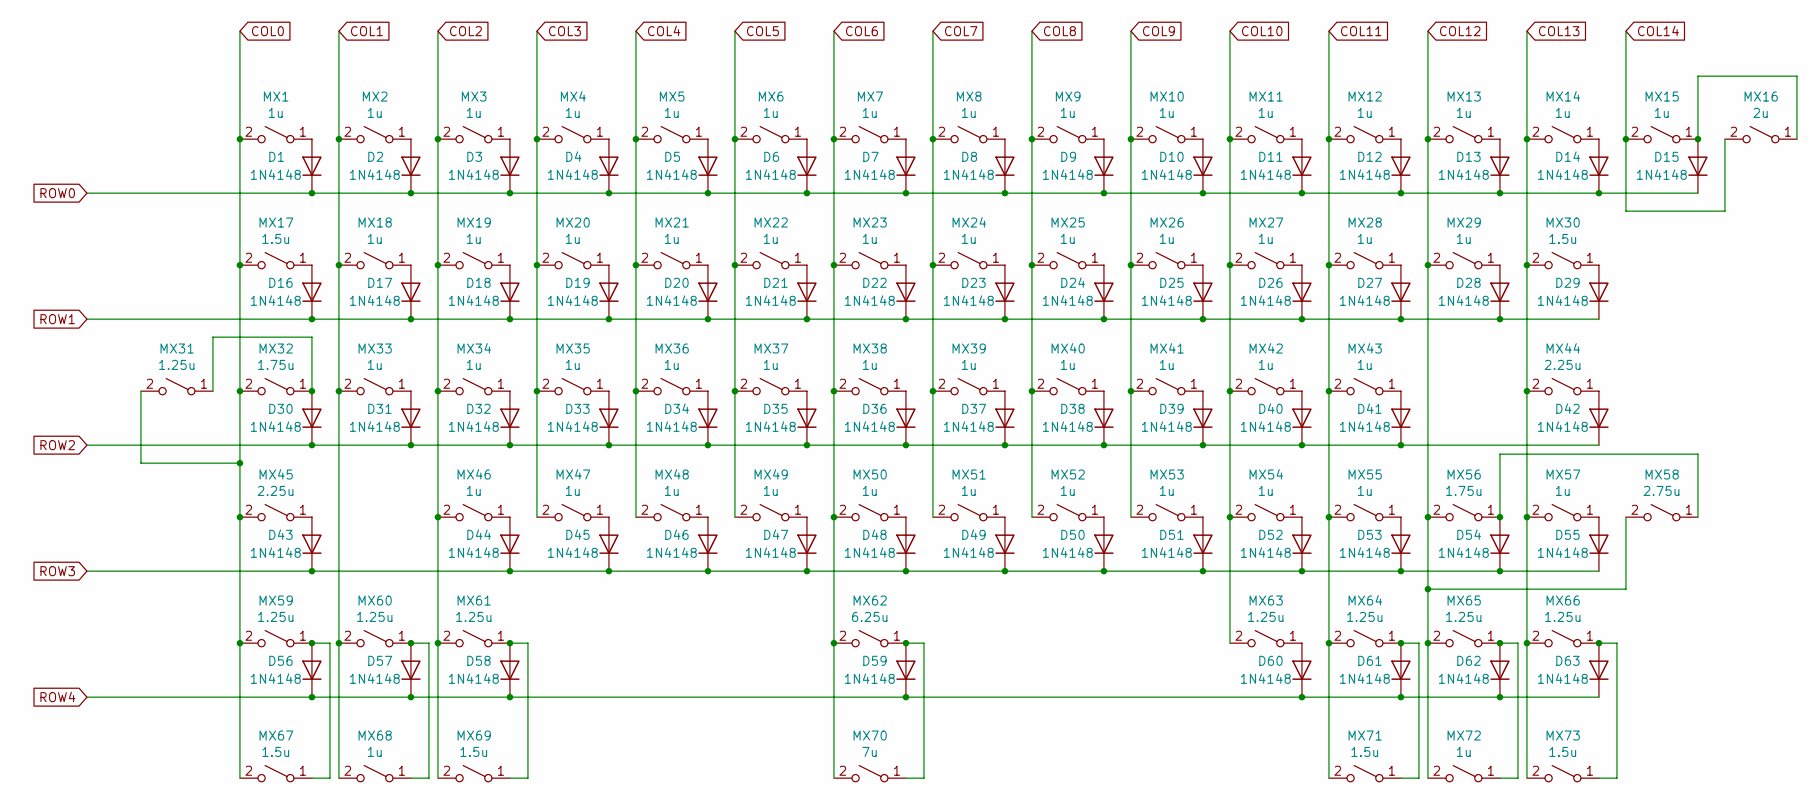
[picture p227: schematic matrix.sch]

Parts:
D1, D2, D3, D4, D5, D6, D7, D8, D9, D10, D11, D12, D13, D14, D15, D16, D17, D18, D19, D20, D21, D22, D23, D24, D25, D26, D27, D28, D29, D30, D31, D32, D33, D34, D35, D36, D37, D38, D39, D40, D41, D42, D43, D44, D45, D46, D47, D48, D49, D50, D51, D52, D53, D54, D55, D56, D57, D58, D59, D60, D61, D62, D63: 1N4148; D_SOD-123; LCSC Part # C81598
MX1, MX2, MX3, MX4, MX5, MX6, MX7, MX8, MX9, MX10, MX11, MX12, MX13, MX14, MX15, MX18, MX19, MX20, MX21, MX22, MX23, MX24, MX25, MX26, MX27, MX28, MX29, MX33, MX34, MX35, MX36, MX37, MX38, MX39, MX40, MX41, MX42, MX43, MX46, MX47, MX48, MX49, MX50, MX51, MX52, MX53, MX54, MX55, MX57, MX68, MX72: 1u; MXOnly-1U-NoLED
MX16: 2u; MXOnly-2U-NoLED
MX17, MX30, MX67, MX69, MX71, MX73: 1.5u; MXOnly-1.5U-NoLED
MX31, MX59, MX60, MX61, MX63, MX64, MX65, MX66: 1.25u; MXOnly-1.25U-NoLED
MX32, MX56: 1.75u; MXOnly-1.75U-NoLED
MX44, MX45: 2.25u; MXOnly-2.25U-NoLED
MX58: 2.75u; MXOnly-2.75U-NoLED
MX62: 6.25u; MXOnly-6.25U-ReversedStabilizers-NoLED
MX70: 7u; MXOnly-7U-ReversedStabilizers-NoLED

Connections:
COL0: MX1.2 (B), MX17.2 (B), MX31.2 (B), MX32.2 (B), MX45.2 (B), MX59.2 (B), MX67.2 (B)
COL1: MX2.2 (B), MX18.2 (B), MX33.2 (B), MX60.2 (B), MX68.2 (B)
COL2: MX3.2 (B), MX19.2 (B), MX34.2 (B), MX46.2 (B), MX61.2 (B), MX69.2 (B)
COL3: MX4.2 (B), MX20.2 (B), MX35.2 (B), MX47.2 (B)
COL4: MX5.2 (B), MX21.2 (B), MX36.2 (B), MX48.2 (B)
COL5: MX6.2 (B), MX22.2 (B), MX37.2 (B), MX49.2 (B)
COL6: MX7.2 (B), MX23.2 (B), MX38.2 (B), MX50.2 (B), MX62.2 (B), MX70.2 (B)
COL7: MX8.2 (B), MX24.2 (B), MX39.2 (B), MX51.2 (B)
COL8: MX9.2 (B), MX25.2 (B), MX40.2 (B), MX52.2 (B)
COL9: MX10.2 (B), MX26.2 (B), MX41.2 (B), MX53.2 (B)
COL10: MX11.2 (B), MX27.2 (B), MX42.2 (B), MX54.2 (B), MX63.2 (B)
COL11: MX12.2 (B), MX28.2 (B), MX43.2 (B), MX55.2 (B), MX64.2 (B), MX71.2 (B)
COL12: MX13.2 (B), MX29.2 (B), MX56.2 (B), MX58.2 (B), MX65.2 (B), MX72.2 (B)
COL13: MX14.2 (B), MX30.2 (B), MX44.2 (B), MX57.2 (B), MX66.2 (B), MX73.2 (B)
COL14: MX15.2 (B), MX16.2 (B)
unnamed: D1.2 (A), MX1.1 (A)
unnamed: D2.2 (A), MX2.1 (A)
unnamed: D3.2 (A), MX3.1 (A)
unnamed: D4.2 (A), MX4.1 (A)
unnamed: D5.2 (A), MX5.1 (A)
unnamed: D6.2 (A), MX6.1 (A)
unnamed: D7.2 (A), MX7.1 (A)
unnamed: D8.2 (A), MX8.1 (A)
unnamed: D9.2 (A), MX9.1 (A)
unnamed: D10.2 (A), MX10.1 (A)
unnamed: D11.2 (A), MX11.1 (A)
unnamed: D12.2 (A), MX12.1 (A)
unnamed: D13.2 (A), MX13.1 (A)
unnamed: D14.2 (A), MX14.1 (A)
unnamed: D15.2 (A), MX15.1 (A), MX16.1 (A)
unnamed: D16.2 (A), MX17.1 (A)
unnamed: D17.2 (A), MX18.1 (A)
unnamed: D18.2 (A), MX19.1 (A)
unnamed: D19.2 (A), MX20.1 (A)
unnamed: D20.2 (A), MX21.1 (A)
unnamed: D21.2 (A), MX22.1 (A)
unnamed: D22.2 (A), MX23.1 (A)
unnamed: D23.2 (A), MX24.1 (A)
unnamed: D24.2 (A), MX25.1 (A)
unnamed: D25.2 (A), MX26.1 (A)
unnamed: D26.2 (A), MX27.1 (A)
unnamed: D27.2 (A), MX28.1 (A)
unnamed: D28.2 (A), MX29.1 (A)
unnamed: D29.2 (A), MX30.1 (A)
unnamed: D30.2 (A), MX31.1 (A), MX32.1 (A)
unnamed: D31.2 (A), MX33.1 (A)
unnamed: D32.2 (A), MX34.1 (A)
unnamed: D33.2 (A), MX35.1 (A)
unnamed: D34.2 (A), MX36.1 (A)
unnamed: D35.2 (A), MX37.1 (A)
unnamed: D36.2 (A), MX38.1 (A)
unnamed: D37.2 (A), MX39.1 (A)
unnamed: D38.2 (A), MX40.1 (A)
unnamed: D39.2 (A), MX41.1 (A)
unnamed: D40.2 (A), MX42.1 (A)
unnamed: D41.2 (A), MX43.1 (A)
unnamed: D42.2 (A), MX44.1 (A)
unnamed: D43.2 (A), MX45.1 (A)
unnamed: D44.2 (A), MX46.1 (A)
unnamed: D45.2 (A), MX47.1 (A)
unnamed: D46.2 (A), MX48.1 (A)
unnamed: D47.2 (A), MX49.1 (A)
unnamed: D48.2 (A), MX50.1 (A)
unnamed: D49.2 (A), MX51.1 (A)
unnamed: D50.2 (A), MX52.1 (A)
unnamed: D51.2 (A), MX53.1 (A)
unnamed: D52.2 (A), MX54.1 (A)
unnamed: D53.2 (A), MX55.1 (A)
unnamed: D54.2 (A), MX56.1 (A), MX58.1 (A)
unnamed: D55.2 (A), MX57.1 (A)
unnamed: D56.2 (A), MX59.1 (A), MX67.1 (A)
unnamed: D57.2 (A), MX60.1 (A), MX68.1 (A)
unnamed: D58.2 (A), MX61.1 (A), MX69.1 (A)
unnamed: D59.2 (A), MX62.1 (A), MX70.1 (A)
unnamed: D60.2 (A), MX63.1 (A)
unnamed: D61.2 (A), MX64.1 (A), MX71.1 (A)
unnamed: D62.2 (A), MX65.1 (A), MX72.1 (A)
unnamed: D63.2 (A), MX66.1 (A), MX73.1 (A)
ROW0: D1.1 (K), D2.1 (K), D3.1 (K), D4.1 (K), D5.1 (K), D6.1 (K), D7.1 (K), D8.1 (K), D9.1 (K), D10.1 (K), D11.1 (K), D12.1 (K), D13.1 (K), D14.1 (K), D15.1 (K)
ROW1: D16.1 (K), D17.1 (K), D18.1 (K), D19.1 (K), D20.1 (K), D21.1 (K), D22.1 (K), D23.1 (K), D24.1 (K), D25.1 (K), D26.1 (K), D27.1 (K), D28.1 (K), D29.1 (K)
ROW2: D30.1 (K), D31.1 (K), D32.1 (K), D33.1 (K), D34.1 (K), D35.1 (K), D36.1 (K), D37.1 (K), D38.1 (K), D39.1 (K), D40.1 (K), D41.1 (K), D42.1 (K)
ROW3: D43.1 (K), D44.1 (K), D45.1 (K), D46.1 (K), D47.1 (K), D48.1 (K), D49.1 (K), D50.1 (K), D51.1 (K), D52.1 (K), D53.1 (K), D54.1 (K), D55.1 (K)
ROW4: D56.1 (K), D57.1 (K), D58.1 (K), D59.1 (K), D60.1 (K), D61.1 (K), D62.1 (K), D63.1 (K)
