MaiTheSan/PCB-Design/KiCad/08-2021/hmmm/plain60-flex-edition-master/plain60-flex-edition.kicad_sch

## KiCad design KiCad/08-2021/hmmm/plain60-flex-edition-master/plain60-flex-edition.kicad_sch (2022-11-19)

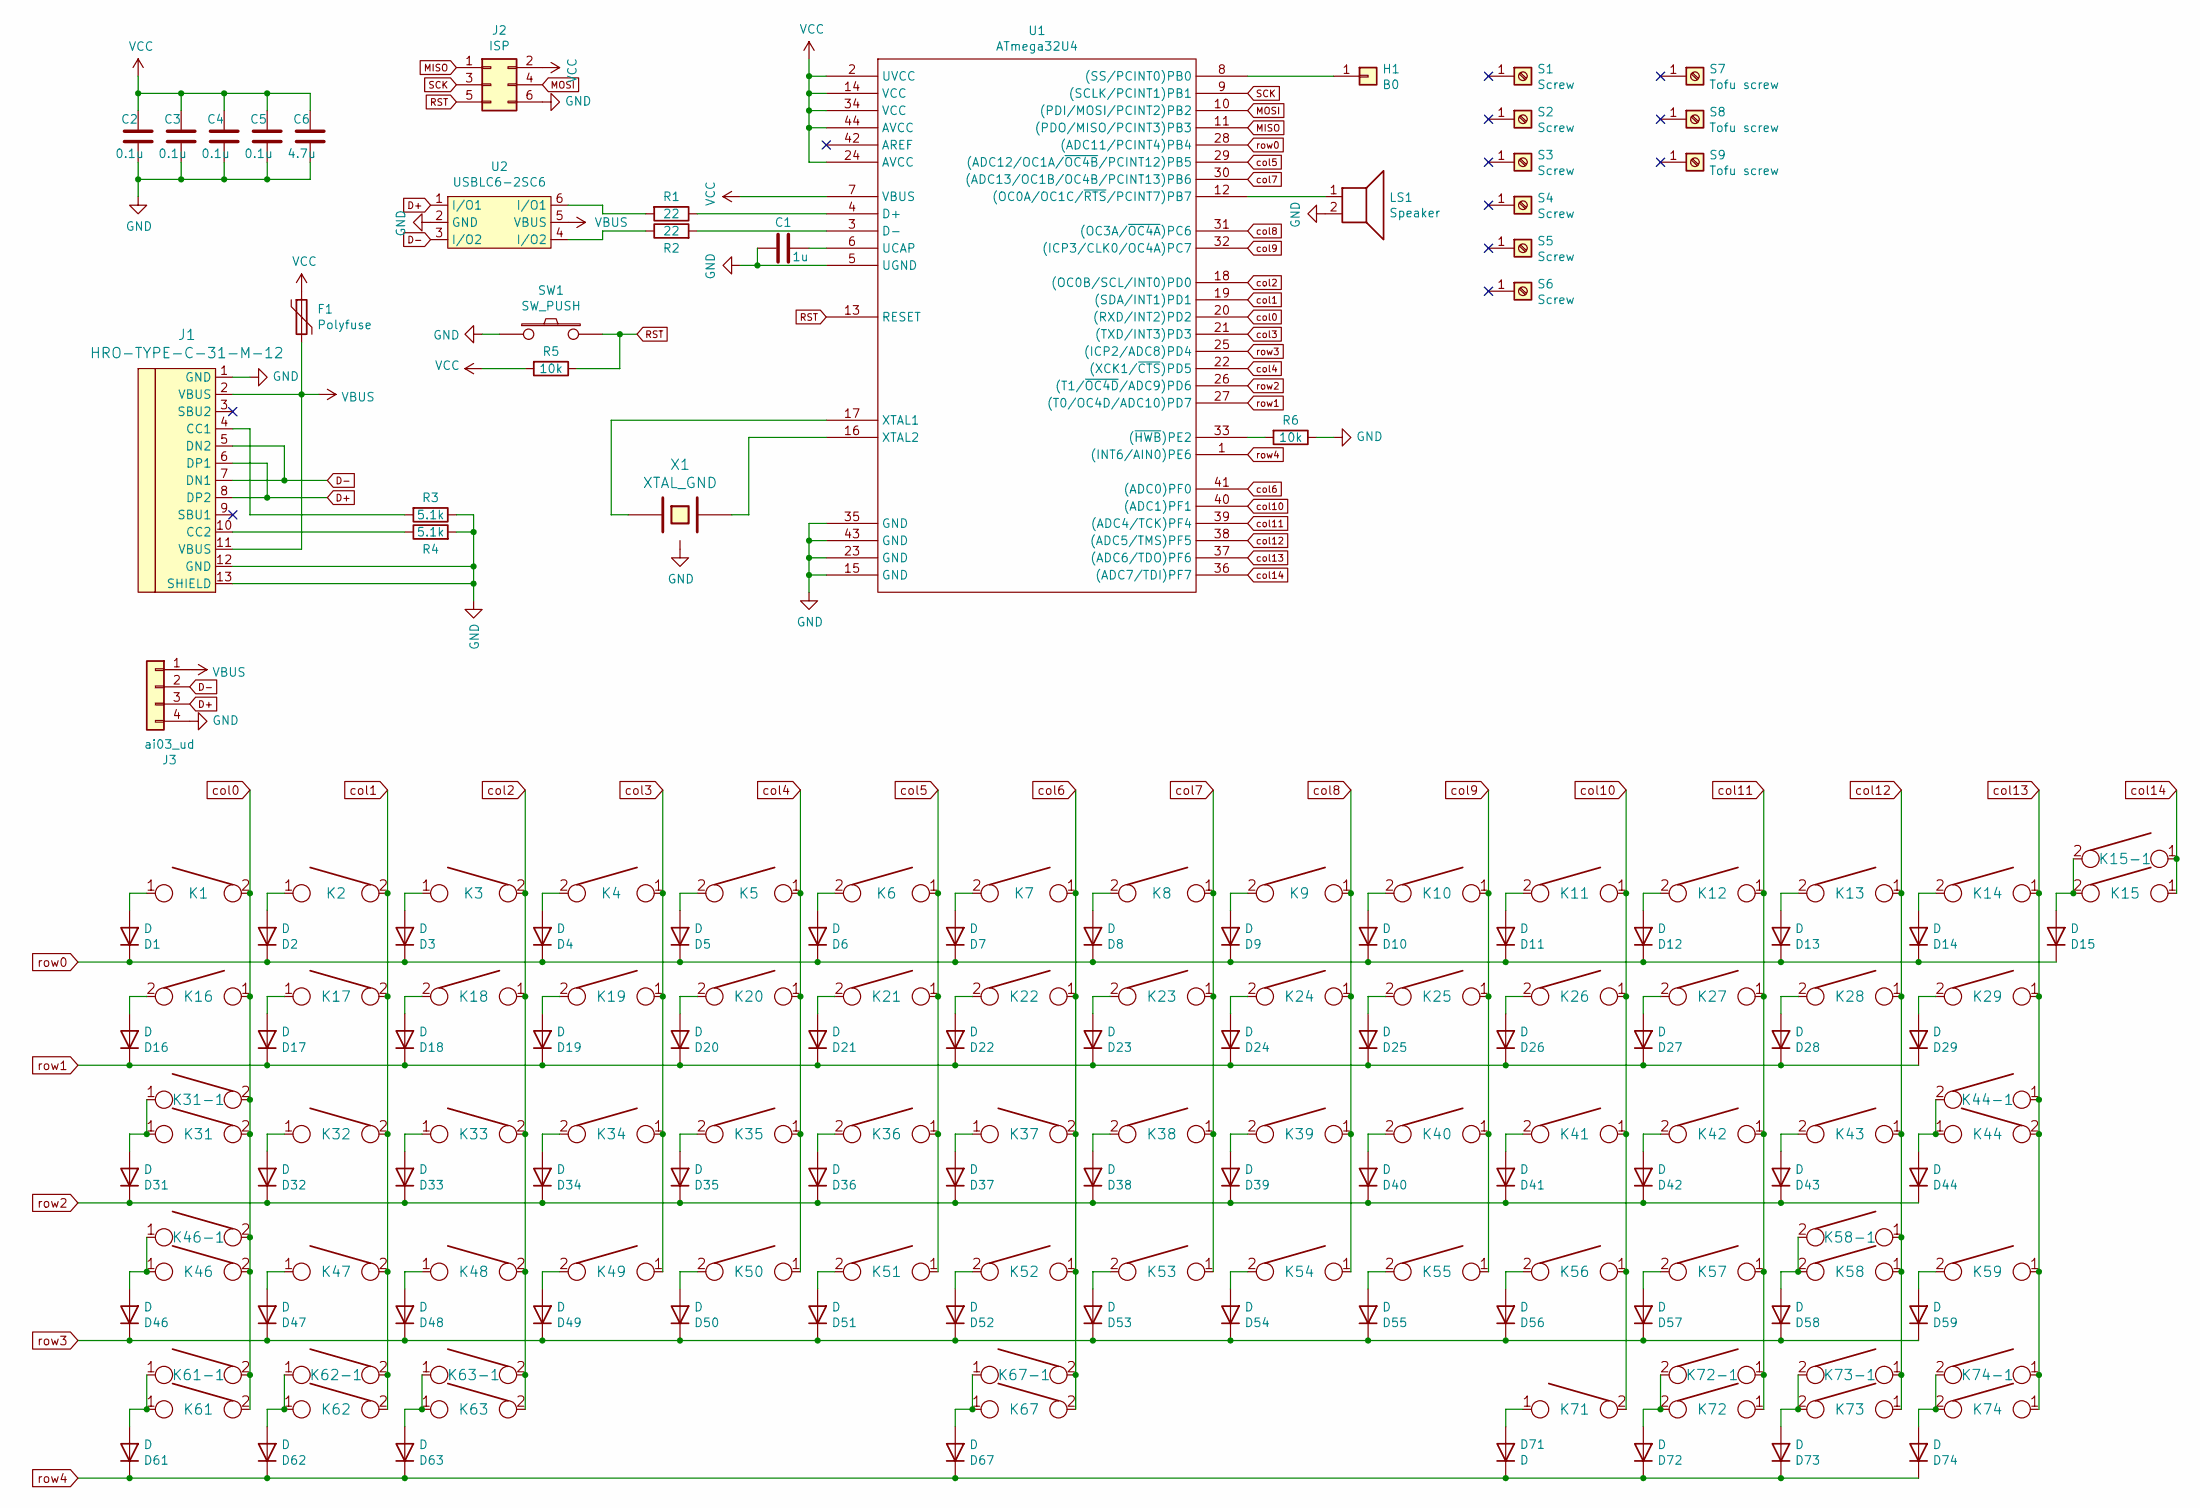
[picture p228: schematic plain60-flex-edition.kicad_sch]

Parts:
C1: 1u; C_0805
C2, C3, C4, C5: 0.1u; C_0805
C6: 4.7u; C_0805
D1, D2, D3, D4, D5, D6, D7, D8, D9, D10, D11, D12, D13, D14, D15, D16, D17, D18, D19, D20, D21, D22, D23, D24, D25, D26, D27, D28, D29, D31, D32, D33, D34, D35, D36, D37, D38, D39, D40, D41, D42, D43, D44, D46, D47, D48, D49, D50, D51, D52, D53, D54, D55, D56, D57, D58, D59, D61, D62, D63, D67, D71, D72, D73, D74: D; D_0805
F1: Polyfuse; R_0805
H1: B0; free_pin
J1: HRO-TYPE-C-31-M-12
J2: ISP; isp_standard
J3: ai03_ud; JST_SH_SM04B-SRSS-TB_1x04-1MP_P1.00mm_Horizontal
K1, K2, K3, K4, K5, K6, K7, K8, K9, K10, K11, K12, K13, K14, K15-1, K17, K18, K19, K20, K21, K22, K23, K24, K25, K26, K27, K28, K32, K33, K34, K35, K36, K37, K38, K39, K40, K41, K42, K43, K47, K48, K49, K50, K51, K52, K53, K54, K55, K56, K57, K59, K62-1, K73-1: KEYSW; CHERRY_PLATE_100H
K15: KEYSW; CHERRY_PCB_200H
K16, K29, K61-1, K63-1, K72-1, K74-1: KEYSW; CHERRY_PLATE_150H
K31, K58-1: KEYSW; CHERRY_PLATE_175H
K31-1, K46-1, K61, K62, K63, K71, K72, K73, K74: KEYSW; CHERRY_PLATE_125H
K44: KEYSW; CHERRY_PCB_225H_F
K44-1: KEYSW; CHERRY_PCB_200H_V
K46: KEYSW; CHERRY_PCB_225H
K58: KEYSW; CHERRY_PCB_275H
K67: KEYSW; CHERRY_PCB_625H_F
K67-1: KEYSW; CHERRY_PCB_700H_F
LS1: Speaker; speaker_AST1109MLTRQ
R1, R2: 22; R_0805
R3, R4: 5.1k; R_0805
R5, R6: 10k; R_0805
S1, S2, S3, S6: Screw; 5.5_5x2.5mm
S4, S5: Screw; 10x5_7x2.5mm
S7, S8, S9: Tofu screw; 5.5_5x2.5mm
SW1: SW_PUSH; SW_SPST_TL3342
U1: ATmega32U4; ATMEGA32U4
U2: USBLC6-2SC6; Farnell 1295310
X1: XTAL_GND; Resonator_SMD_muRata_CSTNExxV-3Pin-p1.2

Connections:
D+: J1.6 (DP1), J1.8 (DP2), J3.3, U2.1 (I/O1)
D-: J1.5 (DN2), J1.7 (DN1), J3.2, U2.3 (I/O2)
GND: C1.2, C2.1, C3.1, C4.1, C5.1, C6.1, J1.1 (GND), J1.12 (GND), J1.13 (SHIELD), J2.6, J3.4, LS1.2, R3.1, R4.2, R6.1, SW1.1, U1.5 (UGND), U1.15 (GND), U1.23 (GND), U1.35 (GND), U1.43 (GND), U2.2 (GND), X1.3
MISO: J2.1, U1.11 ((PDO/MISO/PCINT3)PB3)
MOSI: J2.4, U1.10 ((PDI/MOSI/PCINT2)PB2)
unnamed: C1.1, U1.6 (UCAP)
unnamed: D1.2 (A), K1.1
unnamed: D2.2 (A), K2.1
unnamed: D3.2 (A), K3.1
unnamed: D4.2 (A), K4.2
unnamed: D5.2 (A), K5.2
unnamed: D6.2 (A), K6.2
unnamed: D7.2 (A), K7.2
unnamed: D8.2 (A), K8.2
unnamed: D9.2 (A), K9.2
unnamed: D10.2 (A), K10.2
unnamed: D11.2 (A), K11.2
unnamed: D12.2 (A), K12.2
unnamed: D13.2 (A), K13.2
unnamed: D14.2 (A), K14.2
unnamed: D15.2 (A), K15.2, K15-1.2
unnamed: D16.2 (A), K16.2
unnamed: D17.2 (A), K17.1
unnamed: D18.2 (A), K18.2
unnamed: D19.2 (A), K19.2
unnamed: D20.2 (A), K20.2
unnamed: D21.2 (A), K21.2
unnamed: D22.2 (A), K22.2
unnamed: D23.2 (A), K23.2
unnamed: D24.2 (A), K24.2
unnamed: D25.2 (A), K25.2
unnamed: D26.2 (A), K26.2
unnamed: D27.2 (A), K27.2
unnamed: D28.2 (A), K28.2
unnamed: D29.2 (A), K29.2
unnamed: D31.2 (A), K31.1, K31-1.1
unnamed: D32.2 (A), K32.1
unnamed: D33.2 (A), K33.1
unnamed: D34.2 (A), K34.2
unnamed: D35.2 (A), K35.2
unnamed: D36.2 (A), K36.2
unnamed: D37.2 (A), K37.1
unnamed: D38.2 (A), K38.2
unnamed: D39.2 (A), K39.2
unnamed: D40.2 (A), K40.2
unnamed: D41.2 (A), K41.2
unnamed: D42.2 (A), K42.2
unnamed: D43.2 (A), K43.2
unnamed: D44.2 (A), K44.1, K44-1.2
unnamed: D46.2 (A), K46.1, K46-1.1
unnamed: D47.2 (A), K47.1
unnamed: D48.2 (A), K48.1
unnamed: D49.2 (A), K49.2
unnamed: D50.2 (A), K50.2
unnamed: D51.2 (A), K51.2
unnamed: D52.2 (A), K52.2
unnamed: D53.2 (A), K53.2
unnamed: D54.2 (A), K54.2
unnamed: D55.2 (A), K55.2
unnamed: D56.2 (A), K56.2
unnamed: D57.2 (A), K57.2
unnamed: D58.2 (A), K58.2, K58-1.2
unnamed: D59.2 (A), K59.2
unnamed: D61.2 (A), K61.1, K61-1.1
unnamed: D62.2 (A), K62.1, K62-1.1
unnamed: D63.2 (A), K63.1, K63-1.1
unnamed: D67.2 (A), K67.1, K67-1.1
unnamed: D71.2 (A), K71.1
unnamed: D72.2 (A), K72.2, K72-1.2
unnamed: D73.2 (A), K73.2, K73-1.2
unnamed: D74.2 (A), K74.2, K74-1.2
unnamed: H1.1, U1.8 ((SS/PCINT0)PB0)
unnamed: J1.4 (CC1), R3.2
unnamed: J1.10 (CC2), R4.1
unnamed: LS1.1, U1.12 ((OC0A/OC1C/~RTS~/PCINT7)PB7)
unnamed: R1.1, U1.4 (D+)
unnamed: R1.2, U2.6 (I/O1)
unnamed: R2.1, U2.4 (I/O2)
unnamed: R2.2, U1.3 (D-)
unnamed: R6.2, U1.33 ((~HWB~)PE2)
unnamed: U1.16 (XTAL2), X1.2
unnamed: U1.17 (XTAL1), X1.1
RST: J2.5, R5.1, SW1.2, U1.13 (RESET)
SCK: J2.3, U1.9 ((SCLK/PCINT1)PB1)
VBUS: F1.2, J1.2 (VBUS), J1.11 (VBUS), J3.1, U2.5 (VBUS)
VCC: C2.2, C3.2, C4.2, C5.2, C6.2, F1.1, J2.2, R5.2, U1.2 (UVCC), U1.7 (VBUS), U1.14 (VCC), U1.24 (AVCC), U1.34 (VCC), U1.44 (AVCC)
col0: K1.2, K16.1, K31.2, K31-1.2, K46.2, K46-1.2, K61.2, K61-1.2, U1.20 ((RXD/INT2)PD2)
col1: K2.2, K17.2, K32.2, K47.2, K62.2, K62-1.2, U1.19 ((SDA/INT1)PD1)
col2: K3.2, K18.1, K33.2, K48.2, K63.2, K63-1.2, U1.18 ((OC0B/SCL/INT0)PD0)
col3: K4.1, K19.1, K34.1, K49.1, U1.21 ((TXD/INT3)PD3)
col4: K5.1, K20.1, K35.1, K50.1, U1.22 ((XCK1/~CTS~)PD5)
col5: K6.1, K21.1, K36.1, K51.1, U1.29 ((ADC12/OC1A/~OC4B~/PCINT12)PB5)
col6: K7.1, K22.1, K37.2, K52.1, K67.2, K67-1.2, U1.41 ((ADC0)PF0)
col7: K8.1, K23.1, K38.1, K53.1, U1.30 ((ADC13/OC1B/OC4B/PCINT13)PB6)
col8: K9.1, K24.1, K39.1, K54.1, U1.31 ((OC3A/~OC4A~)PC6)
col9: K10.1, K25.1, K40.1, K55.1, U1.32 ((ICP3/CLK0/OC4A)PC7)
col10: K11.1, K26.1, K41.1, K56.1, K71.2, U1.40 ((ADC1)PF1)
col11: K12.1, K27.1, K42.1, K57.1, K72.1, K72-1.1, U1.39 ((ADC4/TCK)PF4)
col12: K13.1, K28.1, K43.1, K58.1, K58-1.1, K73.1, K73-1.1, U1.38 ((ADC5/TMS)PF5)
col13: K14.1, K29.1, K44.2, K44-1.1, K59.1, K74.1, K74-1.1, U1.37 ((ADC6/TDO)PF6)
col14: K15.1, K15-1.1, U1.36 ((ADC7/TDI)PF7)
row0: D1.1 (K), D2.1 (K), D3.1 (K), D4.1 (K), D5.1 (K), D6.1 (K), D7.1 (K), D8.1 (K), D9.1 (K), D10.1 (K), D11.1 (K), D12.1 (K), D13.1 (K), D14.1 (K), D15.1 (K), U1.28 ((ADC11/PCINT4)PB4)
row1: D16.1 (K), D17.1 (K), D18.1 (K), D19.1 (K), D20.1 (K), D21.1 (K), D22.1 (K), D23.1 (K), D24.1 (K), D25.1 (K), D26.1 (K), D27.1 (K), D28.1 (K), D29.1 (K), U1.27 ((T0/OC4D/ADC10)PD7)
row2: D31.1 (K), D32.1 (K), D33.1 (K), D34.1 (K), D35.1 (K), D36.1 (K), D37.1 (K), D38.1 (K), D39.1 (K), D40.1 (K), D41.1 (K), D42.1 (K), D43.1 (K), D44.1 (K), U1.26 ((T1/~OC4D~/ADC9)PD6)
row3: D46.1 (K), D47.1 (K), D48.1 (K), D49.1 (K), D50.1 (K), D51.1 (K), D52.1 (K), D53.1 (K), D54.1 (K), D55.1 (K), D56.1 (K), D57.1 (K), D58.1 (K), D59.1 (K), U1.25 ((ICP2/ADC8)PD4)
row4: D61.1 (K), D62.1 (K), D63.1 (K), D67.1 (K), D71.1 (K), D72.1 (K), D73.1 (K), D74.1 (K), U1.1 ((INT6/AIN0)PE6)
