MaiTheSan/PCB-Design/KiCad/11-2021/SIGMA/SIGMA/SIGMA.sch

## KiCad design KiCad/11-2021/SIGMA/SIGMA/SIGMA.sch (2022-11-19)

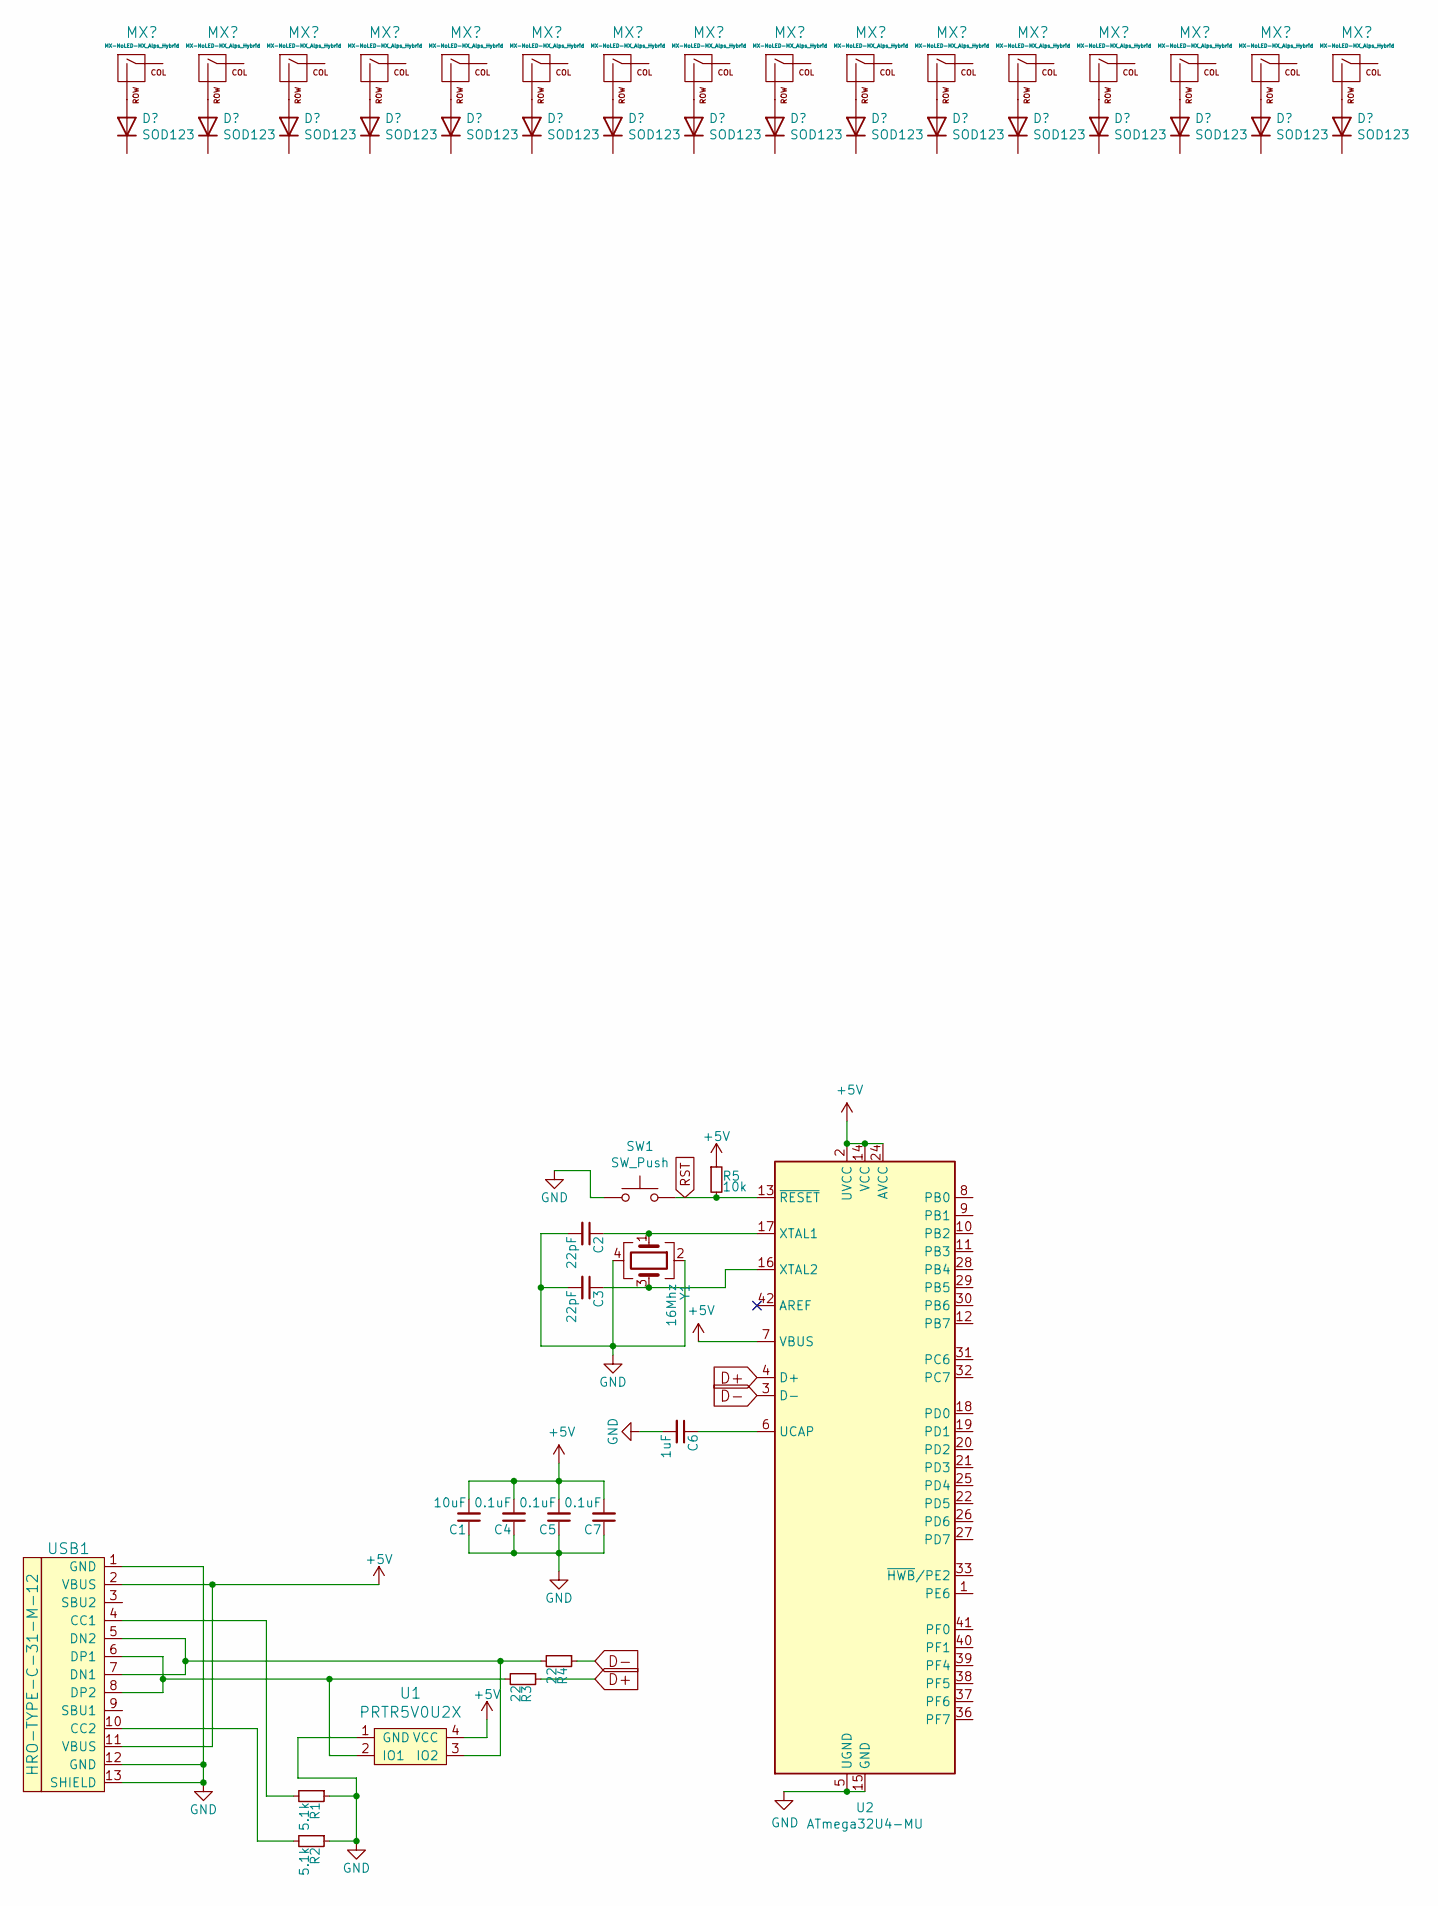
[picture p229: schematic SIGMA.sch]

Parts:
C1: 10uF; C_0603
C2, C3: 22pF; C_0603
C4, C5, C7: 0.1uF; C_0603
C6: 1uF; C_0603
R1, R2: 5.1k; R_0805
R3, R4: 22; R_0805
R5: 10k; R_0805
SW1: SW_Push; SKQG-1155865
U1: PRTR5V0U2X; SOT143B
U2: ATmega32U4-MU; QFN-44-1EP_7x7mm_P0.5mm_EP5.2x5.2mm_ThermalVias
USB1: HRO-TYPE-C-31-M-12; HRO-TYPE-C-31-M-12-Assembly
Y1: 16Mhz; Crystal_SMD_3225-4Pin_3.2x2.5mm

Connections:
+5V: C1.2, C4.2, C5.2, C7.2, R5.1, U1.4 (VCC), U2.2 (UVCC), U2.7 (VBUS), U2.14 (VCC), U2.24 (AVCC), U2.34 (VCC), U2.44 (AVCC), USB1.2 (VBUS), USB1.11 (VBUS)
D+: R3.1, U2.4 (D+)
D-: R4.1, U2.3 (D-)
GND: C1.1, C2.2, C3.2, C4.1, C5.1, C6.2, C7.1, R1.1, R2.1, SW1.1, U1.1 (GND), U2.5 (UGND), U2.15 (GND), U2.23 (GND), U2.35 (GND), U2.43 (GND), U2.45 (GND), USB1.1 (GND), USB1.12 (GND), USB1.13 (SHIELD), Y1.2, Y1.4
unnamed: C2.1, U2.17 (XTAL1), Y1.1
unnamed: C3.1, U2.16 (XTAL2), Y1.3
unnamed: C6.1, U2.6 (UCAP)
unnamed: R1.2, USB1.4 (CC1)
unnamed: R2.2, USB1.10 (CC2)
unnamed: R3.2, U1.2 (IO1), USB1.6 (DP1), USB1.8 (DP2)
unnamed: R4.2, U1.3 (IO2), USB1.5 (DN2), USB1.7 (DN1)
RST: R5.2, SW1.2, U2.13 (~RESET)
