MaiTheSan/PCB-Design/KiCad/Early 2021/Alice/SawnsProjectAlice/SawnsProjectAlice.sch

## KiCad design KiCad/Early 2021/Alice/SawnsProjectAlice/SawnsProjectAlice.sch (2022-11-19)

Schematic: SawnsProjectAlice.sch

Parts:
C2: 10uF; C_0603
C3, C4, C5: 0.1uF; C_0603
C6: 1uF; C_0603
C7, C8: 22pF; C_0603
D1, D2, D3, D4, D5, D6, D7, D8, D9, D10, D11, D12, D13, D14, D15, D16, D17, D18, D19, D20, D21, D22, D23, D24, D25, D26, D27, D28, D29, D30, D31, D32, D33, D34, D35, D36, D37, D38, D39, D40, D41, D42, D43, D44, D45, D46, D47, D48, D49, D50, D51, D52, D53, D54, D55, D56, D57, D58, D59, D60, D61, D62, D63, D64, D65, D66, D67, D68: SOD_123; D_SOD-123-Pretty
D69, D71, D72, D73, D74, D75, D76, D77, D78, D79, D80, D81, D82, D83, D84, D85, D86, D87, D88, D89, D90, D91, D92, D93, D94, D95, D96, D97, D98, D99, D100, D101, D102, D103, D104, D105, D106, D107, D108, D109, D110, D111, D112, D113, D114, D115, D116, D117, D118, D119, D120, D121, D122, D123, D124, D125, D126, D127, D128, D129, D130, D131, D132, D133, D134, D135, D136: WS2812B; RGB-6028
F1: 500mA; Fuse_SMD1206_Reflow
K_0, K_1, K_2, K_3, K_4, K_5, K_6, K_7, K_8, K_9, K_.1: 1U; MXOnly-1U-NoLED
K_'1: 1U; MXOnly-1U-NoLED
K_+1: 1U; MXOnly-1U-NoLED
K_,1: 1U; MXOnly-1U-NoLED
K_-_1: 1U; MXOnly-1U-NoLED
K_/?/1: 1U; MXOnly-1U-NoLED
K_;1: 1U; MXOnly-1U-NoLED
K_A1: 1U; MXOnly-1U-NoLED
K_Alt1: 1.25U; MXOnly-1.25U-NoLED
K_B1: 1U; MXOnly-1U-NoLED
K_BkSp1: 1U; MXOnly-1U-NoLED
K_BkSp2: 2U; MXOnly-2U-ReversedStabilizers-NoLED
K_C1: 1U; MXOnly-1U-NoLED
K_CapLk1, K_CapLk2: MX-1U-MX_Alps_Hybrids; MXOnly-1U-NoLED
K_D1: 1U; MXOnly-1U-NoLED
K_Delete1: 1U; MXOnly-1U-NoLED
K_E1: 1U; MXOnly-1U-NoLED
K_ESC1: 1U; MXOnly-1U-NoLED
K_Enter1: 2.25U; MXOnly-2.25U-NoLED
K_F1: 1U; MXOnly-1U-NoLED
K_FN1: 1U; MXOnly-1U-NoLED
K_G1: 1U; MXOnly-1U-NoLED
K_H1: 1U; MXOnly-1U-NoLED
K_I1: 1U; MXOnly-1U-NoLED
K_J1: 1U; MXOnly-1U-NoLED
K_K1: 1U; MXOnly-1U-NoLED
K_L1: 1U; MXOnly-1U-NoLED
K_LControl1: 1.5U; MXOnly-1.5U-NoLED
K_LShift1: MX-1U-MX_Alps_Hybrids; MXOnly-2.25U-ReversedStabilizers-NoLED
K_LWin1: 1.25U; MXOnly-1.25U-NoLED
K_LWin2: 1U; MXOnly-1U-NoLED
K_M1: 1U; MXOnly-1U-NoLED
K_N1: 1U; MXOnly-1U-NoLED
K_O1: 1U; MXOnly-1U-NoLED
K_P1: 1U; MXOnly-1U-NoLED
K_PgDn1: 1U; MXOnly-1U-NoLED
K_PgUp1: 1U; MXOnly-1U-NoLED
K_Q1: 1U; MXOnly-1U-NoLED
K_R1: 1U; MXOnly-1U-NoLED
K_RShift1: 1.75U; MXOnly-1.75U-NoLED
K_RShift2: 2.75U; MXOnly-2.75U-ReversedStabilizers-NoLED
K_RWin1: 1U; MXOnly-1U-NoLED
K_RWin2: 1.25U; MXOnly-1.25U-NoLED
K_S1: 1U; MXOnly-1U-NoLED
K_T1: 1U; MXOnly-1U-NoLED
K_Tab1: 1.5U; MXOnly-1.5U-NoLED
K_U1: 1U; MXOnly-1U-NoLED
K_V1: 1U; MXOnly-1U-NoLED
K_W1: 1U; MXOnly-1U-NoLED
K_X1: 1U; MXOnly-1U-NoLED
K_Y1: 1U; MXOnly-1U-NoLED
K_Z1: 1U; MXOnly-1U-NoLED
K_]}1: 1U; MXOnly-1U-NoLED
K_`1: 1U; MXOnly-1U-NoLED
K_xn1: 1U; MXOnly-1U-NoLED
K_{[1: 1U; MXOnly-1U-NoLED
K_|\1: 1.5U; MXOnly-1.5U-NoLED
MX1, MX1_1: 2U; MXOnly-2U-NoLED
MX2, MX2_1, MX4: MX-1U-MX_Alps_Hybrids; MXOnly-1U-NoLED
MX3: 2.75U; MXOnly-2.75U-NoLED
MX5: 1.5U; MXOnly-1.5U-NoLED
Q1: 2N7002; SOT-23
R67, R68: 22; R_0805
R69, R71: 1k; R_0805
R70: 10k; R_0805
R73, R74: 5.1k; R_0805
SW1: 5.2x5.2mm; SKQG-1155865
U1: ATmega32U4-AU; TQFP-44_10x10mm_P0.8mm
U2: PRTR5V0U2X; SOT143B
U3: STF202-22T1G; Reset_Pretty
USB1: HRO-TYPE-C-31-M-12; HRO-TYPE-C-31-M-12-Assembly
Y1: 16Mhz; Crystal_SMD_3225-4Pin_3.2x2.5mm
