MaiTheSan/PCB-Design/KiCad/Early 2021/Alice/colorlice/SawnsProjectAlice.sch

## KiCad design KiCad/Early 2021/Alice/colorlice/SawnsProjectAlice.sch (2022-11-19)

Schematic: SawnsProjectAlice.sch

Parts:
C2: 10uF; SMD-0402
C3, C4, C5: 0.1uF; SMD-0402
C6: 1uF; SMD-0402
C7, C8: 22pF; SMD-0402
D1, D2, D3, D4, D5, D6, D7, D8, D9, D10, D11, D12, D13, D15, D16, D17, D18, D19, D20, D21, D22, D23, D24, D25, D26, D27, D28, D29, D30, D31, D32, D33, D34, D35, D36, D37, D38, D39, D40, D41, D42, D43, D44, D45, D46, D47, D48, D49, D50, D51, D52, D53, D54, D55, D56, D57, D58, D59, D60, D61, D63, D64, D65, D66, D67, D68: SOD_123; D_SOD-323_HandSoldering
K_0, K_1, K_2, K_3, K_4, K_5, K_6, K_7, K_8, K_9, K_.1: 1U; MXOnly-1U-NoLED
K_'1: 1U; MXOnly-1U-NoLED
K_+1: 1U; MXOnly-1U-NoLED
K_,1: 1U; MXOnly-1U-NoLED
K_-_1: 1U; MXOnly-1U-NoLED
K_/?/1: 1U; MXOnly-1U-NoLED
K_;1: 1U; MXOnly-1U-NoLED
K_A1: 1U; MXOnly-1U-NoLED
K_Alt1: 1.25U; MXOnly-1.25U-NoLED
K_B1: 1U; MXOnly-1U-NoLED
K_BkSp1: 1U; MXOnly-1U-NoLED
K_BkSp2: 2U_FL; MXOnly-2U-NoLED
K_C1: 1U; MXOnly-1U-NoLED
K_CapLk1, K_CapLk2: MX-1U-MX_Alps_Hybrids; MXOnly-1U-NoLED
K_D1: 1U; MXOnly-1U-NoLED
K_Delete1: 1U; MXOnly-1U-NoLED
K_E1: 1U; MXOnly-1U-NoLED
K_ESC1: 1U; MXOnly-1U-NoLED
K_Enter1: 2.25U; MXOnly-2.25U-ReversedStabilizers-NoLED
K_F1: 1U; MXOnly-1U-NoLED
K_FN1: 1U; MXOnly-1U-NoLED
K_G1: 1U; MXOnly-1U-NoLED
K_H1: 1U; MXOnly-1U-NoLED
K_I1: 1U; MXOnly-1U-NoLED
K_J1: 1U; MXOnly-1U-NoLED
K_K1: 1U; MXOnly-1U-NoLED
K_L1: 1U; MXOnly-1U-NoLED
K_LControl1: 1.5U; MXOnly-1.5U-NoLED
K_LShift1: MX-1U-MX_Alps_Hybrids; MXOnly-2.25U-NoLED
K_M1: 1U; MXOnly-1U-NoLED
K_N1: 1U; MXOnly-1U-NoLED
K_O1: 1U; MXOnly-1U-NoLED
K_P1: 1U; MXOnly-1U-NoLED
K_PgDn1: 1U; MXOnly-1U-NoLED
K_PgUp1: 1U; MXOnly-1U-NoLED
K_Q1: 1U; MXOnly-1U-NoLED
K_R1: 1U; MXOnly-1U-NoLED
K_RSHIFT3: 1U; MXOnly-1U-NoLED
K_RShift1: 1.75U; MXOnly-1.75U-NoLED
K_RShift2: 2.75U; MXOnly-2.75U-NoLED
K_S1: 1U; MXOnly-1U-NoLED
K_T1: 1U; MXOnly-1U-NoLED
K_Tab1: 1.5U; MXOnly-1.5U-NoLED
K_U1: 1U; MXOnly-1U-NoLED
K_V1: 1U; MXOnly-1U-NoLED
K_W1: 1U; MXOnly-1U-NoLED
K_X1: 1U; MXOnly-1U-NoLED
K_Y1: 1U; MXOnly-1U-NoLED
K_Z1: 1U; MXOnly-1U-NoLED
K_]}1: 1U; MXOnly-1U-NoLED
K_`1: 1U; MXOnly-1U-NoLED
K_{[1: 1U; MXOnly-1U-NoLED
K_|\1: 1.5U; MXOnly-1.5U-NoLED
LED1, LED2, LED3: LED; LED_D3.0mm
MX1, MX1_1: 2U; MXOnly-2U-ReversedStabilizers-NoLED
MX2, MX2_1, MX4: MX-1U-MX_Alps_Hybrids; MXOnly-1U-NoLED
MX3: 2.75U; MXOnly-2.75U-ReversedStabilizers-NoLED
MX5: 1.5U; MXOnly-1.5U-NoLED
R1: 500; R_0805
R2, R3, R4: 300; R_0805
R67, R68: 22; R_0805
R70: 10k; R_0805
R71: 1k; R_0805
R73, R74: 5.1k; R_0805
RGB1, RGB2, RGB3, RGB4, RGB5, RGB6, RGB7, RGB8, RGB9, RGB10, RGB11, RGB12, RGB13, RGB14, RGB15: WS2812B_F; RGB-6028
RGB_FL1, RGB_FL2, RGB_FL3, RGB_FL4, RGB_FL5, RGB_FL6, RGB_FL7, RGB_FL8, RGB_FL9, RGB_FL10, RGB_FL11, RGB_FL12, RGB_FL13, RGB_FL14, RGB_FL15, RGB_FL16, RGB_FL17: WS2812B; RGB-6028_FLIPPED
RGB_FLS1, RGB_FLS2, RGB_FLS3, RGB_FLS4, RGB_FLS5: WS2812B; RGB-6028_FLIPPED
RGB_FLS6, RGB_FLS7: WS2812B_S; RGB-6028_FLIPPED
RGB_FLX1, RGB_FLX2, RGB_FLX3, RGB_FLX4, RGB_FLX5, RGB_FLX6, RGB_FLX7: WS2812B; RGB-6028_FLIPPED
RGB_FLX8, RGB_FLX9, RGB_FLX10, RGB_FLX11, RGB_FLX12, RGB_FLX13, RGB_FLX14: WS2812B_F; RGB-6028_FLIPPED
RGB_S1, RGB_S2, RGB_S3, RGB_S4, RGB_S5, RGB_S6, RGB_S7, RGB_S8, RGB_S9, RGB_S10, RGB_S11, RGB_S12, RGB_S13, RGB_S14, RGB_S15, RGB_S16, RGB_S17, RGB_S18, RGB_S19, RGB_S20, RGB_S21, RGB_S22, RGB_S23: WS2812B_S; LED_SK6812MINI_PLCC4_3.5x3.5mm_P1.75mm
RGB_X1, RGB_X2, RGB_X3, RGB_X4, RGB_X5, RGB_X6, RGB_X7, RGB_X8, RGB_X9, RGB_X10, RGB_X11, RGB_X12, RGB_X13, RGB_X14, RGB_X15: WS2812B; RGB-6028
SW1: 5.2x5.2mm; SKQG-1155865
U1: ATmega32U4-AU; TQFP-44_10x10mm_P0.8mm
U2: PRTR5V0U2X; SOT143B
U3, U4: STF202-22T1G; Reset_Pretty
U5: ATmega32U4-MU; QFN-44-1EP_7x7mm_P0.5mm_EP5.2x5.2mm
USB1: HRO-TYPE-C-31-M-12; HRO-TYPE-C-31-M-12-Assembly
Y1: 16Mhz; Crystal_SMD_3225-4Pin_3.2x2.5mm
