MaiTheSan/PCB-Design/KiCad/Early 2021/EV65 from vyg60/108 test/108 test.sch

## KiCad design KiCad/Early 2021/EV65 from vyg60/108 test/108 test.sch (2022-11-19)

Schematic: 108 test.sch

Parts:
D1, D2, D3, D4, D5, D6, D7, D8, D9, D10, D11, D12, D13, D14, D15, D16, D17, D18, D19, D20, D21, D22, D23, D24, D25, D26, D27, D28, D29, D30, D31, D32, D33, D34, D35, D36, D37, D38, D39, D40, D41, D42, D43, D44, D45, D46, D47, D48, D49, D50, D51, D52, D53, D54, D55, D56, D57, D58, D59, D60, D61, D62, D63, D64, D65, D66, D67, D68, D69, D70, D71, D72, D73, D74, D75, D76, D77, D78, D79, D80, D81, D82, D83, D84, D85, D86, D87, D88, D89, D90, D91, D92, D93, D94, D95, D96, D97, D98, D99, D100, D101, D102, D103, D104, D105, D106, D107, D108, D109, D110: SOD-123; D_SOD-123
K_0: MX 2U; MXOnly-2U-FLIPPED
K_0x1, K_1, K_2, K_3, K_4, K_5, K_6, K_7, K_8, K_9: MX 1U; MXOnly-1U
K_'"1: MX 1U; MXOnly-1U
K_*1: MX 1U; MXOnly-1U
K_+1: MX 1U; MXOnly-1U
K_+2: MX 2U; MXOnly-2U
K_-1, K_-2: MX 1U; MXOnly-1U
K_/1: MX 1U; MXOnly-1U
K_/?/1: MX 1U; MXOnly-1U
K_:;1: MX 1U; MXOnly-1U
K_<1: MX 1U; MXOnly-1U
K_>1: MX 1U; MXOnly-1U
K_A1: MX 1U; MXOnly-1U
K_B1: MX 1U; MXOnly-1U
K_BkSp1: MX 2U; MXOnly-2U
K_C1: MX 1U; MXOnly-1U
K_CapLk1: MX 1.25U; MXOnly-1.25U
K_CapLk2: MX 1.75U; MXOnly-1.75U-FLIPPED
K_D1: MX 1U; MXOnly-1U
K_Del1: MX 1U; MXOnly-1U-FLIPPED
K_Delete1: MX 1U; MXOnly-1U
K_Down1: MX 1U; MXOnly-1U
K_E1: MX 1U; MXOnly-1U
K_ESC1: MX 1U; MXOnly-1U
K_End1: MX 1U; MXOnly-1U
K_Enter1: MX 2.25U; MXOnly-2.25U
K_Enter2: MX 2U; MXOnly-2U
K_F1, K_F2, K_F3, K_F4, K_F5, K_F6, K_F7, K_F8, K_F9, K_F10, K_F11, K_F12, K_F13: MX 1U; MXOnly-1U
K_FN5: MX 1.25U; MXOnly-1.25U
K_Fn1, K_Fn2, K_Fn3, K_Fn4: MX 1U; MXOnly-1U
K_G1: MX 1U; MXOnly-1U
K_H1: MX 1U; MXOnly-1U
K_Home1: MX 1U; MXOnly-1U
K_I1: MX 1U; MXOnly-1U
K_Ins1: MX 1U; MXOnly-1U
K_J1: MX 1U; MXOnly-1U
K_K1: MX 1U; MXOnly-1U
K_L1: MX 1U; MXOnly-1U
K_Left1: MX 1U; MXOnly-1U
K_LeftAlt1: MX 1.25U; MXOnly-1.25U
K_LeftControl1: MX 1.25U; MXOnly-1.25U
K_LeftShift1: MX 2.25U; MXOnly-2.25U
K_LeftWin1: MX 1.25U; MXOnly-1.25U
K_Lock1: MX 1U; MXOnly-1U
K_M1: MX 1U; MXOnly-1U
K_Menu1: MX 1.25U; MXOnly-1.25U
K_N1: MX 1U; MXOnly-1U
K_Num1, K_Num2, K_Num3, K_Num4, K_Num5, K_Num6, K_Num7, K_Num8, K_Num9: MX 1U; MXOnly-1U
K_NumLk1: MX 1U; MXOnly-1U
K_O1: MX 1U; MXOnly-1U
K_P1: MX 1U; MXOnly-1U
K_Pause1: MX 1U; MXOnly-1U
K_PgDn1: MX 1U; MXOnly-1U
K_PgUp1: MX 1U; MXOnly-1U
K_PrtSc1: MX 1U; MXOnly-1U
K_Q1: MX 1U; MXOnly-1U
K_R1: MX 1U; MXOnly-1U
K_Right1: MX 1U; MXOnly-1U
K_RightAlt1: MX 1.25U; MXOnly-1.25U
K_RightControl1: MX 1.25U; MXOnly-1.25U
K_RightShift1: MX 2.75U; MXOnly-2.75U
K_S1: MX 1U; MXOnly-1U
K_ScLk1: MX 1U; MXOnly-1U
K_Sleep1: MX 1U; MXOnly-1U
K_Space1: MX 6.25U; MXOnly-6.25U
K_T1: MX 1U; MXOnly-1U
K_Tab1: MX 1.5U; MXOnly-1.5U
K_U1: MX 1U; MXOnly-1U
K_Up1: MX 1U; MXOnly-1U
K_V1: MX 1U; MXOnly-1U
K_W1: MX 1U; MXOnly-1U
K_X1: MX 1U; MXOnly-1U
K_Y1: MX 1U; MXOnly-1U
K_Z1: MX 1U; MXOnly-1U
K_[{1: MX 1U; MXOnly-1U
K_\|1: MX 1.5U; MXOnly-1.5U
K_`1: MX 1U; MXOnly-1U
K_}]1: MX 1U; MXOnly-1U
Q1: 2N7002; SOT-23
R1, R79, R88: 300; R_0805
R2, R3, R4, R5, R6, R7, R8, R9, R10, R11, R12, R13, R14, R15, R16, R17, R18, R19, R20, R21, R22, R23, R24, R25, R26, R27, R28, R29, R30, R31, R32, R33, R34, R35, R36, R37, R38, R39, R40, R41, R42, R43, R44, R45, R46, R47, R48, R49, R50, R51, R52, R53, R54, R55, R56, R57, R58, R59, R60, R61, R62, R63, R64, R65, R66, R67, R68, R69, R70, R71, R72, R73, R74, R75, R76, R77, R78, R80, R81, R82, R83, R84, R85, R86, R87, R89, R90, R91, R92, R93, R94, R95, R96, R97, R98, R99, R100, R101, R102, R103, R104, R105, R106, R107, R108, R110, R111: 1k; R_0805
R109: 1.5k; R_0805
U1: Teensy++2.0_(C); Teensy2.0++
