MaiTheSan/PCB-Design/KiCad/Early 2021/Learning PCB drawing/Học vẽ mạch cùng anh Sắn/Học vẽ mạch cùng anh Sắn.sch

## KiCad design KiCad/Early 2021/Learning PCB drawing/Học vẽ mạch cùng anh Sắn/Học vẽ mạch cùng anh Sắn.sch (2022-11-19)

Schematic: Học vẽ mạch cùng anh Sắn.sch

Parts:
D1, D2, D3, D4: LED
R1, R2, R3, R4: 280
U1: ATmega32U4-MU; QFN-44-1EP_7x7mm_P0.5mm_EP5.2x5.2mm
Y1: Crystal_GND24; Crystal_SMD_3225-4Pin_3.2x2.5mm
