MaiTheSan/PCB-Design/KiCad/Early 2021/TKL - Fullsize/TKL - Fullsize Project/Voyager104.sch

## KiCad design KiCad/Early 2021/TKL - Fullsize/TKL - Fullsize Project/Voyager104.sch (2022-11-19)

Schematic: Voyager104.sch

Parts:
C2, C5: 1uF; C_0603
C3, C4: 22pF; C_0603
C6, C7, C8: 0.1uF; C_0603
J1: AVR-ISP-6; Reset_Pretty-Mask
J2: SM04B-SRSS-TB(LF)(SN); JST-SR-4; Manufacturer Part No SM04B-SRSS-TB(LF)(SN); LCSC Part No C160404
Q1: DSS60601MZ4-13; SOT-223-3_TabPin2
RC3: 10k; R_0603
RC4: 1k; R_0603
RC5: 1.5k; R_0603
SW1: SW_Push; SKQG-1155865
U1: AT90USB1286-AU; QFN-64-1EP_9x9mm_Pitch0.5mm
Y1: 16MHz; Crystal_SMD_3225-4pin_3.2x2.5mm
