MaiTheSan/PCB-Design/KiCad/Early 2021/lmai pcb/mạch chưa có tên/mạch chưa có tên.sch

## KiCad design KiCad/Early 2021/lmai pcb/mạch chưa có tên/mạch chưa có tên.sch (2022-11-19)

Schematic: mạch chưa có tên.sch

Parts:
C1, C9: 22pF; C_0603
C3: >=2.2uF; CP_EIA-3216-12_Kemet-S
C10, C12, C13, C14, C16: 0.1uF; C_0402_1005Metric
C11: 10uF; C_0603
C15: 10nF; C_0402_1005Metric
C17: 1uF; C_0603
C19: 470pF; C_0402_1005Metric
D1, D2, D3, D4, D5, D6, D7, D8, D9, D10, D11, D12, D13, D14, D15, D16, D17, D18, D19, D20, D21, D22, D23, D24, D25, D26, D27, D28, D29, D30, D31, D32, D33, D34, D35, D36, D37, D38, D39, D40, D41, D42, D43, D44, D45, D46, D47, D48, D49, D50, D51, D52, D53, D54, D55, D56, D57, D58, D59, D60, D61, D63, D64, D65, D66, D67, D68: SOD_123; D_SOD-123
D62, D69, D70, D71, D72, D73, D74, D75, D76, D77, D78, D79, D80, D81, D82: SK6812MINI; LED_SK6812MINI_PLCC4_3.5x3.5mm_P1.75mm
K_0, K_1, K_2, K_3, K_4, K_5, K_6, K_7, K_8, K_9, K_.1: 1U; MXOnly-1U-NoLED
K_'1: 1U; MXOnly-1U-NoLED
K_+1: 1U; MXOnly-1U-NoLED
K_,1: 1U; MXOnly-1U-NoLED
K_-_1: 1U; MXOnly-1U-NoLED
K_/?/1: 1U; MXOnly-1U-NoLED
K_;1: 1U; MXOnly-1U-NoLED
K_A1: 1U; MXOnly-1U-NoLED
K_Alt1: 1.25U; MXOnly-1.25U-NoLED
K_B1: 1U; MXOnly-1U-NoLED
K_BkSp2: 2U_FL; MXOnly-2U-ReversedStabilizers-NoLED
K_C1: 1U; MXOnly-1U-NoLED
K_CapLk1: MX-1U-MX_Alps_Hybrids; MXOnly-1.75U-NoLED
K_CapLk2: MX-1U-MX_Alps_Hybrids; MXOnly-1.25U-NoLED
K_D1: 1U; MXOnly-1U-NoLED
K_Delete1: 1U; MXOnly-1U-NoLED
K_E1: 1U; MXOnly-1U-NoLED
K_ESC1: 1U; MXOnly-1U-NoLED
K_Enter1: 2.25U; MXOnly-2.25U-ReversedStabilizers-NoLED
K_F1: 1U; MXOnly-1U-NoLED
K_FN1: 1U; MXOnly-1U-NoLED
K_G1: 1U; MXOnly-1U-NoLED
K_H1: 1U; MXOnly-1U-NoLED
K_I1: 1U; MXOnly-1U-NoLED
K_J1: 1U; MXOnly-1U-NoLED
K_K1: 1U; MXOnly-1U-NoLED
K_L1: 1U; MXOnly-1U-NoLED
K_LControl1: 1.5U; MXOnly-1.25U-NoLED
K_LShift1: MX-1U-MX_Alps_Hybrids; MXOnly-2.25U-ReversedStabilizers-NoLED
K_M1: 1U; MXOnly-1U-NoLED
K_N1: 1U; MXOnly-1U-NoLED
K_O1: 1U; MXOnly-1U-NoLED
K_P1: 1U; MXOnly-1U-NoLED
K_PgDn1: 1U; MXOnly-1U-NoLED
K_PgUp1: 1U; MXOnly-1U-NoLED
K_Q1: 1U; MXOnly-1U-NoLED
K_R1: 1U; MXOnly-1U-NoLED
K_RShift1: 1.75U; MXOnly-1.75U-NoLED
K_S1: 1U; MXOnly-1U-NoLED
K_T1: 1U; MXOnly-1U-NoLED
K_Tab1: 1.5U; MXOnly-1.5U-NoLED
K_U1: 1U; MXOnly-1U-NoLED
K_UP1: 1U; MXOnly-1U-NoLED
K_V1: 1U; MXOnly-1U-NoLED
K_W1: 1U; MXOnly-1U-NoLED
K_X1: 1U; MXOnly-1U-NoLED
K_Y1: 1U; MXOnly-1U-NoLED
K_Z1: 1U; MXOnly-1U-NoLED
K_]}1: 1U; MXOnly-1U-NoLED
K_`1: 1U; MXOnly-1U-NoLED
K_fncx1: 1U; MXOnly-1U-NoLED
K_{[1: 1U; MXOnly-1U-NoLED
K_|\1: 1.5U; MXOnly-1.5U-NoLED
MX1: 2U; MXOnly-1.25U-NoLED
MX2: MX-1U-MX_Alps_Hybrids; MXOnly-6.25U-NoLED
MX3: 2.75U; MXOnly-1.25U-NoLED
MX4: MX-1U-MX_Alps_Hybrids; MXOnly-1.25U-NoLED
MX5: 1U; MXOnly-1U-NoLED
R1, R2: 10k; C_0603
R3: 390; C_0603
R67, R68: 22; C_0603
R73, R74: 5.1k; C_0603
SW1: Rotary_Encoder_Switch; RotaryEncoder_Alps_EC11E-Switch_Vertical_H20mm
SW2: 5.2x5.2mm; SKQG-1155865
U1, U3, U4: OLED-Pin; 0.91_SSD1306_OLED
U2: PRTR5V0U2X; SOT143B
U5: STM32F303CCTx; LQFP-48_7x7mm_P0.5mm
U6: MIC5205-3.3YM5 (MIC5207); SOT-23-5
USB1: HRO-TYPE-C-31-M-12; HRO-TYPE-C-31-M-12-Assembly
Y2: 16Mhz; Crystal_SMD_3225-4Pin_3.2x2.5mm
