MaiTheSan/PCB-Design/KiCad/Early 2021/phôi design pcb/1800 layout/1800 layout.sch

## KiCad design KiCad/Early 2021/phôi design pcb/1800 layout/1800 layout.sch (2022-11-19)

Schematic: 1800 layout.sch

Parts:
C2, C5: 1uF; C_0603
C3, C4: 22pF; C_0603
C6, C7, C8: 0.1uF; C_0603
D1, D2, D3, D4, D5, D6, D7, D8, D9, D10, D11, D12, D13, D14, D15, D16, D17, D18, D19, D20, D21, D22, D23, D24, D25, D26, D27, D28, D29, D30, D31, D32, D33, D34, D35, D36, D37, D38, D39, D40, D41, D42, D43, D44, D45, D46, D47, D48, D49, D50, D51, D52, D53, D54, D55, D56, D57, D58, D59, D60, D61, D62, D63, D64, D65, D66, D67, D68, D69, D70, D71, D72, D73, D74, D75, D76, D77, D78, D79, D80, D81, D82, D83, D84, D85, D86, D87, D88, D89, D90, D91, D92, D93, D94, D95, D96, D97, D98, D99, D100, D101, D126: SOD123; D_SOD-123-Pretty
D102, D103, D104, D105, D106, D107, D108, D109, D110, D111, D112, D113, D114, D115, D116, D117, D118, D119, D120, D121, D122, D123, D124, D125, D127, D128: WS2812B; LED_WS2812B_PLCC4_5.0x5.0mm_P3.2mm
F1: 500mA; Fuse_SMD1206_Reflow
J1: AVR-ISP-6; Reset_Pretty-Mask
MX_0, MX_1, MX_2, MX_3, MX_4, MX_5, MX_6, MX_7, MX_8, MX_9: 1U; MXOnly-1U
MX_'1: 1U; MXOnly-1U
MX_+1: 1U; MXOnly-1U
MX_-1: 1U; MXOnly-1U
MX_/?/2: 1U; MXOnly-1U
MX_;1: 1U; MXOnly-1U
MX_<2: 1U; MXOnly-1U
MX_>2: 1U; MXOnly-1U
MX_A1: 1U; MXOnly-1U
MX_ALT1: 1,5U; MXOnly-1.5U
MX_ALT2, MX_ALT3: 1,25U FLIPPED; MXOnly-1.25U-FLIPPED
MX_BkSp1: 2U FLIPPED; MXOnly-2U-FLIPPED
MX_CapLk1: 1,75U; MXOnly-1.75U
MX_CapLk2: 1,25U FLIPPED; MXOnly-1.25U-FLIPPED
MX_D1: 1U; MXOnly-1U
MX_Delete1: 1U; MXOnly-1U
MX_Down1: 1U; MXOnly-1U
MX_E1: 1U; MXOnly-1U
MX_ENTER1: 2,25U FLIPPED; MXOnly-2.25U-FLIPPED-ReversedStabilizers
MX_ESC1: 1U; MXOnly-1U
MX_F1, MX_F2, MX_F3, MX_F4, MX_F14: 1U FLIPPED; MXOnly-1U-FLIPPED
MX_F5, MX_F6, MX_F7, MX_F8, MX_F9, MX_F10, MX_F11, MX_F12, MX_F13: 1U; MXOnly-1U
MX_FN1, MX_FN2, MX_FN3, MX_FN4: 1U; MXOnly-1U
MX_G1: 1U; MXOnly-1U
MX_H1: 1U; MXOnly-1U
MX_I1: 1U; MXOnly-1U
MX_J1: 1U; MXOnly-1U
MX_K1: 1U; MXOnly-1U
MX_L1: 1U; MXOnly-1U
MX_LControl1: 1,5U; MXOnly-1.5U
MX_LControl2: 1,25U FLIPPED; MXOnly-1.25U-FLIPPED
MX_LShift1: 2,25U; MXOnly-2.25U
MX_LWin1, MX_LWin3: 1U; MXOnly-1U
MX_LWin2: 1,25U NoLed; MXOnly-1.25U-NoLED
MX_Left1: 1U; MXOnly-1U
MX_O1: 1U; MXOnly-1U
MX_P1: 1U; MXOnly-1U
MX_PrtSc1: 1U; MXOnly-1U
MX_Q1: 1U; MXOnly-1U
MX_R1: 1U; MXOnly-1U
MX_RAlt1, MX_RAlt3: 1,25U; MXOnly-1.25U
MX_RAlt2: 1,5U FLIPPED; MXOnly-1.5U-FLIPPED
MX_RAlt4: 1,5U; MXOnly-1.5U
MX_RControl1: 1,25U NoLed; MXOnly-1.25U-NoLED
MX_RControl2: 1U FLIPPED; MXOnly-1U-FLIPPED
MX_RControl3: 1,5U FLIPPED; MXOnly-1.5U-FLIPPED
MX_RShift2: 2,75U FLIPPED; MXOnly-2.75U-FLIPPED
MX_RWin1: NoLed; MXOnly-1.25U-NoLED
MX_RWin2: 1,5U; MXOnly-1.5U
MX_RWin3, MX_RWin4: 1U; MXOnly-1U
MX_S1: 1U; MXOnly-1U
MX_SpaceBar1, MX_SpaceBar2: 6,25U FLIPPED; MXOnly-6.25U-FLIPPED-ReversedStabilizers
MX_SpaceBar3, MX_SpaceBar4: 7U; MXOnly-7U-ReversedStabilizers
MX_T1: 1U; MXOnly-1U
MX_U1: 1U; MXOnly-1U
MX_W1: 1U; MXOnly-1U
MX_Y1: 1U; MXOnly-1U
MX_[1: 1U; MXOnly-1U
MX_]1: 1U; MXOnly-1U
MX_`~1: 1U; MXOnly-1U
MX_b1: 1U; MXOnly-1U
MX_c1: 1U; MXOnly-1U
MX_insert1: 1U; MXOnly-1U
MX_m2: 1U; MXOnly-1U
MX_n2: 1U; MXOnly-1U
MX_num0, MX_num1, MX_num2, MX_num3, MX_num4, MX_num5, MX_num6, MX_num7, MX_num8, MX_num9: 1U; MXOnly-1U
MX_num*1: 1U; MXOnly-1U
MX_num+1: 2U; MXOnly-2U
MX_num-1: 1U; MXOnly-1U
MX_num/1: 1U; MXOnly-1U
MX_numDel1: 1U; MXOnly-1U
MX_numEnter1: 2U; MXOnly-2U
MX_numLk1: 1U; MXOnly-1U
MX_right1: 1U; MXOnly-1U
MX_tab1: 1,5U; MXOnly-1.5U
MX_up1: 1U; MXOnly-1U
MX_v1: 1U; MXOnly-1U
MX_x1: 1U; MXOnly-1U
MX_z1: 1U; MXOnly-1U
MX_|\1: 1.5U FLIPPED; MXOnly-1.5U-FLIPPED
Q1: 2N7002; SOT-23
R1, R2, R3, R4, R5, R6, R7, R8, R9, R10, R11, R12, R13, R14, R15, R16, R17, R19, R20, R21, R22, R23, R24, R25, R26, R27, R28, R29, R30, R32, R33, R34, R35, R36, R37, R38, R39, R40, R41, R42, R43, R44, R45, R46, R47, R48, R49, R50, R51, R52, R53, R54, R55, R56, R57, R58, R59, R60, R61, R62, R63, R64, R65, R66, R69, R70, R71, R72, R75, R76, R77, R78, R79, R80, R81, R82, R83, R84, R85, R86, R87, R88, R89, R90, R91, R92, R93, R94, R95, R96, R97, R98, R99, R100, R101, R102, R103, R104, R105, R106, R113: 1k; R_0805
R18, R31: 300; R_0805
R67, R68: 22; R_0805
R73, R74: 5.1k; R_0805
R107: 500; R_0805
R108, R112: 10k; R_0805
R109: 100-1.5k; R_0805
SW1: SW_Push; SKQG-1155865
U1: PRTR5V0U2X; SOT143B
U2: AT90USB1286-AU; TQFP-64_14x14mm_P0.8mm
USB1: HRO-TYPE-C-31-M-12; HRO-TYPE-C-31-M-12-Assembly
Y1: 16MHz; Crystal_SMD_3225-4Pin_3.2x2.5mm
