MaiTheSan/PCB-Design/KiCad/Final/steamvan-master/steamvan-master/matrix.sch

## KiCad design KiCad/Final/steamvan-master/steamvan-master/matrix.sch (2022-11-19)

Schematic: matrix.sch

Parts:
D1, D2, D3, D4, D5, D6, D7, D8, D9, D10, D11, D12, D13, D14, D15, D16, D17, D18, D19, D20, D21, D22, D23, D24, D25, D26, D27, D28, D29, D30, D31, D32, D33, D34, D35, D36, D37, D38, D39, D40, D41, D42, D43, D44, D45, D46: D; D_SOD-123; LCSC PN C83528
K_,1: MX-1U; MXOnly-1U
K_.1: MX-1U; MXOnly-1U
K_/1: MX-1U; MXOnly-1U
K_;1: MX-1U; MXOnly-1U
K_A1: MX-1U; MXOnly-1U
K_B1: MX-1U; MXOnly-1U
K_BACK1: MX-1.75U; MXOnly-1.75U
K_C1: MX-1U; MXOnly-1U
K_D1: MX-1U; MXOnly-1U
K_DOWN1: MX-1U; MXOnly-1U
K_E1: MX-1U; MXOnly-1U
K_ENTER1: MX-2.25U; MXOnly-2.25U-ReversedStabilizers
K_F1: MX-1U; MXOnly-1U
K_FN1: MX-1.25U; MXOnly-1.25U
K_FN2, K_FN4: MX-1.5U; MXOnly-1.5U
K_FN3, K_FN4_2: MX-1U; MXOnly-1U
K_G1: MX-1U; MXOnly-1U
K_H1: MX-1U; MXOnly-1U
K_I1: MX-1U; MXOnly-1U
K_J1: MX-1U; MXOnly-1U
K_K1: MX-1U; MXOnly-1U
K_L1: MX-1U; MXOnly-1U
K_LALT1: MX-1U; MXOnly-1U
K_LCTL1: MX-1.25U; MXOnly-1.25U
K_LCTL2: MX-1U; MXOnly-1U-FLIPPED
K_LOCK1: MX-1.75U; MXOnly-1.75U
K_LSHIFT1: MX-1.75U; MXOnly-1.75U
K_M1: MX-1U; MXOnly-1U
K_N1: MX-1U; MXOnly-1U
K_O1: MX-1U; MXOnly-1U
K_P1: MX-1U; MXOnly-1U
K_Q1: MX-1U; MXOnly-1U
K_R1: MX-1U; MXOnly-1U
K_RALT1: MX-1.25U; MXOnly-1.25U
K_RALT2: MX-1.5U; MXOnly-1.5U-FLIPPED
K_RIGHT1: MX-1U; MXOnly-1U
K_RSHIFT1: MX-1.5U; MXOnly-1.5U
K_S1: MX-1U; MXOnly-1U
K_SPACE1: MX-2U; MXOnly-2U-ReversedStabilizers
K_SUPER1: MX-1.25U; MXOnly-1.25U
K_SUPER2: MX-1U; MXOnly-1U-FLIPPED
K_T1: MX-1U; MXOnly-1U
K_TAB1: MX-1U; MXOnly-1U
K_U1: MX-1U; MXOnly-1U
K_V1: MX-1U; MXOnly-1U
K_W1: MX-1U; MXOnly-1U
K_X1: MX-1U; MXOnly-1U
K_Y1: MX-1U; MXOnly-1U
K_Z1: MX-1U; MXOnly-1U
R1, R2, R3, R4, R5, R6, R7, R8, R9, R10, R11, R12, R13, R14, R15, R16, R17, R18, R19, R20, R21, R22, R23, R24, R25, R26, R27, R28, R29, R30, R31, R32, R33, R34, R35, R36, R37, R38, R39, R40, R41, R42, R43, R44, R45, R46: 560; R_0603_1608Metric
