MaiTheSan/PCB-Design/KiCad/Final/steamvan-master/steamvan-master/rgb_underglow.sch

## KiCad design KiCad/Final/steamvan-master/steamvan-master/rgb_underglow.sch (2022-11-19)

Schematic: rgb_underglow.sch

Parts:
C12, C13, C14, C15, C16, C17, C18, C19, C20: 100n; C_0603_1608Metric; LCSC PN C1590
RC9: 470; R_0603_1608Metric; LCSC PN C114433
RGB1, RGB2, RGB3, RGB4, RGB5, RGB6, RGB7, RGB8, RGB9: WS2812B; LED_WS2812B_PLCC4_5.0x5.0mm_P3.2mm; LCSC PN C114585
U4: 74LVC1G34; SOT-353_SC-70-5; LCSC PN C94111
