MaiTheSan/PCB-Design/KiCad/Final/steamvan-master/steamvan-master/steamvan.sch

## KiCad design KiCad/Final/steamvan-master/steamvan-master/steamvan.sch (2022-11-19)

Schematic: steamvan.sch

Parts:
C1, C2: 30p; C_0603_1608Metric; LCSC PN C22397
C3, C4, C8, C9: 100n; C_0603_1608Metric; LCSC PN C1590
C5: 4.7u; C_0603_1608Metric; LCSC PN C19666
C6, C10, C11: 1u; C_0603_1608Metric; LCSC PN C59782
C7: 10n; C_0603_1608Metric; LCSC PN C1589
F1: 500mA; R_0805_2012Metric; LCSC PN C66452
J1: Conn_01x05_Male; PinHeader_1x05_P2.54mm_Vertical
Q1: FMMT493TA; SOT-23-3; MPN FMMT493TA; Digi-Key_PN FMMT493CT-ND
RC1: 470; R_0603_1608Metric
RC6, RC7: 5.1k; R_0603_1608Metric; LCSC PN C14677
RC8: 10k; R_0603_1608Metric; LCSC PN C98220
SW1: SW_Push; SW_SPST_TL3342; LCSC PN C92584
U1: STM32F303CBTx; LQFP-48_7x7mm_P0.5mm; LCSC PN C108516
U2: TLV70233_SOT23-5; SOT-23-5; LCSC PN C26833
U3: NUF2221W1T2G; SOT-363; LCSC PN C274624
USB1: HRO-TYPE-C-31-M-12; HRO-TYPE-C-31-M-12-Assembly; LCSC PN C165948
Y1: 8MHz; Crystal_SMD_5032-4Pin_5.0x3.2mm; LCSC PN C133333
