MaiTheSan/PCB-Design/KiCad/Myprojects/Numbowl/Numbowl/Numbowl.sch

## KiCad design KiCad/Myprojects/Numbowl/Numbowl/Numbowl.sch (2022-11-19)

Schematic: Numbowl.sch

Parts:
C1: 1uF; C_0603
D1, D2, D3, D4, D5, D6, D7, D8, D9, D10, D11, D12, D13, D14, D15, D16, D17, D18, D19, D20, D21, D22, D23, D24: DIODE; DIODE_1206_SawnsProjects
MX1, MX2, MX3, MX4, MX5, MX6, MX7, MX8, MX9, MX10, MX11, MX12, MX13, MX14, MX15, MX16, MX17, MX18, MX19, MX20, MX21, MX22, MX23, MX24: 1U; MXOnly-1U-NoLED
R1, R2: 5.1k; R_0805
R3, R4: 22R; R_0805
RGB1, RGB2, RGB3, RGB4, RGB5, RGB6, RGB7, RGB8, RGB9, RGB10, RGB11, RGB12: WS2812B; MX_SK6812MINI-E_REV
RGB_REV1, RGB_REV2, RGB_REV3, RGB_REV4, RGB_REV5, RGB_REV6, RGB_REV7, RGB_REV8, RGB_REV9, RGB_REV10, RGB_REV11, RGB_REV12: WS2812B; MX_SK6812MINI-E
SW1, SW2: Rotary_Encoder_Switch; RotaryEncoder_Alps_EC11E-Switch_Vertical_H20mm_Center
U1: ATmega32U4-MU; QFN-44-1EP_7x7mm_P0.5mm_EP5.2x5.2mm
U2: PRTR5V0U2X; SOT143B
USB1: HRO-TYPE-C-31-M-12-Type-C; HRO-TYPE-C-31-M-12-Assembly
