MaiTheSan/PCB-Design/KiCad/Myprojects/Numbowl/Voyager20-FnRow/Voyager20.sch

## KiCad design KiCad/Myprojects/Numbowl/Voyager20-FnRow/Voyager20.sch (2022-11-19)

Schematic: Voyager20.sch

Parts:
C1, C2: 22p; C_0603
C3: 1uF; C_0603
C4, C5: 0.1u; C_0603
C6: 4.7u; C_0603
CR1, CR2, CR3, CR4: 0.1u; C_0603
D25, D26: SOD-123; D_SOD-123
F1: 500mA; Fuse_SMD1206_Reflow
MX21: MX-1U
Q1: Q_NPN_BEC; SOT-23
R1, R5: 10k; R_0805
R2, R3: 22; R_0805
R4, R6: 5.1k; R_0805
R27, R28: 1k; R_0805
SW1: SW_Push; SKQG-1155865
U1: ATmega32U2-AU; QFN-32-1EP_5x5mm_Pitch0.5mm
U2: PRTR5V0U2X; SOT143B
USB1: HRO-TYPE-C-31-M-12; HRO-TYPE-C-31-M-12-Assembly
Y1: 16MHz; Crystal_SMD_3225-4pin_3.2x2.5mm

Notes on the sheet:
Mir Keyboard
2018-11-28
1.0
