MaiTheSan/PCB-Design/KiCad/Myprojects/Sudo/sudo pacman -S Yay/matrix.sch

## KiCad design KiCad/Myprojects/Sudo/sudo pacman -S Yay/matrix.sch (2022-11-19)

Schematic: matrix.sch

Parts:
D2, D3, D4, D5, D7, D8, D9, D10, D11, D12, D13, D14, D15, D16, D17, D18, D19, D20, D21, D22, D23, D24: Diode; DIODE_1206_SawnsProjects
MX1, MX6, MX25: 2U; MXOnly-2U-ReversedStabilizers-NoLED
MX2, MX3, MX4, MX5, MX7, MX8, MX9, MX10, MX11, MX12, MX13, MX14, MX15, MX16, MX17, MX18, MX19, MX20, MX21, MX22, MX23, MX24: 1U; MXOnly-1U-NoLED
RGB1, RGB2, RGB3, RGB4, RGB5, RGB6, RGB7, RGB8: WS2812B; LED_WS2812B_PLCC4_5.0x5.0mm_P3.2mm
RGB9, RGB10, RGB11, RGB12, RGB13: WS2812B; RGB-6028-mid
