MaiTheSan/PCB-Design/KiCad/Myprojects/Sudo/sudo pacman -S Yay/sudo pacman -S Yay.sch

## KiCad design KiCad/Myprojects/Sudo/sudo pacman -S Yay/sudo pacman -S Yay.sch (2022-11-19)

Schematic: sudo pacman -S Yay.sch

Parts:
C1: 1uF; C_0603
C2: 10uF; C_0603
C3, C4, C5: 0.1uF; C_0603
F1: 500mA; Fuse_SMD1206_Reflow
J1: Conn_01x04_Female; SSD091
R1, R2: 22R; R_0603
R3, R4: 5.1k; R_0805
R5, R6: 10k; R_0805
SW1: SW_Push
U1: ATmega32U4-MU; QFN-44-1EP_7x7mm_P0.5mm_EP5.2x5.2mm
U2: PRTR5V0U2X; SOT143B
USB1: HRO-TYPE-C-31-M-12-Type-C; HRO-TYPE-C-31-M-12-Assembly
Y1: 16Mhz; Resonator_SMD_muRata_CSTxExxV-3Pin_3.0x1.1mm
