MaiTheSan/PCB-Design/KiCad/Myprojects/sotx/sotx/atmega32u4.sch

## KiCad design KiCad/Myprojects/sotx/sotx/atmega32u4.sch (2022-11-19)

Schematic: atmega32u4.sch

Parts:
C1: 10uF; C_0603
C4, C5, C7: 0.1uF; C_0603
C6: 1uF; C_0603
F1: Fuse; Fuse_SMD1206_Reflow
R1, R2: 5.1k; R_0805
R3, R4: 22; R_0805
R5: 10k; R_0805
R6: 1k; R_0805
SW2: SW_Push; SKQG-1155865
U2: PRTR5V0U2X; SOT143B
U3: ATmega32U4-MU; QFN-44-1EP_7x7mm_P0.5mm_EP5.15x5.15mm
U4: STF202-22T1G; Reset_Pretty
USB1: HRO-TYPE-C-31-M-12; HRO-TYPE-C-31-M-12-Assembly
Y1: CSTCE16Mxx; Resonator_SMD_muRata_CSTxExxV-3Pin_3.0x1.1mm
