MaiTheSan/PCB-Design/KiCad/Myprojects/sotx/sotx/sotx.sch

## KiCad design KiCad/Myprojects/sotx/sotx/sotx.sch (2022-11-19)

Schematic: sotx.sch

Parts:
D1, D2, D3, D4, D5, D6, D7, D8, D9, D10, D11, D12, D13, D14, D15, D17, D19, D20, D21, D22: 1n4148W; DIODE_1206_SawnsProjects
MX2, MX3, MX4, MX5, MX6, MX7, MX8, MX9, MX10, MX11, MX12, MX13, MX14, MX17, MX19, MX21, MX22: 1U; MXOnly-1U-Hotswap-Sawns
MX15, MX16, MX20: 2U; MXOnly-2U-Hotswap-ReversedStabilizers-Sawns
RGB1, RGB5, RGB6, RGB7, RGB25, RGB26, RGB27, RGB28, RGB29, RGB30: WS2812B; LED_WS2812B_PLCC4_5.0x5.0mm_P3.2mm
SW1: EC11; RotaryEncoder_Alps_EC11E-Switch_Vertical_H20mm_Center
