MaiTheSan/PCB-Design/KiCad/Source/KBD8X-MKII-PCB-master/KBD8X-MKII-PCB-master/KBD8X-MK2.sch

## KiCad design KiCad/Source/KBD8X-MKII-PCB-master/KBD8X-MKII-PCB-master/KBD8X-MK2.sch (2022-11-19)

Schematic: KBD8X-MK2.sch

Parts:
C2: 1uF; C_0603
C3, C4: 22pF; C_0603
C5: 10uF; C_0603
C6, C7, C8: 0.1uF; C_0603
F1: 500mA; Fuse_SMD1206_Wave
J1: AVR-ISP-6; Reset_Pretty-Mask
Q1: DSS60601MZ4-13; SOT-223-3_TabPin2
RC1, RC2: 22; R_0603
RC3: 10k; R_0603
RC4: 1k; R_0603
RC5: 1.5k; R_0603
RC6, RC7: 5k1; R_0603
SW1: SW_Push; SKQG-1155865
U1: ATmega32U4-MU; QFN-44-1EP_7x7mm_Pitch0.5mm
U2: PRTR5V0U2X; SOT143B
USB1: HRO-TYPE-C-31-M-12; HRO-TYPE-C-31-M-12-Assembly
Y1: 16MHz; Crystal_SMD_3225-4pin_3.2x2.5mm

Notes on the sheet:
MOSI
MISO
SCK
