MaiTheSan/PCB-Design/KiCad/Source/KBD8X-MKII-PCB-master/KBD8X-MKII-PCB-master/RGB.sch

## KiCad design KiCad/Source/KBD8X-MKII-PCB-master/KBD8X-MKII-PCB-master/RGB.sch (2022-11-19)

Schematic: RGB.sch

Parts:
CRGB1, CRGB2, CRGB3, CRGB4, CRGB5, CRGB6, CRGB7, CRGB8, CRGB9, CRGB10, CRGB11, CRGB12, CRGB13, CRGB14, CRGB15, CRGB16, CRGB17, CRGB18: 0.1uF; C_0603
RGB1, RGB2, RGB3, RGB4, RGB5, RGB6, RGB7, RGB8, RGB9, RGB10, RGB11, RGB12, RGB13, RGB14, RGB15, RGB16, RGB17, RGB18: WS2812B; LED_WS2812B-PLCC4
