MaiTheSan/PCB-Design/KiCad/Source/KBD8X-MKII-PCB-master/KBD8X-MKII-PCB-master/matrix.sch

## KiCad design KiCad/Source/KBD8X-MKII-PCB-master/KBD8X-MKII-PCB-master/matrix.sch (2022-11-19)

Schematic: matrix.sch

Parts:
D1, D2, D3, D4, D5, D6, D7, D8, D9, D10, D11, D12, D13, D14, D17, D18, D19, D20, D21, D22, D23, D24, D25, D26, D27, D28, D29, D30, D31, D35, D36, D37, D38, D39, D40, D41, D42, D43, D44, D45, D46, D47, D48, D52, D53, D54, D55, D56, D57, D58, D59, D60, D61, D62, D63, D65, D66, D67, D68, D69, D70, D71, D72, D73, D74, D75, D76, D77, D78, D81, D82, D84, D85, D86, D87, D90, D91, D92, D93, D94, D95, D96, D97, D99, D100, D101, D108, D111, D112, D113: SOD-323; D_SOD-123
MX_#0_1, MX_#1, MX_#2, MX_#3, MX_#4, MX_#5, MX_#6, MX_#7, MX_#8, MX_#9: MX-1U; MXOnly-1U
MX_'1: MX-1U; MXOnly-1U
MX_,1: MX-1U; MXOnly-1U
MX_-1: MX-1U; MXOnly-1U
MX_.1: MX-1U; MXOnly-1U
MX_/1: MX-1U; MXOnly-1U
MX_;1: MX-1U; MXOnly-1U
MX_=1: MX-1U; MXOnly-1U
MX_A1: MX-1U; MXOnly-1U
MX_B1: MX-1U; MXOnly-1U
MX_BACK1: MX-2U; MXOnly-2U
MX_BACK2, MX_BACK3: MX-1U; MXOnly-1U
MX_C1: MX-1U; MXOnly-1U
MX_CLOCK1: MX-1.75U; MXOnly-1.75U
MX_CLOCK2: MX-1.25U; MXOnly-1.25U-FLIPPED
MX_D1: MX-1U; MXOnly-1U
MX_DEL1: MX-1U; MXOnly-1U
MX_DN1: MX-1U; MXOnly-1U
MX_E1: MX-1U; MXOnly-1U
MX_END1: MX-1U; MXOnly-1U
MX_ESC1: MX-1U; MXOnly-1U
MX_F1: MX-1U; MXOnly-1U
MX_FN1, MX_FN2, MX_FN3, MX_FN4, MX_FN5, MX_FN6, MX_FN7, MX_FN8, MX_FN9, MX_FN10, MX_FN11, MX_FN12: MX-1U; MXOnly-1U
MX_G1: MX-1U; MXOnly-1U
MX_H1: MX-1U; MXOnly-1U
MX_HOME1: MX-1U; MXOnly-1U
MX_I1: MX-1U; MXOnly-1U
MX_INS1: MX-1U; MXOnly-1U
MX_J1: MX-1U; MXOnly-1U
MX_K1: MX-1U; MXOnly-1U
MX_L1: MX-1U; MXOnly-1U
MX_LALT1: MX-1.25U; MXOnly-1.25U
MX_LALT2: MX-1.5U; MXOnly-1.5U-FLIPPED
MX_LCTRL1: MX-1.25U; MXOnly-1.25U
MX_LCTRL2: MX-1.5U; MXOnly-1.5U-FLIPPED
MX_LFT1: MX-1U; MXOnly-1U
MX_LGUI1: MX-1.25U; MXOnly-1.25U
MX_LGUI2: MX-1U; MXOnly-1U-FLIPPED
MX_LSHIFT1: MX-2.25U; MXOnly-2.25U
MX_LSHIFT2: MX-1.25U; MXOnly-1.25U
MX_LSHIFT3: MX-1U; MXOnly-1U
MX_M1: MX-1U; MXOnly-1U
MX_N1: MX-1U; MXOnly-1U
MX_O1: MX-1U; MXOnly-1U
MX_P1: MX-1U; MXOnly-1U
MX_PAUSE1: MX-1U; MXOnly-1U
MX_PGDN1: MX-1U; MXOnly-1U
MX_PGUP1: MX-1U; MXOnly-1U
MX_PRINT1: MX-1U; MXOnly-1U
MX_Q1: MX-1U; MXOnly-1U
MX_R1: MX-1U; MXOnly-1U
MX_RALT1: MX-1.25U; MXOnly-1.25U
MX_RALT2: MX-1.5U; MXOnly-1.5U
MX_RCTRL1: MX-1.25U; MXOnly-1.25U-FLIPPED
MX_RCTRL2: MX-1.5U; MXOnly-1.5U
MX_RETURN1: MX-2.25U; MXOnly-2.25U
MX_RETURN2: MX-ISO; MXOnly-ISO-ROTATED-ReversedStabilizers
MX_RGUI1: MX-1.25U; MXOnly-1.25U-FLIPPED
MX_RGUI2: MX-1U; MXOnly-1U
MX_RMENU1: MX-1.25U; MXOnly-1.25U-FLIPPED
MX_RSHIFT1: MX-2.75U; MXOnly-2.75U
MX_RSHIFT2: MX-1.75U; MXOnly-1.75U
MX_RSHIFT3: MX-1U; MXOnly-1U
MX_RT1: MX-1U; MXOnly-1U
MX_S1: MX-1U; MXOnly-1U
MX_SLOCK1: MX-1U; MXOnly-1U
MX_SP1: MX-6.25U; MXOnly-6.25U-ReversedStabilizers
MX_SP2: MX-7U; MXOnly-7U-ReversedStabilizers
MX_T1: MX-1U; MXOnly-1U
MX_TAB1: MX-1.5U; MXOnly-1.5U
MX_U1: MX-1U; MXOnly-1U
MX_UP1: MX-1U; MXOnly-1U
MX_V1: MX-1U; MXOnly-1U
MX_W1: MX-1U; MXOnly-1U
MX_X1: MX-1U; MXOnly-1U
MX_Y1: MX-1U; MXOnly-1U
MX_Z1: MX-1U; MXOnly-1U
MX_[1: MX-1U; MXOnly-1U
MX_\1: MX-1.5U; MXOnly-1.5U
MX_\2: MX-1U; MXOnly-1U
MX_]1: MX-1U; MXOnly-1U
MX_`1: MX-1U; MXOnly-1U
R1, R2, R3, R4, R5, R6, R7, R8, R9, R10, R11, R12, R13, R14, R16, R17, R18, R19, R20, R21, R22, R23, R24, R25, R26, R27, R28, R29, R30, R31, R32, R33, R35, R36, R37, R38, R39, R40, R41, R42, R43, R44, R45, R46, R47, R48, R52, R53, R54, R55, R56, R57, R58, R59, R60, R61, R62, R63, R65, R66, R67, R68, R69, R70, R71, R72, R73, R74, R75, R76, R77, R78, R81, R82, R84, R85, R86, R87, R90, R91, R95, R96, R97, R99, R100, R101, R108, R111, R112, R113: 1k; R_0603
SW2, SW3: SW_SPDT; SW_SPDT_PCM12
