MaiTheSan/PCB-Design/KiCad/Source/Voyager60-alps/Voyager60-alps/Voyager60.sch

## KiCad design KiCad/Source/Voyager60-alps/Voyager60-alps/Voyager60.sch (2022-11-19)

Schematic: Voyager60.sch

Parts:
C1, C3, C4, C5, C9, C10, C11, C12, C13, C14, C15, C16, C17, C18, C19, C20, C21: 0.1uF; C_0603
C2: 10uF; C_0603
C6: 1uF; C_0603
C7, C8: 22pF; C_0603
D1, D2, D3, D4, D5, D6, D7, D8, D9, D10, D11, D12, D13, D14, D16, D17, D18, D19, D20, D21, D22, D23, D24, D25, D26, D27, D28, D29, D30, D31, D32, D33, D34, D35, D36, D37, D38, D39, D40, D41, D42, D43, D44, D45, D46, D47, D48, D49, D50, D51, D52, D53, D54, D55, D56, D57, D58, D59, D60, D61, D62, D63, D64, D65, D67, D68: SOD-123; D_SOD-123
F1: 500mA; Fuse_SMD1206_Reflow
K_#1, K_#2, K_#3, K_#4, K_#5, K_#6, K_#7, K_#8, K_#9, K_#10: MX-1U; ALPS-1U
K_'1: MX-1U; ALPS-1U
K_,1: MX-1U; ALPS-1U
K_-1: MX-1U; ALPS-1U
K_.1: MX-1U; ALPS-1U
K_/1: MX-1U; ALPS-1U
K_;1: MX-1U; ALPS-1U
K_=1: MX-1U; ALPS-1U
K_A1: MX-1U; ALPS-1U
K_ALT1: MX-1.25U; ALPS-1.25U
K_ALT2, K_ALT3: MX-1.5U; ALPS-1.5U
K_B1: MX-1U; ALPS-1U
K_BACK1: MX-2U; ALPS-2U
K_C1: MX-1U; ALPS-1U
K_CAPS1: MX-1.75U; ALPS-1.75U
K_CAPS2: MX-1.25U; ALPS-1.25U
K_CAPS3: MX-1.5U; ALPS-1.5U
K_CTRL1: MX-1.25U; ALPS-1.25U
K_CTRL2: MX-1.5U; ALPS-1.5U
K_D1: MX-1U; ALPS-1U
K_E1: MX-1U; ALPS-1U
K_ENTER1: MX-2.25U; ALPS-2.25U
K_ENTER2, K_ENTER3, K_ENTER4: MX-1U; ALPS-1U
K_ESC1, K_ESC2: MX-1U; ALPS-1U
K_F1: MX-1U; ALPS-1U
K_G1: MX-1U; ALPS-1U
K_H1: MX-1U; ALPS-1U
K_I1: MX-1U; ALPS-1U
K_J1: MX-1U; ALPS-1U
K_K1: MX-1U; ALPS-1U
K_L1: MX-1U; ALPS-1U
K_M1: MX-1U; ALPS-1U
K_N1: MX-1U; ALPS-1U
K_O1: MX-1U; ALPS-1U
K_P1: MX-1U; ALPS-1U
K_Q1: MX-1U; ALPS-1U
K_R1: MX-1U; ALPS-1U
K_RALT1, K_RALT3: MX-1.5U; ALPS-1.5U
K_RALT2: MX-1.25U; ALPS-1.25U
K_RCTRL2: MX-1.25U; ALPS-1.25U
K_RCTRL3: MX-1.5U; ALPS-1.5U
K_RMENU2: MX-1.25U; ALPS-1.25U
K_RSHIFT1: MX-2.75U; ALPS-2.75U
K_RWIN1, K_RWIN2: MX-1.25U; ALPS-1.25U
K_RWIN3: MX-1U; ALPS-1U
K_S1: MX-1U; ALPS-1U
K_SBACK1, K_SBACK2: MX-1U; ALPS-1U
K_SHIFT1: MX-2.25U; ALPS-2.25U
K_SHIFT2: MX-1.25U; ALPS-1.25U
K_SHIFT3: MX-1U; ALPS-1U
K_SPACE1: MX-7U; ALPS-7U
K_SPACE2: MX-6.25U; ALPS-6.25U
K_SPACE3: MX-2.25U; ALPS-2.25U
K_SPACE4: MX-2.75U; ALPS-2.75U
K_SPACE5: MX-1.25U; ALPS-1.25U
K_SRSHIFT1: MX-1.75U; ALPS-1.75U
K_SRSHIFT2: MX-1U; ALPS-1U
K_T1: MX-1U; ALPS-1U
K_TAB1: MX-1.5U; ALPS-1.5U
K_U1: MX-1U; ALPS-1U
K_V1: MX-1U; ALPS-1U
K_W1: MX-1U; ALPS-1U
K_WIN1, K_WIN3: MX-1.25U; ALPS-1.25U
K_WIN2: MX-1U; ALPS-1U
K_X1: MX-1U; ALPS-1U
K_Y1: MX-1U; ALPS-1U
K_Z1: MX-1U; ALPS-1U
K_[1: MX-1U; ALPS-1U
K_\1: MX-1.5U; ALPS-1.5U
K_\2: MX-1U; ALPS-1U
K_]1: MX-1U; ALPS-1U
R67, R68: 22; R_0805
R70: 10k; R_0805
R71: 1k; R_0805
R73, R74: 5.1k; R_0805
RGB1, RGB2, RGB3, RGB4, RGB5, RGB6, RGB7, RGB8, RGB9, RGB10, RGB11, RGB12, RGB13, RGB14: WS2812B
SW1: 5.2x5.2mm; SKQG-1155865
U1: ATmega32U4-MU; QFN-44-1EP_7x7mm_Pitch0.5mm
U2: PRTR5V0U2X; SOT143B
USB1: HRO-TYPE-C-31-M-12; HRO-TYPE-C-31-M-12-Assembly
Y1: 16Mhz; Crystal_SMD_3225-4pin_3.2x2.5mm
