MaiTheSan/PCB-Design/KiCad/Source/Voyager65-Keyplus/Voyager65-Keyplus-master/LeftMods.sch

## KiCad design KiCad/Source/Voyager65-Keyplus/Voyager65-Keyplus-master/LeftMods.sch (2022-11-19)

Schematic: LeftMods.sch

Parts:
D63, D64, D65: D_Small; D_SOD-123
K_LM1, K_LM7: MX-1.5U
K_LM2, K_LM4: MX-1.25U; MX-1.25U-FLIPPED
K_LM3: MX-1.5U; MX-1.5U-FLIPPED
K_LM5, K_LM6: MX-1.25U
