MaiTheSan/PCB-Design/KiCad/Source/Voyager65-Keyplus/Voyager65-Keyplus-master/Matrix.sch

## KiCad design KiCad/Source/Voyager65-Keyplus/Voyager65-Keyplus-master/Matrix.sch (2022-11-19)

Schematic: Matrix.sch

Parts:
D1, D2, D3, D4, D5, D6, D7, D8, D9, D10, D11, D12, D13, D14, D15, D16, D17, D18, D19, D20, D21, D22, D23, D24, D25, D26, D27, D28, D29, D30, D31, D32, D33, D34, D35, D36, D37, D38, D39, D40, D41, D42, D43, D44, D45, D46, D47, D48, D49, D50, D51, D52, D53, D54, D55, D56, D57, D58, D59, D60, D61, D62: D_Small; D_SOD-123
K_#0_1, K_#1, K_#2, K_#3, K_#4, K_#5, K_#6, K_#7, K_#8, K_#9: MX-1U
K_'1: MX-1U
K_,1: MX-1U
K_-1: MX-1U
K_.1: MX-1U
K_/1: MX-1U
K_;1: MX-1U
K_=1: MX-1U
K_A1: MX-1U
K_B1: MX-1U
K_BACK1: MX-2U
K_BACK2: MX-1U
K_C1: MX-1U
K_CAPS1: MX-1.75U
K_CAPS2: MX-1.25U; MX-1.25U-FLIPPED
K_D1: MX-1U
K_DEL1: MX-1U
K_DOWN1: MX-1U
K_E1: MX-1U
K_ENTER1: MX-2.25U
K_ESC1: MX-1U
K_EX1, K_EX2, K_EX3, K_EX4: MX-1U
K_F1: MX-1U
K_G1: MX-1U
K_H1: MX-1U
K_I1: MX-1U
K_J1: MX-1U
K_K1: MX-1U
K_L1: MX-1U
K_LEFT1: MX-1U
K_M1: MX-1U
K_N1: MX-1U
K_O1: MX-1U
K_P1: MX-1U
K_Q1: MX-1U
K_R1: MX-1U
K_RIGHT1: MX-1U
K_S1: MX-1U
K_SHIFT1: MX-2.25U
K_SHIFT2: MX-1.75U
K_T1: MX-1U
K_TAB1: MX-1.5U
K_U1: MX-1U
K_UP1: MX-1U
K_V1: MX-1U
K_W1: MX-1U
K_X1: MX-1U
K_Y1: MX-1U
K_Z1: MX-1U
K_[1: MX-1U
K_\1: MX-1.5U
K_]1: MX-1U
