MaiTheSan/PCB-Design/KiCad/Source/Voyager65-Keyplus/Voyager65-Keyplus-master/RGB.sch

## KiCad design KiCad/Source/Voyager65-Keyplus/Voyager65-Keyplus-master/RGB.sch (2022-11-19)

Schematic: RGB.sch

Parts:
CRGB1, CRGB2, CRGB3, CRGB4, CRGB5, CRGB6, CRGB7, CRGB8, CRGB9, CRGB10, CRGB11, CRGB12: 0.1u; C_0603
LED1, LED2, LED3, LED4, LED5, LED6, LED7, LED8, LED9, LED10, LED11, LED12: WS2812B
R5: 470; R_0603
U5: 74LVC1G34; SOT-353_SC-70-5
