MaiTheSan/PCB-Design/KiCad/Source/Voyager65-Keyplus/Voyager65-Keyplus-master/RightMods.sch

## KiCad design KiCad/Source/Voyager65-Keyplus/Voyager65-Keyplus-master/RightMods.sch (2022-11-19)

Schematic: RightMods.sch

Parts:
D69, D70, D71: D_Small; D_SOD-123
K_RM1: MX-1U
K_RM2: MX-1.5U; MX-1.5U-FLIPPED
K_RM3: MX-1.25U
K_RM4, K_RM6: MX-1U; MX-1U-FLIPPED
K_RM5: MX-1.5U
