MaiTheSan/PCB-Design/KiCad/Source/Voyager65-Keyplus/Voyager65-Keyplus-master/Space.sch

## KiCad design KiCad/Source/Voyager65-Keyplus/Voyager65-Keyplus-master/Space.sch (2022-11-19)

Schematic: Space.sch

Parts:
D66, D67, D68: D_Small; D_SOD-123
SP1, SP7: MX-2.25U; MX-2.25U-ReversedStabilizers
SP2: MX-7U; MX-7U-ReversedStabilizers
SP3: MX-6.25U; MX-6.25U-ReversedStabilizers
SP4: MX-1.25U; MX-1.25U-FLIPPED
SP5, SP9: MX-2.75U; MX-2.75U-ReversedStabilizers
SP6: MX-6.5U; MX-6.5U-FLIPPED-ReversedStabilizers
SP8: MX-1.5U
