MaiTheSan/PCB-Design/KiCad/Source/Voyager65-Keyplus/Voyager65-Keyplus-master/Voyager65.sch

## KiCad design KiCad/Source/Voyager65-Keyplus/Voyager65-Keyplus-master/Voyager65.sch (2022-11-19)

Schematic: Voyager65.sch

Parts:
C1: 1u; C_0603
C2, C3, C4, C5, C8, C9, C10: 0.1u; C_0603
C6: 10u; C_0603
C7: 22u; C_0805; Voltage 10V
C11, C12, C13, C14: 0.47u; C_0603
F1: 500mA; R_0805
P1: TC2030-IDC; TC2030-NL_SMALL_AND_IDC_PDI
R1: 10k; R_0603
R2: 100k; R_0603
R3, R4: 1k; R_0603
R6, R7: 5.1k; R_0603
R8: 20k; R_0603
SW1: SW_PUSH; SKQG-1155865
U1: ATXMEGA32A4U-MH; QFN-44-1EP_7x7mm_Pitch0.5mm
U2: MCP1700T-3002E/TT; SOT-23
U3: PRTR5V0U2X; SOT143B
U4: IS31FL3733-QFLS4-TR; QFN-48-1EP_6x6mm_Pitch0.4mm
USB1: HRO-TYPE-C-31-M-12

Notes on the sheet:
SDA and SCL are marked as I2C+- for the sake of using KiCad's differential router
