MaiTheSan/PCB-Design/KiCad/Source/nrf/mikoto-master/mikoto.kicad_sch

## KiCad design KiCad/Source/nrf/mikoto-master/mikoto.kicad_sch (2022-11-19)

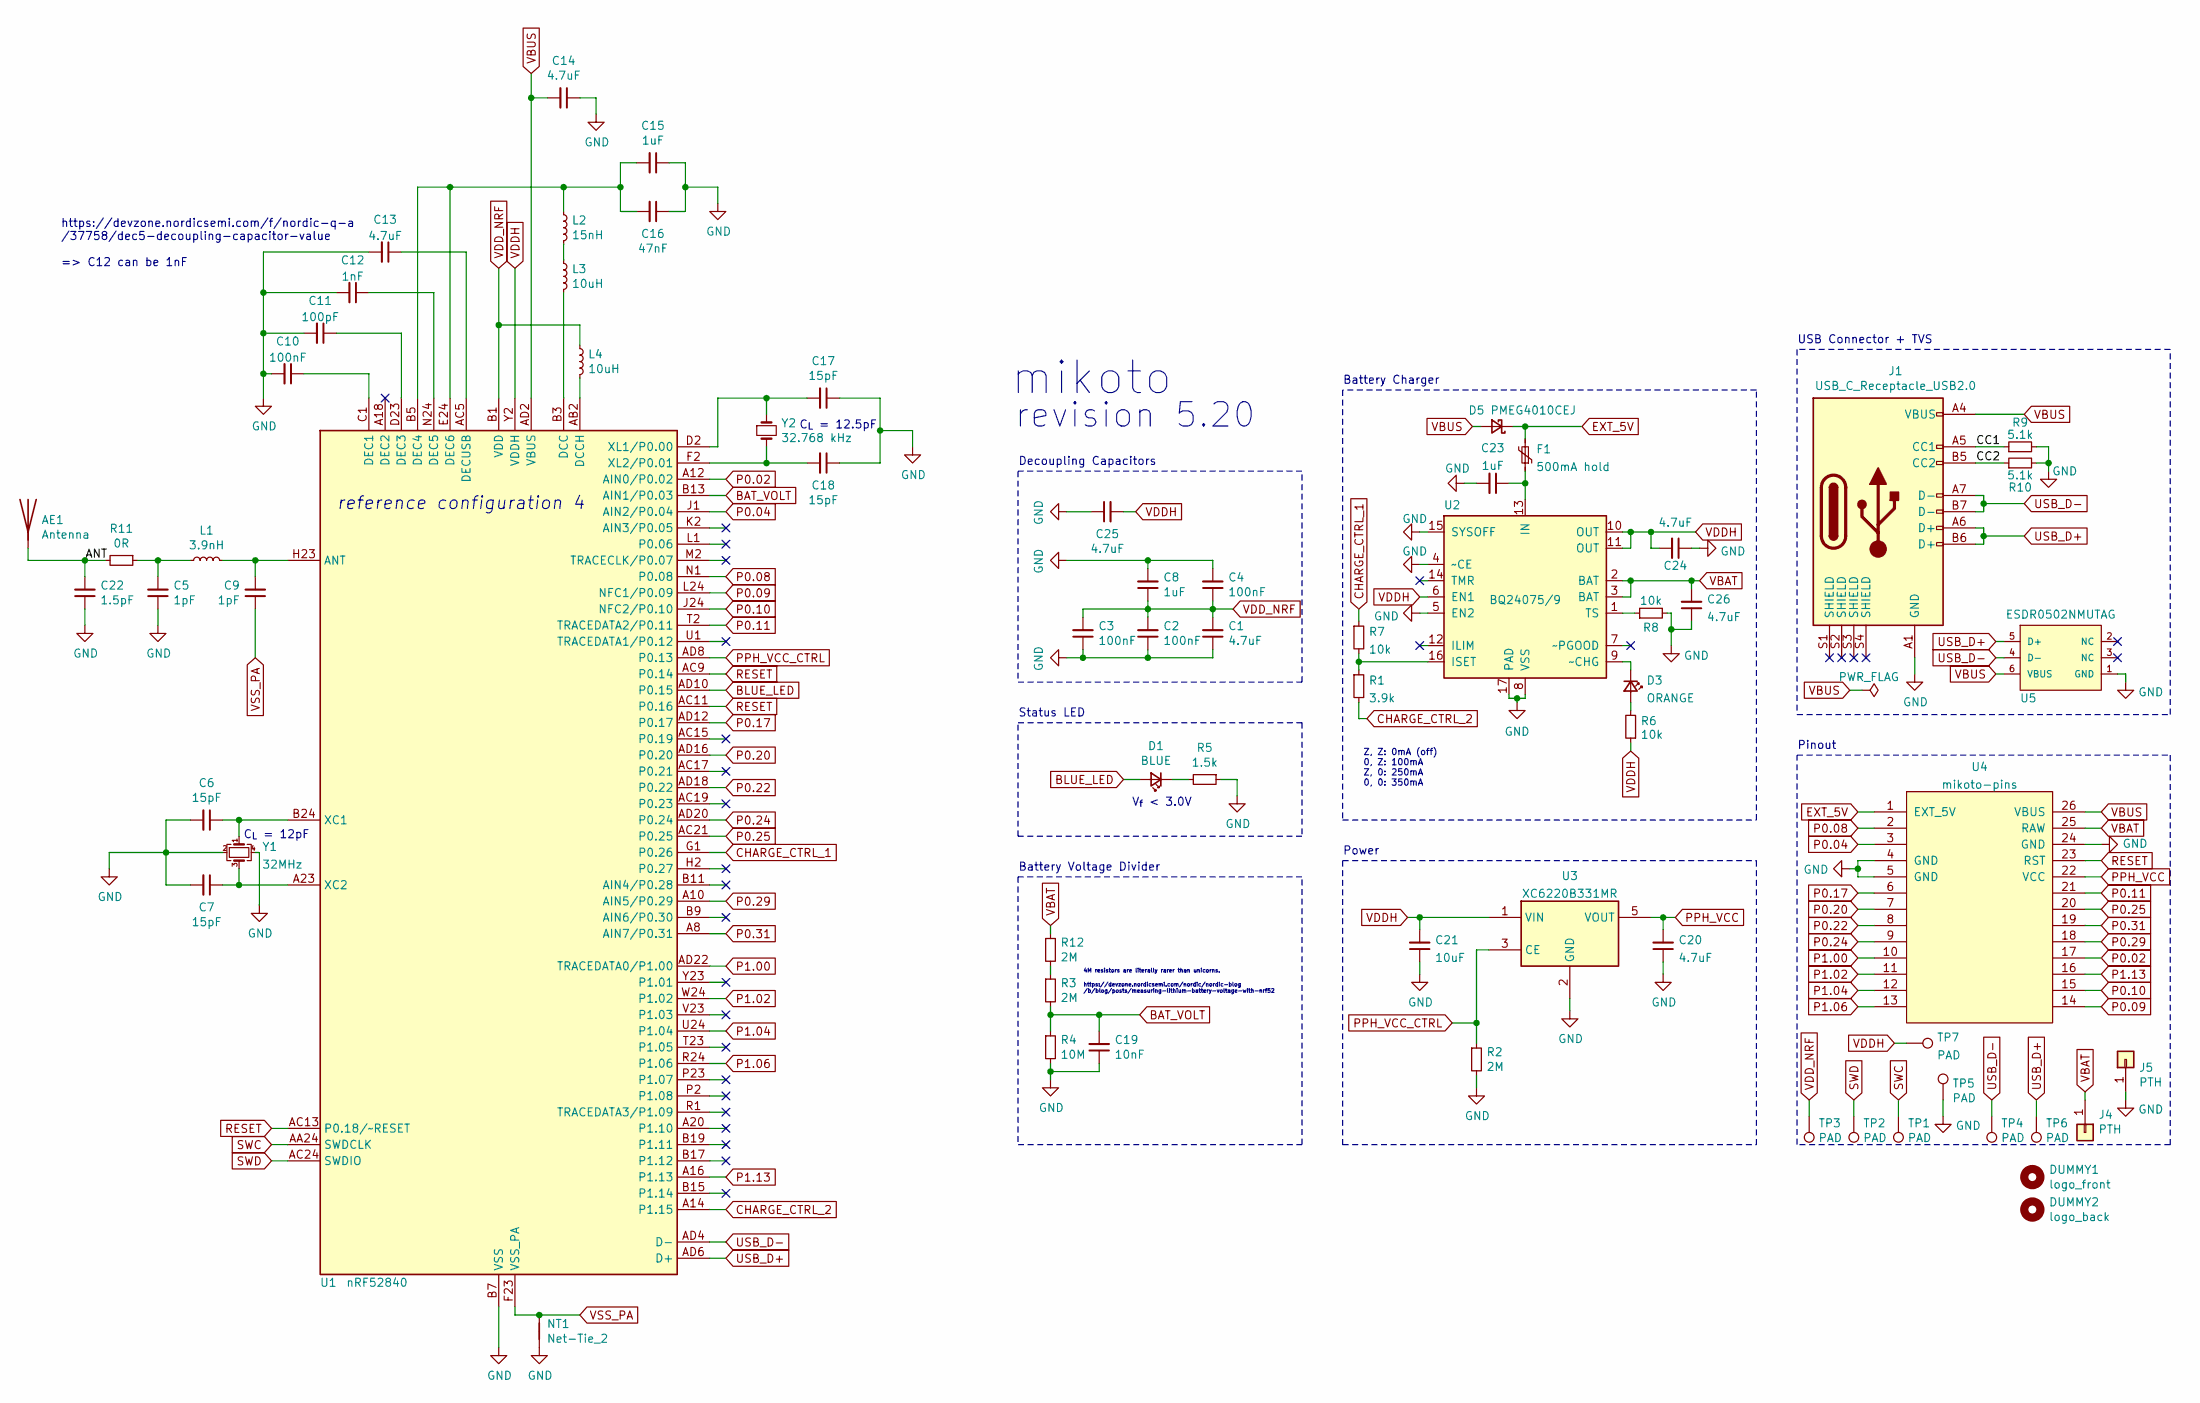
[picture p230: schematic mikoto.kicad_sch]

Parts:
AE1: Antenna; 2.4GHz-meander-antenna-v2
C1, C13, C14, C20, C24, C25, C26: 4.7uF; Capacitor_0402_1005M-nosilk; Manufacturer Part CL05A475KP5NRNC; LCSC Part C368809
C2, C3, C4, C10: 100nF; Capacitor_0402_1005M-nosilk; Manufacturer Part CL05B104KA5NNNC; LCSC Part C1525
C5, C9: 1pF; Capacitor_0402_1005M-nosilk; Manufacturer Part CL05C010CB5NNNC; LCSC Part C371977
C6, C7, C17, C18: 15pF; Capacitor_0402_1005M-nosilk; Manufacturer Part CL05C150JB51PNC; LCSC Part C307341
C8, C15, C23: 1uF; Capacitor_0402_1005M-nosilk; Manufacturer Part CL05A105KO5NNNC; LCSC Part C52923
C11: 100pF; Capacitor_0402_1005M-nosilk; Manufacturer Part CL05C101JB5NNNC; LCSC Part C26409
C12: 1nF; Capacitor_0402_1005M-nosilk; Manufacturer Part CL05B102KB5NNNC; LCSC Part C14442
C16: 47nF; Capacitor_0402_1005M-nosilk; Manufacturer Part CL05B473KO5NNNC; LCSC Part C307434
C19: 10nF; Capacitor_0402_1005M-nosilk; Manufacturer Part CL05B103KB5NNNC; LCSC Part C15195
C21: 10uF; Capacitor_0603_1608M-nosilk; Manufacturer Part CL10A106KP8NNNC; LCSC Part C19702
C22: 1.5pF; Capacitor_0402_1005M-nosilk; Manufacturer Part CL05C1R5CB5NNNC; LCSC Part C170150
D1: BLUE; LED_0603_1608Metric; Manufacturer Part 19-217/BHC-ZL1M2RY/3T; LCSC Part C146215
D3: ORANGE; LED_0603_1608Metric; Manufacturer Part 19-217/S2C-AQ1R1B/3T; LCSC Part C160478
D5: PMEG4010CEJ; D_SOD-323F-nosilk; Manufacturer Part PMEG4010CEJ; LCSC Part C50704
DUMMY1: logo_front; mikoto-logo
DUMMY2: logo_back; mikoto-logo
F1: 500mA hold; Fuse_0402_1005Metric; Manufacturer Part 0402L050SLKR; LCSC Part C206938
J1: USB_C_Receptacle_USB2.0; USB-C_C168688; LCSC Part C168688
J4, J5: PTH; PTH-0.8_0.45mm
L1: 3.9nH; Inductor_0402_1005M-nosilk; Manufacturer Part MLG1005S3N9BT000; LCSC Part C76775
L2: 15nH; Inductor_0402_1005M-nosilk; Manufacturer Part MLG1005S15NJT000; LCSC Part C76763
L3, L4: 10uH; Inductor_0603_1608M-nosilk; Manufacturer Part MLF1608E100KTD00; LCSC Part C76732
NT1: Net-Tie_2; net-tie-2-tiny
R1: 3.9k; Resistor_0402_1005M-nosilk; Manufacturer Part RC0402FR-073K9L; LCSC Part C131467
R2, R3, R12: 2M; Resistor_0402_1005M-nosilk; Manufacturer Part RC0402FR-072ML; LCSC Part C138014
R4: 10M; Resistor_0402_1005M-nosilk; Manufacturer Part RC0402FR-0710ML; LCSC Part C138067
R5: 1.5k; Resistor_0402_1005M-nosilk; Manufacturer Part RC0402FR-071K5L; LCSC Part C114759
R6, R7, R8: 10k; Resistor_0402_1005M-nosilk; Manufacturer Part RC0402FR-0710KL; LCSC Part C60490
R9, R10: 5.1k; Resistor_0402_1005M-nosilk; Manufacturer Part RC0402FR-075K1L; LCSC Part C105872
R11: 0R; Resistor_0402_1005M-nosilk; Manufacturer Part RC0402FR-070RL; LCSC Part C106231
TP1, TP2, TP3, TP4, TP5, TP6, TP7: PAD; TestPoint_Pad_1.0x1.0mm
U1: nRF52840; AQFN-73-1EP_7x7mm_P0.5mm_NRF52840-custom; Manufacturer Part NRF52840-QIAA-R; LCSC Part C1851953
U2: BQ24075/9; VQFN-16-1EP_3x3mm_P0.5mm_EP1.6x1.6mm; Manufacturer Part BQ24075RGTR; LCSC Part C15464
U3: XC6220B331MR; SOT-23-5; Manufacturer Part XC6220B331MR-G‎; Digikey 893-1133-1-ND‎
U4: mikoto-pins
U5: ESDR0502NMUTAG; UDFN-6_1.2x1.0mm_P0.4mm; Manufacturer Part ESDR0502NMUTBG; LCSC Part C327480
Y1: 32MHz; Crystal_SMD_2016-4Pin_2.0x1.6mm; Manufacturer Part Q22FA1280001800; LCSC Part C255896
Y2: 32.768 kHz; Crystal_SMD_2012-2Pin_2.0x1.2mm; Manufacturer Part SC20S-12.5PF20PPM; LCSC Part C97607

Connections:
ANT: AE1.1, C22.2, R11.2
BAT_VOLT: C19.2, R3.2, R4.1, U1.B13 (AIN1/P0.03)
BLUE_LED: D1.2 (A), U1.AD10 (P0.15)
CC1: J1.A5 (CC1), R9.1
CC2: J1.B5 (CC2), R10.1
CHARGE_CTRL_1: R7.1, U1.G1 (P0.26)
CHARGE_CTRL_2: R1.2, U1.A14 (P1.15)
EXT_5V: D5.1 (K), F1.2, U4.1 (EXT_5V)
GND: C1.1, C2.1, C3.1, C4.2, C5.1, C6.2, C7.2, C8.2, C10.2, C11.2, C12.2, C13.2, C14.1, C15.1, C16.1, C17.1, C18.1, C19.1, C20.1, C21.1, C22.1, C23.2, C24.1, C25.1, C26.1, J1.A1 (GND), J5.1, NT1.2, R2.2, R4.2, R5.1, R8.2, R9.2, R10.2, TP5.1, U1.B7 (VSS), U1.EP (VSS), U2.4 (~CE), U2.5 (EN2), U2.8 (VSS), U2.15 (SYSOFF), U2.17 (PAD), U3.2 (GND), U4.4 (GND), U4.5 (GND), U4.24 (GND), U5.1 (GND), Y1.2, Y1.4
unnamed: C5.2, L1.1, R11.1
unnamed: C6.1, U1.B24 (XC1), Y1.1
unnamed: C7.1, U1.A23 (XC2), Y1.3
unnamed: C9.2, L1.2, U1.H23 (ANT)
unnamed: C10.1, U1.C1 (DEC1)
unnamed: C11.1, U1.D23 (DEC3)
unnamed: C12.1, U1.N24 (DEC5)
unnamed: C13.1, U1.AC5 (DECUSB)
unnamed: C15.2, C16.2, L2.1, U1.B5 (DEC4), U1.E24 (DEC6)
unnamed: C17.2, U1.D2 (XL1/P0.00), Y2.1
unnamed: C18.2, U1.F2 (XL2/P0.01), Y2.2
unnamed: C23.1, F1.1, U2.13 (IN)
unnamed: D1.1 (K), R5.2
unnamed: D3.1 (K), U2.9 (~CHG)
unnamed: D3.2 (A), R6.2
unnamed: L2.2, L3.1
unnamed: L3.2, U1.B3 (DCC)
unnamed: L4.2, U1.AB2 (DCCH)
unnamed: R1.1, R7.2, U2.16 (ISET)
unnamed: R8.1, U2.1 (TS)
unnamed: R3.1, R12.2
P0.02: U1.A12 (AIN0/P0.02), U4.17
P0.04: U1.J1 (AIN2/P0.04), U4.3
P0.08: U1.N1 (P0.08), U4.2
P0.09: U1.L24 (NFC1/P0.09), U4.14
P0.10: U1.J24 (NFC2/P0.10), U4.15
P0.11: U1.T2 (TRACEDATA2/P0.11), U4.21
P0.17: U1.AD12 (P0.17), U4.6
P0.20: U1.AD16 (P0.20), U4.7
P0.22: U1.AD18 (P0.22), U4.8
P0.24: U1.AD20 (P0.24), U4.9
P0.25: U1.AC21 (P0.25), U4.20
P0.29: U1.A10 (AIN5/P0.29), U4.18
P0.31: U1.A8 (AIN7/P0.31), U4.19
P1.00: U1.AD22 (TRACEDATA0/P1.00), U4.10
P1.02: U1.W24 (P1.02), U4.11
P1.04: U1.U24 (P1.04), U4.12
P1.06: U1.R24 (P1.06), U4.13
P1.13: U1.A16 (P1.13), U4.16
PPH_VCC: C20.2, U3.5 (VOUT), U4.22 (VCC)
PPH_VCC_CTRL: R2.1, U1.AD8 (P0.13), U3.3 (CE)
RESET: U1.AC9 (P0.14), U1.AC11 (P0.16), U1.AC13 (P0.18/~RESET), U4.23 (RST)
SWC: TP1.1, U1.AA24 (SWDCLK)
SWD: TP2.1, U1.AC24 (SWDIO)
USB_D+: J1.A6 (D+), J1.B6 (D+), TP6.1, U1.AD6 (D+), U5.5 (D+)
USB_D-: J1.A7 (D-), J1.B7 (D-), TP4.1, U1.AD4 (D-), U5.4 (D-)
VBAT: C26.2, J4.1, R12.1, U2.2 (BAT), U2.3 (BAT), U4.25 (RAW)
VBUS: C14.2, D5.2 (A), J1.A4 (VBUS), U1.AD2 (VBUS), U4.26 (VBUS), U5.6 (VBUS)
VDDH: C21.2, C24.2, C25.2, R6.1, TP7.1, U1.Y2 (VDDH), U2.6 (EN1), U2.10 (OUT), U2.11 (OUT), U3.1 (VIN)
VDD_NRF: C1.2, C2.2, C3.2, C4.1, C8.1, L4.1, TP3.1, U1.A22 (VDD), U1.AD14 (VDD), U1.AD23 (VDD), U1.B1 (VDD), U1.W1 (VDD)
VSS_PA: C9.1, NT1.1, U1.F23 (VSS_PA)

Notes on the sheet:
https://devzone.nordicsemi.com/f/nordic-q-a /37758/dec5-decoupling-capacitor-value => C12 can be 1nF
C_{L} = 12pF
reference configuration 4
C_{L} = 12.5pF
mikoto
revision 5.20
Decoupling Capacitors
Status LED
Battery Voltage Divider
4M resistors are literally rarer than unicorns.
https://devzone.nordicsemi.com/nordic/nordic-blog /b/blog/posts/measuring-lithium-battery-voltage-with-nrf52
V_{f} < 3.0V
Battery Charger
Power
Z, Z: 0mA (off) 0, Z: 100mA Z, 0: 250mA 0, 0: 350mA
USB Connector + TVS
Pinout
