MaiTheSan/PCB-Design/KiCad/our projects/60 - STM - 072 - 11 - DG - 000 - S (MyS)/MyS/MyS.sch

## KiCad design KiCad/our projects/60 - STM - 072 - 11 - DG - 000 - S (MyS)/MyS/MyS.sch (2022-11-19)

Schematic: MyS.sch

Parts:
C1, C2: 1uF; CP_EIA-3216
C21, C23, C25, C27: 0.1uF; C_0603
C22, C24, C26: 1uF; C_0603
C28: 4.7uF; C_0603
C29: 10nF; C_0603
D1, D2, D3, D4, D5, D6, D7, D8, D9, D10, D11, D12, D13, D14, D15, D16, D17, D18, D19, D20, D21, D22, D23, D24, D25, D26, D27, D28, D29, D30, D31, D32, D33, D34, D35, D36, D37, D38, D39, D40, D41, D42, D43, D45, D46, D48, D49, D50, D51, D52, D53, D54, D55, D56, D57, D58, D59, D61, D62, D63, D65, D70, D71, D72, D73: D; D_SOD-123
J1: Conn_01x04_Female; PinHeader_1x04_P2.54mm_Vertical
J2: Conn_01x04_Female; JST-SR-4
MX1, MX2, MX3, MX4, MX5, MX6, MX7, MX8, MX9, MX10, MX11, MX12, MX13, MX14, MX15, MX16, MX19, MX20, MX21, MX22, MX23, MX24, MX25, MX26, MX27, MX28, MX29, MX30, MX34, MX35, MX36, MX37, MX38, MX39, MX40, MX41, MX42, MX43, MX44, MX45, MX49, MX50, MX51, MX52, MX53, MX54, MX55, MX56, MX57, MX58, MX59, MX61, MX69, MX76, MX77, MX78, MX80: 1U; MXOnly-1U-NoLED
MX17: 2U; MXOnly-2U-NoLED
MX18, MX33, MX46, MX70, MX72, MX79: 1.5U; MXOnly-1.5U-NoLED
MX31: 1.25U-stepcap; MXOnly-1.25U-NoLED
MX32, MX60, MX82: 1.75U; MXOnly-1.75U-NoLED
MX47, MX48: 2.25U; MXOnly-2.25U-NoLED
MX62, MX65, MX66, MX67, MX73, MX74, MX75: 1.25U; MXOnly-1.25U-NoLED
MX68: 6.25U; MXOnly-6.25U-ReversedStabilizers-NoLED
MX71: 6.25U; MXOnly-7U-ReversedStabilizers-NoLED
MX81: 2.25U; MXOnly-2.75U-NoLED
R1, R2: 100k; R_0805
R3, R4: 22; R_0603
R7: 330R; R_0805
U1: MCP1700-3302E / MCP1703A-3302 (SOT23); SOT-23
U2: STM32F072C8Tx; LQFP-48_7x7mm_P0.5mm
