MaiTheSan/PCB-Design/KiCad/our projects/60 - STM - 072 - 11 - DG - 000 - S (MyS)/MyS/RGBMatrix.sch

## KiCad design KiCad/our projects/60 - STM - 072 - 11 - DG - 000 - S (MyS)/MyS/RGBMatrix.sch (2022-11-19)

Schematic: RGBMatrix.sch

Parts:
RGB1, RGB2, RGB3, RGB4, RGB5, RGB6, RGB7, RGB8, RGB9, RGB10, RGB11, RGB12, RGB13, RGB14, RGB15, RGB16, RGB17, RGB18, RGB33, RGB34, RGB35, RGB36, RGB37, RGB38, RGB39, RGB40, RGB41, RGB42, RGB43, RGB45, RGB46, RGB61, RGB62, RGB63, RGB64, RGB65, RGB66, RGB67, RGB68, RGB69: SK6812; RGB-6028_FLIPPED
RGB19, RGB20, RGB21, RGB22, RGB23, RGB24, RGB25, RGB26, RGB27, RGB28, RGB29, RGB30, RGB31, RGB32: SK6812_FL; RGB-6028
SK6812_FL1, SK6812_FL2, SK6812_FL3, SK6812_FL4, SK6812_FL5, SK6812_FL6, SK6812_FL7, SK6812_FL8, SK6812_FL9, SK6812_FL10, SK6812_FL11, SK6812_FL12, SK6812_FL13, SK6812_FL14, SK6812_FL15: SK6812; RGB-6028
