MaiTheSan/PCB-Design/KiCad/our projects/uso!/Satri2.0/RGB.sch

## KiCad design KiCad/our projects/uso!/Satri2.0/RGB.sch (2022-11-19)

Schematic: RGB.sch

Parts:
SK6812MiniE1, SK6812MiniE2, SK6812MiniE3, SK6812MiniE7, SK6812MiniE8, SK6812MiniE9, SK6812MiniE10, SK6812MiniE11, SK6812MiniE12, SK6812MiniE13, SK6812MiniE14, SK6812MiniE15, SK6812MiniE16, SK6812MiniE17, SK6812MiniE18, SK6812MiniE19, SK6812MiniE20, SK6812MiniE21, SK6812MiniE22, SK6812MiniE23, SK6812MiniE24, SK6812MiniE25, SK6812MiniE26, SK6812MiniE27, SK6812MiniE28, SK6812MiniE29, SK6812MiniE30, SK6812MiniE31, SK6812MiniE32, SK6812MiniE33, SK6812MiniE34, SK6812MiniE35, SK6812MiniE36, SK6812MiniE37, SK6812MiniE38, SK6812MiniE39, SK6812MiniE40, SK6812MiniE41, SK6812MiniE42, SK6812MiniE43: WS2812B; RGB-6028_FLIPPED
SK6812MiniE4, SK6812MiniE5, SK6812MiniE6, SK6812MiniE_F1, SK6812MiniE_F2, SK6812MiniE_F3, SK6812MiniE_F4, SK6812MiniE_F5, SK6812MiniE_F6, SK6812MiniE_F7, SK6812MiniE_F8, SK6812MiniE_F9, SK6812MiniE_F10, SK6812MiniE_F11, SK6812MiniE_F12, SK6812MiniE_F13, SK6812MiniE_F14, SK6812MiniE_F15, SK6812MiniE_F16, SK6812MiniE_F19, SK6812MiniE_F20, SK6812MiniE_F21, SK6812MiniE_F22, SK6812MiniE_F23, SK6812MiniE_F24, SK6812MiniE_F25, SK6812MiniE_F26, SK6812MiniE_F27, SK6812MiniE_F28, SK6812MiniE_F29, SK6812MiniE_F30, SK6812MiniE_F31, SK6812MiniE_F32: WS2812B; RGB-6028
