MaiTheSan/PCB-Design/KiCad/our projects/uso!/uso!VNC Solder/uso!VNC.sch

## KiCad design KiCad/our projects/uso!/uso!VNC Solder/uso!VNC.sch (2022-11-19)

Schematic: uso!VNC.sch

Parts:
C1: 10uF; C_0603
C2, C3: 22pF; C_0603
C4, C5, C7: 0.1uF; C_0603
C6: 1uF; C_0603
C8: CP; CP_EIA-3216
D1, D2, D3, D4, D5, D6, D7, D8, D10, D11, D12, D13, D14, D15, D16, D17, D18, D19, D20, D21, D22, D23, D24, D25, D26, D27, D28, D29, D30, D31, D32, D33, D34, D35, D36, D37, D38, D39, D40, D41, D42, D43, D44, D45, D46, D47, D48, D49, D50, D51, D52, D53, D54, D55, D56, D57, D58, D59, D60, D61, D62, D63, D64, D65, D66, D67, D68, D69, D70, D72: D; D_SOD-123
D9: LED; MXOnly-LEDONLY-FLIPPED
D71: LED; MXOnly-LEDONLY
LOGO1: Logo_Open_Hardware_Large; sanpjxlogo-PCB-type
LOGO2: Logo_Open_Hardware_Large; mounting-circular
LOGO3, LOGO4, LOGO5, LOGO6, LOGO7: Logo_Open_Hardware_Large; mounting-elipse
MX1, MX7, MX12, MX17, MX61, MX66, MX81, MX84: MX-1.25; MXOnly-1.25U-NoLED
MX2, MX3, MX8, MX9, MX10, MX13, MX14, MX15, MX16, MX18, MX19, MX20, MX21, MX22, MX23, MX24, MX25, MX26, MX27, MX28, MX29, MX30, MX31, MX32, MX33, MX35, MX36, MX37, MX38, MX39, MX40, MX41, MX42, MX43, MX44, MX45, MX46, MX47, MX50, MX51, MX52, MX53, MX54, MX56, MX57, MX58, MX59, MX60, MX62, MX63, MX64, MX67, MX69, MX72, MX73, MX75, MX76, MX77, MX78, MX79: MX-NoLED; MXOnly-1U-NoLED
MX4, MX70: MX-NoLED; MXOnly-1.5U-NoLED
MX5: MX-.75; MXOnly-1.75U-NoLED
MX6: MX-2.25; MXOnly-2.25U-NoLED
MX11: MX-NoLED; MXOnly-ISO-ROTATED-ReversedStabilizers-NoLED
MX34: MX-6.25; MXOnly-6.25U-ReversedStabilizers-NoLED
MX48, MX49, MX82, MX83: MX-1.5; MXOnly-1.5U-NoLED
MX55, MX85: MX-1; MXOnly-1U-NoLED
MX65: MX-NoLED; MXOnly-1.75U-NoLED
MX68, MX74: MX-7; MXOnly-7U-ReversedStabilizers-NoLED
MX71: MX-NoLED; MXOnly-2.25U-NoLED
MX80: MX-NoLED; MXOnly-2U-NoLED
R1, R2: 5.1k; R_0805
R3, R4: 22; R_0805
R5: 10k; R_0805
R6: 1k; R_0805
R7, R8: R; R_0805
RGB1, RGB2, RGB3, RGB4, RGB5, RGB6, RGB7, RGB8, RGB9, RGB10, RGB11, RGB12, RGB13, RGB14, RGB15, RGB16: WS2812B; LED_WS2812B_PLCC4_5.0x5.0mm_P3.2mm
SW1: SW_Push; SKQG-1155865
U1: PRTR5V0U2X; SOT143B
U2: ATmega32U4-MU; QFN-44-1EP_7x7mm_P0.5mm_EP5.2x5.2mm_ThermalVias
U3: STF202-22T1G; vcl65-debuger
USB1: HRO-TYPE-C-31-M-12; HRO-TYPE-C-31-M-12-Assembly
Y1: 16Mhz; Crystal_SMD_3225-4Pin_3.2x2.5mm
