MaiTheSan/PCB-Design/Salane Reboot/NEON/Hotswap/NEON Hotswap/NEON Hotswap.sch

## KiCad design Salane Reboot/NEON/Hotswap/NEON Hotswap/NEON Hotswap.sch (2022-11-19)

Schematic: NEON Hotswap.sch

Parts:
C1: 1uF; C_0402
C2: 10uF; C_0402
C3, C4, C5: 0.1uF; C_0402
D1, D2, D3, D4, D5, D6, D7, D8, D9, D10, D11, D12, D13, D14, D15, D16, D17, D18, D19, D20, D21, D22, D23, D24, D25, D26, D27, D28, D29, D31, D32, D33, D34, D35, D36, D37, D38, D39, D40, D41, D42, D43, D46, D47, D48, D49, D50, D51, D52, D53, D54, D55, D56, D57, D58, D59, D61, D62, D63, D67, D72, D73, D74: CD4148W; DIODE_1206_SawnsProjects
MX1, MX2, MX3, MX4, MX5, MX6, MX7, MX8, MX9, MX10, MX11, MX12, MX13, MX14, MX15, MX17, MX18, MX19, MX20, MX21, MX22, MX23, MX24, MX25, MX26, MX27, MX28, MX32, MX33, MX34, MX35, MX36, MX37, MX38, MX39, MX40, MX41, MX42, MX47, MX48, MX49, MX50, MX51, MX52, MX53, MX54, MX55, MX56, MX57, MX59, MX62, MX65: 1U; MXOnly-1U-Hotswap-Sawns
MX16, MX29, MX61, MX63, MX64, MX66: 1.5U; MXOnly-1.5U-Hotswap-Sawns
MX30, MX46: 1.25U; MXOnly-1.25U-Hotswap-Sawns
MX31, MX58: 1.75U; MXOnly-1.75U-Hotswap-Sawns
MX43: 2.25U; MXOnly-2.25U-Hotswap-ReversedStabilizers-Sawns
MX67: 7U; MXOnly-7U-Hotswap-Sawns
MX76: 2U; MXOnly-2U-Hotswap-Sawns
R1, R2: 10k
U1: ATmega32U4-MU; QFN-44-1EP_7x7mm_P0.5mm_EP5.2x5.2mm_ThermalVias
Y1: 16MHz; Resonator_SMD_muRata_CSTxExxV-3Pin_3.0x1.1mm
