MaiTheSan/PCB-Design/Salane Reboot/[A]ddiction/[A]ddiction 2x 2.0/Addiction 2x/Addiction 2x.sch

## KiCad design Salane Reboot/[A]ddiction/[A]ddiction 2x 2.0/Addiction 2x/Addiction 2x.sch (2022-11-19)

Schematic: Addiction 2x.sch

Parts:
D1, D2, D3, D4, D5, D6, D7, D8, D9, D10, D11, D12, D13, D14, D15, D16, D17, D18, D19, D20, D21, D22, D23, D24: 1N4148W; DIODE_1206_SawnsProjects
MX1, MX2, MX3, MX4, MX5, MX6, MX7, MX8, MX9, MX10, MX11, MX12, MX14, MX15, MX16, MX17, MX18, MX20, MX21, MX22, MX23, MX24, MX26, MX27: 1U; MXOnly-1U-NoLED
MX13, MX19, MX25: 2U; MXOnly-2U-ReversedStabilizers-NoLED
SW1: Rotary_Encoder_Switch; RotaryEncoder_Alps_EC11E-Switch_Vertical_H20mm_Center
U1: ATmega32U2-MU; QFN-32-1EP_5x5mm_P0.5mm_EP3.1x3.1mm
