MaiTheSan/PCB-Design/KiCad/3-2022/75F/75F/75F/75F.sch

## KiCad design KiCad/3-2022/75F/75F/75F/75F.sch (2022-11-19)

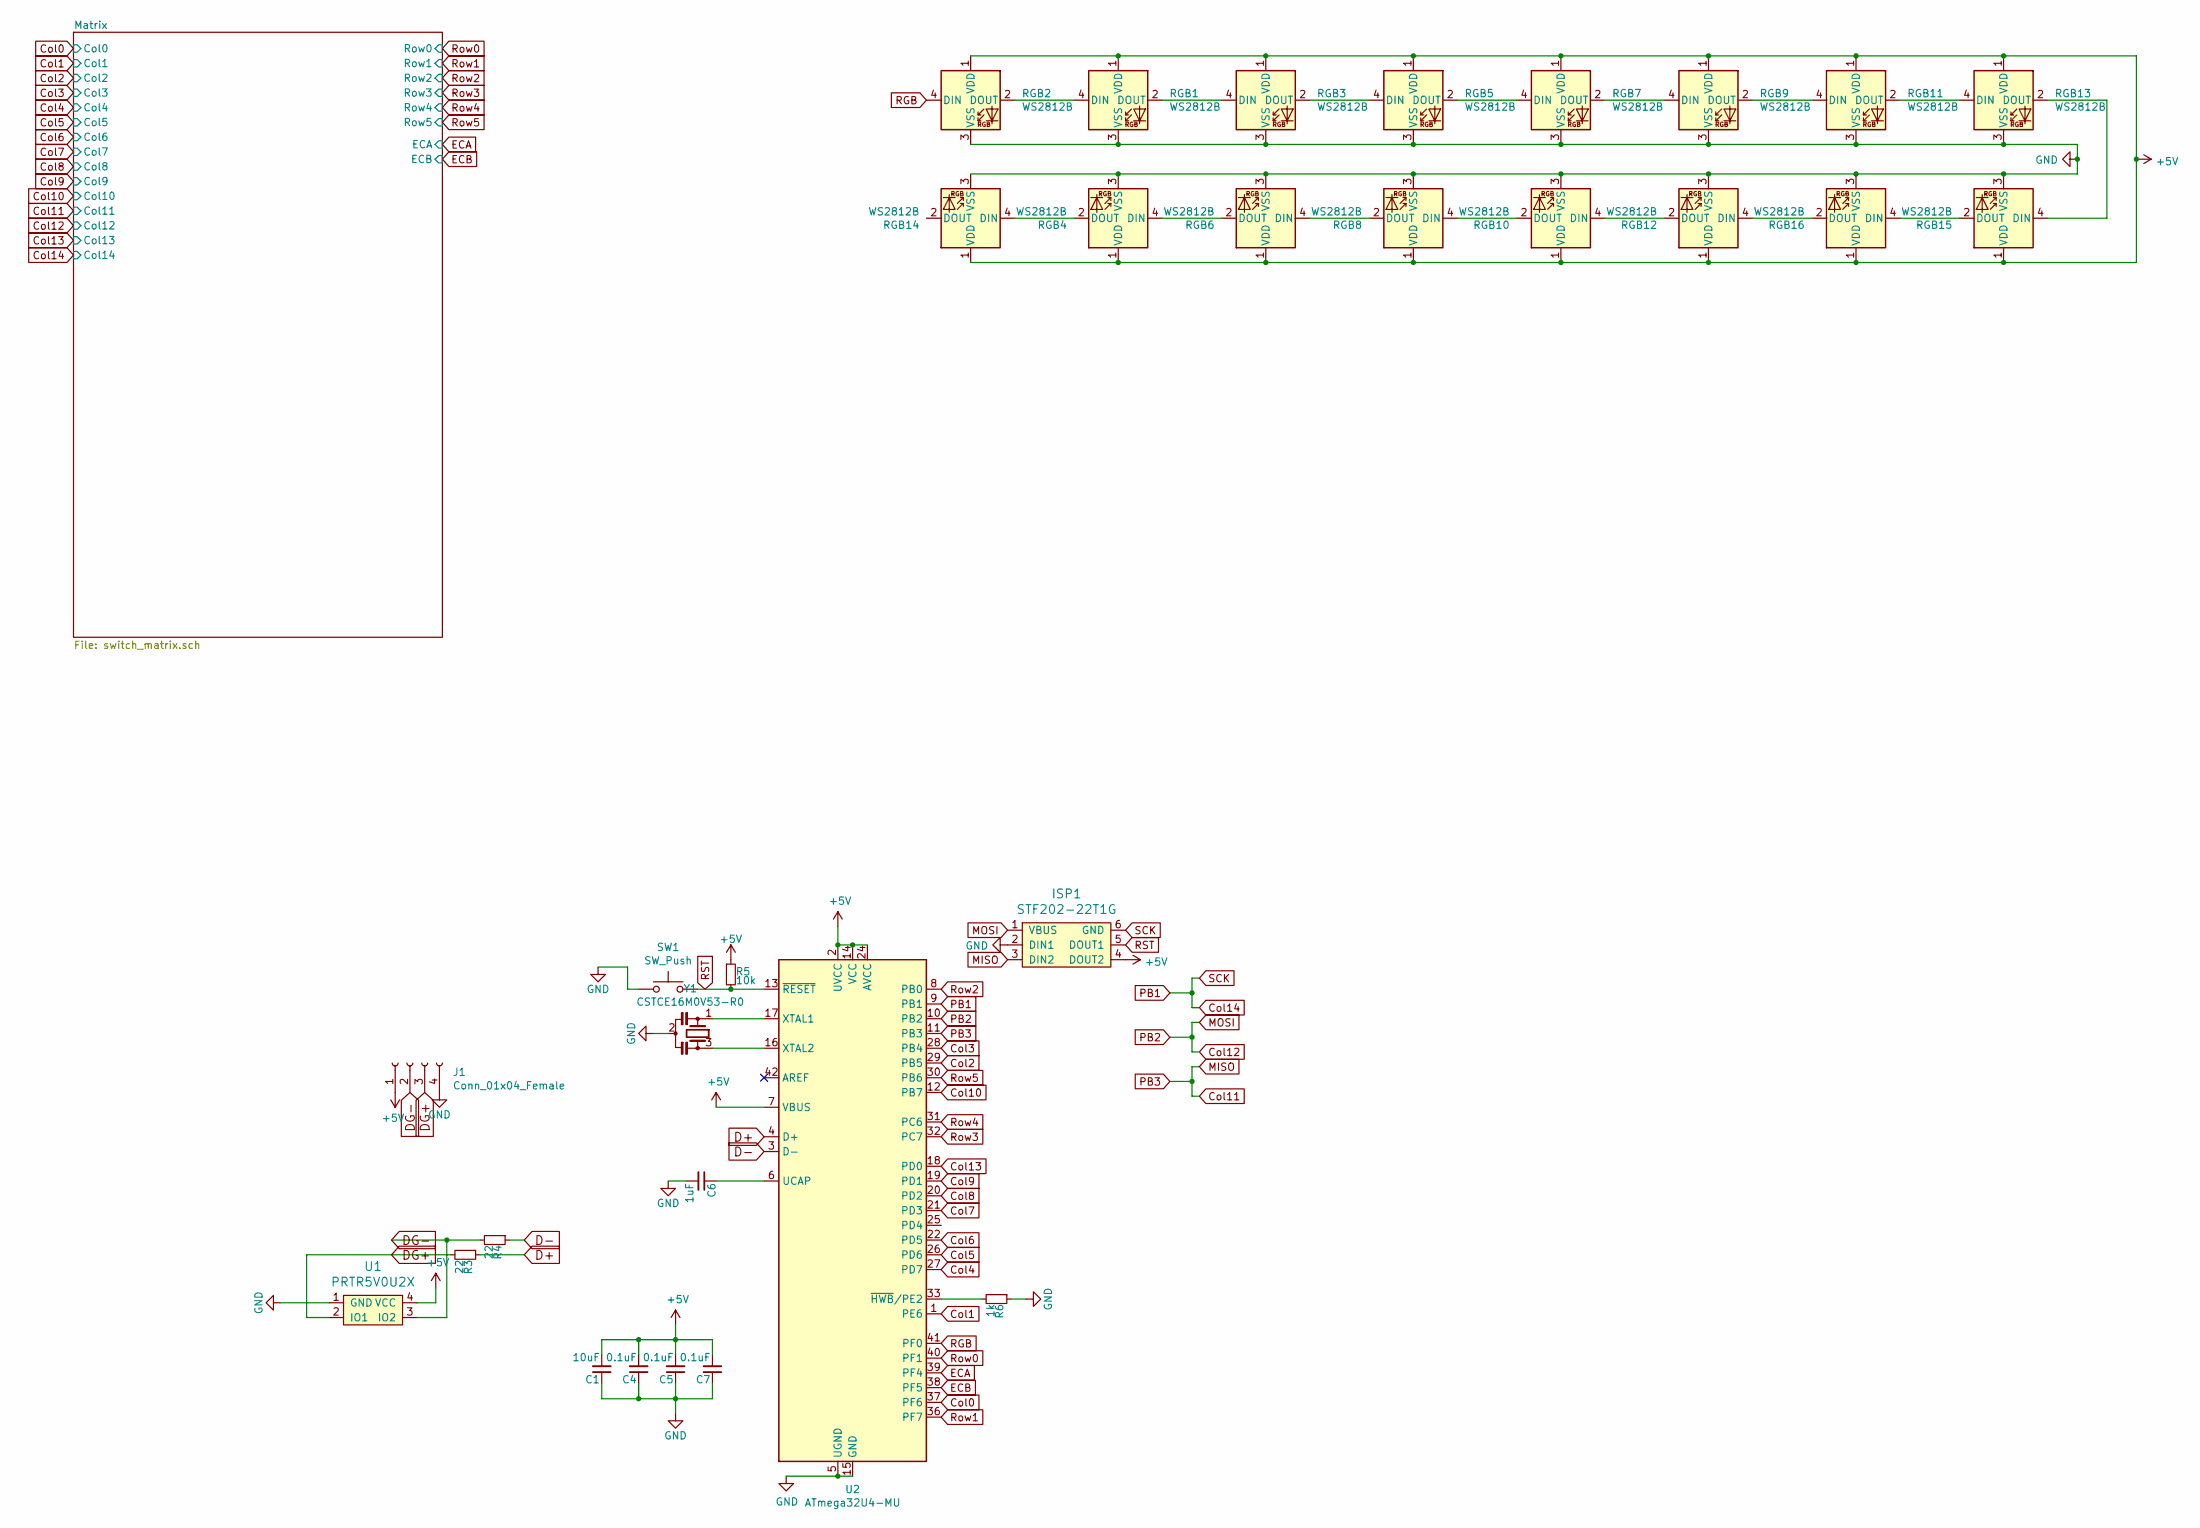
[picture p231: schematic 75F.sch]

Parts:
C1: 10uF; C_0603
C4, C5, C7: 0.1uF; C_0603
C6: 1uF; C_0603
ISP1: STF202-22T1G; Tag-Connect_TC2030-IDC-NL_2x03_P1.27mm_Vertical
J1: Conn_01x04_Female; JST-SR-4
R3, R4: 22; R_0805
R5: 10k; R_0805
R6: 1k; R_0805
RGB1, RGB2, RGB3, RGB4, RGB5, RGB6, RGB7, RGB8, RGB9, RGB10, RGB11, RGB12, RGB13, RGB15, RGB16: WS2812B; LED_WS2812B_PLCC4_5.0x5.0mm_P3.2mm
RGB14: WS2812B; RGB-6028_FLIPPED
SW1: SW_Push; SKQG-1155865
U1: PRTR5V0U2X; SOT143B
U2: ATmega32U4-MU; QFN-44-1EP_7x7mm_P0.5mm_EP5.15x5.15mm
Y1: CSTCE16M0V53-R0; Resonator_SMD_muRata_CSTxExxV-3Pin_3.0x1.1mm

Connections:
+5V: C1.2, C4.2, C5.2, C7.2, ISP1.4 (DOUT2), J1.1, R5.1, RGB1.1 (VDD), RGB2.1 (VDD), RGB3.1 (VDD), RGB4.1 (VDD), RGB5.1 (VDD), RGB6.1 (VDD), RGB7.1 (VDD), RGB8.1 (VDD), RGB9.1 (VDD), RGB10.1 (VDD), RGB11.1 (VDD), RGB12.1 (VDD), RGB13.1 (VDD), RGB14.1 (VDD), RGB15.1 (VDD), RGB16.1 (VDD), U1.4 (VCC), U2.2 (UVCC), U2.7 (VBUS), U2.14 (VCC), U2.24 (AVCC), U2.34 (VCC), U2.44 (AVCC)
Col0: U2.37 (PF6)
Col1: U2.1 (PE6)
Col2: U2.29 (PB5)
Col3: U2.28 (PB4)
Col4: U2.27 (PD7)
Col5: U2.26 (PD6)
Col6: U2.22 (PD5)
Col7: U2.21 (PD3)
Col8: U2.20 (PD2)
Col9: U2.19 (PD1)
Col10: U2.12 (PB7)
Col11: ISP1.3 (DIN2), U2.11 (PB3)
Col12: ISP1.1 (VBUS), U2.10 (PB2)
Col13: U2.18 (PD0)
Col14: ISP1.6 (GND), U2.9 (PB1)
D+: R3.1, U2.4 (D+)
D-: R4.1, U2.3 (D-)
DG+: J1.3, R3.2, U1.2 (IO1)
DG-: J1.2, R4.2, U1.3 (IO2)
ECA: U2.39 (PF4)
ECB: U2.38 (PF5)
GND: C1.1, C4.1, C5.1, C6.2, C7.1, ISP1.2 (DIN1), J1.4, R6.1, RGB1.3 (VSS), RGB2.3 (VSS), RGB3.3 (VSS), RGB4.3 (VSS), RGB5.3 (VSS), RGB6.3 (VSS), RGB7.3 (VSS), RGB8.3 (VSS), RGB9.3 (VSS), RGB10.3 (VSS), RGB11.3 (VSS), RGB12.3 (VSS), RGB13.3 (VSS), RGB14.3 (VSS), RGB15.3 (VSS), RGB16.3 (VSS), SW1.1, U1.1 (GND), U2.5 (UGND), U2.15 (GND), U2.23 (GND), U2.35 (GND), U2.43 (GND), U2.45 (GND), Y1.2
unnamed: C6.1, U2.6 (UCAP)
unnamed: R6.2, U2.33 (~HWB~/PE2)
unnamed: RGB1.2 (DOUT), RGB3.4 (DIN)
unnamed: RGB1.4 (DIN), RGB2.2 (DOUT)
unnamed: RGB3.2 (DOUT), RGB5.4 (DIN)
unnamed: RGB4.4 (DIN), RGB6.2 (DOUT)
unnamed: RGB5.2 (DOUT), RGB7.4 (DIN)
unnamed: RGB6.4 (DIN), RGB8.2 (DOUT)
unnamed: RGB7.2 (DOUT), RGB9.4 (DIN)
unnamed: RGB8.4 (DIN), RGB10.2 (DOUT)
unnamed: RGB10.4 (DIN), RGB12.2 (DOUT)
unnamed: RGB11.2 (DOUT), RGB13.4 (DIN)
unnamed: RGB9.2 (DOUT), RGB11.4 (DIN)
unnamed: RGB12.4 (DIN), RGB16.2 (DOUT)
unnamed: RGB13.2 (DOUT), RGB15.4 (DIN)
unnamed: RGB4.2 (DOUT), RGB14.4 (DIN)
unnamed: RGB15.2 (DOUT), RGB16.4 (DIN)
unnamed: U2.16 (XTAL2), Y1.3
unnamed: U2.17 (XTAL1), Y1.1
RGB: RGB2.4 (DIN), U2.41 (PF0)
RST: ISP1.5 (DOUT1), R5.2, SW1.2, U2.13 (~RESET)
Row0: U2.40 (PF1)
Row1: U2.36 (PF7)
Row2: U2.8 (PB0)
Row3: U2.32 (PC7)
Row4: U2.31 (PC6)
Row5: U2.30 (PB6)
