MaiTheSan/PCB-Design/KiCad/3-2022/75F/75F/75F/led_matrix.sch

## KiCad design KiCad/3-2022/75F/75F/75F/led_matrix.sch (2022-11-19)

Schematic: led_matrix.sch

Parts:
C10, C11, C12, C14, C15, C16: 0.1uF; C_0603
C13: 22uF; CP_EIA-3216
C17, C18, C19, C20, C21, C22, C23, C24: 0.47uF; C_0603
L_D1, L_D2, L_D3, L_D5, L_D6, L_D7, L_D9, L_D10, L_D11, L_D13, L_D14, L_D15, L_D17, L_D18, L_D19, L_D21, L_D22, L_D23, L_D25, L_D26, L_D27, L_D29, L_D30, L_D31, L_D33, L_D34, L_D35, L_D37, L_D38, L_D39, L_D41, L_D42, L_D43, L_D45, L_D46, L_D47, L_D49, L_D50, L_D51, L_D53, L_D54, L_D55, L_D57, L_D58, L_D59, L_D61, L_D62, L_D63, L_D65, L_D66, L_D67, L_D69, L_D70, L_D71, L_D73, L_D74, L_D75, L_D77, L_D78, L_D79, L_D81, L_D82, L_D83, L_D85, L_D86, L_D87, L_D89, L_D90, L_D91, L_D93, L_D94, L_D95, L_D97, L_D98, L_D99, L_D101, L_D102, L_D103, L_D105, L_D106, L_D107, L_D109, L_D110, L_D111, L_D113, L_D114, L_D115, L_D117, L_D118, L_D119, L_D121, L_D122, L_D123, L_D125, L_D126, L_D127: LED_GRAB; RGB-D-6028_FLIPPED
R11, R14: 100k; R_0805
R12, R15: 20k; R_0805
R13, R16: 1k; R_0805
U4, U5: IS31FL3733-QF; QFN-48-1EP_6x6mm_P0.4mm_EP4.2x4.2mm
