MaiTheSan/PCB-Design/KiCad/06-2021 comm/burh/PCB/rescue-backup/ledmatrix-2021-07-01-04-46-33.sch

## KiCad design KiCad/06-2021 comm/burh/PCB/rescue-backup/ledmatrix-2021-07-01-04-46-33.sch (2022-11-19)

Schematic: ledmatrix-2021-07-01-04-46-33.sch

Parts:
CLED1, CLED2, CLED3, CLED4: 0.1 uF; SMD_0805
LED2:2, LED2:3, LED3:1, LED3:2, LED3:3, LED3:4, LED4:1, LED4:1_2, LED4:2, LED4:3, LED4:4, LED4:4_2, LED5:1, LED5:2, LED5:3, LED5:4, LED6:1, LED6:1_2, LED6:1_3, LED6:2, LED6:3, LED6:4, LED6:4_2, LED6:4_3: LED; INSW_LEDS_REG
LEDG1, LEDG2, LEDG3, LEDG4: WS2812B
LEDI1, LEDI2, LEDI3, LEDI4, LEDI5, LEDI6: LED; INSW_LEDS_REG
LEDI7: LED; LED_0805
R24: 330; SMD_0805
RI1, RI2, RI3, RI4, RI5, RI6, RI7: 470; SMD_0805

Notes on the sheet:
Left side backlight matrix
RGB LEDs
Indicator LEDs
