MaiTheSan/PCB-Design/KiCad/06-2021 comm/burh/PCB/rescue-backup/mcu-2021-07-01-04-45-39.sch

## KiCad design KiCad/06-2021 comm/burh/PCB/rescue-backup/mcu-2021-07-01-04-45-39.sch (2022-11-19)

Schematic: mcu-2021-07-01-04-45-39.sch

Parts:
BZ1: BUZZER; BUZZER_SMT
C1, C2, C22, C23: 1uF; SMD_0805
C3, C4, C5, C6, C7, C8: 0.1uF; SMD_0805
C9, C17, C18: 10uF; SMD_0805
C13, C14: 8pF; SMD_0805
F1: PTC FUSE; Fuse_SMD1206
JP1: JUMPER; JUMPER_SMD_3
L2: 4.7uH; Inductor_Bourn_4mmx4mm
P1, P1_2: USB_CONN; USB_Micro-B
P4, P5: CONN_6; Pin_Header_1x06
P6: ISP6; TC2030_BIG
R1, R34, R35: 10k; SMD_0805
R3, R4: 22; SMD_0805
R14: 100k; SMD_0805
R25: RLED; SMD_0805
R33: 100; SMD_0805
S1: TAC_SWITCH; TACT_5.2x5.2
S2: ENCODER; ENCODER_12MM
U1: ATMEGA32U4; TQFP44
U3: IP4234CZ6; SOT457
U5: PAM2804; SOT-23-5
X1: CRYSTAL; NX3225SA

Notes on the sheet:
USB Circuit
Backlight constant current supply
ISP Tag Connect
Crystal
MCU RESET
Buzzer (Optional)
Debug headers
Microcontroller
HWBE Jumper
Decoupling capacitors
Rotary Encoder (Optional)
