MaiTheSan/PCB-Design/KiCad/12-2021/Amber80/hotswap/hotswap/hotswap.sch

## KiCad design KiCad/12-2021/Amber80/hotswap/hotswap/hotswap.sch (2022-11-19)

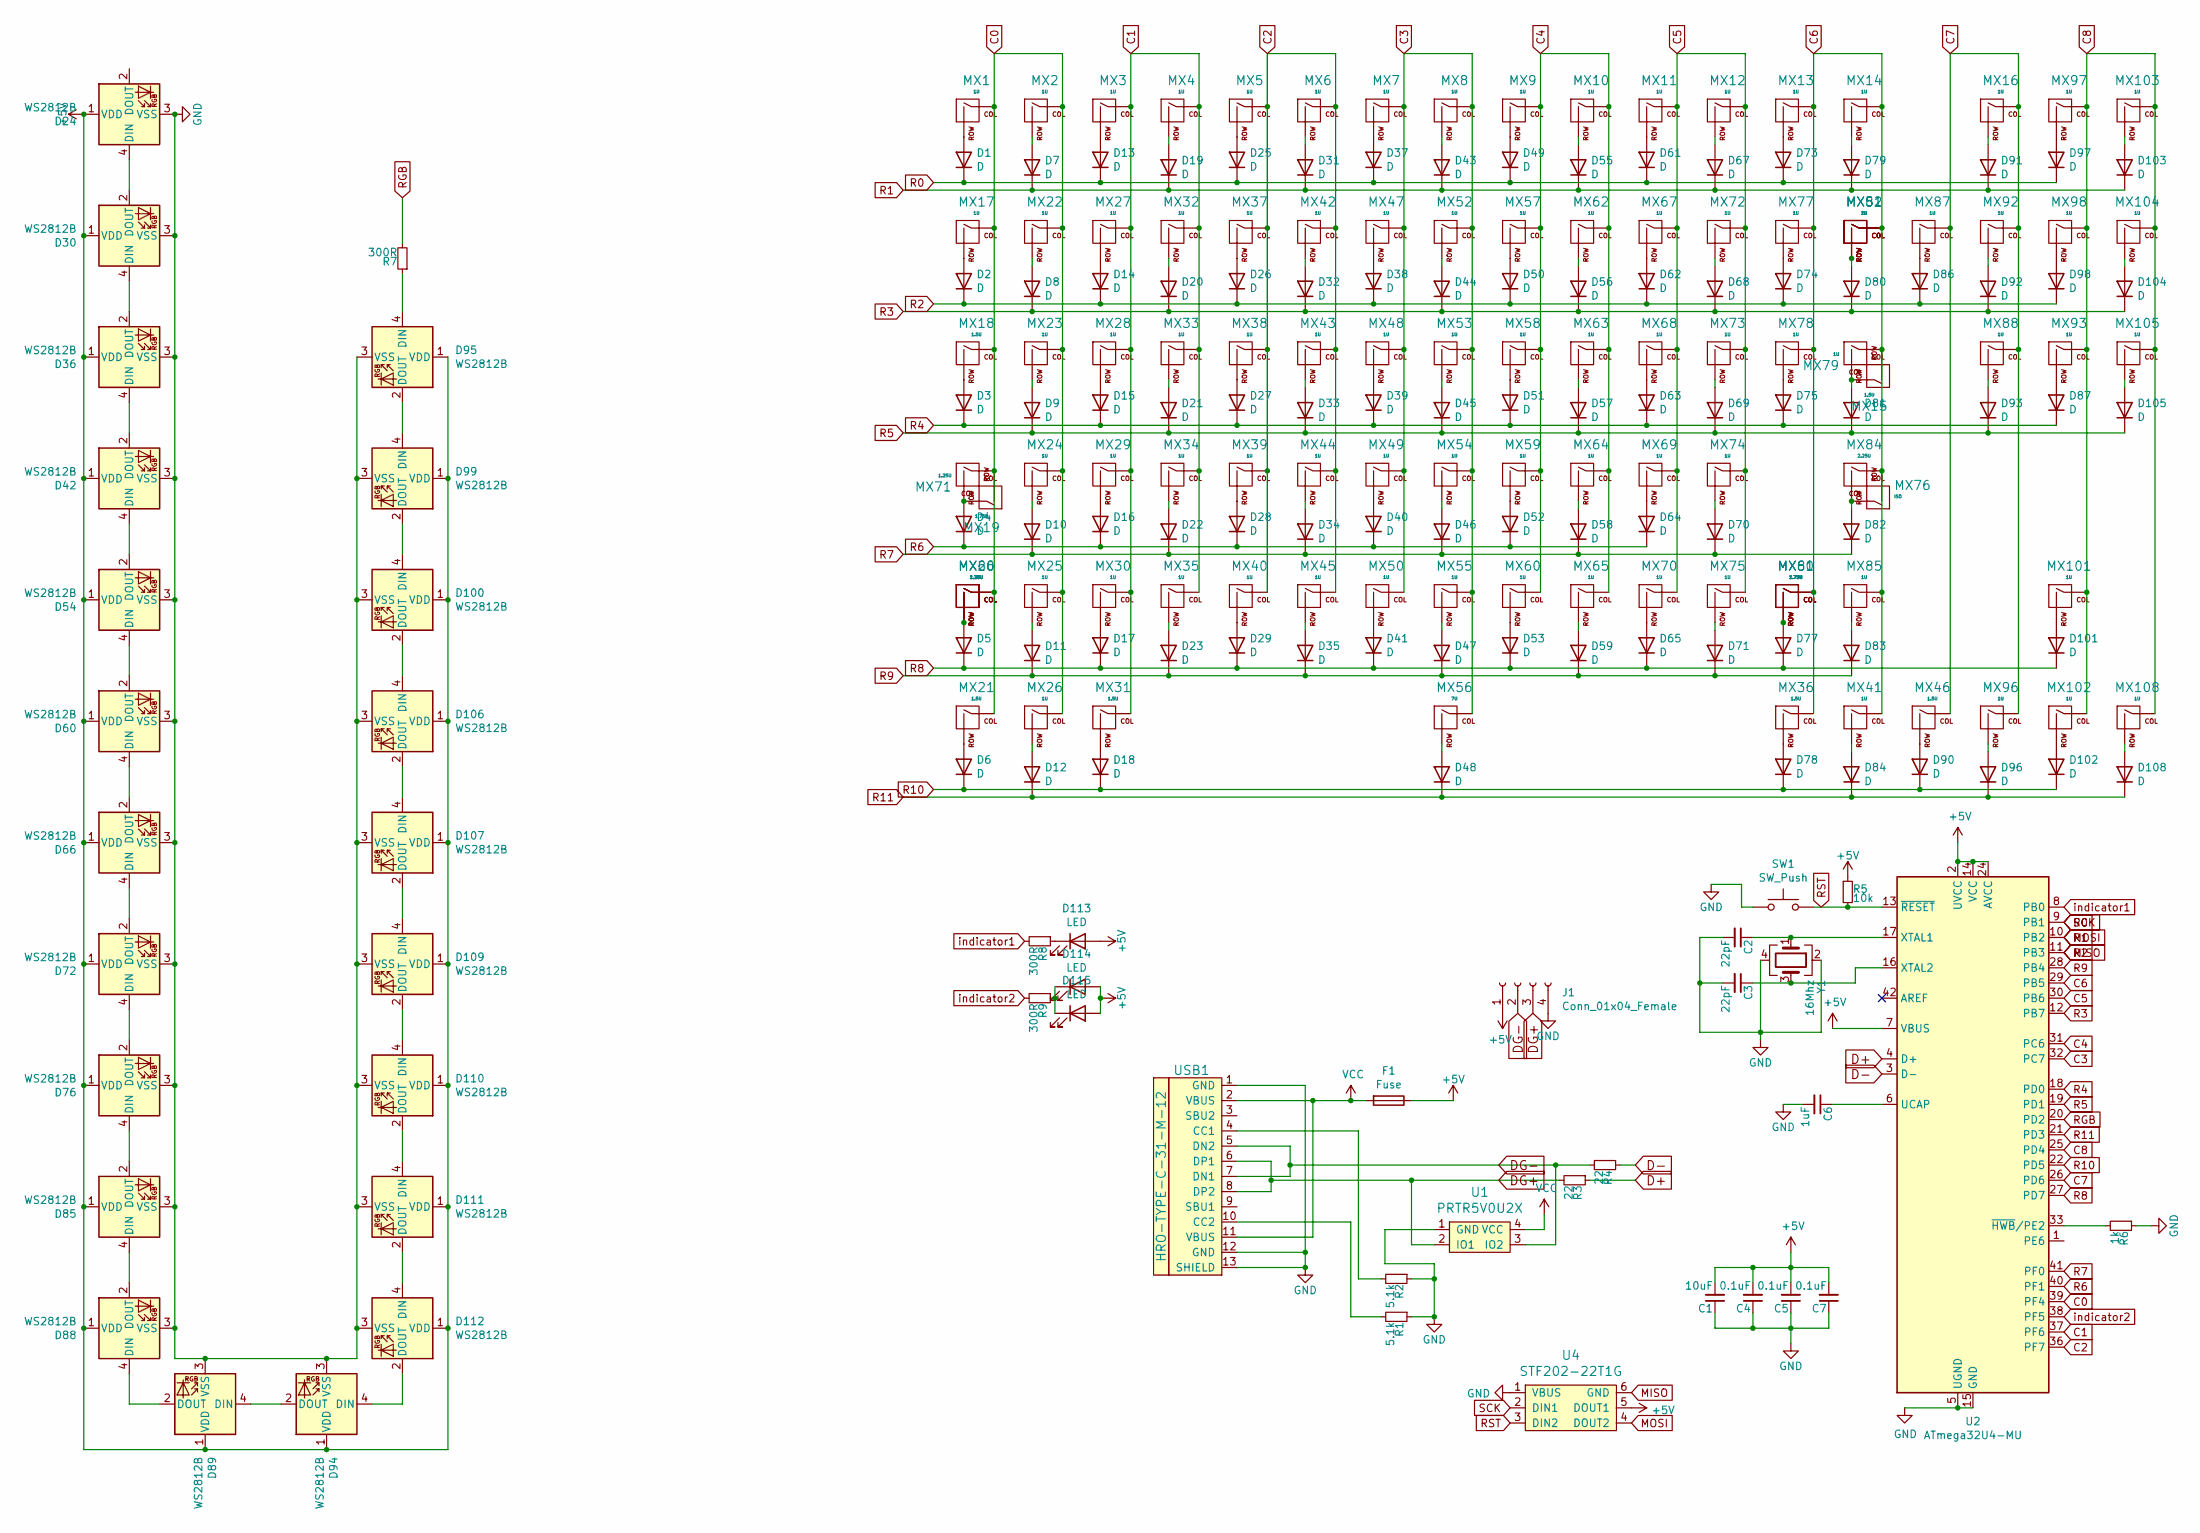
[picture p233: schematic hotswap.sch]

Parts:
C1: 10uF; C_0603
C2, C3: 22pF; C_0603
C4, C5, C7: 0.1uF; C_0603
C6: 1uF; C_0603
D1, D2, D3, D4, D5, D6, D7, D8, D9, D10, D11, D12, D13, D14, D15, D16, D17, D18, D19, D20, D21, D22, D23, D25, D26, D27, D28, D29, D31, D32, D33, D34, D35, D37, D38, D39, D40, D41, D43, D44, D45, D46, D47, D48, D49, D50, D51, D52, D53, D55, D56, D57, D58, D59, D61, D62, D63, D64, D65, D67, D68, D69, D70, D71, D73, D74, D75, D77, D78, D79, D80, D81, D82, D83, D84, D86, D87, D90, D91, D92, D93, D96, D97, D98, D101, D102, D103, D104, D105, D108: D; DIODE_1206_SawnsProjects
D24, D30, D36, D42, D54, D60, D66, D72, D76, D85, D88, D89, D94, D95, D99, D100, D106, D107, D109, D110, D111, D112: WS2812B; LED_WS2812B_PLCC4_5.0x5.0mm_P3.2mm
D113, D115: LED; MXOnly-LEDONLY-FLIPPED
D114: LED; MXOnly-LEDONLY
F1: Fuse; Fuse_SMD1206_Reflow
J1: Conn_01x04_Female; JST-SR-4
MX1, MX2, MX3, MX4, MX5, MX6, MX7, MX8, MX9, MX10, MX11, MX12, MX13, MX14, MX16, MX17, MX22, MX23, MX24, MX25, MX26, MX27, MX28, MX29, MX30, MX32, MX33, MX34, MX35, MX37, MX38, MX39, MX40, MX41, MX42, MX43, MX44, MX45, MX47, MX48, MX49, MX50, MX52, MX53, MX54, MX55, MX57, MX58, MX59, MX60, MX62, MX63, MX64, MX65, MX67, MX68, MX69, MX70, MX72, MX73, MX74, MX75, MX77, MX78, MX79, MX82, MX85, MX87, MX88, MX92, MX93, MX96, MX97, MX98, MX101, MX102, MX103, MX104, MX105, MX108: 1U; MXOnly-1U-Hotswap-Sawns
MX15, MX18, MX21, MX31, MX36, MX46: 1.5U; MXOnly-1.5U-Hotswap-Sawns
MX19, MX80: 1.75U; MXOnly-1.75U-Hotswap-Sawns
MX20, MX71: 1.25U; MXOnly-1.25U-Hotswap-Sawns
MX51: 2U; MXOnly-2U-Hotswap-Sawns
MX56: 7U; MXOnly-7U-Hotswap-ReversedStabilizers-Sawns
MX61: 2.75U; MXOnly-2.75U-Hotswap-Sawns
MX66: 2.25U; MXOnly-2.25U-Hotswap-Sawns
MX76: ISO; MXOnly-ISO-ROTATED-ReversedStabilizers-NoLED
MX84: 2.25U; MXOnly-2.75U-Hotswap-ReversedStabilizers-Sawns
R1, R2: 5.1k; R_0805
R3, R4: 22; R_0805
R5: 10k; R_0805
R6: 1k; R_0805
R7, R8, R9: 300R; R_0805
SW1: SW_Push; SKQG-1155865-fix
U1: PRTR5V0U2X; SOT143B
U2: ATmega32U4-MU; QFN-44-1EP_7x7mm_P0.5mm_EP5.15x5.15mm
U4: STF202-22T1G; Tag-Connect_TC2030-IDC-NL_2x03_P1.27mm_Vertical
USB1: HRO-TYPE-C-31-M-12; HRO-TYPE-C-31-M-12-Assembly
Y1: 16Mhz; Crystal_SMD_3225-4Pin_3.2x2.5mm

Connections:
+5V: C1.2, C4.2, C5.2, C7.2, D24.1 (VDD), D30.1 (VDD), D36.1 (VDD), D42.1 (VDD), D54.1 (VDD), D60.1 (VDD), D66.1 (VDD), D72.1 (VDD), D76.1 (VDD), D85.1 (VDD), D88.1 (VDD), D89.1 (VDD), D94.1 (VDD), D95.1 (VDD), D99.1 (VDD), D100.1 (VDD), D106.1 (VDD), D107.1 (VDD), D109.1 (VDD), D110.1 (VDD), D111.1 (VDD), D112.1 (VDD), D113.2 (A), D114.2 (A), D115.2 (A), F1.1, J1.1, R5.1, U2.2 (UVCC), U2.7 (VBUS), U2.14 (VCC), U2.24 (AVCC), U2.34 (VCC), U2.44 (AVCC), U4.5 (DOUT1)
C0: MX1.1 (COL), MX2.1 (COL), MX17.1 (COL), MX18.1 (COL), MX19.2 (ROW), MX20.1 (COL), MX21.1 (COL), MX22.1 (COL), MX23.1 (COL), MX24.1 (COL), MX25.1 (COL), MX26.1 (COL), MX66.1 (COL), MX71.1 (COL), U2.39 (PF4)
C1: MX3.1 (COL), MX4.1 (COL), MX27.1 (COL), MX28.1 (COL), MX29.1 (COL), MX30.1 (COL), MX31.1 (COL), MX32.1 (COL), MX33.1 (COL), MX34.1 (COL), MX35.1 (COL), U2.37 (PF6)
C2: MX5.1 (COL), MX6.1 (COL), MX37.1 (COL), MX38.1 (COL), MX39.1 (COL), MX40.1 (COL), MX42.1 (COL), MX43.1 (COL), MX44.1 (COL), MX45.1 (COL), U2.36 (PF7)
C3: MX7.1 (COL), MX8.1 (COL), MX47.1 (COL), MX48.1 (COL), MX49.1 (COL), MX50.1 (COL), MX52.1 (COL), MX53.1 (COL), MX54.1 (COL), MX55.1 (COL), MX56.1 (COL), U2.32 (PC7)
C4: MX9.1 (COL), MX10.1 (COL), MX57.1 (COL), MX58.1 (COL), MX59.1 (COL), MX60.1 (COL), MX62.1 (COL), MX63.1 (COL), MX64.1 (COL), MX65.1 (COL), U2.31 (PC6)
C5: MX11.1 (COL), MX12.1 (COL), MX67.1 (COL), MX68.1 (COL), MX69.1 (COL), MX70.1 (COL), MX72.1 (COL), MX73.1 (COL), MX74.1 (COL), MX75.1 (COL), U2.30 (PB6)
C6: MX13.1 (COL), MX14.1 (COL), MX15.2 (ROW), MX36.1 (COL), MX41.1 (COL), MX51.1 (COL), MX61.1 (COL), MX76.2 (ROW), MX77.1 (COL), MX78.1 (COL), MX79.1 (COL), MX80.1 (COL), MX82.1 (COL), MX84.1 (COL), MX85.1 (COL), U2.29 (PB5)
C7: MX16.1 (COL), MX46.1 (COL), MX87.1 (COL), MX88.1 (COL), MX92.1 (COL), MX96.1 (COL), U2.26 (PD6)
C8: MX93.1 (COL), MX97.1 (COL), MX98.1 (COL), MX101.1 (COL), MX102.1 (COL), MX103.1 (COL), MX104.1 (COL), MX105.1 (COL), MX108.1 (COL), U2.25 (PD4)
D+: R3.1, U2.4 (D+)
D-: R4.1, U2.3 (D-)
DG+: J1.3, R3.2, U1.2 (IO1), USB1.6 (DP1), USB1.8 (DP2)
DG-: J1.2, R4.2, U1.3 (IO2), USB1.5 (DN2), USB1.7 (DN1)
GND: C1.1, C2.2, C3.2, C4.1, C5.1, C6.2, C7.1, D24.3 (VSS), D30.3 (VSS), D36.3 (VSS), D42.3 (VSS), D54.3 (VSS), D60.3 (VSS), D66.3 (VSS), D72.3 (VSS), D76.3 (VSS), D85.3 (VSS), D88.3 (VSS), D89.3 (VSS), D94.3 (VSS), D95.3 (VSS), D99.3 (VSS), D100.3 (VSS), D106.3 (VSS), D107.3 (VSS), D109.3 (VSS), D110.3 (VSS), D111.3 (VSS), D112.3 (VSS), J1.4, R1.1, R2.1, R6.1, SW1.1, U1.1 (GND), U2.5 (UGND), U2.15 (GND), U2.23 (GND), U2.35 (GND), U2.43 (GND), U2.45 (GND), U4.1 (VBUS), USB1.1 (GND), USB1.12 (GND), USB1.13 (SHIELD), Y1.2, Y1.4
MISO: D2.1 (K), D14.1 (K), D26.1 (K), D38.1 (K), D50.1 (K), D62.1 (K), D74.1 (K), D86.1 (K), D98.1 (K), U2.11 (PB3), U4.6 (GND)
MOSI: D7.1 (K), D19.1 (K), D31.1 (K), D43.1 (K), D55.1 (K), D67.1 (K), D79.1 (K), D91.1 (K), D103.1 (K), U2.10 (PB2), U4.4 (DOUT2)
unnamed: C2.1, U2.17 (XTAL1), Y1.1
unnamed: C3.1, U2.16 (XTAL2), Y1.3
unnamed: C6.1, U2.6 (UCAP)
unnamed: D1.2 (A), MX1.2 (ROW)
unnamed: D2.2 (A), MX17.2 (ROW)
unnamed: D3.2 (A), MX18.2 (ROW)
unnamed: D4.2 (A), MX19.1 (COL), MX71.2 (ROW)
unnamed: D5.2 (A), MX20.2 (ROW), MX66.2 (ROW)
unnamed: D6.2 (A), MX21.2 (ROW)
unnamed: D7.2 (A), MX2.2 (ROW)
unnamed: D8.2 (A), MX22.2 (ROW)
unnamed: D9.2 (A), MX23.2 (ROW)
unnamed: D10.2 (A), MX24.2 (ROW)
unnamed: D11.2 (A), MX25.2 (ROW)
unnamed: D12.2 (A), MX26.2 (ROW)
unnamed: D13.2 (A), MX3.2 (ROW)
unnamed: D14.2 (A), MX27.2 (ROW)
unnamed: D15.2 (A), MX28.2 (ROW)
unnamed: D16.2 (A), MX29.2 (ROW)
unnamed: D17.2 (A), MX30.2 (ROW)
unnamed: D18.2 (A), MX31.2 (ROW)
unnamed: D19.2 (A), MX4.2 (ROW)
unnamed: D20.2 (A), MX32.2 (ROW)
unnamed: D21.2 (A), MX33.2 (ROW)
unnamed: D22.2 (A), MX34.2 (ROW)
unnamed: D23.2 (A), MX35.2 (ROW)
unnamed: D24.4 (DIN), D30.2 (DOUT)
unnamed: D25.2 (A), MX5.2 (ROW)
unnamed: D26.2 (A), MX37.2 (ROW)
unnamed: D27.2 (A), MX38.2 (ROW)
unnamed: D28.2 (A), MX39.2 (ROW)
unnamed: D29.2 (A), MX40.2 (ROW)
unnamed: D30.4 (DIN), D36.2 (DOUT)
unnamed: D31.2 (A), MX6.2 (ROW)
unnamed: D32.2 (A), MX42.2 (ROW)
unnamed: D33.2 (A), MX43.2 (ROW)
unnamed: D34.2 (A), MX44.2 (ROW)
unnamed: D35.2 (A), MX45.2 (ROW)
unnamed: D36.4 (DIN), D42.2 (DOUT)
unnamed: D37.2 (A), MX7.2 (ROW)
unnamed: D38.2 (A), MX47.2 (ROW)
unnamed: D39.2 (A), MX48.2 (ROW)
unnamed: D40.2 (A), MX49.2 (ROW)
unnamed: D41.2 (A), MX50.2 (ROW)
unnamed: D42.4 (DIN), D54.2 (DOUT)
unnamed: D43.2 (A), MX8.2 (ROW)
unnamed: D44.2 (A), MX52.2 (ROW)
unnamed: D45.2 (A), MX53.2 (ROW)
unnamed: D46.2 (A), MX54.2 (ROW)
unnamed: D47.2 (A), MX55.2 (ROW)
unnamed: D48.2 (A), MX56.2 (ROW)
unnamed: D49.2 (A), MX9.2 (ROW)
unnamed: D50.2 (A), MX57.2 (ROW)
unnamed: D51.2 (A), MX58.2 (ROW)
unnamed: D52.2 (A), MX59.2 (ROW)
unnamed: D53.2 (A), MX60.2 (ROW)
unnamed: D54.4 (DIN), D60.2 (DOUT)
unnamed: D55.2 (A), MX10.2 (ROW)
unnamed: D56.2 (A), MX62.2 (ROW)
unnamed: D57.2 (A), MX63.2 (ROW)
unnamed: D58.2 (A), MX64.2 (ROW)
unnamed: D59.2 (A), MX65.2 (ROW)
unnamed: D60.4 (DIN), D66.2 (DOUT)
unnamed: D61.2 (A), MX11.2 (ROW)
unnamed: D62.2 (A), MX67.2 (ROW)
unnamed: D63.2 (A), MX68.2 (ROW)
unnamed: D64.2 (A), MX69.2 (ROW)
unnamed: D65.2 (A), MX70.2 (ROW)
unnamed: D66.4 (DIN), D72.2 (DOUT)
unnamed: D67.2 (A), MX12.2 (ROW)
unnamed: D68.2 (A), MX72.2 (ROW)
unnamed: D69.2 (A), MX73.2 (ROW)
unnamed: D70.2 (A), MX74.2 (ROW)
unnamed: D71.2 (A), MX75.2 (ROW)
unnamed: D72.4 (DIN), D76.2 (DOUT)
unnamed: D73.2 (A), MX13.2 (ROW)
unnamed: D74.2 (A), MX77.2 (ROW)
unnamed: D75.2 (A), MX78.2 (ROW)
unnamed: D76.4 (DIN), D85.2 (DOUT)
unnamed: D77.2 (A), MX61.2 (ROW), MX80.2 (ROW)
unnamed: D78.2 (A), MX36.2 (ROW)
unnamed: D79.2 (A), MX14.2 (ROW)
unnamed: D80.2 (A), MX51.2 (ROW), MX82.2 (ROW)
unnamed: D81.2 (A), MX15.1 (COL), MX79.2 (ROW)
unnamed: D82.2 (A), MX76.1 (COL), MX84.2 (ROW)
unnamed: D83.2 (A), MX85.2 (ROW)
unnamed: D84.2 (A), MX41.2 (ROW)
unnamed: D85.4 (DIN), D88.2 (DOUT)
unnamed: D86.2 (A), MX87.2 (ROW)
unnamed: D87.2 (A), MX93.2 (ROW)
unnamed: D88.4 (DIN), D89.2 (DOUT)
unnamed: D89.4 (DIN), D94.2 (DOUT)
unnamed: D90.2 (A), MX46.2 (ROW)
unnamed: D91.2 (A), MX16.2 (ROW)
unnamed: D92.2 (A), MX92.2 (ROW)
unnamed: D93.2 (A), MX88.2 (ROW)
unnamed: D95.2 (DOUT), D99.4 (DIN)
unnamed: D95.4 (DIN), R7.1
unnamed: D96.2 (A), MX96.2 (ROW)
unnamed: D97.2 (A), MX97.2 (ROW)
unnamed: D98.2 (A), MX98.2 (ROW)
unnamed: D100.2 (DOUT), D106.4 (DIN)
unnamed: D99.2 (DOUT), D100.4 (DIN)
unnamed: D101.2 (A), MX101.2 (ROW)
unnamed: D102.2 (A), MX102.2 (ROW)
unnamed: D103.2 (A), MX103.2 (ROW)
unnamed: D104.2 (A), MX104.2 (ROW)
unnamed: D105.2 (A), MX105.2 (ROW)
unnamed: D106.2 (DOUT), D107.4 (DIN)
unnamed: D107.2 (DOUT), D109.4 (DIN)
unnamed: D108.2 (A), MX108.2 (ROW)
unnamed: D109.2 (DOUT), D110.4 (DIN)
unnamed: D110.2 (DOUT), D111.4 (DIN)
unnamed: D111.2 (DOUT), D112.4 (DIN)
unnamed: D94.4 (DIN), D112.2 (DOUT)
unnamed: D113.1 (K), R8.1
unnamed: D114.1 (K), D115.1 (K), R9.1
unnamed: R1.2, USB1.10 (CC2)
unnamed: R2.2, USB1.4 (CC1)
unnamed: R6.2, U2.33 (~HWB~/PE2)
R0: D1.1 (K), D13.1 (K), D25.1 (K), D37.1 (K), D49.1 (K), D61.1 (K), D73.1 (K), D97.1 (K), U2.9 (PB1), U4.2 (DIN1)
R3: D8.1 (K), D20.1 (K), D32.1 (K), D44.1 (K), D56.1 (K), D68.1 (K), D80.1 (K), D92.1 (K), D104.1 (K), U2.12 (PB7)
R4: D3.1 (K), D15.1 (K), D27.1 (K), D39.1 (K), D51.1 (K), D63.1 (K), D75.1 (K), D87.1 (K), U2.18 (PD0)
R5: D9.1 (K), D21.1 (K), D33.1 (K), D45.1 (K), D57.1 (K), D69.1 (K), D81.1 (K), D93.1 (K), D105.1 (K), U2.19 (PD1)
R6: D4.1 (K), D16.1 (K), D28.1 (K), D40.1 (K), D52.1 (K), D64.1 (K), U2.40 (PF1)
R7: D10.1 (K), D22.1 (K), D34.1 (K), D46.1 (K), D58.1 (K), D70.1 (K), D82.1 (K), U2.41 (PF0)
R8: D5.1 (K), D17.1 (K), D29.1 (K), D41.1 (K), D53.1 (K), D65.1 (K), D77.1 (K), D101.1 (K), U2.27 (PD7)
R9: D11.1 (K), D23.1 (K), D35.1 (K), D47.1 (K), D59.1 (K), D71.1 (K), D83.1 (K), U2.28 (PB4)
R10: D6.1 (K), D18.1 (K), D78.1 (K), D90.1 (K), D102.1 (K), U2.22 (PD5)
R11: D12.1 (K), D48.1 (K), D84.1 (K), D96.1 (K), D108.1 (K), U2.21 (PD3)
RGB: R7.2, U2.20 (PD2)
RST: R5.2, SW1.2, U2.13 (~RESET), U4.3 (DIN2)
VCC: F1.2, U1.4 (VCC), USB1.2 (VBUS), USB1.11 (VBUS)
indicator1: R8.2, U2.8 (PB0)
indicator2: R9.2, U2.38 (PF5)
