MaiTheSan/PCB-Design/KiCad/12-2021/Amber80/solder/solder kicad6/solder.sch

## KiCad design KiCad/12-2021/Amber80/solder/solder kicad6/solder.sch (2022-11-19)

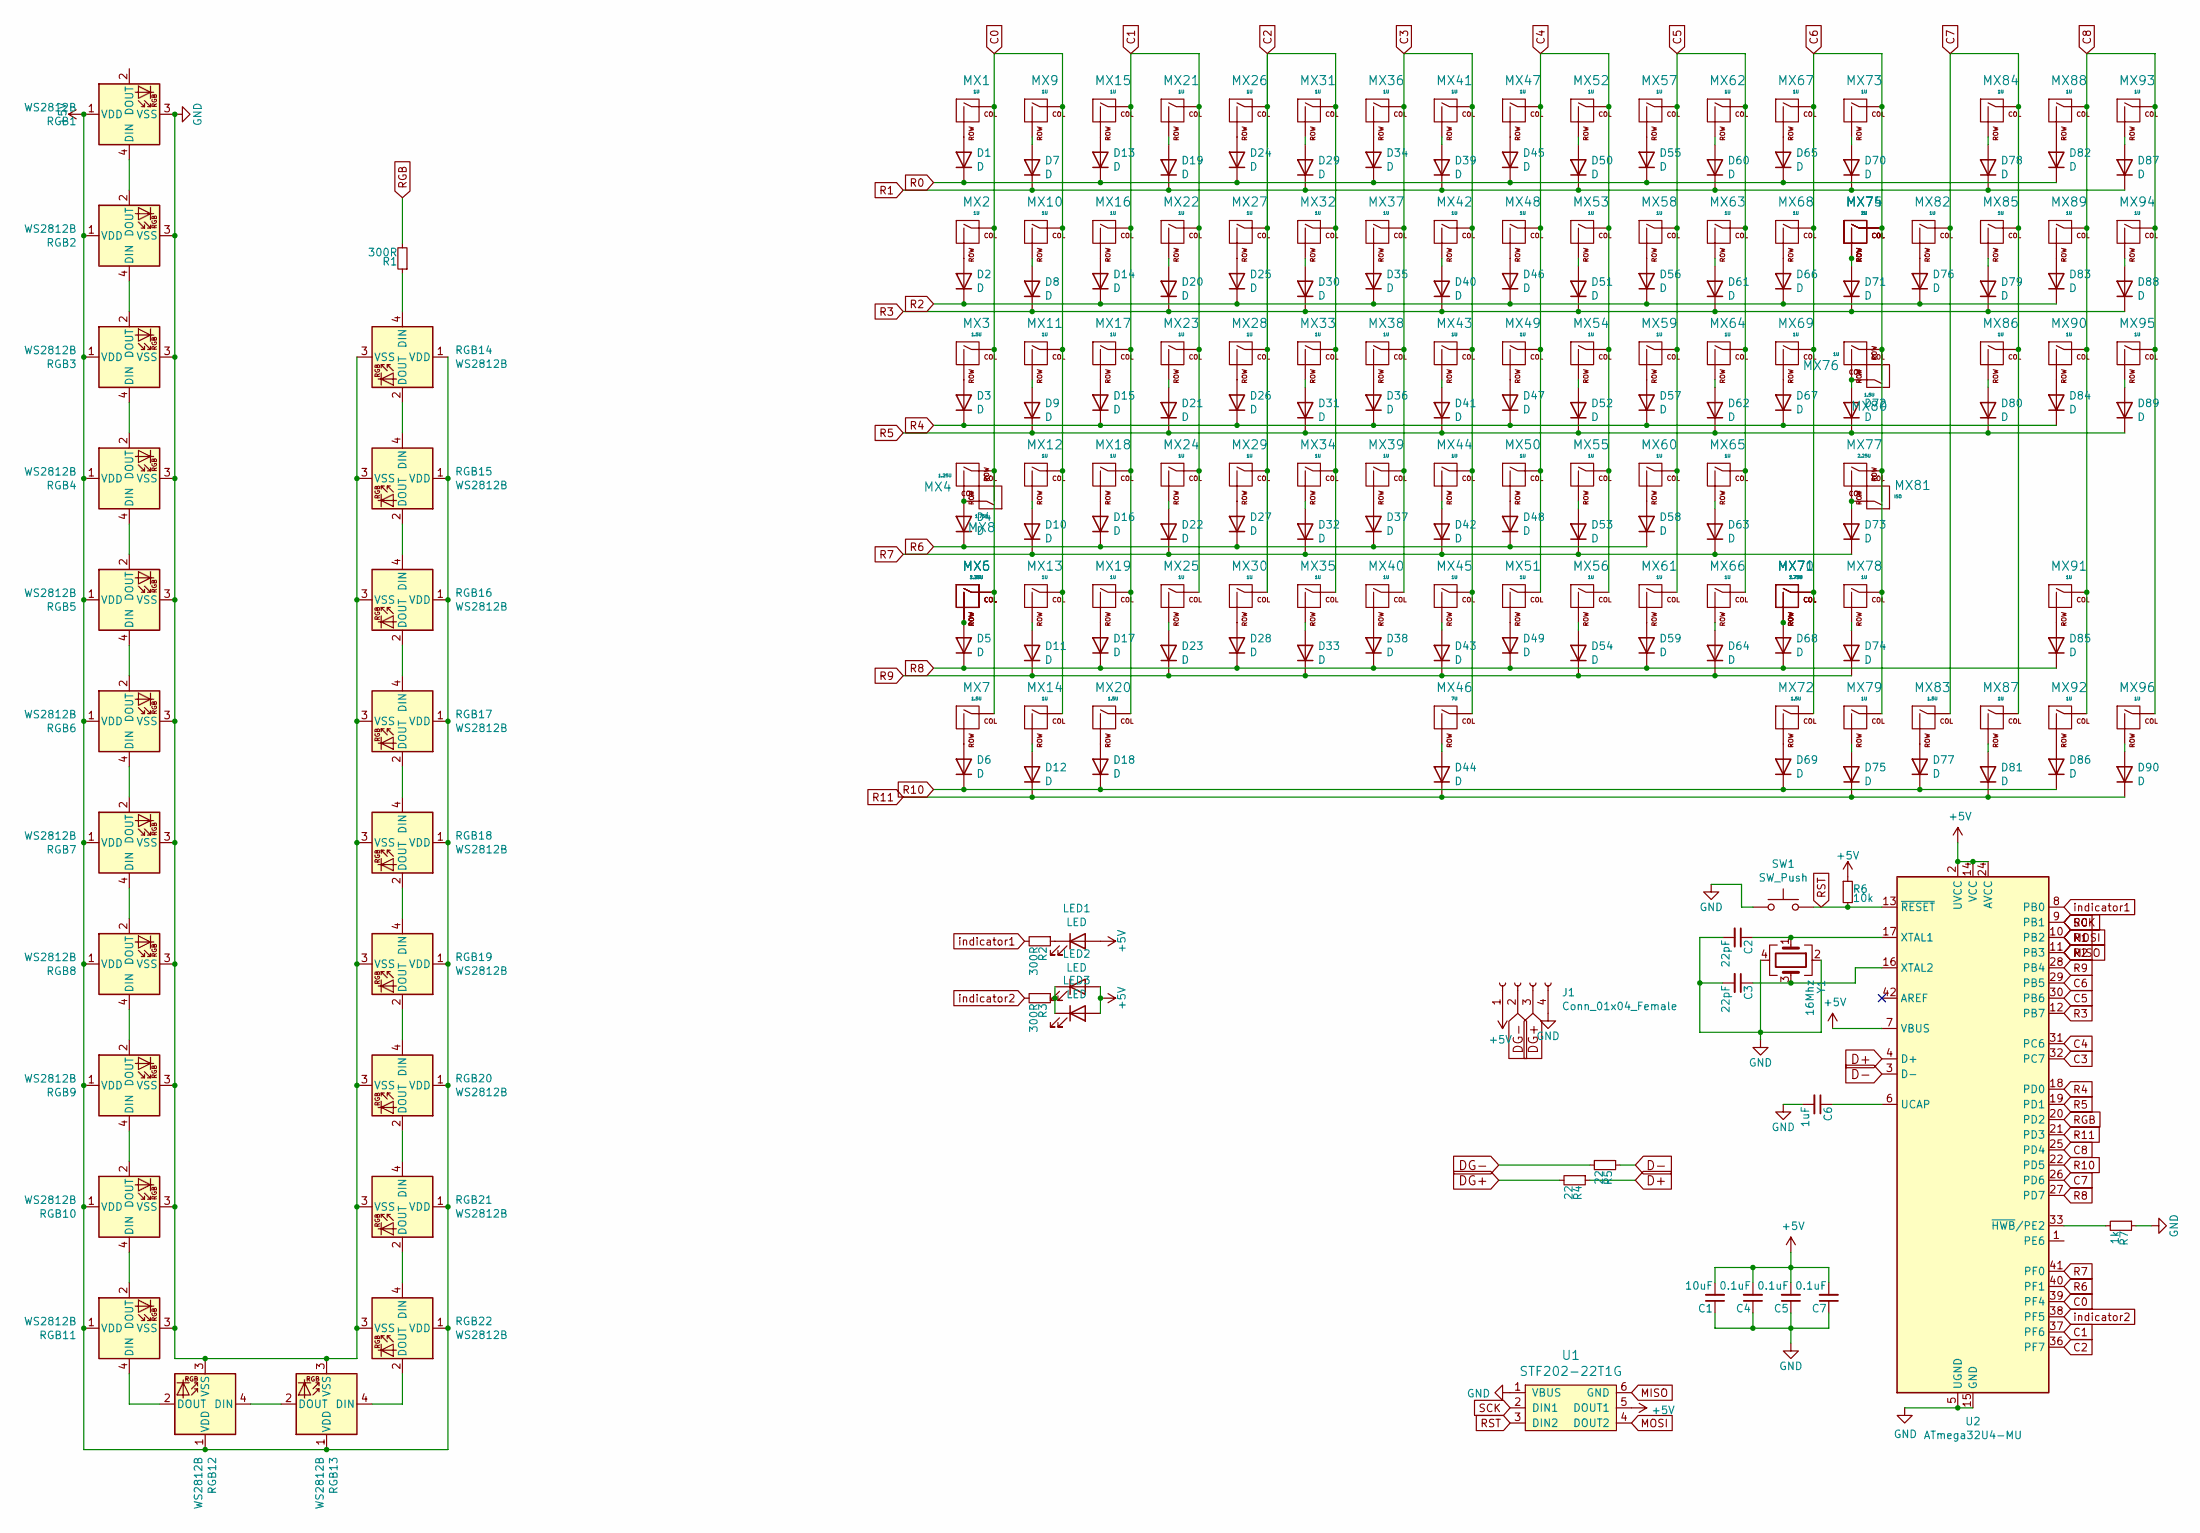
[picture p234: schematic solder.sch]

Parts:
C1: 10uF; C_0603
C2, C3: 22pF; C_0603
C4, C5, C7: 0.1uF; C_0603
C6: 1uF; C_0603
D1, D2, D3, D4, D5, D6, D7, D8, D9, D10, D11, D12, D13, D14, D15, D16, D17, D18, D19, D20, D21, D22, D23, D24, D25, D26, D27, D28, D29, D30, D31, D32, D33, D34, D35, D36, D37, D38, D39, D40, D41, D42, D43, D44, D45, D46, D47, D48, D49, D50, D51, D52, D53, D54, D55, D56, D57, D58, D59, D60, D61, D62, D63, D64, D65, D66, D67, D68, D69, D70, D71, D72, D73, D74, D75, D76, D77, D78, D79, D80, D81, D82, D83, D84, D85, D86, D87, D88, D89, D90: D; DIODE_1206_SawnsProjects
J1: Conn_01x04_Female; JST-SR-4
LED1, LED3: LED; MXOnly-LEDONLY-FLIPPED
LED2: LED; MXOnly-LEDONLY
MX1, MX2, MX9, MX10, MX11, MX12, MX13, MX14, MX15, MX16, MX17, MX18, MX19, MX21, MX22, MX23, MX24, MX25, MX26, MX27, MX28, MX29, MX30, MX31, MX32, MX33, MX34, MX35, MX36, MX37, MX38, MX39, MX40, MX41, MX42, MX43, MX44, MX45, MX47, MX48, MX49, MX50, MX51, MX52, MX53, MX54, MX55, MX56, MX57, MX58, MX59, MX60, MX61, MX62, MX63, MX64, MX65, MX66, MX67, MX68, MX69, MX73, MX74, MX76, MX78, MX79, MX82, MX84, MX85, MX86, MX87, MX88, MX89, MX90, MX91, MX92, MX93, MX94, MX95, MX96: 1U; MXOnly-1U-NoLED
MX3, MX7, MX20, MX72, MX80, MX83: 1.5U; MXOnly-1.5U-NoLED
MX4, MX5: 1.25U; MXOnly-1.25U-NoLED
MX6: 2.25U; MXOnly-2.25U-NoLED
MX8, MX70: 1.75U; MXOnly-1.75U-NoLED
MX46: 7U; MXOnly-7U-ReversedStabilizers-NoLED
MX71: 2.75U; MXOnly-2.75U-NoLED
MX75: 2U; MXOnly-2U-NoLED
MX77: 2.25U; MXOnly-2.25U-ReversedStabilizers-NoLED
MX81: ISO; MXOnly-ISO-ROTATED-ReversedStabilizers-NoLED
R1, R2, R3: 300R; R_0805
R4, R5: 22; R_0805
R6: 10k; R_0805
R7: 1k; R_0805
RGB1, RGB2, RGB3, RGB4, RGB5, RGB6, RGB7, RGB8, RGB9, RGB10, RGB11, RGB12, RGB13, RGB14, RGB15, RGB16, RGB17, RGB18, RGB19, RGB20, RGB21, RGB22: WS2812B; LED_WS2812B_PLCC4_5.0x5.0mm_P3.2mm
SW1: SW_Push; SKQG-1155865-fix
U1: STF202-22T1G; Tag-Connect_TC2030-IDC-NL_2x03_P1.27mm_Vertical
U2: ATmega32U4-MU; QFN-44-1EP_7x7mm_P0.5mm_EP5.15x5.15mm
Y1: 16Mhz; Crystal_SMD_3225-4Pin_3.2x2.5mm

Connections:
+5V: C1.2, C4.2, C5.2, C7.2, J1.1, LED1.2 (A), LED2.2 (A), LED3.2 (A), R6.1, RGB1.1 (VDD), RGB2.1 (VDD), RGB3.1 (VDD), RGB4.1 (VDD), RGB5.1 (VDD), RGB6.1 (VDD), RGB7.1 (VDD), RGB8.1 (VDD), RGB9.1 (VDD), RGB10.1 (VDD), RGB11.1 (VDD), RGB12.1 (VDD), RGB13.1 (VDD), RGB14.1 (VDD), RGB15.1 (VDD), RGB16.1 (VDD), RGB17.1 (VDD), RGB18.1 (VDD), RGB19.1 (VDD), RGB20.1 (VDD), RGB21.1 (VDD), RGB22.1 (VDD), U1.5 (DOUT1), U2.2 (UVCC), U2.7 (VBUS), U2.14 (VCC), U2.24 (AVCC), U2.34 (VCC), U2.44 (AVCC)
C0: MX1.1 (COL), MX2.1 (COL), MX3.1 (COL), MX4.1 (COL), MX5.1 (COL), MX6.1 (COL), MX7.1 (COL), MX8.2 (ROW), MX9.1 (COL), MX10.1 (COL), MX11.1 (COL), MX12.1 (COL), MX13.1 (COL), MX14.1 (COL), U2.39 (PF4)
C1: MX15.1 (COL), MX16.1 (COL), MX17.1 (COL), MX18.1 (COL), MX19.1 (COL), MX20.1 (COL), MX21.1 (COL), MX22.1 (COL), MX23.1 (COL), MX24.1 (COL), MX25.1 (COL), U2.37 (PF6)
C2: MX26.1 (COL), MX27.1 (COL), MX28.1 (COL), MX29.1 (COL), MX30.1 (COL), MX31.1 (COL), MX32.1 (COL), MX33.1 (COL), MX34.1 (COL), MX35.1 (COL), U2.36 (PF7)
C3: MX36.1 (COL), MX37.1 (COL), MX38.1 (COL), MX39.1 (COL), MX40.1 (COL), MX41.1 (COL), MX42.1 (COL), MX43.1 (COL), MX44.1 (COL), MX45.1 (COL), MX46.1 (COL), U2.32 (PC7)
C4: MX47.1 (COL), MX48.1 (COL), MX49.1 (COL), MX50.1 (COL), MX51.1 (COL), MX52.1 (COL), MX53.1 (COL), MX54.1 (COL), MX55.1 (COL), MX56.1 (COL), U2.31 (PC6)
C5: MX57.1 (COL), MX58.1 (COL), MX59.1 (COL), MX60.1 (COL), MX61.1 (COL), MX62.1 (COL), MX63.1 (COL), MX64.1 (COL), MX65.1 (COL), MX66.1 (COL), U2.30 (PB6)
C6: MX67.1 (COL), MX68.1 (COL), MX69.1 (COL), MX70.1 (COL), MX71.1 (COL), MX72.1 (COL), MX73.1 (COL), MX74.1 (COL), MX75.1 (COL), MX76.1 (COL), MX77.1 (COL), MX78.1 (COL), MX79.1 (COL), MX80.2 (ROW), MX81.2 (ROW), U2.29 (PB5)
C7: MX82.1 (COL), MX83.1 (COL), MX84.1 (COL), MX85.1 (COL), MX86.1 (COL), MX87.1 (COL), U2.26 (PD6)
C8: MX88.1 (COL), MX89.1 (COL), MX90.1 (COL), MX91.1 (COL), MX92.1 (COL), MX93.1 (COL), MX94.1 (COL), MX95.1 (COL), MX96.1 (COL), U2.25 (PD4)
D+: R4.1, U2.4 (D+)
D-: R5.1, U2.3 (D-)
DG+: J1.3, R4.2
DG-: J1.2, R5.2
GND: C1.1, C2.2, C3.2, C4.1, C5.1, C6.2, C7.1, J1.4, R7.1, RGB1.3 (VSS), RGB2.3 (VSS), RGB3.3 (VSS), RGB4.3 (VSS), RGB5.3 (VSS), RGB6.3 (VSS), RGB7.3 (VSS), RGB8.3 (VSS), RGB9.3 (VSS), RGB10.3 (VSS), RGB11.3 (VSS), RGB12.3 (VSS), RGB13.3 (VSS), RGB14.3 (VSS), RGB15.3 (VSS), RGB16.3 (VSS), RGB17.3 (VSS), RGB18.3 (VSS), RGB19.3 (VSS), RGB20.3 (VSS), RGB21.3 (VSS), RGB22.3 (VSS), SW1.1, U1.1 (VBUS), U2.5 (UGND), U2.15 (GND), U2.23 (GND), U2.35 (GND), U2.43 (GND), U2.45 (GND), Y1.2, Y1.4
MISO: D2.1 (K), D14.1 (K), D25.1 (K), D35.1 (K), D46.1 (K), D56.1 (K), D66.1 (K), D76.1 (K), D83.1 (K), U1.6 (GND), U2.11 (PB3)
MOSI: D7.1 (K), D19.1 (K), D29.1 (K), D39.1 (K), D50.1 (K), D60.1 (K), D70.1 (K), D78.1 (K), D87.1 (K), U1.4 (DOUT2), U2.10 (PB2)
unnamed: C2.1, U2.17 (XTAL1), Y1.1
unnamed: C3.1, U2.16 (XTAL2), Y1.3
unnamed: C6.1, U2.6 (UCAP)
unnamed: D1.2 (A), MX1.2 (ROW)
unnamed: D2.2 (A), MX2.2 (ROW)
unnamed: D3.2 (A), MX3.2 (ROW)
unnamed: D4.2 (A), MX4.2 (ROW), MX8.1 (COL)
unnamed: D5.2 (A), MX5.2 (ROW), MX6.2 (ROW)
unnamed: D6.2 (A), MX7.2 (ROW)
unnamed: D7.2 (A), MX9.2 (ROW)
unnamed: D8.2 (A), MX10.2 (ROW)
unnamed: D9.2 (A), MX11.2 (ROW)
unnamed: D10.2 (A), MX12.2 (ROW)
unnamed: D11.2 (A), MX13.2 (ROW)
unnamed: D12.2 (A), MX14.2 (ROW)
unnamed: D13.2 (A), MX15.2 (ROW)
unnamed: D14.2 (A), MX16.2 (ROW)
unnamed: D15.2 (A), MX17.2 (ROW)
unnamed: D16.2 (A), MX18.2 (ROW)
unnamed: D17.2 (A), MX19.2 (ROW)
unnamed: D18.2 (A), MX20.2 (ROW)
unnamed: D19.2 (A), MX21.2 (ROW)
unnamed: D20.2 (A), MX22.2 (ROW)
unnamed: D21.2 (A), MX23.2 (ROW)
unnamed: D22.2 (A), MX24.2 (ROW)
unnamed: D23.2 (A), MX25.2 (ROW)
unnamed: D24.2 (A), MX26.2 (ROW)
unnamed: D25.2 (A), MX27.2 (ROW)
unnamed: D26.2 (A), MX28.2 (ROW)
unnamed: D27.2 (A), MX29.2 (ROW)
unnamed: D28.2 (A), MX30.2 (ROW)
unnamed: D29.2 (A), MX31.2 (ROW)
unnamed: D30.2 (A), MX32.2 (ROW)
unnamed: D31.2 (A), MX33.2 (ROW)
unnamed: D32.2 (A), MX34.2 (ROW)
unnamed: D33.2 (A), MX35.2 (ROW)
unnamed: D34.2 (A), MX36.2 (ROW)
unnamed: D35.2 (A), MX37.2 (ROW)
unnamed: D36.2 (A), MX38.2 (ROW)
unnamed: D37.2 (A), MX39.2 (ROW)
unnamed: D38.2 (A), MX40.2 (ROW)
unnamed: D39.2 (A), MX41.2 (ROW)
unnamed: D40.2 (A), MX42.2 (ROW)
unnamed: D41.2 (A), MX43.2 (ROW)
unnamed: D42.2 (A), MX44.2 (ROW)
unnamed: D43.2 (A), MX45.2 (ROW)
unnamed: D44.2 (A), MX46.2 (ROW)
unnamed: D45.2 (A), MX47.2 (ROW)
unnamed: D46.2 (A), MX48.2 (ROW)
unnamed: D47.2 (A), MX49.2 (ROW)
unnamed: D48.2 (A), MX50.2 (ROW)
unnamed: D49.2 (A), MX51.2 (ROW)
unnamed: D50.2 (A), MX52.2 (ROW)
unnamed: D51.2 (A), MX53.2 (ROW)
unnamed: D52.2 (A), MX54.2 (ROW)
unnamed: D53.2 (A), MX55.2 (ROW)
unnamed: D54.2 (A), MX56.2 (ROW)
unnamed: D55.2 (A), MX57.2 (ROW)
unnamed: D56.2 (A), MX58.2 (ROW)
unnamed: D57.2 (A), MX59.2 (ROW)
unnamed: D58.2 (A), MX60.2 (ROW)
unnamed: D59.2 (A), MX61.2 (ROW)
unnamed: D60.2 (A), MX62.2 (ROW)
unnamed: D61.2 (A), MX63.2 (ROW)
unnamed: D62.2 (A), MX64.2 (ROW)
unnamed: D63.2 (A), MX65.2 (ROW)
unnamed: D64.2 (A), MX66.2 (ROW)
unnamed: D65.2 (A), MX67.2 (ROW)
unnamed: D66.2 (A), MX68.2 (ROW)
unnamed: D67.2 (A), MX69.2 (ROW)
unnamed: D68.2 (A), MX70.2 (ROW), MX71.2 (ROW)
unnamed: D69.2 (A), MX72.2 (ROW)
unnamed: D70.2 (A), MX73.2 (ROW)
unnamed: D71.2 (A), MX74.2 (ROW), MX75.2 (ROW)
unnamed: D72.2 (A), MX76.2 (ROW), MX80.1 (COL)
unnamed: D73.2 (A), MX77.2 (ROW), MX81.1 (COL)
unnamed: D74.2 (A), MX78.2 (ROW)
unnamed: D75.2 (A), MX79.2 (ROW)
unnamed: D76.2 (A), MX82.2 (ROW)
unnamed: D77.2 (A), MX83.2 (ROW)
unnamed: D78.2 (A), MX84.2 (ROW)
unnamed: D79.2 (A), MX85.2 (ROW)
unnamed: D80.2 (A), MX86.2 (ROW)
unnamed: D81.2 (A), MX87.2 (ROW)
unnamed: D82.2 (A), MX88.2 (ROW)
unnamed: D83.2 (A), MX89.2 (ROW)
unnamed: D84.2 (A), MX90.2 (ROW)
unnamed: D85.2 (A), MX91.2 (ROW)
unnamed: D86.2 (A), MX92.2 (ROW)
unnamed: D87.2 (A), MX93.2 (ROW)
unnamed: D88.2 (A), MX94.2 (ROW)
unnamed: D89.2 (A), MX95.2 (ROW)
unnamed: D90.2 (A), MX96.2 (ROW)
unnamed: LED1.1 (K), R2.1
unnamed: LED2.1 (K), LED3.1 (K), R3.1
unnamed: R1.1, RGB14.4 (DIN)
unnamed: R7.2, U2.33 (~HWB~/PE2)
unnamed: RGB1.4 (DIN), RGB2.2 (DOUT)
unnamed: RGB2.4 (DIN), RGB3.2 (DOUT)
unnamed: RGB3.4 (DIN), RGB4.2 (DOUT)
unnamed: RGB4.4 (DIN), RGB5.2 (DOUT)
unnamed: RGB5.4 (DIN), RGB6.2 (DOUT)
unnamed: RGB6.4 (DIN), RGB7.2 (DOUT)
unnamed: RGB7.4 (DIN), RGB8.2 (DOUT)
unnamed: RGB8.4 (DIN), RGB9.2 (DOUT)
unnamed: RGB9.4 (DIN), RGB10.2 (DOUT)
unnamed: RGB10.4 (DIN), RGB11.2 (DOUT)
unnamed: RGB11.4 (DIN), RGB12.2 (DOUT)
unnamed: RGB12.4 (DIN), RGB13.2 (DOUT)
unnamed: RGB13.4 (DIN), RGB22.2 (DOUT)
unnamed: RGB14.2 (DOUT), RGB15.4 (DIN)
unnamed: RGB15.2 (DOUT), RGB16.4 (DIN)
unnamed: RGB16.2 (DOUT), RGB17.4 (DIN)
unnamed: RGB17.2 (DOUT), RGB18.4 (DIN)
unnamed: RGB18.2 (DOUT), RGB19.4 (DIN)
unnamed: RGB19.2 (DOUT), RGB20.4 (DIN)
unnamed: RGB20.2 (DOUT), RGB21.4 (DIN)
unnamed: RGB21.2 (DOUT), RGB22.4 (DIN)
R0: D1.1 (K), D13.1 (K), D24.1 (K), D34.1 (K), D45.1 (K), D55.1 (K), D65.1 (K), D82.1 (K), U1.2 (DIN1), U2.9 (PB1)
R3: D8.1 (K), D20.1 (K), D30.1 (K), D40.1 (K), D51.1 (K), D61.1 (K), D71.1 (K), D79.1 (K), D88.1 (K), U2.12 (PB7)
R4: D3.1 (K), D15.1 (K), D26.1 (K), D36.1 (K), D47.1 (K), D57.1 (K), D67.1 (K), D84.1 (K), U2.18 (PD0)
R5: D9.1 (K), D21.1 (K), D31.1 (K), D41.1 (K), D52.1 (K), D62.1 (K), D72.1 (K), D80.1 (K), D89.1 (K), U2.19 (PD1)
R6: D4.1 (K), D16.1 (K), D27.1 (K), D37.1 (K), D48.1 (K), D58.1 (K), U2.40 (PF1)
R7: D10.1 (K), D22.1 (K), D32.1 (K), D42.1 (K), D53.1 (K), D63.1 (K), D73.1 (K), U2.41 (PF0)
R8: D5.1 (K), D17.1 (K), D28.1 (K), D38.1 (K), D49.1 (K), D59.1 (K), D68.1 (K), D85.1 (K), U2.27 (PD7)
R9: D11.1 (K), D23.1 (K), D33.1 (K), D43.1 (K), D54.1 (K), D64.1 (K), D74.1 (K), U2.28 (PB4)
R10: D6.1 (K), D18.1 (K), D69.1 (K), D77.1 (K), D86.1 (K), U2.22 (PD5)
R11: D12.1 (K), D44.1 (K), D75.1 (K), D81.1 (K), D90.1 (K), U2.21 (PD3)
RGB: R1.2, U2.20 (PD2)
RST: R6.2, SW1.2, U1.3 (DIN2), U2.13 (~RESET)
indicator1: R2.2, U2.8 (PB0)
indicator2: R3.2, U2.38 (PF5)
