MaiTheSan/PCB-Design/KiCad/Final/qmk_firmware-master/keyboards/torn/torn.c

/*
 * Copyright 2020 Richard Titmuss <richard.titmuss@gmail.com>
 *
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
 * You should have received a copy of the GNU General Public License
 * along with this program.  If not, see <http://www.gnu.org/licenses/>.
 */
#include "torn.h"
#include "i2c_master.h"
#include "mcp23018.h"

static uint8_t led_state[3] = {1, 1, 1};

void matrix_init_kb(void) {
    // put your keyboard start-up code here
    // runs once when the firmware starts up
    i2c_init();

    matrix_init_user();
}

void matrix_scan_kb(void) {
    // put your looping keyboard code here
    // runs every cycle (a lot)
    if (mcp23018_reset_required()) {
        msp23018_init();
        secondary_encoder_init();
        // torn_set_led(2, 1);
    }

    matrix_scan_user();
    secondary_encoder_read();
}

void torn_set_led(uint8_t led, bool state) {
    led_state[led] = !state;

    // toggle leds by setting the pin direction
    uint8_t iodir = 0b11111000 | led_state[0] << 2 | led_state[1] << 1 | led_state[2];
    mcp23018_writeReg(IODIRB, &iodir, 1);
}

// clang-format off
const char PROGMEM bongocat_logo[] = {
  0x00, 0x00, 0x00, 0x00, 0x00, 0x00, 0xf8, 0xf8, 0x98, 0x98, 0x98, 0x98, 0x98, 0x18, 0x18, 0x98,
  0x98, 0x98, 0x98, 0x98, 0xf8, 0xf8, 0x00, 0x00, 0x00, 0x00, 0x00, 0x00, 0x00, 0x00, 0x00, 0x00,
  0x00, 0x00, 0x00, 0x80, 0xc0, 0x60, 0x30, 0x30, 0x18, 0x98, 0x98, 0x98, 0x98, 0x98, 0x98, 0x98,
  0x18, 0x30, 0x30, 0x60, 0xc0, 0x80, 0x00, 0x00, 0x00, 0x00, 0x00, 0x00, 0x00, 0x00, 0x00, 0x00,
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
  0x0f, 0x0f, 0x0c, 0x0c, 0x0f, 0x0f, 0x00, 0x00, 0x00, 0x00, 0x00, 0x00, 0x00, 0x00, 0x00, 0x01,
  0x03, 0x07, 0x0e, 0x0c, 0x0f, 0x0f, 0x00, 0x00, 0x00, 0x00, 0x00, 0x00, 0x00, 0x00, 0x00, 0x00
};
// clang-format on
