MaiTheSan/PCB-Design/KiCad/Final/qmk_firmware-master/keyboards/tmo50/tmo50.c

/* Copyright 2019 funderburker
 *
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
 * You should have received a copy of the GNU General Public License
 * along with this program.  If not, see <http://www.gnu.org/licenses/>.
 */
#include "tmo50.h"

void matrix_init_kb(void) {
	// put your keyboard start-up code here
	// runs once when the firmware starts up

  DDRB |= (1 << PB0); //init B0
  PORTB &= ~(1 << PB0); //turn on B0
  DDRB |= (1 << PB1);
  PORTB |= (1<<PB1); //turn off B1
  DDRB |= (1 << PB2);
  PORTB |= (1<<PB2);
  DDRB |= (1 << PB3);
  PORTB |= (1<<PB3);

	matrix_init_user();
}

void matrix_scan_kb(void) {
	// put your looping keyboard code here
	// runs every cycle (a lot)

	matrix_scan_user();
}

bool process_record_kb(uint16_t keycode, keyrecord_t *record) {
	// put your per-action keyboard code here
	// runs for every action, just before processing by the firmware

	return process_record_user(keycode, record);
}

void led_set_kb(uint8_t usb_led) {
	// put your keyboard LED indicator (ex: Caps Lock LED) toggling code here

	led_set_user(usb_led);
}

layer_state_t layer_state_set_kb(layer_state_t state)
{
  state = layer_state_set_user(state);
  process_indicator_led_kb(state);

  return state;
}

__attribute__((weak))
bool process_indicator_led_user(layer_state_t state){
  return true;
}

bool process_indicator_led_kb(layer_state_t state)
{
  if(process_indicator_led_user(state))
  {
    // if on layer 0, turn on B0 LED, otherwise off.
    if (get_highest_layer(state) == 0) {
        PORTB &= ~(1<<PB0);
    } else {
        PORTB |= (1<<PB0);
    }

    // if on layer 1, turn on B1 LED, otherwise off.
    if (get_highest_layer(state) == 1) {
        PORTB &= ~(1<<PB1);
    } else {
        PORTB |= (1<<PB1);
    }

    // if on layer 2, turn on B2 LED, otherwise off.
    if (get_highest_layer(state) == 2) {
        PORTB &= ~(1<<PB2);
    } else {
        PORTB |= (1<<PB2);
    }

    // if on layer 3, turn on B3 LED, otherwise off.
    if (get_highest_layer(state) == 3) {
        PORTB &= ~(1<<PB3);
    } else {
        PORTB |= (1<<PB3);
    }
  }

  return true;
}
