MaiTheSan/PCB-Design/(commit log)

2022-11-19 Add PCB and Application
    [108 test - Copy.sch, 108 test.kicad_pcb, 108 test.sch, 1800 layout - Backup.kicad_pcb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]
2022-11-23 Remove Useless file
    [Malenia-B_Cu.gbr, Malenia-B_Mask.gbr, Malenia-B_Paste.gbr, Malenia-B_SilkS.gbr, Malenia-Edge_Cuts.gbr, Malenia-F_Cu.gbr, Malenia-F_Mask.gbr, Malenia-F_Paste.gbr]
